chuanseng-ng/claude_verilog_test/pnr/commercial/reports/openroad_summary.md

# OpenROAD / LibreLane arm, Sky130 `rv32i_cpu_top` (step B2)

Run dir (gitignored): `pnr/sky130/cpu/runs/b2_openroad`. Exported artifacts: `pnr/commercial/runs/openroad/`.
Config `pnr/sky130/cpu/config.json` unchanged. CLI overrides only: `-j 4 -c DRT_THREADS=4` (config says 8; thread count only).
Design source: HEAD `1f1e703`, `rv32i_cpu_top_sv2v.v` regenerated by `make -C pnr sky130-cpu-sv2v` (sha256 f99e5317..., byte-identical to the file already on disk).

## Tool versions and patch status
- LibreLane: upstream commit 3562a8d (`2.4.13-2-g3562a8d`) at `~/tools/librelane-3562a8d`, plus `pnr/librelane_patches/librelane_live_state_2026-09-26.diff` (15 files) and the 2 untracked sources (`json_header_patched.py`, `nix/openvaf.nix`). Mounted over the container's librelane by `PYTHONPATH` (container image `ghcr.io/librelane/librelane:2.4.13`).
- Tools in the image: OpenROAD `edf00dff99f6c40d67a30c0e22a8191c5d2ed9d6` (the same build the repo's nix-shell Sky130 flow used; 26Q2 is used only by the ASAP7 shim), Yosys 0.46, Magic 8.3.489, KLayout 0.29.4, Netgen 1.5.278.
- Project plugin `pnr/plugins` (synth undef gate, bead gc0y) loaded via PYTHONPATH: verdict PASS fail=0. No SoC plugin (`cvt_sky130`) is needed for the CPU block.
- PDK: open_pdks 0fe599b2 at `~/pdk`; `sky130_fd_io` had to be added with `ciel enable` (same version hash) because LibreLane 2.4.13 validates the pad LEF paths at start-up.
- Patches that only take effect on OpenROAD 26Q2 (inert here, as in the baseline): drt.tcl `set_routing_layers` branch; sta/corner.tcl `sta::scenes` branch; PSM report parser 26Q2 format; `PL_RESIZER_TIMING_EXTRA_ARGS=-max_iterations` usage. Applied unconditionally and not 26Q2-specific: ioplacer.tcl (drops `-random_seed 42`; pins are then overwritten by `FP_DEF_TEMPLATE`, so no effect), pdn.tcl (no `exit 1` on PDN errors; PDN built normally, no warning), drt.tcl catch-and-continue (bead xy6 hazard; not triggered: no warning in the log and DRT converged to 0 violations at iteration 21).

## Result
LVS 0 errors, routing DRC 0 (iteration 21), KLayout DRC 0, Magic DRC count 27,733,913 (from the Magic log; Magic.DRC step itself was killed afterwards by the 10 GB memory watchdog while LibreLane parsed the report, so `magic__drc_error__count` is absent from metrics.json), antenna 116 nets / 119 pins, setup clean at six tt/ff corners (nom_tt +3.031 ns), ss reg-to-reg setup FAILS (max_ss -3.996 ns, 1149 violators), hold fails only on I/O ports (nom_tt -0.458 ns, 0 reg-to-reg), power 103.4 mW (indicative), stdcell area 707,819 um2, util 41.81 %, 5,299 flops. Flow exit status 2 (deferred nom_tt hold error, as in the baseline). Every number matches the recorded `RUN_2026-10-24_19-19-02` (c54a, same RTL) exactly, so the flow reproduces bit-for-bit.
