chuanseng-ng/claude_verilog_test/pnr/commercial/signoff/drclvs/reports/innovus_b6_summary.txt

== drclvs summary: arm=innovus_b6
-- LVS (Magic DEF+LEF, LibreLane mode)
   NOT RUN / no report
-- LVS (Magic from GDS, cells as LEF abstracts)
   Final result: Top level cell failed pin matching.
   Number of devices: 46175                   |Number of devices: 46175
   Number of nets: 47113                      |Number of nets: 47113
-- KLayout DRC
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
