chuanseng-ng/claude_verilog_test/docs/manual/tm/parts/04-dft-fpga-hls-and-analog.tex

\part{DFT, FPGA, HLS and analog}\label{tm:part:dft-fpga-hls-and-analog}

\chapter{DFT architecture}\label{tm:ch:dft-architecture}

This chapter describes the DFT architecture. It covers scan, JTAG and memory self-test.

\chapter{Tessent flows}\label{tm:ch:tessent-flows}

This chapter describes the Tessent flows for test insertion and pattern generation.

\chapter{FPGA prototyping}\label{tm:ch:fpga-prototyping}

This chapter describes the FPGA prototype. It gives the board choice and the measured results.

\chapter{High-level synthesis}\label{tm:ch:high-level-synthesis}

This chapter describes the high-level synthesis work and its results.

\chapter{Analog PLL}\label{tm:ch:analog-pll}

This chapter describes the analog PLL flow. It covers both process kits.
