chuanseng-ng/claude_verilog_test/docs/manual/common/glossary.tex

% Generated by tools/docs/gen_glossary.py from dictionary.yaml. Do not edit.
\newglossaryentry{always-on-domain}{name={always-on domain},description={A power domain that stays powered while the other domains are off.}}
\newacronym[description={Analog and mixed signal. A design that has analog parts and digital parts.}]{AMS}{AMS}{analog and mixed signal}
\newacronym[description={Advanced Peripheral Bus. A simple bus for control registers.}]{APB}{APB}{Advanced Peripheral Bus}
\newglossaryentry{ASAP7}{name={ASAP7},description={A predictive 7 nm process design kit.}}
\newacronym[description={Automatic test pattern generation. A method that creates the test patterns for manufacturing faults.}]{ATPG}{ATPG}{automatic test pattern generation}
\newacronym[description={Advanced eXtensible Interface. A high-performance bus protocol.}]{AXI}{AXI}{Advanced eXtensible Interface}
\newacronym[description={Clock domain crossing. A signal path between two clock domains.}]{CDC}{CDC}{clock domain crossing}
\newglossaryentry{cocotb}{name={cocotb},description={A Python framework for the verification of RTL.}}
\newacronym[description={Control and status register. A register that controls the CPU or reports its state.}]{CSR}{CSR}{control and status register}
\newacronym[description={Clock tree synthesis. The step that builds the clock distribution network.}]{CTS}{CTS}{clock tree synthesis}
\newacronym[description={Design for test. The design methods that make a chip testable.}]{DFT}{DFT}{design for test}
\newacronym[description={Direct memory access. A transfer of data that does not use the CPU.}]{DMA}{DMA}{direct memory access}
\newacronym[description={Design rule check. A check of the layout against the rules of the process.}]{DRC}{DRC}{design rule check}
\newacronym[description={Engineering change order. A small late change to a design.}]{ECO}{ECO}{engineering change order}
\newacronym[description={Field-programmable gate array. A chip with logic that a user can program.}]{FPGA}{FPGA}{field-programmable gate array}
\newglossaryentry{FreePDK45}{name={FreePDK45},description={A predictive 45 nm process design kit.}}
\newacronym[description={Gate-level simulation. A simulation of the synthesized netlist.}]{GLS}{GLS}{gate-level simulation}
\newglossaryentry{gray-code}{name={gray code},description={A binary code in which the next value differs from the present value in one bit.}}
\newacronym[description={Global routing. The step that plans the route of each net before detailed routing.}]{GRT}{GRT}{global routing}
\newacronym[description={High-level synthesis. A tool flow that turns C or C++ code into RTL.}]{HLS}{HLS}{high-level synthesis}
\newacronym[description={Integrated clock gating. A cell that stops a clock safely.}]{ICG}{ICG}{integrated clock gating}
\newacronym[description={Interrupt request. A signal that asks the CPU to run a handler.}]{IRQ}{IRQ}{interrupt request}
\newacronym[description={Instruction set architecture. The instructions and the registers that software sees.}]{ISA}{ISA}{instruction set architecture}
\newglossaryentry{isolation-clamp}{name={isolation clamp},description={Logic that forces the outputs of a power domain to a fixed value while the domain is off.}}
\newacronym[description={Joint Test Action Group. The group that defined the IEEE 1149.1 test interface.}]{JTAG}{JTAG}{Joint Test Action Group}
\newglossaryentry{KLayout}{name={KLayout},description={An open-source layout viewer and design rule checker.}}
\newacronym[description={Logical equivalence checking. A proof that two designs have the same function.}]{LEC}{LEC}{logical equivalence checking}
\newacronym[description={Library Exchange Format. A file format for the abstract view of a cell or a macro.}]{LEF}{LEF}{Library Exchange Format}
\newglossaryentry{LibreLane}{name={LibreLane},description={A flow driver that runs the open-source steps from RTL to layout.}}
\newacronym[description={Layout versus schematic. A check that the layout matches the netlist.}]{LVS}{LVS}{layout versus schematic}
\newglossaryentry{Magic}{name={Magic},description={An open-source layout editor and design rule checker.}}
\newacronym[description={Memory built-in self-test. Logic on the chip that tests its memories.}]{MBIST}{MBIST}{memory built-in self-test}
\newglossaryentry{metastability}{name={metastability},description={The state of a flop that samples a signal while the signal changes. Its output takes an unknown time to settle.}}
\newacronym[description={Memory-mapped input/output. Access to a device through load and store instructions.}]{MMIO}{MMIO}{memory-mapped input/output}
\newacronym[description={Mean time between failures. For a synchroniser, the mean time between two metastable events that reach the logic after the chain.}]{MTBF}{MTBF}{mean time between failures}
\newglossaryentry{Netgen}{name={Netgen},description={An open-source tool for layout versus schematic checks.}}
\newacronym[description={Neural processing unit. A block that runs neural-network operations.}]{NPU}{NPU}{neural processing unit}
\newglossaryentry{OpenROAD}{name={OpenROAD},description={An open-source tool for place and route.}}
\newglossaryentry{OpenSTA}{name={OpenSTA},description={An open-source static timing analyzer.}}
\newglossaryentry{pandoc}{name={pandoc},description={A tool that converts documents between formats.}}
\newacronym[description={Process design kit. The data that a foundry gives for one process.}]{PDK}{PDK}{process design kit}
\newacronym[description={Power distribution network. The metal grid that carries power to the cells.}]{PDN}{PDN}{power distribution network}
\newacronym[description={Phase-locked loop. A circuit that makes a clock from a reference clock.}]{PLL}{PLL}{phase-locked loop}
\newacronym[description={Power management unit. The block that controls the power sequence of the power domains.}]{PMU}{PMU}{power management unit}
\newglossaryentry{power-domain}{name={power domain},description={A set of instances that share one supply and one power state.}}
\newacronym[description={Power, performance and area. The three main quality figures of a design.}]{PPA}{PPA}{power, performance and area}
\newacronym[description={Power state table. A table of the legal power states of the power domains.}]{PST}{PST}{power state table}
\newglossaryentry{pyslang}{name={pyslang},description={The Python interface of the slang SystemVerilog compiler.}}
\newglossaryentry{pyuvm}{name={pyuvm},description={A Python implementation of the UVM methodology.}}
\newacronym[description={Resistance-capacitance extraction. The step that reads the parasitic values from the layout.}]{RCX}{RCX}{resistance-capacitance extraction}
\newglossaryentry{retention}{name={retention},description={The property of a cell that keeps its value while its supply is off.}}
\newglossaryentry{return-to-zero-handshake}{name={return-to-zero handshake},description={A handshake in which the request level and the acknowledge level both return to zero before the next transfer.}}
\newacronym[description={Real-number modeling. A model that uses real values in place of analog waveforms.}]{RNM}{RNM}{real-number modeling}
\newacronym[description={Register-transfer level. A design description in terms of registers and logic.}]{RTL}{RTL}{register-transfer level}
\newacronym[description={Synopsys Design Constraints. A file format that states the timing constraints of a design.}]{SDC}{SDC}{Synopsys Design Constraints}
\newacronym[description={Single instruction, multiple threads. An execution model where many threads run one instruction.}]{SIMT}{SIMT}{single instruction, multiple threads}
\newglossaryentry{Sky130}{name={Sky130},description={The open 130 nm process design kit from SkyWater.}}
\newacronym[description={System on chip. A chip that holds the processors, the memory and the peripherals.}]{SoC}{SoC}{system on chip}
\newacronym[description={Standard Parasitic Exchange Format. A file format for the parasitic values of a layout.}]{SPEF}{SPEF}{Standard Parasitic Exchange Format}
\newacronym[description={Static random-access memory. A memory that keeps its data while power is on.}]{SRAM}{SRAM}{static random-access memory}
\newacronym[description={Static timing analysis. A check of all timing paths without simulation.}]{STA}{STA}{static timing analysis}
\newglossaryentry{sv2v}{name={sv2v},description={A tool that converts SystemVerilog to Verilog.}}
\newglossaryentry{synchroniser}{name={synchroniser},description={A chain of flops on the receiving clock that gives a metastable first flop time to settle.}}
\newglossaryentry{Synlig}{name={Synlig},description={A Yosys front end for SystemVerilog.}}
\newacronym[description={Test access port. The port and the state machine that control a JTAG interface.}]{TAP}{TAP}{test access port}
\newacronym[description={Total negative slack. The sum of the negative slack of all failing paths.}]{TNS}{TNS}{total negative slack}
\newacronym[description={Unified Power Format. A file format that states the power intent of a design.}]{UPF}{UPF}{Unified Power Format}
\newglossaryentry{Verible}{name={Verible},description={A lint and format tool for SystemVerilog.}}
\newglossaryentry{Verilator}{name={Verilator},description={A simulator that turns SystemVerilog into C++ code.}}
\newacronym[description={Worst negative slack. The most negative slack of all timing paths.}]{WNS}{WNS}{worst negative slack}
\newglossaryentry{Yosys}{name={Yosys},description={An open-source logic synthesis tool.}}
