chuanseng-ng/claude_verilog_test/docs/manual/common/generated/map/memory-map-axilite.tex

% Generated by tools/docs/gen_memory_map.py from rtl/soc/axi_pkg.sv, rtl/soc/soc_addr_map_pkg.sv, rtl/soc/soc_periph_map_pkg.sv and docs/manual/common/facts/memory_map.yaml. Do not edit.
{\small
\begin{longtable}{@{}>{\raggedright\arraybackslash}p{9mm}>{\raggedright\arraybackslash}p{33mm}>{\raggedright\arraybackslash}p{27mm}>{\raggedright\arraybackslash}p{17mm}>{\raggedright\arraybackslash}p{25mm}>{\raggedright\arraybackslash}p{28mm}@{}}
\caption{AXI-Lite interconnect slot windows}\label{tab:ds:mm:address-map:axilite}\\
\toprule
Slot & Constant & Range & Size & Target & Note\\
\midrule
\endfirsthead
\multicolumn{6}{@{}l}{\emph{Table \thetable\ continued}}\\
\toprule
Slot & Constant & Range & Size & Target & Note\\
\midrule
\endhead
\bottomrule
\endlastfoot
0 & \code{AXIL_GPU} & \code{0x2000_1000}\newline\code{0x2000_1FFF} & 4 KB & GPU control port of \code{u_gpu} & Only the address bits \code{[11:0]} reach the slave.\\
1 & \code{AXIL_APB_BRIDGE} & \code{0x2000_2000}\newline\code{0x2001_0FFF} & 60 KB & APB bridge \code{u_axil_apb_bridge} & Window of every APB slot. The APB level below decodes it.\\
2 & \code{AXIL_DMA} & \code{0x2000_5000}\newline\code{0x2000_5FFF} & 4 KB & DMA control port of \code{u_dma} & The page lies inside the APB bridge window. The decode keeps the last match, so this slot wins.\\
\end{longtable}
}
