chuanseng-ng/claude_verilog_test/docs/manual/common/generated/facts/pmu-params.tex

% Generated by tools/docs/gen_fact_tables.py from rtl/soc/pmu.sv and docs/manual/common/facts/power.yaml. Do not edit.
{\small
\begin{longtable}{@{}>{\raggedright\arraybackslash}p{30mm}>{\raggedright\arraybackslash}p{27mm}>{\raggedright\arraybackslash}p{19mm}>{\raggedright\arraybackslash}p{20mm}>{\raggedright\arraybackslash}p{45mm}@{}}
\caption{Parameters of \code{pmu}}\label{tab:tm:mod:pmu:params}\\
\toprule
Parameter & Type & Default & Legal values & Description\\
\midrule
\endfirsthead
\multicolumn{5}{@{}l}{\emph{Table \thetable\ continued}}\\
\toprule
Parameter & Type & Default & Legal values & Description\\
\midrule
\endhead
\bottomrule
\endlastfoot
\code{ADDR_W} & \code{int unsigned} & \code{12} & 4 or more; 12 in the SoC & Byte address width of the APB slot. The slot holds 4 KB at 12.\\
\code{ISO_ACK_TIMEOUT} & \code{int unsigned} & \code{255} & 2 or more & Number of \code{clk_i} cycles that one isolation wait of the CPU domain can last before the sequencer goes on and sets STATUS bit 3. Elaboration stops with an error when the value is below 2.\\
\end{longtable}
}
