chuanseng-ng/claude_verilog_test/docs/manual/common/generated/facts/rv32i-clock-gate-params.tex

% Generated by tools/docs/gen_fact_tables.py from rtl/mem/rv32i_clock_gate.sv and docs/manual/common/facts/power.yaml. Do not edit.
{\small
\begin{longtable}{@{}>{\raggedright\arraybackslash}p{30mm}>{\raggedright\arraybackslash}p{27mm}>{\raggedright\arraybackslash}p{19mm}>{\raggedright\arraybackslash}p{20mm}>{\raggedright\arraybackslash}p{45mm}@{}}
\caption{Parameters of \code{rv32i_clock_gate}}\label{tab:tm:mod:rv32i-clock-gate:params}\\
\toprule
Parameter & Type & Default & Legal values & Description\\
\midrule
\endfirsthead
\multicolumn{5}{@{}l}{\emph{Table \thetable\ continued}}\\
\toprule
Parameter & Type & Default & Legal values & Description\\
\midrule
\endhead
\bottomrule
\endlastfoot
\code{HARD_ROOT} & \code{bit} & \code{1'b0} & 0 or 1 & 1 marks a gate that is a clock root with a clock tree behind it. Only the Sky130 library arm reads it. The default is 0.\\
\end{longtable}
}
