chuanseng-ng/claude_verilog_test/docs/manual/common/generated/facts/apb-cdc-bridge-params.tex

% Generated by tools/docs/gen_fact_tables.py from rtl/soc/apb_cdc_bridge.sv and docs/manual/common/facts/cdc.yaml. Do not edit.
{\small
\begin{longtable}{@{}>{\raggedright\arraybackslash}p{30mm}>{\raggedright\arraybackslash}p{27mm}>{\raggedright\arraybackslash}p{19mm}>{\raggedright\arraybackslash}p{20mm}>{\raggedright\arraybackslash}p{45mm}@{}}
\caption{Parameters of \code{apb_cdc_bridge}}\label{tab:tm:mod:apb-cdc-bridge:params}\\
\toprule
Parameter & Type & Default & Legal values & Description\\
\midrule
\endfirsthead
\multicolumn{5}{@{}l}{\emph{Table \thetable\ continued}}\\
\toprule
Parameter & Type & Default & Legal values & Description\\
\midrule
\endhead
\bottomrule
\endlastfoot
\code{ADDR_W} & \code{int unsigned} & \code{12} & 1 or more & Width of the byte address of both faces.\\
\code{SYNC_STAGES_TO_S} & \code{int unsigned} & \code{2} & 2 or more & Ranks of each synchroniser that ends in the \code{s_clk_i} domain: the acknowledge level, the reset of the source side and the reset status of the destination.\\
\code{SYNC_STAGES_TO_M} & \code{int unsigned} & \code{2} & 2 or more & Ranks of each synchroniser that ends in the \code{m_clk_i} domain: the request level and the reset of the destination side.\\
\end{longtable}
}
