chuanseng-ng/claude_verilog_test/PRE_COMMIT_SETUP_SUMMARY.md

# Pre-commit Hooks Setup - Complete Summary

✅ **Pre-commit hooks have been successfully configured for this repository!**

## What Was Created

### Configuration Files

1. **`.pre-commit-config.yaml`** - Pre-commit hook configuration
   - Basic Git checks (whitespace, YAML, etc.)
   - Ruff linter and formatter (with auto-fix)
   - MyPy type checking
   - Pylint code quality (≥9.5/10)
   - Pytest quick check (on commit)
   - Pytest full suite (on push)

2. **`.pylintrc`** - Pylint configuration
   - Project-specific settings
   - Acceptable disabled checks for instruction execution models
   - Fail threshold: 9.5/10

3. **`requirements.txt`** - Updated with pre-commit dependency

### Documentation

1. **`QUICKSTART_PRECOMMIT.md`** (Root) - Quick start guide
   - Installation steps
   - Usage examples
   - Troubleshooting

2. **`.github/PRE_COMMIT_SETUP.md`** - Complete setup guide
   - Detailed hook descriptions
   - Configuration options
   - Advanced usage

3. **`.github/QA_WORKFLOW_DIAGRAM.md`** - Visual workflow
   - Complete QA flow diagram
   - Three layers of protection
   - Time investment vs. savings

4. **`docs/development/LOCAL_QA_SETUP.md`** - Local QA guide
   - Manual check commands
   - IDE integration
   - Performance tips

## Installation (3 Simple Steps)

```bash
# 1. Install dependencies (includes pre-commit)
pip install -r requirements.txt

# 2. Install git hooks
pre-commit install
pre-commit install --hook-type pre-push

# 3. Done! Hooks run automatically on commit/push
```

## What Happens Now

### On Every Commit

```bash
git commit -m "Add feature"

# ⚡ Automatic checks:
✓ Trim trailing whitespace
✓ Fix end of files
✓ Check YAML syntax
✓ Ruff lint (auto-fix)
✓ Ruff format
✓ MyPy type checking
✓ Pylint (code quality)
✓ Pytest (quick smoke test)

# If all pass → Commit succeeds
# If any fail → Fix and try again
```

### On Every Push

```bash
git push

# ⚡ Full test suite runs:
✓ Pytest (all tests)

# If tests pass → Push succeeds
# If tests fail → Fix and try again
```

## Features

### Auto-fix Capabilities

Many issues are fixed automatically:
- ✅ Code formatting (ruff format)
- ✅ Import sorting (ruff)
- ✅ Trailing whitespace removal
- ✅ End of file fixes

### Quality Checks

All the same checks as CI:
- ✅ Type checking (mypy)
- ✅ Code quality (pylint ≥9.5)
- ✅ Linting (ruff)
- ✅ Tests (pytest)

### Speed

- **First run**: 10-30 seconds (sets up cache)
- **Subsequent runs**: 5-10 seconds (uses cache)
- **Much faster than waiting for CI!**

## Example Workflow

```bash
# Make changes
vim tb/models/new_model.py

# Stage
git add tb/models/new_model.py

# Commit (hooks run automatically)
git commit -m "Add new model"

✓ Trim trailing whitespace........................Passed
✓ Fix end of files..................................Passed
✓ Check YAML........................................Passed
✓ Check for large files.............................Passed
✓ ruff lint (auto-fix)..............................Passed
✓ ruff format.......................................Passed
✓ mypy type checking................................Passed
✓ pylint (code quality).............................Passed
✓ pytest (quick check)..............................Passed

[feature/new-model abc1234] Add new model
 1 file changed, 50 insertions(+)

# Push (full tests run)
git push origin feature/new-model

✓ pytest (all tests)................................Passed

# Create PR (CI runs on GitHub)
gh pr create --base main --title "Add new model"
# CI validates on Python 3.11 and 3.12
```

## When Hooks Fail

### Auto-fix Example

```bash
git commit -m "Add feature"

ruff format.........................................Failed
- files were modified by this hook

# Files were auto-formatted!
# Just stage and commit again:
git add .
git commit -m "Add feature"
✓ All checks pass!
```

### Manual Fix Example

```bash
git commit -m "Add feature"

pylint (code quality)...............................Failed
- hook id: pylint
- exit code: 1

tb/models/my_model.py:42:0: C0116: Missing function docstring

# Fix the issue
vim tb/models/my_model.py  # Add docstring

# Stage and commit
git add tb/models/my_model.py
git commit -m "Add feature"
✓ All checks pass!
```

## Benefits

### Time Savings

- **Before pre-commit**: Make changes → Push → Wait for CI → CI fails → Fix → Push → Wait again
- **With pre-commit**: Make changes → Commit (instant feedback) → Fix → Commit → Push (tests pass) → PR → CI passes ✓

**Estimated time saved**: 5-10 minutes per failed CI run

### Quality Improvements

- ✅ Catch issues immediately (not in 5 minutes when CI runs)
- ✅ Fix issues in context (while code is fresh in mind)
- ✅ No manual formatting needed (auto-formatted)
- ✅ Consistent code quality across all commits
- ✅ Fewer PR review cycles

## Manual Check Commands

You can still run checks manually:

```bash
# Run all pre-commit hooks
pre-commit run --all-files

# Run specific hook
pre-commit run ruff --all-files
pre-commit run mypy --all-files
pre-commit run pytest-check --hook-stage push

# Run QA checks directly
ruff format --check tb/models tb/tests
ruff check tb/models tb/tests
mypy tb/models tb/tests
pylint tb/models tb/tests
pytest tb/tests/ -v
```

## Skipping Hooks (Emergency Only)

```bash
# Skip all hooks
git commit --no-verify -m "Emergency fix"

# Skip specific hook
SKIP=pytest-quick git commit -m "Skip test"

# Skip on push
git push --no-verify
```

⚠️ **Not recommended** - Skipped checks may cause CI to fail!

## Updating Hooks

```bash
# Update to latest versions
pre-commit autoupdate

# This updates .pre-commit-config.yaml
```

## Uninstalling

```bash
# Remove hooks
pre-commit uninstall
pre-commit uninstall --hook-type pre-push
```

## Complete QA Stack

Now you have **3 layers of quality protection**:

1. **Pre-commit hooks** (Local, optional)
   - Instant feedback on every commit
   - Auto-fixes formatting and linting
   - Can skip in emergencies

2. **Pre-push hook** (Local, optional)
   - Full test suite before push
   - Catches test failures early
   - Saves CI time

3. **GitHub Actions CI** (Remote, mandatory)
   - Runs on PR to main
   - Final quality gate
   - Cannot be skipped

## Documentation Reference

- `QUICKSTART_PRECOMMIT.md` - Quick start (you are here... almost)
- `.github/PRE_COMMIT_SETUP.md` - Detailed setup guide
- `.github/QA_WORKFLOW_DIAGRAM.md` - Visual workflow diagram
- `docs/development/LOCAL_QA_SETUP.md` - Local QA commands
- `.github/CI_SETUP.md` - GitHub Actions CI documentation
- `.github/WORKFLOW_TRIGGERS.md` - When CI runs

## Next Steps

1. ✅ Pre-commit hooks are configured
2. ✅ Documentation is complete
3. ⏭️ **Install the hooks** (see Installation section above)
4. ⏭️ Start coding - hooks run automatically!

## Questions?

See the documentation files listed above for:
- Troubleshooting common issues
- Advanced configuration options
- IDE integration guides
- Performance optimization tips

## Summary

**Installation:**
```bash
pip install -r requirements.txt
pre-commit install
pre-commit install --hook-type pre-push
```

**Usage:**
```bash
# Just commit normally - hooks run automatically!
git add .
git commit -m "Your message"
# Hooks run, auto-fix issues, validate code
```

**Benefits:**
- ✅ Catch issues immediately
- ✅ Auto-fix formatting
- ✅ Save time (no CI wait)
- ✅ Better code quality
- ✅ Faster PRs

**Happy coding!** 🚀
