chuanseng-ng/claude_verilog_test/pnr/commercial/impl/icc2/reports/final_timing_setup.txt

Information: Timer using 2 threads
Timing Update Started(Full_timing_update) : updateCount: 1 / Mem-peak : 665 MB / Date: Mon Oct 26 01:51:45 2026

Timing Update Completed: Mem-peak: 665 MB / Date: Mon Oct 26 01:51:45 2026

Information: Corner default: no PVT mismatches. (PVT-032)
Information: The stitching and editing of coupling caps is turned OFF for design 'rv32i.dlib:rv32i_cpu_top/06_finish.design'. (TIM-125)
Information: Design rv32i_cpu_top has 35143 nets, 0 global routed, 35141 detail routed. (NEX-024)
Information: The RC mode used is DR for design 'rv32i_cpu_top'. (NEX-022)
---extraction options---
Corner: default
 late_cap_scale                : 1
 late_res_scale                : 1
 early_cap_scale               : 1
 early_res_scale               : 1
Global options:
 reference_direction       : use_from_tluplus
 real_metalfill_extraction : none
 virtual_shield_extraction : true
---app options---
 host.max_cores                   : 2
 extract.connect_open           : true
 extract.enable_coupling_cap    : false
Extracting design: rv32i_cpu_top 
Information: coupling capacitance is lumped to ground. (NEX-030)
Information: 35141 nets are successfully extracted. (NEX-028)
Warning: Advanced receiver model has not been enabled for detailed routed design. (TIM-204)
Information: Update timing completed net estimation for all the timing graph nets (TIM-111)
Information: Net estimation statistics: timing graph nets = 35141, routed nets = 35141, across physical hierarchy nets = 0, parasitics cached nets = 35141, delay annotated nets = 0, parasitics annotated nets = 0, multi-voltage nets = 0. (TIM-112)
************************************************************
Timer Settings:
Delay Calculation Style:                   auto
Signal Integrity Analysis:                 disabled
Timing Window Analysis:                    disabled
Advanced Waveform Propagation:             disabled
Variation Type:                            fixed_derate
Clock Reconvergence Pessimism Removal:     disabled
Advanced Receiver Model:                   disabled
LLE:                                       disabled
ML Acceleration:                           off
Smart Arc Optimization:                    disabled
************************************************************
****************************************
Report : timing
        -path_type full
        -delay_type max
        -nworst 1
        -max_paths 20
        -report_by design
        -input_pins
        -transition_time
        -capacitance
Design : rv32i_cpu_top
Version: X-2025.06-SP1
Date   : Mon Oct 26 01:51:50 2026
****************************************

  Startpoint: u_core/u_icache_ic_addr_q_reg_7_ (rising edge-triggered flip-flop clocked by clk_i)
  Endpoint: u_core/u_if_pc_q_reg_31_ (rising edge-triggered flip-flop clocked by clk_i)
  Mode: default
  Corner: default
  Scenario: default
  Path Group: PIPELINE
  Path Type: max

  Point                                            Cap      Trans      Incr      Path  
  --------------------------------------------------------------------------------------------
  clock clk_i (rise edge)                                              0.00      0.00
  clock network delay (propagated)                                     2.69      2.69

  u_core/u_icache_ic_addr_q_reg_7_/CLK (sky130_fd_sc_hd__dfxtp_2)
                                                             0.21      0.00      2.69 r
  u_core/u_icache_ic_addr_q_reg_7_/Q (sky130_fd_sc_hd__dfxtp_2)
                                                   0.02      0.13      0.43      3.13 r
  HFSBUF_100_4629/A (sky130_fd_sc_hd__buf_6)                 0.13      0.00      3.13 r
  HFSBUF_100_4629/X (sky130_fd_sc_hd__buf_6)       0.20      0.42      0.35      3.48 r
  copt_gre_mt_inst_14369/A (sky130_fd_sc_hd__buf_6)          0.43      0.07      3.54 r
  copt_gre_mt_inst_14369/X (sky130_fd_sc_hd__buf_6)
                                                   0.17      0.34      0.37      3.91 r
  u_core/U536/A (sky130_fd_sc_hd__or2b_2)                    0.35      0.03      3.94 r
  u_core/U536/X (sky130_fd_sc_hd__or2b_2)          0.02      0.13      0.25      4.19 r
  ctmTdsLR_1_7015/B (sky130_fd_sc_hd__or2_2)                 0.13      0.00      4.19 r
  ctmTdsLR_1_7015/X (sky130_fd_sc_hd__or2_2)       0.01      0.08      0.17      4.36 r
  ctmTdsLR_2_7016/A (sky130_fd_sc_hd__clkinv_4)              0.08      0.00      4.36 r
  ctmTdsLR_2_7016/Y (sky130_fd_sc_hd__clkinv_4)    0.11      0.21      0.19      4.55 f
  u_core/U732/A1 (sky130_fd_sc_hd__a22oi_1)                  0.22      0.01      4.56 f
  u_core/U732/Y (sky130_fd_sc_hd__a22oi_1)         0.02      0.41      0.42      4.98 r
  u_core/U733/D (sky130_fd_sc_hd__nand4_1)                   0.41      0.00      4.98 r
  u_core/U733/Y (sky130_fd_sc_hd__nand4_1)         0.02      0.29      0.31      5.29 f
  u_core/U734/B (sky130_fd_sc_hd__nor2_2)                    0.29      0.00      5.29 f
  u_core/U734/Y (sky130_fd_sc_hd__nor2_2)          0.01      0.13      0.20      5.49 r
  u_core/U757/A1 (sky130_fd_sc_hd__o211ai_1)                 0.13      0.00      5.49 r
  u_core/U757/Y (sky130_fd_sc_hd__o211ai_1)        0.01      0.10      0.13      5.62 f
  u_core/U758/C1 (sky130_fd_sc_hd__a221oi_1)                 0.10      0.00      5.62 f
  u_core/U758/Y (sky130_fd_sc_hd__a221oi_1)        0.01      0.29      0.27      5.88 r
  u_core/U759/B2 (sky130_fd_sc_hd__a32oi_1)                  0.29      0.00      5.88 r
  u_core/U759/Y (sky130_fd_sc_hd__a32oi_1)         0.00      0.13      0.11      5.99 f
  u_core/U760/B (sky130_fd_sc_hd__nand2_1)                   0.13      0.00      5.99 f
  u_core/U760/Y (sky130_fd_sc_hd__nand2_1)         0.01      0.10      0.13      6.12 r
  u_core/U761/B1 (sky130_fd_sc_hd__o21ai_2)                  0.10      0.00      6.12 r
  u_core/U761/Y (sky130_fd_sc_hd__o21ai_2)         0.04      0.18      0.16      6.28 f
  u_core/U766/A (sky130_fd_sc_hd__nand4_1)                   0.18      0.00      6.28 f
  u_core/U766/Y (sky130_fd_sc_hd__nand4_1)         0.00      0.09      0.14      6.42 r
  ctmTdsLR_2_12175/A3 (sky130_fd_sc_hd__o31a_1)              0.09      0.00      6.42 r
  ctmTdsLR_2_12175/X (sky130_fd_sc_hd__o31a_1)     0.01      0.08      0.14      6.55 r
  ctmTdsLR_1_12174/A (sky130_fd_sc_hd__inv_2)                0.08      0.00      6.55 r
  ctmTdsLR_1_12174/Y (sky130_fd_sc_hd__inv_2)      0.05      0.11      0.11      6.67 f
  copt_gre_mt_inst_15304/A (sky130_fd_sc_hd__clkbuf_16)      0.11      0.00      6.67 f
  copt_gre_mt_inst_15304/X (sky130_fd_sc_hd__clkbuf_16)
                                                   0.11      0.07      0.20      6.87 f
  copt_gre_mt_inst_15303/A (sky130_fd_sc_hd__buf_4)          0.89      0.59      7.46 f
  copt_gre_mt_inst_15303/X (sky130_fd_sc_hd__buf_4)
                                                   0.13      0.18      0.55      8.01 f
  ctmTdsLR_1_6577/B (sky130_fd_sc_hd__nand3_2)               0.18      0.01      8.03 f
  ctmTdsLR_1_6577/Y (sky130_fd_sc_hd__nand3_2)     0.00      0.08      0.12      8.15 r
  ctmTdsLR_1_7579/B (sky130_fd_sc_hd__nand3b_1)              0.08      0.00      8.15 r
  ctmTdsLR_1_7579/Y (sky130_fd_sc_hd__nand3b_1)    0.01      0.08      0.10      8.25 f
  u_core/U782/A (sky130_fd_sc_hd__nand3_2)                   0.08      0.00      8.25 f
  u_core/U782/Y (sky130_fd_sc_hd__nand3_2)         0.01      0.13      0.10      8.35 r
  HFSBUF_32_1478/A (sky130_fd_sc_hd__buf_12)                 0.13      0.00      8.35 r
  HFSBUF_32_1478/X (sky130_fd_sc_hd__buf_12)       0.17      0.21      0.24      8.58 r
  ctmTdsLR_1_6620/B (sky130_fd_sc_hd__nor2_4)                0.21      0.02      8.60 r
  ctmTdsLR_1_6620/Y (sky130_fd_sc_hd__nor2_4)      0.07      0.15      0.14      8.74 f
  HFSINV_2387_5590/A (sky130_fd_sc_hd__clkinv_4)             0.15      0.00      8.74 f
  HFSINV_2387_5590/Y (sky130_fd_sc_hd__clkinv_4)   0.18      0.36      0.31      9.04 r
  u_core/U1012/B1 (sky130_fd_sc_hd__o21ai_1)                 0.36      0.00      9.05 r
  u_core/U1012/Y (sky130_fd_sc_hd__o21ai_1)        0.01      0.11      0.14      9.19 f
  ctmTdsLR_3_13692/B (sky130_fd_sc_hd__or2_1)                0.11      0.00      9.19 f
  ctmTdsLR_3_13692/X (sky130_fd_sc_hd__or2_1)      0.01      0.07      0.25      9.44 f
  ctmTdsLR_2_13691/A (sky130_fd_sc_hd__nand2_1)              0.07      0.00      9.44 f
  ctmTdsLR_2_13691/Y (sky130_fd_sc_hd__nand2_1)    0.01      0.07      0.08      9.52 r
  ctmTdsLR_1_13690/A (sky130_fd_sc_hd__nand2_2)              0.07      0.00      9.52 r
  ctmTdsLR_1_13690/Y (sky130_fd_sc_hd__nand2_2)    0.01      0.06      0.07      9.59 f
  u_core/U1025/B1 (sky130_fd_sc_hd__o21ai_2)                 0.06      0.00      9.59 f
  u_core/U1025/Y (sky130_fd_sc_hd__o21ai_2)        0.01      0.12      0.07      9.65 r
  u_core/U1027/A (sky130_fd_sc_hd__nand2_2)                  0.12      0.00      9.65 r
  u_core/U1027/Y (sky130_fd_sc_hd__nand2_2)        0.01      0.06      0.08      9.73 f
  ctmTdsLR_1_13912/B (sky130_fd_sc_hd__maj3_2)               0.06      0.00      9.73 f
  ctmTdsLR_1_13912/X (sky130_fd_sc_hd__maj3_2)     0.01      0.08      0.33     10.06 f
  u_core/U1028/B1 (sky130_fd_sc_hd__o21ai_2)                 0.08      0.00     10.06 f
  u_core/U1028/Y (sky130_fd_sc_hd__o21ai_2)        0.01      0.12      0.07     10.14 r
  u_core/U1030/A (sky130_fd_sc_hd__nand2_2)                  0.12      0.00     10.14 r
  u_core/U1030/Y (sky130_fd_sc_hd__nand2_2)        0.00      0.04      0.06     10.20 f
  u_core/U1237/CI (sky130_fd_sc_hd__fah_1)                   0.04      0.00     10.20 f
  u_core/U1237/COUT (sky130_fd_sc_hd__fah_1)       0.01      0.07      0.25     10.45 f
  u_core/U1230/CI (sky130_fd_sc_hd__fah_1)                   0.07      0.00     10.45 f
  u_core/U1230/COUT (sky130_fd_sc_hd__fah_1)       0.01      0.07      0.27     10.71 f
  u_core/U1223/CI (sky130_fd_sc_hd__fah_1)                   0.07      0.00     10.71 f
  u_core/U1223/COUT (sky130_fd_sc_hd__fah_1)       0.00      0.07      0.26     10.97 f
  u_core/U1216/CI (sky130_fd_sc_hd__fah_1)                   0.07      0.00     10.97 f
  u_core/U1216/COUT (sky130_fd_sc_hd__fah_1)       0.01      0.09      0.29     11.26 f
  ctmTdsLR_4_13804/B (sky130_fd_sc_hd__maj3_2)               0.09      0.00     11.27 f
  ctmTdsLR_4_13804/X (sky130_fd_sc_hd__maj3_2)     0.01      0.07      0.33     11.60 f
  ctmTdsLR_3_13803/A1 (sky130_fd_sc_hd__a22o_1)              0.07      0.00     11.60 f
  ctmTdsLR_3_13803/X (sky130_fd_sc_hd__a22o_1)     0.01      0.08      0.26     11.85 f
  ctmTdsLR_5_13860/A1 (sky130_fd_sc_hd__a21boi_2)            0.08      0.00     11.85 f
  ctmTdsLR_5_13860/Y (sky130_fd_sc_hd__a21boi_2)   0.01      0.17      0.19     12.04 r
  ctmTdsLR_3_13858/B2 (sky130_fd_sc_hd__o2bb2ai_2)           0.17      0.00     12.05 r
  ctmTdsLR_3_13858/Y (sky130_fd_sc_hd__o2bb2ai_2)
                                                   0.00      0.05      0.07     12.12 f
  u_core/U1177/CI (sky130_fd_sc_hd__fah_1)                   0.05      0.00     12.12 f
  u_core/U1177/COUT (sky130_fd_sc_hd__fah_1)       0.01      0.09      0.29     12.41 f
  ctmTdsLR_2_13753/A (sky130_fd_sc_hd__nand2_2)              0.09      0.00     12.41 f
  ctmTdsLR_2_13753/Y (sky130_fd_sc_hd__nand2_2)    0.01      0.05      0.08     12.48 r
  ctmTdsLR_1_13752/A (sky130_fd_sc_hd__nand2_2)              0.05      0.00     12.48 r
  ctmTdsLR_1_13752/Y (sky130_fd_sc_hd__nand2_2)    0.01      0.06      0.06     12.55 f
  ctmTdsLR_5_13455/A1 (sky130_fd_sc_hd__a21boi_2)            0.06      0.00     12.55 f
  ctmTdsLR_5_13455/Y (sky130_fd_sc_hd__a21boi_2)   0.01      0.17      0.18     12.73 r
  ctmTdsLR_3_13453/B2 (sky130_fd_sc_hd__o2bb2ai_2)           0.17      0.00     12.73 r
  ctmTdsLR_3_13453/Y (sky130_fd_sc_hd__o2bb2ai_2)
                                                   0.01      0.07      0.10     12.82 f
  ctmTdsLR_5_13549/A1 (sky130_fd_sc_hd__a21boi_2)            0.07      0.00     12.83 f
  ctmTdsLR_5_13549/Y (sky130_fd_sc_hd__a21boi_2)   0.01      0.18      0.20     13.02 r
  ctmTdsLR_3_13547/A2 (sky130_fd_sc_hd__o21ai_2)             0.18      0.00     13.02 r
  ctmTdsLR_3_13547/Y (sky130_fd_sc_hd__o21ai_2)    0.01      0.07      0.10     13.12 f
  ctmTdsLR_1_6574/A (sky130_fd_sc_hd__nand2_2)               0.07      0.00     13.12 f
  ctmTdsLR_1_6574/Y (sky130_fd_sc_hd__nand2_2)     0.01      0.05      0.07     13.19 r
  ctmTdsLR_3_6576/A (sky130_fd_sc_hd__nand2_2)               0.05      0.00     13.19 r
  ctmTdsLR_3_6576/Y (sky130_fd_sc_hd__nand2_2)     0.00      0.03      0.04     13.23 f
  u_core/U1118/CI (sky130_fd_sc_hd__fah_1)                   0.03      0.00     13.23 f
  u_core/U1118/COUT (sky130_fd_sc_hd__fah_1)       0.01      0.10      0.29     13.52 f
  ctmTdsLR_2_13823/A (sky130_fd_sc_hd__nand2_2)              0.10      0.00     13.53 f
  ctmTdsLR_2_13823/Y (sky130_fd_sc_hd__nand2_2)    0.01      0.05      0.08     13.61 r
  ctmTdsLR_1_13822/A (sky130_fd_sc_hd__nand2_2)              0.05      0.00     13.61 r
  ctmTdsLR_1_13822/Y (sky130_fd_sc_hd__nand2_2)    0.01      0.06      0.06     13.67 f
  ctmTdsLR_2_13747/A (sky130_fd_sc_hd__nand2_2)              0.06      0.00     13.67 f
  ctmTdsLR_2_13747/Y (sky130_fd_sc_hd__nand2_2)    0.01      0.05      0.06     13.73 r
  ctmTdsLR_1_13746/A (sky130_fd_sc_hd__nand2_2)              0.05      0.00     13.73 r
  ctmTdsLR_1_13746/Y (sky130_fd_sc_hd__nand2_2)    0.01      0.06      0.06     13.80 f
  ctmTdsLR_1_6571/A (sky130_fd_sc_hd__nand2_2)               0.06      0.00     13.80 f
  ctmTdsLR_1_6571/Y (sky130_fd_sc_hd__nand2_2)     0.01      0.06      0.07     13.86 r
  ctmTdsLR_3_6573/A (sky130_fd_sc_hd__nand2_2)               0.06      0.00     13.86 r
  ctmTdsLR_3_6573/Y (sky130_fd_sc_hd__nand2_2)     0.01      0.06      0.06     13.93 f
  ctmTdsLR_2_13741/A (sky130_fd_sc_hd__nand2_2)              0.06      0.00     13.93 f
  ctmTdsLR_2_13741/Y (sky130_fd_sc_hd__nand2_2)    0.01      0.06      0.07     13.99 r
  ctmTdsLR_1_13740/A (sky130_fd_sc_hd__nand2_2)              0.06      0.00     13.99 r
  ctmTdsLR_1_13740/Y (sky130_fd_sc_hd__nand2_2)    0.01      0.06      0.07     14.06 f
  ctmTdsLR_2_13735/A (sky130_fd_sc_hd__nand2_2)              0.06      0.00     14.06 f
  ctmTdsLR_2_13735/Y (sky130_fd_sc_hd__nand2_2)    0.01      0.05      0.06     14.12 r
  ctmTdsLR_1_13734/A (sky130_fd_sc_hd__nand2_2)              0.05      0.00     14.12 r
  ctmTdsLR_1_13734/Y (sky130_fd_sc_hd__nand2_2)    0.01      0.05      0.05     14.18 f
  u_core/U1072/CI (sky130_fd_sc_hd__fah_1)                   0.05      0.00     14.18 f
  u_core/U1072/COUT (sky130_fd_sc_hd__fah_1)       0.01      0.10      0.29     14.47 f
  ctmTdsLR_2_13729/A (sky130_fd_sc_hd__nand2_1)              0.10      0.00     14.47 f
  ctmTdsLR_2_13729/Y (sky130_fd_sc_hd__nand2_1)    0.00      0.05      0.08     14.55 r
  ctmTdsLR_1_13728/A (sky130_fd_sc_hd__nand2_1)              0.05      0.00     14.55 r
  ctmTdsLR_1_13728/Y (sky130_fd_sc_hd__nand2_1)    0.00      0.05      0.05     14.60 f
  u_core/U1055/CI (sky130_fd_sc_hd__fah_1)                   0.05      0.00     14.60 f
  u_core/U1055/COUT (sky130_fd_sc_hd__fah_1)       0.00      0.07      0.25     14.85 f
  u_core/U1291/CI (sky130_fd_sc_hd__fah_1)                   0.07      0.00     14.85 f
  u_core/U1291/COUT (sky130_fd_sc_hd__fah_1)       0.01      0.08      0.27     15.12 f
  u_core/U1292/A (sky130_fd_sc_hd__clkinv_1)                 0.08      0.00     15.12 f
  u_core/U1292/Y (sky130_fd_sc_hd__clkinv_1)       0.01      0.04      0.07     15.19 r
  ctmTdsLR_1_13825/B (sky130_fd_sc_hd__xor2_1)               0.04      0.00     15.19 r
  ctmTdsLR_1_13825/X (sky130_fd_sc_hd__xor2_1)     0.00      0.14      0.16     15.35 r
  u_core/U1295/D1 (sky130_fd_sc_hd__o2111ai_1)               0.14      0.00     15.35 r
  u_core/U1295/Y (sky130_fd_sc_hd__o2111ai_1)      0.00      0.14      0.12     15.47 f
  u_core/u_if_pc_q_reg_31_/D (sky130_fd_sc_hd__dfxtp_4)      0.14      0.00     15.47 f
  data arrival time                                                             15.47

  clock clk_i (rise edge)                                             13.33     13.33
  clock network delay (propagated)                                     2.75     16.08
  u_core/u_if_pc_q_reg_31_/CLK (sky130_fd_sc_hd__dfxtp_4)    0.23      0.00     16.08 r
  clock uncertainty                                                   -0.50     15.58
  library setup time                                                  -0.11     15.47
  data required time                                                            15.47
  --------------------------------------------------------------------------------------------
  data required time                                                            15.47
  data arrival time                                                            -15.47
  --------------------------------------------------------------------------------------------
  slack (VIOLATED)                                                              -0.00

  Startpoint: u_core/u_mem_mem_wb_reg_o_reg_mem_rd_ (rising edge-triggered flip-flop clocked by clk_i)
  Endpoint: u_core/ex1a_ex1b_reg_q_reg_alu_result__31_ (rising edge-triggered flip-flop clocked by clk_i)
  Mode: default
  Corner: default
  Scenario: default
  Path Group: PIPELINE
  Path Type: max

  Point                                            Cap      Trans      Incr      Path  
  --------------------------------------------------------------------------------------------
  clock clk_i (rise edge)                                              0.00      0.00
  clock network delay (propagated)                                     2.57      2.57

  u_core/u_mem_mem_wb_reg_o_reg_mem_rd_/CLK (sky130_fd_sc_hd__dfxtp_4)
                                                             0.28      0.00      2.57 r
  u_core/u_mem_mem_wb_reg_o_reg_mem_rd_/Q (sky130_fd_sc_hd__dfxtp_4)
                                                   0.06      0.19      0.53      3.10 r
  HFSBUF_109_5541/A (sky130_fd_sc_hd__buf_2)                 0.19      0.00      3.10 r
  HFSBUF_109_5541/X (sky130_fd_sc_hd__buf_2)       0.06      0.30      0.33      3.43 r
  ctmTdsLR_1_6875/A (sky130_fd_sc_hd__inv_2)                 0.30      0.00      3.44 r
  ctmTdsLR_1_6875/Y (sky130_fd_sc_hd__inv_2)       0.01      0.06      0.06      3.50 f
  ctmTdsLR_2_6876/A (sky130_fd_sc_hd__and2_4)                0.06      0.00      3.50 f
  ctmTdsLR_2_6876/X (sky130_fd_sc_hd__and2_4)      0.07      0.10      0.21      3.71 f
  HFSBUF_54_5020/A (sky130_fd_sc_hd__clkbuf_1)               0.10      0.00      3.71 f
  HFSBUF_54_5020/X (sky130_fd_sc_hd__clkbuf_1)     0.04      0.21      0.25      3.96 f
  u_core/U1771/B1 (sky130_fd_sc_hd__a22oi_1)                 0.21      0.00      3.96 f
  u_core/U1771/Y (sky130_fd_sc_hd__a22oi_1)        0.01      0.20      0.23      4.20 r
  ctmTdsLR_1_13720/B1 (sky130_fd_sc_hd__o21a_1)              0.20      0.00      4.20 r
  ctmTdsLR_1_13720/X (sky130_fd_sc_hd__o21a_1)     0.01      0.07      0.17      4.37 r
  ctmTdsLR_2_13566_roptpi_13964/B (sky130_fd_sc_hd__and2_4)
                                                             0.07      0.00      4.37 r
  ctmTdsLR_2_13566_roptpi_13964/X (sky130_fd_sc_hd__and2_4)
                                                   0.11      0.34      0.35      4.72 r
  u_core/U1777/A_N (sky130_fd_sc_hd__nand2b_1)               0.34      0.01      4.73 r
  u_core/U1777/Y (sky130_fd_sc_hd__nand2b_1)       0.01      0.10      0.18      4.91 r
  ctmTdsLR_3_13833/A (sky130_fd_sc_hd__nand3_2)              0.10      0.00      4.91 r
  ctmTdsLR_3_13833/Y (sky130_fd_sc_hd__nand3_2)    0.00      0.08      0.07      4.97 f
  ctmTdsLR_2_13832_roptpi_13971/A (sky130_fd_sc_hd__or2_4)   0.08      0.00      4.97 f
  ctmTdsLR_2_13832_roptpi_13971/X (sky130_fd_sc_hd__or2_4)
                                                   0.08      0.14      0.37      5.34 f
  ctmTdsLR_1_7045/A1 (sky130_fd_sc_hd__a22o_2)               0.15      0.01      5.35 f
  ctmTdsLR_1_7045/X (sky130_fd_sc_hd__a22o_2)      0.03      0.10      0.34      5.69 f
  HFSBUF_466_4877/A (sky130_fd_sc_hd__buf_2)                 0.10      0.00      5.69 f
  HFSBUF_466_4877/X (sky130_fd_sc_hd__buf_2)       0.07      0.17      0.27      5.95 f
  u_core/U2392/A2 (sky130_fd_sc_hd__o22ai_1)                 0.17      0.00      5.96 f
  u_core/U2392/Y (sky130_fd_sc_hd__o22ai_1)        0.02      0.45      0.42      6.37 r
  u_core/U2395/A (sky130_fd_sc_hd__nor2_1)                   0.45      0.00      6.38 r
  u_core/U2395/Y (sky130_fd_sc_hd__nor2_1)         0.01      0.11      0.14      6.51 f
  ctmTdsLR_2_7539/B1 (sky130_fd_sc_hd__a21o_1)               0.11      0.00      6.51 f
  ctmTdsLR_2_7539/X (sky130_fd_sc_hd__a21o_1)      0.01      0.05      0.19      6.70 f
  ctmTdsLR_4_6615/A (sky130_fd_sc_hd__inv_2)                 0.05      0.00      6.70 f
  ctmTdsLR_4_6615/Y (sky130_fd_sc_hd__inv_2)       0.01      0.05      0.06      6.76 r
  u_core/U2437/B (sky130_fd_sc_hd__nor2_1)                   0.05      0.00      6.76 r
  u_core/U2437/Y (sky130_fd_sc_hd__nor2_1)         0.01      0.10      0.07      6.83 f
  u_core/U2438/A (sky130_fd_sc_hd__nor2_4)                   0.10      0.00      6.83 f
  u_core/U2438/Y (sky130_fd_sc_hd__nor2_4)         0.01      0.11      0.15      6.99 r
  u_core/U2457/B (sky130_fd_sc_hd__nor2_1)                   0.11      0.00      6.99 r
  u_core/U2457/Y (sky130_fd_sc_hd__nor2_1)         0.01      0.09      0.07      7.06 f
  ctmTdsLR_1_13532/A (sky130_fd_sc_hd__nor2_1)               0.09      0.00      7.06 f
  ctmTdsLR_1_13532/Y (sky130_fd_sc_hd__nor2_1)     0.01      0.19      0.19      7.25 r
  ctmTdsLR_1_12035/B (sky130_fd_sc_hd__maj3_1)               0.19      0.00      7.25 r
  ctmTdsLR_1_12035/X (sky130_fd_sc_hd__maj3_1)     0.01      0.12      0.24      7.49 r
  u_core/U3085/A (sky130_fd_sc_hd__nand2_1)                  0.12      0.00      7.49 r
  u_core/U3085/Y (sky130_fd_sc_hd__nand2_1)        0.01      0.08      0.08      7.57 f
  u_core/U3086/A1 (sky130_fd_sc_hd__a21oi_2)                 0.08      0.00      7.57 f
  u_core/U3086/Y (sky130_fd_sc_hd__a21oi_2)        0.02      0.24      0.24      7.81 r
  u_core/U3107/B (sky130_fd_sc_hd__nor2_1)                   0.24      0.00      7.81 r
  u_core/U3107/Y (sky130_fd_sc_hd__nor2_1)         0.01      0.11      0.11      7.92 f
  ctmTdsLR_1_13808/B (sky130_fd_sc_hd__nor2_1)               0.11      0.00      7.92 f
  ctmTdsLR_1_13808/Y (sky130_fd_sc_hd__nor2_1)     0.01      0.20      0.19      8.12 r
  u_core/U3129/A (sky130_fd_sc_hd__nor2_1)                   0.20      0.00      8.12 r
  u_core/U3129/Y (sky130_fd_sc_hd__nor2_1)         0.01      0.09      0.10      8.21 f
  ctmTdsLR_2_6609/A (sky130_fd_sc_hd__nor2_1)                0.09      0.00      8.21 f
  ctmTdsLR_2_6609/Y (sky130_fd_sc_hd__nor2_1)      0.01      0.21      0.21      8.42 r
  u_core/U3147/A (sky130_fd_sc_hd__nand2_1)                  0.21      0.00      8.42 r
  u_core/U3147/Y (sky130_fd_sc_hd__nand2_1)        0.01      0.08      0.10      8.53 f
  u_core/U3149/A1 (sky130_fd_sc_hd__a21oi_2)                 0.08      0.00      8.53 f
  u_core/U3149/Y (sky130_fd_sc_hd__a21oi_2)        0.01      0.15      0.18      8.70 r
  u_core/U3166/A (sky130_fd_sc_hd__nand2_1)                  0.15      0.00      8.71 r
  u_core/U3166/Y (sky130_fd_sc_hd__nand2_1)        0.01      0.08      0.09      8.80 f
  u_core/U3168/A2 (sky130_fd_sc_hd__a21oi_2)                 0.08      0.00      8.80 f
  u_core/U3168/Y (sky130_fd_sc_hd__a21oi_2)        0.01      0.17      0.20      9.00 r
  u_core/U3185/B (sky130_fd_sc_hd__nor2_1)                   0.17      0.00      9.00 r
  u_core/U3185/Y (sky130_fd_sc_hd__nor2_1)         0.01      0.09      0.08      9.08 f
  ctmTdsLR_2_6607/A (sky130_fd_sc_hd__nor2_1)                0.09      0.00      9.08 f
  ctmTdsLR_2_6607/Y (sky130_fd_sc_hd__nor2_1)      0.01      0.20      0.20      9.28 r
  u_core/U3205/A (sky130_fd_sc_hd__nand2_1)                  0.20      0.00      9.28 r
  u_core/U3205/Y (sky130_fd_sc_hd__nand2_1)        0.00      0.07      0.08      9.36 f
  u_core/U3207/A2 (sky130_fd_sc_hd__a21oi_1)                 0.07      0.00      9.36 f
  u_core/U3207/Y (sky130_fd_sc_hd__a21oi_1)        0.01      0.26      0.26      9.62 r
  u_core/U3224/B (sky130_fd_sc_hd__nor2_1)                   0.26      0.00      9.62 r
  u_core/U3224/Y (sky130_fd_sc_hd__nor2_1)         0.01      0.10      0.11      9.73 f
  ctmTdsLR_1_13810/A (sky130_fd_sc_hd__nor2_1)               0.10      0.00      9.73 f
  ctmTdsLR_1_13810/Y (sky130_fd_sc_hd__nor2_1)     0.01      0.25      0.25      9.98 r
  u_core/U3245/B (sky130_fd_sc_hd__nor2_1)                   0.25      0.00      9.98 r
  u_core/U3245/Y (sky130_fd_sc_hd__nor2_1)         0.01      0.09      0.10     10.08 f
  ctmTdsLR_1_13410/B1 (sky130_fd_sc_hd__a21o_1)              0.09      0.00     10.08 f
  ctmTdsLR_1_13410/X (sky130_fd_sc_hd__a21o_1)     0.01      0.05      0.18     10.25 f
  ctmTdsLR_4_6605/A (sky130_fd_sc_hd__inv_2)                 0.05      0.00     10.26 f
  ctmTdsLR_4_6605/Y (sky130_fd_sc_hd__inv_2)       0.04      0.18      0.15     10.41 r
  u_core/U3263/B (sky130_fd_sc_hd__nor2_1)                   0.18      0.00     10.41 r
  u_core/U3263/Y (sky130_fd_sc_hd__nor2_1)         0.01      0.09      0.08     10.50 f
  u_core/U3829/B1 (sky130_fd_sc_hd__a21oi_1)                 0.09      0.00     10.50 f
  u_core/U3829/Y (sky130_fd_sc_hd__a21oi_1)        0.01      0.19      0.19     10.68 r
  u_core/U3283/A (sky130_fd_sc_hd__nand2_1)                  0.19      0.00     10.68 r
  u_core/U3283/Y (sky130_fd_sc_hd__nand2_1)        0.01      0.09      0.12     10.80 f
  u_core/U3285/A2 (sky130_fd_sc_hd__a21oi_2)                 0.09      0.00     10.80 f
  u_core/U3285/Y (sky130_fd_sc_hd__a21oi_2)        0.01      0.20      0.23     11.03 r
  ctmTdsLR_2_7441/B (sky130_fd_sc_hd__maj3_1)                0.20      0.00     11.03 r
  ctmTdsLR_2_7441/X (sky130_fd_sc_hd__maj3_1)      0.02      0.17      0.28     11.31 r
  u_core/U3323/A1 (sky130_fd_sc_hd__a21o_1)                  0.17      0.00     11.31 r
  u_core/U3323/X (sky130_fd_sc_hd__a21o_1)         0.01      0.07      0.16     11.47 r
  u_core/U3324/B1 (sky130_fd_sc_hd__o21ai_2)                 0.07      0.00     11.47 r
  u_core/U3324/Y (sky130_fd_sc_hd__o21ai_2)        0.01      0.09      0.07     11.54 f
  u_core/U3325/A (sky130_fd_sc_hd__nand2_1)                  0.09      0.00     11.54 f
  u_core/U3325/Y (sky130_fd_sc_hd__nand2_1)        0.01      0.08      0.10     11.64 r
  ctmTdsLR_1_13815/B2 (sky130_fd_sc_hd__a2bb2oi_1)           0.08      0.00     11.64 r
  ctmTdsLR_1_13815/Y (sky130_fd_sc_hd__a2bb2oi_1)
                                                   0.01      0.12      0.10     11.74 f
  u_core/U3362/B (sky130_fd_sc_hd__nor2_1)                   0.12      0.00     11.74 f
  u_core/U3362/Y (sky130_fd_sc_hd__nor2_1)         0.01      0.19      0.19     11.93 r
  ctmTdsLR_1_13412/B1 (sky130_fd_sc_hd__a21oi_2)             0.19      0.00     11.93 r
  ctmTdsLR_1_13412/Y (sky130_fd_sc_hd__a21oi_2)    0.01      0.09      0.07     12.00 f
  u_core/U3364/B (sky130_fd_sc_hd__nor2_1)                   0.09      0.00     12.00 f
  u_core/U3364/Y (sky130_fd_sc_hd__nor2_1)         0.01      0.14      0.14     12.15 r
  u_core/U3366/A2 (sky130_fd_sc_hd__o21ai_2)                 0.14      0.00     12.15 r
  u_core/U3366/Y (sky130_fd_sc_hd__o21ai_2)        0.01      0.09      0.09     12.23 f
  u_core/U3367/B (sky130_fd_sc_hd__nor2_1)                   0.09      0.00     12.24 f
  u_core/U3367/Y (sky130_fd_sc_hd__nor2_1)         0.01      0.13      0.13     12.37 r
  u_core/U3369/A2 (sky130_fd_sc_hd__o21ai_2)                 0.13      0.00     12.37 r
  u_core/U3369/Y (sky130_fd_sc_hd__o21ai_2)        0.01      0.07      0.09     12.45 f
  ctmTdsLR_1_6593/A2 (sky130_fd_sc_hd__o21bai_1)             0.07      0.00     12.46 f
  ctmTdsLR_1_6593/Y (sky130_fd_sc_hd__o21bai_1)    0.01      0.16      0.16     12.62 r
  ctmTdsLR_2_6594/A (sky130_fd_sc_hd__nand2_2)               0.16      0.00     12.62 r
  ctmTdsLR_2_6594/Y (sky130_fd_sc_hd__nand2_2)     0.01      0.07      0.08     12.70 f
  u_core/U3373/B (sky130_fd_sc_hd__nor2_1)                   0.07      0.00     12.70 f
  u_core/U3373/Y (sky130_fd_sc_hd__nor2_1)         0.01      0.13      0.12     12.82 r
  u_core/U3375/A2 (sky130_fd_sc_hd__o21ai_2)                 0.13      0.00     12.82 r
  u_core/U3375/Y (sky130_fd_sc_hd__o21ai_2)        0.01      0.09      0.08     12.91 f
  u_core/U3376/B (sky130_fd_sc_hd__nor2_1)                   0.09      0.00     12.91 f
  u_core/U3376/Y (sky130_fd_sc_hd__nor2_1)         0.01      0.13      0.13     13.04 r
  u_core/U3378/A2 (sky130_fd_sc_hd__o21ai_2)                 0.13      0.00     13.04 r
  u_core/U3378/Y (sky130_fd_sc_hd__o21ai_2)        0.01      0.06      0.08     13.12 f
  ctmTdsLR_1_6591/A2 (sky130_fd_sc_hd__o21bai_1)             0.06      0.00     13.12 f
  ctmTdsLR_1_6591/Y (sky130_fd_sc_hd__o21bai_1)    0.00      0.14      0.14     13.26 r
  ctmTdsLR_2_6592/B (sky130_fd_sc_hd__nand2_1)               0.14      0.00     13.26 r
  ctmTdsLR_2_6592/Y (sky130_fd_sc_hd__nand2_1)     0.01      0.08      0.11     13.37 f
  u_core/U3382/B (sky130_fd_sc_hd__nor2_1)                   0.08      0.00     13.37 f
  u_core/U3382/Y (sky130_fd_sc_hd__nor2_1)         0.01      0.14      0.14     13.51 r
  u_core/U3384/A2 (sky130_fd_sc_hd__o21ai_2)                 0.14      0.00     13.51 r
  u_core/U3384/Y (sky130_fd_sc_hd__o21ai_2)        0.01      0.07      0.09     13.60 f
  u_core/U3793/B (sky130_fd_sc_hd__nor2_1)                   0.07      0.00     13.60 f
  u_core/U3793/Y (sky130_fd_sc_hd__nor2_1)         0.01      0.14      0.13     13.74 r
  u_core/U3794/A2 (sky130_fd_sc_hd__o21ai_2)                 0.14      0.00     13.74 r
  u_core/U3794/Y (sky130_fd_sc_hd__o21ai_2)        0.01      0.07      0.09     13.83 f
  ctmTdsLR_1_6589/A2 (sky130_fd_sc_hd__o21bai_1)             0.07      0.00     13.83 f
  ctmTdsLR_1_6589/Y (sky130_fd_sc_hd__o21bai_1)    0.00      0.13      0.14     13.97 r
  ctmTdsLR_2_6590/B (sky130_fd_sc_hd__nand2_1)               0.13      0.00     13.97 r
  ctmTdsLR_2_6590/Y (sky130_fd_sc_hd__nand2_1)     0.02      0.12      0.14     14.11 f
  u_core/U3820/A2 (sky130_fd_sc_hd__o21ai_1)                 0.12      0.00     14.11 f
  u_core/U3820/Y (sky130_fd_sc_hd__o21ai_1)        0.00      0.12      0.15     14.26 r
  u_core/U3821/B (sky130_fd_sc_hd__nand2_1)                  0.12      0.00     14.26 r
  u_core/U3821/Y (sky130_fd_sc_hd__nand2_1)        0.01      0.09      0.11     14.37 f
  u_core/U3822/B (sky130_fd_sc_hd__nor2_1)                   0.09      0.00     14.37 f
  u_core/U3822/Y (sky130_fd_sc_hd__nor2_1)         0.00      0.11      0.12     14.50 r
  ctmTdsLR_1_6867/A2 (sky130_fd_sc_hd__o21a_2)               0.11      0.00     14.50 r
  ctmTdsLR_1_6867/X (sky130_fd_sc_hd__o21a_2)      0.01      0.06      0.14     14.64 r
  u_core/U3825/B (sky130_fd_sc_hd__nor2_1)                   0.06      0.00     14.64 r
  u_core/U3825/Y (sky130_fd_sc_hd__nor2_1)         0.01      0.06      0.05     14.69 f
  u_core/U3827/A_N (sky130_fd_sc_hd__nand2b_2)               0.06      0.00     14.69 f
  u_core/U3827/Y (sky130_fd_sc_hd__nand2b_2)       0.02      0.09      0.22     14.92 f
  u_core/U4205/A2 (sky130_fd_sc_hd__o21ai_1)                 0.09      0.00     14.92 f
  u_core/U4205/Y (sky130_fd_sc_hd__o21ai_1)        0.00      0.11      0.14     15.05 r
  u_core/U4206/B1 (sky130_fd_sc_hd__a21oi_1)                 0.11      0.00     15.05 r
  u_core/U4206/Y (sky130_fd_sc_hd__a21oi_1)        0.00      0.06      0.06     15.11 f
  u_core/U4207/B1 (sky130_fd_sc_hd__a31oi_1)                 0.06      0.00     15.11 f
  u_core/U4207/Y (sky130_fd_sc_hd__a31oi_1)        0.00      0.13      0.14     15.25 r
  u_core/U4221/A (sky130_fd_sc_hd__nand3_1)                  0.13      0.00     15.25 r
  u_core/U4221/Y (sky130_fd_sc_hd__nand3_1)        0.00      0.08      0.10     15.35 f
  u_core/ex1a_ex1b_reg_q_reg_alu_result__31_/D (sky130_fd_sc_hd__dfxtp_4)
                                                             0.08      0.00     15.35 f
  data arrival time                                                             15.35

  clock clk_i (rise edge)                                             13.33     13.33
  clock network delay (propagated)                                     2.58     15.92
  u_core/ex1a_ex1b_reg_q_reg_alu_result__31_/CLK (sky130_fd_sc_hd__dfxtp_4)
                                                             0.39      0.00     15.92 r
  clock uncertainty                                                   -0.50     15.42
  library setup time                                                  -0.05     15.37
  data required time                                                            15.37
  --------------------------------------------------------------------------------------------
  data required time                                                            15.37
  data arrival time                                                            -15.35
  --------------------------------------------------------------------------------------------
  slack (MET)                                                                    0.02

  Startpoint: u_core/u_icache_ic_addr_q_reg_7_ (rising edge-triggered flip-flop clocked by clk_i)
  Endpoint: u_core/u_if_pc_q_reg_30_ (rising edge-triggered flip-flop clocked by clk_i)
  Mode: default
  Corner: default
  Scenario: default
  Path Group: PIPELINE
  Path Type: max

  Point                                            Cap      Trans      Incr      Path  
  --------------------------------------------------------------------------------------------
  clock clk_i (rise edge)                                              0.00      0.00
  clock network delay (propagated)                                     2.69      2.69

  u_core/u_icache_ic_addr_q_reg_7_/CLK (sky130_fd_sc_hd__dfxtp_2)
                                                             0.21      0.00      2.69 r
  u_core/u_icache_ic_addr_q_reg_7_/Q (sky130_fd_sc_hd__dfxtp_2)
                                                   0.02      0.13      0.43      3.13 r
  HFSBUF_100_4629/A (sky130_fd_sc_hd__buf_6)                 0.13      0.00      3.13 r
  HFSBUF_100_4629/X (sky130_fd_sc_hd__buf_6)       0.20      0.42      0.35      3.48 r
  copt_gre_mt_inst_14369/A (sky130_fd_sc_hd__buf_6)          0.43      0.07      3.54 r
  copt_gre_mt_inst_14369/X (sky130_fd_sc_hd__buf_6)
                                                   0.17      0.34      0.37      3.91 r
  u_core/U536/A (sky130_fd_sc_hd__or2b_2)                    0.35      0.03      3.94 r
  u_core/U536/X (sky130_fd_sc_hd__or2b_2)          0.02      0.13      0.25      4.19 r
  ctmTdsLR_1_7015/B (sky130_fd_sc_hd__or2_2)                 0.13      0.00      4.19 r
  ctmTdsLR_1_7015/X (sky130_fd_sc_hd__or2_2)       0.01      0.08      0.17      4.36 r
  ctmTdsLR_2_7016/A (sky130_fd_sc_hd__clkinv_4)              0.08      0.00      4.36 r
  ctmTdsLR_2_7016/Y (sky130_fd_sc_hd__clkinv_4)    0.11      0.21      0.19      4.55 f
  u_core/U732/A1 (sky130_fd_sc_hd__a22oi_1)                  0.22      0.01      4.56 f
  u_core/U732/Y (sky130_fd_sc_hd__a22oi_1)         0.02      0.41      0.42      4.98 r
  u_core/U733/D (sky130_fd_sc_hd__nand4_1)                   0.41      0.00      4.98 r
  u_core/U733/Y (sky130_fd_sc_hd__nand4_1)         0.02      0.29      0.31      5.29 f
  u_core/U734/B (sky130_fd_sc_hd__nor2_2)                    0.29      0.00      5.29 f
  u_core/U734/Y (sky130_fd_sc_hd__nor2_2)          0.01      0.13      0.20      5.49 r
  u_core/U757/A1 (sky130_fd_sc_hd__o211ai_1)                 0.13      0.00      5.49 r
  u_core/U757/Y (sky130_fd_sc_hd__o211ai_1)        0.01      0.10      0.13      5.62 f
  u_core/U758/C1 (sky130_fd_sc_hd__a221oi_1)                 0.10      0.00      5.62 f
  u_core/U758/Y (sky130_fd_sc_hd__a221oi_1)        0.01      0.29      0.27      5.88 r
  u_core/U759/B2 (sky130_fd_sc_hd__a32oi_1)                  0.29      0.00      5.88 r
  u_core/U759/Y (sky130_fd_sc_hd__a32oi_1)         0.00      0.13      0.11      5.99 f
  u_core/U760/B (sky130_fd_sc_hd__nand2_1)                   0.13      0.00      5.99 f
  u_core/U760/Y (sky130_fd_sc_hd__nand2_1)         0.01      0.10      0.13      6.12 r
  u_core/U761/B1 (sky130_fd_sc_hd__o21ai_2)                  0.10      0.00      6.12 r
  u_core/U761/Y (sky130_fd_sc_hd__o21ai_2)         0.04      0.18      0.16      6.28 f
  u_core/U766/A (sky130_fd_sc_hd__nand4_1)                   0.18      0.00      6.28 f
  u_core/U766/Y (sky130_fd_sc_hd__nand4_1)         0.00      0.09      0.14      6.42 r
  ctmTdsLR_2_12175/A3 (sky130_fd_sc_hd__o31a_1)              0.09      0.00      6.42 r
  ctmTdsLR_2_12175/X (sky130_fd_sc_hd__o31a_1)     0.01      0.08      0.14      6.55 r
  ctmTdsLR_1_12174/A (sky130_fd_sc_hd__inv_2)                0.08      0.00      6.55 r
  ctmTdsLR_1_12174/Y (sky130_fd_sc_hd__inv_2)      0.05      0.11      0.11      6.67 f
  copt_gre_mt_inst_15304/A (sky130_fd_sc_hd__clkbuf_16)      0.11      0.00      6.67 f
  copt_gre_mt_inst_15304/X (sky130_fd_sc_hd__clkbuf_16)
                                                   0.11      0.07      0.20      6.87 f
  copt_gre_mt_inst_15303/A (sky130_fd_sc_hd__buf_4)          0.89      0.59      7.46 f
  copt_gre_mt_inst_15303/X (sky130_fd_sc_hd__buf_4)
                                                   0.13      0.18      0.55      8.01 f
  ctmTdsLR_1_6577/B (sky130_fd_sc_hd__nand3_2)               0.18      0.01      8.03 f
  ctmTdsLR_1_6577/Y (sky130_fd_sc_hd__nand3_2)     0.00      0.08      0.12      8.15 r
  ctmTdsLR_1_7579/B (sky130_fd_sc_hd__nand3b_1)              0.08      0.00      8.15 r
  ctmTdsLR_1_7579/Y (sky130_fd_sc_hd__nand3b_1)    0.01      0.08      0.10      8.25 f
  u_core/U782/A (sky130_fd_sc_hd__nand3_2)                   0.08      0.00      8.25 f
  u_core/U782/Y (sky130_fd_sc_hd__nand3_2)         0.01      0.13      0.10      8.35 r
  HFSBUF_32_1478/A (sky130_fd_sc_hd__buf_12)                 0.13      0.00      8.35 r
  HFSBUF_32_1478/X (sky130_fd_sc_hd__buf_12)       0.17      0.21      0.24      8.58 r
  ctmTdsLR_1_6620/B (sky130_fd_sc_hd__nor2_4)                0.21      0.02      8.60 r
  ctmTdsLR_1_6620/Y (sky130_fd_sc_hd__nor2_4)      0.07      0.15      0.14      8.74 f
  HFSINV_2387_5590/A (sky130_fd_sc_hd__clkinv_4)             0.15      0.00      8.74 f
  HFSINV_2387_5590/Y (sky130_fd_sc_hd__clkinv_4)   0.18      0.36      0.31      9.04 r
  u_core/U1012/B1 (sky130_fd_sc_hd__o21ai_1)                 0.36      0.00      9.05 r
  u_core/U1012/Y (sky130_fd_sc_hd__o21ai_1)        0.01      0.11      0.14      9.19 f
  ctmTdsLR_3_13692/B (sky130_fd_sc_hd__or2_1)                0.11      0.00      9.19 f
  ctmTdsLR_3_13692/X (sky130_fd_sc_hd__or2_1)      0.01      0.07      0.25      9.44 f
  ctmTdsLR_2_13691/A (sky130_fd_sc_hd__nand2_1)              0.07      0.00      9.44 f
  ctmTdsLR_2_13691/Y (sky130_fd_sc_hd__nand2_1)    0.01      0.07      0.08      9.52 r
  ctmTdsLR_1_13690/A (sky130_fd_sc_hd__nand2_2)              0.07      0.00      9.52 r
  ctmTdsLR_1_13690/Y (sky130_fd_sc_hd__nand2_2)    0.01      0.06      0.07      9.59 f
  u_core/U1025/B1 (sky130_fd_sc_hd__o21ai_2)                 0.06      0.00      9.59 f
  u_core/U1025/Y (sky130_fd_sc_hd__o21ai_2)        0.01      0.12      0.07      9.65 r
  u_core/U1027/A (sky130_fd_sc_hd__nand2_2)                  0.12      0.00      9.65 r
  u_core/U1027/Y (sky130_fd_sc_hd__nand2_2)        0.01      0.06      0.08      9.73 f
  ctmTdsLR_1_13912/B (sky130_fd_sc_hd__maj3_2)               0.06      0.00      9.73 f
  ctmTdsLR_1_13912/X (sky130_fd_sc_hd__maj3_2)     0.01      0.08      0.33     10.06 f
  u_core/U1028/B1 (sky130_fd_sc_hd__o21ai_2)                 0.08      0.00     10.06 f
  u_core/U1028/Y (sky130_fd_sc_hd__o21ai_2)        0.01      0.12      0.07     10.14 r
  u_core/U1030/A (sky130_fd_sc_hd__nand2_2)                  0.12      0.00     10.14 r
  u_core/U1030/Y (sky130_fd_sc_hd__nand2_2)        0.00      0.04      0.06     10.20 f
  u_core/U1237/CI (sky130_fd_sc_hd__fah_1)                   0.04      0.00     10.20 f
  u_core/U1237/COUT (sky130_fd_sc_hd__fah_1)       0.01      0.07      0.25     10.45 f
  u_core/U1230/CI (sky130_fd_sc_hd__fah_1)                   0.07      0.00     10.45 f
  u_core/U1230/COUT (sky130_fd_sc_hd__fah_1)       0.01      0.07      0.27     10.71 f
  u_core/U1223/CI (sky130_fd_sc_hd__fah_1)                   0.07      0.00     10.71 f
  u_core/U1223/COUT (sky130_fd_sc_hd__fah_1)       0.00      0.07      0.26     10.97 f
  u_core/U1216/CI (sky130_fd_sc_hd__fah_1)                   0.07      0.00     10.97 f
  u_core/U1216/COUT (sky130_fd_sc_hd__fah_1)       0.01      0.09      0.29     11.26 f
  ctmTdsLR_4_13804/B (sky130_fd_sc_hd__maj3_2)               0.09      0.00     11.27 f
  ctmTdsLR_4_13804/X (sky130_fd_sc_hd__maj3_2)     0.01      0.07      0.33     11.60 f
  ctmTdsLR_3_13803/A1 (sky130_fd_sc_hd__a22o_1)              0.07      0.00     11.60 f
  ctmTdsLR_3_13803/X (sky130_fd_sc_hd__a22o_1)     0.01      0.08      0.26     11.85 f
  ctmTdsLR_5_13860/A1 (sky130_fd_sc_hd__a21boi_2)            0.08      0.00     11.85 f
  ctmTdsLR_5_13860/Y (sky130_fd_sc_hd__a21boi_2)   0.01      0.17      0.19     12.04 r
  ctmTdsLR_3_13858/B2 (sky130_fd_sc_hd__o2bb2ai_2)           0.17      0.00     12.05 r
  ctmTdsLR_3_13858/Y (sky130_fd_sc_hd__o2bb2ai_2)
                                                   0.00      0.05      0.07     12.12 f
  u_core/U1177/CI (sky130_fd_sc_hd__fah_1)                   0.05      0.00     12.12 f
  u_core/U1177/COUT (sky130_fd_sc_hd__fah_1)       0.01      0.09      0.29     12.41 f
  ctmTdsLR_2_13753/A (sky130_fd_sc_hd__nand2_2)              0.09      0.00     12.41 f
  ctmTdsLR_2_13753/Y (sky130_fd_sc_hd__nand2_2)    0.01      0.05      0.08     12.48 r
  ctmTdsLR_1_13752/A (sky130_fd_sc_hd__nand2_2)              0.05      0.00     12.48 r
  ctmTdsLR_1_13752/Y (sky130_fd_sc_hd__nand2_2)    0.01      0.06      0.06     12.55 f
  ctmTdsLR_5_13455/A1 (sky130_fd_sc_hd__a21boi_2)            0.06      0.00     12.55 f
  ctmTdsLR_5_13455/Y (sky130_fd_sc_hd__a21boi_2)   0.01      0.17      0.18     12.73 r
  ctmTdsLR_3_13453/B2 (sky130_fd_sc_hd__o2bb2ai_2)           0.17      0.00     12.73 r
  ctmTdsLR_3_13453/Y (sky130_fd_sc_hd__o2bb2ai_2)
                                                   0.01      0.07      0.10     12.82 f
  ctmTdsLR_5_13549/A1 (sky130_fd_sc_hd__a21boi_2)            0.07      0.00     12.83 f
  ctmTdsLR_5_13549/Y (sky130_fd_sc_hd__a21boi_2)   0.01      0.18      0.20     13.02 r
  ctmTdsLR_3_13547/A2 (sky130_fd_sc_hd__o21ai_2)             0.18      0.00     13.02 r
  ctmTdsLR_3_13547/Y (sky130_fd_sc_hd__o21ai_2)    0.01      0.07      0.10     13.12 f
  ctmTdsLR_1_6574/A (sky130_fd_sc_hd__nand2_2)               0.07      0.00     13.12 f
  ctmTdsLR_1_6574/Y (sky130_fd_sc_hd__nand2_2)     0.01      0.05      0.07     13.19 r
  ctmTdsLR_3_6576/A (sky130_fd_sc_hd__nand2_2)               0.05      0.00     13.19 r
  ctmTdsLR_3_6576/Y (sky130_fd_sc_hd__nand2_2)     0.00      0.03      0.04     13.23 f
  u_core/U1118/CI (sky130_fd_sc_hd__fah_1)                   0.03      0.00     13.23 f
  u_core/U1118/COUT (sky130_fd_sc_hd__fah_1)       0.01      0.10      0.29     13.52 f
  ctmTdsLR_2_13823/A (sky130_fd_sc_hd__nand2_2)              0.10      0.00     13.53 f
  ctmTdsLR_2_13823/Y (sky130_fd_sc_hd__nand2_2)    0.01      0.05      0.08     13.61 r
  ctmTdsLR_1_13822/A (sky130_fd_sc_hd__nand2_2)              0.05      0.00     13.61 r
  ctmTdsLR_1_13822/Y (sky130_fd_sc_hd__nand2_2)    0.01      0.06      0.06     13.67 f
  ctmTdsLR_2_13747/A (sky130_fd_sc_hd__nand2_2)              0.06      0.00     13.67 f
  ctmTdsLR_2_13747/Y (sky130_fd_sc_hd__nand2_2)    0.01      0.05      0.06     13.73 r
  ctmTdsLR_1_13746/A (sky130_fd_sc_hd__nand2_2)              0.05      0.00     13.73 r
  ctmTdsLR_1_13746/Y (sky130_fd_sc_hd__nand2_2)    0.01      0.06      0.06     13.80 f
  ctmTdsLR_1_6571/A (sky130_fd_sc_hd__nand2_2)               0.06      0.00     13.80 f
  ctmTdsLR_1_6571/Y (sky130_fd_sc_hd__nand2_2)     0.01      0.06      0.07     13.86 r
  ctmTdsLR_3_6573/A (sky130_fd_sc_hd__nand2_2)               0.06      0.00     13.86 r
  ctmTdsLR_3_6573/Y (sky130_fd_sc_hd__nand2_2)     0.01      0.06      0.06     13.93 f
  ctmTdsLR_2_13741/A (sky130_fd_sc_hd__nand2_2)              0.06      0.00     13.93 f
  ctmTdsLR_2_13741/Y (sky130_fd_sc_hd__nand2_2)    0.01      0.06      0.07     13.99 r
  ctmTdsLR_1_13740/A (sky130_fd_sc_hd__nand2_2)              0.06      0.00     13.99 r
  ctmTdsLR_1_13740/Y (sky130_fd_sc_hd__nand2_2)    0.01      0.06      0.07     14.06 f
  ctmTdsLR_2_13735/A (sky130_fd_sc_hd__nand2_2)              0.06      0.00     14.06 f
  ctmTdsLR_2_13735/Y (sky130_fd_sc_hd__nand2_2)    0.01      0.05      0.06     14.12 r
  ctmTdsLR_1_13734/A (sky130_fd_sc_hd__nand2_2)              0.05      0.00     14.12 r
  ctmTdsLR_1_13734/Y (sky130_fd_sc_hd__nand2_2)    0.01      0.05      0.05     14.18 f
  u_core/U1072/CI (sky130_fd_sc_hd__fah_1)                   0.05      0.00     14.18 f
  u_core/U1072/COUT (sky130_fd_sc_hd__fah_1)       0.01      0.10      0.29     14.47 f
  ctmTdsLR_2_13729/A (sky130_fd_sc_hd__nand2_1)              0.10      0.00     14.47 f
  ctmTdsLR_2_13729/Y (sky130_fd_sc_hd__nand2_1)    0.00      0.05      0.08     14.55 r
  ctmTdsLR_1_13728/A (sky130_fd_sc_hd__nand2_1)              0.05      0.00     14.55 r
  ctmTdsLR_1_13728/Y (sky130_fd_sc_hd__nand2_1)    0.00      0.05      0.05     14.60 f
  u_core/U1055/CI (sky130_fd_sc_hd__fah_1)                   0.05      0.00     14.60 f
  u_core/U1055/COUT (sky130_fd_sc_hd__fah_1)       0.00      0.07      0.25     14.85 f
  u_core/U1291/CI (sky130_fd_sc_hd__fah_1)                   0.07      0.00     14.85 f
  u_core/U1291/SUM (sky130_fd_sc_hd__fah_1)        0.01      0.07      0.27     15.12 f
  u_core/U1041/A (sky130_fd_sc_hd__nand2_1)                  0.07      0.00     15.12 f
  u_core/U1041/Y (sky130_fd_sc_hd__nand2_1)        0.01      0.08      0.09     15.21 r
  u_core/U1046/C1 (sky130_fd_sc_hd__o2111ai_1)               0.08      0.00     15.21 r
  u_core/U1046/Y (sky130_fd_sc_hd__o2111ai_1)      0.00      0.12      0.11     15.33 f
  u_core/u_if_pc_q_reg_30_/D (sky130_fd_sc_hd__dfxtp_4)      0.12      0.00     15.33 f
  data arrival time                                                             15.33

  clock clk_i (rise edge)                                             13.33     13.33
  clock network delay (propagated)                                     2.72     16.05
  u_core/u_if_pc_q_reg_30_/CLK (sky130_fd_sc_hd__dfxtp_4)    0.18      0.00     16.05 r
  clock uncertainty                                                   -0.50     15.55
  library setup time                                                  -0.11     15.44
  data required time                                                            15.44
  --------------------------------------------------------------------------------------------
  data required time                                                            15.44
  data arrival time                                                            -15.33
  --------------------------------------------------------------------------------------------
  slack (MET)                                                                    0.11

  Startpoint: u_core/ex1a_ex1b_reg_q_reg_pc__1_ (rising edge-triggered flip-flop clocked by clk_i)
  Endpoint: u_core/ex1c_ex1b_reg_q_reg_dec_redirect_target__31_ (rising edge-triggered flip-flop clocked by clk_i)
  Mode: default
  Corner: default
  Scenario: default
  Path Group: PIPELINE
  Path Type: max

  Point                                            Cap      Trans      Incr      Path  
  --------------------------------------------------------------------------------------------
  clock clk_i (rise edge)                                              0.00      0.00
  clock network delay (propagated)                                     2.90      2.90

  u_core/ex1a_ex1b_reg_q_reg_pc__1_/CLK (sky130_fd_sc_hd__dfxtp_2)
                                                             0.18      0.00      2.90 r
  u_core/ex1a_ex1b_reg_q_reg_pc__1_/Q (sky130_fd_sc_hd__dfxtp_2)
                                                   0.02      0.06      0.39      3.29 f
  u_core/U1794/A (sky130_fd_sc_hd__clkinv_4)                 0.06      0.00      3.29 f
  u_core/U1794/Y (sky130_fd_sc_hd__clkinv_4)       0.08      0.16      0.14      3.43 r
  ctmTdsLR_2_13475/A (sky130_fd_sc_hd__maj3_1)               0.16      0.01      3.44 r
  ctmTdsLR_2_13475/X (sky130_fd_sc_hd__maj3_1)     0.01      0.13      0.24      3.68 r
  ctmTdsLR_1_13474/B1 (sky130_fd_sc_hd__o2bb2ai_1)           0.13      0.00      3.68 r
  ctmTdsLR_1_13474/Y (sky130_fd_sc_hd__o2bb2ai_1)
                                                   0.01      0.07      0.11      3.79 f
  u_core/U14287/CIN (sky130_fd_sc_hd__fa_1)                  0.07      0.00      3.79 f
  u_core/U14287/COUT (sky130_fd_sc_hd__fa_1)       0.01      0.11      0.42      4.20 f
  ctmTdsLR_4_13673/B (sky130_fd_sc_hd__maj3_1)               0.11      0.00      4.20 f
  ctmTdsLR_4_13673/X (sky130_fd_sc_hd__maj3_1)     0.01      0.10      0.39      4.59 f
  ctmTdsLR_3_13672/A1 (sky130_fd_sc_hd__a22o_1)              0.10      0.00      4.59 f
  ctmTdsLR_3_13672/X (sky130_fd_sc_hd__a22o_1)     0.01      0.07      0.26      4.85 f
  u_core/U14272/CIN (sky130_fd_sc_hd__fa_1)                  0.07      0.00      4.85 f
  u_core/U14272/COUT (sky130_fd_sc_hd__fa_1)       0.01      0.10      0.41      5.26 f
  u_core/U14267/CI (sky130_fd_sc_hd__fah_1)                  0.10      0.00      5.26 f
  u_core/U14267/COUT (sky130_fd_sc_hd__fah_1)      0.01      0.09      0.31      5.56 f
  u_core/U14262/CIN (sky130_fd_sc_hd__fa_1)                  0.09      0.00      5.57 f
  u_core/U14262/COUT (sky130_fd_sc_hd__fa_1)       0.01      0.09      0.40      5.96 f
  u_core/U14256/CIN (sky130_fd_sc_hd__fa_1)                  0.09      0.00      5.96 f
  u_core/U14256/COUT (sky130_fd_sc_hd__fa_1)       0.01      0.09      0.40      6.37 f
  u_core/U14251/CIN (sky130_fd_sc_hd__fa_1)                  0.09      0.00      6.37 f
  u_core/U14251/COUT (sky130_fd_sc_hd__fa_1)       0.01      0.10      0.42      6.79 f
  u_core/U14246/CIN (sky130_fd_sc_hd__fa_1)                  0.10      0.00      6.79 f
  u_core/U14246/COUT (sky130_fd_sc_hd__fa_1)       0.01      0.09      0.40      7.19 f
  u_core/U14241/CIN (sky130_fd_sc_hd__fa_1)                  0.09      0.00      7.19 f
  u_core/U14241/COUT (sky130_fd_sc_hd__fa_1)       0.01      0.09      0.39      7.58 f
  u_core/U14236/CIN (sky130_fd_sc_hd__fa_1)                  0.09      0.00      7.58 f
  u_core/U14236/COUT (sky130_fd_sc_hd__fa_1)       0.01      0.09      0.39      7.97 f
  u_core/U14231/CIN (sky130_fd_sc_hd__fa_1)                  0.09      0.00      7.97 f
  u_core/U14231/COUT (sky130_fd_sc_hd__fa_1)       0.01      0.10      0.41      8.38 f
  u_core/U14226/CIN (sky130_fd_sc_hd__fa_1)                  0.10      0.00      8.38 f
  u_core/U14226/COUT (sky130_fd_sc_hd__fa_1)       0.01      0.10      0.42      8.80 f
  u_core/U14221/CIN (sky130_fd_sc_hd__fa_1)                  0.10      0.00      8.80 f
  u_core/U14221/COUT (sky130_fd_sc_hd__fa_1)       0.01      0.09      0.40      9.20 f
  u_core/U14214/CIN (sky130_fd_sc_hd__fa_1)                  0.09      0.00      9.20 f
  u_core/U14214/COUT (sky130_fd_sc_hd__fa_1)       0.01      0.10      0.41      9.62 f
  u_core/U14209/CIN (sky130_fd_sc_hd__fa_1)                  0.10      0.00      9.62 f
  u_core/U14209/COUT (sky130_fd_sc_hd__fa_1)       0.01      0.10      0.41     10.03 f
  u_core/U14204/CIN (sky130_fd_sc_hd__fa_1)                  0.10      0.00     10.03 f
  u_core/U14204/COUT (sky130_fd_sc_hd__fa_1)       0.01      0.11      0.43     10.45 f
  u_core/U14199/CIN (sky130_fd_sc_hd__fa_1)                  0.11      0.00     10.45 f
  u_core/U14199/COUT (sky130_fd_sc_hd__fa_1)       0.01      0.10      0.41     10.87 f
  u_core/U14194/CIN (sky130_fd_sc_hd__fa_1)                  0.10      0.00     10.87 f
  u_core/U14194/COUT (sky130_fd_sc_hd__fa_1)       0.01      0.10      0.41     11.28 f
  u_core/U14189/CIN (sky130_fd_sc_hd__fa_1)                  0.10      0.00     11.28 f
  u_core/U14189/COUT (sky130_fd_sc_hd__fa_1)       0.01      0.10      0.42     11.70 f
  u_core/U14184/CIN (sky130_fd_sc_hd__fa_1)                  0.10      0.00     11.70 f
  u_core/U14184/COUT (sky130_fd_sc_hd__fa_1)       0.01      0.11      0.42     12.12 f
  u_core/U14179/CIN (sky130_fd_sc_hd__fa_1)                  0.11      0.00     12.12 f
  u_core/U14179/COUT (sky130_fd_sc_hd__fa_1)       0.01      0.10      0.42     12.54 f
  u_core/U14174/CIN (sky130_fd_sc_hd__fa_1)                  0.10      0.00     12.54 f
  u_core/U14174/COUT (sky130_fd_sc_hd__fa_1)       0.01      0.10      0.41     12.95 f
  u_core/U14169/CIN (sky130_fd_sc_hd__fa_1)                  0.10      0.00     12.95 f
  u_core/U14169/COUT (sky130_fd_sc_hd__fa_1)       0.01      0.10      0.41     13.36 f
  u_core/U14163/CIN (sky130_fd_sc_hd__fa_1)                  0.10      0.00     13.36 f
  u_core/U14163/COUT (sky130_fd_sc_hd__fa_1)       0.01      0.10      0.42     13.78 f
  u_core/U14156/CIN (sky130_fd_sc_hd__fa_1)                  0.10      0.00     13.78 f
  u_core/U14156/COUT (sky130_fd_sc_hd__fa_1)       0.01      0.11      0.43     14.21 f
  u_core/U14150/CIN (sky130_fd_sc_hd__fa_1)                  0.11      0.00     14.21 f
  u_core/U14150/COUT (sky130_fd_sc_hd__fa_1)       0.01      0.11      0.44     14.64 f
  u_core/U14145/CIN (sky130_fd_sc_hd__fa_1)                  0.11      0.00     14.64 f
  u_core/U14145/COUT (sky130_fd_sc_hd__fa_1)       0.01      0.09      0.40     15.05 f
  u_core/U14125/B (sky130_fd_sc_hd__xor2_1)                  0.09      0.00     15.05 f
  u_core/U14125/X (sky130_fd_sc_hd__xor2_1)        0.01      0.31      0.28     15.33 r
  u_core/U14131/A2 (sky130_fd_sc_hd__o21ai_1)                0.31      0.00     15.33 r
  u_core/U14131/Y (sky130_fd_sc_hd__o21ai_1)       0.00      0.08      0.10     15.43 f
  u_core/U14132/B1 (sky130_fd_sc_hd__a21oi_1)                0.08      0.00     15.43 f
  u_core/U14132/Y (sky130_fd_sc_hd__a21oi_1)       0.00      0.12      0.13     15.56 r
  u_core/U14133/B1 (sky130_fd_sc_hd__a21oi_1)                0.12      0.00     15.56 r
  u_core/U14133/Y (sky130_fd_sc_hd__a21oi_1)       0.00      0.10      0.06     15.62 f
  u_core/U14142/B1 (sky130_fd_sc_hd__o211ai_1)               0.10      0.00     15.62 f
  u_core/U14142/Y (sky130_fd_sc_hd__o211ai_1)      0.01      0.20      0.13     15.76 r
  u_core/ex1c_ex1b_reg_q_reg_dec_redirect_target__31_/D (sky130_fd_sc_hd__dfxtp_2)
                                                             0.20      0.00     15.76 r
  data arrival time                                                             15.76

  clock clk_i (rise edge)                                             13.33     13.33
  clock network delay (propagated)                                     3.14     16.47
  u_core/ex1c_ex1b_reg_q_reg_dec_redirect_target__31_/CLK (sky130_fd_sc_hd__dfxtp_2)
                                                             0.51      0.00     16.47 r
  clock uncertainty                                                   -0.50     15.97
  library setup time                                                  -0.02     15.95
  data required time                                                            15.95
  --------------------------------------------------------------------------------------------
  data required time                                                            15.95
  data arrival time                                                            -15.76
  --------------------------------------------------------------------------------------------
  slack (MET)                                                                    0.19

  Startpoint: u_core/ex1a_ex1b_reg_q_reg_pc__1_ (rising edge-triggered flip-flop clocked by clk_i)
  Endpoint: u_core/ex1c_ex1b_reg_q_reg_dec_redirect_target__30_ (rising edge-triggered flip-flop clocked by clk_i)
  Mode: default
  Corner: default
  Scenario: default
  Path Group: PIPELINE
  Path Type: max

  Point                                            Cap      Trans      Incr      Path  
  --------------------------------------------------------------------------------------------
  clock clk_i (rise edge)                                              0.00      0.00
  clock network delay (propagated)                                     2.90      2.90

  u_core/ex1a_ex1b_reg_q_reg_pc__1_/CLK (sky130_fd_sc_hd__dfxtp_2)
                                                             0.18      0.00      2.90 r
  u_core/ex1a_ex1b_reg_q_reg_pc__1_/Q (sky130_fd_sc_hd__dfxtp_2)
                                                   0.02      0.06      0.39      3.29 f
  u_core/U1794/A (sky130_fd_sc_hd__clkinv_4)                 0.06      0.00      3.29 f
  u_core/U1794/Y (sky130_fd_sc_hd__clkinv_4)       0.08      0.16      0.14      3.43 r
  ctmTdsLR_2_13475/A (sky130_fd_sc_hd__maj3_1)               0.16      0.01      3.44 r
  ctmTdsLR_2_13475/X (sky130_fd_sc_hd__maj3_1)     0.01      0.13      0.24      3.68 r
  ctmTdsLR_1_13474/B1 (sky130_fd_sc_hd__o2bb2ai_1)           0.13      0.00      3.68 r
  ctmTdsLR_1_13474/Y (sky130_fd_sc_hd__o2bb2ai_1)
                                                   0.01      0.07      0.11      3.79 f
  u_core/U14287/CIN (sky130_fd_sc_hd__fa_1)                  0.07      0.00      3.79 f
  u_core/U14287/COUT (sky130_fd_sc_hd__fa_1)       0.01      0.11      0.42      4.20 f
  ctmTdsLR_4_13673/B (sky130_fd_sc_hd__maj3_1)               0.11      0.00      4.20 f
  ctmTdsLR_4_13673/X (sky130_fd_sc_hd__maj3_1)     0.01      0.10      0.39      4.59 f
  ctmTdsLR_3_13672/A1 (sky130_fd_sc_hd__a22o_1)              0.10      0.00      4.59 f
  ctmTdsLR_3_13672/X (sky130_fd_sc_hd__a22o_1)     0.01      0.07      0.26      4.85 f
  u_core/U14272/CIN (sky130_fd_sc_hd__fa_1)                  0.07      0.00      4.85 f
  u_core/U14272/COUT (sky130_fd_sc_hd__fa_1)       0.01      0.10      0.41      5.26 f
  u_core/U14267/CI (sky130_fd_sc_hd__fah_1)                  0.10      0.00      5.26 f
  u_core/U14267/COUT (sky130_fd_sc_hd__fah_1)      0.01      0.09      0.31      5.56 f
  u_core/U14262/CIN (sky130_fd_sc_hd__fa_1)                  0.09      0.00      5.57 f
  u_core/U14262/COUT (sky130_fd_sc_hd__fa_1)       0.01      0.09      0.40      5.96 f
  u_core/U14256/CIN (sky130_fd_sc_hd__fa_1)                  0.09      0.00      5.96 f
  u_core/U14256/COUT (sky130_fd_sc_hd__fa_1)       0.01      0.09      0.40      6.37 f
  u_core/U14251/CIN (sky130_fd_sc_hd__fa_1)                  0.09      0.00      6.37 f
  u_core/U14251/COUT (sky130_fd_sc_hd__fa_1)       0.01      0.10      0.42      6.79 f
  u_core/U14246/CIN (sky130_fd_sc_hd__fa_1)                  0.10      0.00      6.79 f
  u_core/U14246/COUT (sky130_fd_sc_hd__fa_1)       0.01      0.09      0.40      7.19 f
  u_core/U14241/CIN (sky130_fd_sc_hd__fa_1)                  0.09      0.00      7.19 f
  u_core/U14241/COUT (sky130_fd_sc_hd__fa_1)       0.01      0.09      0.39      7.58 f
  u_core/U14236/CIN (sky130_fd_sc_hd__fa_1)                  0.09      0.00      7.58 f
  u_core/U14236/COUT (sky130_fd_sc_hd__fa_1)       0.01      0.09      0.39      7.97 f
  u_core/U14231/CIN (sky130_fd_sc_hd__fa_1)                  0.09      0.00      7.97 f
  u_core/U14231/COUT (sky130_fd_sc_hd__fa_1)       0.01      0.10      0.41      8.38 f
  u_core/U14226/CIN (sky130_fd_sc_hd__fa_1)                  0.10      0.00      8.38 f
  u_core/U14226/COUT (sky130_fd_sc_hd__fa_1)       0.01      0.10      0.42      8.80 f
  u_core/U14221/CIN (sky130_fd_sc_hd__fa_1)                  0.10      0.00      8.80 f
  u_core/U14221/COUT (sky130_fd_sc_hd__fa_1)       0.01      0.09      0.40      9.20 f
  u_core/U14214/CIN (sky130_fd_sc_hd__fa_1)                  0.09      0.00      9.20 f
  u_core/U14214/COUT (sky130_fd_sc_hd__fa_1)       0.01      0.10      0.41      9.62 f
  u_core/U14209/CIN (sky130_fd_sc_hd__fa_1)                  0.10      0.00      9.62 f
  u_core/U14209/COUT (sky130_fd_sc_hd__fa_1)       0.01      0.10      0.41     10.03 f
  u_core/U14204/CIN (sky130_fd_sc_hd__fa_1)                  0.10      0.00     10.03 f
  u_core/U14204/COUT (sky130_fd_sc_hd__fa_1)       0.01      0.11      0.43     10.45 f
  u_core/U14199/CIN (sky130_fd_sc_hd__fa_1)                  0.11      0.00     10.45 f
  u_core/U14199/COUT (sky130_fd_sc_hd__fa_1)       0.01      0.10      0.41     10.87 f
  u_core/U14194/CIN (sky130_fd_sc_hd__fa_1)                  0.10      0.00     10.87 f
  u_core/U14194/COUT (sky130_fd_sc_hd__fa_1)       0.01      0.10      0.41     11.28 f
  u_core/U14189/CIN (sky130_fd_sc_hd__fa_1)                  0.10      0.00     11.28 f
  u_core/U14189/COUT (sky130_fd_sc_hd__fa_1)       0.01      0.10      0.42     11.70 f
  u_core/U14184/CIN (sky130_fd_sc_hd__fa_1)                  0.10      0.00     11.70 f
  u_core/U14184/COUT (sky130_fd_sc_hd__fa_1)       0.01      0.11      0.42     12.12 f
  u_core/U14179/CIN (sky130_fd_sc_hd__fa_1)                  0.11      0.00     12.12 f
  u_core/U14179/COUT (sky130_fd_sc_hd__fa_1)       0.01      0.10      0.42     12.54 f
  u_core/U14174/CIN (sky130_fd_sc_hd__fa_1)                  0.10      0.00     12.54 f
  u_core/U14174/COUT (sky130_fd_sc_hd__fa_1)       0.01      0.10      0.41     12.95 f
  u_core/U14169/CIN (sky130_fd_sc_hd__fa_1)                  0.10      0.00     12.95 f
  u_core/U14169/COUT (sky130_fd_sc_hd__fa_1)       0.01      0.10      0.41     13.36 f
  u_core/U14163/CIN (sky130_fd_sc_hd__fa_1)                  0.10      0.00     13.36 f
  u_core/U14163/COUT (sky130_fd_sc_hd__fa_1)       0.01      0.10      0.42     13.78 f
  u_core/U14156/CIN (sky130_fd_sc_hd__fa_1)                  0.10      0.00     13.78 f
  u_core/U14156/COUT (sky130_fd_sc_hd__fa_1)       0.01      0.11      0.43     14.21 f
  u_core/U14150/CIN (sky130_fd_sc_hd__fa_1)                  0.11      0.00     14.21 f
  u_core/U14150/COUT (sky130_fd_sc_hd__fa_1)       0.01      0.11      0.44     14.64 f
  u_core/U14145/CIN (sky130_fd_sc_hd__fa_1)                  0.11      0.00     14.64 f
  u_core/U14145/SUM (sky130_fd_sc_hd__fa_1)        0.00      0.09      0.46     15.10 f
  u_core/U14146/B2 (sky130_fd_sc_hd__a22oi_1)                0.09      0.00     15.10 f
  u_core/U14146/Y (sky130_fd_sc_hd__a22oi_1)       0.01      0.20      0.20     15.30 r
  u_core/U14149/B1 (sky130_fd_sc_hd__o211ai_1)               0.20      0.00     15.30 r
  u_core/U14149/Y (sky130_fd_sc_hd__o211ai_1)      0.00      0.11      0.13     15.43 f
  u_core/ex1c_ex1b_reg_q_reg_dec_redirect_target__30_/D (sky130_fd_sc_hd__dfxtp_4)
                                                             0.11      0.00     15.43 f
  data arrival time                                                             15.43

  clock clk_i (rise edge)                                             13.33     13.33
  clock network delay (propagated)                                     2.92     16.25
  u_core/ex1c_ex1b_reg_q_reg_dec_redirect_target__30_/CLK (sky130_fd_sc_hd__dfxtp_4)
                                                             0.22      0.00     16.25 r
  clock uncertainty                                                   -0.50     15.75
  library setup time                                                  -0.10     15.65
  data required time                                                            15.65
  --------------------------------------------------------------------------------------------
  data required time                                                            15.65
  data arrival time                                                            -15.43
  --------------------------------------------------------------------------------------------
  slack (MET)                                                                    0.22

  Startpoint: u_core/u_mem_mem_wb_reg_o_reg_mem_rd_ (rising edge-triggered flip-flop clocked by clk_i)
  Endpoint: u_core/ex1a_ex1b_reg_q_reg_alu_result__30_ (rising edge-triggered flip-flop clocked by clk_i)
  Mode: default
  Corner: default
  Scenario: default
  Path Group: PIPELINE
  Path Type: max

  Point                                            Cap      Trans      Incr      Path  
  --------------------------------------------------------------------------------------------
  clock clk_i (rise edge)                                              0.00      0.00
  clock network delay (propagated)                                     2.57      2.57

  u_core/u_mem_mem_wb_reg_o_reg_mem_rd_/CLK (sky130_fd_sc_hd__dfxtp_4)
                                                             0.28      0.00      2.57 r
  u_core/u_mem_mem_wb_reg_o_reg_mem_rd_/Q (sky130_fd_sc_hd__dfxtp_4)
                                                   0.06      0.19      0.53      3.10 r
  HFSBUF_109_5541/A (sky130_fd_sc_hd__buf_2)                 0.19      0.00      3.10 r
  HFSBUF_109_5541/X (sky130_fd_sc_hd__buf_2)       0.06      0.30      0.33      3.43 r
  ctmTdsLR_1_6875/A (sky130_fd_sc_hd__inv_2)                 0.30      0.00      3.44 r
  ctmTdsLR_1_6875/Y (sky130_fd_sc_hd__inv_2)       0.01      0.06      0.06      3.50 f
  ctmTdsLR_2_6876/A (sky130_fd_sc_hd__and2_4)                0.06      0.00      3.50 f
  ctmTdsLR_2_6876/X (sky130_fd_sc_hd__and2_4)      0.07      0.10      0.21      3.71 f
  HFSBUF_54_5020/A (sky130_fd_sc_hd__clkbuf_1)               0.10      0.00      3.71 f
  HFSBUF_54_5020/X (sky130_fd_sc_hd__clkbuf_1)     0.04      0.21      0.25      3.96 f
  u_core/U1771/B1 (sky130_fd_sc_hd__a22oi_1)                 0.21      0.00      3.96 f
  u_core/U1771/Y (sky130_fd_sc_hd__a22oi_1)        0.01      0.20      0.23      4.20 r
  ctmTdsLR_1_13720/B1 (sky130_fd_sc_hd__o21a_1)              0.20      0.00      4.20 r
  ctmTdsLR_1_13720/X (sky130_fd_sc_hd__o21a_1)     0.01      0.07      0.17      4.37 r
  ctmTdsLR_2_13566_roptpi_13964/B (sky130_fd_sc_hd__and2_4)
                                                             0.07      0.00      4.37 r
  ctmTdsLR_2_13566_roptpi_13964/X (sky130_fd_sc_hd__and2_4)
                                                   0.11      0.34      0.35      4.72 r
  u_core/U1777/A_N (sky130_fd_sc_hd__nand2b_1)               0.34      0.01      4.73 r
  u_core/U1777/Y (sky130_fd_sc_hd__nand2b_1)       0.01      0.10      0.18      4.91 r
  ctmTdsLR_3_13833/A (sky130_fd_sc_hd__nand3_2)              0.10      0.00      4.91 r
  ctmTdsLR_3_13833/Y (sky130_fd_sc_hd__nand3_2)    0.00      0.08      0.07      4.97 f
  ctmTdsLR_2_13832_roptpi_13971/A (sky130_fd_sc_hd__or2_4)   0.08      0.00      4.97 f
  ctmTdsLR_2_13832_roptpi_13971/X (sky130_fd_sc_hd__or2_4)
                                                   0.08      0.14      0.37      5.34 f
  ctmTdsLR_1_7045/A1 (sky130_fd_sc_hd__a22o_2)               0.15      0.01      5.35 f
  ctmTdsLR_1_7045/X (sky130_fd_sc_hd__a22o_2)      0.03      0.10      0.34      5.69 f
  HFSBUF_466_4877/A (sky130_fd_sc_hd__buf_2)                 0.10      0.00      5.69 f
  HFSBUF_466_4877/X (sky130_fd_sc_hd__buf_2)       0.07      0.17      0.27      5.95 f
  u_core/U2392/A2 (sky130_fd_sc_hd__o22ai_1)                 0.17      0.00      5.96 f
  u_core/U2392/Y (sky130_fd_sc_hd__o22ai_1)        0.02      0.45      0.42      6.37 r
  u_core/U2395/A (sky130_fd_sc_hd__nor2_1)                   0.45      0.00      6.38 r
  u_core/U2395/Y (sky130_fd_sc_hd__nor2_1)         0.01      0.11      0.14      6.51 f
  ctmTdsLR_2_7539/B1 (sky130_fd_sc_hd__a21o_1)               0.11      0.00      6.51 f
  ctmTdsLR_2_7539/X (sky130_fd_sc_hd__a21o_1)      0.01      0.05      0.19      6.70 f
  ctmTdsLR_4_6615/A (sky130_fd_sc_hd__inv_2)                 0.05      0.00      6.70 f
  ctmTdsLR_4_6615/Y (sky130_fd_sc_hd__inv_2)       0.01      0.05      0.06      6.76 r
  u_core/U2437/B (sky130_fd_sc_hd__nor2_1)                   0.05      0.00      6.76 r
  u_core/U2437/Y (sky130_fd_sc_hd__nor2_1)         0.01      0.10      0.07      6.83 f
  u_core/U2438/A (sky130_fd_sc_hd__nor2_4)                   0.10      0.00      6.83 f
  u_core/U2438/Y (sky130_fd_sc_hd__nor2_4)         0.01      0.11      0.15      6.99 r
  u_core/U2457/B (sky130_fd_sc_hd__nor2_1)                   0.11      0.00      6.99 r
  u_core/U2457/Y (sky130_fd_sc_hd__nor2_1)         0.01      0.09      0.07      7.06 f
  ctmTdsLR_1_13532/A (sky130_fd_sc_hd__nor2_1)               0.09      0.00      7.06 f
  ctmTdsLR_1_13532/Y (sky130_fd_sc_hd__nor2_1)     0.01      0.19      0.19      7.25 r
  ctmTdsLR_1_12035/B (sky130_fd_sc_hd__maj3_1)               0.19      0.00      7.25 r
  ctmTdsLR_1_12035/X (sky130_fd_sc_hd__maj3_1)     0.01      0.12      0.24      7.49 r
  u_core/U3085/A (sky130_fd_sc_hd__nand2_1)                  0.12      0.00      7.49 r
  u_core/U3085/Y (sky130_fd_sc_hd__nand2_1)        0.01      0.08      0.08      7.57 f
  u_core/U3086/A1 (sky130_fd_sc_hd__a21oi_2)                 0.08      0.00      7.57 f
  u_core/U3086/Y (sky130_fd_sc_hd__a21oi_2)        0.02      0.24      0.24      7.81 r
  u_core/U3107/B (sky130_fd_sc_hd__nor2_1)                   0.24      0.00      7.81 r
  u_core/U3107/Y (sky130_fd_sc_hd__nor2_1)         0.01      0.11      0.11      7.92 f
  ctmTdsLR_1_13808/B (sky130_fd_sc_hd__nor2_1)               0.11      0.00      7.92 f
  ctmTdsLR_1_13808/Y (sky130_fd_sc_hd__nor2_1)     0.01      0.20      0.19      8.12 r
  u_core/U3129/A (sky130_fd_sc_hd__nor2_1)                   0.20      0.00      8.12 r
  u_core/U3129/Y (sky130_fd_sc_hd__nor2_1)         0.01      0.09      0.10      8.21 f
  ctmTdsLR_2_6609/A (sky130_fd_sc_hd__nor2_1)                0.09      0.00      8.21 f
  ctmTdsLR_2_6609/Y (sky130_fd_sc_hd__nor2_1)      0.01      0.21      0.21      8.42 r
  u_core/U3147/A (sky130_fd_sc_hd__nand2_1)                  0.21      0.00      8.42 r
  u_core/U3147/Y (sky130_fd_sc_hd__nand2_1)        0.01      0.08      0.10      8.53 f
  u_core/U3149/A1 (sky130_fd_sc_hd__a21oi_2)                 0.08      0.00      8.53 f
  u_core/U3149/Y (sky130_fd_sc_hd__a21oi_2)        0.01      0.15      0.18      8.70 r
  u_core/U3166/A (sky130_fd_sc_hd__nand2_1)                  0.15      0.00      8.71 r
  u_core/U3166/Y (sky130_fd_sc_hd__nand2_1)        0.01      0.08      0.09      8.80 f
  u_core/U3168/A2 (sky130_fd_sc_hd__a21oi_2)                 0.08      0.00      8.80 f
  u_core/U3168/Y (sky130_fd_sc_hd__a21oi_2)        0.01      0.17      0.20      9.00 r
  u_core/U3185/B (sky130_fd_sc_hd__nor2_1)                   0.17      0.00      9.00 r
  u_core/U3185/Y (sky130_fd_sc_hd__nor2_1)         0.01      0.09      0.08      9.08 f
  ctmTdsLR_2_6607/A (sky130_fd_sc_hd__nor2_1)                0.09      0.00      9.08 f
  ctmTdsLR_2_6607/Y (sky130_fd_sc_hd__nor2_1)      0.01      0.20      0.20      9.28 r
  u_core/U3205/A (sky130_fd_sc_hd__nand2_1)                  0.20      0.00      9.28 r
  u_core/U3205/Y (sky130_fd_sc_hd__nand2_1)        0.00      0.07      0.08      9.36 f
  u_core/U3207/A2 (sky130_fd_sc_hd__a21oi_1)                 0.07      0.00      9.36 f
  u_core/U3207/Y (sky130_fd_sc_hd__a21oi_1)        0.01      0.26      0.26      9.62 r
  u_core/U3224/B (sky130_fd_sc_hd__nor2_1)                   0.26      0.00      9.62 r
  u_core/U3224/Y (sky130_fd_sc_hd__nor2_1)         0.01      0.10      0.11      9.73 f
  ctmTdsLR_1_13810/A (sky130_fd_sc_hd__nor2_1)               0.10      0.00      9.73 f
  ctmTdsLR_1_13810/Y (sky130_fd_sc_hd__nor2_1)     0.01      0.25      0.25      9.98 r
  u_core/U3245/B (sky130_fd_sc_hd__nor2_1)                   0.25      0.00      9.98 r
  u_core/U3245/Y (sky130_fd_sc_hd__nor2_1)         0.01      0.09      0.10     10.08 f
  ctmTdsLR_1_13410/B1 (sky130_fd_sc_hd__a21o_1)              0.09      0.00     10.08 f
  ctmTdsLR_1_13410/X (sky130_fd_sc_hd__a21o_1)     0.01      0.05      0.18     10.25 f
  ctmTdsLR_4_6605/A (sky130_fd_sc_hd__inv_2)                 0.05      0.00     10.26 f
  ctmTdsLR_4_6605/Y (sky130_fd_sc_hd__inv_2)       0.04      0.18      0.15     10.41 r
  u_core/U3263/B (sky130_fd_sc_hd__nor2_1)                   0.18      0.00     10.41 r
  u_core/U3263/Y (sky130_fd_sc_hd__nor2_1)         0.01      0.09      0.08     10.50 f
  u_core/U3829/B1 (sky130_fd_sc_hd__a21oi_1)                 0.09      0.00     10.50 f
  u_core/U3829/Y (sky130_fd_sc_hd__a21oi_1)        0.01      0.19      0.19     10.68 r
  u_core/U3283/A (sky130_fd_sc_hd__nand2_1)                  0.19      0.00     10.68 r
  u_core/U3283/Y (sky130_fd_sc_hd__nand2_1)        0.01      0.09      0.12     10.80 f
  u_core/U3285/A2 (sky130_fd_sc_hd__a21oi_2)                 0.09      0.00     10.80 f
  u_core/U3285/Y (sky130_fd_sc_hd__a21oi_2)        0.01      0.20      0.23     11.03 r
  ctmTdsLR_2_7441/B (sky130_fd_sc_hd__maj3_1)                0.20      0.00     11.03 r
  ctmTdsLR_2_7441/X (sky130_fd_sc_hd__maj3_1)      0.02      0.17      0.28     11.31 r
  u_core/U3323/A1 (sky130_fd_sc_hd__a21o_1)                  0.17      0.00     11.31 r
  u_core/U3323/X (sky130_fd_sc_hd__a21o_1)         0.01      0.07      0.16     11.47 r
  u_core/U3324/B1 (sky130_fd_sc_hd__o21ai_2)                 0.07      0.00     11.47 r
  u_core/U3324/Y (sky130_fd_sc_hd__o21ai_2)        0.01      0.09      0.07     11.54 f
  u_core/U3325/A (sky130_fd_sc_hd__nand2_1)                  0.09      0.00     11.54 f
  u_core/U3325/Y (sky130_fd_sc_hd__nand2_1)        0.01      0.08      0.10     11.64 r
  ctmTdsLR_1_13815/B2 (sky130_fd_sc_hd__a2bb2oi_1)           0.08      0.00     11.64 r
  ctmTdsLR_1_13815/Y (sky130_fd_sc_hd__a2bb2oi_1)
                                                   0.01      0.12      0.10     11.74 f
  u_core/U3362/B (sky130_fd_sc_hd__nor2_1)                   0.12      0.00     11.74 f
  u_core/U3362/Y (sky130_fd_sc_hd__nor2_1)         0.01      0.19      0.19     11.93 r
  ctmTdsLR_1_13412/B1 (sky130_fd_sc_hd__a21oi_2)             0.19      0.00     11.93 r
  ctmTdsLR_1_13412/Y (sky130_fd_sc_hd__a21oi_2)    0.01      0.09      0.07     12.00 f
  u_core/U3364/B (sky130_fd_sc_hd__nor2_1)                   0.09      0.00     12.00 f
  u_core/U3364/Y (sky130_fd_sc_hd__nor2_1)         0.01      0.14      0.14     12.15 r
  u_core/U3366/A2 (sky130_fd_sc_hd__o21ai_2)                 0.14      0.00     12.15 r
  u_core/U3366/Y (sky130_fd_sc_hd__o21ai_2)        0.01      0.09      0.09     12.23 f
  u_core/U3367/B (sky130_fd_sc_hd__nor2_1)                   0.09      0.00     12.24 f
  u_core/U3367/Y (sky130_fd_sc_hd__nor2_1)         0.01      0.13      0.13     12.37 r
  u_core/U3369/A2 (sky130_fd_sc_hd__o21ai_2)                 0.13      0.00     12.37 r
  u_core/U3369/Y (sky130_fd_sc_hd__o21ai_2)        0.01      0.07      0.09     12.45 f
  ctmTdsLR_1_6593/A2 (sky130_fd_sc_hd__o21bai_1)             0.07      0.00     12.46 f
  ctmTdsLR_1_6593/Y (sky130_fd_sc_hd__o21bai_1)    0.01      0.16      0.16     12.62 r
  ctmTdsLR_2_6594/A (sky130_fd_sc_hd__nand2_2)               0.16      0.00     12.62 r
  ctmTdsLR_2_6594/Y (sky130_fd_sc_hd__nand2_2)     0.01      0.07      0.08     12.70 f
  u_core/U3373/B (sky130_fd_sc_hd__nor2_1)                   0.07      0.00     12.70 f
  u_core/U3373/Y (sky130_fd_sc_hd__nor2_1)         0.01      0.13      0.12     12.82 r
  u_core/U3375/A2 (sky130_fd_sc_hd__o21ai_2)                 0.13      0.00     12.82 r
  u_core/U3375/Y (sky130_fd_sc_hd__o21ai_2)        0.01      0.09      0.08     12.91 f
  u_core/U3376/B (sky130_fd_sc_hd__nor2_1)                   0.09      0.00     12.91 f
  u_core/U3376/Y (sky130_fd_sc_hd__nor2_1)         0.01      0.13      0.13     13.04 r
  u_core/U3378/A2 (sky130_fd_sc_hd__o21ai_2)                 0.13      0.00     13.04 r
  u_core/U3378/Y (sky130_fd_sc_hd__o21ai_2)        0.01      0.06      0.08     13.12 f
  ctmTdsLR_1_6591/A2 (sky130_fd_sc_hd__o21bai_1)             0.06      0.00     13.12 f
  ctmTdsLR_1_6591/Y (sky130_fd_sc_hd__o21bai_1)    0.00      0.14      0.14     13.26 r
  ctmTdsLR_2_6592/B (sky130_fd_sc_hd__nand2_1)               0.14      0.00     13.26 r
  ctmTdsLR_2_6592/Y (sky130_fd_sc_hd__nand2_1)     0.01      0.08      0.11     13.37 f
  u_core/U3382/B (sky130_fd_sc_hd__nor2_1)                   0.08      0.00     13.37 f
  u_core/U3382/Y (sky130_fd_sc_hd__nor2_1)         0.01      0.14      0.14     13.51 r
  u_core/U3384/A2 (sky130_fd_sc_hd__o21ai_2)                 0.14      0.00     13.51 r
  u_core/U3384/Y (sky130_fd_sc_hd__o21ai_2)        0.01      0.07      0.09     13.60 f
  u_core/U3793/B (sky130_fd_sc_hd__nor2_1)                   0.07      0.00     13.60 f
  u_core/U3793/Y (sky130_fd_sc_hd__nor2_1)         0.01      0.14      0.13     13.74 r
  u_core/U3794/A2 (sky130_fd_sc_hd__o21ai_2)                 0.14      0.00     13.74 r
  u_core/U3794/Y (sky130_fd_sc_hd__o21ai_2)        0.01      0.07      0.09     13.83 f
  ctmTdsLR_1_6589/A2 (sky130_fd_sc_hd__o21bai_1)             0.07      0.00     13.83 f
  ctmTdsLR_1_6589/Y (sky130_fd_sc_hd__o21bai_1)    0.00      0.13      0.14     13.97 r
  ctmTdsLR_2_6590/B (sky130_fd_sc_hd__nand2_1)               0.13      0.00     13.97 r
  ctmTdsLR_2_6590/Y (sky130_fd_sc_hd__nand2_1)     0.02      0.12      0.14     14.11 f
  u_core/U3820/A2 (sky130_fd_sc_hd__o21ai_1)                 0.12      0.00     14.11 f
  u_core/U3820/Y (sky130_fd_sc_hd__o21ai_1)        0.00      0.12      0.15     14.26 r
  u_core/U3821/B (sky130_fd_sc_hd__nand2_1)                  0.12      0.00     14.26 r
  u_core/U3821/Y (sky130_fd_sc_hd__nand2_1)        0.01      0.09      0.11     14.37 f
  u_core/U3823/A (sky130_fd_sc_hd__nand2_1)                  0.09      0.00     14.37 f
  u_core/U3823/Y (sky130_fd_sc_hd__nand2_1)        0.01      0.09      0.10     14.48 r
  u_core/U4222/B1 (sky130_fd_sc_hd__o21ai_1)                 0.09      0.00     14.48 r
  u_core/U4222/Y (sky130_fd_sc_hd__o21ai_1)        0.01      0.10      0.10     14.58 f
  u_core/U4240/A1 (sky130_fd_sc_hd__a21oi_1)                 0.10      0.00     14.58 f
  u_core/U4240/Y (sky130_fd_sc_hd__a21oi_1)        0.00      0.13      0.15     14.73 r
  u_core/U4241/C2 (sky130_fd_sc_hd__a222oi_1)                0.13      0.00     14.73 r
  u_core/U4241/Y (sky130_fd_sc_hd__a222oi_1)       0.00      0.11      0.09     14.82 f
  u_core/U4242/C1 (sky130_fd_sc_hd__a211o_1)                 0.11      0.00     14.82 f
  u_core/U4242/X (sky130_fd_sc_hd__a211o_1)        0.00      0.05      0.25     15.07 f
  u_core/ex1a_ex1b_reg_q_reg_alu_result__30_/D (sky130_fd_sc_hd__dfxtp_4)
                                                             0.05      0.00     15.07 f
  data arrival time                                                             15.07

  clock clk_i (rise edge)                                             13.33     13.33
  clock network delay (propagated)                                     2.54     15.88
  u_core/ex1a_ex1b_reg_q_reg_alu_result__30_/CLK (sky130_fd_sc_hd__dfxtp_4)
                                                             0.34      0.00     15.88 r
  clock uncertainty                                                   -0.50     15.38
  library setup time                                                  -0.05     15.33
  data required time                                                            15.33
  --------------------------------------------------------------------------------------------
  data required time                                                            15.33
  data arrival time                                                            -15.07
  --------------------------------------------------------------------------------------------
  slack (MET)                                                                    0.26

  Startpoint: u_core/u_icache_ic_addr_q_reg_7_ (rising edge-triggered flip-flop clocked by clk_i)
  Endpoint: u_core/u_if_pc_q_reg_28_ (rising edge-triggered flip-flop clocked by clk_i)
  Mode: default
  Corner: default
  Scenario: default
  Path Group: PIPELINE
  Path Type: max

  Point                                            Cap      Trans      Incr      Path  
  --------------------------------------------------------------------------------------------
  clock clk_i (rise edge)                                              0.00      0.00
  clock network delay (propagated)                                     2.69      2.69

  u_core/u_icache_ic_addr_q_reg_7_/CLK (sky130_fd_sc_hd__dfxtp_2)
                                                             0.21      0.00      2.69 r
  u_core/u_icache_ic_addr_q_reg_7_/Q (sky130_fd_sc_hd__dfxtp_2)
                                                   0.02      0.13      0.43      3.13 r
  HFSBUF_100_4629/A (sky130_fd_sc_hd__buf_6)                 0.13      0.00      3.13 r
  HFSBUF_100_4629/X (sky130_fd_sc_hd__buf_6)       0.20      0.42      0.35      3.48 r
  copt_gre_mt_inst_14369/A (sky130_fd_sc_hd__buf_6)          0.43      0.07      3.54 r
  copt_gre_mt_inst_14369/X (sky130_fd_sc_hd__buf_6)
                                                   0.17      0.34      0.37      3.91 r
  u_core/U536/A (sky130_fd_sc_hd__or2b_2)                    0.35      0.03      3.94 r
  u_core/U536/X (sky130_fd_sc_hd__or2b_2)          0.02      0.13      0.25      4.19 r
  ctmTdsLR_1_7015/B (sky130_fd_sc_hd__or2_2)                 0.13      0.00      4.19 r
  ctmTdsLR_1_7015/X (sky130_fd_sc_hd__or2_2)       0.01      0.08      0.17      4.36 r
  ctmTdsLR_2_7016/A (sky130_fd_sc_hd__clkinv_4)              0.08      0.00      4.36 r
  ctmTdsLR_2_7016/Y (sky130_fd_sc_hd__clkinv_4)    0.11      0.21      0.19      4.55 f
  u_core/U732/A1 (sky130_fd_sc_hd__a22oi_1)                  0.22      0.01      4.56 f
  u_core/U732/Y (sky130_fd_sc_hd__a22oi_1)         0.02      0.41      0.42      4.98 r
  u_core/U733/D (sky130_fd_sc_hd__nand4_1)                   0.41      0.00      4.98 r
  u_core/U733/Y (sky130_fd_sc_hd__nand4_1)         0.02      0.29      0.31      5.29 f
  u_core/U734/B (sky130_fd_sc_hd__nor2_2)                    0.29      0.00      5.29 f
  u_core/U734/Y (sky130_fd_sc_hd__nor2_2)          0.01      0.13      0.20      5.49 r
  u_core/U757/A1 (sky130_fd_sc_hd__o211ai_1)                 0.13      0.00      5.49 r
  u_core/U757/Y (sky130_fd_sc_hd__o211ai_1)        0.01      0.10      0.13      5.62 f
  u_core/U758/C1 (sky130_fd_sc_hd__a221oi_1)                 0.10      0.00      5.62 f
  u_core/U758/Y (sky130_fd_sc_hd__a221oi_1)        0.01      0.29      0.27      5.88 r
  u_core/U759/B2 (sky130_fd_sc_hd__a32oi_1)                  0.29      0.00      5.88 r
  u_core/U759/Y (sky130_fd_sc_hd__a32oi_1)         0.00      0.13      0.11      5.99 f
  u_core/U760/B (sky130_fd_sc_hd__nand2_1)                   0.13      0.00      5.99 f
  u_core/U760/Y (sky130_fd_sc_hd__nand2_1)         0.01      0.10      0.13      6.12 r
  u_core/U761/B1 (sky130_fd_sc_hd__o21ai_2)                  0.10      0.00      6.12 r
  u_core/U761/Y (sky130_fd_sc_hd__o21ai_2)         0.04      0.18      0.16      6.28 f
  u_core/U766/A (sky130_fd_sc_hd__nand4_1)                   0.18      0.00      6.28 f
  u_core/U766/Y (sky130_fd_sc_hd__nand4_1)         0.00      0.09      0.14      6.42 r
  ctmTdsLR_2_12175/A3 (sky130_fd_sc_hd__o31a_1)              0.09      0.00      6.42 r
  ctmTdsLR_2_12175/X (sky130_fd_sc_hd__o31a_1)     0.01      0.08      0.14      6.55 r
  ctmTdsLR_1_12174/A (sky130_fd_sc_hd__inv_2)                0.08      0.00      6.55 r
  ctmTdsLR_1_12174/Y (sky130_fd_sc_hd__inv_2)      0.05      0.11      0.11      6.67 f
  copt_gre_mt_inst_15304/A (sky130_fd_sc_hd__clkbuf_16)      0.11      0.00      6.67 f
  copt_gre_mt_inst_15304/X (sky130_fd_sc_hd__clkbuf_16)
                                                   0.11      0.07      0.20      6.87 f
  copt_gre_mt_inst_15303/A (sky130_fd_sc_hd__buf_4)          0.89      0.59      7.46 f
  copt_gre_mt_inst_15303/X (sky130_fd_sc_hd__buf_4)
                                                   0.13      0.18      0.55      8.01 f
  ctmTdsLR_1_6577/B (sky130_fd_sc_hd__nand3_2)               0.18      0.01      8.03 f
  ctmTdsLR_1_6577/Y (sky130_fd_sc_hd__nand3_2)     0.00      0.08      0.12      8.15 r
  ctmTdsLR_1_7579/B (sky130_fd_sc_hd__nand3b_1)              0.08      0.00      8.15 r
  ctmTdsLR_1_7579/Y (sky130_fd_sc_hd__nand3b_1)    0.01      0.08      0.10      8.25 f
  u_core/U782/A (sky130_fd_sc_hd__nand3_2)                   0.08      0.00      8.25 f
  u_core/U782/Y (sky130_fd_sc_hd__nand3_2)         0.01      0.13      0.10      8.35 r
  HFSBUF_32_1478/A (sky130_fd_sc_hd__buf_12)                 0.13      0.00      8.35 r
  HFSBUF_32_1478/X (sky130_fd_sc_hd__buf_12)       0.17      0.21      0.24      8.58 r
  ctmTdsLR_1_6620/B (sky130_fd_sc_hd__nor2_4)                0.21      0.02      8.60 r
  ctmTdsLR_1_6620/Y (sky130_fd_sc_hd__nor2_4)      0.07      0.15      0.14      8.74 f
  HFSINV_2387_5590/A (sky130_fd_sc_hd__clkinv_4)             0.15      0.00      8.74 f
  HFSINV_2387_5590/Y (sky130_fd_sc_hd__clkinv_4)   0.18      0.36      0.31      9.04 r
  u_core/U1012/B1 (sky130_fd_sc_hd__o21ai_1)                 0.36      0.00      9.05 r
  u_core/U1012/Y (sky130_fd_sc_hd__o21ai_1)        0.01      0.11      0.14      9.19 f
  ctmTdsLR_3_13692/B (sky130_fd_sc_hd__or2_1)                0.11      0.00      9.19 f
  ctmTdsLR_3_13692/X (sky130_fd_sc_hd__or2_1)      0.01      0.07      0.25      9.44 f
  ctmTdsLR_2_13691/A (sky130_fd_sc_hd__nand2_1)              0.07      0.00      9.44 f
  ctmTdsLR_2_13691/Y (sky130_fd_sc_hd__nand2_1)    0.01      0.07      0.08      9.52 r
  ctmTdsLR_1_13690/A (sky130_fd_sc_hd__nand2_2)              0.07      0.00      9.52 r
  ctmTdsLR_1_13690/Y (sky130_fd_sc_hd__nand2_2)    0.01      0.06      0.07      9.59 f
  u_core/U1025/B1 (sky130_fd_sc_hd__o21ai_2)                 0.06      0.00      9.59 f
  u_core/U1025/Y (sky130_fd_sc_hd__o21ai_2)        0.01      0.12      0.07      9.65 r
  u_core/U1027/A (sky130_fd_sc_hd__nand2_2)                  0.12      0.00      9.65 r
  u_core/U1027/Y (sky130_fd_sc_hd__nand2_2)        0.01      0.06      0.08      9.73 f
  ctmTdsLR_1_13912/B (sky130_fd_sc_hd__maj3_2)               0.06      0.00      9.73 f
  ctmTdsLR_1_13912/X (sky130_fd_sc_hd__maj3_2)     0.01      0.08      0.33     10.06 f
  u_core/U1028/B1 (sky130_fd_sc_hd__o21ai_2)                 0.08      0.00     10.06 f
  u_core/U1028/Y (sky130_fd_sc_hd__o21ai_2)        0.01      0.12      0.07     10.14 r
  u_core/U1030/A (sky130_fd_sc_hd__nand2_2)                  0.12      0.00     10.14 r
  u_core/U1030/Y (sky130_fd_sc_hd__nand2_2)        0.00      0.04      0.06     10.20 f
  u_core/U1237/CI (sky130_fd_sc_hd__fah_1)                   0.04      0.00     10.20 f
  u_core/U1237/COUT (sky130_fd_sc_hd__fah_1)       0.01      0.07      0.25     10.45 f
  u_core/U1230/CI (sky130_fd_sc_hd__fah_1)                   0.07      0.00     10.45 f
  u_core/U1230/COUT (sky130_fd_sc_hd__fah_1)       0.01      0.07      0.27     10.71 f
  u_core/U1223/CI (sky130_fd_sc_hd__fah_1)                   0.07      0.00     10.71 f
  u_core/U1223/COUT (sky130_fd_sc_hd__fah_1)       0.00      0.07      0.26     10.97 f
  u_core/U1216/CI (sky130_fd_sc_hd__fah_1)                   0.07      0.00     10.97 f
  u_core/U1216/COUT (sky130_fd_sc_hd__fah_1)       0.01      0.09      0.29     11.26 f
  ctmTdsLR_4_13804/B (sky130_fd_sc_hd__maj3_2)               0.09      0.00     11.27 f
  ctmTdsLR_4_13804/X (sky130_fd_sc_hd__maj3_2)     0.01      0.07      0.33     11.60 f
  ctmTdsLR_3_13803/A1 (sky130_fd_sc_hd__a22o_1)              0.07      0.00     11.60 f
  ctmTdsLR_3_13803/X (sky130_fd_sc_hd__a22o_1)     0.01      0.08      0.26     11.85 f
  ctmTdsLR_5_13860/A1 (sky130_fd_sc_hd__a21boi_2)            0.08      0.00     11.85 f
  ctmTdsLR_5_13860/Y (sky130_fd_sc_hd__a21boi_2)   0.01      0.17      0.19     12.04 r
  ctmTdsLR_3_13858/B2 (sky130_fd_sc_hd__o2bb2ai_2)           0.17      0.00     12.05 r
  ctmTdsLR_3_13858/Y (sky130_fd_sc_hd__o2bb2ai_2)
                                                   0.00      0.05      0.07     12.12 f
  u_core/U1177/CI (sky130_fd_sc_hd__fah_1)                   0.05      0.00     12.12 f
  u_core/U1177/COUT (sky130_fd_sc_hd__fah_1)       0.01      0.09      0.29     12.41 f
  ctmTdsLR_2_13753/A (sky130_fd_sc_hd__nand2_2)              0.09      0.00     12.41 f
  ctmTdsLR_2_13753/Y (sky130_fd_sc_hd__nand2_2)    0.01      0.05      0.08     12.48 r
  ctmTdsLR_1_13752/A (sky130_fd_sc_hd__nand2_2)              0.05      0.00     12.48 r
  ctmTdsLR_1_13752/Y (sky130_fd_sc_hd__nand2_2)    0.01      0.06      0.06     12.55 f
  ctmTdsLR_5_13455/A1 (sky130_fd_sc_hd__a21boi_2)            0.06      0.00     12.55 f
  ctmTdsLR_5_13455/Y (sky130_fd_sc_hd__a21boi_2)   0.01      0.17      0.18     12.73 r
  ctmTdsLR_3_13453/B2 (sky130_fd_sc_hd__o2bb2ai_2)           0.17      0.00     12.73 r
  ctmTdsLR_3_13453/Y (sky130_fd_sc_hd__o2bb2ai_2)
                                                   0.01      0.07      0.10     12.82 f
  ctmTdsLR_5_13549/A1 (sky130_fd_sc_hd__a21boi_2)            0.07      0.00     12.83 f
  ctmTdsLR_5_13549/Y (sky130_fd_sc_hd__a21boi_2)   0.01      0.18      0.20     13.02 r
  ctmTdsLR_3_13547/A2 (sky130_fd_sc_hd__o21ai_2)             0.18      0.00     13.02 r
  ctmTdsLR_3_13547/Y (sky130_fd_sc_hd__o21ai_2)    0.01      0.07      0.10     13.12 f
  ctmTdsLR_1_6574/A (sky130_fd_sc_hd__nand2_2)               0.07      0.00     13.12 f
  ctmTdsLR_1_6574/Y (sky130_fd_sc_hd__nand2_2)     0.01      0.05      0.07     13.19 r
  ctmTdsLR_3_6576/A (sky130_fd_sc_hd__nand2_2)               0.05      0.00     13.19 r
  ctmTdsLR_3_6576/Y (sky130_fd_sc_hd__nand2_2)     0.00      0.03      0.04     13.23 f
  u_core/U1118/CI (sky130_fd_sc_hd__fah_1)                   0.03      0.00     13.23 f
  u_core/U1118/COUT (sky130_fd_sc_hd__fah_1)       0.01      0.10      0.29     13.52 f
  ctmTdsLR_2_13823/A (sky130_fd_sc_hd__nand2_2)              0.10      0.00     13.53 f
  ctmTdsLR_2_13823/Y (sky130_fd_sc_hd__nand2_2)    0.01      0.05      0.08     13.61 r
  ctmTdsLR_1_13822/A (sky130_fd_sc_hd__nand2_2)              0.05      0.00     13.61 r
  ctmTdsLR_1_13822/Y (sky130_fd_sc_hd__nand2_2)    0.01      0.06      0.06     13.67 f
  ctmTdsLR_2_13747/A (sky130_fd_sc_hd__nand2_2)              0.06      0.00     13.67 f
  ctmTdsLR_2_13747/Y (sky130_fd_sc_hd__nand2_2)    0.01      0.05      0.06     13.73 r
  ctmTdsLR_1_13746/A (sky130_fd_sc_hd__nand2_2)              0.05      0.00     13.73 r
  ctmTdsLR_1_13746/Y (sky130_fd_sc_hd__nand2_2)    0.01      0.06      0.06     13.80 f
  ctmTdsLR_1_6571/A (sky130_fd_sc_hd__nand2_2)               0.06      0.00     13.80 f
  ctmTdsLR_1_6571/Y (sky130_fd_sc_hd__nand2_2)     0.01      0.06      0.07     13.86 r
  ctmTdsLR_3_6573/A (sky130_fd_sc_hd__nand2_2)               0.06      0.00     13.86 r
  ctmTdsLR_3_6573/Y (sky130_fd_sc_hd__nand2_2)     0.01      0.06      0.06     13.93 f
  ctmTdsLR_2_13741/A (sky130_fd_sc_hd__nand2_2)              0.06      0.00     13.93 f
  ctmTdsLR_2_13741/Y (sky130_fd_sc_hd__nand2_2)    0.01      0.06      0.07     13.99 r
  ctmTdsLR_1_13740/A (sky130_fd_sc_hd__nand2_2)              0.06      0.00     13.99 r
  ctmTdsLR_1_13740/Y (sky130_fd_sc_hd__nand2_2)    0.01      0.06      0.07     14.06 f
  ctmTdsLR_2_13735/A (sky130_fd_sc_hd__nand2_2)              0.06      0.00     14.06 f
  ctmTdsLR_2_13735/Y (sky130_fd_sc_hd__nand2_2)    0.01      0.05      0.06     14.12 r
  ctmTdsLR_1_13734/A (sky130_fd_sc_hd__nand2_2)              0.05      0.00     14.12 r
  ctmTdsLR_1_13734/Y (sky130_fd_sc_hd__nand2_2)    0.01      0.05      0.05     14.18 f
  u_core/U1072/CI (sky130_fd_sc_hd__fah_1)                   0.05      0.00     14.18 f
  u_core/U1072/COUT (sky130_fd_sc_hd__fah_1)       0.01      0.10      0.29     14.47 f
  ctmTdsLR_5_13732/B (sky130_fd_sc_hd__xnor2_1)              0.10      0.00     14.47 f
  ctmTdsLR_5_13732/Y (sky130_fd_sc_hd__xnor2_1)    0.01      0.19      0.20     14.67 r
  u_core/U1066/A (sky130_fd_sc_hd__nand2_2)                  0.19      0.00     14.67 r
  u_core/U1066/Y (sky130_fd_sc_hd__nand2_2)        0.01      0.08      0.10     14.77 f
  u_core/U1068/C1 (sky130_fd_sc_hd__o2111ai_1)               0.08      0.00     14.77 f
  u_core/U1068/Y (sky130_fd_sc_hd__o2111ai_1)      0.00      0.19      0.11     14.88 r
  u_core/u_if_pc_q_reg_28_/D (sky130_fd_sc_hd__dfxtp_4)      0.19      0.00     14.88 r
  data arrival time                                                             14.88

  clock clk_i (rise edge)                                             13.33     13.33
  clock network delay (propagated)                                     2.45     15.78
  u_core/u_if_pc_q_reg_28_/CLK (sky130_fd_sc_hd__dfxtp_4)    0.28      0.00     15.78 r
  clock uncertainty                                                   -0.50     15.28
  library setup time                                                  -0.06     15.22
  data required time                                                            15.22
  --------------------------------------------------------------------------------------------
  data required time                                                            15.22
  data arrival time                                                            -14.88
  --------------------------------------------------------------------------------------------
  slack (MET)                                                                    0.34

  Startpoint: u_core/u_icache_ic_addr_q_reg_7_ (rising edge-triggered flip-flop clocked by clk_i)
  Endpoint: u_core/u_if_pc_q_reg_29_ (rising edge-triggered flip-flop clocked by clk_i)
  Mode: default
  Corner: default
  Scenario: default
  Path Group: PIPELINE
  Path Type: max

  Point                                            Cap      Trans      Incr      Path  
  --------------------------------------------------------------------------------------------
  clock clk_i (rise edge)                                              0.00      0.00
  clock network delay (propagated)                                     2.69      2.69

  u_core/u_icache_ic_addr_q_reg_7_/CLK (sky130_fd_sc_hd__dfxtp_2)
                                                             0.21      0.00      2.69 r
  u_core/u_icache_ic_addr_q_reg_7_/Q (sky130_fd_sc_hd__dfxtp_2)
                                                   0.02      0.13      0.43      3.13 r
  HFSBUF_100_4629/A (sky130_fd_sc_hd__buf_6)                 0.13      0.00      3.13 r
  HFSBUF_100_4629/X (sky130_fd_sc_hd__buf_6)       0.20      0.42      0.35      3.48 r
  copt_gre_mt_inst_14369/A (sky130_fd_sc_hd__buf_6)          0.43      0.07      3.54 r
  copt_gre_mt_inst_14369/X (sky130_fd_sc_hd__buf_6)
                                                   0.17      0.34      0.37      3.91 r
  u_core/U536/A (sky130_fd_sc_hd__or2b_2)                    0.35      0.03      3.94 r
  u_core/U536/X (sky130_fd_sc_hd__or2b_2)          0.02      0.13      0.25      4.19 r
  ctmTdsLR_1_7015/B (sky130_fd_sc_hd__or2_2)                 0.13      0.00      4.19 r
  ctmTdsLR_1_7015/X (sky130_fd_sc_hd__or2_2)       0.01      0.08      0.17      4.36 r
  ctmTdsLR_2_7016/A (sky130_fd_sc_hd__clkinv_4)              0.08      0.00      4.36 r
  ctmTdsLR_2_7016/Y (sky130_fd_sc_hd__clkinv_4)    0.11      0.21      0.19      4.55 f
  u_core/U732/A1 (sky130_fd_sc_hd__a22oi_1)                  0.22      0.01      4.56 f
  u_core/U732/Y (sky130_fd_sc_hd__a22oi_1)         0.02      0.41      0.42      4.98 r
  u_core/U733/D (sky130_fd_sc_hd__nand4_1)                   0.41      0.00      4.98 r
  u_core/U733/Y (sky130_fd_sc_hd__nand4_1)         0.02      0.29      0.31      5.29 f
  u_core/U734/B (sky130_fd_sc_hd__nor2_2)                    0.29      0.00      5.29 f
  u_core/U734/Y (sky130_fd_sc_hd__nor2_2)          0.01      0.13      0.20      5.49 r
  u_core/U757/A1 (sky130_fd_sc_hd__o211ai_1)                 0.13      0.00      5.49 r
  u_core/U757/Y (sky130_fd_sc_hd__o211ai_1)        0.01      0.10      0.13      5.62 f
  u_core/U758/C1 (sky130_fd_sc_hd__a221oi_1)                 0.10      0.00      5.62 f
  u_core/U758/Y (sky130_fd_sc_hd__a221oi_1)        0.01      0.29      0.27      5.88 r
  u_core/U759/B2 (sky130_fd_sc_hd__a32oi_1)                  0.29      0.00      5.88 r
  u_core/U759/Y (sky130_fd_sc_hd__a32oi_1)         0.00      0.13      0.11      5.99 f
  u_core/U760/B (sky130_fd_sc_hd__nand2_1)                   0.13      0.00      5.99 f
  u_core/U760/Y (sky130_fd_sc_hd__nand2_1)         0.01      0.10      0.13      6.12 r
  u_core/U761/B1 (sky130_fd_sc_hd__o21ai_2)                  0.10      0.00      6.12 r
  u_core/U761/Y (sky130_fd_sc_hd__o21ai_2)         0.04      0.18      0.16      6.28 f
  u_core/U766/A (sky130_fd_sc_hd__nand4_1)                   0.18      0.00      6.28 f
  u_core/U766/Y (sky130_fd_sc_hd__nand4_1)         0.00      0.09      0.14      6.42 r
  ctmTdsLR_2_12175/A3 (sky130_fd_sc_hd__o31a_1)              0.09      0.00      6.42 r
  ctmTdsLR_2_12175/X (sky130_fd_sc_hd__o31a_1)     0.01      0.08      0.14      6.55 r
  ctmTdsLR_1_12174/A (sky130_fd_sc_hd__inv_2)                0.08      0.00      6.55 r
  ctmTdsLR_1_12174/Y (sky130_fd_sc_hd__inv_2)      0.05      0.11      0.11      6.67 f
  copt_gre_mt_inst_15304/A (sky130_fd_sc_hd__clkbuf_16)      0.11      0.00      6.67 f
  copt_gre_mt_inst_15304/X (sky130_fd_sc_hd__clkbuf_16)
                                                   0.11      0.07      0.20      6.87 f
  copt_gre_mt_inst_15303/A (sky130_fd_sc_hd__buf_4)          0.89      0.59      7.46 f
  copt_gre_mt_inst_15303/X (sky130_fd_sc_hd__buf_4)
                                                   0.13      0.18      0.55      8.01 f
  ctmTdsLR_1_6577/B (sky130_fd_sc_hd__nand3_2)               0.18      0.01      8.03 f
  ctmTdsLR_1_6577/Y (sky130_fd_sc_hd__nand3_2)     0.00      0.08      0.12      8.15 r
  ctmTdsLR_1_7579/B (sky130_fd_sc_hd__nand3b_1)              0.08      0.00      8.15 r
  ctmTdsLR_1_7579/Y (sky130_fd_sc_hd__nand3b_1)    0.01      0.08      0.10      8.25 f
  u_core/U782/A (sky130_fd_sc_hd__nand3_2)                   0.08      0.00      8.25 f
  u_core/U782/Y (sky130_fd_sc_hd__nand3_2)         0.01      0.13      0.10      8.35 r
  HFSBUF_32_1478/A (sky130_fd_sc_hd__buf_12)                 0.13      0.00      8.35 r
  HFSBUF_32_1478/X (sky130_fd_sc_hd__buf_12)       0.17      0.21      0.24      8.58 r
  ctmTdsLR_1_6620/B (sky130_fd_sc_hd__nor2_4)                0.21      0.02      8.60 r
  ctmTdsLR_1_6620/Y (sky130_fd_sc_hd__nor2_4)      0.07      0.15      0.14      8.74 f
  HFSINV_2387_5590/A (sky130_fd_sc_hd__clkinv_4)             0.15      0.00      8.74 f
  HFSINV_2387_5590/Y (sky130_fd_sc_hd__clkinv_4)   0.18      0.36      0.31      9.04 r
  u_core/U1012/B1 (sky130_fd_sc_hd__o21ai_1)                 0.36      0.00      9.05 r
  u_core/U1012/Y (sky130_fd_sc_hd__o21ai_1)        0.01      0.11      0.14      9.19 f
  ctmTdsLR_3_13692/B (sky130_fd_sc_hd__or2_1)                0.11      0.00      9.19 f
  ctmTdsLR_3_13692/X (sky130_fd_sc_hd__or2_1)      0.01      0.07      0.25      9.44 f
  ctmTdsLR_2_13691/A (sky130_fd_sc_hd__nand2_1)              0.07      0.00      9.44 f
  ctmTdsLR_2_13691/Y (sky130_fd_sc_hd__nand2_1)    0.01      0.07      0.08      9.52 r
  ctmTdsLR_1_13690/A (sky130_fd_sc_hd__nand2_2)              0.07      0.00      9.52 r
  ctmTdsLR_1_13690/Y (sky130_fd_sc_hd__nand2_2)    0.01      0.06      0.07      9.59 f
  u_core/U1025/B1 (sky130_fd_sc_hd__o21ai_2)                 0.06      0.00      9.59 f
  u_core/U1025/Y (sky130_fd_sc_hd__o21ai_2)        0.01      0.12      0.07      9.65 r
  u_core/U1027/A (sky130_fd_sc_hd__nand2_2)                  0.12      0.00      9.65 r
  u_core/U1027/Y (sky130_fd_sc_hd__nand2_2)        0.01      0.06      0.08      9.73 f
  ctmTdsLR_1_13912/B (sky130_fd_sc_hd__maj3_2)               0.06      0.00      9.73 f
  ctmTdsLR_1_13912/X (sky130_fd_sc_hd__maj3_2)     0.01      0.08      0.33     10.06 f
  u_core/U1028/B1 (sky130_fd_sc_hd__o21ai_2)                 0.08      0.00     10.06 f
  u_core/U1028/Y (sky130_fd_sc_hd__o21ai_2)        0.01      0.12      0.07     10.14 r
  u_core/U1030/A (sky130_fd_sc_hd__nand2_2)                  0.12      0.00     10.14 r
  u_core/U1030/Y (sky130_fd_sc_hd__nand2_2)        0.00      0.04      0.06     10.20 f
  u_core/U1237/CI (sky130_fd_sc_hd__fah_1)                   0.04      0.00     10.20 f
  u_core/U1237/COUT (sky130_fd_sc_hd__fah_1)       0.01      0.07      0.25     10.45 f
  u_core/U1230/CI (sky130_fd_sc_hd__fah_1)                   0.07      0.00     10.45 f
  u_core/U1230/COUT (sky130_fd_sc_hd__fah_1)       0.01      0.07      0.27     10.71 f
  u_core/U1223/CI (sky130_fd_sc_hd__fah_1)                   0.07      0.00     10.71 f
  u_core/U1223/COUT (sky130_fd_sc_hd__fah_1)       0.00      0.07      0.26     10.97 f
  u_core/U1216/CI (sky130_fd_sc_hd__fah_1)                   0.07      0.00     10.97 f
  u_core/U1216/COUT (sky130_fd_sc_hd__fah_1)       0.01      0.09      0.29     11.26 f
  ctmTdsLR_4_13804/B (sky130_fd_sc_hd__maj3_2)               0.09      0.00     11.27 f
  ctmTdsLR_4_13804/X (sky130_fd_sc_hd__maj3_2)     0.01      0.07      0.33     11.60 f
  ctmTdsLR_3_13803/A1 (sky130_fd_sc_hd__a22o_1)              0.07      0.00     11.60 f
  ctmTdsLR_3_13803/X (sky130_fd_sc_hd__a22o_1)     0.01      0.08      0.26     11.85 f
  ctmTdsLR_5_13860/A1 (sky130_fd_sc_hd__a21boi_2)            0.08      0.00     11.85 f
  ctmTdsLR_5_13860/Y (sky130_fd_sc_hd__a21boi_2)   0.01      0.17      0.19     12.04 r
  ctmTdsLR_3_13858/B2 (sky130_fd_sc_hd__o2bb2ai_2)           0.17      0.00     12.05 r
  ctmTdsLR_3_13858/Y (sky130_fd_sc_hd__o2bb2ai_2)
                                                   0.00      0.05      0.07     12.12 f
  u_core/U1177/CI (sky130_fd_sc_hd__fah_1)                   0.05      0.00     12.12 f
  u_core/U1177/COUT (sky130_fd_sc_hd__fah_1)       0.01      0.09      0.29     12.41 f
  ctmTdsLR_2_13753/A (sky130_fd_sc_hd__nand2_2)              0.09      0.00     12.41 f
  ctmTdsLR_2_13753/Y (sky130_fd_sc_hd__nand2_2)    0.01      0.05      0.08     12.48 r
  ctmTdsLR_1_13752/A (sky130_fd_sc_hd__nand2_2)              0.05      0.00     12.48 r
  ctmTdsLR_1_13752/Y (sky130_fd_sc_hd__nand2_2)    0.01      0.06      0.06     12.55 f
  ctmTdsLR_5_13455/A1 (sky130_fd_sc_hd__a21boi_2)            0.06      0.00     12.55 f
  ctmTdsLR_5_13455/Y (sky130_fd_sc_hd__a21boi_2)   0.01      0.17      0.18     12.73 r
  ctmTdsLR_3_13453/B2 (sky130_fd_sc_hd__o2bb2ai_2)           0.17      0.00     12.73 r
  ctmTdsLR_3_13453/Y (sky130_fd_sc_hd__o2bb2ai_2)
                                                   0.01      0.07      0.10     12.82 f
  ctmTdsLR_5_13549/A1 (sky130_fd_sc_hd__a21boi_2)            0.07      0.00     12.83 f
  ctmTdsLR_5_13549/Y (sky130_fd_sc_hd__a21boi_2)   0.01      0.18      0.20     13.02 r
  ctmTdsLR_3_13547/A2 (sky130_fd_sc_hd__o21ai_2)             0.18      0.00     13.02 r
  ctmTdsLR_3_13547/Y (sky130_fd_sc_hd__o21ai_2)    0.01      0.07      0.10     13.12 f
  ctmTdsLR_1_6574/A (sky130_fd_sc_hd__nand2_2)               0.07      0.00     13.12 f
  ctmTdsLR_1_6574/Y (sky130_fd_sc_hd__nand2_2)     0.01      0.05      0.07     13.19 r
  ctmTdsLR_3_6576/A (sky130_fd_sc_hd__nand2_2)               0.05      0.00     13.19 r
  ctmTdsLR_3_6576/Y (sky130_fd_sc_hd__nand2_2)     0.00      0.03      0.04     13.23 f
  u_core/U1118/CI (sky130_fd_sc_hd__fah_1)                   0.03      0.00     13.23 f
  u_core/U1118/COUT (sky130_fd_sc_hd__fah_1)       0.01      0.10      0.29     13.52 f
  ctmTdsLR_2_13823/A (sky130_fd_sc_hd__nand2_2)              0.10      0.00     13.53 f
  ctmTdsLR_2_13823/Y (sky130_fd_sc_hd__nand2_2)    0.01      0.05      0.08     13.61 r
  ctmTdsLR_1_13822/A (sky130_fd_sc_hd__nand2_2)              0.05      0.00     13.61 r
  ctmTdsLR_1_13822/Y (sky130_fd_sc_hd__nand2_2)    0.01      0.06      0.06     13.67 f
  ctmTdsLR_2_13747/A (sky130_fd_sc_hd__nand2_2)              0.06      0.00     13.67 f
  ctmTdsLR_2_13747/Y (sky130_fd_sc_hd__nand2_2)    0.01      0.05      0.06     13.73 r
  ctmTdsLR_1_13746/A (sky130_fd_sc_hd__nand2_2)              0.05      0.00     13.73 r
  ctmTdsLR_1_13746/Y (sky130_fd_sc_hd__nand2_2)    0.01      0.06      0.06     13.80 f
  ctmTdsLR_1_6571/A (sky130_fd_sc_hd__nand2_2)               0.06      0.00     13.80 f
  ctmTdsLR_1_6571/Y (sky130_fd_sc_hd__nand2_2)     0.01      0.06      0.07     13.86 r
  ctmTdsLR_3_6573/A (sky130_fd_sc_hd__nand2_2)               0.06      0.00     13.86 r
  ctmTdsLR_3_6573/Y (sky130_fd_sc_hd__nand2_2)     0.01      0.06      0.06     13.93 f
  ctmTdsLR_2_13741/A (sky130_fd_sc_hd__nand2_2)              0.06      0.00     13.93 f
  ctmTdsLR_2_13741/Y (sky130_fd_sc_hd__nand2_2)    0.01      0.06      0.07     13.99 r
  ctmTdsLR_1_13740/A (sky130_fd_sc_hd__nand2_2)              0.06      0.00     13.99 r
  ctmTdsLR_1_13740/Y (sky130_fd_sc_hd__nand2_2)    0.01      0.06      0.07     14.06 f
  ctmTdsLR_2_13735/A (sky130_fd_sc_hd__nand2_2)              0.06      0.00     14.06 f
  ctmTdsLR_2_13735/Y (sky130_fd_sc_hd__nand2_2)    0.01      0.05      0.06     14.12 r
  ctmTdsLR_1_13734/A (sky130_fd_sc_hd__nand2_2)              0.05      0.00     14.12 r
  ctmTdsLR_1_13734/Y (sky130_fd_sc_hd__nand2_2)    0.01      0.05      0.05     14.18 f
  u_core/U1072/CI (sky130_fd_sc_hd__fah_1)                   0.05      0.00     14.18 f
  u_core/U1072/COUT (sky130_fd_sc_hd__fah_1)       0.01      0.10      0.29     14.47 f
  ctmTdsLR_2_13729/A (sky130_fd_sc_hd__nand2_1)              0.10      0.00     14.47 f
  ctmTdsLR_2_13729/Y (sky130_fd_sc_hd__nand2_1)    0.00      0.05      0.08     14.55 r
  ctmTdsLR_1_13728/A (sky130_fd_sc_hd__nand2_1)              0.05      0.00     14.55 r
  ctmTdsLR_1_13728/Y (sky130_fd_sc_hd__nand2_1)    0.00      0.05      0.05     14.60 f
  u_core/U1055/CI (sky130_fd_sc_hd__fah_1)                   0.05      0.00     14.60 f
  u_core/U1055/SUM (sky130_fd_sc_hd__fah_1)        0.01      0.07      0.26     14.86 f
  u_core/U1057/A (sky130_fd_sc_hd__nand2_1)                  0.07      0.00     14.86 f
  u_core/U1057/Y (sky130_fd_sc_hd__nand2_1)        0.00      0.05      0.07     14.93 r
  u_core/U1059/C1 (sky130_fd_sc_hd__o2111ai_1)               0.05      0.00     14.93 r
  u_core/U1059/Y (sky130_fd_sc_hd__o2111ai_1)      0.01      0.16      0.13     15.06 f
  u_core/u_if_pc_q_reg_29_/D (sky130_fd_sc_hd__dfxtp_4)      0.16      0.00     15.06 f
  data arrival time                                                             15.06

  clock clk_i (rise edge)                                             13.33     13.33
  clock network delay (propagated)                                     2.72     16.05
  u_core/u_if_pc_q_reg_29_/CLK (sky130_fd_sc_hd__dfxtp_4)    0.18      0.00     16.05 r
  clock uncertainty                                                   -0.50     15.55
  library setup time                                                  -0.13     15.42
  data required time                                                            15.42
  --------------------------------------------------------------------------------------------
  data required time                                                            15.42
  data arrival time                                                            -15.06
  --------------------------------------------------------------------------------------------
  slack (MET)                                                                    0.36

  Startpoint: u_core/u_mem_mem_wb_reg_o_reg_mem_rd_ (rising edge-triggered flip-flop clocked by clk_i)
  Endpoint: u_core/ex1a_ex1b_reg_q_reg_alu_result__0_ (rising edge-triggered flip-flop clocked by clk_i)
  Mode: default
  Corner: default
  Scenario: default
  Path Group: PIPELINE
  Path Type: max

  Point                                            Cap      Trans      Incr      Path  
  --------------------------------------------------------------------------------------------
  clock clk_i (rise edge)                                              0.00      0.00
  clock network delay (propagated)                                     2.57      2.57

  u_core/u_mem_mem_wb_reg_o_reg_mem_rd_/CLK (sky130_fd_sc_hd__dfxtp_4)
                                                             0.28      0.00      2.57 r
  u_core/u_mem_mem_wb_reg_o_reg_mem_rd_/Q (sky130_fd_sc_hd__dfxtp_4)
                                                   0.06      0.19      0.53      3.10 r
  HFSBUF_109_5541/A (sky130_fd_sc_hd__buf_2)                 0.19      0.00      3.10 r
  HFSBUF_109_5541/X (sky130_fd_sc_hd__buf_2)       0.06      0.30      0.33      3.43 r
  ctmTdsLR_1_6875/A (sky130_fd_sc_hd__inv_2)                 0.30      0.00      3.44 r
  ctmTdsLR_1_6875/Y (sky130_fd_sc_hd__inv_2)       0.01      0.06      0.06      3.50 f
  ctmTdsLR_2_6876/A (sky130_fd_sc_hd__and2_4)                0.06      0.00      3.50 f
  ctmTdsLR_2_6876/X (sky130_fd_sc_hd__and2_4)      0.07      0.10      0.21      3.71 f
  HFSBUF_54_5020/A (sky130_fd_sc_hd__clkbuf_1)               0.10      0.00      3.71 f
  HFSBUF_54_5020/X (sky130_fd_sc_hd__clkbuf_1)     0.04      0.21      0.25      3.96 f
  u_core/U1771/B1 (sky130_fd_sc_hd__a22oi_1)                 0.21      0.00      3.96 f
  u_core/U1771/Y (sky130_fd_sc_hd__a22oi_1)        0.01      0.20      0.23      4.20 r
  ctmTdsLR_1_13720/B1 (sky130_fd_sc_hd__o21a_1)              0.20      0.00      4.20 r
  ctmTdsLR_1_13720/X (sky130_fd_sc_hd__o21a_1)     0.01      0.07      0.17      4.37 r
  ctmTdsLR_2_13566_roptpi_13964/B (sky130_fd_sc_hd__and2_4)
                                                             0.07      0.00      4.37 r
  ctmTdsLR_2_13566_roptpi_13964/X (sky130_fd_sc_hd__and2_4)
                                                   0.11      0.34      0.35      4.72 r
  u_core/U1777/A_N (sky130_fd_sc_hd__nand2b_1)               0.34      0.01      4.73 r
  u_core/U1777/Y (sky130_fd_sc_hd__nand2b_1)       0.01      0.10      0.18      4.91 r
  ctmTdsLR_3_13833/A (sky130_fd_sc_hd__nand3_2)              0.10      0.00      4.91 r
  ctmTdsLR_3_13833/Y (sky130_fd_sc_hd__nand3_2)    0.00      0.08      0.07      4.97 f
  ctmTdsLR_2_13832_roptpi_13971/A (sky130_fd_sc_hd__or2_4)   0.08      0.00      4.97 f
  ctmTdsLR_2_13832_roptpi_13971/X (sky130_fd_sc_hd__or2_4)
                                                   0.08      0.14      0.37      5.34 f
  ctmTdsLR_1_7045/A1 (sky130_fd_sc_hd__a22o_2)               0.15      0.01      5.35 f
  ctmTdsLR_1_7045/X (sky130_fd_sc_hd__a22o_2)      0.03      0.10      0.34      5.69 f
  HFSBUF_466_4877/A (sky130_fd_sc_hd__buf_2)                 0.10      0.00      5.69 f
  HFSBUF_466_4877/X (sky130_fd_sc_hd__buf_2)       0.07      0.17      0.27      5.95 f
  u_core/U2392/A2 (sky130_fd_sc_hd__o22ai_1)                 0.17      0.00      5.96 f
  u_core/U2392/Y (sky130_fd_sc_hd__o22ai_1)        0.02      0.45      0.42      6.37 r
  u_core/U2395/A (sky130_fd_sc_hd__nor2_1)                   0.45      0.00      6.38 r
  u_core/U2395/Y (sky130_fd_sc_hd__nor2_1)         0.01      0.11      0.14      6.51 f
  ctmTdsLR_2_7539/B1 (sky130_fd_sc_hd__a21o_1)               0.11      0.00      6.51 f
  ctmTdsLR_2_7539/X (sky130_fd_sc_hd__a21o_1)      0.01      0.05      0.19      6.70 f
  ctmTdsLR_4_6615/A (sky130_fd_sc_hd__inv_2)                 0.05      0.00      6.70 f
  ctmTdsLR_4_6615/Y (sky130_fd_sc_hd__inv_2)       0.01      0.05      0.06      6.76 r
  u_core/U2437/B (sky130_fd_sc_hd__nor2_1)                   0.05      0.00      6.76 r
  u_core/U2437/Y (sky130_fd_sc_hd__nor2_1)         0.01      0.10      0.07      6.83 f
  u_core/U2438/A (sky130_fd_sc_hd__nor2_4)                   0.10      0.00      6.83 f
  u_core/U2438/Y (sky130_fd_sc_hd__nor2_4)         0.01      0.11      0.15      6.99 r
  u_core/U2457/B (sky130_fd_sc_hd__nor2_1)                   0.11      0.00      6.99 r
  u_core/U2457/Y (sky130_fd_sc_hd__nor2_1)         0.01      0.09      0.07      7.06 f
  ctmTdsLR_1_13532/A (sky130_fd_sc_hd__nor2_1)               0.09      0.00      7.06 f
  ctmTdsLR_1_13532/Y (sky130_fd_sc_hd__nor2_1)     0.01      0.19      0.19      7.25 r
  ctmTdsLR_1_12035/B (sky130_fd_sc_hd__maj3_1)               0.19      0.00      7.25 r
  ctmTdsLR_1_12035/X (sky130_fd_sc_hd__maj3_1)     0.01      0.12      0.24      7.49 r
  u_core/U3085/A (sky130_fd_sc_hd__nand2_1)                  0.12      0.00      7.49 r
  u_core/U3085/Y (sky130_fd_sc_hd__nand2_1)        0.01      0.08      0.08      7.57 f
  u_core/U3086/A1 (sky130_fd_sc_hd__a21oi_2)                 0.08      0.00      7.57 f
  u_core/U3086/Y (sky130_fd_sc_hd__a21oi_2)        0.02      0.24      0.24      7.81 r
  u_core/U3107/B (sky130_fd_sc_hd__nor2_1)                   0.24      0.00      7.81 r
  u_core/U3107/Y (sky130_fd_sc_hd__nor2_1)         0.01      0.11      0.11      7.92 f
  ctmTdsLR_1_13808/B (sky130_fd_sc_hd__nor2_1)               0.11      0.00      7.92 f
  ctmTdsLR_1_13808/Y (sky130_fd_sc_hd__nor2_1)     0.01      0.20      0.19      8.12 r
  u_core/U3129/A (sky130_fd_sc_hd__nor2_1)                   0.20      0.00      8.12 r
  u_core/U3129/Y (sky130_fd_sc_hd__nor2_1)         0.01      0.09      0.10      8.21 f
  ctmTdsLR_2_6609/A (sky130_fd_sc_hd__nor2_1)                0.09      0.00      8.21 f
  ctmTdsLR_2_6609/Y (sky130_fd_sc_hd__nor2_1)      0.01      0.21      0.21      8.42 r
  u_core/U3147/A (sky130_fd_sc_hd__nand2_1)                  0.21      0.00      8.42 r
  u_core/U3147/Y (sky130_fd_sc_hd__nand2_1)        0.01      0.08      0.10      8.53 f
  u_core/U3149/A1 (sky130_fd_sc_hd__a21oi_2)                 0.08      0.00      8.53 f
  u_core/U3149/Y (sky130_fd_sc_hd__a21oi_2)        0.01      0.15      0.18      8.70 r
  u_core/U3166/A (sky130_fd_sc_hd__nand2_1)                  0.15      0.00      8.71 r
  u_core/U3166/Y (sky130_fd_sc_hd__nand2_1)        0.01      0.08      0.09      8.80 f
  u_core/U3168/A2 (sky130_fd_sc_hd__a21oi_2)                 0.08      0.00      8.80 f
  u_core/U3168/Y (sky130_fd_sc_hd__a21oi_2)        0.01      0.17      0.20      9.00 r
  u_core/U3185/B (sky130_fd_sc_hd__nor2_1)                   0.17      0.00      9.00 r
  u_core/U3185/Y (sky130_fd_sc_hd__nor2_1)         0.01      0.09      0.08      9.08 f
  ctmTdsLR_2_6607/A (sky130_fd_sc_hd__nor2_1)                0.09      0.00      9.08 f
  ctmTdsLR_2_6607/Y (sky130_fd_sc_hd__nor2_1)      0.01      0.20      0.20      9.28 r
  u_core/U3205/A (sky130_fd_sc_hd__nand2_1)                  0.20      0.00      9.28 r
  u_core/U3205/Y (sky130_fd_sc_hd__nand2_1)        0.00      0.07      0.08      9.36 f
  u_core/U3207/A2 (sky130_fd_sc_hd__a21oi_1)                 0.07      0.00      9.36 f
  u_core/U3207/Y (sky130_fd_sc_hd__a21oi_1)        0.01      0.26      0.26      9.62 r
  u_core/U3224/B (sky130_fd_sc_hd__nor2_1)                   0.26      0.00      9.62 r
  u_core/U3224/Y (sky130_fd_sc_hd__nor2_1)         0.01      0.10      0.11      9.73 f
  ctmTdsLR_1_13810/A (sky130_fd_sc_hd__nor2_1)               0.10      0.00      9.73 f
  ctmTdsLR_1_13810/Y (sky130_fd_sc_hd__nor2_1)     0.01      0.25      0.25      9.98 r
  u_core/U3245/B (sky130_fd_sc_hd__nor2_1)                   0.25      0.00      9.98 r
  u_core/U3245/Y (sky130_fd_sc_hd__nor2_1)         0.01      0.09      0.10     10.08 f
  ctmTdsLR_1_13410/B1 (sky130_fd_sc_hd__a21o_1)              0.09      0.00     10.08 f
  ctmTdsLR_1_13410/X (sky130_fd_sc_hd__a21o_1)     0.01      0.05      0.18     10.25 f
  ctmTdsLR_4_6605/A (sky130_fd_sc_hd__inv_2)                 0.05      0.00     10.26 f
  ctmTdsLR_4_6605/Y (sky130_fd_sc_hd__inv_2)       0.04      0.18      0.15     10.41 r
  u_core/U3263/B (sky130_fd_sc_hd__nor2_1)                   0.18      0.00     10.41 r
  u_core/U3263/Y (sky130_fd_sc_hd__nor2_1)         0.01      0.09      0.08     10.50 f
  u_core/U3829/B1 (sky130_fd_sc_hd__a21oi_1)                 0.09      0.00     10.50 f
  u_core/U3829/Y (sky130_fd_sc_hd__a21oi_1)        0.01      0.19      0.19     10.68 r
  u_core/U3283/A (sky130_fd_sc_hd__nand2_1)                  0.19      0.00     10.68 r
  u_core/U3283/Y (sky130_fd_sc_hd__nand2_1)        0.01      0.09      0.12     10.80 f
  u_core/U3285/A2 (sky130_fd_sc_hd__a21oi_2)                 0.09      0.00     10.80 f
  u_core/U3285/Y (sky130_fd_sc_hd__a21oi_2)        0.01      0.20      0.23     11.03 r
  ctmTdsLR_2_7441/B (sky130_fd_sc_hd__maj3_1)                0.20      0.00     11.03 r
  ctmTdsLR_2_7441/X (sky130_fd_sc_hd__maj3_1)      0.02      0.17      0.28     11.31 r
  u_core/U3323/A1 (sky130_fd_sc_hd__a21o_1)                  0.17      0.00     11.31 r
  u_core/U3323/X (sky130_fd_sc_hd__a21o_1)         0.01      0.07      0.16     11.47 r
  u_core/U3324/B1 (sky130_fd_sc_hd__o21ai_2)                 0.07      0.00     11.47 r
  u_core/U3324/Y (sky130_fd_sc_hd__o21ai_2)        0.01      0.09      0.07     11.54 f
  u_core/U3325/A (sky130_fd_sc_hd__nand2_1)                  0.09      0.00     11.54 f
  u_core/U3325/Y (sky130_fd_sc_hd__nand2_1)        0.01      0.08      0.10     11.64 r
  ctmTdsLR_1_13815/B2 (sky130_fd_sc_hd__a2bb2oi_1)           0.08      0.00     11.64 r
  ctmTdsLR_1_13815/Y (sky130_fd_sc_hd__a2bb2oi_1)
                                                   0.01      0.12      0.10     11.74 f
  u_core/U3362/B (sky130_fd_sc_hd__nor2_1)                   0.12      0.00     11.74 f
  u_core/U3362/Y (sky130_fd_sc_hd__nor2_1)         0.01      0.19      0.19     11.93 r
  ctmTdsLR_1_13412/B1 (sky130_fd_sc_hd__a21oi_2)             0.19      0.00     11.93 r
  ctmTdsLR_1_13412/Y (sky130_fd_sc_hd__a21oi_2)    0.01      0.09      0.07     12.00 f
  u_core/U3364/B (sky130_fd_sc_hd__nor2_1)                   0.09      0.00     12.00 f
  u_core/U3364/Y (sky130_fd_sc_hd__nor2_1)         0.01      0.14      0.14     12.15 r
  u_core/U3366/A2 (sky130_fd_sc_hd__o21ai_2)                 0.14      0.00     12.15 r
  u_core/U3366/Y (sky130_fd_sc_hd__o21ai_2)        0.01      0.09      0.09     12.23 f
  u_core/U3367/B (sky130_fd_sc_hd__nor2_1)                   0.09      0.00     12.24 f
  u_core/U3367/Y (sky130_fd_sc_hd__nor2_1)         0.01      0.13      0.13     12.37 r
  u_core/U3369/A2 (sky130_fd_sc_hd__o21ai_2)                 0.13      0.00     12.37 r
  u_core/U3369/Y (sky130_fd_sc_hd__o21ai_2)        0.01      0.07      0.09     12.45 f
  ctmTdsLR_1_6593/A2 (sky130_fd_sc_hd__o21bai_1)             0.07      0.00     12.46 f
  ctmTdsLR_1_6593/Y (sky130_fd_sc_hd__o21bai_1)    0.01      0.16      0.16     12.62 r
  ctmTdsLR_2_6594/A (sky130_fd_sc_hd__nand2_2)               0.16      0.00     12.62 r
  ctmTdsLR_2_6594/Y (sky130_fd_sc_hd__nand2_2)     0.01      0.07      0.08     12.70 f
  u_core/U3373/B (sky130_fd_sc_hd__nor2_1)                   0.07      0.00     12.70 f
  u_core/U3373/Y (sky130_fd_sc_hd__nor2_1)         0.01      0.13      0.12     12.82 r
  u_core/U3375/A2 (sky130_fd_sc_hd__o21ai_2)                 0.13      0.00     12.82 r
  u_core/U3375/Y (sky130_fd_sc_hd__o21ai_2)        0.01      0.09      0.08     12.91 f
  u_core/U3376/B (sky130_fd_sc_hd__nor2_1)                   0.09      0.00     12.91 f
  u_core/U3376/Y (sky130_fd_sc_hd__nor2_1)         0.01      0.13      0.13     13.04 r
  u_core/U3378/A2 (sky130_fd_sc_hd__o21ai_2)                 0.13      0.00     13.04 r
  u_core/U3378/Y (sky130_fd_sc_hd__o21ai_2)        0.01      0.06      0.08     13.12 f
  ctmTdsLR_1_6591/A2 (sky130_fd_sc_hd__o21bai_1)             0.06      0.00     13.12 f
  ctmTdsLR_1_6591/Y (sky130_fd_sc_hd__o21bai_1)    0.00      0.14      0.14     13.26 r
  ctmTdsLR_2_6592/B (sky130_fd_sc_hd__nand2_1)               0.14      0.00     13.26 r
  ctmTdsLR_2_6592/Y (sky130_fd_sc_hd__nand2_1)     0.01      0.08      0.11     13.37 f
  u_core/U3382/B (sky130_fd_sc_hd__nor2_1)                   0.08      0.00     13.37 f
  u_core/U3382/Y (sky130_fd_sc_hd__nor2_1)         0.01      0.14      0.14     13.51 r
  u_core/U3384/A2 (sky130_fd_sc_hd__o21ai_2)                 0.14      0.00     13.51 r
  u_core/U3384/Y (sky130_fd_sc_hd__o21ai_2)        0.01      0.07      0.09     13.60 f
  u_core/U3793/B (sky130_fd_sc_hd__nor2_1)                   0.07      0.00     13.60 f
  u_core/U3793/Y (sky130_fd_sc_hd__nor2_1)         0.01      0.14      0.13     13.74 r
  u_core/U3794/A2 (sky130_fd_sc_hd__o21ai_2)                 0.14      0.00     13.74 r
  u_core/U3794/Y (sky130_fd_sc_hd__o21ai_2)        0.01      0.07      0.09     13.83 f
  ctmTdsLR_1_6589/A2 (sky130_fd_sc_hd__o21bai_1)             0.07      0.00     13.83 f
  ctmTdsLR_1_6589/Y (sky130_fd_sc_hd__o21bai_1)    0.00      0.13      0.14     13.97 r
  ctmTdsLR_2_6590/B (sky130_fd_sc_hd__nand2_1)               0.13      0.00     13.97 r
  ctmTdsLR_2_6590/Y (sky130_fd_sc_hd__nand2_1)     0.02      0.12      0.14     14.11 f
  u_core/U3820/A2 (sky130_fd_sc_hd__o21ai_1)                 0.12      0.00     14.11 f
  u_core/U3820/Y (sky130_fd_sc_hd__o21ai_1)        0.00      0.12      0.15     14.26 r
  u_core/U3821/B (sky130_fd_sc_hd__nand2_1)                  0.12      0.00     14.26 r
  u_core/U3821/Y (sky130_fd_sc_hd__nand2_1)        0.01      0.09      0.11     14.37 f
  u_core/U3822/B (sky130_fd_sc_hd__nor2_1)                   0.09      0.00     14.37 f
  u_core/U3822/Y (sky130_fd_sc_hd__nor2_1)         0.00      0.11      0.12     14.50 r
  ctmTdsLR_1_6867/A2 (sky130_fd_sc_hd__o21a_2)               0.11      0.00     14.50 r
  ctmTdsLR_1_6867/X (sky130_fd_sc_hd__o21a_2)      0.01      0.06      0.14     14.64 r
  u_core/U3825/B (sky130_fd_sc_hd__nor2_1)                   0.06      0.00     14.64 r
  u_core/U3825/Y (sky130_fd_sc_hd__nor2_1)         0.01      0.06      0.05     14.69 f
  u_core/U3827/A_N (sky130_fd_sc_hd__nand2b_2)               0.06      0.00     14.69 f
  u_core/U3827/Y (sky130_fd_sc_hd__nand2b_2)       0.02      0.09      0.22     14.92 f
  u_core/U6400/A (sky130_fd_sc_hd__nand2_1)                  0.09      0.00     14.92 f
  u_core/U6400/Y (sky130_fd_sc_hd__nand2_1)        0.00      0.06      0.08     15.00 r
  ctmTdsLR_2_7128/C1 (sky130_fd_sc_hd__o221ai_1)             0.06      0.00     15.00 r
  ctmTdsLR_2_7128/Y (sky130_fd_sc_hd__o221ai_1)    0.00      0.09      0.10     15.11 f
  u_core/U3837/A1 (sky130_fd_sc_hd__a21oi_1)                 0.09      0.00     15.11 f
  u_core/U3837/Y (sky130_fd_sc_hd__a21oi_1)        0.01      0.16      0.17     15.28 r
  u_core/U3847/A2 (sky130_fd_sc_hd__o21ai_1)                 0.16      0.00     15.28 r
  u_core/U3847/Y (sky130_fd_sc_hd__o21ai_1)        0.00      0.07      0.08     15.35 f
  u_core/ex1a_ex1b_reg_q_reg_alu_result__0_/D (sky130_fd_sc_hd__dfxtp_4)
                                                             0.07      0.00     15.35 f
  data arrival time                                                             15.35

  clock clk_i (rise edge)                                             13.33     13.33
  clock network delay (propagated)                                     2.91     16.25
  u_core/ex1a_ex1b_reg_q_reg_alu_result__0_/CLK (sky130_fd_sc_hd__dfxtp_4)
                                                             0.46      0.00     16.25 r
  clock uncertainty                                                   -0.50     15.75
  library setup time                                                  -0.03     15.72
  data required time                                                            15.72
  --------------------------------------------------------------------------------------------
  data required time                                                            15.72
  data arrival time                                                            -15.35
  --------------------------------------------------------------------------------------------
  slack (MET)                                                                    0.36

  Startpoint: u_core/u_mem_mem_wb_reg_o_reg_mem_rd_ (rising edge-triggered flip-flop clocked by clk_i)
  Endpoint: u_core/ex1a_ex1b_reg_q_reg_alu_result__29_ (rising edge-triggered flip-flop clocked by clk_i)
  Mode: default
  Corner: default
  Scenario: default
  Path Group: PIPELINE
  Path Type: max

  Point                                            Cap      Trans      Incr      Path  
  --------------------------------------------------------------------------------------------
  clock clk_i (rise edge)                                              0.00      0.00
  clock network delay (propagated)                                     2.57      2.57

  u_core/u_mem_mem_wb_reg_o_reg_mem_rd_/CLK (sky130_fd_sc_hd__dfxtp_4)
                                                             0.28      0.00      2.57 r
  u_core/u_mem_mem_wb_reg_o_reg_mem_rd_/Q (sky130_fd_sc_hd__dfxtp_4)
                                                   0.06      0.19      0.53      3.10 r
  HFSBUF_109_5541/A (sky130_fd_sc_hd__buf_2)                 0.19      0.00      3.10 r
  HFSBUF_109_5541/X (sky130_fd_sc_hd__buf_2)       0.06      0.30      0.33      3.43 r
  ctmTdsLR_1_6875/A (sky130_fd_sc_hd__inv_2)                 0.30      0.00      3.44 r
  ctmTdsLR_1_6875/Y (sky130_fd_sc_hd__inv_2)       0.01      0.06      0.06      3.50 f
  ctmTdsLR_2_6876/A (sky130_fd_sc_hd__and2_4)                0.06      0.00      3.50 f
  ctmTdsLR_2_6876/X (sky130_fd_sc_hd__and2_4)      0.07      0.10      0.21      3.71 f
  HFSBUF_54_5020/A (sky130_fd_sc_hd__clkbuf_1)               0.10      0.00      3.71 f
  HFSBUF_54_5020/X (sky130_fd_sc_hd__clkbuf_1)     0.04      0.21      0.25      3.96 f
  u_core/U1771/B1 (sky130_fd_sc_hd__a22oi_1)                 0.21      0.00      3.96 f
  u_core/U1771/Y (sky130_fd_sc_hd__a22oi_1)        0.01      0.20      0.23      4.20 r
  ctmTdsLR_1_13720/B1 (sky130_fd_sc_hd__o21a_1)              0.20      0.00      4.20 r
  ctmTdsLR_1_13720/X (sky130_fd_sc_hd__o21a_1)     0.01      0.07      0.17      4.37 r
  ctmTdsLR_2_13566_roptpi_13964/B (sky130_fd_sc_hd__and2_4)
                                                             0.07      0.00      4.37 r
  ctmTdsLR_2_13566_roptpi_13964/X (sky130_fd_sc_hd__and2_4)
                                                   0.11      0.34      0.35      4.72 r
  u_core/U1777/A_N (sky130_fd_sc_hd__nand2b_1)               0.34      0.01      4.73 r
  u_core/U1777/Y (sky130_fd_sc_hd__nand2b_1)       0.01      0.10      0.18      4.91 r
  ctmTdsLR_3_13833/A (sky130_fd_sc_hd__nand3_2)              0.10      0.00      4.91 r
  ctmTdsLR_3_13833/Y (sky130_fd_sc_hd__nand3_2)    0.00      0.08      0.07      4.97 f
  ctmTdsLR_2_13832_roptpi_13971/A (sky130_fd_sc_hd__or2_4)   0.08      0.00      4.97 f
  ctmTdsLR_2_13832_roptpi_13971/X (sky130_fd_sc_hd__or2_4)
                                                   0.08      0.14      0.37      5.34 f
  ctmTdsLR_1_7045/A1 (sky130_fd_sc_hd__a22o_2)               0.15      0.01      5.35 f
  ctmTdsLR_1_7045/X (sky130_fd_sc_hd__a22o_2)      0.03      0.10      0.34      5.69 f
  HFSBUF_466_4877/A (sky130_fd_sc_hd__buf_2)                 0.10      0.00      5.69 f
  HFSBUF_466_4877/X (sky130_fd_sc_hd__buf_2)       0.07      0.17      0.27      5.95 f
  u_core/U2392/A2 (sky130_fd_sc_hd__o22ai_1)                 0.17      0.00      5.96 f
  u_core/U2392/Y (sky130_fd_sc_hd__o22ai_1)        0.02      0.45      0.42      6.37 r
  u_core/U2395/A (sky130_fd_sc_hd__nor2_1)                   0.45      0.00      6.38 r
  u_core/U2395/Y (sky130_fd_sc_hd__nor2_1)         0.01      0.11      0.14      6.51 f
  ctmTdsLR_2_7539/B1 (sky130_fd_sc_hd__a21o_1)               0.11      0.00      6.51 f
  ctmTdsLR_2_7539/X (sky130_fd_sc_hd__a21o_1)      0.01      0.05      0.19      6.70 f
  ctmTdsLR_4_6615/A (sky130_fd_sc_hd__inv_2)                 0.05      0.00      6.70 f
  ctmTdsLR_4_6615/Y (sky130_fd_sc_hd__inv_2)       0.01      0.05      0.06      6.76 r
  u_core/U2437/B (sky130_fd_sc_hd__nor2_1)                   0.05      0.00      6.76 r
  u_core/U2437/Y (sky130_fd_sc_hd__nor2_1)         0.01      0.10      0.07      6.83 f
  u_core/U2438/A (sky130_fd_sc_hd__nor2_4)                   0.10      0.00      6.83 f
  u_core/U2438/Y (sky130_fd_sc_hd__nor2_4)         0.01      0.11      0.15      6.99 r
  u_core/U2457/B (sky130_fd_sc_hd__nor2_1)                   0.11      0.00      6.99 r
  u_core/U2457/Y (sky130_fd_sc_hd__nor2_1)         0.01      0.09      0.07      7.06 f
  ctmTdsLR_1_13532/A (sky130_fd_sc_hd__nor2_1)               0.09      0.00      7.06 f
  ctmTdsLR_1_13532/Y (sky130_fd_sc_hd__nor2_1)     0.01      0.19      0.19      7.25 r
  ctmTdsLR_1_12035/B (sky130_fd_sc_hd__maj3_1)               0.19      0.00      7.25 r
  ctmTdsLR_1_12035/X (sky130_fd_sc_hd__maj3_1)     0.01      0.12      0.24      7.49 r
  u_core/U3085/A (sky130_fd_sc_hd__nand2_1)                  0.12      0.00      7.49 r
  u_core/U3085/Y (sky130_fd_sc_hd__nand2_1)        0.01      0.08      0.08      7.57 f
  u_core/U3086/A1 (sky130_fd_sc_hd__a21oi_2)                 0.08      0.00      7.57 f
  u_core/U3086/Y (sky130_fd_sc_hd__a21oi_2)        0.02      0.24      0.24      7.81 r
  u_core/U3107/B (sky130_fd_sc_hd__nor2_1)                   0.24      0.00      7.81 r
  u_core/U3107/Y (sky130_fd_sc_hd__nor2_1)         0.01      0.11      0.11      7.92 f
  ctmTdsLR_1_13808/B (sky130_fd_sc_hd__nor2_1)               0.11      0.00      7.92 f
  ctmTdsLR_1_13808/Y (sky130_fd_sc_hd__nor2_1)     0.01      0.20      0.19      8.12 r
  u_core/U3129/A (sky130_fd_sc_hd__nor2_1)                   0.20      0.00      8.12 r
  u_core/U3129/Y (sky130_fd_sc_hd__nor2_1)         0.01      0.09      0.10      8.21 f
  ctmTdsLR_2_6609/A (sky130_fd_sc_hd__nor2_1)                0.09      0.00      8.21 f
  ctmTdsLR_2_6609/Y (sky130_fd_sc_hd__nor2_1)      0.01      0.21      0.21      8.42 r
  u_core/U3147/A (sky130_fd_sc_hd__nand2_1)                  0.21      0.00      8.42 r
  u_core/U3147/Y (sky130_fd_sc_hd__nand2_1)        0.01      0.08      0.10      8.53 f
  u_core/U3149/A1 (sky130_fd_sc_hd__a21oi_2)                 0.08      0.00      8.53 f
  u_core/U3149/Y (sky130_fd_sc_hd__a21oi_2)        0.01      0.15      0.18      8.70 r
  u_core/U3166/A (sky130_fd_sc_hd__nand2_1)                  0.15      0.00      8.71 r
  u_core/U3166/Y (sky130_fd_sc_hd__nand2_1)        0.01      0.08      0.09      8.80 f
  u_core/U3168/A2 (sky130_fd_sc_hd__a21oi_2)                 0.08      0.00      8.80 f
  u_core/U3168/Y (sky130_fd_sc_hd__a21oi_2)        0.01      0.17      0.20      9.00 r
  u_core/U3185/B (sky130_fd_sc_hd__nor2_1)                   0.17      0.00      9.00 r
  u_core/U3185/Y (sky130_fd_sc_hd__nor2_1)         0.01      0.09      0.08      9.08 f
  ctmTdsLR_2_6607/A (sky130_fd_sc_hd__nor2_1)                0.09      0.00      9.08 f
  ctmTdsLR_2_6607/Y (sky130_fd_sc_hd__nor2_1)      0.01      0.20      0.20      9.28 r
  u_core/U3205/A (sky130_fd_sc_hd__nand2_1)                  0.20      0.00      9.28 r
  u_core/U3205/Y (sky130_fd_sc_hd__nand2_1)        0.00      0.07      0.08      9.36 f
  u_core/U3207/A2 (sky130_fd_sc_hd__a21oi_1)                 0.07      0.00      9.36 f
  u_core/U3207/Y (sky130_fd_sc_hd__a21oi_1)        0.01      0.26      0.26      9.62 r
  u_core/U3224/B (sky130_fd_sc_hd__nor2_1)                   0.26      0.00      9.62 r
  u_core/U3224/Y (sky130_fd_sc_hd__nor2_1)         0.01      0.10      0.11      9.73 f
  ctmTdsLR_1_13810/A (sky130_fd_sc_hd__nor2_1)               0.10      0.00      9.73 f
  ctmTdsLR_1_13810/Y (sky130_fd_sc_hd__nor2_1)     0.01      0.25      0.25      9.98 r
  u_core/U3245/B (sky130_fd_sc_hd__nor2_1)                   0.25      0.00      9.98 r
  u_core/U3245/Y (sky130_fd_sc_hd__nor2_1)         0.01      0.09      0.10     10.08 f
  ctmTdsLR_1_13410/B1 (sky130_fd_sc_hd__a21o_1)              0.09      0.00     10.08 f
  ctmTdsLR_1_13410/X (sky130_fd_sc_hd__a21o_1)     0.01      0.05      0.18     10.25 f
  ctmTdsLR_4_6605/A (sky130_fd_sc_hd__inv_2)                 0.05      0.00     10.26 f
  ctmTdsLR_4_6605/Y (sky130_fd_sc_hd__inv_2)       0.04      0.18      0.15     10.41 r
  u_core/U3263/B (sky130_fd_sc_hd__nor2_1)                   0.18      0.00     10.41 r
  u_core/U3263/Y (sky130_fd_sc_hd__nor2_1)         0.01      0.09      0.08     10.50 f
  u_core/U3829/B1 (sky130_fd_sc_hd__a21oi_1)                 0.09      0.00     10.50 f
  u_core/U3829/Y (sky130_fd_sc_hd__a21oi_1)        0.01      0.19      0.19     10.68 r
  u_core/U3283/A (sky130_fd_sc_hd__nand2_1)                  0.19      0.00     10.68 r
  u_core/U3283/Y (sky130_fd_sc_hd__nand2_1)        0.01      0.09      0.12     10.80 f
  u_core/U3285/A2 (sky130_fd_sc_hd__a21oi_2)                 0.09      0.00     10.80 f
  u_core/U3285/Y (sky130_fd_sc_hd__a21oi_2)        0.01      0.20      0.23     11.03 r
  ctmTdsLR_2_7441/B (sky130_fd_sc_hd__maj3_1)                0.20      0.00     11.03 r
  ctmTdsLR_2_7441/X (sky130_fd_sc_hd__maj3_1)      0.02      0.17      0.28     11.31 r
  u_core/U3323/A1 (sky130_fd_sc_hd__a21o_1)                  0.17      0.00     11.31 r
  u_core/U3323/X (sky130_fd_sc_hd__a21o_1)         0.01      0.07      0.16     11.47 r
  u_core/U3324/B1 (sky130_fd_sc_hd__o21ai_2)                 0.07      0.00     11.47 r
  u_core/U3324/Y (sky130_fd_sc_hd__o21ai_2)        0.01      0.09      0.07     11.54 f
  u_core/U3325/A (sky130_fd_sc_hd__nand2_1)                  0.09      0.00     11.54 f
  u_core/U3325/Y (sky130_fd_sc_hd__nand2_1)        0.01      0.08      0.10     11.64 r
  ctmTdsLR_1_13815/B2 (sky130_fd_sc_hd__a2bb2oi_1)           0.08      0.00     11.64 r
  ctmTdsLR_1_13815/Y (sky130_fd_sc_hd__a2bb2oi_1)
                                                   0.01      0.12      0.10     11.74 f
  u_core/U3362/B (sky130_fd_sc_hd__nor2_1)                   0.12      0.00     11.74 f
  u_core/U3362/Y (sky130_fd_sc_hd__nor2_1)         0.01      0.19      0.19     11.93 r
  ctmTdsLR_1_13412/B1 (sky130_fd_sc_hd__a21oi_2)             0.19      0.00     11.93 r
  ctmTdsLR_1_13412/Y (sky130_fd_sc_hd__a21oi_2)    0.01      0.09      0.07     12.00 f
  u_core/U3364/B (sky130_fd_sc_hd__nor2_1)                   0.09      0.00     12.00 f
  u_core/U3364/Y (sky130_fd_sc_hd__nor2_1)         0.01      0.14      0.14     12.15 r
  u_core/U3366/A2 (sky130_fd_sc_hd__o21ai_2)                 0.14      0.00     12.15 r
  u_core/U3366/Y (sky130_fd_sc_hd__o21ai_2)        0.01      0.09      0.09     12.23 f
  u_core/U3367/B (sky130_fd_sc_hd__nor2_1)                   0.09      0.00     12.24 f
  u_core/U3367/Y (sky130_fd_sc_hd__nor2_1)         0.01      0.13      0.13     12.37 r
  u_core/U3369/A2 (sky130_fd_sc_hd__o21ai_2)                 0.13      0.00     12.37 r
  u_core/U3369/Y (sky130_fd_sc_hd__o21ai_2)        0.01      0.07      0.09     12.45 f
  ctmTdsLR_1_6593/A2 (sky130_fd_sc_hd__o21bai_1)             0.07      0.00     12.46 f
  ctmTdsLR_1_6593/Y (sky130_fd_sc_hd__o21bai_1)    0.01      0.16      0.16     12.62 r
  ctmTdsLR_2_6594/A (sky130_fd_sc_hd__nand2_2)               0.16      0.00     12.62 r
  ctmTdsLR_2_6594/Y (sky130_fd_sc_hd__nand2_2)     0.01      0.07      0.08     12.70 f
  u_core/U3373/B (sky130_fd_sc_hd__nor2_1)                   0.07      0.00     12.70 f
  u_core/U3373/Y (sky130_fd_sc_hd__nor2_1)         0.01      0.13      0.12     12.82 r
  u_core/U3375/A2 (sky130_fd_sc_hd__o21ai_2)                 0.13      0.00     12.82 r
  u_core/U3375/Y (sky130_fd_sc_hd__o21ai_2)        0.01      0.09      0.08     12.91 f
  u_core/U3376/B (sky130_fd_sc_hd__nor2_1)                   0.09      0.00     12.91 f
  u_core/U3376/Y (sky130_fd_sc_hd__nor2_1)         0.01      0.13      0.13     13.04 r
  u_core/U3378/A2 (sky130_fd_sc_hd__o21ai_2)                 0.13      0.00     13.04 r
  u_core/U3378/Y (sky130_fd_sc_hd__o21ai_2)        0.01      0.06      0.08     13.12 f
  ctmTdsLR_1_6591/A2 (sky130_fd_sc_hd__o21bai_1)             0.06      0.00     13.12 f
  ctmTdsLR_1_6591/Y (sky130_fd_sc_hd__o21bai_1)    0.00      0.14      0.14     13.26 r
  ctmTdsLR_2_6592/B (sky130_fd_sc_hd__nand2_1)               0.14      0.00     13.26 r
  ctmTdsLR_2_6592/Y (sky130_fd_sc_hd__nand2_1)     0.01      0.08      0.11     13.37 f
  u_core/U3382/B (sky130_fd_sc_hd__nor2_1)                   0.08      0.00     13.37 f
  u_core/U3382/Y (sky130_fd_sc_hd__nor2_1)         0.01      0.14      0.14     13.51 r
  u_core/U3384/A2 (sky130_fd_sc_hd__o21ai_2)                 0.14      0.00     13.51 r
  u_core/U3384/Y (sky130_fd_sc_hd__o21ai_2)        0.01      0.07      0.09     13.60 f
  u_core/U3793/B (sky130_fd_sc_hd__nor2_1)                   0.07      0.00     13.60 f
  u_core/U3793/Y (sky130_fd_sc_hd__nor2_1)         0.01      0.14      0.13     13.74 r
  u_core/U3794/A2 (sky130_fd_sc_hd__o21ai_2)                 0.14      0.00     13.74 r
  u_core/U3794/Y (sky130_fd_sc_hd__o21ai_2)        0.01      0.07      0.09     13.83 f
  ctmTdsLR_1_6589/A2 (sky130_fd_sc_hd__o21bai_1)             0.07      0.00     13.83 f
  ctmTdsLR_1_6589/Y (sky130_fd_sc_hd__o21bai_1)    0.00      0.13      0.14     13.97 r
  ctmTdsLR_2_6590/B (sky130_fd_sc_hd__nand2_1)               0.13      0.00     13.97 r
  ctmTdsLR_2_6590/Y (sky130_fd_sc_hd__nand2_1)     0.02      0.12      0.14     14.11 f
  u_core/U3818/A (sky130_fd_sc_hd__nand2_1)                  0.12      0.00     14.11 f
  u_core/U3818/Y (sky130_fd_sc_hd__nand2_1)        0.01      0.09      0.12     14.22 r
  u_core/U4243/B1 (sky130_fd_sc_hd__o21ai_1)                 0.09      0.00     14.22 r
  u_core/U4243/Y (sky130_fd_sc_hd__o21ai_1)        0.01      0.11      0.11     14.33 f
  u_core/U4261/A1_N (sky130_fd_sc_hd__o2bb2ai_1)             0.11      0.00     14.33 f
  u_core/U4261/Y (sky130_fd_sc_hd__o2bb2ai_1)      0.00      0.08      0.15     14.49 f
  u_core/U4262/C1 (sky130_fd_sc_hd__a221oi_1)                0.08      0.00     14.49 f
  u_core/U4262/Y (sky130_fd_sc_hd__a221oi_1)       0.00      0.26      0.24     14.73 r
  ctmTdsLR_3_6943/A2 (sky130_fd_sc_hd__o21ai_1)              0.26      0.00     14.73 r
  ctmTdsLR_3_6943/Y (sky130_fd_sc_hd__o21ai_1)     0.01      0.08      0.12     14.84 f
  u_core/ex1a_ex1b_reg_q_reg_alu_result__29_/D (sky130_fd_sc_hd__dfxtp_4)
                                                             0.08      0.00     14.84 f
  data arrival time                                                             14.84

  clock clk_i (rise edge)                                             13.33     13.33
  clock network delay (propagated)                                     2.54     15.88
  u_core/ex1a_ex1b_reg_q_reg_alu_result__29_/CLK (sky130_fd_sc_hd__dfxtp_4)
                                                             0.34      0.00     15.88 r
  clock uncertainty                                                   -0.50     15.38
  library setup time                                                  -0.06     15.32
  data required time                                                            15.32
  --------------------------------------------------------------------------------------------
  data required time                                                            15.32
  data arrival time                                                            -14.84
  --------------------------------------------------------------------------------------------
  slack (MET)                                                                    0.47

  Startpoint: u_core/ex1a_ex1b_reg_q_reg_pc__2_ (rising edge-triggered flip-flop clocked by clk_i)
  Endpoint: u_core/u_csr_minstret_q_reg_55_ (rising edge-triggered flip-flop clocked by clk_i)
  Mode: default
  Corner: default
  Scenario: default
  Path Group: PIPELINE
  Path Type: max

  Point                                            Cap      Trans      Incr      Path  
  --------------------------------------------------------------------------------------------
  clock clk_i (rise edge)                                              0.00      0.00
  clock network delay (propagated)                                     2.92      2.92

  u_core/ex1a_ex1b_reg_q_reg_pc__2_/CLK (sky130_fd_sc_hd__dfxtp_4)
                                                             0.22      0.00      2.92 r
  u_core/ex1a_ex1b_reg_q_reg_pc__2_/Q (sky130_fd_sc_hd__dfxtp_4)
                                                   0.07      0.21      0.52      3.43 r
  u_core/U1510/B (sky130_fd_sc_hd__nand3_1)                  0.21      0.00      3.44 r
  u_core/U1510/Y (sky130_fd_sc_hd__nand3_1)        0.02      0.22      0.24      3.68 f
  u_core/U1663/A (sky130_fd_sc_hd__nor2_1)                   0.22      0.00      3.68 f
  u_core/U1663/Y (sky130_fd_sc_hd__nor2_1)         0.02      0.36      0.36      4.04 r
  u_core/U1664/A (sky130_fd_sc_hd__nand2_1)                  0.36      0.00      4.04 r
  u_core/U1664/Y (sky130_fd_sc_hd__nand2_1)        0.01      0.13      0.16      4.20 f
  u_core/U1666/A (sky130_fd_sc_hd__nor2_1)                   0.13      0.00      4.20 f
  u_core/U1666/Y (sky130_fd_sc_hd__nor2_1)         0.02      0.29      0.28      4.48 r
  u_core/U1667/A (sky130_fd_sc_hd__nand2_1)                  0.29      0.00      4.48 r
  u_core/U1667/Y (sky130_fd_sc_hd__nand2_1)        0.01      0.14      0.17      4.65 f
  u_core/U1669/A (sky130_fd_sc_hd__nor2_1)                   0.14      0.00      4.65 f
  u_core/U1669/Y (sky130_fd_sc_hd__nor2_1)         0.02      0.28      0.28      4.93 r
  u_core/U1670/A (sky130_fd_sc_hd__nand2_1)                  0.28      0.00      4.93 r
  u_core/U1670/Y (sky130_fd_sc_hd__nand2_1)        0.01      0.12      0.16      5.09 f
  u_core/U1672/A (sky130_fd_sc_hd__nor2_1)                   0.12      0.00      5.09 f
  u_core/U1672/Y (sky130_fd_sc_hd__nor2_1)         0.01      0.22      0.23      5.32 r
  u_core/U1673/A (sky130_fd_sc_hd__nand2_1)                  0.22      0.00      5.32 r
  u_core/U1673/Y (sky130_fd_sc_hd__nand2_1)        0.01      0.10      0.13      5.45 f
  u_core/U1675/A (sky130_fd_sc_hd__nor2_1)                   0.10      0.00      5.45 f
  u_core/U1675/Y (sky130_fd_sc_hd__nor2_1)         0.01      0.20      0.21      5.66 r
  u_core/U1676/A (sky130_fd_sc_hd__nand2_1)                  0.20      0.00      5.66 r
  u_core/U1676/Y (sky130_fd_sc_hd__nand2_1)        0.01      0.10      0.13      5.79 f
  u_core/U1678/A (sky130_fd_sc_hd__nor2_1)                   0.10      0.00      5.79 f
  u_core/U1678/Y (sky130_fd_sc_hd__nor2_1)         0.01      0.21      0.22      6.01 r
  u_core/U1679/A (sky130_fd_sc_hd__nand2_1)                  0.21      0.00      6.01 r
  u_core/U1679/Y (sky130_fd_sc_hd__nand2_1)        0.01      0.10      0.13      6.13 f
  u_core/U1681/A (sky130_fd_sc_hd__nor2_1)                   0.10      0.00      6.13 f
  u_core/U1681/Y (sky130_fd_sc_hd__nor2_1)         0.01      0.20      0.21      6.34 r
  u_core/U1682/A (sky130_fd_sc_hd__nand2_1)                  0.20      0.00      6.34 r
  u_core/U1682/Y (sky130_fd_sc_hd__nand2_1)        0.01      0.10      0.13      6.47 f
  u_core/U1684/A (sky130_fd_sc_hd__nor2_1)                   0.10      0.00      6.47 f
  u_core/U1684/Y (sky130_fd_sc_hd__nor2_1)         0.01      0.26      0.25      6.72 r
  u_core/U1685/A (sky130_fd_sc_hd__nand2_1)                  0.26      0.00      6.72 r
  u_core/U1685/Y (sky130_fd_sc_hd__nand2_1)        0.01      0.12      0.15      6.87 f
  u_core/U1958/A (sky130_fd_sc_hd__nor2_1)                   0.12      0.00      6.87 f
  u_core/U1958/Y (sky130_fd_sc_hd__nor2_1)         0.01      0.25      0.25      7.12 r
  u_core/U1959/A (sky130_fd_sc_hd__nand2_1)                  0.25      0.00      7.12 r
  u_core/U1959/Y (sky130_fd_sc_hd__nand2_1)        0.01      0.12      0.15      7.26 f
  u_core/U1961/A (sky130_fd_sc_hd__nor2_1)                   0.12      0.00      7.27 f
  u_core/U1961/Y (sky130_fd_sc_hd__nor2_1)         0.01      0.24      0.24      7.51 r
  u_core/U1962/A (sky130_fd_sc_hd__nand2_1)                  0.24      0.00      7.51 r
  u_core/U1962/Y (sky130_fd_sc_hd__nand2_1)        0.01      0.11      0.14      7.65 f
  u_core/U1964/A (sky130_fd_sc_hd__nor2_1)                   0.11      0.00      7.65 f
  u_core/U1964/Y (sky130_fd_sc_hd__nor2_1)         0.01      0.22      0.22      7.87 r
  u_core/U1965/A (sky130_fd_sc_hd__nand2_1)                  0.22      0.00      7.87 r
  u_core/U1965/Y (sky130_fd_sc_hd__nand2_1)        0.01      0.10      0.13      8.00 f
  u_core/U1967/A (sky130_fd_sc_hd__nor2_1)                   0.10      0.00      8.00 f
  u_core/U1967/Y (sky130_fd_sc_hd__nor2_1)         0.02      0.29      0.27      8.27 r
  u_core/U1968/A (sky130_fd_sc_hd__nand2_1)                  0.29      0.00      8.27 r
  u_core/U1968/Y (sky130_fd_sc_hd__nand2_1)        0.01      0.13      0.17      8.44 f
  u_core/U2097/A (sky130_fd_sc_hd__nor2_1)                   0.13      0.00      8.44 f
  u_core/U2097/Y (sky130_fd_sc_hd__nor2_1)         0.01      0.23      0.24      8.68 r
  u_core/U2098/A (sky130_fd_sc_hd__nand2_1)                  0.23      0.00      8.68 r
  u_core/U2098/Y (sky130_fd_sc_hd__nand2_1)        0.01      0.12      0.15      8.83 f
  u_core/U2099/B (sky130_fd_sc_hd__xnor2_1)                  0.12      0.00      8.83 f
  u_core/U2099/Y (sky130_fd_sc_hd__xnor2_1)        0.01      0.28      0.27      9.10 r
  HFSBUF_63_2136/A (sky130_fd_sc_hd__buf_2)                  0.28      0.00      9.11 r
  HFSBUF_63_2136/X (sky130_fd_sc_hd__buf_2)        0.04      0.19      0.28      9.39 r
  u_core/U2114/A2 (sky130_fd_sc_hd__o221ai_1)                0.19      0.00      9.39 r
  u_core/U2114/Y (sky130_fd_sc_hd__o221ai_1)       0.00      0.14      0.15      9.54 f
  u_core/U2115/B (sky130_fd_sc_hd__nor2_1)                   0.14      0.00      9.54 f
  u_core/U2115/Y (sky130_fd_sc_hd__nor2_1)         0.01      0.17      0.19      9.72 r
  u_core/U2116/A (sky130_fd_sc_hd__nand2_2)                  0.17      0.00      9.72 r
  u_core/U2116/Y (sky130_fd_sc_hd__nand2_2)        0.09      0.36      0.33     10.05 f
  HFSINV_504_2762/A (sky130_fd_sc_hd__inv_2)                 0.36      0.01     10.06 f
  HFSINV_504_2762/Y (sky130_fd_sc_hd__inv_2)       0.03      0.17      0.25     10.31 r
  u_core/U4419/A2_N (sky130_fd_sc_hd__a2bb2o_4)              0.17      0.00     10.31 r
  u_core/U4419/X (sky130_fd_sc_hd__a2bb2o_4)       0.09      0.14      0.34     10.65 f
  HFSINV_684_4794/A (sky130_fd_sc_hd__inv_2)                 0.15      0.01     10.65 f
  HFSINV_684_4794/Y (sky130_fd_sc_hd__inv_2)       0.07      0.32      0.29     10.94 r
  u_core/U4381/D (sky130_fd_sc_hd__nand4_1)                  0.32      0.00     10.95 r
  u_core/U4381/Y (sky130_fd_sc_hd__nand4_1)        0.00      0.12      0.15     11.09 f
  u_core/U4426/A (sky130_fd_sc_hd__or4_1)                    0.12      0.00     11.09 f
  u_core/U4426/X (sky130_fd_sc_hd__or4_1)          0.01      0.11      0.57     11.67 f
  ctmTdsLR_1_13657/A2 (sky130_fd_sc_hd__o21ai_1)             0.11      0.00     11.67 f
  ctmTdsLR_1_13657/Y (sky130_fd_sc_hd__o21ai_1)    0.02      0.44      0.39     12.05 r
  u_core/U4428/B1 (sky130_fd_sc_hd__o21ai_1)                 0.44      0.00     12.05 r
  u_core/U4428/Y (sky130_fd_sc_hd__o21ai_1)        0.01      0.15      0.19     12.24 f
  HFSINV_10142_6073/A (sky130_fd_sc_hd__clkinv_2)            0.15      0.00     12.24 f
  HFSINV_10142_6073/Y (sky130_fd_sc_hd__clkinv_2)
                                                   0.11      0.38      0.33     12.57 r
  HFSINV_7488_6071/A (sky130_fd_sc_hd__inv_4)                0.37      0.01     12.58 r
  HFSINV_7488_6071/Y (sky130_fd_sc_hd__inv_4)      0.13      0.20      0.24     12.82 f
  u_core/U4634/B_N (sky130_fd_sc_hd__or2b_2)                 0.21      0.00     12.82 f
  u_core/U4634/X (sky130_fd_sc_hd__or2b_2)         0.06      0.32      0.42     13.25 r
  HFSINV_544_4811/A (sky130_fd_sc_hd__inv_6)                 0.32      0.00     13.25 r
  HFSINV_544_4811/Y (sky130_fd_sc_hd__inv_6)       0.07      0.12      0.13     13.39 f
  u_core/U4635/A_N (sky130_fd_sc_hd__nand2b_1)               0.12      0.00     13.39 f
  u_core/U4635/Y (sky130_fd_sc_hd__nand2b_1)       0.03      0.25      0.33     13.72 f
  HFSINV_1306_4578/A (sky130_fd_sc_hd__clkinv_2)             0.25      0.00     13.72 f
  HFSINV_1306_4578/Y (sky130_fd_sc_hd__clkinv_2)   0.10      0.38      0.36     14.08 r
  u_core/U5013/A2 (sky130_fd_sc_hd__a22oi_1)                 0.38      0.02     14.10 r
  u_core/U5013/Y (sky130_fd_sc_hd__a22oi_1)        0.01      0.12      0.18     14.28 f
  u_core/U5015/A2 (sky130_fd_sc_hd__a32oi_1)                 0.12      0.00     14.28 f
  u_core/U5015/Y (sky130_fd_sc_hd__a32oi_1)        0.00      0.16      0.22     14.50 r
  u_core/U5016/B (sky130_fd_sc_hd__nand2_1)                  0.16      0.00     14.50 r
  u_core/U5016/Y (sky130_fd_sc_hd__nand2_1)        0.00      0.09      0.07     14.57 f
  u_core/U5017/B1 (sky130_fd_sc_hd__o21ai_1)                 0.09      0.00     14.57 f
  u_core/U5017/Y (sky130_fd_sc_hd__o21ai_1)        0.00      0.14      0.10     14.67 r
  u_core/u_csr_minstret_q_reg_55_/D (sky130_fd_sc_hd__dfxtp_4)
                                                             0.14      0.00     14.67 r
  data arrival time                                                             14.67

  clock clk_i (rise edge)                                             13.33     13.33
  clock network delay (propagated)                                     2.43     15.77
  u_core/u_csr_minstret_q_reg_55_/CLK (sky130_fd_sc_hd__dfxtp_4)
                                                             0.21      0.00     15.77 r
  clock uncertainty                                                   -0.50     15.27
  library setup time                                                  -0.06     15.21
  data required time                                                            15.21
  --------------------------------------------------------------------------------------------
  data required time                                                            15.21
  data arrival time                                                            -14.67
  --------------------------------------------------------------------------------------------
  slack (MET)                                                                    0.54

  Startpoint: u_core/ex1a_ex1b_reg_q_reg_pc__1_ (rising edge-triggered flip-flop clocked by clk_i)
  Endpoint: u_core/ex1c_ex1b_reg_q_reg_dec_redirect_target__29_ (rising edge-triggered flip-flop clocked by clk_i)
  Mode: default
  Corner: default
  Scenario: default
  Path Group: PIPELINE
  Path Type: max

  Point                                            Cap      Trans      Incr      Path  
  --------------------------------------------------------------------------------------------
  clock clk_i (rise edge)                                              0.00      0.00
  clock network delay (propagated)                                     2.90      2.90

  u_core/ex1a_ex1b_reg_q_reg_pc__1_/CLK (sky130_fd_sc_hd__dfxtp_2)
                                                             0.18      0.00      2.90 r
  u_core/ex1a_ex1b_reg_q_reg_pc__1_/Q (sky130_fd_sc_hd__dfxtp_2)
                                                   0.02      0.06      0.39      3.29 f
  u_core/U1794/A (sky130_fd_sc_hd__clkinv_4)                 0.06      0.00      3.29 f
  u_core/U1794/Y (sky130_fd_sc_hd__clkinv_4)       0.08      0.16      0.14      3.43 r
  ctmTdsLR_2_13475/A (sky130_fd_sc_hd__maj3_1)               0.16      0.01      3.44 r
  ctmTdsLR_2_13475/X (sky130_fd_sc_hd__maj3_1)     0.01      0.13      0.24      3.68 r
  ctmTdsLR_1_13474/B1 (sky130_fd_sc_hd__o2bb2ai_1)           0.13      0.00      3.68 r
  ctmTdsLR_1_13474/Y (sky130_fd_sc_hd__o2bb2ai_1)
                                                   0.01      0.07      0.11      3.79 f
  u_core/U14287/CIN (sky130_fd_sc_hd__fa_1)                  0.07      0.00      3.79 f
  u_core/U14287/COUT (sky130_fd_sc_hd__fa_1)       0.01      0.11      0.42      4.20 f
  ctmTdsLR_4_13673/B (sky130_fd_sc_hd__maj3_1)               0.11      0.00      4.20 f
  ctmTdsLR_4_13673/X (sky130_fd_sc_hd__maj3_1)     0.01      0.10      0.39      4.59 f
  ctmTdsLR_3_13672/A1 (sky130_fd_sc_hd__a22o_1)              0.10      0.00      4.59 f
  ctmTdsLR_3_13672/X (sky130_fd_sc_hd__a22o_1)     0.01      0.07      0.26      4.85 f
  u_core/U14272/CIN (sky130_fd_sc_hd__fa_1)                  0.07      0.00      4.85 f
  u_core/U14272/COUT (sky130_fd_sc_hd__fa_1)       0.01      0.10      0.41      5.26 f
  u_core/U14267/CI (sky130_fd_sc_hd__fah_1)                  0.10      0.00      5.26 f
  u_core/U14267/COUT (sky130_fd_sc_hd__fah_1)      0.01      0.09      0.31      5.56 f
  u_core/U14262/CIN (sky130_fd_sc_hd__fa_1)                  0.09      0.00      5.57 f
  u_core/U14262/COUT (sky130_fd_sc_hd__fa_1)       0.01      0.09      0.40      5.96 f
  u_core/U14256/CIN (sky130_fd_sc_hd__fa_1)                  0.09      0.00      5.96 f
  u_core/U14256/COUT (sky130_fd_sc_hd__fa_1)       0.01      0.09      0.40      6.37 f
  u_core/U14251/CIN (sky130_fd_sc_hd__fa_1)                  0.09      0.00      6.37 f
  u_core/U14251/COUT (sky130_fd_sc_hd__fa_1)       0.01      0.10      0.42      6.79 f
  u_core/U14246/CIN (sky130_fd_sc_hd__fa_1)                  0.10      0.00      6.79 f
  u_core/U14246/COUT (sky130_fd_sc_hd__fa_1)       0.01      0.09      0.40      7.19 f
  u_core/U14241/CIN (sky130_fd_sc_hd__fa_1)                  0.09      0.00      7.19 f
  u_core/U14241/COUT (sky130_fd_sc_hd__fa_1)       0.01      0.09      0.39      7.58 f
  u_core/U14236/CIN (sky130_fd_sc_hd__fa_1)                  0.09      0.00      7.58 f
  u_core/U14236/COUT (sky130_fd_sc_hd__fa_1)       0.01      0.09      0.39      7.97 f
  u_core/U14231/CIN (sky130_fd_sc_hd__fa_1)                  0.09      0.00      7.97 f
  u_core/U14231/COUT (sky130_fd_sc_hd__fa_1)       0.01      0.10      0.41      8.38 f
  u_core/U14226/CIN (sky130_fd_sc_hd__fa_1)                  0.10      0.00      8.38 f
  u_core/U14226/COUT (sky130_fd_sc_hd__fa_1)       0.01      0.10      0.42      8.80 f
  u_core/U14221/CIN (sky130_fd_sc_hd__fa_1)                  0.10      0.00      8.80 f
  u_core/U14221/COUT (sky130_fd_sc_hd__fa_1)       0.01      0.09      0.40      9.20 f
  u_core/U14214/CIN (sky130_fd_sc_hd__fa_1)                  0.09      0.00      9.20 f
  u_core/U14214/COUT (sky130_fd_sc_hd__fa_1)       0.01      0.10      0.41      9.62 f
  u_core/U14209/CIN (sky130_fd_sc_hd__fa_1)                  0.10      0.00      9.62 f
  u_core/U14209/COUT (sky130_fd_sc_hd__fa_1)       0.01      0.10      0.41     10.03 f
  u_core/U14204/CIN (sky130_fd_sc_hd__fa_1)                  0.10      0.00     10.03 f
  u_core/U14204/COUT (sky130_fd_sc_hd__fa_1)       0.01      0.11      0.43     10.45 f
  u_core/U14199/CIN (sky130_fd_sc_hd__fa_1)                  0.11      0.00     10.45 f
  u_core/U14199/COUT (sky130_fd_sc_hd__fa_1)       0.01      0.10      0.41     10.87 f
  u_core/U14194/CIN (sky130_fd_sc_hd__fa_1)                  0.10      0.00     10.87 f
  u_core/U14194/COUT (sky130_fd_sc_hd__fa_1)       0.01      0.10      0.41     11.28 f
  u_core/U14189/CIN (sky130_fd_sc_hd__fa_1)                  0.10      0.00     11.28 f
  u_core/U14189/COUT (sky130_fd_sc_hd__fa_1)       0.01      0.10      0.42     11.70 f
  u_core/U14184/CIN (sky130_fd_sc_hd__fa_1)                  0.10      0.00     11.70 f
  u_core/U14184/COUT (sky130_fd_sc_hd__fa_1)       0.01      0.11      0.42     12.12 f
  u_core/U14179/CIN (sky130_fd_sc_hd__fa_1)                  0.11      0.00     12.12 f
  u_core/U14179/COUT (sky130_fd_sc_hd__fa_1)       0.01      0.10      0.42     12.54 f
  u_core/U14174/CIN (sky130_fd_sc_hd__fa_1)                  0.10      0.00     12.54 f
  u_core/U14174/COUT (sky130_fd_sc_hd__fa_1)       0.01      0.10      0.41     12.95 f
  u_core/U14169/CIN (sky130_fd_sc_hd__fa_1)                  0.10      0.00     12.95 f
  u_core/U14169/COUT (sky130_fd_sc_hd__fa_1)       0.01      0.10      0.41     13.36 f
  u_core/U14163/CIN (sky130_fd_sc_hd__fa_1)                  0.10      0.00     13.36 f
  u_core/U14163/COUT (sky130_fd_sc_hd__fa_1)       0.01      0.10      0.42     13.78 f
  u_core/U14156/CIN (sky130_fd_sc_hd__fa_1)                  0.10      0.00     13.78 f
  u_core/U14156/COUT (sky130_fd_sc_hd__fa_1)       0.01      0.11      0.43     14.21 f
  u_core/U14150/CIN (sky130_fd_sc_hd__fa_1)                  0.11      0.00     14.21 f
  u_core/U14150/SUM (sky130_fd_sc_hd__fa_1)        0.01      0.10      0.48     14.69 f
  u_core/U14151/B2 (sky130_fd_sc_hd__a22oi_1)                0.10      0.00     14.69 f
  u_core/U14151/Y (sky130_fd_sc_hd__a22oi_1)       0.01      0.21      0.22     14.90 r
  u_core/U14155/A (sky130_fd_sc_hd__nand3_1)                 0.21      0.00     14.90 r
  u_core/U14155/Y (sky130_fd_sc_hd__nand3_1)       0.00      0.11      0.12     15.02 f
  u_core/ex1c_ex1b_reg_q_reg_dec_redirect_target__29_/D (sky130_fd_sc_hd__dfxtp_4)
                                                             0.11      0.00     15.02 f
  data arrival time                                                             15.02

  clock clk_i (rise edge)                                             13.33     13.33
  clock network delay (propagated)                                     2.92     16.25
  u_core/ex1c_ex1b_reg_q_reg_dec_redirect_target__29_/CLK (sky130_fd_sc_hd__dfxtp_4)
                                                             0.22      0.00     16.25 r
  clock uncertainty                                                   -0.50     15.75
  library setup time                                                  -0.10     15.65
  data required time                                                            15.65
  --------------------------------------------------------------------------------------------
  data required time                                                            15.65
  data arrival time                                                            -15.02
  --------------------------------------------------------------------------------------------
  slack (MET)                                                                    0.63

  Startpoint: u_core/u_mem_mem_wb_reg_o_reg_mem_rd_ (rising edge-triggered flip-flop clocked by clk_i)
  Endpoint: u_core/ex1a_ex1b_reg_q_reg_alu_result__28_ (rising edge-triggered flip-flop clocked by clk_i)
  Mode: default
  Corner: default
  Scenario: default
  Path Group: PIPELINE
  Path Type: max

  Point                                            Cap      Trans      Incr      Path  
  --------------------------------------------------------------------------------------------
  clock clk_i (rise edge)                                              0.00      0.00
  clock network delay (propagated)                                     2.57      2.57

  u_core/u_mem_mem_wb_reg_o_reg_mem_rd_/CLK (sky130_fd_sc_hd__dfxtp_4)
                                                             0.28      0.00      2.57 r
  u_core/u_mem_mem_wb_reg_o_reg_mem_rd_/Q (sky130_fd_sc_hd__dfxtp_4)
                                                   0.06      0.19      0.53      3.10 r
  HFSBUF_109_5541/A (sky130_fd_sc_hd__buf_2)                 0.19      0.00      3.10 r
  HFSBUF_109_5541/X (sky130_fd_sc_hd__buf_2)       0.06      0.30      0.33      3.43 r
  ctmTdsLR_1_6875/A (sky130_fd_sc_hd__inv_2)                 0.30      0.00      3.44 r
  ctmTdsLR_1_6875/Y (sky130_fd_sc_hd__inv_2)       0.01      0.06      0.06      3.50 f
  ctmTdsLR_2_6876/A (sky130_fd_sc_hd__and2_4)                0.06      0.00      3.50 f
  ctmTdsLR_2_6876/X (sky130_fd_sc_hd__and2_4)      0.07      0.10      0.21      3.71 f
  HFSBUF_54_5020/A (sky130_fd_sc_hd__clkbuf_1)               0.10      0.00      3.71 f
  HFSBUF_54_5020/X (sky130_fd_sc_hd__clkbuf_1)     0.04      0.21      0.25      3.96 f
  u_core/U1771/B1 (sky130_fd_sc_hd__a22oi_1)                 0.21      0.00      3.96 f
  u_core/U1771/Y (sky130_fd_sc_hd__a22oi_1)        0.01      0.20      0.23      4.20 r
  ctmTdsLR_1_13720/B1 (sky130_fd_sc_hd__o21a_1)              0.20      0.00      4.20 r
  ctmTdsLR_1_13720/X (sky130_fd_sc_hd__o21a_1)     0.01      0.07      0.17      4.37 r
  ctmTdsLR_2_13566_roptpi_13964/B (sky130_fd_sc_hd__and2_4)
                                                             0.07      0.00      4.37 r
  ctmTdsLR_2_13566_roptpi_13964/X (sky130_fd_sc_hd__and2_4)
                                                   0.11      0.34      0.35      4.72 r
  u_core/U1777/A_N (sky130_fd_sc_hd__nand2b_1)               0.34      0.01      4.73 r
  u_core/U1777/Y (sky130_fd_sc_hd__nand2b_1)       0.01      0.10      0.18      4.91 r
  ctmTdsLR_3_13833/A (sky130_fd_sc_hd__nand3_2)              0.10      0.00      4.91 r
  ctmTdsLR_3_13833/Y (sky130_fd_sc_hd__nand3_2)    0.00      0.08      0.07      4.97 f
  ctmTdsLR_2_13832_roptpi_13971/A (sky130_fd_sc_hd__or2_4)   0.08      0.00      4.97 f
  ctmTdsLR_2_13832_roptpi_13971/X (sky130_fd_sc_hd__or2_4)
                                                   0.08      0.14      0.37      5.34 f
  ctmTdsLR_1_7045/A1 (sky130_fd_sc_hd__a22o_2)               0.15      0.01      5.35 f
  ctmTdsLR_1_7045/X (sky130_fd_sc_hd__a22o_2)      0.03      0.10      0.34      5.69 f
  HFSBUF_466_4877/A (sky130_fd_sc_hd__buf_2)                 0.10      0.00      5.69 f
  HFSBUF_466_4877/X (sky130_fd_sc_hd__buf_2)       0.07      0.17      0.27      5.95 f
  u_core/U2392/A2 (sky130_fd_sc_hd__o22ai_1)                 0.17      0.00      5.96 f
  u_core/U2392/Y (sky130_fd_sc_hd__o22ai_1)        0.02      0.45      0.42      6.37 r
  u_core/U2395/A (sky130_fd_sc_hd__nor2_1)                   0.45      0.00      6.38 r
  u_core/U2395/Y (sky130_fd_sc_hd__nor2_1)         0.01      0.11      0.14      6.51 f
  ctmTdsLR_2_7539/B1 (sky130_fd_sc_hd__a21o_1)               0.11      0.00      6.51 f
  ctmTdsLR_2_7539/X (sky130_fd_sc_hd__a21o_1)      0.01      0.05      0.19      6.70 f
  ctmTdsLR_4_6615/A (sky130_fd_sc_hd__inv_2)                 0.05      0.00      6.70 f
  ctmTdsLR_4_6615/Y (sky130_fd_sc_hd__inv_2)       0.01      0.05      0.06      6.76 r
  u_core/U2437/B (sky130_fd_sc_hd__nor2_1)                   0.05      0.00      6.76 r
  u_core/U2437/Y (sky130_fd_sc_hd__nor2_1)         0.01      0.10      0.07      6.83 f
  u_core/U2438/A (sky130_fd_sc_hd__nor2_4)                   0.10      0.00      6.83 f
  u_core/U2438/Y (sky130_fd_sc_hd__nor2_4)         0.01      0.11      0.15      6.99 r
  u_core/U2457/B (sky130_fd_sc_hd__nor2_1)                   0.11      0.00      6.99 r
  u_core/U2457/Y (sky130_fd_sc_hd__nor2_1)         0.01      0.09      0.07      7.06 f
  ctmTdsLR_1_13532/A (sky130_fd_sc_hd__nor2_1)               0.09      0.00      7.06 f
  ctmTdsLR_1_13532/Y (sky130_fd_sc_hd__nor2_1)     0.01      0.19      0.19      7.25 r
  ctmTdsLR_1_12035/B (sky130_fd_sc_hd__maj3_1)               0.19      0.00      7.25 r
  ctmTdsLR_1_12035/X (sky130_fd_sc_hd__maj3_1)     0.01      0.12      0.24      7.49 r
  u_core/U3085/A (sky130_fd_sc_hd__nand2_1)                  0.12      0.00      7.49 r
  u_core/U3085/Y (sky130_fd_sc_hd__nand2_1)        0.01      0.08      0.08      7.57 f
  u_core/U3086/A1 (sky130_fd_sc_hd__a21oi_2)                 0.08      0.00      7.57 f
  u_core/U3086/Y (sky130_fd_sc_hd__a21oi_2)        0.02      0.24      0.24      7.81 r
  u_core/U3107/B (sky130_fd_sc_hd__nor2_1)                   0.24      0.00      7.81 r
  u_core/U3107/Y (sky130_fd_sc_hd__nor2_1)         0.01      0.11      0.11      7.92 f
  ctmTdsLR_1_13808/B (sky130_fd_sc_hd__nor2_1)               0.11      0.00      7.92 f
  ctmTdsLR_1_13808/Y (sky130_fd_sc_hd__nor2_1)     0.01      0.20      0.19      8.12 r
  u_core/U3129/A (sky130_fd_sc_hd__nor2_1)                   0.20      0.00      8.12 r
  u_core/U3129/Y (sky130_fd_sc_hd__nor2_1)         0.01      0.09      0.10      8.21 f
  ctmTdsLR_2_6609/A (sky130_fd_sc_hd__nor2_1)                0.09      0.00      8.21 f
  ctmTdsLR_2_6609/Y (sky130_fd_sc_hd__nor2_1)      0.01      0.21      0.21      8.42 r
  u_core/U3147/A (sky130_fd_sc_hd__nand2_1)                  0.21      0.00      8.42 r
  u_core/U3147/Y (sky130_fd_sc_hd__nand2_1)        0.01      0.08      0.10      8.53 f
  u_core/U3149/A1 (sky130_fd_sc_hd__a21oi_2)                 0.08      0.00      8.53 f
  u_core/U3149/Y (sky130_fd_sc_hd__a21oi_2)        0.01      0.15      0.18      8.70 r
  u_core/U3166/A (sky130_fd_sc_hd__nand2_1)                  0.15      0.00      8.71 r
  u_core/U3166/Y (sky130_fd_sc_hd__nand2_1)        0.01      0.08      0.09      8.80 f
  u_core/U3168/A2 (sky130_fd_sc_hd__a21oi_2)                 0.08      0.00      8.80 f
  u_core/U3168/Y (sky130_fd_sc_hd__a21oi_2)        0.01      0.17      0.20      9.00 r
  u_core/U3185/B (sky130_fd_sc_hd__nor2_1)                   0.17      0.00      9.00 r
  u_core/U3185/Y (sky130_fd_sc_hd__nor2_1)         0.01      0.09      0.08      9.08 f
  ctmTdsLR_2_6607/A (sky130_fd_sc_hd__nor2_1)                0.09      0.00      9.08 f
  ctmTdsLR_2_6607/Y (sky130_fd_sc_hd__nor2_1)      0.01      0.20      0.20      9.28 r
  u_core/U3205/A (sky130_fd_sc_hd__nand2_1)                  0.20      0.00      9.28 r
  u_core/U3205/Y (sky130_fd_sc_hd__nand2_1)        0.00      0.07      0.08      9.36 f
  u_core/U3207/A2 (sky130_fd_sc_hd__a21oi_1)                 0.07      0.00      9.36 f
  u_core/U3207/Y (sky130_fd_sc_hd__a21oi_1)        0.01      0.26      0.26      9.62 r
  u_core/U3224/B (sky130_fd_sc_hd__nor2_1)                   0.26      0.00      9.62 r
  u_core/U3224/Y (sky130_fd_sc_hd__nor2_1)         0.01      0.10      0.11      9.73 f
  ctmTdsLR_1_13810/A (sky130_fd_sc_hd__nor2_1)               0.10      0.00      9.73 f
  ctmTdsLR_1_13810/Y (sky130_fd_sc_hd__nor2_1)     0.01      0.25      0.25      9.98 r
  u_core/U3245/B (sky130_fd_sc_hd__nor2_1)                   0.25      0.00      9.98 r
  u_core/U3245/Y (sky130_fd_sc_hd__nor2_1)         0.01      0.09      0.10     10.08 f
  ctmTdsLR_1_13410/B1 (sky130_fd_sc_hd__a21o_1)              0.09      0.00     10.08 f
  ctmTdsLR_1_13410/X (sky130_fd_sc_hd__a21o_1)     0.01      0.05      0.18     10.25 f
  ctmTdsLR_4_6605/A (sky130_fd_sc_hd__inv_2)                 0.05      0.00     10.26 f
  ctmTdsLR_4_6605/Y (sky130_fd_sc_hd__inv_2)       0.04      0.18      0.15     10.41 r
  u_core/U3263/B (sky130_fd_sc_hd__nor2_1)                   0.18      0.00     10.41 r
  u_core/U3263/Y (sky130_fd_sc_hd__nor2_1)         0.01      0.09      0.08     10.50 f
  u_core/U3829/B1 (sky130_fd_sc_hd__a21oi_1)                 0.09      0.00     10.50 f
  u_core/U3829/Y (sky130_fd_sc_hd__a21oi_1)        0.01      0.19      0.19     10.68 r
  u_core/U3283/A (sky130_fd_sc_hd__nand2_1)                  0.19      0.00     10.68 r
  u_core/U3283/Y (sky130_fd_sc_hd__nand2_1)        0.01      0.09      0.12     10.80 f
  u_core/U3285/A2 (sky130_fd_sc_hd__a21oi_2)                 0.09      0.00     10.80 f
  u_core/U3285/Y (sky130_fd_sc_hd__a21oi_2)        0.01      0.20      0.23     11.03 r
  ctmTdsLR_2_7441/B (sky130_fd_sc_hd__maj3_1)                0.20      0.00     11.03 r
  ctmTdsLR_2_7441/X (sky130_fd_sc_hd__maj3_1)      0.02      0.17      0.28     11.31 r
  u_core/U3323/A1 (sky130_fd_sc_hd__a21o_1)                  0.17      0.00     11.31 r
  u_core/U3323/X (sky130_fd_sc_hd__a21o_1)         0.01      0.07      0.16     11.47 r
  u_core/U3324/B1 (sky130_fd_sc_hd__o21ai_2)                 0.07      0.00     11.47 r
  u_core/U3324/Y (sky130_fd_sc_hd__o21ai_2)        0.01      0.09      0.07     11.54 f
  u_core/U3325/A (sky130_fd_sc_hd__nand2_1)                  0.09      0.00     11.54 f
  u_core/U3325/Y (sky130_fd_sc_hd__nand2_1)        0.01      0.08      0.10     11.64 r
  ctmTdsLR_1_13815/B2 (sky130_fd_sc_hd__a2bb2oi_1)           0.08      0.00     11.64 r
  ctmTdsLR_1_13815/Y (sky130_fd_sc_hd__a2bb2oi_1)
                                                   0.01      0.12      0.10     11.74 f
  u_core/U3362/B (sky130_fd_sc_hd__nor2_1)                   0.12      0.00     11.74 f
  u_core/U3362/Y (sky130_fd_sc_hd__nor2_1)         0.01      0.19      0.19     11.93 r
  ctmTdsLR_1_13412/B1 (sky130_fd_sc_hd__a21oi_2)             0.19      0.00     11.93 r
  ctmTdsLR_1_13412/Y (sky130_fd_sc_hd__a21oi_2)    0.01      0.09      0.07     12.00 f
  u_core/U3364/B (sky130_fd_sc_hd__nor2_1)                   0.09      0.00     12.00 f
  u_core/U3364/Y (sky130_fd_sc_hd__nor2_1)         0.01      0.14      0.14     12.15 r
  u_core/U3366/A2 (sky130_fd_sc_hd__o21ai_2)                 0.14      0.00     12.15 r
  u_core/U3366/Y (sky130_fd_sc_hd__o21ai_2)        0.01      0.09      0.09     12.23 f
  u_core/U3367/B (sky130_fd_sc_hd__nor2_1)                   0.09      0.00     12.24 f
  u_core/U3367/Y (sky130_fd_sc_hd__nor2_1)         0.01      0.13      0.13     12.37 r
  u_core/U3369/A2 (sky130_fd_sc_hd__o21ai_2)                 0.13      0.00     12.37 r
  u_core/U3369/Y (sky130_fd_sc_hd__o21ai_2)        0.01      0.07      0.09     12.45 f
  ctmTdsLR_1_6593/A2 (sky130_fd_sc_hd__o21bai_1)             0.07      0.00     12.46 f
  ctmTdsLR_1_6593/Y (sky130_fd_sc_hd__o21bai_1)    0.01      0.16      0.16     12.62 r
  ctmTdsLR_2_6594/A (sky130_fd_sc_hd__nand2_2)               0.16      0.00     12.62 r
  ctmTdsLR_2_6594/Y (sky130_fd_sc_hd__nand2_2)     0.01      0.07      0.08     12.70 f
  u_core/U3373/B (sky130_fd_sc_hd__nor2_1)                   0.07      0.00     12.70 f
  u_core/U3373/Y (sky130_fd_sc_hd__nor2_1)         0.01      0.13      0.12     12.82 r
  u_core/U3375/A2 (sky130_fd_sc_hd__o21ai_2)                 0.13      0.00     12.82 r
  u_core/U3375/Y (sky130_fd_sc_hd__o21ai_2)        0.01      0.09      0.08     12.91 f
  u_core/U3376/B (sky130_fd_sc_hd__nor2_1)                   0.09      0.00     12.91 f
  u_core/U3376/Y (sky130_fd_sc_hd__nor2_1)         0.01      0.13      0.13     13.04 r
  u_core/U3378/A2 (sky130_fd_sc_hd__o21ai_2)                 0.13      0.00     13.04 r
  u_core/U3378/Y (sky130_fd_sc_hd__o21ai_2)        0.01      0.06      0.08     13.12 f
  ctmTdsLR_1_6591/A2 (sky130_fd_sc_hd__o21bai_1)             0.06      0.00     13.12 f
  ctmTdsLR_1_6591/Y (sky130_fd_sc_hd__o21bai_1)    0.00      0.14      0.14     13.26 r
  ctmTdsLR_2_6592/B (sky130_fd_sc_hd__nand2_1)               0.14      0.00     13.26 r
  ctmTdsLR_2_6592/Y (sky130_fd_sc_hd__nand2_1)     0.01      0.08      0.11     13.37 f
  u_core/U3382/B (sky130_fd_sc_hd__nor2_1)                   0.08      0.00     13.37 f
  u_core/U3382/Y (sky130_fd_sc_hd__nor2_1)         0.01      0.14      0.14     13.51 r
  u_core/U3384/A2 (sky130_fd_sc_hd__o21ai_2)                 0.14      0.00     13.51 r
  u_core/U3384/Y (sky130_fd_sc_hd__o21ai_2)        0.01      0.07      0.09     13.60 f
  u_core/U3793/B (sky130_fd_sc_hd__nor2_1)                   0.07      0.00     13.60 f
  u_core/U3793/Y (sky130_fd_sc_hd__nor2_1)         0.01      0.14      0.13     13.74 r
  u_core/U3794/A2 (sky130_fd_sc_hd__o21ai_2)                 0.14      0.00     13.74 r
  u_core/U3794/Y (sky130_fd_sc_hd__o21ai_2)        0.01      0.07      0.09     13.83 f
  u_core/U3796/A (sky130_fd_sc_hd__nand2_1)                  0.07      0.00     13.83 f
  u_core/U3796/Y (sky130_fd_sc_hd__nand2_1)        0.01      0.09      0.09     13.92 r
  u_core/U4268/B1 (sky130_fd_sc_hd__o21ai_1)                 0.09      0.00     13.92 r
  u_core/U4268/Y (sky130_fd_sc_hd__o21ai_1)        0.01      0.10      0.10     14.03 f
  u_core/U4277/A2 (sky130_fd_sc_hd__a21oi_1)                 0.10      0.00     14.03 f
  u_core/U4277/Y (sky130_fd_sc_hd__a21oi_1)        0.01      0.18      0.21     14.24 r
  u_core/U4280/A2 (sky130_fd_sc_hd__o22ai_1)                 0.18      0.00     14.24 r
  u_core/U4280/Y (sky130_fd_sc_hd__o22ai_1)        0.01      0.11      0.11     14.36 f
  u_core/U4281/D1 (sky130_fd_sc_hd__a2111o_1)                0.11      0.00     14.36 f
  u_core/U4281/X (sky130_fd_sc_hd__a2111o_1)       0.01      0.08      0.33     14.68 f
  u_core/ex1a_ex1b_reg_q_reg_alu_result__28_/D (sky130_fd_sc_hd__dfxtp_4)
                                                             0.08      0.00     14.68 f
  data arrival time                                                             14.68

  clock clk_i (rise edge)                                             13.33     13.33
  clock network delay (propagated)                                     2.54     15.88
  u_core/ex1a_ex1b_reg_q_reg_alu_result__28_/CLK (sky130_fd_sc_hd__dfxtp_4)
                                                             0.34      0.00     15.88 r
  clock uncertainty                                                   -0.50     15.38
  library setup time                                                  -0.06     15.31
  data required time                                                            15.31
  --------------------------------------------------------------------------------------------
  data required time                                                            15.31
  data arrival time                                                            -14.68
  --------------------------------------------------------------------------------------------
  slack (MET)                                                                    0.63

  Startpoint: u_core/ex1a_ex1b_reg_q_reg_pc__1_ (rising edge-triggered flip-flop clocked by clk_i)
  Endpoint: u_core/ex1c_ex1b_reg_q_reg_dec_redirect_target__28_ (rising edge-triggered flip-flop clocked by clk_i)
  Mode: default
  Corner: default
  Scenario: default
  Path Group: PIPELINE
  Path Type: max

  Point                                            Cap      Trans      Incr      Path  
  --------------------------------------------------------------------------------------------
  clock clk_i (rise edge)                                              0.00      0.00
  clock network delay (propagated)                                     2.90      2.90

  u_core/ex1a_ex1b_reg_q_reg_pc__1_/CLK (sky130_fd_sc_hd__dfxtp_2)
                                                             0.18      0.00      2.90 r
  u_core/ex1a_ex1b_reg_q_reg_pc__1_/Q (sky130_fd_sc_hd__dfxtp_2)
                                                   0.02      0.06      0.39      3.29 f
  u_core/U1794/A (sky130_fd_sc_hd__clkinv_4)                 0.06      0.00      3.29 f
  u_core/U1794/Y (sky130_fd_sc_hd__clkinv_4)       0.08      0.16      0.14      3.43 r
  ctmTdsLR_2_13475/A (sky130_fd_sc_hd__maj3_1)               0.16      0.01      3.44 r
  ctmTdsLR_2_13475/X (sky130_fd_sc_hd__maj3_1)     0.01      0.13      0.24      3.68 r
  ctmTdsLR_1_13474/B1 (sky130_fd_sc_hd__o2bb2ai_1)           0.13      0.00      3.68 r
  ctmTdsLR_1_13474/Y (sky130_fd_sc_hd__o2bb2ai_1)
                                                   0.01      0.07      0.11      3.79 f
  u_core/U14287/CIN (sky130_fd_sc_hd__fa_1)                  0.07      0.00      3.79 f
  u_core/U14287/COUT (sky130_fd_sc_hd__fa_1)       0.01      0.11      0.42      4.20 f
  ctmTdsLR_4_13673/B (sky130_fd_sc_hd__maj3_1)               0.11      0.00      4.20 f
  ctmTdsLR_4_13673/X (sky130_fd_sc_hd__maj3_1)     0.01      0.10      0.39      4.59 f
  ctmTdsLR_3_13672/A1 (sky130_fd_sc_hd__a22o_1)              0.10      0.00      4.59 f
  ctmTdsLR_3_13672/X (sky130_fd_sc_hd__a22o_1)     0.01      0.07      0.26      4.85 f
  u_core/U14272/CIN (sky130_fd_sc_hd__fa_1)                  0.07      0.00      4.85 f
  u_core/U14272/COUT (sky130_fd_sc_hd__fa_1)       0.01      0.10      0.41      5.26 f
  u_core/U14267/CI (sky130_fd_sc_hd__fah_1)                  0.10      0.00      5.26 f
  u_core/U14267/COUT (sky130_fd_sc_hd__fah_1)      0.01      0.09      0.31      5.56 f
  u_core/U14262/CIN (sky130_fd_sc_hd__fa_1)                  0.09      0.00      5.57 f
  u_core/U14262/COUT (sky130_fd_sc_hd__fa_1)       0.01      0.09      0.40      5.96 f
  u_core/U14256/CIN (sky130_fd_sc_hd__fa_1)                  0.09      0.00      5.96 f
  u_core/U14256/COUT (sky130_fd_sc_hd__fa_1)       0.01      0.09      0.40      6.37 f
  u_core/U14251/CIN (sky130_fd_sc_hd__fa_1)                  0.09      0.00      6.37 f
  u_core/U14251/COUT (sky130_fd_sc_hd__fa_1)       0.01      0.10      0.42      6.79 f
  u_core/U14246/CIN (sky130_fd_sc_hd__fa_1)                  0.10      0.00      6.79 f
  u_core/U14246/COUT (sky130_fd_sc_hd__fa_1)       0.01      0.09      0.40      7.19 f
  u_core/U14241/CIN (sky130_fd_sc_hd__fa_1)                  0.09      0.00      7.19 f
  u_core/U14241/COUT (sky130_fd_sc_hd__fa_1)       0.01      0.09      0.39      7.58 f
  u_core/U14236/CIN (sky130_fd_sc_hd__fa_1)                  0.09      0.00      7.58 f
  u_core/U14236/COUT (sky130_fd_sc_hd__fa_1)       0.01      0.09      0.39      7.97 f
  u_core/U14231/CIN (sky130_fd_sc_hd__fa_1)                  0.09      0.00      7.97 f
  u_core/U14231/COUT (sky130_fd_sc_hd__fa_1)       0.01      0.10      0.41      8.38 f
  u_core/U14226/CIN (sky130_fd_sc_hd__fa_1)                  0.10      0.00      8.38 f
  u_core/U14226/COUT (sky130_fd_sc_hd__fa_1)       0.01      0.10      0.42      8.80 f
  u_core/U14221/CIN (sky130_fd_sc_hd__fa_1)                  0.10      0.00      8.80 f
  u_core/U14221/COUT (sky130_fd_sc_hd__fa_1)       0.01      0.09      0.40      9.20 f
  u_core/U14214/CIN (sky130_fd_sc_hd__fa_1)                  0.09      0.00      9.20 f
  u_core/U14214/COUT (sky130_fd_sc_hd__fa_1)       0.01      0.10      0.41      9.62 f
  u_core/U14209/CIN (sky130_fd_sc_hd__fa_1)                  0.10      0.00      9.62 f
  u_core/U14209/COUT (sky130_fd_sc_hd__fa_1)       0.01      0.10      0.41     10.03 f
  u_core/U14204/CIN (sky130_fd_sc_hd__fa_1)                  0.10      0.00     10.03 f
  u_core/U14204/COUT (sky130_fd_sc_hd__fa_1)       0.01      0.11      0.43     10.45 f
  u_core/U14199/CIN (sky130_fd_sc_hd__fa_1)                  0.11      0.00     10.45 f
  u_core/U14199/COUT (sky130_fd_sc_hd__fa_1)       0.01      0.10      0.41     10.87 f
  u_core/U14194/CIN (sky130_fd_sc_hd__fa_1)                  0.10      0.00     10.87 f
  u_core/U14194/COUT (sky130_fd_sc_hd__fa_1)       0.01      0.10      0.41     11.28 f
  u_core/U14189/CIN (sky130_fd_sc_hd__fa_1)                  0.10      0.00     11.28 f
  u_core/U14189/COUT (sky130_fd_sc_hd__fa_1)       0.01      0.10      0.42     11.70 f
  u_core/U14184/CIN (sky130_fd_sc_hd__fa_1)                  0.10      0.00     11.70 f
  u_core/U14184/COUT (sky130_fd_sc_hd__fa_1)       0.01      0.11      0.42     12.12 f
  u_core/U14179/CIN (sky130_fd_sc_hd__fa_1)                  0.11      0.00     12.12 f
  u_core/U14179/COUT (sky130_fd_sc_hd__fa_1)       0.01      0.10      0.42     12.54 f
  u_core/U14174/CIN (sky130_fd_sc_hd__fa_1)                  0.10      0.00     12.54 f
  u_core/U14174/COUT (sky130_fd_sc_hd__fa_1)       0.01      0.10      0.41     12.95 f
  u_core/U14169/CIN (sky130_fd_sc_hd__fa_1)                  0.10      0.00     12.95 f
  u_core/U14169/COUT (sky130_fd_sc_hd__fa_1)       0.01      0.10      0.41     13.36 f
  u_core/U14163/CIN (sky130_fd_sc_hd__fa_1)                  0.10      0.00     13.36 f
  u_core/U14163/COUT (sky130_fd_sc_hd__fa_1)       0.01      0.10      0.42     13.78 f
  u_core/U14156/CIN (sky130_fd_sc_hd__fa_1)                  0.10      0.00     13.78 f
  u_core/U14156/SUM (sky130_fd_sc_hd__fa_1)        0.01      0.09      0.47     14.25 f
  u_core/U14157/B2 (sky130_fd_sc_hd__a22oi_1)                0.09      0.00     14.25 f
  u_core/U14157/Y (sky130_fd_sc_hd__a22oi_1)       0.01      0.20      0.20     14.45 r
  u_core/U14162/A (sky130_fd_sc_hd__nand3_1)                 0.20      0.00     14.45 r
  u_core/U14162/Y (sky130_fd_sc_hd__nand3_1)       0.00      0.11      0.11     14.57 f
  u_core/ex1c_ex1b_reg_q_reg_dec_redirect_target__28_/D (sky130_fd_sc_hd__dfxtp_4)
                                                             0.11      0.00     14.57 f
  data arrival time                                                             14.57

  clock clk_i (rise edge)                                             13.33     13.33
  clock network delay (propagated)                                     2.53     15.86
  u_core/ex1c_ex1b_reg_q_reg_dec_redirect_target__28_/CLK (sky130_fd_sc_hd__dfxtp_4)
                                                             0.25      0.00     15.86 r
  clock uncertainty                                                   -0.50     15.36
  library setup time                                                  -0.09     15.27
  data required time                                                            15.27
  --------------------------------------------------------------------------------------------
  data required time                                                            15.27
  data arrival time                                                            -14.57
  --------------------------------------------------------------------------------------------
  slack (MET)                                                                    0.70

  Startpoint: u_core/ex1a_ex1b_reg_q_reg_pc__2_ (rising edge-triggered flip-flop clocked by clk_i)
  Endpoint: u_core/u_csr_mcycle_q_reg_55_ (rising edge-triggered flip-flop clocked by clk_i)
  Mode: default
  Corner: default
  Scenario: default
  Path Group: PIPELINE
  Path Type: max

  Point                                            Cap      Trans      Incr      Path  
  --------------------------------------------------------------------------------------------
  clock clk_i (rise edge)                                              0.00      0.00
  clock network delay (propagated)                                     2.92      2.92

  u_core/ex1a_ex1b_reg_q_reg_pc__2_/CLK (sky130_fd_sc_hd__dfxtp_4)
                                                             0.22      0.00      2.92 r
  u_core/ex1a_ex1b_reg_q_reg_pc__2_/Q (sky130_fd_sc_hd__dfxtp_4)
                                                   0.07      0.21      0.52      3.43 r
  u_core/U1510/B (sky130_fd_sc_hd__nand3_1)                  0.21      0.00      3.44 r
  u_core/U1510/Y (sky130_fd_sc_hd__nand3_1)        0.02      0.22      0.24      3.68 f
  u_core/U1663/A (sky130_fd_sc_hd__nor2_1)                   0.22      0.00      3.68 f
  u_core/U1663/Y (sky130_fd_sc_hd__nor2_1)         0.02      0.36      0.36      4.04 r
  u_core/U1664/A (sky130_fd_sc_hd__nand2_1)                  0.36      0.00      4.04 r
  u_core/U1664/Y (sky130_fd_sc_hd__nand2_1)        0.01      0.13      0.16      4.20 f
  u_core/U1666/A (sky130_fd_sc_hd__nor2_1)                   0.13      0.00      4.20 f
  u_core/U1666/Y (sky130_fd_sc_hd__nor2_1)         0.02      0.29      0.28      4.48 r
  u_core/U1667/A (sky130_fd_sc_hd__nand2_1)                  0.29      0.00      4.48 r
  u_core/U1667/Y (sky130_fd_sc_hd__nand2_1)        0.01      0.14      0.17      4.65 f
  u_core/U1669/A (sky130_fd_sc_hd__nor2_1)                   0.14      0.00      4.65 f
  u_core/U1669/Y (sky130_fd_sc_hd__nor2_1)         0.02      0.28      0.28      4.93 r
  u_core/U1670/A (sky130_fd_sc_hd__nand2_1)                  0.28      0.00      4.93 r
  u_core/U1670/Y (sky130_fd_sc_hd__nand2_1)        0.01      0.12      0.16      5.09 f
  u_core/U1672/A (sky130_fd_sc_hd__nor2_1)                   0.12      0.00      5.09 f
  u_core/U1672/Y (sky130_fd_sc_hd__nor2_1)         0.01      0.22      0.23      5.32 r
  u_core/U1673/A (sky130_fd_sc_hd__nand2_1)                  0.22      0.00      5.32 r
  u_core/U1673/Y (sky130_fd_sc_hd__nand2_1)        0.01      0.10      0.13      5.45 f
  u_core/U1675/A (sky130_fd_sc_hd__nor2_1)                   0.10      0.00      5.45 f
  u_core/U1675/Y (sky130_fd_sc_hd__nor2_1)         0.01      0.20      0.21      5.66 r
  u_core/U1676/A (sky130_fd_sc_hd__nand2_1)                  0.20      0.00      5.66 r
  u_core/U1676/Y (sky130_fd_sc_hd__nand2_1)        0.01      0.10      0.13      5.79 f
  u_core/U1678/A (sky130_fd_sc_hd__nor2_1)                   0.10      0.00      5.79 f
  u_core/U1678/Y (sky130_fd_sc_hd__nor2_1)         0.01      0.21      0.22      6.01 r
  u_core/U1679/A (sky130_fd_sc_hd__nand2_1)                  0.21      0.00      6.01 r
  u_core/U1679/Y (sky130_fd_sc_hd__nand2_1)        0.01      0.10      0.13      6.13 f
  u_core/U1681/A (sky130_fd_sc_hd__nor2_1)                   0.10      0.00      6.13 f
  u_core/U1681/Y (sky130_fd_sc_hd__nor2_1)         0.01      0.20      0.21      6.34 r
  u_core/U1682/A (sky130_fd_sc_hd__nand2_1)                  0.20      0.00      6.34 r
  u_core/U1682/Y (sky130_fd_sc_hd__nand2_1)        0.01      0.10      0.13      6.47 f
  u_core/U1684/A (sky130_fd_sc_hd__nor2_1)                   0.10      0.00      6.47 f
  u_core/U1684/Y (sky130_fd_sc_hd__nor2_1)         0.01      0.26      0.25      6.72 r
  u_core/U1685/A (sky130_fd_sc_hd__nand2_1)                  0.26      0.00      6.72 r
  u_core/U1685/Y (sky130_fd_sc_hd__nand2_1)        0.01      0.12      0.15      6.87 f
  u_core/U1958/A (sky130_fd_sc_hd__nor2_1)                   0.12      0.00      6.87 f
  u_core/U1958/Y (sky130_fd_sc_hd__nor2_1)         0.01      0.25      0.25      7.12 r
  u_core/U1959/A (sky130_fd_sc_hd__nand2_1)                  0.25      0.00      7.12 r
  u_core/U1959/Y (sky130_fd_sc_hd__nand2_1)        0.01      0.12      0.15      7.26 f
  u_core/U1961/A (sky130_fd_sc_hd__nor2_1)                   0.12      0.00      7.27 f
  u_core/U1961/Y (sky130_fd_sc_hd__nor2_1)         0.01      0.24      0.24      7.51 r
  u_core/U1962/A (sky130_fd_sc_hd__nand2_1)                  0.24      0.00      7.51 r
  u_core/U1962/Y (sky130_fd_sc_hd__nand2_1)        0.01      0.11      0.14      7.65 f
  u_core/U1964/A (sky130_fd_sc_hd__nor2_1)                   0.11      0.00      7.65 f
  u_core/U1964/Y (sky130_fd_sc_hd__nor2_1)         0.01      0.22      0.22      7.87 r
  u_core/U1965/A (sky130_fd_sc_hd__nand2_1)                  0.22      0.00      7.87 r
  u_core/U1965/Y (sky130_fd_sc_hd__nand2_1)        0.01      0.10      0.13      8.00 f
  u_core/U1967/A (sky130_fd_sc_hd__nor2_1)                   0.10      0.00      8.00 f
  u_core/U1967/Y (sky130_fd_sc_hd__nor2_1)         0.02      0.29      0.27      8.27 r
  u_core/U1968/A (sky130_fd_sc_hd__nand2_1)                  0.29      0.00      8.27 r
  u_core/U1968/Y (sky130_fd_sc_hd__nand2_1)        0.01      0.13      0.17      8.44 f
  u_core/U2097/A (sky130_fd_sc_hd__nor2_1)                   0.13      0.00      8.44 f
  u_core/U2097/Y (sky130_fd_sc_hd__nor2_1)         0.01      0.23      0.24      8.68 r
  u_core/U2098/A (sky130_fd_sc_hd__nand2_1)                  0.23      0.00      8.68 r
  u_core/U2098/Y (sky130_fd_sc_hd__nand2_1)        0.01      0.12      0.15      8.83 f
  u_core/U2099/B (sky130_fd_sc_hd__xnor2_1)                  0.12      0.00      8.83 f
  u_core/U2099/Y (sky130_fd_sc_hd__xnor2_1)        0.01      0.28      0.27      9.10 r
  HFSBUF_63_2136/A (sky130_fd_sc_hd__buf_2)                  0.28      0.00      9.11 r
  HFSBUF_63_2136/X (sky130_fd_sc_hd__buf_2)        0.04      0.19      0.28      9.39 r
  u_core/U2114/A2 (sky130_fd_sc_hd__o221ai_1)                0.19      0.00      9.39 r
  u_core/U2114/Y (sky130_fd_sc_hd__o221ai_1)       0.00      0.14      0.15      9.54 f
  u_core/U2115/B (sky130_fd_sc_hd__nor2_1)                   0.14      0.00      9.54 f
  u_core/U2115/Y (sky130_fd_sc_hd__nor2_1)         0.01      0.17      0.19      9.72 r
  u_core/U2116/A (sky130_fd_sc_hd__nand2_2)                  0.17      0.00      9.72 r
  u_core/U2116/Y (sky130_fd_sc_hd__nand2_2)        0.09      0.36      0.33     10.05 f
  HFSINV_504_2762/A (sky130_fd_sc_hd__inv_2)                 0.36      0.01     10.06 f
  HFSINV_504_2762/Y (sky130_fd_sc_hd__inv_2)       0.03      0.17      0.25     10.31 r
  u_core/U4419/A2_N (sky130_fd_sc_hd__a2bb2o_4)              0.17      0.00     10.31 r
  u_core/U4419/X (sky130_fd_sc_hd__a2bb2o_4)       0.09      0.14      0.34     10.65 f
  HFSINV_684_4794/A (sky130_fd_sc_hd__inv_2)                 0.15      0.01     10.65 f
  HFSINV_684_4794/Y (sky130_fd_sc_hd__inv_2)       0.07      0.32      0.29     10.94 r
  u_core/U4381/D (sky130_fd_sc_hd__nand4_1)                  0.32      0.00     10.95 r
  u_core/U4381/Y (sky130_fd_sc_hd__nand4_1)        0.00      0.12      0.15     11.09 f
  u_core/U4426/A (sky130_fd_sc_hd__or4_1)                    0.12      0.00     11.09 f
  u_core/U4426/X (sky130_fd_sc_hd__or4_1)          0.01      0.11      0.57     11.67 f
  ctmTdsLR_1_13657/A2 (sky130_fd_sc_hd__o21ai_1)             0.11      0.00     11.67 f
  ctmTdsLR_1_13657/Y (sky130_fd_sc_hd__o21ai_1)    0.02      0.44      0.39     12.05 r
  u_core/U4428/B1 (sky130_fd_sc_hd__o21ai_1)                 0.44      0.00     12.05 r
  u_core/U4428/Y (sky130_fd_sc_hd__o21ai_1)        0.01      0.15      0.19     12.24 f
  HFSINV_10142_6073/A (sky130_fd_sc_hd__clkinv_2)            0.15      0.00     12.24 f
  HFSINV_10142_6073/Y (sky130_fd_sc_hd__clkinv_2)
                                                   0.11      0.38      0.33     12.57 r
  HFSINV_7488_6071/A (sky130_fd_sc_hd__inv_4)                0.37      0.01     12.58 r
  HFSINV_7488_6071/Y (sky130_fd_sc_hd__inv_4)      0.13      0.20      0.24     12.82 f
  u_core/U4634/B_N (sky130_fd_sc_hd__or2b_2)                 0.21      0.00     12.82 f
  u_core/U4634/X (sky130_fd_sc_hd__or2b_2)         0.06      0.32      0.42     13.25 r
  HFSINV_354_4810/A (sky130_fd_sc_hd__inv_2)                 0.32      0.00     13.25 r
  HFSINV_354_4810/Y (sky130_fd_sc_hd__inv_2)       0.04      0.14      0.19     13.44 f
  u_core/U7450/A (sky130_fd_sc_hd__nor3_1)                   0.14      0.00     13.44 f
  u_core/U7450/Y (sky130_fd_sc_hd__nor3_1)         0.01      0.25      0.28     13.72 r
  HFSBUF_967_4301/A (sky130_fd_sc_hd__clkbuf_4)              0.25      0.00     13.72 r
  HFSBUF_967_4301/X (sky130_fd_sc_hd__clkbuf_4)    0.10      0.29      0.37     14.09 r
  u_core/U7520/A2 (sky130_fd_sc_hd__a22oi_1)                 0.29      0.01     14.10 r
  u_core/U7520/Y (sky130_fd_sc_hd__a22oi_1)        0.01      0.12      0.16     14.26 f
  u_core/U7521/A2 (sky130_fd_sc_hd__a32oi_1)                 0.12      0.00     14.26 f
  u_core/U7521/Y (sky130_fd_sc_hd__a32oi_1)        0.01      0.22      0.26     14.52 r
  ctmTdsLR_1_13898/A2_N (sky130_fd_sc_hd__o2bb2ai_1)         0.22      0.00     14.52 r
  ctmTdsLR_1_13898/Y (sky130_fd_sc_hd__o2bb2ai_1)
                                                   0.00      0.17      0.15     14.67 r
  u_core/u_csr_mcycle_q_reg_55_/D (sky130_fd_sc_hd__dfxtp_4)
                                                             0.17      0.00     14.67 r
  data arrival time                                                             14.67

  clock clk_i (rise edge)                                             13.33     13.33
  clock network delay (propagated)                                     2.66     15.99
  u_core/u_csr_mcycle_q_reg_55_/CLK (sky130_fd_sc_hd__dfxtp_4)
                                                             0.15      0.00     15.99 r
  clock uncertainty                                                   -0.50     15.49
  library setup time                                                  -0.08     15.42
  data required time                                                            15.42
  --------------------------------------------------------------------------------------------
  data required time                                                            15.42
  data arrival time                                                            -14.67
  --------------------------------------------------------------------------------------------
  slack (MET)                                                                    0.75

  Startpoint: u_core/u_icache_ic_addr_q_reg_8_ (rising edge-triggered flip-flop clocked by clk_i)
  Endpoint: u_core/u_if_pc_q_reg_27_ (rising edge-triggered flip-flop clocked by clk_i)
  Mode: default
  Corner: default
  Scenario: default
  Path Group: PIPELINE
  Path Type: max

  Point                                            Cap      Trans      Incr      Path  
  --------------------------------------------------------------------------------------------
  clock clk_i (rise edge)                                              0.00      0.00
  clock network delay (propagated)                                     2.68      2.68

  u_core/u_icache_ic_addr_q_reg_8_/CLK (sky130_fd_sc_hd__dfxtp_2)
                                                             0.19      0.00      2.68 r
  u_core/u_icache_ic_addr_q_reg_8_/Q (sky130_fd_sc_hd__dfxtp_2)
                                                   0.01      0.08      0.39      3.07 r
  HFSBUF_151_4631/A (sky130_fd_sc_hd__buf_6)                 0.08      0.00      3.07 r
  HFSBUF_151_4631/X (sky130_fd_sc_hd__buf_6)       0.18      0.38      0.30      3.37 r
  copt_gre_mt_inst_14371/A (sky130_fd_sc_hd__buf_4)          0.39      0.07      3.44 r
  copt_gre_mt_inst_14371/X (sky130_fd_sc_hd__buf_4)
                                                   0.14      0.40      0.43      3.87 r
  u_core/U557/A (sky130_fd_sc_hd__nand2_1)                   0.41      0.04      3.91 r
  u_core/U557/Y (sky130_fd_sc_hd__nand2_1)         0.02      0.20      0.25      4.16 f
  u_core/U562/B (sky130_fd_sc_hd__nor2_1)                    0.20      0.00      4.16 f
  u_core/U562/Y (sky130_fd_sc_hd__nor2_1)          0.02      0.35      0.34      4.50 r
  HFSBUF_837_4296/A (sky130_fd_sc_hd__buf_2)                 0.35      0.00      4.50 r
  HFSBUF_837_4296/X (sky130_fd_sc_hd__buf_2)       0.09      0.45      0.47      4.96 r
  u_core/U679/A1 (sky130_fd_sc_hd__a22oi_1)                  0.45      0.01      4.97 r
  u_core/U679/Y (sky130_fd_sc_hd__a22oi_1)         0.02      0.21      0.28      5.25 f
  u_core/U682/B (sky130_fd_sc_hd__nand4_1)                   0.21      0.00      5.25 f
  u_core/U682/Y (sky130_fd_sc_hd__nand4_1)         0.02      0.29      0.32      5.57 r
  u_core/U688/A (sky130_fd_sc_hd__nor2_1)                    0.29      0.00      5.57 r
  u_core/U688/Y (sky130_fd_sc_hd__nor2_1)          0.00      0.07      0.09      5.66 f
  u_core/U700/A2 (sky130_fd_sc_hd__o21ai_1)                  0.07      0.00      5.66 f
  u_core/U700/Y (sky130_fd_sc_hd__o21ai_1)         0.01      0.18      0.17      5.84 r
  u_core/U701/C1 (sky130_fd_sc_hd__a221oi_2)                 0.18      0.00      5.84 r
  u_core/U701/Y (sky130_fd_sc_hd__a221oi_2)        0.00      0.08      0.05      5.89 f
  u_core/U759/A1 (sky130_fd_sc_hd__a32oi_1)                  0.08      0.00      5.89 f
  u_core/U759/Y (sky130_fd_sc_hd__a32oi_1)         0.00      0.18      0.21      6.09 r
  u_core/U760/B (sky130_fd_sc_hd__nand2_1)                   0.18      0.00      6.09 r
  u_core/U760/Y (sky130_fd_sc_hd__nand2_1)         0.01      0.12      0.11      6.20 f
  u_core/U761/B1 (sky130_fd_sc_hd__o21ai_2)                  0.12      0.00      6.20 f
  u_core/U761/Y (sky130_fd_sc_hd__o21ai_2)         0.04      0.46      0.21      6.42 r
  u_core/U766/A (sky130_fd_sc_hd__nand4_1)                   0.46      0.00      6.42 r
  u_core/U766/Y (sky130_fd_sc_hd__nand4_1)         0.00      0.15      0.16      6.58 f
  ctmTdsLR_2_12175/A3 (sky130_fd_sc_hd__o31a_1)              0.15      0.00      6.58 f
  ctmTdsLR_2_12175/X (sky130_fd_sc_hd__o31a_1)     0.00      0.06      0.28      6.86 f
  ctmTdsLR_1_12174/A (sky130_fd_sc_hd__inv_2)                0.06      0.00      6.86 f
  ctmTdsLR_1_12174/Y (sky130_fd_sc_hd__inv_2)      0.05      0.22      0.19      7.05 r
  copt_gre_mt_inst_15304/A (sky130_fd_sc_hd__clkbuf_16)      0.22      0.00      7.05 r
  copt_gre_mt_inst_15304/X (sky130_fd_sc_hd__clkbuf_16)
                                                   0.11      0.10      0.22      7.28 r
  copt_gre_mt_inst_15303/A (sky130_fd_sc_hd__buf_4)          0.91      0.60      7.88 r
  copt_gre_mt_inst_15303/X (sky130_fd_sc_hd__buf_4)
                                                   0.13      0.36      0.47      8.35 r
  ctmTdsLR_1_6577/B (sky130_fd_sc_hd__nand3_2)               0.36      0.02      8.37 r
  ctmTdsLR_1_6577/Y (sky130_fd_sc_hd__nand3_2)     0.00      0.11      0.12      8.49 f
  ctmTdsLR_1_7579/B (sky130_fd_sc_hd__nand3b_1)              0.11      0.00      8.49 f
  ctmTdsLR_1_7579/Y (sky130_fd_sc_hd__nand3b_1)    0.01      0.09      0.13      8.61 r
  u_core/U782/A (sky130_fd_sc_hd__nand3_2)                   0.09      0.00      8.61 r
  u_core/U782/Y (sky130_fd_sc_hd__nand3_2)         0.01      0.12      0.09      8.71 f
  HFSBUF_32_1478/A (sky130_fd_sc_hd__buf_12)                 0.12      0.00      8.71 f
  HFSBUF_32_1478/X (sky130_fd_sc_hd__buf_12)       0.17      0.10      0.22      8.92 f
  ctmTdsLR_1_6620/B (sky130_fd_sc_hd__nor2_4)                0.10      0.02      8.94 f
  ctmTdsLR_1_6620/Y (sky130_fd_sc_hd__nor2_4)      0.07      0.46      0.38      9.32 r
  HFSBUF_446_5589/A (sky130_fd_sc_hd__buf_2)                 0.46      0.01      9.33 r
  HFSBUF_446_5589/X (sky130_fd_sc_hd__buf_2)       0.06      0.28      0.37      9.70 r
  u_core/U1021/A (sky130_fd_sc_hd__nand2_1)                  0.28      0.00      9.70 r
  u_core/U1021/Y (sky130_fd_sc_hd__nand2_1)        0.01      0.10      0.13      9.83 f
  u_core/U1022/B1 (sky130_fd_sc_hd__o21ai_1)                 0.10      0.00      9.83 f
  u_core/U1022/Y (sky130_fd_sc_hd__o21ai_1)        0.01      0.23      0.16      9.99 r
  u_core/U1023_roptpi_13956/B (sky130_fd_sc_hd__and2_4)      0.23      0.00      9.99 r
  u_core/U1023_roptpi_13956/X (sky130_fd_sc_hd__and2_4)
                                                   0.01      0.06      0.20     10.19 r
  ctmTdsLR_2_13691/B (sky130_fd_sc_hd__nand2_1)              0.06      0.00     10.19 r
  ctmTdsLR_2_13691/Y (sky130_fd_sc_hd__nand2_1)    0.01      0.05      0.06     10.25 f
  ctmTdsLR_1_13690/A (sky130_fd_sc_hd__nand2_2)              0.05      0.00     10.25 f
  ctmTdsLR_1_13690/Y (sky130_fd_sc_hd__nand2_2)    0.01      0.08      0.08     10.33 r
  u_core/U1025/B1 (sky130_fd_sc_hd__o21ai_2)                 0.08      0.00     10.33 r
  u_core/U1025/Y (sky130_fd_sc_hd__o21ai_2)        0.01      0.08      0.06     10.40 f
  u_core/U1027/A (sky130_fd_sc_hd__nand2_2)                  0.08      0.00     10.40 f
  u_core/U1027/Y (sky130_fd_sc_hd__nand2_2)        0.01      0.08      0.09     10.49 r
  ctmTdsLR_1_13912/B (sky130_fd_sc_hd__maj3_2)               0.08      0.00     10.49 r
  ctmTdsLR_1_13912/X (sky130_fd_sc_hd__maj3_2)     0.01      0.08      0.21     10.70 r
  u_core/U1028/B1 (sky130_fd_sc_hd__o21ai_2)                 0.08      0.00     10.70 r
  u_core/U1028/Y (sky130_fd_sc_hd__o21ai_2)        0.01      0.07      0.06     10.76 f
  u_core/U1030/A (sky130_fd_sc_hd__nand2_2)                  0.07      0.00     10.76 f
  u_core/U1030/Y (sky130_fd_sc_hd__nand2_2)        0.00      0.05      0.06     10.82 r
  u_core/U1237/CI (sky130_fd_sc_hd__fah_1)                   0.05      0.00     10.82 r
  u_core/U1237/COUT (sky130_fd_sc_hd__fah_1)       0.01      0.07      0.18     11.00 r
  u_core/U1230/CI (sky130_fd_sc_hd__fah_1)                   0.07      0.00     11.00 r
  u_core/U1230/COUT (sky130_fd_sc_hd__fah_1)       0.01      0.08      0.19     11.19 r
  u_core/U1223/CI (sky130_fd_sc_hd__fah_1)                   0.08      0.00     11.19 r
  u_core/U1223/COUT (sky130_fd_sc_hd__fah_1)       0.00      0.07      0.18     11.38 r
  u_core/U1216/CI (sky130_fd_sc_hd__fah_1)                   0.07      0.00     11.38 r
  u_core/U1216/COUT (sky130_fd_sc_hd__fah_1)       0.01      0.12      0.22     11.60 r
  ctmTdsLR_4_13804/B (sky130_fd_sc_hd__maj3_2)               0.12      0.00     11.60 r
  ctmTdsLR_4_13804/X (sky130_fd_sc_hd__maj3_2)     0.01      0.07      0.22     11.82 r
  ctmTdsLR_3_13803/A1 (sky130_fd_sc_hd__a22o_1)              0.07      0.00     11.82 r
  ctmTdsLR_3_13803/X (sky130_fd_sc_hd__a22o_1)     0.01      0.13      0.19     12.01 r
  ctmTdsLR_5_13860/A1 (sky130_fd_sc_hd__a21boi_2)            0.13      0.00     12.01 r
  ctmTdsLR_5_13860/Y (sky130_fd_sc_hd__a21boi_2)   0.01      0.06      0.09     12.10 f
  ctmTdsLR_3_13858/B2 (sky130_fd_sc_hd__o2bb2ai_2)           0.06      0.00     12.10 f
  ctmTdsLR_3_13858/Y (sky130_fd_sc_hd__o2bb2ai_2)
                                                   0.01      0.11      0.13     12.23 r
  u_core/U1177/CI (sky130_fd_sc_hd__fah_1)                   0.11      0.00     12.23 r
  u_core/U1177/COUT (sky130_fd_sc_hd__fah_1)       0.01      0.13      0.25     12.47 r
  ctmTdsLR_2_13753/A (sky130_fd_sc_hd__nand2_2)              0.13      0.00     12.47 r
  ctmTdsLR_2_13753/Y (sky130_fd_sc_hd__nand2_2)    0.01      0.05      0.06     12.54 f
  ctmTdsLR_1_13752/A (sky130_fd_sc_hd__nand2_2)              0.05      0.00     12.54 f
  ctmTdsLR_1_13752/Y (sky130_fd_sc_hd__nand2_2)    0.01      0.08      0.08     12.62 r
  ctmTdsLR_5_13455/A1 (sky130_fd_sc_hd__a21boi_2)            0.08      0.00     12.62 r
  ctmTdsLR_5_13455/Y (sky130_fd_sc_hd__a21boi_2)   0.01      0.06      0.07     12.69 f
  ctmTdsLR_3_13453/B2 (sky130_fd_sc_hd__o2bb2ai_2)           0.06      0.00     12.69 f
  ctmTdsLR_3_13453/Y (sky130_fd_sc_hd__o2bb2ai_2)
                                                   0.01      0.19      0.18     12.87 r
  ctmTdsLR_5_13549/A1 (sky130_fd_sc_hd__a21boi_2)            0.19      0.00     12.87 r
  ctmTdsLR_5_13549/Y (sky130_fd_sc_hd__a21boi_2)   0.01      0.08      0.10     12.97 f
  ctmTdsLR_3_13547/A2 (sky130_fd_sc_hd__o21ai_2)             0.08      0.00     12.97 f
  ctmTdsLR_3_13547/Y (sky130_fd_sc_hd__o21ai_2)    0.01      0.17      0.18     13.15 r
  ctmTdsLR_1_6574/A (sky130_fd_sc_hd__nand2_2)               0.17      0.00     13.15 r
  ctmTdsLR_1_6574/Y (sky130_fd_sc_hd__nand2_2)     0.01      0.06      0.07     13.22 f
  ctmTdsLR_3_6576/A (sky130_fd_sc_hd__nand2_2)               0.06      0.00     13.22 f
  ctmTdsLR_3_6576/Y (sky130_fd_sc_hd__nand2_2)     0.00      0.05      0.06     13.28 r
  u_core/U1118/CI (sky130_fd_sc_hd__fah_1)                   0.05      0.00     13.28 r
  u_core/U1118/COUT (sky130_fd_sc_hd__fah_1)       0.01      0.15      0.24     13.52 r
  ctmTdsLR_2_13823/A (sky130_fd_sc_hd__nand2_2)              0.15      0.00     13.52 r
  ctmTdsLR_2_13823/Y (sky130_fd_sc_hd__nand2_2)    0.01      0.05      0.07     13.58 f
  ctmTdsLR_1_13822/A (sky130_fd_sc_hd__nand2_2)              0.05      0.00     13.58 f
  ctmTdsLR_1_13822/Y (sky130_fd_sc_hd__nand2_2)    0.01      0.08      0.08     13.66 r
  ctmTdsLR_2_13747/A (sky130_fd_sc_hd__nand2_2)              0.08      0.00     13.67 r
  ctmTdsLR_2_13747/Y (sky130_fd_sc_hd__nand2_2)    0.00      0.04      0.05     13.72 f
  ctmTdsLR_1_13746/A (sky130_fd_sc_hd__nand2_2)              0.04      0.00     13.72 f
  ctmTdsLR_1_13746/Y (sky130_fd_sc_hd__nand2_2)    0.01      0.08      0.08     13.79 r
  ctmTdsLR_1_6571/A (sky130_fd_sc_hd__nand2_2)               0.08      0.00     13.80 r
  ctmTdsLR_1_6571/Y (sky130_fd_sc_hd__nand2_2)     0.01      0.04      0.06     13.85 f
  ctmTdsLR_3_6573/A (sky130_fd_sc_hd__nand2_2)               0.04      0.00     13.85 f
  ctmTdsLR_3_6573/Y (sky130_fd_sc_hd__nand2_2)     0.01      0.08      0.08     13.93 r
  ctmTdsLR_2_13741/A (sky130_fd_sc_hd__nand2_2)              0.08      0.00     13.93 r
  ctmTdsLR_2_13741/Y (sky130_fd_sc_hd__nand2_2)    0.01      0.04      0.06     13.99 f
  ctmTdsLR_1_13740/A (sky130_fd_sc_hd__nand2_2)              0.04      0.00     13.99 f
  ctmTdsLR_1_13740/Y (sky130_fd_sc_hd__nand2_2)    0.01      0.08      0.08     14.06 r
  ctmTdsLR_2_13735/A (sky130_fd_sc_hd__nand2_2)              0.08      0.00     14.07 r
  ctmTdsLR_2_13735/Y (sky130_fd_sc_hd__nand2_2)    0.00      0.04      0.05     14.12 f
  ctmTdsLR_1_13734/A (sky130_fd_sc_hd__nand2_2)              0.04      0.00     14.12 f
  ctmTdsLR_1_13734/Y (sky130_fd_sc_hd__nand2_2)    0.01      0.07      0.06     14.18 r
  u_core/U1072/CI (sky130_fd_sc_hd__fah_1)                   0.07      0.00     14.18 r
  u_core/U1072/SUM (sky130_fd_sc_hd__fah_1)        0.01      0.06      0.28     14.46 f
  u_core/U1074/A (sky130_fd_sc_hd__nand2_1)                  0.06      0.00     14.46 f
  u_core/U1074/Y (sky130_fd_sc_hd__nand2_1)        0.01      0.08      0.09     14.55 r
  u_core/U1076/C1 (sky130_fd_sc_hd__o2111ai_1)               0.08      0.00     14.55 r
  u_core/U1076/Y (sky130_fd_sc_hd__o2111ai_1)      0.00      0.14      0.12     14.68 f
  u_core/u_if_pc_q_reg_27_/D (sky130_fd_sc_hd__dfxtp_4)      0.14      0.00     14.68 f
  data arrival time                                                             14.68

  clock clk_i (rise edge)                                             13.33     13.33
  clock network delay (propagated)                                     2.75     16.08
  u_core/u_if_pc_q_reg_27_/CLK (sky130_fd_sc_hd__dfxtp_4)    0.23      0.00     16.08 r
  clock uncertainty                                                   -0.50     15.58
  library setup time                                                  -0.11     15.47
  data required time                                                            15.47
  --------------------------------------------------------------------------------------------
  data required time                                                            15.47
  data arrival time                                                            -14.68
  --------------------------------------------------------------------------------------------
  slack (MET)                                                                    0.79

  Startpoint: u_core/ex1a_ex1b_reg_q_reg_pc__2_ (rising edge-triggered flip-flop clocked by clk_i)
  Endpoint: u_core/u_csr_mepc_q_reg_15_ (rising edge-triggered flip-flop clocked by clk_i)
  Mode: default
  Corner: default
  Scenario: default
  Path Group: PIPELINE
  Path Type: max

  Point                                            Cap      Trans      Incr      Path  
  --------------------------------------------------------------------------------------------
  clock clk_i (rise edge)                                              0.00      0.00
  clock network delay (propagated)                                     2.92      2.92

  u_core/ex1a_ex1b_reg_q_reg_pc__2_/CLK (sky130_fd_sc_hd__dfxtp_4)
                                                             0.22      0.00      2.92 r
  u_core/ex1a_ex1b_reg_q_reg_pc__2_/Q (sky130_fd_sc_hd__dfxtp_4)
                                                   0.07      0.21      0.52      3.43 r
  u_core/U1510/B (sky130_fd_sc_hd__nand3_1)                  0.21      0.00      3.44 r
  u_core/U1510/Y (sky130_fd_sc_hd__nand3_1)        0.02      0.22      0.24      3.68 f
  u_core/U1663/A (sky130_fd_sc_hd__nor2_1)                   0.22      0.00      3.68 f
  u_core/U1663/Y (sky130_fd_sc_hd__nor2_1)         0.02      0.36      0.36      4.04 r
  u_core/U1664/A (sky130_fd_sc_hd__nand2_1)                  0.36      0.00      4.04 r
  u_core/U1664/Y (sky130_fd_sc_hd__nand2_1)        0.01      0.13      0.16      4.20 f
  u_core/U1666/A (sky130_fd_sc_hd__nor2_1)                   0.13      0.00      4.20 f
  u_core/U1666/Y (sky130_fd_sc_hd__nor2_1)         0.02      0.29      0.28      4.48 r
  u_core/U1667/A (sky130_fd_sc_hd__nand2_1)                  0.29      0.00      4.48 r
  u_core/U1667/Y (sky130_fd_sc_hd__nand2_1)        0.01      0.14      0.17      4.65 f
  u_core/U1669/A (sky130_fd_sc_hd__nor2_1)                   0.14      0.00      4.65 f
  u_core/U1669/Y (sky130_fd_sc_hd__nor2_1)         0.02      0.28      0.28      4.93 r
  u_core/U1670/A (sky130_fd_sc_hd__nand2_1)                  0.28      0.00      4.93 r
  u_core/U1670/Y (sky130_fd_sc_hd__nand2_1)        0.01      0.12      0.16      5.09 f
  u_core/U1672/A (sky130_fd_sc_hd__nor2_1)                   0.12      0.00      5.09 f
  u_core/U1672/Y (sky130_fd_sc_hd__nor2_1)         0.01      0.22      0.23      5.32 r
  u_core/U1673/A (sky130_fd_sc_hd__nand2_1)                  0.22      0.00      5.32 r
  u_core/U1673/Y (sky130_fd_sc_hd__nand2_1)        0.01      0.10      0.13      5.45 f
  u_core/U1675/A (sky130_fd_sc_hd__nor2_1)                   0.10      0.00      5.45 f
  u_core/U1675/Y (sky130_fd_sc_hd__nor2_1)         0.01      0.20      0.21      5.66 r
  u_core/U1676/A (sky130_fd_sc_hd__nand2_1)                  0.20      0.00      5.66 r
  u_core/U1676/Y (sky130_fd_sc_hd__nand2_1)        0.01      0.10      0.13      5.79 f
  u_core/U1678/A (sky130_fd_sc_hd__nor2_1)                   0.10      0.00      5.79 f
  u_core/U1678/Y (sky130_fd_sc_hd__nor2_1)         0.01      0.21      0.22      6.01 r
  u_core/U1679/A (sky130_fd_sc_hd__nand2_1)                  0.21      0.00      6.01 r
  u_core/U1679/Y (sky130_fd_sc_hd__nand2_1)        0.01      0.10      0.13      6.13 f
  u_core/U1681/A (sky130_fd_sc_hd__nor2_1)                   0.10      0.00      6.13 f
  u_core/U1681/Y (sky130_fd_sc_hd__nor2_1)         0.01      0.20      0.21      6.34 r
  u_core/U1682/A (sky130_fd_sc_hd__nand2_1)                  0.20      0.00      6.34 r
  u_core/U1682/Y (sky130_fd_sc_hd__nand2_1)        0.01      0.10      0.13      6.47 f
  u_core/U1684/A (sky130_fd_sc_hd__nor2_1)                   0.10      0.00      6.47 f
  u_core/U1684/Y (sky130_fd_sc_hd__nor2_1)         0.01      0.26      0.25      6.72 r
  u_core/U1685/A (sky130_fd_sc_hd__nand2_1)                  0.26      0.00      6.72 r
  u_core/U1685/Y (sky130_fd_sc_hd__nand2_1)        0.01      0.12      0.15      6.87 f
  u_core/U1958/A (sky130_fd_sc_hd__nor2_1)                   0.12      0.00      6.87 f
  u_core/U1958/Y (sky130_fd_sc_hd__nor2_1)         0.01      0.25      0.25      7.12 r
  u_core/U1959/A (sky130_fd_sc_hd__nand2_1)                  0.25      0.00      7.12 r
  u_core/U1959/Y (sky130_fd_sc_hd__nand2_1)        0.01      0.12      0.15      7.26 f
  u_core/U1961/A (sky130_fd_sc_hd__nor2_1)                   0.12      0.00      7.27 f
  u_core/U1961/Y (sky130_fd_sc_hd__nor2_1)         0.01      0.24      0.24      7.51 r
  u_core/U1962/A (sky130_fd_sc_hd__nand2_1)                  0.24      0.00      7.51 r
  u_core/U1962/Y (sky130_fd_sc_hd__nand2_1)        0.01      0.11      0.14      7.65 f
  u_core/U1964/A (sky130_fd_sc_hd__nor2_1)                   0.11      0.00      7.65 f
  u_core/U1964/Y (sky130_fd_sc_hd__nor2_1)         0.01      0.22      0.22      7.87 r
  u_core/U1965/A (sky130_fd_sc_hd__nand2_1)                  0.22      0.00      7.87 r
  u_core/U1965/Y (sky130_fd_sc_hd__nand2_1)        0.01      0.10      0.13      8.00 f
  u_core/U1967/A (sky130_fd_sc_hd__nor2_1)                   0.10      0.00      8.00 f
  u_core/U1967/Y (sky130_fd_sc_hd__nor2_1)         0.02      0.29      0.27      8.27 r
  u_core/U1968/A (sky130_fd_sc_hd__nand2_1)                  0.29      0.00      8.27 r
  u_core/U1968/Y (sky130_fd_sc_hd__nand2_1)        0.01      0.13      0.17      8.44 f
  u_core/U2097/A (sky130_fd_sc_hd__nor2_1)                   0.13      0.00      8.44 f
  u_core/U2097/Y (sky130_fd_sc_hd__nor2_1)         0.01      0.23      0.24      8.68 r
  u_core/U2098/A (sky130_fd_sc_hd__nand2_1)                  0.23      0.00      8.68 r
  u_core/U2098/Y (sky130_fd_sc_hd__nand2_1)        0.01      0.12      0.15      8.83 f
  u_core/U2099/B (sky130_fd_sc_hd__xnor2_1)                  0.12      0.00      8.83 f
  u_core/U2099/Y (sky130_fd_sc_hd__xnor2_1)        0.01      0.28      0.27      9.10 r
  HFSBUF_63_2136/A (sky130_fd_sc_hd__buf_2)                  0.28      0.00      9.11 r
  HFSBUF_63_2136/X (sky130_fd_sc_hd__buf_2)        0.04      0.19      0.28      9.39 r
  u_core/U2114/A2 (sky130_fd_sc_hd__o221ai_1)                0.19      0.00      9.39 r
  u_core/U2114/Y (sky130_fd_sc_hd__o221ai_1)       0.00      0.14      0.15      9.54 f
  u_core/U2115/B (sky130_fd_sc_hd__nor2_1)                   0.14      0.00      9.54 f
  u_core/U2115/Y (sky130_fd_sc_hd__nor2_1)         0.01      0.17      0.19      9.72 r
  u_core/U2116/A (sky130_fd_sc_hd__nand2_2)                  0.17      0.00      9.72 r
  u_core/U2116/Y (sky130_fd_sc_hd__nand2_2)        0.09      0.36      0.33     10.05 f
  HFSINV_504_2762/A (sky130_fd_sc_hd__inv_2)                 0.36      0.01     10.06 f
  HFSINV_504_2762/Y (sky130_fd_sc_hd__inv_2)       0.03      0.17      0.25     10.31 r
  u_core/U4419/A2_N (sky130_fd_sc_hd__a2bb2o_4)              0.17      0.00     10.31 r
  u_core/U4419/X (sky130_fd_sc_hd__a2bb2o_4)       0.09      0.14      0.34     10.65 f
  HFSINV_684_4794/A (sky130_fd_sc_hd__inv_2)                 0.15      0.01     10.65 f
  HFSINV_684_4794/Y (sky130_fd_sc_hd__inv_2)       0.07      0.32      0.29     10.94 r
  u_core/U4381/D (sky130_fd_sc_hd__nand4_1)                  0.32      0.00     10.95 r
  u_core/U4381/Y (sky130_fd_sc_hd__nand4_1)        0.00      0.12      0.15     11.09 f
  u_core/U4426/A (sky130_fd_sc_hd__or4_1)                    0.12      0.00     11.09 f
  u_core/U4426/X (sky130_fd_sc_hd__or4_1)          0.01      0.11      0.57     11.67 f
  ctmTdsLR_1_13657/A2 (sky130_fd_sc_hd__o21ai_1)             0.11      0.00     11.67 f
  ctmTdsLR_1_13657/Y (sky130_fd_sc_hd__o21ai_1)    0.02      0.44      0.39     12.05 r
  u_core/U4428/B1 (sky130_fd_sc_hd__o21ai_1)                 0.44      0.00     12.05 r
  u_core/U4428/Y (sky130_fd_sc_hd__o21ai_1)        0.01      0.15      0.19     12.24 f
  HFSINV_10142_6073/A (sky130_fd_sc_hd__clkinv_2)            0.15      0.00     12.24 f
  HFSINV_10142_6073/Y (sky130_fd_sc_hd__clkinv_2)
                                                   0.11      0.38      0.33     12.57 r
  HFSINV_7488_6071/A (sky130_fd_sc_hd__inv_4)                0.37      0.01     12.58 r
  HFSINV_7488_6071/Y (sky130_fd_sc_hd__inv_4)      0.13      0.20      0.24     12.82 f
  u_core/U5165/B (sky130_fd_sc_hd__nor2_1)                   0.21      0.00     12.83 f
  u_core/U5165/Y (sky130_fd_sc_hd__nor2_1)         0.01      0.26      0.28     13.10 r
  HFSBUF_318_4687/A (sky130_fd_sc_hd__buf_2)                 0.26      0.00     13.10 r
  HFSBUF_318_4687/X (sky130_fd_sc_hd__buf_2)       0.05      0.25      0.31     13.42 r
  u_core/U12598/B (sky130_fd_sc_hd__and2b_2)                 0.25      0.00     13.42 r
  u_core/U12598/X (sky130_fd_sc_hd__and2b_2)       0.08      0.39      0.44     13.86 r
  u_core/U6897/A2 (sky130_fd_sc_hd__a22oi_2)                 0.39      0.01     13.87 r
  u_core/U6897/Y (sky130_fd_sc_hd__a22oi_2)        0.02      0.18      0.22     14.09 f
  u_core/U6898/A2 (sky130_fd_sc_hd__a32oi_1)                 0.18      0.00     14.09 f
  u_core/U6898/Y (sky130_fd_sc_hd__a32oi_1)        0.00      0.18      0.26     14.35 r
  u_core/U6899/A2_N (sky130_fd_sc_hd__o2bb2ai_1)             0.18      0.00     14.36 r
  u_core/U6899/Y (sky130_fd_sc_hd__o2bb2ai_1)      0.00      0.14      0.14     14.50 r
  u_core/u_csr_mepc_q_reg_15_/D (sky130_fd_sc_hd__dfxtp_4)   0.14      0.00     14.50 r
  data arrival time                                                             14.50

  clock clk_i (rise edge)                                             13.33     13.33
  clock network delay (propagated)                                     2.52     15.86
  u_core/u_csr_mepc_q_reg_15_/CLK (sky130_fd_sc_hd__dfxtp_4)
                                                             0.24      0.00     15.86 r
  clock uncertainty                                                   -0.50     15.36
  library setup time                                                  -0.05     15.30
  data required time                                                            15.30
  --------------------------------------------------------------------------------------------
  data required time                                                            15.30
  data arrival time                                                            -14.50
  --------------------------------------------------------------------------------------------
  slack (MET)                                                                    0.80

  Startpoint: u_core/u_csr_mcycle_q_reg_0_ (rising edge-triggered flip-flop clocked by clk_i)
  Endpoint: u_core/u_csr_mcycle_q_reg_63_ (rising edge-triggered flip-flop clocked by clk_i)
  Mode: default
  Corner: default
  Scenario: default
  Path Group: PIPELINE
  Path Type: max

  Point                                            Cap      Trans      Incr      Path  
  --------------------------------------------------------------------------------------------
  clock clk_i (rise edge)                                              0.00      0.00
  clock network delay (propagated)                                     2.70      2.70

  u_core/u_csr_mcycle_q_reg_0_/CLK (sky130_fd_sc_hd__dfxtp_1)
                                                             0.20      0.00      2.70 r
  u_core/u_csr_mcycle_q_reg_0_/Q (sky130_fd_sc_hd__dfxtp_1)
                                                   0.02      0.19      0.46      3.15 r
  u_core/U7346/C (sky130_fd_sc_hd__nand3_1)                  0.19      0.00      3.16 r
  u_core/U7346/Y (sky130_fd_sc_hd__nand3_1)        0.02      0.21      0.22      3.38 f
  u_core/U7347/B (sky130_fd_sc_hd__nor2_1)                   0.21      0.00      3.38 f
  u_core/U7347/Y (sky130_fd_sc_hd__nor2_1)         0.01      0.21      0.24      3.62 r
  u_core/U7348/A (sky130_fd_sc_hd__nand2_1)                  0.21      0.00      3.62 r
  u_core/U7348/Y (sky130_fd_sc_hd__nand2_1)        0.01      0.10      0.13      3.75 f
  u_core/U7349/B (sky130_fd_sc_hd__nor2_1)                   0.10      0.00      3.75 f
  u_core/U7349/Y (sky130_fd_sc_hd__nor2_1)         0.01      0.24      0.22      3.97 r
  u_core/U7350/B (sky130_fd_sc_hd__nand2_1)                  0.24      0.00      3.97 r
  u_core/U7350/Y (sky130_fd_sc_hd__nand2_1)        0.01      0.12      0.16      4.13 f
  u_core/U7351/B (sky130_fd_sc_hd__nor2_2)                   0.12      0.00      4.13 f
  u_core/U7351/Y (sky130_fd_sc_hd__nor2_2)         0.01      0.17      0.18      4.31 r
  u_core/U7352/A (sky130_fd_sc_hd__nand2_2)                  0.17      0.00      4.31 r
  u_core/U7352/Y (sky130_fd_sc_hd__nand2_2)        0.08      0.31      0.29      4.60 f
  u_core/U7353/B (sky130_fd_sc_hd__nor2_4)                   0.31      0.00      4.60 f
  u_core/U7353/Y (sky130_fd_sc_hd__nor2_4)         0.01      0.14      0.21      4.81 r
  u_core/U7354/B (sky130_fd_sc_hd__nand2_1)                  0.14      0.00      4.81 r
  u_core/U7354/Y (sky130_fd_sc_hd__nand2_1)        0.01      0.10      0.12      4.93 f
  u_core/U7355/B (sky130_fd_sc_hd__nor2_2)                   0.10      0.00      4.93 f
  u_core/U7355/Y (sky130_fd_sc_hd__nor2_2)         0.01      0.14      0.15      5.08 r
  u_core/U7356/B (sky130_fd_sc_hd__nand2_1)                  0.14      0.00      5.08 r
  u_core/U7356/Y (sky130_fd_sc_hd__nand2_1)        0.01      0.09      0.12      5.20 f
  u_core/U7357/B (sky130_fd_sc_hd__nor2_2)                   0.09      0.00      5.20 f
  u_core/U7357/Y (sky130_fd_sc_hd__nor2_2)         0.01      0.17      0.17      5.37 r
  u_core/U7358/B (sky130_fd_sc_hd__nand2_1)                  0.17      0.00      5.37 r
  u_core/U7358/Y (sky130_fd_sc_hd__nand2_1)        0.02      0.13      0.16      5.53 f
  u_core/U7359/B (sky130_fd_sc_hd__nor2_4)                   0.13      0.00      5.53 f
  u_core/U7359/Y (sky130_fd_sc_hd__nor2_4)         0.04      0.25      0.24      5.77 r
  u_core/U7360/B (sky130_fd_sc_hd__nand2_1)                  0.25      0.00      5.77 r
  u_core/U7360/Y (sky130_fd_sc_hd__nand2_1)        0.02      0.17      0.21      5.99 f
  u_core/U7361/B (sky130_fd_sc_hd__nor2_2)                   0.17      0.00      5.99 f
  u_core/U7361/Y (sky130_fd_sc_hd__nor2_2)         0.01      0.15      0.18      6.17 r
  u_core/U7362/B (sky130_fd_sc_hd__nand2_1)                  0.15      0.00      6.17 r
  u_core/U7362/Y (sky130_fd_sc_hd__nand2_1)        0.01      0.12      0.14      6.31 f
  u_core/U7363/B (sky130_fd_sc_hd__nor2_2)                   0.12      0.00      6.31 f
  u_core/U7363/Y (sky130_fd_sc_hd__nor2_2)         0.02      0.23      0.22      6.54 r
  u_core/U7364/B (sky130_fd_sc_hd__nand2_1)                  0.23      0.00      6.54 r
  u_core/U7364/Y (sky130_fd_sc_hd__nand2_1)        0.02      0.15      0.18      6.72 f
  u_core/U7365/B (sky130_fd_sc_hd__nor2_4)                   0.15      0.00      6.72 f
  u_core/U7365/Y (sky130_fd_sc_hd__nor2_4)         0.02      0.14      0.17      6.89 r
  u_core/U7366/A (sky130_fd_sc_hd__nand2_2)                  0.14      0.00      6.89 r
  u_core/U7366/Y (sky130_fd_sc_hd__nand2_2)        0.03      0.14      0.15      7.04 f
  u_core/U7367/B (sky130_fd_sc_hd__nor2_2)                   0.14      0.00      7.04 f
  u_core/U7367/Y (sky130_fd_sc_hd__nor2_2)         0.01      0.14      0.16      7.20 r
  u_core/U7368/B (sky130_fd_sc_hd__nand2_1)                  0.14      0.00      7.20 r
  u_core/U7368/Y (sky130_fd_sc_hd__nand2_1)        0.02      0.12      0.14      7.34 f
  u_core/U7369/B (sky130_fd_sc_hd__nor2_2)                   0.12      0.00      7.34 f
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
  u_core/U7393/Y (sky130_fd_sc_hd__nor2_2)         0.01      0.16      0.17     11.90 r
  u_core/U7394/B (sky130_fd_sc_hd__nand2_1)                  0.16      0.00     11.90 r
  u_core/U7394/Y (sky130_fd_sc_hd__nand2_1)        0.01      0.11      0.13     12.04 f
  u_core/U7395/B (sky130_fd_sc_hd__nor2_2)                   0.11      0.00     12.04 f
  u_core/U7395/Y (sky130_fd_sc_hd__nor2_2)         0.02      0.19      0.19     12.22 r
  u_core/U7396/B (sky130_fd_sc_hd__nand2_1)                  0.19      0.00     12.22 r
  u_core/U7396/Y (sky130_fd_sc_hd__nand2_1)        0.02      0.13      0.16     12.38 f
  u_core/U7397/B (sky130_fd_sc_hd__nor2_4)                   0.13      0.00     12.38 f
  u_core/U7397/Y (sky130_fd_sc_hd__nor2_4)         0.02      0.15      0.17     12.55 r
  u_core/U7398/A (sky130_fd_sc_hd__nand2_2)                  0.15      0.00     12.55 r
  u_core/U7398/Y (sky130_fd_sc_hd__nand2_2)        0.03      0.13      0.14     12.70 f
  u_core/U7399/B (sky130_fd_sc_hd__nor2_2)                   0.13      0.00     12.70 f
  u_core/U7399/Y (sky130_fd_sc_hd__nor2_2)         0.01      0.13      0.15     12.85 r
  u_core/U7400/B (sky130_fd_sc_hd__nand2_1)                  0.13      0.00     12.85 r
  u_core/U7400/Y (sky130_fd_sc_hd__nand2_1)        0.01      0.11      0.13     12.98 f
  u_core/U7401/B (sky130_fd_sc_hd__nor2_1)                   0.11      0.00     12.98 f
  u_core/U7401/Y (sky130_fd_sc_hd__nor2_1)         0.01      0.22      0.21     13.20 r
  u_core/U7402/B (sky130_fd_sc_hd__nand2_1)                  0.22      0.00     13.20 r
  u_core/U7402/Y (sky130_fd_sc_hd__nand2_1)        0.01      0.13      0.16     13.36 f
  u_core/U7403/B (sky130_fd_sc_hd__nor2_2)                   0.13      0.00     13.36 f
  u_core/U7403/Y (sky130_fd_sc_hd__nor2_2)         0.01      0.14      0.16     13.51 r
  u_core/U7404/B (sky130_fd_sc_hd__nand2_1)                  0.14      0.00     13.51 r
  u_core/U7404/Y (sky130_fd_sc_hd__nand2_1)        0.01      0.09      0.12     13.63 f
  u_core/U7405/B (sky130_fd_sc_hd__nor2_2)                   0.09      0.00     13.63 f
  u_core/U7405/Y (sky130_fd_sc_hd__nor2_2)         0.02      0.23      0.21     13.84 r
  u_core/U7427/B (sky130_fd_sc_hd__nand2_1)                  0.23      0.00     13.84 r
  u_core/U7427/Y (sky130_fd_sc_hd__nand2_1)        0.01      0.10      0.14     13.98 f
  u_core/U7440/B (sky130_fd_sc_hd__xnor2_1)                  0.10      0.00     13.98 f
  u_core/U7440/Y (sky130_fd_sc_hd__xnor2_1)        0.00      0.06      0.15     14.13 f
  ctmTdsLR_1_12052/A1 (sky130_fd_sc_hd__a221o_1)             0.06      0.00     14.13 f
  ctmTdsLR_1_12052/X (sky130_fd_sc_hd__a221o_1)    0.00      0.06      0.33     14.46 f
  u_core/U7443/A2_N (sky130_fd_sc_hd__o2bb2ai_1)             0.06      0.00     14.46 f
  u_core/U7443/Y (sky130_fd_sc_hd__o2bb2ai_1)      0.00      0.07      0.12     14.59 f
  u_core/u_csr_mcycle_q_reg_63_/D (sky130_fd_sc_hd__dfxtp_4)
                                                             0.07      0.00     14.59 f
  data arrival time                                                             14.59

  clock clk_i (rise edge)                                             13.33     13.33
  clock network delay (propagated)                                     2.68     16.01
  u_core/u_csr_mcycle_q_reg_63_/CLK (sky130_fd_sc_hd__dfxtp_4)
                                                             0.17      0.00     16.01 r
  clock uncertainty                                                   -0.50     15.51
  library setup time                                                  -0.09     15.42
  data required time                                                            15.42
  --------------------------------------------------------------------------------------------
  data required time                                                            15.42
  data arrival time                                                            -14.59
  --------------------------------------------------------------------------------------------
  slack (MET)                                                                    0.83

  Startpoint: u_core/u_csr_mcycle_q_reg_0_ (rising edge-triggered flip-flop clocked by clk_i)
  Endpoint: u_core/u_csr_mcycle_q_reg_62_ (rising edge-triggered flip-flop clocked by clk_i)
  Mode: default
  Corner: default
  Scenario: default
  Path Group: PIPELINE
  Path Type: max

  Point                                            Cap      Trans      Incr      Path  
  --------------------------------------------------------------------------------------------
  clock clk_i (rise edge)                                              0.00      0.00
  clock network delay (propagated)                                     2.70      2.70

  u_core/u_csr_mcycle_q_reg_0_/CLK (sky130_fd_sc_hd__dfxtp_1)
                                                             0.20      0.00      2.70 r
  u_core/u_csr_mcycle_q_reg_0_/Q (sky130_fd_sc_hd__dfxtp_1)
                                                   0.02      0.19      0.46      3.15 r
  u_core/U7346/C (sky130_fd_sc_hd__nand3_1)                  0.19      0.00      3.16 r
  u_core/U7346/Y (sky130_fd_sc_hd__nand3_1)        0.02      0.21      0.22      3.38 f
  u_core/U7347/B (sky130_fd_sc_hd__nor2_1)                   0.21      0.00      3.38 f
  u_core/U7347/Y (sky130_fd_sc_hd__nor2_1)         0.01      0.21      0.24      3.62 r
  u_core/U7348/A (sky130_fd_sc_hd__nand2_1)                  0.21      0.00      3.62 r
  u_core/U7348/Y (sky130_fd_sc_hd__nand2_1)        0.01      0.10      0.13      3.75 f
  u_core/U7349/B (sky130_fd_sc_hd__nor2_1)                   0.10      0.00      3.75 f
  u_core/U7349/Y (sky130_fd_sc_hd__nor2_1)         0.01      0.24      0.22      3.97 r
  u_core/U7350/B (sky130_fd_sc_hd__nand2_1)                  0.24      0.00      3.97 r
  u_core/U7350/Y (sky130_fd_sc_hd__nand2_1)        0.01      0.12      0.16      4.13 f
  u_core/U7351/B (sky130_fd_sc_hd__nor2_2)                   0.12      0.00      4.13 f
  u_core/U7351/Y (sky130_fd_sc_hd__nor2_2)         0.01      0.17      0.18      4.31 r
  u_core/U7352/A (sky130_fd_sc_hd__nand2_2)                  0.17      0.00      4.31 r
  u_core/U7352/Y (sky130_fd_sc_hd__nand2_2)        0.08      0.31      0.29      4.60 f
  u_core/U7353/B (sky130_fd_sc_hd__nor2_4)                   0.31      0.00      4.60 f
  u_core/U7353/Y (sky130_fd_sc_hd__nor2_4)         0.01      0.14      0.21      4.81 r
  u_core/U7354/B (sky130_fd_sc_hd__nand2_1)                  0.14      0.00      4.81 r
  u_core/U7354/Y (sky130_fd_sc_hd__nand2_1)        0.01      0.10      0.12      4.93 f
  u_core/U7355/B (sky130_fd_sc_hd__nor2_2)                   0.10      0.00      4.93 f
  u_core/U7355/Y (sky130_fd_sc_hd__nor2_2)         0.01      0.14      0.15      5.08 r
  u_core/U7356/B (sky130_fd_sc_hd__nand2_1)                  0.14      0.00      5.08 r
  u_core/U7356/Y (sky130_fd_sc_hd__nand2_1)        0.01      0.09      0.12      5.20 f
  u_core/U7357/B (sky130_fd_sc_hd__nor2_2)                   0.09      0.00      5.20 f
  u_core/U7357/Y (sky130_fd_sc_hd__nor2_2)         0.01      0.17      0.17      5.37 r
  u_core/U7358/B (sky130_fd_sc_hd__nand2_1)                  0.17      0.00      5.37 r
  u_core/U7358/Y (sky130_fd_sc_hd__nand2_1)        0.02      0.13      0.16      5.53 f
  u_core/U7359/B (sky130_fd_sc_hd__nor2_4)                   0.13      0.00      5.53 f
  u_core/U7359/Y (sky130_fd_sc_hd__nor2_4)         0.04      0.25      0.24      5.77 r
  u_core/U7360/B (sky130_fd_sc_hd__nand2_1)                  0.25      0.00      5.77 r
  u_core/U7360/Y (sky130_fd_sc_hd__nand2_1)        0.02      0.17      0.21      5.99 f
  u_core/U7361/B (sky130_fd_sc_hd__nor2_2)                   0.17      0.00      5.99 f
  u_core/U7361/Y (sky130_fd_sc_hd__nor2_2)         0.01      0.15      0.18      6.17 r
  u_core/U7362/B (sky130_fd_sc_hd__nand2_1)                  0.15      0.00      6.17 r
  u_core/U7362/Y (sky130_fd_sc_hd__nand2_1)        0.01      0.12      0.14      6.31 f
  u_core/U7363/B (sky130_fd_sc_hd__nor2_2)                   0.12      0.00      6.31 f
  u_core/U7363/Y (sky130_fd_sc_hd__nor2_2)         0.02      0.23      0.22      6.54 r
  u_core/U7364/B (sky130_fd_sc_hd__nand2_1)                  0.23      0.00      6.54 r
  u_core/U7364/Y (sky130_fd_sc_hd__nand2_1)        0.02      0.15      0.18      6.72 f
  u_core/U7365/B (sky130_fd_sc_hd__nor2_4)                   0.15      0.00      6.72 f
  u_core/U7365/Y (sky130_fd_sc_hd__nor2_4)         0.02      0.14      0.17      6.89 r
  u_core/U7366/A (sky130_fd_sc_hd__nand2_2)                  0.14      0.00      6.89 r
  u_core/U7366/Y (sky130_fd_sc_hd__nand2_2)        0.03      0.14      0.15      7.04 f
  u_core/U7367/B (sky130_fd_sc_hd__nor2_2)                   0.14      0.00      7.04 f
  u_core/U7367/Y (sky130_fd_sc_hd__nor2_2)         0.01      0.14      0.16      7.20 r
  u_core/U7368/B (sky130_fd_sc_hd__nand2_1)                  0.14      0.00      7.20 r
  u_core/U7368/Y (sky130_fd_sc_hd__nand2_1)        0.02      0.12      0.14      7.34 f
  u_core/U7369/B (sky130_fd_sc_hd__nor2_2)                   0.12      0.00      7.34 f
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
  u_core/U7393/Y (sky130_fd_sc_hd__nor2_2)         0.01      0.16      0.17     11.90 r
  u_core/U7394/B (sky130_fd_sc_hd__nand2_1)                  0.16      0.00     11.90 r
  u_core/U7394/Y (sky130_fd_sc_hd__nand2_1)        0.01      0.11      0.13     12.04 f
  u_core/U7395/B (sky130_fd_sc_hd__nor2_2)                   0.11      0.00     12.04 f
  u_core/U7395/Y (sky130_fd_sc_hd__nor2_2)         0.02      0.19      0.19     12.22 r
  u_core/U7396/B (sky130_fd_sc_hd__nand2_1)                  0.19      0.00     12.22 r
  u_core/U7396/Y (sky130_fd_sc_hd__nand2_1)        0.02      0.13      0.16     12.38 f
  u_core/U7397/B (sky130_fd_sc_hd__nor2_4)                   0.13      0.00     12.38 f
  u_core/U7397/Y (sky130_fd_sc_hd__nor2_4)         0.02      0.15      0.17     12.55 r
  u_core/U7398/A (sky130_fd_sc_hd__nand2_2)                  0.15      0.00     12.55 r
  u_core/U7398/Y (sky130_fd_sc_hd__nand2_2)        0.03      0.13      0.14     12.70 f
  u_core/U7399/B (sky130_fd_sc_hd__nor2_2)                   0.13      0.00     12.70 f
  u_core/U7399/Y (sky130_fd_sc_hd__nor2_2)         0.01      0.13      0.15     12.85 r
  u_core/U7400/B (sky130_fd_sc_hd__nand2_1)                  0.13      0.00     12.85 r
  u_core/U7400/Y (sky130_fd_sc_hd__nand2_1)        0.01      0.11      0.13     12.98 f
  u_core/U7401/B (sky130_fd_sc_hd__nor2_1)                   0.11      0.00     12.98 f
  u_core/U7401/Y (sky130_fd_sc_hd__nor2_1)         0.01      0.22      0.21     13.20 r
  u_core/U7402/B (sky130_fd_sc_hd__nand2_1)                  0.22      0.00     13.20 r
  u_core/U7402/Y (sky130_fd_sc_hd__nand2_1)        0.01      0.13      0.16     13.36 f
  u_core/U7403/B (sky130_fd_sc_hd__nor2_2)                   0.13      0.00     13.36 f
  u_core/U7403/Y (sky130_fd_sc_hd__nor2_2)         0.01      0.14      0.16     13.51 r
  u_core/U7404/B (sky130_fd_sc_hd__nand2_1)                  0.14      0.00     13.51 r
  u_core/U7404/Y (sky130_fd_sc_hd__nand2_1)        0.01      0.09      0.12     13.63 f
  u_core/U7405/B (sky130_fd_sc_hd__nor2_2)                   0.09      0.00     13.63 f
  u_core/U7405/Y (sky130_fd_sc_hd__nor2_2)         0.02      0.23      0.21     13.84 r
  u_core/U7427/B (sky130_fd_sc_hd__nand2_1)                  0.23      0.00     13.84 r
  u_core/U7427/Y (sky130_fd_sc_hd__nand2_1)        0.01      0.10      0.14     13.98 f
  u_core/U7428/B1 (sky130_fd_sc_hd__o21a_1)                  0.10      0.00     13.98 f
  u_core/U7428/X (sky130_fd_sc_hd__o21a_1)         0.01      0.05      0.14     14.12 f
  ctmTdsLR_1_12050/A1 (sky130_fd_sc_hd__a221o_1)             0.05      0.00     14.12 f
  ctmTdsLR_1_12050/X (sky130_fd_sc_hd__a221o_1)    0.01      0.07      0.32     14.44 f
  u_core/U7435/A2_N (sky130_fd_sc_hd__o2bb2ai_1)             0.07      0.00     14.44 f
  u_core/U7435/Y (sky130_fd_sc_hd__o2bb2ai_1)      0.00      0.08      0.14     14.58 f
  u_core/u_csr_mcycle_q_reg_62_/D (sky130_fd_sc_hd__dfxtp_4)
                                                             0.08      0.00     14.58 f
  data arrival time                                                             14.58

  clock clk_i (rise edge)                                             13.33     13.33
  clock network delay (propagated)                                     2.68     16.01
  u_core/u_csr_mcycle_q_reg_62_/CLK (sky130_fd_sc_hd__dfxtp_4)
                                                             0.17      0.00     16.01 r
  clock uncertainty                                                   -0.50     15.51
  library setup time                                                  -0.10     15.41
  data required time                                                            15.41
  --------------------------------------------------------------------------------------------
  data required time                                                            15.41
  data arrival time                                                            -14.58
  --------------------------------------------------------------------------------------------
  slack (MET)                                                                    0.83

  Startpoint: u_core/ex1a_ex1b_reg_q_reg_pc__2_ (rising edge-triggered flip-flop clocked by clk_i)
  Endpoint: u_core/u_csr_minstret_q_reg_47_ (rising edge-triggered flip-flop clocked by clk_i)
  Mode: default
  Corner: default
  Scenario: default
  Path Group: PIPELINE
  Path Type: max

  Point                                            Cap      Trans      Incr      Path  
  --------------------------------------------------------------------------------------------
  clock clk_i (rise edge)                                              0.00      0.00
  clock network delay (propagated)                                     2.92      2.92

  u_core/ex1a_ex1b_reg_q_reg_pc__2_/CLK (sky130_fd_sc_hd__dfxtp_4)
                                                             0.22      0.00      2.92 r
  u_core/ex1a_ex1b_reg_q_reg_pc__2_/Q (sky130_fd_sc_hd__dfxtp_4)
                                                   0.07      0.21      0.52      3.43 r
  u_core/U1510/B (sky130_fd_sc_hd__nand3_1)                  0.21      0.00      3.44 r
  u_core/U1510/Y (sky130_fd_sc_hd__nand3_1)        0.02      0.22      0.24      3.68 f
  u_core/U1663/A (sky130_fd_sc_hd__nor2_1)                   0.22      0.00      3.68 f
  u_core/U1663/Y (sky130_fd_sc_hd__nor2_1)         0.02      0.36      0.36      4.04 r
  u_core/U1664/A (sky130_fd_sc_hd__nand2_1)                  0.36      0.00      4.04 r
  u_core/U1664/Y (sky130_fd_sc_hd__nand2_1)        0.01      0.13      0.16      4.20 f
  u_core/U1666/A (sky130_fd_sc_hd__nor2_1)                   0.13      0.00      4.20 f
  u_core/U1666/Y (sky130_fd_sc_hd__nor2_1)         0.02      0.29      0.28      4.48 r
  u_core/U1667/A (sky130_fd_sc_hd__nand2_1)                  0.29      0.00      4.48 r
  u_core/U1667/Y (sky130_fd_sc_hd__nand2_1)        0.01      0.14      0.17      4.65 f
  u_core/U1669/A (sky130_fd_sc_hd__nor2_1)                   0.14      0.00      4.65 f
  u_core/U1669/Y (sky130_fd_sc_hd__nor2_1)         0.02      0.28      0.28      4.93 r
  u_core/U1670/A (sky130_fd_sc_hd__nand2_1)                  0.28      0.00      4.93 r
  u_core/U1670/Y (sky130_fd_sc_hd__nand2_1)        0.01      0.12      0.16      5.09 f
  u_core/U1672/A (sky130_fd_sc_hd__nor2_1)                   0.12      0.00      5.09 f
  u_core/U1672/Y (sky130_fd_sc_hd__nor2_1)         0.01      0.22      0.23      5.32 r
  u_core/U1673/A (sky130_fd_sc_hd__nand2_1)                  0.22      0.00      5.32 r
  u_core/U1673/Y (sky130_fd_sc_hd__nand2_1)        0.01      0.10      0.13      5.45 f
  u_core/U1675/A (sky130_fd_sc_hd__nor2_1)                   0.10      0.00      5.45 f
  u_core/U1675/Y (sky130_fd_sc_hd__nor2_1)         0.01      0.20      0.21      5.66 r
  u_core/U1676/A (sky130_fd_sc_hd__nand2_1)                  0.20      0.00      5.66 r
  u_core/U1676/Y (sky130_fd_sc_hd__nand2_1)        0.01      0.10      0.13      5.79 f
  u_core/U1678/A (sky130_fd_sc_hd__nor2_1)                   0.10      0.00      5.79 f
  u_core/U1678/Y (sky130_fd_sc_hd__nor2_1)         0.01      0.21      0.22      6.01 r
  u_core/U1679/A (sky130_fd_sc_hd__nand2_1)                  0.21      0.00      6.01 r
  u_core/U1679/Y (sky130_fd_sc_hd__nand2_1)        0.01      0.10      0.13      6.13 f
  u_core/U1681/A (sky130_fd_sc_hd__nor2_1)                   0.10      0.00      6.13 f
  u_core/U1681/Y (sky130_fd_sc_hd__nor2_1)         0.01      0.20      0.21      6.34 r
  u_core/U1682/A (sky130_fd_sc_hd__nand2_1)                  0.20      0.00      6.34 r
  u_core/U1682/Y (sky130_fd_sc_hd__nand2_1)        0.01      0.10      0.13      6.47 f
  u_core/U1684/A (sky130_fd_sc_hd__nor2_1)                   0.10      0.00      6.47 f
  u_core/U1684/Y (sky130_fd_sc_hd__nor2_1)         0.01      0.26      0.25      6.72 r
  u_core/U1685/A (sky130_fd_sc_hd__nand2_1)                  0.26      0.00      6.72 r
  u_core/U1685/Y (sky130_fd_sc_hd__nand2_1)        0.01      0.12      0.15      6.87 f
  u_core/U1958/A (sky130_fd_sc_hd__nor2_1)                   0.12      0.00      6.87 f
  u_core/U1958/Y (sky130_fd_sc_hd__nor2_1)         0.01      0.25      0.25      7.12 r
  u_core/U1959/A (sky130_fd_sc_hd__nand2_1)                  0.25      0.00      7.12 r
  u_core/U1959/Y (sky130_fd_sc_hd__nand2_1)        0.01      0.12      0.15      7.26 f
  u_core/U1961/A (sky130_fd_sc_hd__nor2_1)                   0.12      0.00      7.27 f
  u_core/U1961/Y (sky130_fd_sc_hd__nor2_1)         0.01      0.24      0.24      7.51 r
  u_core/U1962/A (sky130_fd_sc_hd__nand2_1)                  0.24      0.00      7.51 r
  u_core/U1962/Y (sky130_fd_sc_hd__nand2_1)        0.01      0.11      0.14      7.65 f
  u_core/U1964/A (sky130_fd_sc_hd__nor2_1)                   0.11      0.00      7.65 f
  u_core/U1964/Y (sky130_fd_sc_hd__nor2_1)         0.01      0.22      0.22      7.87 r
  u_core/U1965/A (sky130_fd_sc_hd__nand2_1)                  0.22      0.00      7.87 r
  u_core/U1965/Y (sky130_fd_sc_hd__nand2_1)        0.01      0.10      0.13      8.00 f
  u_core/U1967/A (sky130_fd_sc_hd__nor2_1)                   0.10      0.00      8.00 f
  u_core/U1967/Y (sky130_fd_sc_hd__nor2_1)         0.02      0.29      0.27      8.27 r
  u_core/U1968/A (sky130_fd_sc_hd__nand2_1)                  0.29      0.00      8.27 r
  u_core/U1968/Y (sky130_fd_sc_hd__nand2_1)        0.01      0.13      0.17      8.44 f
  u_core/U2097/A (sky130_fd_sc_hd__nor2_1)                   0.13      0.00      8.44 f
  u_core/U2097/Y (sky130_fd_sc_hd__nor2_1)         0.01      0.23      0.24      8.68 r
  u_core/U2098/A (sky130_fd_sc_hd__nand2_1)                  0.23      0.00      8.68 r
  u_core/U2098/Y (sky130_fd_sc_hd__nand2_1)        0.01      0.12      0.15      8.83 f
  u_core/U2099/B (sky130_fd_sc_hd__xnor2_1)                  0.12      0.00      8.83 f
  u_core/U2099/Y (sky130_fd_sc_hd__xnor2_1)        0.01      0.28      0.27      9.10 r
  HFSBUF_63_2136/A (sky130_fd_sc_hd__buf_2)                  0.28      0.00      9.11 r
  HFSBUF_63_2136/X (sky130_fd_sc_hd__buf_2)        0.04      0.19      0.28      9.39 r
  u_core/U2114/A2 (sky130_fd_sc_hd__o221ai_1)                0.19      0.00      9.39 r
  u_core/U2114/Y (sky130_fd_sc_hd__o221ai_1)       0.00      0.14      0.15      9.54 f
  u_core/U2115/B (sky130_fd_sc_hd__nor2_1)                   0.14      0.00      9.54 f
  u_core/U2115/Y (sky130_fd_sc_hd__nor2_1)         0.01      0.17      0.19      9.72 r
  u_core/U2116/A (sky130_fd_sc_hd__nand2_2)                  0.17      0.00      9.72 r
  u_core/U2116/Y (sky130_fd_sc_hd__nand2_2)        0.09      0.36      0.33     10.05 f
  HFSINV_504_2762/A (sky130_fd_sc_hd__inv_2)                 0.36      0.01     10.06 f
  HFSINV_504_2762/Y (sky130_fd_sc_hd__inv_2)       0.03      0.17      0.25     10.31 r
  u_core/U4419/A2_N (sky130_fd_sc_hd__a2bb2o_4)              0.17      0.00     10.31 r
  u_core/U4419/X (sky130_fd_sc_hd__a2bb2o_4)       0.09      0.14      0.34     10.65 f
  HFSINV_684_4794/A (sky130_fd_sc_hd__inv_2)                 0.15      0.01     10.65 f
  HFSINV_684_4794/Y (sky130_fd_sc_hd__inv_2)       0.07      0.32      0.29     10.94 r
  u_core/U4381/D (sky130_fd_sc_hd__nand4_1)                  0.32      0.00     10.95 r
  u_core/U4381/Y (sky130_fd_sc_hd__nand4_1)        0.00      0.12      0.15     11.09 f
  u_core/U4426/A (sky130_fd_sc_hd__or4_1)                    0.12      0.00     11.09 f
  u_core/U4426/X (sky130_fd_sc_hd__or4_1)          0.01      0.11      0.57     11.67 f
  ctmTdsLR_1_13657/A2 (sky130_fd_sc_hd__o21ai_1)             0.11      0.00     11.67 f
  ctmTdsLR_1_13657/Y (sky130_fd_sc_hd__o21ai_1)    0.02      0.44      0.39     12.05 r
  u_core/U4428/B1 (sky130_fd_sc_hd__o21ai_1)                 0.44      0.00     12.05 r
  u_core/U4428/Y (sky130_fd_sc_hd__o21ai_1)        0.01      0.15      0.19     12.24 f
  HFSINV_10142_6073/A (sky130_fd_sc_hd__clkinv_2)            0.15      0.00     12.24 f
  HFSINV_10142_6073/Y (sky130_fd_sc_hd__clkinv_2)
                                                   0.11      0.38      0.33     12.57 r
  HFSINV_7488_6071/A (sky130_fd_sc_hd__inv_4)                0.37      0.01     12.58 r
  HFSINV_7488_6071/Y (sky130_fd_sc_hd__inv_4)      0.13      0.20      0.24     12.82 f
  u_core/U4634/B_N (sky130_fd_sc_hd__or2b_2)                 0.21      0.00     12.82 f
  u_core/U4634/X (sky130_fd_sc_hd__or2b_2)         0.06      0.32      0.42     13.25 r
  HFSINV_544_4811/A (sky130_fd_sc_hd__inv_6)                 0.32      0.00     13.25 r
  HFSINV_544_4811/Y (sky130_fd_sc_hd__inv_6)       0.07      0.12      0.13     13.39 f
  u_core/U4635/A_N (sky130_fd_sc_hd__nand2b_1)               0.12      0.00     13.39 f
  u_core/U4635/Y (sky130_fd_sc_hd__nand2b_1)       0.03      0.25      0.33     13.72 f
  HFSINV_1306_4578/A (sky130_fd_sc_hd__clkinv_2)             0.25      0.00     13.72 f
  HFSINV_1306_4578/Y (sky130_fd_sc_hd__clkinv_2)   0.10      0.38      0.36     14.08 r
  u_core/U4894/A2 (sky130_fd_sc_hd__a22oi_1)                 0.38      0.02     14.11 r
  u_core/U4894/Y (sky130_fd_sc_hd__a22oi_1)        0.01      0.11      0.18     14.28 f
  u_core/U4896/A2 (sky130_fd_sc_hd__a32oi_1)                 0.11      0.00     14.28 f
  u_core/U4896/Y (sky130_fd_sc_hd__a32oi_1)        0.00      0.16      0.22     14.50 r
  u_core/U4897/B (sky130_fd_sc_hd__nand2_1)                  0.16      0.00     14.50 r
  u_core/U4897/Y (sky130_fd_sc_hd__nand2_1)        0.00      0.09      0.07     14.57 f
  u_core/U4898/B1 (sky130_fd_sc_hd__o21ai_1)                 0.09      0.00     14.57 f
  u_core/U4898/Y (sky130_fd_sc_hd__o21ai_1)        0.00      0.12      0.09     14.66 r
  u_core/u_csr_minstret_q_reg_47_/D (sky130_fd_sc_hd__dfxtp_4)
                                                             0.12      0.00     14.66 r
  data arrival time                                                             14.66

  clock clk_i (rise edge)                                             13.33     13.33
  clock network delay (propagated)                                     2.75     16.08
  u_core/u_csr_minstret_q_reg_47_/CLK (sky130_fd_sc_hd__dfxtp_4)
                                                             0.13      0.00     16.08 r
  clock uncertainty                                                   -0.50     15.58
  library setup time                                                  -0.06     15.52
  data required time                                                            15.52
  --------------------------------------------------------------------------------------------
  data required time                                                            15.52
  data arrival time                                                            -14.66
  --------------------------------------------------------------------------------------------
  slack (MET)                                                                    0.85

1
