chuanseng-ng/claude_verilog_test/pnr/commercial/impl/innovus/reports/final_timing_setup.txt

###############################################################
#  Generated by:      Cadence Innovus 23.14-s088_1
#  OS:                Linux x86_64(Host ID eda.ic)
#  Generated on:      Mon Oct 26 21:07:02 2026
#  Design:            rv32i_cpu_top
#  Command:           report_timing -max_paths 20 -nworst 1 -path_type full_clock > $R/final_timing_setup.txt 
###############################################################
Path 1: MET Setup Check with Pin u_core/u_dcache_gen_data_sram[3].u_data_sram/
clk0 
Endpoint:   u_core/u_dcache_gen_data_sram[3].u_data_sram/din0[8] (^) checked 
with  leading edge of 'clk_i'
Beginpoint: axi_rdata_i[8]                                       (^) triggered 
by  leading edge of 'clk_i'
Path Groups: {clk_i}
Analysis View: av_tt
Other End Arrival Time          4.131
- Setup                         0.103
+ Phase Shift                  13.333
+ CPPR Adjustment               0.000
- Uncertainty                   0.500
= Required Time                16.861
- Arrival Time                 16.853
= Slack Time                    0.008
     Clock Rise Edge                      0.000
     + Input Delay                        2.000
     + Drive Adjustment                   1.085
     + Source Insertion Delay             1.000
     = Beginpoint Arrival Time            4.085
     Timing Path:
     +----------------------------------------------------------------------------------------------------------------------------------------+ 
     |                      Instance                      |       Arc        |               Cell                | Delay | Arrival | Required | 
     |                                                    |                  |                                   |       |  Time   |   Time   | 
     |----------------------------------------------------+------------------+-----------------------------------+-------+---------+----------| 
     |                                                    | axi_rdata_i[8] ^ |                                   |       |   4.085 |    4.093 | 
     | u_core/FE_OFC783_axi_rdata_i_8                     | A ^ -> X ^       | sky130_fd_sc_hd__buf_8            | 8.809 |  12.894 |   12.902 | 
     | u_core/FE_OFC10115_axi_rdata_i_8                   | A ^ -> Y v       | sky130_fd_sc_hd__inv_12           | 0.156 |  13.049 |   13.057 | 
     | u_core/FE_OFC10116_axi_rdata_i_8                   | A v -> Y ^       | sky130_fd_sc_hd__clkinv_8         | 0.222 |  13.271 |   13.279 | 
     | u_core/FE_PDC9_FE_OFN605_axi_rdata_i_8             | A ^ -> Y v       | sky130_fd_sc_hd__inv_12           | 0.199 |  13.470 |   13.479 | 
     | u_core/FE_PDC8_FE_OFN605_axi_rdata_i_8             | A v -> Y ^       | sky130_fd_sc_hd__clkinv_16        | 0.366 |  13.837 |   13.845 | 
     | u_core/FE_OFC413_axi_rdata_i_8                     | A ^ -> X ^       | sky130_fd_sc_hd__buf_12           | 0.448 |  14.285 |   14.293 | 
     | u_core/g372619                                     | A1 ^ -> X ^      | sky130_fd_sc_hd__mux2_2           | 0.533 |  14.818 |   14.826 | 
     | u_core/FE_OFC8981_u_dcache_refill_buf_q_axi_word_q | A ^ -> X ^       | sky130_fd_sc_hd__buf_8            | 0.317 |  15.135 |   15.143 | 
     | __8                                                |                  |                                   |       |         |          | 
     | u_core/g372217                                     | A1_N ^ -> Y ^    | sky130_fd_sc_hd__o2bb2ai_1        | 0.217 |  15.352 |   15.360 | 
     | u_core/FE_OFC5952_n_13177                          | A ^ -> X ^       | sky130_fd_sc_hd__buf_6            | 0.290 |  15.641 |   15.649 | 
     | u_core/g371788                                     | A1 ^ -> X ^      | sky130_fd_sc_hd__a21o_2           | 0.643 |  16.284 |   16.292 | 
     | u_core/FE_OFC4000_u_dcache_gen_data_sram_3__d_din0 | A ^ -> X ^       | sky130_fd_sc_hd__buf_12           | 0.476 |  16.760 |   16.769 | 
     | _m_8                                               |                  |                                   |       |         |          | 
     | u_core/u_dcache_gen_data_sram[3].u_data_sram       | din0[8] ^        | sky130_sram_1kbyte_1rw1r_32x256_8 | 0.093 |  16.853 |   16.861 | 
     +----------------------------------------------------------------------------------------------------------------------------------------+ 
     Clock Rise Edge                      0.000
     + Drive Adjustment                   0.113
     + Source Insertion Delay             1.000
     = Beginpoint Arrival Time            1.113
     Other End Path:
     +----------------------------------------------------------------------------------------------------------------------------+ 
     |                   Instance                   |    Arc     |               Cell                | Delay | Arrival | Required | 
     |                                              |            |                                   |       |  Time   |   Time   | 
     |----------------------------------------------+------------+-----------------------------------+-------+---------+----------| 
     |                                              | clk_i ^    |                                   |       |   1.113 |    1.105 | 
     | CTS_cpc_drv_buf_00277                        | A ^ -> X ^ | sky130_fd_sc_hd__clkbuf_16        | 0.227 |   1.340 |    1.332 | 
     | CTS_cpc_drv_buf_00271                        | A ^ -> X ^ | sky130_fd_sc_hd__clkbuf_16        | 0.446 |   1.786 |    1.778 | 
     | CTS_cpc_drv_buf_00263                        | A ^ -> X ^ | sky130_fd_sc_hd__clkbuf_16        | 0.427 |   2.213 |    2.205 | 
     | CTS_ccl_buf_00251                            | A ^ -> X ^ | sky130_fd_sc_hd__clkbuf_16        | 0.363 |   2.576 |    2.568 | 
     | CTS_ccl_a_buf_00250                          | A ^ -> X ^ | sky130_fd_sc_hd__clkbuf_16        | 0.329 |   2.905 |    2.897 | 
     | CTS_ccl_buf_00246                            | A ^ -> X ^ | sky130_fd_sc_hd__clkbuf_16        | 0.315 |   3.221 |    3.212 | 
     | CTS_ccl_buf_00244                            | A ^ -> X ^ | sky130_fd_sc_hd__clkbuf_16        | 0.346 |   3.566 |    3.558 | 
     | u_core/CTS_ccl_a_buf_00239                   | A ^ -> X ^ | sky130_fd_sc_hd__clkbuf_16        | 0.290 |   3.857 |    3.848 | 
     | u_core/CTS_ccl_a_buf_00202                   | A ^ -> X ^ | sky130_fd_sc_hd__clkbuf_16        | 0.272 |   4.128 |    4.120 | 
     | u_core/u_dcache_gen_data_sram[3].u_data_sram | clk0 ^     | sky130_sram_1kbyte_1rw1r_32x256_8 | 0.003 |   4.131 |    4.123 | 
     +----------------------------------------------------------------------------------------------------------------------------+ 
Path 2: MET Setup Check with Pin u_core/u_dcache_gen_data_sram[0].u_data_sram/
clk0 
Endpoint:   u_core/u_dcache_gen_data_sram[0].u_data_sram/din0[8] (^) checked 
with  leading edge of 'clk_i'
Beginpoint: axi_rdata_i[8]                                       (^) triggered 
by  leading edge of 'clk_i'
Path Groups: {clk_i}
Analysis View: av_tt
Other End Arrival Time          4.043
- Setup                         0.103
+ Phase Shift                  13.333
+ CPPR Adjustment               0.000
- Uncertainty                   0.500
= Required Time                16.773
- Arrival Time                 16.685
= Slack Time                    0.088
     Clock Rise Edge                      0.000
     + Input Delay                        2.000
     + Drive Adjustment                   1.085
     + Source Insertion Delay             1.000
     = Beginpoint Arrival Time            4.085
     Timing Path:
     +----------------------------------------------------------------------------------------------------------------------------------------+ 
     |                      Instance                      |       Arc        |               Cell                | Delay | Arrival | Required | 
     |                                                    |                  |                                   |       |  Time   |   Time   | 
     |----------------------------------------------------+------------------+-----------------------------------+-------+---------+----------| 
     |                                                    | axi_rdata_i[8] ^ |                                   |       |   4.085 |    4.173 | 
     | u_core/FE_OFC783_axi_rdata_i_8                     | A ^ -> X ^       | sky130_fd_sc_hd__buf_8            | 8.809 |  12.893 |   12.981 | 
     | u_core/FE_OFC10115_axi_rdata_i_8                   | A ^ -> Y v       | sky130_fd_sc_hd__inv_12           | 0.156 |  13.049 |   13.137 | 
     | u_core/FE_OFC10116_axi_rdata_i_8                   | A v -> Y ^       | sky130_fd_sc_hd__clkinv_8         | 0.222 |  13.271 |   13.359 | 
     | u_core/FE_PDC9_FE_OFN605_axi_rdata_i_8             | A ^ -> Y v       | sky130_fd_sc_hd__inv_12           | 0.199 |  13.470 |   13.558 | 
     | u_core/FE_PDC8_FE_OFN605_axi_rdata_i_8             | A v -> Y ^       | sky130_fd_sc_hd__clkinv_16        | 0.366 |  13.837 |   13.924 | 
     | u_core/FE_OFC413_axi_rdata_i_8                     | A ^ -> X ^       | sky130_fd_sc_hd__buf_12           | 0.448 |  14.285 |   14.372 | 
     | u_core/g372619                                     | A1 ^ -> X ^      | sky130_fd_sc_hd__mux2_2           | 0.533 |  14.818 |   14.906 | 
     | u_core/FE_OFC8981_u_dcache_refill_buf_q_axi_word_q | A ^ -> X ^       | sky130_fd_sc_hd__buf_8            | 0.317 |  15.135 |   15.223 | 
     | __8                                                |                  |                                   |       |         |          | 
     | u_core/g372249                                     | A1_N ^ -> Y ^    | sky130_fd_sc_hd__o2bb2ai_1        | 0.317 |  15.452 |   15.539 | 
     | u_core/FE_OFC4155_n_13145                          | A ^ -> X ^       | sky130_fd_sc_hd__buf_12           | 0.411 |  15.863 |   15.951 | 
     | u_core/g371820                                     | A1 ^ -> X ^      | sky130_fd_sc_hd__a21o_1           | 0.380 |  16.244 |   16.331 | 
     | u_core/FE_OFC4338_u_dcache_gen_data_sram_0__d_din0 | A ^ -> X ^       | sky130_fd_sc_hd__buf_12           | 0.394 |  16.638 |   16.725 | 
     | _m_8                                               |                  |                                   |       |         |          | 
     | u_core/u_dcache_gen_data_sram[0].u_data_sram       | din0[8] ^        | sky130_sram_1kbyte_1rw1r_32x256_8 | 0.048 |  16.685 |   16.773 | 
     +----------------------------------------------------------------------------------------------------------------------------------------+ 
     Clock Rise Edge                      0.000
     + Drive Adjustment                   0.113
     + Source Insertion Delay             1.000
     = Beginpoint Arrival Time            1.113
     Other End Path:
     +----------------------------------------------------------------------------------------------------------------------------+ 
     |                   Instance                   |    Arc     |               Cell                | Delay | Arrival | Required | 
     |                                              |            |                                   |       |  Time   |   Time   | 
     |----------------------------------------------+------------+-----------------------------------+-------+---------+----------| 
     |                                              | clk_i ^    |                                   |       |   1.113 |    1.025 | 
     | CTS_cpc_drv_buf_00277                        | A ^ -> X ^ | sky130_fd_sc_hd__clkbuf_16        | 0.227 |   1.340 |    1.252 | 
     | CTS_cpc_drv_buf_00271                        | A ^ -> X ^ | sky130_fd_sc_hd__clkbuf_16        | 0.446 |   1.786 |    1.698 | 
     | CTS_cpc_drv_buf_00263                        | A ^ -> X ^ | sky130_fd_sc_hd__clkbuf_16        | 0.427 |   2.213 |    2.126 | 
     | CTS_ccl_buf_00251                            | A ^ -> X ^ | sky130_fd_sc_hd__clkbuf_16        | 0.363 |   2.576 |    2.488 | 
     | CTS_ccl_a_buf_00250                          | A ^ -> X ^ | sky130_fd_sc_hd__clkbuf_16        | 0.329 |   2.905 |    2.817 | 
     | CTS_ccl_a_buf_00248                          | A ^ -> X ^ | sky130_fd_sc_hd__clkbuf_8         | 0.291 |   3.196 |    3.108 | 
     | CTS_ccl_buf_00245                            | A ^ -> X ^ | sky130_fd_sc_hd__clkbuf_16        | 0.293 |   3.489 |    3.401 | 
     | CTS_ccl_a_buf_00240                          | A ^ -> X ^ | sky130_fd_sc_hd__clkbuf_16        | 0.318 |   3.807 |    3.719 | 
     | CTS_ccl_a_buf_00011                          | A ^ -> X ^ | sky130_fd_sc_hd__clkbuf_16        | 0.233 |   4.039 |    3.951 | 
     | u_core/u_dcache_gen_data_sram[0].u_data_sram | clk0 ^     | sky130_sram_1kbyte_1rw1r_32x256_8 | 0.004 |   4.043 |    3.955 | 
     +----------------------------------------------------------------------------------------------------------------------------+ 
Path 3: MET Setup Check with Pin apb_prdata_o_reg[0]/CLK 
Endpoint:   apb_prdata_o_reg[0]/D (^) checked with  leading edge of 'clk_i'
Beginpoint: apb_paddr_i[7]        (^) triggered by  leading edge of 'clk_i'
Path Groups: {clk_i}
Analysis View: av_tt
Other End Arrival Time          4.030
- Setup                         0.045
+ Phase Shift                  13.333
+ CPPR Adjustment               0.000
- Uncertainty                   0.500
= Required Time                16.819
- Arrival Time                 16.702
= Slack Time                    0.116
     Clock Rise Edge                      0.000
     + Input Delay                        3.500
     + Drive Adjustment                   0.481
     + Source Insertion Delay             1.000
     = Beginpoint Arrival Time            4.981
     Timing Path:
     +------------------------------------------------------------------------------------------------------------------------------+ 
     |                    Instance                     |       Arc        |            Cell            | Delay | Arrival | Required | 
     |                                                 |                  |                            |       |  Time   |   Time   | 
     |-------------------------------------------------+------------------+----------------------------+-------+---------+----------| 
     |                                                 | apb_paddr_i[7] ^ |                            |       |   4.981 |    5.097 | 
     | FE_OFC3009_apb_paddr_i_7                        | A ^ -> X ^       | sky130_fd_sc_hd__buf_2     | 3.734 |   8.715 |    8.831 | 
     | FE_OFC517_apb_paddr_i_7                         | A ^ -> X ^       | sky130_fd_sc_hd__buf_2     | 0.327 |   9.041 |    9.158 | 
     | FE_OFC2436_apb_paddr_i_7                        | A ^ -> Y v       | sky130_fd_sc_hd__clkinv_16 | 0.174 |   9.216 |    9.332 | 
     | FE_OFC2280_apb_paddr_i_7                        | A v -> Y ^       | sky130_fd_sc_hd__clkinv_16 | 0.529 |   9.744 |    9.860 | 
     | g24104                                          | B ^ -> X ^       | sky130_fd_sc_hd__or2_2     | 0.266 |  10.010 |   10.126 | 
     | g24101                                          | A_N ^ -> Y ^     | sky130_fd_sc_hd__nand2b_1  | 0.219 |  10.229 |   10.345 | 
     | g24099                                          | A ^ -> Y v       | sky130_fd_sc_hd__nand3_1   | 0.098 |  10.327 |   10.443 | 
     | g24098                                          | C v -> X v       | sky130_fd_sc_hd__or4b_1    | 0.554 |  10.881 |   10.997 | 
     | g24097                                          | C v -> Y ^       | sky130_fd_sc_hd__nor3_1    | 0.182 |  11.063 |   11.179 | 
     | FE_OFC1394_n_1435                               | A ^ -> X ^       | sky130_fd_sc_hd__buf_4     | 0.398 |  11.461 |   11.577 | 
     | g2                                              | B_N ^ -> Y ^     | sky130_fd_sc_hd__nor2b_1   | 0.433 |  11.894 |   12.010 | 
     | u_core/g522                                     | B_N ^ -> Y ^     | sky130_fd_sc_hd__nor2b_1   | 0.242 |  12.136 |   12.252 | 
     | u_core/g519                                     | B_N ^ -> Y ^     | sky130_fd_sc_hd__nor2b_1   | 0.157 |  12.293 |   12.409 | 
     | u_core/FE_OFC4198_n_15133                       | A ^ -> X ^       | sky130_fd_sc_hd__buf_2     | 0.313 |  12.606 |   12.722 | 
     | u_core/g490                                     | B ^ -> X ^       | sky130_fd_sc_hd__and2b_2   | 0.424 |  13.030 |   13.146 | 
     | u_core/FE_OFC1781_u_regfile_n_5906              | A ^ -> X ^       | sky130_fd_sc_hd__buf_6     | 0.422 |  13.452 |   13.568 | 
     | u_core/FE_OFC1782_u_regfile_n_5906              | A ^ -> X ^       | sky130_fd_sc_hd__buf_6     | 0.476 |  13.928 |   14.044 | 
     | u_core/g3582                                    | B1 ^ -> Y v      | sky130_fd_sc_hd__a221oi_1  | 0.210 |  14.138 |   14.254 | 
     | u_core/FE_OFC4611_n_16191                       | A v -> X v       | sky130_fd_sc_hd__clkbuf_1  | 0.166 |  14.304 |   14.420 | 
     | u_core/g3444                                    | B v -> Y ^       | sky130_fd_sc_hd__nand4_1   | 0.288 |  14.592 |   14.708 | 
     | u_core/g3412                                    | D ^ -> X ^       | sky130_fd_sc_hd__or4_1     | 0.429 |  15.021 |   15.137 | 
     | u_core/FE_OFC4667_u_regfile_regs_dbg_rd_addr__0 | A ^ -> X ^       | sky130_fd_sc_hd__buf_6     | 0.446 |  15.467 |   15.584 | 
     | u_core/g373144                                  | B_N ^ -> Y ^     | sky130_fd_sc_hd__nor2b_1   | 0.332 |  15.799 |   15.915 | 
     | FE_OFC1704_dbg_reg_rd_data_0                    | A ^ -> X ^       | sky130_fd_sc_hd__buf_2     | 0.459 |  16.258 |   16.374 | 
     | g45574                                          | A ^ -> Y v       | sky130_fd_sc_hd__nand2_2   | 0.296 |  16.555 |   16.671 | 
     | g44848                                          | A v -> Y ^       | sky130_fd_sc_hd__nand4_1   | 0.148 |  16.702 |   16.818 | 
     | apb_prdata_o_reg[0]                             | D ^              | sky130_fd_sc_hd__dfxtp_1   | 0.000 |  16.702 |   16.819 | 
     +------------------------------------------------------------------------------------------------------------------------------+ 
     Clock Rise Edge                      0.000
     + Drive Adjustment                   0.113
     + Source Insertion Delay             1.000
     = Beginpoint Arrival Time            1.113
     Other End Path:
     +----------------------------------------------------------------------------------------------+ 
     |       Instance        |    Arc     |            Cell            | Delay | Arrival | Required | 
     |                       |            |                            |       |  Time   |   Time   | 
     |-----------------------+------------+----------------------------+-------+---------+----------| 
     |                       | clk_i ^    |                            |       |   1.113 |    0.997 | 
     | CTS_cpc_drv_buf_00277 | A ^ -> X ^ | sky130_fd_sc_hd__clkbuf_16 | 0.227 |   1.340 |    1.224 | 
     | CTS_cpc_drv_buf_00271 | A ^ -> X ^ | sky130_fd_sc_hd__clkbuf_16 | 0.446 |   1.786 |    1.670 | 
     | CTS_cpc_drv_buf_00263 | A ^ -> X ^ | sky130_fd_sc_hd__clkbuf_16 | 0.427 |   2.213 |    2.097 | 
     | CTS_ccl_buf_00251     | A ^ -> X ^ | sky130_fd_sc_hd__clkbuf_16 | 0.363 |   2.576 |    2.460 | 
     | CTS_ccl_a_buf_00250   | A ^ -> X ^ | sky130_fd_sc_hd__clkbuf_16 | 0.329 |   2.905 |    2.789 | 
     | CTS_ccl_a_buf_00248   | A ^ -> X ^ | sky130_fd_sc_hd__clkbuf_8  | 0.291 |   3.196 |    3.080 | 
     | CTS_ccl_buf_00245     | A ^ -> X ^ | sky130_fd_sc_hd__clkbuf_16 | 0.293 |   3.489 |    3.373 | 
     | CTS_ccl_a_buf_00220   | A ^ -> X ^ | sky130_fd_sc_hd__clkbuf_8  | 0.273 |   3.761 |    3.645 | 
     | CTS_ccl_a_buf_00058   | A ^ -> X ^ | sky130_fd_sc_hd__clkbuf_8  | 0.268 |   4.029 |    3.913 | 
     | apb_prdata_o_reg[0]   | CLK ^      | sky130_fd_sc_hd__dfxtp_1   | 0.002 |   4.030 |    3.914 | 
     +----------------------------------------------------------------------------------------------+ 
Path 4: MET Setup Check with Pin apb_prdata_o_reg[10]/CLK 
Endpoint:   apb_prdata_o_reg[10]/D (v) checked with  leading edge of 'clk_i'
Beginpoint: apb_paddr_i[7]         (^) triggered by  leading edge of 'clk_i'
Path Groups: {clk_i}
Analysis View: av_tt
Other End Arrival Time          4.030
- Setup                         0.119
+ Phase Shift                  13.333
+ CPPR Adjustment               0.000
- Uncertainty                   0.500
= Required Time                16.744
- Arrival Time                 16.438
= Slack Time                    0.306
     Clock Rise Edge                      0.000
     + Input Delay                        3.500
     + Drive Adjustment                   0.481
     + Source Insertion Delay             1.000
     = Beginpoint Arrival Time            4.981
     Timing Path:
     +-------------------------------------------------------------------------------------------------------------------------------+ 
     |                     Instance                     |       Arc        |            Cell            | Delay | Arrival | Required | 
     |                                                  |                  |                            |       |  Time   |   Time   | 
     |--------------------------------------------------+------------------+----------------------------+-------+---------+----------| 
     |                                                  | apb_paddr_i[7] ^ |                            |       |   4.981 |    5.286 | 
     | FE_OFC3009_apb_paddr_i_7                         | A ^ -> X ^       | sky130_fd_sc_hd__buf_2     | 3.734 |   8.715 |    9.020 | 
     | FE_OFC517_apb_paddr_i_7                          | A ^ -> X ^       | sky130_fd_sc_hd__buf_2     | 0.327 |   9.041 |    9.347 | 
     | FE_OFC2436_apb_paddr_i_7                         | A ^ -> Y v       | sky130_fd_sc_hd__clkinv_16 | 0.174 |   9.216 |    9.521 | 
     | FE_OFC2280_apb_paddr_i_7                         | A v -> Y ^       | sky130_fd_sc_hd__clkinv_16 | 0.529 |   9.744 |   10.050 | 
     | g24104                                           | B ^ -> X ^       | sky130_fd_sc_hd__or2_2     | 0.266 |  10.010 |   10.316 | 
     | g24101                                           | A_N ^ -> Y ^     | sky130_fd_sc_hd__nand2b_1  | 0.219 |  10.229 |   10.535 | 
     | g24099                                           | A ^ -> Y v       | sky130_fd_sc_hd__nand3_1   | 0.098 |  10.327 |   10.633 | 
     | g24098                                           | C v -> X v       | sky130_fd_sc_hd__or4b_1    | 0.554 |  10.881 |   11.187 | 
     | g24097                                           | C v -> Y ^       | sky130_fd_sc_hd__nor3_1    | 0.182 |  11.063 |   11.369 | 
     | FE_OFC1394_n_1435                                | A ^ -> X ^       | sky130_fd_sc_hd__buf_4     | 0.398 |  11.461 |   11.767 | 
     | g24095                                           | A ^ -> X ^       | sky130_fd_sc_hd__and2_1    | 0.463 |  11.924 |   12.230 | 
     | u_core/g524                                      | A_N ^ -> X v     | sky130_fd_sc_hd__and2b_2   | 0.412 |  12.336 |   12.642 | 
     | u_core/g510                                      | B v -> X v       | sky130_fd_sc_hd__and2_2    | 0.382 |  12.717 |   13.023 | 
     | u_core/FE_OFC1798_u_regfile_n_5911               | A v -> X v       | sky130_fd_sc_hd__buf_6     | 0.262 |  12.980 |   13.285 | 
     | u_core/FE_OFC1799_u_regfile_n_5911               | A v -> X v       | sky130_fd_sc_hd__buf_4     | 0.295 |  13.275 |   13.581 | 
     | u_core/g3954                                     | A1 v -> X v      | sky130_fd_sc_hd__a22o_1    | 0.252 |  13.528 |   13.833 | 
     | u_core/g3640                                     | C1 v -> Y ^      | sky130_fd_sc_hd__a221oi_1  | 0.411 |  13.938 |   14.244 | 
     | u_core/g3442                                     | A ^ -> Y v       | sky130_fd_sc_hd__nand4_1   | 0.369 |  14.308 |   14.613 | 
     | u_core/g3410                                     | D v -> X v       | sky130_fd_sc_hd__or4_1     | 0.721 |  15.029 |   15.334 | 
     | u_core/FE_OFC1710_u_regfile_regs_dbg_rd_addr__10 | A v -> X v       | sky130_fd_sc_hd__buf_4     | 0.379 |  15.408 |   15.714 | 
     | u_core/g373132                                   | B_N v -> Y v     | sky130_fd_sc_hd__nor2b_2   | 0.270 |  15.678 |   15.984 | 
     | g45582                                           | A v -> Y ^       | sky130_fd_sc_hd__nand2_1   | 0.605 |  16.283 |   16.588 | 
     | g44815                                           | A ^ -> Y v       | sky130_fd_sc_hd__nand4_1   | 0.155 |  16.438 |   16.743 | 
     | apb_prdata_o_reg[10]                             | D v              | sky130_fd_sc_hd__dfxtp_1   | 0.000 |  16.438 |   16.744 | 
     +-------------------------------------------------------------------------------------------------------------------------------+ 
     Clock Rise Edge                      0.000
     + Drive Adjustment                   0.113
     + Source Insertion Delay             1.000
     = Beginpoint Arrival Time            1.113
     Other End Path:
     +----------------------------------------------------------------------------------------------+ 
     |       Instance        |    Arc     |            Cell            | Delay | Arrival | Required | 
     |                       |            |                            |       |  Time   |   Time   | 
     |-----------------------+------------+----------------------------+-------+---------+----------| 
     |                       | clk_i ^    |                            |       |   1.113 |    0.807 | 
     | CTS_cpc_drv_buf_00277 | A ^ -> X ^ | sky130_fd_sc_hd__clkbuf_16 | 0.227 |   1.340 |    1.034 | 
     | CTS_cpc_drv_buf_00271 | A ^ -> X ^ | sky130_fd_sc_hd__clkbuf_16 | 0.446 |   1.786 |    1.480 | 
     | CTS_cpc_drv_buf_00263 | A ^ -> X ^ | sky130_fd_sc_hd__clkbuf_16 | 0.427 |   2.213 |    1.908 | 
     | CTS_ccl_buf_00251     | A ^ -> X ^ | sky130_fd_sc_hd__clkbuf_16 | 0.363 |   2.576 |    2.270 | 
     | CTS_ccl_a_buf_00250   | A ^ -> X ^ | sky130_fd_sc_hd__clkbuf_16 | 0.329 |   2.905 |    2.600 | 
     | CTS_ccl_a_buf_00248   | A ^ -> X ^ | sky130_fd_sc_hd__clkbuf_8  | 0.291 |   3.196 |    2.890 | 
     | CTS_ccl_buf_00245     | A ^ -> X ^ | sky130_fd_sc_hd__clkbuf_16 | 0.293 |   3.489 |    3.183 | 
     | CTS_ccl_a_buf_00220   | A ^ -> X ^ | sky130_fd_sc_hd__clkbuf_8  | 0.273 |   3.761 |    3.456 | 
     | CTS_ccl_a_buf_00057   | A ^ -> X ^ | sky130_fd_sc_hd__clkbuf_8  | 0.263 |   4.024 |    3.719 | 
     | apb_prdata_o_reg[10]  | CLK ^      | sky130_fd_sc_hd__dfxtp_1   | 0.005 |   4.030 |    3.724 | 
     +----------------------------------------------------------------------------------------------+ 
Path 5: MET Late External Delay Assertion 
Endpoint:   axi_wdata_o[6]                      (^) checked with  leading edge 
of 'clk_i'
Beginpoint: u_core/u_dcache_axi_word_q_reg[0]/Q (^) triggered by  leading edge 
of 'clk_i'
Path Groups: {clk_i}
Analysis View: av_tt
Other End Arrival Time          0.000
+ Source Insertion Delay        1.000
- External Delay                2.000
+ Phase Shift                  13.333
+ CPPR Adjustment               0.000
- Uncertainty                   0.500
= Required Time                11.833
- Arrival Time                 11.519
= Slack Time                    0.314
     Clock Rise Edge                      0.000
     + Drive Adjustment                   0.113
     + Source Insertion Delay            -1.882
     = Beginpoint Arrival Time           -1.769
     +------------------------------------------------------------------------------------------------------------------+ 
     |              Instance               |       Arc        |            Cell            | Delay | Arrival | Required | 
     |                                     |                  |                            |       |  Time   |   Time   | 
     |-------------------------------------+------------------+----------------------------+-------+---------+----------| 
     |                                     | clk_i ^          |                            |       |  -1.769 |   -1.456 | 
     | CTS_cpc_drv_buf_00277               | A ^ -> X ^       | sky130_fd_sc_hd__clkbuf_16 | 0.250 |  -1.520 |   -1.206 | 
     | CTS_cpc_drv_buf_00271               | A ^ -> X ^       | sky130_fd_sc_hd__clkbuf_16 | 0.520 |  -0.999 |   -0.686 | 
     | CTS_cpc_drv_buf_00263               | A ^ -> X ^       | sky130_fd_sc_hd__clkbuf_16 | 0.452 |  -0.547 |   -0.234 | 
     | CTS_ccl_buf_00251                   | A ^ -> X ^       | sky130_fd_sc_hd__clkbuf_16 | 0.392 |  -0.155 |    0.158 | 
     | CTS_ccl_a_buf_00250                 | A ^ -> X ^       | sky130_fd_sc_hd__clkbuf_16 | 0.353 |   0.198 |    0.512 | 
     | CTS_ccl_buf_00246                   | A ^ -> X ^       | sky130_fd_sc_hd__clkbuf_16 | 0.317 |   0.515 |    0.829 | 
     | u_core/CTS_ccl_buf_00242            | A ^ -> X ^       | sky130_fd_sc_hd__clkbuf_16 | 0.346 |   0.861 |    1.175 | 
     | u_core/CTS_ccl_a_buf_00231          | A ^ -> X ^       | sky130_fd_sc_hd__clkbuf_8  | 0.322 |   1.184 |    1.497 | 
     | u_core/CTS_ccl_a_buf_00092          | A ^ -> X ^       | sky130_fd_sc_hd__clkbuf_8  | 0.297 |   1.481 |    1.795 | 
     | u_core/u_dcache_axi_word_q_reg[0]   | CLK ^ -> Q ^     | sky130_fd_sc_hd__dfxtp_4   | 0.528 |   2.009 |    2.323 | 
     | u_core/g374679                      | B ^ -> Y v       | sky130_fd_sc_hd__nand2_1   | 0.335 |   2.344 |    2.658 | 
     | u_core/g374000                      | A_N v -> X ^     | sky130_fd_sc_hd__and2b_4   | 0.583 |   2.928 |    3.241 | 
     | u_core/FE_OFC2109_n_11971           | A ^ -> X ^       | sky130_fd_sc_hd__buf_12    | 0.439 |   3.367 |    3.680 | 
     | u_core/g372743                      | C1 ^ -> Y v      | sky130_fd_sc_hd__a222oi_1  | 0.153 |   3.520 |    3.834 | 
     | u_core/FE_OFC349_n_12763            | A v -> X v       | sky130_fd_sc_hd__clkbuf_1  | 0.156 |   3.676 |    3.990 | 
     | u_core/FE_OFC8615_n_12763           | A v -> Y ^       | sky130_fd_sc_hd__inv_2     | 0.284 |   3.960 |    4.274 | 
     | u_core/g372352                      | C1 ^ -> X ^      | sky130_fd_sc_hd__a221o_1   | 0.195 |   4.155 |    4.469 | 
     | FE_OFC1852_axi_wdata_o_6            | A ^ -> X ^       | sky130_fd_sc_hd__clkbuf_16 | 0.445 |   4.601 |    4.914 | 
     | FE_PDC674_FE_OFN19132_axi_wdata_o_6 | A ^ -> X ^       | sky130_fd_sc_hd__buf_6     | 0.654 |   5.255 |    5.568 | 
     | FE_OFC42_axi_wdata_o_6              | A ^ -> Y v       | sky130_fd_sc_hd__inv_12    | 0.275 |   5.530 |    5.844 | 
     | FE_OFC43_axi_wdata_o_6              | A v -> Y ^       | sky130_fd_sc_hd__inv_8     | 0.325 |   5.855 |    6.168 | 
     | FE_OFC1327_axi_wdata_o_6            | A ^ -> X ^       | sky130_fd_sc_hd__buf_4     | 0.246 |   6.101 |    6.415 | 
     | FE_OFC1328_axi_wdata_o_6            | A ^ -> X ^       | sky130_fd_sc_hd__buf_6     | 0.188 |   6.289 |    6.603 | 
     | FE_OFC1197_axi_wdata_o_6            | A ^ -> X ^       | sky130_fd_sc_hd__buf_4     | 0.267 |   6.556 |    6.869 | 
     | FE_OFC1343_axi_wdata_o_6            | A ^ -> X ^       | sky130_fd_sc_hd__clkbuf_16 | 0.464 |   7.020 |    7.333 | 
     | FE_PDC617_FE_OFN19098_n             | A ^ -> X ^       | sky130_fd_sc_hd__buf_12    | 0.735 |   7.754 |    8.068 | 
     | FE_OFC1201_axi_wdata_o_6            | A ^ -> X ^       | sky130_fd_sc_hd__buf_6     | 0.258 |   8.012 |    8.326 | 
     | FE_OFC1202_axi_wdata_o_6            | A ^ -> Y v       | sky130_fd_sc_hd__inv_6     | 0.064 |   8.076 |    8.389 | 
     | FE_OFC1204_axi_wdata_o_6            | A v -> Y ^       | sky130_fd_sc_hd__clkinv_16 | 0.251 |   8.326 |    8.640 | 
     | FE_PDC457_FE_OFN19592_axi_wdata_o_6 | A ^ -> X ^       | sky130_fd_sc_hd__buf_4     | 0.825 |   9.151 |    9.465 | 
     | FE_OFC2923_axi_wdata_o_6            | A ^ -> Y v       | sky130_fd_sc_hd__inv_12    | 0.098 |   9.249 |    9.563 | 
     | FE_OFC2925_axi_wdata_o_6            | A v -> Y ^       | sky130_fd_sc_hd__clkinv_16 | 0.209 |   9.458 |    9.771 | 
     | FE_OFC4815_axi_wdata_o_6            | A ^ -> X ^       | sky130_fd_sc_hd__buf_12    | 0.274 |   9.731 |   10.045 | 
     | FE_OFC4191_axi_wdata_o_6            | A ^ -> X ^       | sky130_fd_sc_hd__buf_12    | 0.136 |   9.867 |   10.180 | 
     | FE_OFC4192_axi_wdata_o_6            | A ^ -> X ^       | sky130_fd_sc_hd__buf_12    | 0.120 |   9.986 |   10.300 | 
     | FE_OFC4193_axi_wdata_o_6            | A ^ -> X ^       | sky130_fd_sc_hd__buf_12    | 0.116 |  10.102 |   10.416 | 
     | FE_OFC4194_axi_wdata_o_6            | A ^ -> X ^       | sky130_fd_sc_hd__buf_12    | 0.120 |  10.223 |   10.536 | 
     | FE_OFC4195_axi_wdata_o_6            | A ^ -> X ^       | sky130_fd_sc_hd__buf_12    | 0.118 |  10.340 |   10.654 | 
     | FE_OFC4196_axi_wdata_o_6            | A ^ -> X ^       | sky130_fd_sc_hd__buf_12    | 0.123 |  10.463 |   10.777 | 
     | FE_OFC4197_axi_wdata_o_6            | A ^ -> X ^       | sky130_fd_sc_hd__buf_12    | 0.139 |  10.603 |   10.916 | 
     | FE_OFC4198_axi_wdata_o_6            | A ^ -> X ^       | sky130_fd_sc_hd__buf_12    | 0.135 |  10.738 |   11.051 | 
     | FE_OFC4199_axi_wdata_o_6            | A ^ -> X ^       | sky130_fd_sc_hd__buf_12    | 0.115 |  10.853 |   11.167 | 
     | FE_OFC4200_axi_wdata_o_6            | A ^ -> X ^       | sky130_fd_sc_hd__buf_12    | 0.108 |  10.961 |   11.275 | 
     | FE_OFC4201_axi_wdata_o_6            | A ^ -> X ^       | sky130_fd_sc_hd__buf_12    | 0.109 |  11.071 |   11.384 | 
     | FE_OFC4202_axi_wdata_o_6            | A ^ -> X ^       | sky130_fd_sc_hd__buf_12    | 0.114 |  11.185 |   11.499 | 
     | FE_OFC4203_axi_wdata_o_6            | A ^ -> X ^       | sky130_fd_sc_hd__buf_12    | 0.108 |  11.293 |   11.607 | 
     | FE_OFC4204_axi_wdata_o_6            | A ^ -> X ^       | sky130_fd_sc_hd__buf_12    | 0.101 |  11.394 |   11.707 | 
     | FE_OFC4205_axi_wdata_o_6            | A ^ -> X ^       | sky130_fd_sc_hd__buf_12    | 0.124 |  11.518 |   11.832 | 
     |                                     | axi_wdata_o[6] ^ |                            | 0.001 |  11.519 |   11.833 | 
     +------------------------------------------------------------------------------------------------------------------+ 
Path 6: MET Setup Check with Pin apb_prdata_o_reg[12]/CLK 
Endpoint:   apb_prdata_o_reg[12]/D (^) checked with  leading edge of 'clk_i'
Beginpoint: apb_paddr_i[7]         (^) triggered by  leading edge of 'clk_i'
Path Groups: {clk_i}
Analysis View: av_tt
Other End Arrival Time          4.043
- Setup                         0.085
+ Phase Shift                  13.333
+ CPPR Adjustment               0.000
- Uncertainty                   0.500
= Required Time                16.791
- Arrival Time                 16.395
= Slack Time                    0.396
     Clock Rise Edge                      0.000
     + Input Delay                        3.500
     + Drive Adjustment                   0.481
     + Source Insertion Delay             1.000
     = Beginpoint Arrival Time            4.981
     Timing Path:
     +-----------------------------------------------------------------------------------------------------------------+ 
     |              Instance              |       Arc        |            Cell            | Delay | Arrival | Required | 
     |                                    |                  |                            |       |  Time   |   Time   | 
     |------------------------------------+------------------+----------------------------+-------+---------+----------| 
     |                                    | apb_paddr_i[7] ^ |                            |       |   4.981 |    5.377 | 
     | FE_OFC3009_apb_paddr_i_7           | A ^ -> X ^       | sky130_fd_sc_hd__buf_2     | 3.734 |   8.714 |    9.111 | 
     | FE_OFC517_apb_paddr_i_7            | A ^ -> X ^       | sky130_fd_sc_hd__buf_2     | 0.327 |   9.041 |    9.438 | 
     | FE_OFC2436_apb_paddr_i_7           | A ^ -> Y v       | sky130_fd_sc_hd__clkinv_16 | 0.174 |   9.216 |    9.612 | 
     | FE_OFC2280_apb_paddr_i_7           | A v -> Y ^       | sky130_fd_sc_hd__clkinv_16 | 0.529 |   9.744 |   10.141 | 
     | g24104                             | B ^ -> X ^       | sky130_fd_sc_hd__or2_2     | 0.266 |  10.010 |   10.407 | 
     | g24101                             | A_N ^ -> Y ^     | sky130_fd_sc_hd__nand2b_1  | 0.219 |  10.229 |   10.626 | 
     | g24099                             | A ^ -> Y v       | sky130_fd_sc_hd__nand3_1   | 0.098 |  10.327 |   10.723 | 
     | g24098                             | C v -> X v       | sky130_fd_sc_hd__or4b_1    | 0.554 |  10.881 |   11.277 | 
     | g24097                             | C v -> Y ^       | sky130_fd_sc_hd__nor3_1    | 0.182 |  11.063 |   11.459 | 
     | FE_OFC1394_n_1435                  | A ^ -> X ^       | sky130_fd_sc_hd__buf_4     | 0.398 |  11.461 |   11.858 | 
     | g2                                 | B_N ^ -> Y ^     | sky130_fd_sc_hd__nor2b_1   | 0.433 |  11.894 |   12.290 | 
     | u_core/g529                        | A ^ -> Y v       | sky130_fd_sc_hd__nand2_1   | 0.238 |  12.131 |   12.528 | 
     | u_core/g518                        | A v -> Y ^       | sky130_fd_sc_hd__nor2b_4   | 0.353 |  12.484 |   12.881 | 
     | u_core/g504                        | A ^ -> X ^       | sky130_fd_sc_hd__and2_1    | 0.363 |  12.847 |   13.243 | 
     | u_core/FE_OFC696_u_regfile_n_5896  | A ^ -> X ^       | sky130_fd_sc_hd__buf_4     | 0.363 |  13.210 |   13.606 | 
     | u_core/FE_OFC4489_u_regfile_n_5896 | A ^ -> X ^       | sky130_fd_sc_hd__clkbuf_4  | 0.584 |  13.793 |   14.190 | 
     | u_core/g3932                       | B1 ^ -> Y v      | sky130_fd_sc_hd__a22oi_1   | 0.178 |  13.972 |   14.368 | 
     | u_core/g3485                       | A v -> Y ^       | sky130_fd_sc_hd__nand4_1   | 0.292 |  14.264 |   14.660 | 
     | u_core/FE_OFC4680_n_16288          | A ^ -> X ^       | sky130_fd_sc_hd__buf_2     | 0.362 |  14.626 |   15.022 | 
     | u_core/g3421                       | C ^ -> X ^       | sky130_fd_sc_hd__or4_1     | 0.383 |  15.008 |   15.405 | 
     | u_core/g373129                     | B_N ^ -> Y ^     | sky130_fd_sc_hd__nor2b_2   | 0.428 |  15.436 |   15.833 | 
     | g45584                             | A ^ -> Y v       | sky130_fd_sc_hd__nand2_1   | 0.434 |  15.870 |   16.266 | 
     | g44794                             | A v -> Y ^       | sky130_fd_sc_hd__nand4_1   | 0.230 |  16.100 |   16.496 | 
     | FE_OFC684_n_1295                   | A ^ -> X ^       | sky130_fd_sc_hd__clkbuf_1  | 0.294 |  16.394 |   16.790 | 
     | apb_prdata_o_reg[12]               | D ^              | sky130_fd_sc_hd__dfxtp_1   | 0.001 |  16.395 |   16.791 | 
     +-----------------------------------------------------------------------------------------------------------------+ 
     Clock Rise Edge                      0.000
     + Drive Adjustment                   0.113
     + Source Insertion Delay             1.000
     = Beginpoint Arrival Time            1.113
     Other End Path:
     +----------------------------------------------------------------------------------------------+ 
     |       Instance        |    Arc     |            Cell            | Delay | Arrival | Required | 
     |                       |            |                            |       |  Time   |   Time   | 
     |-----------------------+------------+----------------------------+-------+---------+----------| 
     |                       | clk_i ^    |                            |       |   1.113 |    0.716 | 
     | CTS_cpc_drv_buf_00277 | A ^ -> X ^ | sky130_fd_sc_hd__clkbuf_16 | 0.227 |   1.340 |    0.944 | 
     | CTS_cpc_drv_buf_00271 | A ^ -> X ^ | sky130_fd_sc_hd__clkbuf_16 | 0.446 |   1.786 |    1.390 | 
     | CTS_cpc_drv_buf_00263 | A ^ -> X ^ | sky130_fd_sc_hd__clkbuf_16 | 0.427 |   2.213 |    1.817 | 
     | CTS_ccl_buf_00251     | A ^ -> X ^ | sky130_fd_sc_hd__clkbuf_16 | 0.363 |   2.576 |    2.180 | 
     | CTS_ccl_a_buf_00250   | A ^ -> X ^ | sky130_fd_sc_hd__clkbuf_16 | 0.329 |   2.905 |    2.509 | 
     | CTS_ccl_a_buf_00248   | A ^ -> X ^ | sky130_fd_sc_hd__clkbuf_8  | 0.291 |   3.196 |    2.799 | 
     | CTS_ccl_buf_00245     | A ^ -> X ^ | sky130_fd_sc_hd__clkbuf_16 | 0.293 |   3.489 |    3.092 | 
     | CTS_ccl_a_buf_00220   | A ^ -> X ^ | sky130_fd_sc_hd__clkbuf_8  | 0.273 |   3.761 |    3.365 | 
     | CTS_ccl_a_buf_00009   | A ^ -> X ^ | sky130_fd_sc_hd__clkbuf_8  | 0.276 |   4.037 |    3.641 | 
     | apb_prdata_o_reg[12]  | CLK ^      | sky130_fd_sc_hd__dfxtp_1   | 0.006 |   4.043 |    3.647 | 
     +----------------------------------------------------------------------------------------------+ 
Path 7: MET Setup Check with Pin apb_prdata_o_reg[4]/CLK 
Endpoint:   apb_prdata_o_reg[4]/D (^) checked with  leading edge of 'clk_i'
Beginpoint: apb_paddr_i[7]        (^) triggered by  leading edge of 'clk_i'
Path Groups: {clk_i}
Analysis View: av_tt
Other End Arrival Time          4.036
- Setup                         0.034
+ Phase Shift                  13.333
+ CPPR Adjustment               0.000
- Uncertainty                   0.500
= Required Time                16.835
- Arrival Time                 16.378
= Slack Time                    0.457
     Clock Rise Edge                      0.000
     + Input Delay                        3.500
     + Drive Adjustment                   0.481
     + Source Insertion Delay             1.000
     = Beginpoint Arrival Time            4.981
     Timing Path:
     +------------------------------------------------------------------------------------------------------------------------------+ 
     |                    Instance                     |       Arc        |            Cell            | Delay | Arrival | Required | 
     |                                                 |                  |                            |       |  Time   |   Time   | 
     |-------------------------------------------------+------------------+----------------------------+-------+---------+----------| 
     |                                                 | apb_paddr_i[7] ^ |                            |       |   4.981 |    5.438 | 
     | FE_OFC3009_apb_paddr_i_7                        | A ^ -> X ^       | sky130_fd_sc_hd__buf_2     | 3.734 |   8.715 |    9.172 | 
     | FE_OFC517_apb_paddr_i_7                         | A ^ -> X ^       | sky130_fd_sc_hd__buf_2     | 0.327 |   9.041 |    9.499 | 
     | FE_OFC2436_apb_paddr_i_7                        | A ^ -> Y v       | sky130_fd_sc_hd__clkinv_16 | 0.174 |   9.216 |    9.673 | 
     | FE_OFC2280_apb_paddr_i_7                        | A v -> Y ^       | sky130_fd_sc_hd__clkinv_16 | 0.529 |   9.744 |   10.202 | 
     | g24104                                          | B ^ -> X ^       | sky130_fd_sc_hd__or2_2     | 0.266 |  10.010 |   10.468 | 
     | g24101                                          | A_N ^ -> Y ^     | sky130_fd_sc_hd__nand2b_1  | 0.219 |  10.229 |   10.687 | 
     | g24099                                          | A ^ -> Y v       | sky130_fd_sc_hd__nand3_1   | 0.098 |  10.327 |   10.784 | 
     | g24098                                          | C v -> X v       | sky130_fd_sc_hd__or4b_1    | 0.554 |  10.881 |   11.338 | 
     | g24097                                          | C v -> Y ^       | sky130_fd_sc_hd__nor3_1    | 0.182 |  11.063 |   11.520 | 
     | FE_OFC1394_n_1435                               | A ^ -> X ^       | sky130_fd_sc_hd__buf_4     | 0.398 |  11.461 |   11.918 | 
     | g2                                              | B_N ^ -> Y ^     | sky130_fd_sc_hd__nor2b_1   | 0.433 |  11.894 |   12.351 | 
     | u_core/g522                                     | B_N ^ -> Y ^     | sky130_fd_sc_hd__nor2b_1   | 0.242 |  12.136 |   12.593 | 
     | u_core/g519                                     | B_N ^ -> Y ^     | sky130_fd_sc_hd__nor2b_1   | 0.157 |  12.293 |   12.750 | 
     | u_core/FE_OFC4198_n_15133                       | A ^ -> X ^       | sky130_fd_sc_hd__buf_2     | 0.313 |  12.606 |   13.063 | 
     | u_core/g490                                     | B ^ -> X ^       | sky130_fd_sc_hd__and2b_2   | 0.424 |  13.030 |   13.487 | 
     | u_core/FE_OFC1781_u_regfile_n_5906              | A ^ -> X ^       | sky130_fd_sc_hd__buf_6     | 0.422 |  13.452 |   13.909 | 
     | u_core/FE_OFC1782_u_regfile_n_5906              | A ^ -> X ^       | sky130_fd_sc_hd__buf_6     | 0.476 |  13.928 |   14.385 | 
     | u_core/g3544                                    | B1 ^ -> Y v      | sky130_fd_sc_hd__a221oi_1  | 0.199 |  14.126 |   14.584 | 
     | u_core/FE_OFC4614_n_16229                       | A v -> X v       | sky130_fd_sc_hd__clkbuf_1  | 0.204 |  14.330 |   14.788 | 
     | u_core/g3435                                    | B v -> Y ^       | sky130_fd_sc_hd__nand4_1   | 0.273 |  14.603 |   15.061 | 
     | u_core/g3405                                    | D ^ -> X ^       | sky130_fd_sc_hd__or4_4     | 0.384 |  14.987 |   15.445 | 
     | u_core/FE_OFC1717_u_regfile_regs_dbg_rd_addr__4 | A ^ -> X ^       | sky130_fd_sc_hd__buf_4     | 0.495 |  15.482 |   15.940 | 
     | u_core/g373140                                  | B_N ^ -> Y ^     | sky130_fd_sc_hd__nor2b_1   | 0.347 |  15.830 |   16.287 | 
     | FE_OFC4702_dbg_reg_rd_data_4                    | A ^ -> X ^       | sky130_fd_sc_hd__buf_2     | 0.380 |  16.210 |   16.667 | 
     | g44809                                          | A1 ^ -> X ^      | sky130_fd_sc_hd__a21o_1    | 0.168 |  16.378 |   16.835 | 
     | apb_prdata_o_reg[4]                             | D ^              | sky130_fd_sc_hd__dfxtp_1   | 0.000 |  16.378 |   16.835 | 
     +------------------------------------------------------------------------------------------------------------------------------+ 
     Clock Rise Edge                      0.000
     + Drive Adjustment                   0.113
     + Source Insertion Delay             1.000
     = Beginpoint Arrival Time            1.113
     Other End Path:
     +----------------------------------------------------------------------------------------------+ 
     |       Instance        |    Arc     |            Cell            | Delay | Arrival | Required | 
     |                       |            |                            |       |  Time   |   Time   | 
     |-----------------------+------------+----------------------------+-------+---------+----------| 
     |                       | clk_i ^    |                            |       |   1.113 |    0.655 | 
     | CTS_cpc_drv_buf_00277 | A ^ -> X ^ | sky130_fd_sc_hd__clkbuf_16 | 0.227 |   1.340 |    0.883 | 
     | CTS_cpc_drv_buf_00271 | A ^ -> X ^ | sky130_fd_sc_hd__clkbuf_16 | 0.446 |   1.786 |    1.329 | 
     | CTS_cpc_drv_buf_00263 | A ^ -> X ^ | sky130_fd_sc_hd__clkbuf_16 | 0.427 |   2.213 |    1.756 | 
     | CTS_ccl_buf_00251     | A ^ -> X ^ | sky130_fd_sc_hd__clkbuf_16 | 0.363 |   2.576 |    2.119 | 
     | CTS_ccl_a_buf_00250   | A ^ -> X ^ | sky130_fd_sc_hd__clkbuf_16 | 0.329 |   2.905 |    2.448 | 
     | CTS_ccl_a_buf_00248   | A ^ -> X ^ | sky130_fd_sc_hd__clkbuf_8  | 0.291 |   3.196 |    2.739 | 
     | CTS_ccl_buf_00243     | A ^ -> X ^ | sky130_fd_sc_hd__clkbuf_16 | 0.278 |   3.474 |    3.017 | 
     | CTS_ccl_a_buf_00237   | A ^ -> X ^ | sky130_fd_sc_hd__clkbuf_16 | 0.281 |   3.755 |    3.298 | 
     | CTS_ccl_a_buf_00060   | A ^ -> X ^ | sky130_fd_sc_hd__clkbuf_8  | 0.274 |   4.029 |    3.572 | 
     | apb_prdata_o_reg[4]   | CLK ^      | sky130_fd_sc_hd__dfxtp_1   | 0.007 |   4.036 |    3.579 | 
     +----------------------------------------------------------------------------------------------+ 
Path 8: MET Setup Check with Pin apb_prdata_o_reg[11]/CLK 
Endpoint:   apb_prdata_o_reg[11]/D (^) checked with  leading edge of 'clk_i'
Beginpoint: apb_paddr_i[7]         (^) triggered by  leading edge of 'clk_i'
Path Groups: {clk_i}
Analysis View: av_tt
Other End Arrival Time          4.044
- Setup                         0.054
+ Phase Shift                  13.333
+ CPPR Adjustment               0.000
- Uncertainty                   0.500
= Required Time                16.823
- Arrival Time                 16.348
= Slack Time                    0.475
     Clock Rise Edge                      0.000
     + Input Delay                        3.500
     + Drive Adjustment                   0.481
     + Source Insertion Delay             1.000
     = Beginpoint Arrival Time            4.981
     Timing Path:
     +-------------------------------------------------------------------------------------------------------------------------------+ 
     |                     Instance                     |       Arc        |            Cell            | Delay | Arrival | Required | 
     |                                                  |                  |                            |       |  Time   |   Time   | 
     |--------------------------------------------------+------------------+----------------------------+-------+---------+----------| 
     |                                                  | apb_paddr_i[7] ^ |                            |       |   4.981 |    5.456 | 
     | FE_OFC3009_apb_paddr_i_7                         | A ^ -> X ^       | sky130_fd_sc_hd__buf_2     | 3.734 |   8.715 |    9.190 | 
     | FE_OFC517_apb_paddr_i_7                          | A ^ -> X ^       | sky130_fd_sc_hd__buf_2     | 0.327 |   9.041 |    9.516 | 
     | FE_OFC2436_apb_paddr_i_7                         | A ^ -> Y v       | sky130_fd_sc_hd__clkinv_16 | 0.174 |   9.216 |    9.691 | 
     | FE_OFC2280_apb_paddr_i_7                         | A v -> Y ^       | sky130_fd_sc_hd__clkinv_16 | 0.529 |   9.744 |   10.219 | 
     | g24104                                           | B ^ -> X ^       | sky130_fd_sc_hd__or2_2     | 0.266 |  10.010 |   10.485 | 
     | g24101                                           | A_N ^ -> Y ^     | sky130_fd_sc_hd__nand2b_1  | 0.219 |  10.229 |   10.704 | 
     | g24099                                           | A ^ -> Y v       | sky130_fd_sc_hd__nand3_1   | 0.098 |  10.327 |   10.802 | 
     | g24098                                           | C v -> X v       | sky130_fd_sc_hd__or4b_1    | 0.554 |  10.881 |   11.356 | 
     | g24097                                           | C v -> Y ^       | sky130_fd_sc_hd__nor3_1    | 0.182 |  11.063 |   11.538 | 
     | FE_OFC1394_n_1435                                | A ^ -> X ^       | sky130_fd_sc_hd__buf_4     | 0.398 |  11.461 |   11.936 | 
     | g2                                               | B_N ^ -> Y ^     | sky130_fd_sc_hd__nor2b_1   | 0.433 |  11.894 |   12.369 | 
     | u_core/g522                                      | B_N ^ -> Y ^     | sky130_fd_sc_hd__nor2b_1   | 0.242 |  12.136 |   12.611 | 
     | u_core/g519                                      | B_N ^ -> Y ^     | sky130_fd_sc_hd__nor2b_1   | 0.157 |  12.293 |   12.768 | 
     | u_core/FE_OFC4198_n_15133                        | A ^ -> X ^       | sky130_fd_sc_hd__buf_2     | 0.313 |  12.606 |   13.081 | 
     | u_core/g490                                      | B ^ -> X ^       | sky130_fd_sc_hd__and2b_2   | 0.424 |  13.030 |   13.505 | 
     | u_core/FE_OFC1781_u_regfile_n_5906               | A ^ -> X ^       | sky130_fd_sc_hd__buf_6     | 0.422 |  13.452 |   13.927 | 
     | u_core/FE_OFC1782_u_regfile_n_5906               | A ^ -> X ^       | sky130_fd_sc_hd__buf_6     | 0.476 |  13.928 |   14.403 | 
     | u_core/g3632                                     | B1 ^ -> Y v      | sky130_fd_sc_hd__a221oi_2  | 0.155 |  14.083 |   14.558 | 
     | u_core/g3453                                     | B v -> Y ^       | sky130_fd_sc_hd__nand4_1   | 0.297 |  14.380 |   14.855 | 
     | u_core/g3424                                     | D ^ -> X ^       | sky130_fd_sc_hd__or4_2     | 0.558 |  14.937 |   15.412 | 
     | u_core/FE_OFC1715_u_regfile_regs_dbg_rd_addr__11 | A ^ -> X ^       | sky130_fd_sc_hd__buf_4     | 0.387 |  15.325 |   15.800 | 
     | u_core/g373131                                   | B_N ^ -> Y ^     | sky130_fd_sc_hd__nor2b_1   | 0.292 |  15.617 |   16.092 | 
     | FE_OFC4765_dbg_reg_rd_data_11                    | A ^ -> X ^       | sky130_fd_sc_hd__buf_2     | 0.418 |  16.035 |   16.510 | 
     | g44790                                           | A1 ^ -> X ^      | sky130_fd_sc_hd__a211o_1   | 0.313 |  16.348 |   16.823 | 
     | apb_prdata_o_reg[11]                             | D ^              | sky130_fd_sc_hd__dfxtp_1   | 0.000 |  16.348 |   16.823 | 
     +-------------------------------------------------------------------------------------------------------------------------------+ 
     Clock Rise Edge                      0.000
     + Drive Adjustment                   0.113
     + Source Insertion Delay             1.000
     = Beginpoint Arrival Time            1.113
     Other End Path:
     +----------------------------------------------------------------------------------------------+ 
     |       Instance        |    Arc     |            Cell            | Delay | Arrival | Required | 
     |                       |            |                            |       |  Time   |   Time   | 
     |-----------------------+------------+----------------------------+-------+---------+----------| 
     |                       | clk_i ^    |                            |       |   1.113 |    0.638 | 
     | CTS_cpc_drv_buf_00277 | A ^ -> X ^ | sky130_fd_sc_hd__clkbuf_16 | 0.227 |   1.340 |    0.865 | 
     | CTS_cpc_drv_buf_00271 | A ^ -> X ^ | sky130_fd_sc_hd__clkbuf_16 | 0.446 |   1.786 |    1.311 | 
     | CTS_cpc_drv_buf_00263 | A ^ -> X ^ | sky130_fd_sc_hd__clkbuf_16 | 0.427 |   2.213 |    1.738 | 
     | CTS_ccl_buf_00251     | A ^ -> X ^ | sky130_fd_sc_hd__clkbuf_16 | 0.363 |   2.576 |    2.101 | 
     | CTS_ccl_a_buf_00250   | A ^ -> X ^ | sky130_fd_sc_hd__clkbuf_16 | 0.329 |   2.905 |    2.430 | 
     | CTS_ccl_a_buf_00248   | A ^ -> X ^ | sky130_fd_sc_hd__clkbuf_8  | 0.291 |   3.196 |    2.721 | 
     | CTS_ccl_buf_00245     | A ^ -> X ^ | sky130_fd_sc_hd__clkbuf_16 | 0.293 |   3.489 |    3.014 | 
     | CTS_ccl_a_buf_00220   | A ^ -> X ^ | sky130_fd_sc_hd__clkbuf_8  | 0.273 |   3.761 |    3.286 | 
     | CTS_ccl_a_buf_00009   | A ^ -> X ^ | sky130_fd_sc_hd__clkbuf_8  | 0.276 |   4.037 |    3.562 | 
     | apb_prdata_o_reg[11]  | CLK ^      | sky130_fd_sc_hd__dfxtp_1   | 0.007 |   4.044 |    3.569 | 
     +----------------------------------------------------------------------------------------------+ 
Path 9: MET Setup Check with Pin apb_prdata_o_reg[8]/CLK 
Endpoint:   apb_prdata_o_reg[8]/D (^) checked with  leading edge of 'clk_i'
Beginpoint: apb_paddr_i[7]        (^) triggered by  leading edge of 'clk_i'
Path Groups: {clk_i}
Analysis View: av_tt
Other End Arrival Time          4.036
- Setup                         0.046
+ Phase Shift                  13.333
+ CPPR Adjustment               0.000
- Uncertainty                   0.500
= Required Time                16.822
- Arrival Time                 16.331
= Slack Time                    0.491
     Clock Rise Edge                      0.000
     + Input Delay                        3.500
     + Drive Adjustment                   0.481
     + Source Insertion Delay             1.000
     = Beginpoint Arrival Time            4.981
     Timing Path:
     +------------------------------------------------------------------------------------------------------------------------------+ 
     |                    Instance                     |       Arc        |            Cell            | Delay | Arrival | Required | 
     |                                                 |                  |                            |       |  Time   |   Time   | 
     |-------------------------------------------------+------------------+----------------------------+-------+---------+----------| 
     |                                                 | apb_paddr_i[7] ^ |                            |       |   4.981 |    5.472 | 
     | FE_OFC3009_apb_paddr_i_7                        | A ^ -> X ^       | sky130_fd_sc_hd__buf_2     | 3.734 |   8.715 |    9.206 | 
     | FE_OFC517_apb_paddr_i_7                         | A ^ -> X ^       | sky130_fd_sc_hd__buf_2     | 0.327 |   9.041 |    9.532 | 
     | FE_OFC2436_apb_paddr_i_7                        | A ^ -> Y v       | sky130_fd_sc_hd__clkinv_16 | 0.174 |   9.216 |    9.707 | 
     | FE_OFC2280_apb_paddr_i_7                        | A v -> Y ^       | sky130_fd_sc_hd__clkinv_16 | 0.529 |   9.744 |   10.235 | 
     | g24104                                          | B ^ -> X ^       | sky130_fd_sc_hd__or2_2     | 0.266 |  10.010 |   10.501 | 
     | g24101                                          | A_N ^ -> Y ^     | sky130_fd_sc_hd__nand2b_1  | 0.219 |  10.229 |   10.720 | 
     | g24099                                          | A ^ -> Y v       | sky130_fd_sc_hd__nand3_1   | 0.098 |  10.327 |   10.818 | 
     | g24098                                          | C v -> X v       | sky130_fd_sc_hd__or4b_1    | 0.554 |  10.881 |   11.372 | 
     | g24097                                          | C v -> Y ^       | sky130_fd_sc_hd__nor3_1    | 0.182 |  11.063 |   11.554 | 
     | FE_OFC1394_n_1435                               | A ^ -> X ^       | sky130_fd_sc_hd__buf_4     | 0.398 |  11.461 |   11.952 | 
     | g2                                              | B_N ^ -> Y ^     | sky130_fd_sc_hd__nor2b_1   | 0.433 |  11.894 |   12.385 | 
     | u_core/g522                                     | B_N ^ -> Y ^     | sky130_fd_sc_hd__nor2b_1   | 0.242 |  12.136 |   12.627 | 
     | u_core/g519                                     | B_N ^ -> Y ^     | sky130_fd_sc_hd__nor2b_1   | 0.157 |  12.293 |   12.784 | 
     | u_core/FE_OFC4198_n_15133                       | A ^ -> X ^       | sky130_fd_sc_hd__buf_2     | 0.313 |  12.606 |   13.097 | 
     | u_core/g498                                     | A ^ -> X ^       | sky130_fd_sc_hd__and2_2    | 0.380 |  12.986 |   13.477 | 
     | u_core/FE_OFC1770_u_regfile_n_5914              | A ^ -> X ^       | sky130_fd_sc_hd__buf_6     | 0.373 |  13.359 |   13.850 | 
     | u_core/FE_OFC4506_u_regfile_n_5914              | A ^ -> X ^       | sky130_fd_sc_hd__buf_4     | 0.556 |  13.915 |   14.406 | 
     | u_core/g3502                                    | B1 ^ -> Y v      | sky130_fd_sc_hd__a221oi_1  | 0.193 |  14.108 |   14.599 | 
     | u_core/g3428                                    | A v -> Y ^       | sky130_fd_sc_hd__nand4_1   | 0.191 |  14.299 |   14.790 | 
     | u_core/FE_OFC4690_n_16345                       | A ^ -> X ^       | sky130_fd_sc_hd__clkbuf_1  | 0.270 |  14.569 |   15.060 | 
     | u_core/g3399                                    | D ^ -> X ^       | sky130_fd_sc_hd__or4_2     | 0.641 |  15.210 |   15.701 | 
     | u_core/FE_OFC1705_u_regfile_regs_dbg_rd_addr__8 | A ^ -> X ^       | sky130_fd_sc_hd__buf_4     | 0.399 |  15.608 |   16.099 | 
     | u_core/g373135                                  | B_N ^ -> Y ^     | sky130_fd_sc_hd__nor2b_1   | 0.169 |  15.777 |   16.268 | 
     | FE_OFC1414_dbg_reg_rd_data_8                    | A ^ -> X ^       | sky130_fd_sc_hd__buf_2     | 0.276 |  16.053 |   16.544 | 
     | g45580                                          | A ^ -> Y v       | sky130_fd_sc_hd__nand2_1   | 0.163 |  16.215 |   16.706 | 
     | g44820                                          | A v -> Y ^       | sky130_fd_sc_hd__nand4_1   | 0.116 |  16.331 |   16.822 | 
     | apb_prdata_o_reg[8]                             | D ^              | sky130_fd_sc_hd__dfxtp_1   | 0.000 |  16.331 |   16.822 | 
     +------------------------------------------------------------------------------------------------------------------------------+ 
     Clock Rise Edge                      0.000
     + Drive Adjustment                   0.113
     + Source Insertion Delay             1.000
     = Beginpoint Arrival Time            1.113
     Other End Path:
     +----------------------------------------------------------------------------------------------+ 
     |       Instance        |    Arc     |            Cell            | Delay | Arrival | Required | 
     |                       |            |                            |       |  Time   |   Time   | 
     |-----------------------+------------+----------------------------+-------+---------+----------| 
     |                       | clk_i ^    |                            |       |   1.113 |    0.622 | 
     | CTS_cpc_drv_buf_00277 | A ^ -> X ^ | sky130_fd_sc_hd__clkbuf_16 | 0.227 |   1.340 |    0.849 | 
     | CTS_cpc_drv_buf_00271 | A ^ -> X ^ | sky130_fd_sc_hd__clkbuf_16 | 0.446 |   1.786 |    1.295 | 
     | CTS_cpc_drv_buf_00263 | A ^ -> X ^ | sky130_fd_sc_hd__clkbuf_16 | 0.427 |   2.213 |    1.722 | 
     | CTS_ccl_buf_00251     | A ^ -> X ^ | sky130_fd_sc_hd__clkbuf_16 | 0.363 |   2.576 |    2.085 | 
     | CTS_ccl_a_buf_00250   | A ^ -> X ^ | sky130_fd_sc_hd__clkbuf_16 | 0.329 |   2.905 |    2.414 | 
     | CTS_ccl_a_buf_00248   | A ^ -> X ^ | sky130_fd_sc_hd__clkbuf_8  | 0.291 |   3.196 |    2.705 | 
     | CTS_ccl_buf_00243     | A ^ -> X ^ | sky130_fd_sc_hd__clkbuf_16 | 0.278 |   3.474 |    2.983 | 
     | CTS_ccl_a_buf_00237   | A ^ -> X ^ | sky130_fd_sc_hd__clkbuf_16 | 0.281 |   3.755 |    3.264 | 
     | CTS_ccl_a_buf_00060   | A ^ -> X ^ | sky130_fd_sc_hd__clkbuf_8  | 0.274 |   4.029 |    3.538 | 
     | apb_prdata_o_reg[8]   | CLK ^      | sky130_fd_sc_hd__dfxtp_1   | 0.007 |   4.036 |    3.544 | 
     +----------------------------------------------------------------------------------------------+ 
Path 10: MET Setup Check with Pin apb_prdata_o_reg[2]/CLK 
Endpoint:   apb_prdata_o_reg[2]/D (^) checked with  leading edge of 'clk_i'
Beginpoint: apb_paddr_i[7]        (^) triggered by  leading edge of 'clk_i'
Path Groups: {clk_i}
Analysis View: av_tt
Other End Arrival Time          4.036
- Setup                         0.045
+ Phase Shift                  13.333
+ CPPR Adjustment               0.000
- Uncertainty                   0.500
= Required Time                16.823
- Arrival Time                 16.327
= Slack Time                    0.496
     Clock Rise Edge                      0.000
     + Input Delay                        3.500
     + Drive Adjustment                   0.481
     + Source Insertion Delay             1.000
     = Beginpoint Arrival Time            4.981
     Timing Path:
     +------------------------------------------------------------------------------------------------------------------------------+ 
     |                    Instance                     |       Arc        |            Cell            | Delay | Arrival | Required | 
     |                                                 |                  |                            |       |  Time   |   Time   | 
     |-------------------------------------------------+------------------+----------------------------+-------+---------+----------| 
     |                                                 | apb_paddr_i[7] ^ |                            |       |   4.981 |    5.477 | 
     | FE_OFC3009_apb_paddr_i_7                        | A ^ -> X ^       | sky130_fd_sc_hd__buf_2     | 3.734 |   8.715 |    9.211 | 
     | FE_OFC517_apb_paddr_i_7                         | A ^ -> X ^       | sky130_fd_sc_hd__buf_2     | 0.327 |   9.041 |    9.537 | 
     | FE_OFC2436_apb_paddr_i_7                        | A ^ -> Y v       | sky130_fd_sc_hd__clkinv_16 | 0.174 |   9.216 |    9.712 | 
     | FE_OFC2280_apb_paddr_i_7                        | A v -> Y ^       | sky130_fd_sc_hd__clkinv_16 | 0.529 |   9.744 |   10.240 | 
     | g24104                                          | B ^ -> X ^       | sky130_fd_sc_hd__or2_2     | 0.266 |  10.010 |   10.506 | 
     | g24101                                          | A_N ^ -> Y ^     | sky130_fd_sc_hd__nand2b_1  | 0.219 |  10.229 |   10.725 | 
     | g24099                                          | A ^ -> Y v       | sky130_fd_sc_hd__nand3_1   | 0.098 |  10.327 |   10.823 | 
     | g24098                                          | C v -> X v       | sky130_fd_sc_hd__or4b_1    | 0.554 |  10.881 |   11.377 | 
     | g24097                                          | C v -> Y ^       | sky130_fd_sc_hd__nor3_1    | 0.182 |  11.063 |   11.559 | 
     | FE_OFC1394_n_1435                               | A ^ -> X ^       | sky130_fd_sc_hd__buf_4     | 0.398 |  11.461 |   11.957 | 
     | g2                                              | B_N ^ -> Y ^     | sky130_fd_sc_hd__nor2b_1   | 0.433 |  11.894 |   12.390 | 
     | u_core/g522                                     | B_N ^ -> Y ^     | sky130_fd_sc_hd__nor2b_1   | 0.242 |  12.136 |   12.632 | 
     | u_core/g519                                     | B_N ^ -> Y ^     | sky130_fd_sc_hd__nor2b_1   | 0.157 |  12.293 |   12.789 | 
     | u_core/FE_OFC4198_n_15133                       | A ^ -> X ^       | sky130_fd_sc_hd__buf_2     | 0.313 |  12.606 |   13.102 | 
     | u_core/g490                                     | B ^ -> X ^       | sky130_fd_sc_hd__and2b_2   | 0.424 |  13.030 |   13.526 | 
     | u_core/FE_OFC1781_u_regfile_n_5906              | A ^ -> X ^       | sky130_fd_sc_hd__buf_6     | 0.422 |  13.452 |   13.948 | 
     | u_core/FE_OFC1782_u_regfile_n_5906              | A ^ -> X ^       | sky130_fd_sc_hd__buf_6     | 0.476 |  13.928 |   14.424 | 
     | u_core/g3563                                    | B1 ^ -> Y v      | sky130_fd_sc_hd__a221oi_1  | 0.247 |  14.175 |   14.671 | 
     | u_core/FE_OFC4613_n_16210                       | A v -> X v       | sky130_fd_sc_hd__clkbuf_1  | 0.163 |  14.337 |   14.833 | 
     | u_core/g3440                                    | B v -> Y ^       | sky130_fd_sc_hd__nand4_1   | 0.092 |  14.429 |   14.925 | 
     | u_core/FE_OFC1412_n_16333                       | A ^ -> X ^       | sky130_fd_sc_hd__buf_2     | 0.229 |  14.658 |   15.154 | 
     | u_core/g3394                                    | D ^ -> X ^       | sky130_fd_sc_hd__or4_1     | 0.164 |  14.822 |   15.318 | 
     | u_core/FE_OFC1415_u_regfile_regs_dbg_rd_addr__2 | A ^ -> X ^       | sky130_fd_sc_hd__buf_6     | 0.351 |  15.173 |   15.669 | 
     | u_core/g373143                                  | B_N ^ -> Y ^     | sky130_fd_sc_hd__nor2b_1   | 0.272 |  15.445 |   15.941 | 
     | FE_OFC7626_dbg_reg_rd_data_2                    | A ^ -> X ^       | sky130_fd_sc_hd__buf_2     | 0.377 |  15.822 |   16.318 | 
     | g45570                                          | A ^ -> Y v       | sky130_fd_sc_hd__nand2_1   | 0.360 |  16.182 |   16.678 | 
     | g44847                                          | A v -> Y ^       | sky130_fd_sc_hd__nand4_1   | 0.145 |  16.327 |   16.823 | 
     | apb_prdata_o_reg[2]                             | D ^              | sky130_fd_sc_hd__dfxtp_1   | 0.000 |  16.327 |   16.823 | 
     +------------------------------------------------------------------------------------------------------------------------------+ 
     Clock Rise Edge                      0.000
     + Drive Adjustment                   0.113
     + Source Insertion Delay             1.000
     = Beginpoint Arrival Time            1.113
     Other End Path:
     +----------------------------------------------------------------------------------------------+ 
     |       Instance        |    Arc     |            Cell            | Delay | Arrival | Required | 
     |                       |            |                            |       |  Time   |   Time   | 
     |-----------------------+------------+----------------------------+-------+---------+----------| 
     |                       | clk_i ^    |                            |       |   1.113 |    0.617 | 
     | CTS_cpc_drv_buf_00277 | A ^ -> X ^ | sky130_fd_sc_hd__clkbuf_16 | 0.227 |   1.340 |    0.844 | 
     | CTS_cpc_drv_buf_00271 | A ^ -> X ^ | sky130_fd_sc_hd__clkbuf_16 | 0.446 |   1.786 |    1.290 | 
     | CTS_cpc_drv_buf_00263 | A ^ -> X ^ | sky130_fd_sc_hd__clkbuf_16 | 0.427 |   2.213 |    1.717 | 
     | CTS_ccl_buf_00251     | A ^ -> X ^ | sky130_fd_sc_hd__clkbuf_16 | 0.363 |   2.576 |    2.080 | 
     | CTS_ccl_a_buf_00250   | A ^ -> X ^ | sky130_fd_sc_hd__clkbuf_16 | 0.329 |   2.905 |    2.409 | 
     | CTS_ccl_a_buf_00248   | A ^ -> X ^ | sky130_fd_sc_hd__clkbuf_8  | 0.291 |   3.196 |    2.700 | 
     | CTS_ccl_buf_00243     | A ^ -> X ^ | sky130_fd_sc_hd__clkbuf_16 | 0.278 |   3.474 |    2.978 | 
     | CTS_ccl_a_buf_00237   | A ^ -> X ^ | sky130_fd_sc_hd__clkbuf_16 | 0.281 |   3.755 |    3.259 | 
     | CTS_ccl_a_buf_00060   | A ^ -> X ^ | sky130_fd_sc_hd__clkbuf_8  | 0.274 |   4.029 |    3.533 | 
     | apb_prdata_o_reg[2]   | CLK ^      | sky130_fd_sc_hd__dfxtp_1   | 0.007 |   4.036 |    3.540 | 
     +----------------------------------------------------------------------------------------------+ 
Path 11: MET Setup Check with Pin u_core/u_dcache_gen_data_sram[2].u_data_sram/
clk0 
Endpoint:   u_core/u_dcache_gen_data_sram[2].u_data_sram/din0[8] (^) checked 
with  leading edge of 'clk_i'
Beginpoint: axi_rdata_i[8]                                       (^) triggered 
by  leading edge of 'clk_i'
Path Groups: {clk_i}
Analysis View: av_tt
Other End Arrival Time          4.134
- Setup                         0.103
+ Phase Shift                  13.333
+ CPPR Adjustment               0.000
- Uncertainty                   0.500
= Required Time                16.864
- Arrival Time                 16.365
= Slack Time                    0.499
     Clock Rise Edge                      0.000
     + Input Delay                        2.000
     + Drive Adjustment                   1.085
     + Source Insertion Delay             1.000
     = Beginpoint Arrival Time            4.085
     Timing Path:
     +----------------------------------------------------------------------------------------------------------------------------------------+ 
     |                      Instance                      |       Arc        |               Cell                | Delay | Arrival | Required | 
     |                                                    |                  |                                   |       |  Time   |   Time   | 
     |----------------------------------------------------+------------------+-----------------------------------+-------+---------+----------| 
     |                                                    | axi_rdata_i[8] ^ |                                   |       |   4.085 |    4.584 | 
     | u_core/FE_OFC783_axi_rdata_i_8                     | A ^ -> X ^       | sky130_fd_sc_hd__buf_8            | 8.809 |  12.894 |   13.393 | 
     | u_core/FE_OFC10115_axi_rdata_i_8                   | A ^ -> Y v       | sky130_fd_sc_hd__inv_12           | 0.156 |  13.049 |   13.549 | 
     | u_core/FE_OFC10116_axi_rdata_i_8                   | A v -> Y ^       | sky130_fd_sc_hd__clkinv_8         | 0.222 |  13.271 |   13.770 | 
     | u_core/FE_PDC9_FE_OFN605_axi_rdata_i_8             | A ^ -> Y v       | sky130_fd_sc_hd__inv_12           | 0.199 |  13.470 |   13.970 | 
     | u_core/FE_PDC8_FE_OFN605_axi_rdata_i_8             | A v -> Y ^       | sky130_fd_sc_hd__clkinv_16        | 0.366 |  13.837 |   14.336 | 
     | u_core/FE_OFC413_axi_rdata_i_8                     | A ^ -> X ^       | sky130_fd_sc_hd__buf_12           | 0.448 |  14.285 |   14.784 | 
     | u_core/g372619                                     | A1 ^ -> X ^      | sky130_fd_sc_hd__mux2_2           | 0.533 |  14.818 |   15.317 | 
     | u_core/FE_OFC8981_u_dcache_refill_buf_q_axi_word_q | A ^ -> X ^       | sky130_fd_sc_hd__buf_8            | 0.317 |  15.135 |   15.634 | 
     | __8                                                |                  |                                   |       |         |          | 
     | u_core/g372185                                     | A1_N ^ -> Y ^    | sky130_fd_sc_hd__o2bb2ai_1        | 0.197 |  15.332 |   15.831 | 
     | u_core/FE_OFC8254_n_13209                          | A ^ -> X ^       | sky130_fd_sc_hd__buf_2            | 0.658 |  15.990 |   16.490 | 
     | u_core/g371688                                     | A1 ^ -> X ^      | sky130_fd_sc_hd__a21o_4           | 0.372 |  16.362 |   16.861 | 
     | u_core/u_dcache_gen_data_sram[2].u_data_sram       | din0[8] ^        | sky130_sram_1kbyte_1rw1r_32x256_8 | 0.003 |  16.365 |   16.864 | 
     +----------------------------------------------------------------------------------------------------------------------------------------+ 
     Clock Rise Edge                      0.000
     + Drive Adjustment                   0.113
     + Source Insertion Delay             1.000
     = Beginpoint Arrival Time            1.113
     Other End Path:
     +----------------------------------------------------------------------------------------------------------------------------+ 
     |                   Instance                   |    Arc     |               Cell                | Delay | Arrival | Required | 
     |                                              |            |                                   |       |  Time   |   Time   | 
     |----------------------------------------------+------------+-----------------------------------+-------+---------+----------| 
     |                                              | clk_i ^    |                                   |       |   1.113 |    0.613 | 
     | CTS_cpc_drv_buf_00277                        | A ^ -> X ^ | sky130_fd_sc_hd__clkbuf_16        | 0.227 |   1.340 |    0.841 | 
     | CTS_cpc_drv_buf_00271                        | A ^ -> X ^ | sky130_fd_sc_hd__clkbuf_16        | 0.446 |   1.786 |    1.287 | 
     | CTS_cpc_drv_buf_00263                        | A ^ -> X ^ | sky130_fd_sc_hd__clkbuf_16        | 0.427 |   2.213 |    1.714 | 
     | CTS_ccl_buf_00251                            | A ^ -> X ^ | sky130_fd_sc_hd__clkbuf_16        | 0.363 |   2.576 |    2.077 | 
     | CTS_ccl_a_buf_00250                          | A ^ -> X ^ | sky130_fd_sc_hd__clkbuf_16        | 0.329 |   2.905 |    2.406 | 
     | CTS_ccl_buf_00246                            | A ^ -> X ^ | sky130_fd_sc_hd__clkbuf_16        | 0.315 |   3.221 |    2.721 | 
     | CTS_ccl_buf_00244                            | A ^ -> X ^ | sky130_fd_sc_hd__clkbuf_16        | 0.346 |   3.566 |    3.067 | 
     | u_core/CTS_ccl_a_buf_00230                   | A ^ -> X ^ | sky130_fd_sc_hd__clkbuf_8         | 0.299 |   3.866 |    3.366 | 
     | u_core/CTS_ccl_a_buf_00172                   | A ^ -> X ^ | sky130_fd_sc_hd__clkbuf_16        | 0.256 |   4.122 |    3.622 | 
     | u_core/u_dcache_gen_data_sram[2].u_data_sram | clk0 ^     | sky130_sram_1kbyte_1rw1r_32x256_8 | 0.013 |   4.134 |    3.635 | 
     +----------------------------------------------------------------------------------------------------------------------------+ 
Path 12: MET Setup Check with Pin apb_prdata_o_reg[6]/CLK 
Endpoint:   apb_prdata_o_reg[6]/D (^) checked with  leading edge of 'clk_i'
Beginpoint: apb_paddr_i[7]        (^) triggered by  leading edge of 'clk_i'
Path Groups: {clk_i}
Analysis View: av_tt
Other End Arrival Time          4.035
- Setup                         0.037
+ Phase Shift                  13.333
+ CPPR Adjustment               0.000
- Uncertainty                   0.500
= Required Time                16.830
- Arrival Time                 16.300
= Slack Time                    0.531
     Clock Rise Edge                      0.000
     + Input Delay                        3.500
     + Drive Adjustment                   0.481
     + Source Insertion Delay             1.000
     = Beginpoint Arrival Time            4.981
     Timing Path:
     +------------------------------------------------------------------------------------------------------------------------------+ 
     |                    Instance                     |       Arc        |            Cell            | Delay | Arrival | Required | 
     |                                                 |                  |                            |       |  Time   |   Time   | 
     |-------------------------------------------------+------------------+----------------------------+-------+---------+----------| 
     |                                                 | apb_paddr_i[7] ^ |                            |       |   4.981 |    5.512 | 
     | FE_OFC3009_apb_paddr_i_7                        | A ^ -> X ^       | sky130_fd_sc_hd__buf_2     | 3.734 |   8.714 |    9.245 | 
     | FE_OFC517_apb_paddr_i_7                         | A ^ -> X ^       | sky130_fd_sc_hd__buf_2     | 0.327 |   9.041 |    9.572 | 
     | FE_OFC2436_apb_paddr_i_7                        | A ^ -> Y v       | sky130_fd_sc_hd__clkinv_16 | 0.174 |   9.216 |    9.747 | 
     | FE_OFC2280_apb_paddr_i_7                        | A v -> Y ^       | sky130_fd_sc_hd__clkinv_16 | 0.529 |   9.744 |   10.275 | 
     | g24104                                          | B ^ -> X ^       | sky130_fd_sc_hd__or2_2     | 0.266 |  10.010 |   10.541 | 
     | g24101                                          | A_N ^ -> Y ^     | sky130_fd_sc_hd__nand2b_1  | 0.219 |  10.229 |   10.760 | 
     | g24099                                          | A ^ -> Y v       | sky130_fd_sc_hd__nand3_1   | 0.098 |  10.327 |   10.858 | 
     | g24098                                          | C v -> X v       | sky130_fd_sc_hd__or4b_1    | 0.554 |  10.881 |   11.412 | 
     | g24097                                          | C v -> Y ^       | sky130_fd_sc_hd__nor3_1    | 0.182 |  11.063 |   11.594 | 
     | FE_OFC1394_n_1435                               | A ^ -> X ^       | sky130_fd_sc_hd__buf_4     | 0.398 |  11.461 |   11.992 | 
     | g2                                              | B_N ^ -> Y ^     | sky130_fd_sc_hd__nor2b_1   | 0.433 |  11.894 |   12.425 | 
     | u_core/g522                                     | B_N ^ -> Y ^     | sky130_fd_sc_hd__nor2b_1   | 0.242 |  12.136 |   12.667 | 
     | u_core/g519                                     | B_N ^ -> Y ^     | sky130_fd_sc_hd__nor2b_1   | 0.157 |  12.293 |   12.824 | 
     | u_core/FE_OFC4198_n_15133                       | A ^ -> X ^       | sky130_fd_sc_hd__buf_2     | 0.313 |  12.606 |   13.137 | 
     | u_core/g490                                     | B ^ -> X ^       | sky130_fd_sc_hd__and2b_2   | 0.424 |  13.030 |   13.561 | 
     | u_core/FE_OFC1781_u_regfile_n_5906              | A ^ -> X ^       | sky130_fd_sc_hd__buf_6     | 0.422 |  13.452 |   13.983 | 
     | u_core/FE_OFC1782_u_regfile_n_5906              | A ^ -> X ^       | sky130_fd_sc_hd__buf_6     | 0.476 |  13.928 |   14.459 | 
     | u_core/g3523                                    | B1 ^ -> Y v      | sky130_fd_sc_hd__a221oi_1  | 0.185 |  14.113 |   14.644 | 
     | u_core/FE_OFC4619_n_16250                       | A v -> X v       | sky130_fd_sc_hd__clkbuf_1  | 0.160 |  14.273 |   14.804 | 
     | u_core/g3431                                    | B v -> Y ^       | sky130_fd_sc_hd__nand4_1   | 0.198 |  14.471 |   15.002 | 
     | u_core/FE_OFC7227_n_16342                       | A ^ -> X ^       | sky130_fd_sc_hd__buf_2     | 0.227 |  14.698 |   15.228 | 
     | u_core/g3403                                    | D ^ -> X ^       | sky130_fd_sc_hd__or4_1     | 0.431 |  15.129 |   15.660 | 
     | u_core/FE_OFC4705_u_regfile_regs_dbg_rd_addr__6 | A ^ -> X ^       | sky130_fd_sc_hd__buf_6     | 0.399 |  15.528 |   16.059 | 
     | u_core/g373137                                  | B_N ^ -> Y ^     | sky130_fd_sc_hd__nor2b_1   | 0.220 |  15.748 |   16.279 | 
     | FE_OFC1699_dbg_reg_rd_data_6                    | A ^ -> X ^       | sky130_fd_sc_hd__buf_2     | 0.363 |  16.112 |   16.643 | 
     | g44818                                          | A1 ^ -> X ^      | sky130_fd_sc_hd__a21o_1    | 0.188 |  16.300 |   16.830 | 
     | apb_prdata_o_reg[6]                             | D ^              | sky130_fd_sc_hd__dfxtp_1   | 0.000 |  16.300 |   16.830 | 
     +------------------------------------------------------------------------------------------------------------------------------+ 
     Clock Rise Edge                      0.000
     + Drive Adjustment                   0.113
     + Source Insertion Delay             1.000
     = Beginpoint Arrival Time            1.113
     Other End Path:
     +----------------------------------------------------------------------------------------------+ 
     |       Instance        |    Arc     |            Cell            | Delay | Arrival | Required | 
     |                       |            |                            |       |  Time   |   Time   | 
     |-----------------------+------------+----------------------------+-------+---------+----------| 
     |                       | clk_i ^    |                            |       |   1.113 |    0.582 | 
     | CTS_cpc_drv_buf_00277 | A ^ -> X ^ | sky130_fd_sc_hd__clkbuf_16 | 0.227 |   1.340 |    0.809 | 
     | CTS_cpc_drv_buf_00271 | A ^ -> X ^ | sky130_fd_sc_hd__clkbuf_16 | 0.446 |   1.786 |    1.255 | 
     | CTS_cpc_drv_buf_00263 | A ^ -> X ^ | sky130_fd_sc_hd__clkbuf_16 | 0.427 |   2.213 |    1.682 | 
     | CTS_ccl_buf_00251     | A ^ -> X ^ | sky130_fd_sc_hd__clkbuf_16 | 0.363 |   2.576 |    2.045 | 
     | CTS_ccl_a_buf_00250   | A ^ -> X ^ | sky130_fd_sc_hd__clkbuf_16 | 0.329 |   2.905 |    2.374 | 
     | CTS_ccl_a_buf_00248   | A ^ -> X ^ | sky130_fd_sc_hd__clkbuf_8  | 0.291 |   3.196 |    2.665 | 
     | CTS_ccl_buf_00245     | A ^ -> X ^ | sky130_fd_sc_hd__clkbuf_16 | 0.293 |   3.489 |    2.958 | 
     | CTS_ccl_a_buf_00220   | A ^ -> X ^ | sky130_fd_sc_hd__clkbuf_8  | 0.273 |   3.761 |    3.230 | 
     | CTS_ccl_a_buf_00058   | A ^ -> X ^ | sky130_fd_sc_hd__clkbuf_8  | 0.268 |   4.029 |    3.498 | 
     | apb_prdata_o_reg[6]   | CLK ^      | sky130_fd_sc_hd__dfxtp_1   | 0.006 |   4.035 |    3.504 | 
     +----------------------------------------------------------------------------------------------+ 
Path 13: MET Late External Delay Assertion 
Endpoint:   apb_prdata_o[2]       (v) checked with  leading edge of 'clk_i'
Beginpoint: apb_prdata_o_reg[2]/Q (v) triggered by  leading edge of 'clk_i'
Path Groups: {clk_i}
Analysis View: av_tt
Other End Arrival Time          0.000
+ Source Insertion Delay        1.000
- External Delay                3.500
+ Phase Shift                  13.333
+ CPPR Adjustment               0.000
- Uncertainty                   0.500
= Required Time                10.333
- Arrival Time                  9.761
= Slack Time                    0.572
     Clock Rise Edge                      0.000
     + Drive Adjustment                   0.113
     + Source Insertion Delay            -1.882
     = Beginpoint Arrival Time           -1.769
     +--------------------------------------------------------------------------------------------------------------------+ 
     |               Instance               |        Arc        |            Cell            | Delay | Arrival | Required | 
     |                                      |                   |                            |       |  Time   |   Time   | 
     |--------------------------------------+-------------------+----------------------------+-------+---------+----------| 
     |                                      | clk_i ^           |                            |       |  -1.769 |   -1.198 | 
     | CTS_cpc_drv_buf_00277                | A ^ -> X ^        | sky130_fd_sc_hd__clkbuf_16 | 0.250 |  -1.520 |   -0.948 | 
     | CTS_cpc_drv_buf_00271                | A ^ -> X ^        | sky130_fd_sc_hd__clkbuf_16 | 0.520 |  -0.999 |   -0.428 | 
     | CTS_cpc_drv_buf_00263                | A ^ -> X ^        | sky130_fd_sc_hd__clkbuf_16 | 0.452 |  -0.547 |    0.024 | 
     | CTS_ccl_buf_00251                    | A ^ -> X ^        | sky130_fd_sc_hd__clkbuf_16 | 0.392 |  -0.155 |    0.416 | 
     | CTS_ccl_a_buf_00250                  | A ^ -> X ^        | sky130_fd_sc_hd__clkbuf_16 | 0.353 |   0.198 |    0.770 | 
     | CTS_ccl_a_buf_00248                  | A ^ -> X ^        | sky130_fd_sc_hd__clkbuf_8  | 0.349 |   0.547 |    1.118 | 
     | CTS_ccl_buf_00243                    | A ^ -> X ^        | sky130_fd_sc_hd__clkbuf_16 | 0.281 |   0.828 |    1.399 | 
     | CTS_ccl_a_buf_00237                  | A ^ -> X ^        | sky130_fd_sc_hd__clkbuf_16 | 0.281 |   1.109 |    1.681 | 
     | CTS_ccl_a_buf_00060                  | A ^ -> X ^        | sky130_fd_sc_hd__clkbuf_8  | 0.274 |   1.383 |    1.954 | 
     | apb_prdata_o_reg[2]                  | CLK ^ -> Q v      | sky130_fd_sc_hd__dfxtp_1   | 0.407 |   1.789 |    2.361 | 
     | FE_OFC2688_apb_prdata_o_2            | A v -> Y ^        | sky130_fd_sc_hd__inv_2     | 0.306 |   2.095 |    2.667 | 
     | FE_OFC2689_apb_prdata_o_2            | A ^ -> Y v        | sky130_fd_sc_hd__clkinv_8  | 0.282 |   2.378 |    2.950 | 
     | FE_OFC7439_apb_prdata_o_2            | A v -> Y ^        | sky130_fd_sc_hd__inv_6     | 0.500 |   2.878 |    3.449 | 
     | FE_OFC7440_apb_prdata_o_2            | A ^ -> Y v        | sky130_fd_sc_hd__inv_4     | 0.295 |   3.172 |    3.744 | 
     | FE_OFC60_apb_prdata_o_2              | A v -> X v        | sky130_fd_sc_hd__buf_6     | 0.314 |   3.486 |    4.058 | 
     | FE_OFC2138_apb_prdata_o_2            | A v -> Y ^        | sky130_fd_sc_hd__inv_12    | 0.446 |   3.932 |    4.504 | 
     | FE_PDC732_FE_OFN62_apb_prdata_o_2    | A ^ -> X ^        | sky130_fd_sc_hd__buf_12    | 0.518 |   4.450 |    5.021 | 
     | FE_OFC1443_apb_prdata_o_2            | A ^ -> Y v        | sky130_fd_sc_hd__inv_6     | 0.253 |   4.703 |    5.275 | 
     | FE_OFC1444_apb_prdata_o_2            | A v -> X v        | sky130_fd_sc_hd__bufbuf_8  | 0.456 |   5.159 |    5.730 | 
     | FE_OFC2833_apb_prdata_o_2            | A v -> Y ^        | sky130_fd_sc_hd__clkinv_16 | 0.215 |   5.374 |    5.945 | 
     | FE_PDC693_FE_OFN19503_apb_prdata_o_2 | A ^ -> X ^        | sky130_fd_sc_hd__buf_4     | 0.775 |   6.148 |    6.720 | 
     | FE_OFC2834_apb_prdata_o_2            | A ^ -> Y v        | sky130_fd_sc_hd__clkinv_16 | 0.346 |   6.494 |    7.066 | 
     | FE_OFC2835_apb_prdata_o_2            | A v -> Y ^        | sky130_fd_sc_hd__clkinv_16 | 0.609 |   7.103 |    7.675 | 
     | FE_PDC756_FE_OFN19505_apb_prdata_o_2 | A ^ -> X ^        | sky130_fd_sc_hd__buf_12    | 0.459 |   7.563 |    8.134 | 
     | FE_OFC2836_apb_prdata_o_2            | A ^ -> Y v        | sky130_fd_sc_hd__clkinv_4  | 0.513 |   8.076 |    8.647 | 
     | FE_PDC759_apb_prdata_o_2             | A v -> X v        | sky130_fd_sc_hd__buf_4     | 0.465 |   8.540 |    9.112 | 
     | FE_PDC563_apb_prdata_o_2             | A v -> X v        | sky130_fd_sc_hd__clkbuf_16 | 0.266 |   8.807 |    9.378 | 
     | FE_PDC760_apb_prdata_o_2             | A v -> X v        | sky130_fd_sc_hd__clkbuf_16 | 0.531 |   9.338 |    9.909 | 
     | FE_PDC803_apb_prdata_o_2             | A v -> X v        | sky130_fd_sc_hd__buf_4     | 0.338 |   9.675 |   10.247 | 
     |                                      | apb_prdata_o[2] v |                            | 0.086 |   9.761 |   10.333 | 
     +--------------------------------------------------------------------------------------------------------------------+ 
Path 14: MET Setup Check with Pin u_core/u_dcache_gen_data_sram[1].u_data_sram/
clk0 
Endpoint:   u_core/u_dcache_gen_data_sram[1].u_data_sram/din0[8] (^) checked 
with  leading edge of 'clk_i'
Beginpoint: axi_rdata_i[8]                                       (^) triggered 
by  leading edge of 'clk_i'
Path Groups: {clk_i}
Analysis View: av_tt
Other End Arrival Time          4.068
- Setup                         0.103
+ Phase Shift                  13.333
+ CPPR Adjustment               0.000
- Uncertainty                   0.500
= Required Time                16.798
- Arrival Time                 16.225
= Slack Time                    0.572
     Clock Rise Edge                      0.000
     + Input Delay                        2.000
     + Drive Adjustment                   1.085
     + Source Insertion Delay             1.000
     = Beginpoint Arrival Time            4.085
     Timing Path:
     +----------------------------------------------------------------------------------------------------------------------------------------+ 
     |                      Instance                      |       Arc        |               Cell                | Delay | Arrival | Required | 
     |                                                    |                  |                                   |       |  Time   |   Time   | 
     |----------------------------------------------------+------------------+-----------------------------------+-------+---------+----------| 
     |                                                    | axi_rdata_i[8] ^ |                                   |       |   4.085 |    4.657 | 
     | u_core/FE_OFC783_axi_rdata_i_8                     | A ^ -> X ^       | sky130_fd_sc_hd__buf_8            | 8.809 |  12.893 |   13.466 | 
     | u_core/FE_OFC10115_axi_rdata_i_8                   | A ^ -> Y v       | sky130_fd_sc_hd__inv_12           | 0.156 |  13.049 |   13.622 | 
     | u_core/FE_OFC10116_axi_rdata_i_8                   | A v -> Y ^       | sky130_fd_sc_hd__clkinv_8         | 0.222 |  13.271 |   13.843 | 
     | u_core/FE_PDC9_FE_OFN605_axi_rdata_i_8             | A ^ -> Y v       | sky130_fd_sc_hd__inv_12           | 0.199 |  13.470 |   14.043 | 
     | u_core/FE_PDC8_FE_OFN605_axi_rdata_i_8             | A v -> Y ^       | sky130_fd_sc_hd__clkinv_16        | 0.366 |  13.836 |   14.409 | 
     | u_core/FE_OFC413_axi_rdata_i_8                     | A ^ -> X ^       | sky130_fd_sc_hd__buf_12           | 0.448 |  14.285 |   14.857 | 
     | u_core/g372619                                     | A1 ^ -> X ^      | sky130_fd_sc_hd__mux2_2           | 0.533 |  14.818 |   15.390 | 
     | u_core/FE_OFC8981_u_dcache_refill_buf_q_axi_word_q | A ^ -> X ^       | sky130_fd_sc_hd__buf_8            | 0.317 |  15.135 |   15.707 | 
     | __8                                                |                  |                                   |       |         |          | 
     | u_core/g372153                                     | A1_N ^ -> Y ^    | sky130_fd_sc_hd__o2bb2ai_1        | 0.203 |  15.338 |   15.910 | 
     | u_core/FE_OFC8251_n_13241                          | A ^ -> X ^       | sky130_fd_sc_hd__buf_4            | 0.264 |  15.602 |   16.174 | 
     | u_core/g371724                                     | A1 ^ -> X ^      | sky130_fd_sc_hd__a21o_1           | 0.153 |  15.755 |   16.327 | 
     | u_core/FE_OFC3980_u_dcache_gen_data_sram_1__d_din0 | A ^ -> X ^       | sky130_fd_sc_hd__buf_6            | 0.460 |  16.215 |   16.788 | 
     | _m_8                                               |                  |                                   |       |         |          | 
     | u_core/u_dcache_gen_data_sram[1].u_data_sram       | din0[8] ^        | sky130_sram_1kbyte_1rw1r_32x256_8 | 0.010 |  16.225 |   16.798 | 
     +----------------------------------------------------------------------------------------------------------------------------------------+ 
     Clock Rise Edge                      0.000
     + Drive Adjustment                   0.113
     + Source Insertion Delay             1.000
     = Beginpoint Arrival Time            1.113
     Other End Path:
     +----------------------------------------------------------------------------------------------------------------------------+ 
     |                   Instance                   |    Arc     |               Cell                | Delay | Arrival | Required | 
     |                                              |            |                                   |       |  Time   |   Time   | 
     |----------------------------------------------+------------+-----------------------------------+-------+---------+----------| 
     |                                              | clk_i ^    |                                   |       |   1.113 |    0.540 | 
     | CTS_cpc_drv_buf_00277                        | A ^ -> X ^ | sky130_fd_sc_hd__clkbuf_16        | 0.227 |   1.340 |    0.768 | 
     | CTS_cpc_drv_buf_00271                        | A ^ -> X ^ | sky130_fd_sc_hd__clkbuf_16        | 0.446 |   1.786 |    1.214 | 
     | CTS_cpc_drv_buf_00263                        | A ^ -> X ^ | sky130_fd_sc_hd__clkbuf_16        | 0.427 |   2.213 |    1.641 | 
     | CTS_ccl_buf_00251                            | A ^ -> X ^ | sky130_fd_sc_hd__clkbuf_16        | 0.363 |   2.576 |    2.004 | 
     | CTS_ccl_a_buf_00250                          | A ^ -> X ^ | sky130_fd_sc_hd__clkbuf_16        | 0.329 |   2.905 |    2.333 | 
     | CTS_ccl_buf_00246                            | A ^ -> X ^ | sky130_fd_sc_hd__clkbuf_16        | 0.315 |   3.221 |    2.648 | 
     | CTS_ccl_buf_00244                            | A ^ -> X ^ | sky130_fd_sc_hd__clkbuf_16        | 0.346 |   3.566 |    2.994 | 
     | CTS_ccl_a_buf_00238                          | A ^ -> X ^ | sky130_fd_sc_hd__clkbuf_16        | 0.260 |   3.826 |    3.254 | 
     | u_core/CTS_ccl_a_buf_00142                   | A ^ -> X ^ | sky130_fd_sc_hd__clkbuf_16        | 0.236 |   4.062 |    3.490 | 
     | u_core/u_dcache_gen_data_sram[1].u_data_sram | clk0 ^     | sky130_sram_1kbyte_1rw1r_32x256_8 | 0.006 |   4.068 |    3.495 | 
     +----------------------------------------------------------------------------------------------------------------------------+ 
Path 15: MET Setup Check with Pin apb_prdata_o_reg[13]/CLK 
Endpoint:   apb_prdata_o_reg[13]/D (v) checked with  leading edge of 'clk_i'
Beginpoint: apb_paddr_i[7]         (^) triggered by  leading edge of 'clk_i'
Path Groups: {clk_i}
Analysis View: av_tt
Other End Arrival Time          4.014
- Setup                         0.128
+ Phase Shift                  13.333
+ CPPR Adjustment               0.000
- Uncertainty                   0.500
= Required Time                16.719
- Arrival Time                 16.090
= Slack Time                    0.628
     Clock Rise Edge                      0.000
     + Input Delay                        3.500
     + Drive Adjustment                   0.481
     + Source Insertion Delay             1.000
     = Beginpoint Arrival Time            4.981
     Timing Path:
     +-------------------------------------------------------------------------------------------------------------------------------+ 
     |                     Instance                     |       Arc        |            Cell            | Delay | Arrival | Required | 
     |                                                  |                  |                            |       |  Time   |   Time   | 
     |--------------------------------------------------+------------------+----------------------------+-------+---------+----------| 
     |                                                  | apb_paddr_i[7] ^ |                            |       |   4.981 |    5.609 | 
     | FE_OFC3009_apb_paddr_i_7                         | A ^ -> X ^       | sky130_fd_sc_hd__buf_2     | 3.734 |   8.715 |    9.343 | 
     | FE_OFC517_apb_paddr_i_7                          | A ^ -> X ^       | sky130_fd_sc_hd__buf_2     | 0.327 |   9.041 |    9.670 | 
     | FE_OFC2436_apb_paddr_i_7                         | A ^ -> Y v       | sky130_fd_sc_hd__clkinv_16 | 0.174 |   9.216 |    9.844 | 
     | FE_OFC2280_apb_paddr_i_7                         | A v -> Y ^       | sky130_fd_sc_hd__clkinv_16 | 0.529 |   9.744 |   10.373 | 
     | g24104                                           | B ^ -> X ^       | sky130_fd_sc_hd__or2_2     | 0.266 |  10.010 |   10.639 | 
     | g24101                                           | A_N ^ -> Y ^     | sky130_fd_sc_hd__nand2b_1  | 0.219 |  10.229 |   10.858 | 
     | g24099                                           | A ^ -> Y v       | sky130_fd_sc_hd__nand3_1   | 0.098 |  10.327 |   10.955 | 
     | g24098                                           | C v -> X v       | sky130_fd_sc_hd__or4b_1    | 0.554 |  10.881 |   11.509 | 
     | g24097                                           | C v -> Y ^       | sky130_fd_sc_hd__nor3_1    | 0.182 |  11.063 |   11.691 | 
     | FE_OFC1394_n_1435                                | A ^ -> X ^       | sky130_fd_sc_hd__buf_4     | 0.398 |  11.461 |   12.089 | 
     | g24095                                           | A ^ -> X ^       | sky130_fd_sc_hd__and2_1    | 0.463 |  11.924 |   12.552 | 
     | u_core/g524                                      | A_N ^ -> X v     | sky130_fd_sc_hd__and2b_2   | 0.412 |  12.336 |   12.964 | 
     | u_core/g510                                      | B v -> X v       | sky130_fd_sc_hd__and2_2    | 0.382 |  12.717 |   13.346 | 
     | u_core/FE_OFC1798_u_regfile_n_5911               | A v -> X v       | sky130_fd_sc_hd__buf_6     | 0.262 |  12.980 |   13.608 | 
     | u_core/FE_OFC1799_u_regfile_n_5911               | A v -> X v       | sky130_fd_sc_hd__buf_4     | 0.295 |  13.275 |   13.904 | 
     | u_core/g3904                                     | A1 v -> X v      | sky130_fd_sc_hd__a22o_1    | 0.242 |  13.518 |   14.146 | 
     | u_core/g3611                                     | C1 v -> Y ^      | sky130_fd_sc_hd__a221oi_1  | 0.309 |  13.826 |   14.455 | 
     | u_core/g3449                                     | A ^ -> Y v       | sky130_fd_sc_hd__nand4_1   | 0.315 |  14.141 |   14.770 | 
     | u_core/g3420                                     | D v -> X v       | sky130_fd_sc_hd__or4_2     | 0.906 |  15.047 |   15.676 | 
     | u_core/FE_OFC1714_u_regfile_regs_dbg_rd_addr__13 | A v -> X v       | sky130_fd_sc_hd__buf_4     | 0.335 |  15.383 |   16.011 | 
     | u_core/g373128                                   | B_N v -> Y v     | sky130_fd_sc_hd__nor2b_2   | 0.222 |  15.605 |   16.234 | 
     | g45585                                           | A v -> Y ^       | sky130_fd_sc_hd__nand2_1   | 0.321 |  15.926 |   16.554 | 
     | g44813                                           | A ^ -> Y v       | sky130_fd_sc_hd__nand4_1   | 0.164 |  16.090 |   16.718 | 
     | apb_prdata_o_reg[13]                             | D v              | sky130_fd_sc_hd__dfxtp_4   | 0.000 |  16.090 |   16.719 | 
     +-------------------------------------------------------------------------------------------------------------------------------+ 
     Clock Rise Edge                      0.000
     + Drive Adjustment                   0.113
     + Source Insertion Delay             1.000
     = Beginpoint Arrival Time            1.113
     Other End Path:
     +----------------------------------------------------------------------------------------------+ 
     |       Instance        |    Arc     |            Cell            | Delay | Arrival | Required | 
     |                       |            |                            |       |  Time   |   Time   | 
     |-----------------------+------------+----------------------------+-------+---------+----------| 
     |                       | clk_i ^    |                            |       |   1.113 |    0.484 | 
     | CTS_cpc_drv_buf_00277 | A ^ -> X ^ | sky130_fd_sc_hd__clkbuf_16 | 0.227 |   1.340 |    0.712 | 
     | CTS_cpc_drv_buf_00271 | A ^ -> X ^ | sky130_fd_sc_hd__clkbuf_16 | 0.446 |   1.786 |    1.158 | 
     | CTS_cpc_drv_buf_00263 | A ^ -> X ^ | sky130_fd_sc_hd__clkbuf_16 | 0.427 |   2.213 |    1.585 | 
     | CTS_ccl_buf_00251     | A ^ -> X ^ | sky130_fd_sc_hd__clkbuf_16 | 0.363 |   2.576 |    1.948 | 
     | CTS_ccl_a_buf_00250   | A ^ -> X ^ | sky130_fd_sc_hd__clkbuf_16 | 0.329 |   2.905 |    2.277 | 
     | CTS_ccl_a_buf_00248   | A ^ -> X ^ | sky130_fd_sc_hd__clkbuf_8  | 0.291 |   3.196 |    2.568 | 
     | CTS_ccl_buf_00243     | A ^ -> X ^ | sky130_fd_sc_hd__clkbuf_16 | 0.278 |   3.474 |    2.846 | 
     | CTS_ccl_a_buf_00236   | A ^ -> X ^ | sky130_fd_sc_hd__clkbuf_16 | 0.272 |   3.746 |    3.118 | 
     | CTS_ccl_a_buf_00056   | A ^ -> X ^ | sky130_fd_sc_hd__clkbuf_8  | 0.263 |   4.009 |    3.381 | 
     | apb_prdata_o_reg[13]  | CLK ^      | sky130_fd_sc_hd__dfxtp_4   | 0.004 |   4.014 |    3.385 | 
     +----------------------------------------------------------------------------------------------+ 
Path 16: MET Setup Check with Pin apb_prdata_o_reg[5]/CLK 
Endpoint:   apb_prdata_o_reg[5]/D (^) checked with  leading edge of 'clk_i'
Beginpoint: apb_paddr_i[7]        (^) triggered by  leading edge of 'clk_i'
Path Groups: {clk_i}
Analysis View: av_tt
Other End Arrival Time          4.035
- Setup                         0.036
+ Phase Shift                  13.333
+ CPPR Adjustment               0.000
- Uncertainty                   0.500
= Required Time                16.832
- Arrival Time                 16.193
= Slack Time                    0.639
     Clock Rise Edge                      0.000
     + Input Delay                        3.500
     + Drive Adjustment                   0.481
     + Source Insertion Delay             1.000
     = Beginpoint Arrival Time            4.981
     Timing Path:
     +------------------------------------------------------------------------------------------------------------------------------+ 
     |                    Instance                     |       Arc        |            Cell            | Delay | Arrival | Required | 
     |                                                 |                  |                            |       |  Time   |   Time   | 
     |-------------------------------------------------+------------------+----------------------------+-------+---------+----------| 
     |                                                 | apb_paddr_i[7] ^ |                            |       |   4.981 |    5.620 | 
     | FE_OFC3009_apb_paddr_i_7                        | A ^ -> X ^       | sky130_fd_sc_hd__buf_2     | 3.734 |   8.715 |    9.353 | 
     | FE_OFC517_apb_paddr_i_7                         | A ^ -> X ^       | sky130_fd_sc_hd__buf_2     | 0.327 |   9.041 |    9.680 | 
     | FE_OFC2436_apb_paddr_i_7                        | A ^ -> Y v       | sky130_fd_sc_hd__clkinv_16 | 0.174 |   9.216 |    9.855 | 
     | FE_OFC2280_apb_paddr_i_7                        | A v -> Y ^       | sky130_fd_sc_hd__clkinv_16 | 0.529 |   9.744 |   10.383 | 
     | g24104                                          | B ^ -> X ^       | sky130_fd_sc_hd__or2_2     | 0.266 |  10.010 |   10.649 | 
     | g24101                                          | A_N ^ -> Y ^     | sky130_fd_sc_hd__nand2b_1  | 0.219 |  10.229 |   10.868 | 
     | g24099                                          | A ^ -> Y v       | sky130_fd_sc_hd__nand3_1   | 0.098 |  10.327 |   10.966 | 
     | g24098                                          | C v -> X v       | sky130_fd_sc_hd__or4b_1    | 0.554 |  10.881 |   11.520 | 
     | g24097                                          | C v -> Y ^       | sky130_fd_sc_hd__nor3_1    | 0.182 |  11.063 |   11.702 | 
     | FE_OFC1394_n_1435                               | A ^ -> X ^       | sky130_fd_sc_hd__buf_4     | 0.398 |  11.461 |   12.100 | 
     | g2                                              | B_N ^ -> Y ^     | sky130_fd_sc_hd__nor2b_1   | 0.433 |  11.894 |   12.533 | 
     | u_core/g522                                     | B_N ^ -> Y ^     | sky130_fd_sc_hd__nor2b_1   | 0.242 |  12.136 |   12.775 | 
     | u_core/g519                                     | B_N ^ -> Y ^     | sky130_fd_sc_hd__nor2b_1   | 0.157 |  12.293 |   12.932 | 
     | u_core/FE_OFC4198_n_15133                       | A ^ -> X ^       | sky130_fd_sc_hd__buf_2     | 0.313 |  12.606 |   13.245 | 
     | u_core/g490                                     | B ^ -> X ^       | sky130_fd_sc_hd__and2b_2   | 0.424 |  13.030 |   13.669 | 
     | u_core/FE_OFC1781_u_regfile_n_5906              | A ^ -> X ^       | sky130_fd_sc_hd__buf_6     | 0.422 |  13.452 |   14.091 | 
     | u_core/FE_OFC1782_u_regfile_n_5906              | A ^ -> X ^       | sky130_fd_sc_hd__buf_6     | 0.476 |  13.928 |   14.567 | 
     | u_core/g3532                                    | B1 ^ -> Y v      | sky130_fd_sc_hd__a221oi_1  | 0.211 |  14.139 |   14.777 | 
     | u_core/FE_OFC4618_n_16241                       | A v -> X v       | sky130_fd_sc_hd__clkbuf_1  | 0.196 |  14.334 |   14.973 | 
     | u_core/g3433                                    | B v -> Y ^       | sky130_fd_sc_hd__nand4_1   | 0.257 |  14.591 |   15.230 | 
     | u_core/g3404                                    | D ^ -> X ^       | sky130_fd_sc_hd__or4_4     | 0.311 |  14.902 |   15.541 | 
     | u_core/FE_OFC7672_u_regfile_regs_dbg_rd_addr__5 | A ^ -> X ^       | sky130_fd_sc_hd__buf_4     | 0.434 |  15.335 |   15.974 | 
     | u_core/g373138                                  | B_N ^ -> Y ^     | sky130_fd_sc_hd__nor2b_1   | 0.330 |  15.665 |   16.304 | 
     | FE_OFC4701_dbg_reg_rd_data_5                    | A ^ -> X ^       | sky130_fd_sc_hd__buf_2     | 0.359 |  16.024 |   16.663 | 
     | g44819                                          | A1 ^ -> X ^      | sky130_fd_sc_hd__a21o_1    | 0.169 |  16.193 |   16.832 | 
     | apb_prdata_o_reg[5]                             | D ^              | sky130_fd_sc_hd__dfxtp_1   | 0.000 |  16.193 |   16.832 | 
     +------------------------------------------------------------------------------------------------------------------------------+ 
     Clock Rise Edge                      0.000
     + Drive Adjustment                   0.113
     + Source Insertion Delay             1.000
     = Beginpoint Arrival Time            1.113
     Other End Path:
     +----------------------------------------------------------------------------------------------+ 
     |       Instance        |    Arc     |            Cell            | Delay | Arrival | Required | 
     |                       |            |                            |       |  Time   |   Time   | 
     |-----------------------+------------+----------------------------+-------+---------+----------| 
     |                       | clk_i ^    |                            |       |   1.113 |    0.474 | 
     | CTS_cpc_drv_buf_00277 | A ^ -> X ^ | sky130_fd_sc_hd__clkbuf_16 | 0.227 |   1.340 |    0.701 | 
     | CTS_cpc_drv_buf_00271 | A ^ -> X ^ | sky130_fd_sc_hd__clkbuf_16 | 0.446 |   1.786 |    1.147 | 
     | CTS_cpc_drv_buf_00263 | A ^ -> X ^ | sky130_fd_sc_hd__clkbuf_16 | 0.427 |   2.213 |    1.575 | 
     | CTS_ccl_buf_00251     | A ^ -> X ^ | sky130_fd_sc_hd__clkbuf_16 | 0.363 |   2.576 |    1.937 | 
     | CTS_ccl_a_buf_00250   | A ^ -> X ^ | sky130_fd_sc_hd__clkbuf_16 | 0.329 |   2.905 |    2.266 | 
     | CTS_ccl_a_buf_00248   | A ^ -> X ^ | sky130_fd_sc_hd__clkbuf_8  | 0.291 |   3.196 |    2.557 | 
     | CTS_ccl_buf_00245     | A ^ -> X ^ | sky130_fd_sc_hd__clkbuf_16 | 0.293 |   3.489 |    2.850 | 
     | CTS_ccl_a_buf_00220   | A ^ -> X ^ | sky130_fd_sc_hd__clkbuf_8  | 0.273 |   3.761 |    3.123 | 
     | CTS_ccl_a_buf_00058   | A ^ -> X ^ | sky130_fd_sc_hd__clkbuf_8  | 0.268 |   4.029 |    3.390 | 
     | apb_prdata_o_reg[5]   | CLK ^      | sky130_fd_sc_hd__dfxtp_1   | 0.006 |   4.035 |    3.396 | 
     +----------------------------------------------------------------------------------------------+ 
Path 17: MET Setup Check with Pin apb_prdata_o_reg[9]/CLK 
Endpoint:   apb_prdata_o_reg[9]/D (v) checked with  leading edge of 'clk_i'
Beginpoint: apb_paddr_i[7]        (^) triggered by  leading edge of 'clk_i'
Path Groups: {clk_i}
Analysis View: av_tt
Other End Arrival Time          4.013
- Setup                         0.118
+ Phase Shift                  13.333
+ CPPR Adjustment               0.000
- Uncertainty                   0.500
= Required Time                16.728
- Arrival Time                 16.061
= Slack Time                    0.668
     Clock Rise Edge                      0.000
     + Input Delay                        3.500
     + Drive Adjustment                   0.481
     + Source Insertion Delay             1.000
     = Beginpoint Arrival Time            4.981
     Timing Path:
     +-----------------------------------------------------------------------------------------------------------------------------+ 
     |                    Instance                    |       Arc        |            Cell            | Delay | Arrival | Required | 
     |                                                |                  |                            |       |  Time   |   Time   | 
     |------------------------------------------------+------------------+----------------------------+-------+---------+----------| 
     |                                                | apb_paddr_i[7] ^ |                            |       |   4.981 |    5.648 | 
     | FE_OFC3009_apb_paddr_i_7                       | A ^ -> X ^       | sky130_fd_sc_hd__buf_2     | 3.734 |   8.715 |    9.382 | 
     | FE_OFC517_apb_paddr_i_7                        | A ^ -> X ^       | sky130_fd_sc_hd__buf_2     | 0.327 |   9.041 |    9.709 | 
     | FE_OFC2436_apb_paddr_i_7                       | A ^ -> Y v       | sky130_fd_sc_hd__clkinv_16 | 0.174 |   9.216 |    9.883 | 
     | FE_OFC2280_apb_paddr_i_7                       | A v -> Y ^       | sky130_fd_sc_hd__clkinv_16 | 0.529 |   9.744 |   10.412 | 
     | g24104                                         | B ^ -> X ^       | sky130_fd_sc_hd__or2_2     | 0.266 |  10.010 |   10.678 | 
     | g24101                                         | A_N ^ -> Y ^     | sky130_fd_sc_hd__nand2b_1  | 0.219 |  10.229 |   10.897 | 
     | g24099                                         | A ^ -> Y v       | sky130_fd_sc_hd__nand3_1   | 0.098 |  10.327 |   10.994 | 
     | g24098                                         | C v -> X v       | sky130_fd_sc_hd__or4b_1    | 0.554 |  10.881 |   11.548 | 
     | g24097                                         | C v -> Y ^       | sky130_fd_sc_hd__nor3_1    | 0.182 |  11.063 |   11.731 | 
     | FE_OFC1394_n_1435                              | A ^ -> X ^       | sky130_fd_sc_hd__buf_4     | 0.398 |  11.461 |   12.129 | 
     | g24095                                         | A ^ -> X ^       | sky130_fd_sc_hd__and2_1    | 0.463 |  11.924 |   12.592 | 
     | u_core/g524                                    | A_N ^ -> X v     | sky130_fd_sc_hd__and2b_2   | 0.412 |  12.336 |   13.003 | 
     | u_core/g497                                    | B v -> X v       | sky130_fd_sc_hd__and2_4    | 0.313 |  12.649 |   13.317 | 
     | u_core/FE_OFC4503_u_regfile_n_5913             | A v -> X v       | sky130_fd_sc_hd__buf_4     | 0.286 |  12.935 |   13.602 | 
     | u_core/FE_OFC4504_u_regfile_n_5913             | A v -> X v       | sky130_fd_sc_hd__buf_4     | 0.320 |  13.254 |   13.922 | 
     | u_core/g3492                                   | A1 v -> Y ^      | sky130_fd_sc_hd__a221oi_1  | 0.549 |  13.803 |   14.471 | 
     | u_core/g3427                                   | A ^ -> Y v       | sky130_fd_sc_hd__nand4_1   | 0.345 |  14.148 |   14.815 | 
     | u_core/g3398                                   | D v -> X v       | sky130_fd_sc_hd__or4_2     | 0.899 |  15.047 |   15.714 | 
     | u_core/FE_OFC787_u_regfile_regs_dbg_rd_addr__9 | A v -> X v       | sky130_fd_sc_hd__buf_2     | 0.349 |  15.395 |   16.063 | 
     | u_core/g373133                                 | B_N v -> Y v     | sky130_fd_sc_hd__nor2b_2   | 0.239 |  15.634 |   16.302 | 
     | FE_OFC3403_dbg_reg_rd_data_9                   | A v -> X v       | sky130_fd_sc_hd__buf_2     | 0.186 |  15.820 |   16.488 | 
     | g45581                                         | A v -> Y ^       | sky130_fd_sc_hd__nand2_1   | 0.122 |  15.942 |   16.610 | 
     | g44817                                         | A ^ -> Y v       | sky130_fd_sc_hd__nand4_1   | 0.118 |  16.061 |   16.728 | 
     | apb_prdata_o_reg[9]                            | D v              | sky130_fd_sc_hd__dfxtp_1   | 0.000 |  16.061 |   16.728 | 
     +-----------------------------------------------------------------------------------------------------------------------------+ 
     Clock Rise Edge                      0.000
     + Drive Adjustment                   0.113
     + Source Insertion Delay             1.000
     = Beginpoint Arrival Time            1.113
     Other End Path:
     +----------------------------------------------------------------------------------------------+ 
     |       Instance        |    Arc     |            Cell            | Delay | Arrival | Required | 
     |                       |            |                            |       |  Time   |   Time   | 
     |-----------------------+------------+----------------------------+-------+---------+----------| 
     |                       | clk_i ^    |                            |       |   1.113 |    0.445 | 
     | CTS_cpc_drv_buf_00277 | A ^ -> X ^ | sky130_fd_sc_hd__clkbuf_16 | 0.227 |   1.340 |    0.673 | 
     | CTS_cpc_drv_buf_00271 | A ^ -> X ^ | sky130_fd_sc_hd__clkbuf_16 | 0.446 |   1.786 |    1.119 | 
     | CTS_cpc_drv_buf_00263 | A ^ -> X ^ | sky130_fd_sc_hd__clkbuf_16 | 0.427 |   2.213 |    1.546 | 
     | CTS_ccl_buf_00251     | A ^ -> X ^ | sky130_fd_sc_hd__clkbuf_16 | 0.363 |   2.576 |    1.908 | 
     | CTS_ccl_a_buf_00250   | A ^ -> X ^ | sky130_fd_sc_hd__clkbuf_16 | 0.329 |   2.905 |    2.238 | 
     | CTS_ccl_a_buf_00248   | A ^ -> X ^ | sky130_fd_sc_hd__clkbuf_8  | 0.291 |   3.196 |    2.528 | 
     | CTS_ccl_buf_00243     | A ^ -> X ^ | sky130_fd_sc_hd__clkbuf_16 | 0.278 |   3.474 |    2.806 | 
     | CTS_ccl_a_buf_00236   | A ^ -> X ^ | sky130_fd_sc_hd__clkbuf_16 | 0.272 |   3.746 |    3.079 | 
     | CTS_ccl_a_buf_00056   | A ^ -> X ^ | sky130_fd_sc_hd__clkbuf_8  | 0.263 |   4.009 |    3.342 | 
     | apb_prdata_o_reg[9]   | CLK ^      | sky130_fd_sc_hd__dfxtp_1   | 0.004 |   4.013 |    3.346 | 
     +----------------------------------------------------------------------------------------------+ 
Path 18: MET Setup Check with Pin apb_prdata_o_reg[7]/CLK 
Endpoint:   apb_prdata_o_reg[7]/D (^) checked with  leading edge of 'clk_i'
Beginpoint: apb_paddr_i[7]        (^) triggered by  leading edge of 'clk_i'
Path Groups: {clk_i}
Analysis View: av_tt
Other End Arrival Time          4.033
- Setup                         0.045
+ Phase Shift                  13.333
+ CPPR Adjustment               0.000
- Uncertainty                   0.500
= Required Time                16.821
- Arrival Time                 16.151
= Slack Time                    0.670
     Clock Rise Edge                      0.000
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
