chuanseng-ng/claude_verilog_test/docs/CPP_TO_RTL_HLS_EVALUATION.md

# C++ → SystemVerilog (HLS) Flow Evaluation & RTL-Generation Approach Decision

**Date:** 2026-07-14
**Status:** Decision recorded · **pilot RUN and COMPLETE — Stage 1 + Stage 2, 2026-09-07** (see "Stage 1 results" and "Stage 2 results — the PPA table" at the end)
**Scope:** Should RTL be generated via `NL → C++ (AI) → RTL (HLS tool)` instead of the
current `NL → SystemVerilog (RTL-orchestrator agents)` flow?

---

## Recommended Approach (decision)

> **Use `NL → SystemVerilog` (RTL-orchestrator agents, current flow) for the
> CPU, caches, AXI interconnect, and GPU control logic.**
>
> **Use `NL → C++ → HLS → SystemVerilog` only for *future, datapath-dominant*
> accelerators** (e.g. the Phase 6 INT8 NPU, DSP/FFT, or crypto cores) where there
> is no tuned hand-RTL to beat and dataflow HLS is strongest.

Rationale summary (see Part 2 for the per-axis discussion and per-claim citations):
control-heavy, timing-critical, cycle-accurate microarchitecture (hazard/forward unit,
cache refill FSMs, crossbar arbitration/handshake, SIMT divergence stack, warp scheduler)
is the regime where the surveyed literature and this project's own sign-off experience
indicate hand-RTL beats HLS on quality, PPA, and timing — treat this as a well-supported
working hypothesis, not a measured result for *this* RTL (that is what the pilot below
would settle). The two-stage flow also stacks two error sources (LLM spec-drift in NL→C++
*plus* HLS QoR/subset limits) and forfeits the cycle/timing control this project relied on
for sign-off (EX-stage retiming, forwarding-mux placement, per-path SDC false/multicycle
exemptions). Our current NL→SV path is strictly shorter and keeps full control. HLS's
documented wins are datapath results — e.g. a memcached dataflow pipeline reported ~70%
register reduction at comparable performance ([arXiv:1408.5387], Xilinx Vivado HLS, FPGA
target) — which is why HLS is reserved here for datapath accelerators.

---

## Part 1 — Available open-source C++/HLS → (System)Verilog tools

Survey as of **2026-07**; releases are **not pinned** below (the pilot in the backlog
section must pin exact commits/tags before any measurement). "Front-end coverage" = which
input language/subset the tool accepts; "output target" = HDL(s) it emits. Qualitative
notes ("active", "broadest front-end") are relative editorial judgments from the linked
project pages, not benchmarked scores — verify against each project at pilot time.

| Tool | Front-end | Output target | License / activity (as of 2026-07) | Notes |
|---|---|---|---|---|
| **Bambu (PandA)** | C / C++ (GCC-based subset) | Verilog | GPL; repo actively maintained | General C/C++ HLS with the widest C/C++ input coverage of this set; PPA competitive *within the HLS class* per its own literature. |
| **Google XLS** | DSLX (Rust-like); C++ via `xlscc` subset | **Verilog + SystemVerilog** | Apache-2; actively developed | "Mid-level" synthesis; explicit pipeline-stage / throughput control; one source → SW model + RTL. Strongest for fixed-latency dataflow. |
| **SCCL** | SystemC (C++11 subset) | **SystemVerilog** / VHDL / FIRRTL | Open source | Clang front-end; SystemC synthesis subset; emits SystemVerilog directly. |
| **CIRCT + ScaleHLS / Calyx** | C/C++ → MLIR | **SystemVerilog** (via ExportVerilog) | Apache-2; actively developed | Infrastructure/frameworks, not a turnkey C++→RTL button; strong future direction. |
| **LegUp** | C | Verilog | Open version dated; maintained path proprietary (Microchip SmartHLS) | Historically better fuzz-reliability than early Bambu (per the reliability study cited below). |

**Takeaway:** viable open-source C++→RTL tools exist. **Multiple** emit SystemVerilog —
**SCCL** (from SystemC), **XLS** (from DSLX / `xlscc`), and **CIRCT** (via ExportVerilog);
**Bambu** and **LegUp** emit Verilog. So SystemVerilog output is *not* a differentiator; the
real axes are front-end (which C/C++ subset) and QoR. **Bambu** accepts the widest plain
C/C++ input; every tool imposes a *synthesizable subset* — none ingests arbitrary modern C++.

## Part 2 — Why not for this project's core (quality / PPA / timing)

The claims below are drawn from the cited literature and this project's own sign-off data.
Where a statement is a general finding from the literature rather than a measurement of
*this* RTL, it is framed as such — the backlog pilot is what would convert these from
supported expectations into project-specific numbers.

- **Quality:** The surveyed literature reports HLS excels at dataflow/statically-scheduled
  algorithms and is weaker than hand-RTL on control-intensive logic — the regime that
  dominates this SoC (semiengineering.com "HLS for RISC-V"; BittWare RTL-vs-HLS study).
  Independent of QoR, the two-stage flow compounds LLM spec-drift with HLS subset/QoR
  limits, and the LLM must target each tool's narrow subset (a less-trained target than
  "write SystemVerilog"). *Hypothesis for this RTL, pending the pilot.*
- **PPA:** Reliability/QoR studies place open HLS ~on par with commercial HLS on datapath
  but behind hand-RTL for control blocks (johnwickerson fuzzing-HLS study; BittWare). Our
  *measured* sign-off numbers (CPU 1418 MHz / 27.27 mW ASAP7; SoC 571 MHz / 62.9 mW) come
  from hand micro-architecture and are the concrete anchor; the expectation that HLS
  control FSMs add registers/area and miss these fmax targets is a literature-based
  hypothesis the pilot would test.
- **Timing:** HLS gives limited timing controllability (pragmas/target-period, not
  hand-placed critical paths). Full HLS RISC-V cores exist and work (HL5, arXiv/CICC'20)
  but are reported below tuned hand-RTL fmax. A regression on the paths that gate this
  design is expected but unproven for this RTL — again, the pilot's purpose.
- **Process cost:** New toolchain + subset + pragma tuning + mandatory C↔RTL equivalence
  checking (HLS tools have documented reliability bugs — johnwickerson study) — a large new
  verification surface on top of the existing cocotb/pyuvm flow.

### References
- PandA-Bambu — https://github.com/ferrandi/PandA-bambu
- Google XLS — https://github.com/google/xls
- SCCL: An open-source SystemC to RTL translator (IEEE) — https://ieeexplore.ieee.org/document/10171476/
- An Empirical Study of the Reliability of HLS Tools — https://johnwickerson.github.io/papers/fuzzingHLS.pdf
- High-Level Synthesis for RISC-V (Semiconductor Engineering) — https://semiengineering.com/high-level-synthesis-for-risc-v/
- HL5: A 32-bit RISC-V Processor Designed with HLS — https://sld.cs.columbia.edu/pubs/mantovani_cicc20.pdf
- Comparing FPGA RTL to HLS C/C++ (BittWare) — https://www.bittware.com/resources/comparing-rtl-to-hls/
- HLS Case Study: Memcached Server (~70% register reduction claim) — https://arxiv.org/abs/1408.5387
- CIRCT Verilog/SystemVerilog generation (ExportVerilog) — https://circt.llvm.org/docs/VerilogGeneration/

---

## Backlog item — Empirical confirmation pilot

> **Tracked as GitHub issue [#119](https://github.com/chuanseng-ng/claude_verilog_test/issues/119).**
> Filed on GitHub rather than beads (`bd`) because the remote beads DB is at schema v32 while
> the available `bd` is v53; writing a native `bd` issue would require migrating the shared
> schema (forces every clone to re-bootstrap), a team-wide coordination decision left to the
> maintainer. Convert to a `bd` issue later if desired.

**Title:** Empirically confirm HLS-vs-hand-RTL PPA gap on one datapath + one control block
**Type:** task · **Priority:** low (validation, not blocking) · **Phase:** 6+ exploration

**Goal:** Quantify (not just argue) the QoR gap between the two flows on an
already-signed-off block, to confirm the recommendation above.

**Method (apples-to-apples on ASAP7):**
1. Pick two poles from existing signed-off RTL:
   - **Memory coalescer** (`rtl/gpu/`, datapath-ish → HLS-favorable).
   - A **cache refill FSM** (`rtl/mem/`, control-heavy → HLS-unfavorable).
2. **Flow A (baseline):** existing hand-RTL through the current ASAP7 sign-off.
3. **Flow B:** `NL → C++ (LLM) → Bambu` (widest C/C++ FE) and/or **XLS** (SV output) →
   same `make librelane-asap7` sign-off.
4. **Verification — two independent checks, both required:**
   - **Source→RTL equivalence:** C++ ↔ generated-RTL equivalence via the HLS tool's own
     C/RTL co-simulation *or* formal equivalence (e.g. the tool's cosim harness). This is
     the check that actually validates the HLS step, and is the known gap flagged in the
     project's existing source-to-RTL-equivalence backlog item.
   - **Reference agreement:** generated RTL vs the Python reference model (`tb/models/`) as
     an independent oracle. Neither check substitutes for the other.
5. Then compare **fmax / area / power / DRC** against Flow A.

**Reproducibility — pin before measuring (else the comparison isn't apples-to-apples):**
Bambu/XLS release commit or tag; LibreLane + ASAP7 PDK revision; the exact SDC constraints
(clock period, IO delays, false/multicycle paths) used for *both* flows; PVT/process corner
(match the current ASAP7 sign-off corner); clock/reset/IO wrapper the generated block is
placed in; power-activity assumptions (VCD-driven vs default switching); and
latency/throughput normalization (HLS may pick a different cycle count — normalize on
throughput at matched fmax, and report the II/latency of each version).

**Acceptance thresholds (measurable; tune before the run if desired):**
- "Regresses noticeably" = Flow B is worse than Flow A by **>10 % fmax** *or* **>20 % area**
  *or* **>20 % power** at matched function. ~~*or* introduces any DRC/antenna violation Flow A
  did not have.~~ — **DRC clause struck, see below.**
- "Competitive" = Flow B within **±5 % fmax** and **±10 % area/power** of Flow A. ~~with 0 DRC.~~
- Any result between these bands is "inconclusive → widen the block set or re-tune pragmas."

> **⚠ The DRC/antenna axis is withdrawn for ASAP7 — struck 2026-09-07 (Stage 1, bead `cge`).**
> Bead `xy6` (closed, root-caused) established that **no ASAP7 run in this project's history has
> ever completed detailed routing**: `pnr/scripts/openroad/drt.tcl` wraps the whole
> `detailed_route` call in a bare `catch{}`, so DRT-0073/0074 pin-access failures abort routing
> and `write_views` commits the pre-route placed netlist. 100 % of recoverable runs show zero
> ROUTED nets. Bead `ocm` (open) owns the unsolved pin-access cause.
> Both arms of this pilot would hit the identical wall, so a DRC column yields **no
> discriminating signal** — it would compare two vacuous zeros. Timing/power/area survive as
> GRT-estimate-based figures that are self-consistent between arms.
> **Stage 2 must not promise a DRC column.** Revisit only if `ocm` is solved.

**Expected result (hypothesis):** HLS regresses per the thresholds above on the FSM, is
competitive on the coalescer — which would confirm "keep hand-RTL for the control core,
reserve HLS for datapath accelerators." A surprising result (HLS competitive on the FSM)
would itself be a useful signal to revisit the recommendation.

**Deliverable:** a short PPA comparison table appended to this doc.

**Note:** this pilot was optional. **It was run anyway — Stage 1 completed 2026-09-07;
see "Stage 1 results" at the end of this document.** Two of the three blocks returned
categorical results rather than PPA numbers, and one correction landed on this section's own
framing (the "datapath-ish" pole is not a datapath block). Stage 2 (P&R + the PPA table) has
not been run.

---

# Stage 1 results — the pilot was run (2026-09-07)

**Status:** Stage 1 complete. **No PPA table yet** — that is Stage 2, which measures. Stage 1
installed the tool, authored the C, generated the RTL, and proved functional equivalence.

The pilot was expected to return a PPA delta. It returned something more decisive: on the three
blocks attempted, **two of the three results are categorical rather than numeric.** Details in
`hls/*/NOTES.md`; the reproducibility pin is `hls/PROVENANCE.json`.

## What was pinned

Bambu (PandA) **2024.10**, revision `c2ba6936ca2ed63137095fea0b630a1c66e20e63-main`. Upstream ships
only a prebuilt AppImage, so it is packaged as a nix devshell (`flake.nix`, `devShells.hls`) via
`appimageTools.wrapType2` + `fetchurl` with the AppImage sha256 enforced by nix. **The flake is the
pin** — no per-machine install step, and nix refuses to build if the upstream artefact ever changes.

Target `--device-name=asap7-TC`, `--clock-period=0.705` ns (matching
`pnr/asap7/template/config.json`). Bambu bundles `asap7sc7p5t_SIMPLE_RVT_TT_nldm_201020.lib` — the
same cell library and TT corner `pnr/asap7/cpu/config.json` already uses, so Stage 2 can match the
corner exactly. Co-simulation against the flake's Verilator 5.048.

Generated Verilog is **not committed**. Bambu stamps a timestamp into a header comment of every
`.v`, so the raw digest changes every run (verified: three back-to-back runs of identical input gave
three digests, byte-identical except the `- Date …` line). `tools/eda/wrap-bambu.sh` therefore emits
a **normalized** digest, which is stable and is what `PROVENANCE.json` pins.

## Method: the reference RTL body was withheld

Each C source was authored by a fresh agent given **only** the block's natural-language spec (the
reference `.sv` header comment) and its port list, explicitly barred from reading anything under
`rtl/`. Transliterating the SystemVerilog would have measured transliteration and answered nothing.
Each block's `ASSUMPTIONS.md` records every point where the spec was silent and what was chosen —
those files are a measured output of the experiment, not paperwork.

## Results

| Block | Pole | Outcome |
|---|---|---|
| `memory_coalescer` | AXI / serialiser | Equivalent on both legs. One measured latency penalty. |
| `rv32i_hazard_unit` | control | **Form inexpressible** (combinational → 6-9 cycle FSM) **and** functional divergence, 254/2000 vectors |
| `rv32i_cache_arbiter` | control / bus arbitration | **Inexpressible — no C authored** |

Every block was checked on **two independent legs**: Bambu's own C/RTL co-simulation (which
validates the C→RTL step), and the *same, unmodified* cocotb suite run against both the hand-RTL and
the HLS arm behind a wire-only shim (which validates the C against the spec). Neither leg
substitutes for the other.

### 1. `memory_coalescer` — equivalent, with a 6× control-path latency penalty

Both legs green: cosim 5/5 vectors; the existing 5-test cocotb suite passes on both arms.

One test initially failed. Measured cause: on an empty lane mask the hand-RTL asserts `done_o` after
**1** rising edge (`IDLE → DONE` directly), the HLS version after **6** — Bambu walks all eight lane
predicates sequentially even when none fire. The test's 5-cycle bound was a testbench assumption
calibrated against the reference, not a specified requirement (the spec sets no cycle budget), so it
was rebased for **both** arms with the AXI-silence assertions untouched.

**Correction to this document's own framing:** `memory_coalescer` was named here as the
"datapath-ish → HLS-favorable" pole. It is not a datapath block. It is 214 lines of lane-walking FSM
plus AXI handshakes with zero arithmetic, and `GPU_ENABLE_COALESCE = 1'b0` means nothing is actually
coalesced — it serialises one single-beat transaction per active lane. It was kept because it is the
block that exercises Bambu's `m_axi` path and carries the real interface risk, but it never tested
the datapath hypothesis.

### 2. `rv32i_hazard_unit` — the control pole, substituted and doubly negative

Substituted for "a cache refill FSM", which turned out not to exist as a standalone module — the
refill logic is smeared across `rv32i_icache.sv` (619 lines, 5 SRAM macros) and `rv32i_dcache.sv`
(990 lines). Carving it out would have created a *new* baseline that was never signed off. The
hazard unit is 427 lines, purely combinational, and is named in this document's own control-heavy
list, so it tests the same hypothesis against real signed-off RTL.

**Result 2a — HLS cannot express the block's form.** The reference has no clock, no reset and
**zero flip-flops**. Bambu wraps every design in a start/done handshake: **9 FSM states, 50
flip-flops, 6-9 cycles per evaluation, data-dependent latency.** For a block whose job is resolving
hazards within one cycle, that is not a drop-in replacement at any clock period. This is not an
authoring artefact — rebuilding the stall/flush logic branch-free, with no priority chain at all,
produced an *identical* schedule (area within 0.3 %).

**Result 2b — spec drift, precisely localised.** Hand-RTL 28/28 spec-derived directed tests;
HLS 26/28; the 2000-vector cross-arm differential reports **254 mismatches (12.7 %)**. Root cause:
the failing vectors make the EX1b/EX1c producers *loads*, whose data is not ready, so those
forwarding tiers must be excluded; the HLS version gates only the EX2 tier on `mem_rd`.

The sharp part: **all 254 mismatches land on forwarding outputs. Not one stall, flush or load-use
output ever mismatched.** The 9-item priority ladder — which this document's source spec states
explicitly and completely — transferred perfectly. The drift is confined entirely to what the spec
left to inference. **Spec-stated behaviour transferred; spec-implied behaviour did not.**

The divergence was deliberately not fixed. It is the measurement. It was also *predicted in advance*
by the C author in `ASSUMPTIONS.md`, including the observation that it would "only ever fail under
random-vector equivalence, never under a trace" — which is exactly what happened.

### 3. `rv32i_cache_arbiter` — outside the expressible domain

No C was authored, and none should be. Bambu emits AXI **masters** only, and only as a side-effect
of pointer dereference; asking for a slave is rejected (`error: Invalid HLS interface mode` for
`mode = s_axilite`), the shipped clang plugin contains no AXI-slave mode string at all, and
`--generate-interface` accepts only `MINIMAL` / `INFER` / `WB4`. Under the first two every top
module carries `start_port`/`done_port` — the C execution model made structural. The arbiter is
permanently reactive, with three incoming AXI channel sets and grant-hold-until-`RLAST`; there is no
invocation to map onto. Full evidence, including a probe of the one slave-shaped option (`WB4`, a
memory-mapped *control* interface in Wishbone), is in
`hls/mem/rv32i_cache_arbiter/INEXPRESSIBLE.md`.

Forcing it would have required a hand-written shim containing the grant register, priority encoder,
burst-hold logic and response routing — the entire design — around an HLS core contributing nothing.
That comparison would be hand-RTL versus hand-RTL, reported as hand-RTL versus HLS.

## What this does to the recommendation

The recommendation at the top of this document **stands, and is strengthened on its control-logic
half.** For that half the claim can now be stated more strongly than the literature supported:

> Not "HLS produces worse control logic" but, for the two control blocks attempted, **"HLS cannot
> express these blocks at all"** — one because a combinational block becomes a multi-cycle FSM, the
> other because the interface has no representation. Neither is a scheduling or pragma-tuning
> problem; both follow from the C execution model, so neither is fixed by re-tuning.

**The datapath half of the recommendation remains untested.** Neither measured block is a datapath
block, and the one named as such is not. Nothing here supports or undermines reserving HLS for
datapath accelerators — that hypothesis is exactly as evidenced as it was before this pilot ran.
If it matters, a genuine datapath pole (`rtl/gpu/vector_alu.sv`, 8 × 32-bit multiply plus
shift/logic) would test it.

Two secondary findings worth carrying into any future HLS work:
- **Ordinary C factoring is not available.** Bambu refuses to inline `static` helpers — it made a
  shared helper a 1-resource submodule with internal DISTRAM and *failed the build*
  (`clock constraint too tight: BRAMs for this device cannot run so fast`).
  `__attribute__((always_inline))` did not change the decision; only preprocessor macros worked.
- **The output is structurally explosive.** Bambu instantiates ~550 modules for one small block.
  Verilator then emits a 1.2 MB symbol-table constructor on which g++ spun at 99.9 % CPU for
  32 minutes at `-O0`. `sim/Makefile` carries `--output-split 500` and `NO_TRACE=1` on the HLS arms
  for this reason.

## Stage 2 — what it may and may not claim

- **No DRC column.** See the struck threshold above (beads `xy6` / `ocm`).
- Bambu's own estimates (coalescer 820 FF / area 352 744; hazard unit 50 FF / area 1 791 535) are
  **not comparable to hand-RTL** — they cover the whole generated hierarchy including Bambu's AXI
  master adapter, which the hand-RTL has no equivalent of. Stage 2 must synthesise both arms for
  real and state the counting boundary before quoting anything.
- Both shims are wire-only (zero registers), so Flow B's area needs no separate shim line.
- Normalize on throughput per the pinning list above: the hand-RTL cycle counts are 1 (coalescer,
  empty mask) and **0** (hazard unit, combinational) against 6 and 6-9 respectively.

---

# Stage 2 results — the PPA table (2026-09-07)

**Status:** Stage 2 complete (bead `r8r`). This is the comparison table this document names as the
pilot's deliverable. Reproducibility pin: `hls/PROVENANCE.json`; configs under
`pnr/asap7/{coalescer,hazard}_{rtl,hls}/`; collector `tools/verif/collect_r8r_ppa.py`.

## Method

Four ASAP7 runs — two hand-RTL, two Bambu-HLS — **to `OpenROAD.STAPrePNR` only**. That step is
where area, timing *and* power all first appear, so placement, CTS and routing are needed for none
of them. All four use the same clock period (705 ps), the same corner (`nom_tt_025C_0p7V`), the same
synthesis strategy and the same skip list; a diff of the four `config.json` differs **only** in
`DESIGN_NAME`, `VERILOG_FILES` and the clock port. Both HLS arms are synthesised *with* their
wire-only shim, so all four have identical port lists.

## The table

| Block | Flow | Area µm² | Cells | Critical path ps | fmax MHz | Power mW | Undriven wires |
|---|---|---|---|---|---|---|---|
| `memory_coalescer` | hand-RTL | 569.74 | 4219 | 1620.15 | 617.2 | 4.469 | **0** |
| `memory_coalescer` | **HLS** | 605.22 | 4814 | **1059.09** | **944.2** | 4.845 | **9** |
| `rv32i_hazard_unit` | hand-RTL | 23.17 | 233 | **149.3** (combinational) | n/a | **0.018** | **0** |
| `rv32i_hazard_unit` | **HLS** | 26.55 | 233 | 302.53 (per cycle) | 3305.5 | **0.182** | **28** |

`rv32i_hazard_unit`'s hand-RTL arm is purely combinational — no clock, no registers, zero
register-to-register paths — so "fmax" is undefined for it. It is timed against a **virtual clock**
with a zero I/O budget, and its number is the input-to-output path delay (705 − 555.7 slack).

## Result 1 — the coalescer: HLS *won* on speed, and that was not the hypothesis

Against this document's own thresholds (>10 % fmax or >20 % area/power = "regresses"; ±5 % fmax and
±10 % area/power = "competitive"):

- **Critical path −34.6 %** (1620 → 1059 ps), i.e. **fmax +53 %**, in the HLS arm's favour.
- **Area +6.2 %**, **power +8.4 %** — both inside the ±10 % "competitive" band.

So on raw PPA the HLS coalescer is **better than competitive**. The reason is visible in the
structure: Bambu split the lane walk across more, shorter cycles, while the hand-RTL keeps a longer
combinational path through the 8-lane mux and its AXI FSM.

**This does not overturn the recommendation, and the reason is throughput.** A shorter clock period
bought with more cycles per transaction is only a win if the cycle count holds, and it does not:
on the empty-mask case the hand-RTL completes in **1** rising edge and the HLS arm in **6**.
Per-transaction latency, not fmax, is what this block's consumer sees.

*Honest gap:* a full 8-lane-transaction cycle count for the hand-RTL arm was **not measured**, so
the throughput comparison is anchored only on the empty-mask case plus Bambu's own cosim average of
23 cycles/vector. A rigorous throughput ratio needs that measurement; it is not claimed here.

## Result 2 — the hazard unit: regression on every axis that matters

- **Power ×10.1** (0.018 → 0.182 mW, +911 %) — far outside the >20 % "regresses" threshold, and the
  single starkest number in this pilot.
- **Area +14.6 %** — past the ±10 % competitive band.
- **Latency ×12.2 – ×18.2**: 149.3 ps of combinational delay versus 302.53 ps × 6–9 cycles =
  1815–2723 ps for the same evaluation.

**Verdict: regresses**, decisively. This is the block Stage 1 already showed to be *inexpressible in
form* — a zero-flip-flop combinational cloud becoming a 9-state, 33-flop FSM — and the PPA numbers
now put a cost on that: an order of magnitude more power and over an order of magnitude more
latency, for logic the pipeline needs resolved within a single cycle.

## Result 3 — netlist quality: undriven wires, only in the HLS arms

Yosys' own `CHECK` pass reports wires that are used but never driven:

| | hand-RTL | HLS |
|---|---|---|
| `memory_coalescer` | 0 | **9** |
| `rv32i_hazard_unit` | 0 | **28** |

They are `OUT_UNBOUNDED_*` functional-unit outputs plus an undriven `s_start_port0`. Both hand-RTL
arms are clean. The flow's `Checker.YosysSynthChecks` had to be skipped **on all four** (to keep the
flow identical) for the HLS arms to synthesise at all; the skip is documented in `pnr/Makefile` and
this asymmetry is reported rather than hidden by it.

## What must not be read into this table

- **No DRC column, by construction.** Struck in Stage 1 (beads `xy6`/`ocm`): no ASAP7 run in this
  project has ever completed detailed routing, so both arms would compare two vacuous zeros. These
  are partial runs and never route.
- **Pre-placement, zero-parasitic STA.** Absolute fmax is optimistic for all four. The *comparison*
  holds because every arm is treated identically, but these are not sign-off numbers.
- The 233-cell count matching across the two hazard arms is a coincidence, not an error — the areas
  and flop counts differ (the HLS arm has 33 flip-flops; the hand-RTL arm has none).

## Effect on the recommendation

The recommendation at the top of this document **stands**, now with numbers behind its control-logic
half rather than only literature: on the control block, HLS costs **10× the power and 12–18× the
latency**, on top of Stage 1's finding that it cannot reproduce the block's combinational form at
all.

The coalescer result is the honest complication, and it is worth stating plainly: **on an
AXI-serialiser workload, HLS produced a shorter critical path at ~6 % area cost.** That is a point
in HLS's favour on a block that is *not* control-dominated in the hazard-unit sense, and it is
consistent with reserving HLS for throughput-oriented dataflow rather than for cycle-critical
control.

~~**The datapath half of the recommendation remains untested** — neither measured block is a datapath
block (see the Stage 1 correction above). Bead `gg8` tracks `rtl/gpu/vector_alu.sv` as the block
that would actually test it.~~

> **Superseded by Stage 3 (bead `gg8`, below).** It was tested. It does not hold.

---

# Stage 3 results — the datapath pole (2026-09-07, bead `gg8`)

Stage 2 closed by admitting that the pilot's *datapath* half rested on nothing: `memory_coalescer`,
the block chosen as the "datapath-ish → HLS-favorable" pole, is an AXI transaction FSM. Stage 3
measures the real thing — `rtl/gpu/vector_alu.sv`, 8 lanes × 32 bits of pure combinational
arithmetic with **zero registers**.

Same protocol throughout: the C was authored from the natural-language spec with the hand-RTL
withheld (`hls/gpu/vector_alu/ASSUMPTIONS.md`), then both arms taken through identical ASAP7 runs to
`OpenROAD.STAPrePNR` — same 705 ps clock, same `nom_tt_025C_0p7V` corner, same skip list. The HLS
arm is synthesised with its wire-only shim.

## The table

| Metric | hand-RTL `vector_alu` | HLS `vector_alu_hls` | Δ | Band |
| :-- | --: | --: | :-- | :-- |
| Area (µm²) | 4 655.15 | 7 234.00 | **+55.4 %** | regresses |
| Cells | 54 634 | 70 895 | +29.8 % | — |
| Sequential cells | **0** | 9 412 | — | — |
| Power (mW) | 14.147 | 37.281 | **+163.5 %** | regresses |
| Critical path | 759.29 ps (comb, in→out) | 4 142.52 ps (FF→FF) | **×5.5** | regresses |
| Cycles / operation | 1 (combinational) | mean 14.35, range 8–38 | ×14–38 | regresses |
| Undriven wires | **0** | 16 | — | — |

Every axis regresses, by margins several times this document's own thresholds (>10 % fmax or >20 %
area/power). Throughput — the number that actually matters for a datapath — is 759.29 ps for one
operation against 4 142.52 ps × 14.35 = **59.4 ns** mean, 157.4 ns worst: **≈78× mean, ≈207× worst**.

## Two caveats, both cutting in the HLS arm's favour

**1. The 4 142.52 ps is partly a flow artifact.** 2 550.65 ps of it — **62.3 %** — is a *single* arc:
a minimum-drive `DFFASRHQNx1` driving **fanout 1188 / 630.7 fF**, unbuffered because `--to
OpenROAD.STAPrePNR` stops before the resizer. The other 12 arcs total 1 546.4 ps. Buffered, the path
would plausibly land near 1.7–1.8 ns. The hand-RTL arm has no comparable net — its worst arc is
60.6 ps, 8.0 % of its path, spread over 24 well-balanced arcs — so skipping the resizer penalises the
HLS arm **asymmetrically**, even though both ran the identical flow. Read the timing ratio as
**×2.2–5.5**, not ×5.5 flat. Area and power are resizer-independent and regress on their own, so the
verdict is unaffected.

This also refines Stage 2's caveat that "comparison valid because treatment is identical" — true
procedurally, but the *effect* is not symmetric. Measured share of critical path in one unbuffered
high-fanout arc, all six arms:

| Arm | share | worst-arc fanout |
| :-- | --: | --: |
| `coalescer_rtl` | 71.5 % | 532 |
| `coalescer_hls` | 50.6 % | 267 |
| `hazard_rtl` | 34.2 % | 2 |
| `hazard_hls` | 31.6 % | 15 |
| `valu_rtl` | 8.0 % | 6 |
| `valu_hls` | **62.3 %** | **1188** |

No Stage 2 verdict changes direction: the coalescer's *hand-RTL* arm suffered more than its HLS arm,
so that HLS win is if anything understated, and both hazard arms are artifact-free. But absolute
timing ratios across this pilot are bounds, not exact figures.

**2. Bambu's own `CYCLES value="7"` is not the latency.** Parsed per-vector from `results.txt`, the
real distribution is 8 cycles ×22, 22 ×9, 38 ×3 — mean **14.35** over 488 cycles / 34 vectors. The
`7` is roughly half the true mean; it must not be quoted.

## The FSM is structural, not an authoring or clock artifact

Two ablations, neither requested, both run because "the C was written badly" and "the clock was too
tight" are the first two objections to a result like this:

- **Relaxed clock (1.75 ns instead of 0.705 ns):** 62 control steps, 6 012 FF, **identical area**. A
  slower target does not buy a flatter datapath.
- **"HLS-friendly" rewrite** — the lane loop restructured into a ternary-select chain, the shape
  usually recommended to coax parallel hardware out of HLS: **3.3× area**, still sequential.

Bambu schedules a loop over lanes into a multi-cycle FSM over a shared functional unit. It has no
mode that emits 8 parallel combinational slices. Whether it can be made to emit a single-control-step
datapath *at all* is a genuinely open question, left as a follow-up.

## Effect on the recommendation

The recommendation's control-logic half **stands** and is now supported by two independent blocks.

Its datapath half **does not**. It was never evidence-backed — Stage 1 and Stage 2 both said so — and
now that it has been measured on a genuine datapath block, it is contradicted: HLS is **not**
favourable here, it is decisively worse on area, power, latency and throughput simultaneously. The
useful reformulation is narrower than "reserve HLS for datapath accelerators":

> On this toolchain, HLS is worth considering for **throughput-oriented transaction/dataflow logic**
> (the coalescer result), and not for **combinational arithmetic datapaths** (this result) or for
> **cycle-critical control** (the hazard unit). The distinction that predicted the outcome was not
> datapath-vs-control; it was whether the block's natural form is already a cycle-by-cycle state
> machine — HLS reproduces those, and rebuilds everything else as one.

## Verification

Both arms pass `tb/cocotb/gpu/test_vector_alu.py` **14/14**. The suite had no handshake handling at
all, so the HLS arm scored 1/14 until a runtime protocol branch (the `test_hazard_unit.py` pattern)
was added; expected values and assertions are unchanged, only the sampling point moved into
`ReadOnly()`. This directed suite does **not** exercise `ASSUMPTIONS.md` items 8 (`result_o` for
branch opcodes) or 10 (`VMOV_*`), so those two spec-drift candidates remain **unprobed, not cleared**.

---

# GH #119 `egt` follow-up — the combinational-candidate PPA attempt is INVALID (2026-09-15)

**Question asked:** bead `egt` established Bambu 2024.10 *can* emit a functionally-correct,
zero-register, zero-latency `vector_alu` (`--speculative-sdc-scheduling --clock-period=100`,
cosim + `test_vector_alu.py` both 14/14 against the pre-synthesis `.v`). The remaining step was to
re-measure the Stage-2/3 PPA verdict against this "comb" candidate. **Conclusion: do not quote comb
PPA numbers.** A real synthesis bug was found and fixed; a second, deeper synthesis-correctness bug
was found and is **not** fixed. `rtl` and `hls` reproduce the Stage 2 (`r8r`) baseline cleanly and
remain trustworthy.

## Setup

Three ASAP7 `OpenROAD.STAPrePNR`-only runs (`pnr/asap7/valu_{rtl,hls,hls_comb}/`, same 705 ps SDC,
same corner, driven by `/nobackup/egt_ppa/run_all.sh` under memory-capped `systemd --user` scopes):
`rtl` = hand-RTL, `hls` = default-flags Bambu baseline (registered, FSM), `hls_comb` = the
`sdc_longclk` candidate re-synthesised at leaf-block level.

## Bug 1 (found and fixed): `SYNTH_SHARE_RESOURCES` left enabled

`pnr/asap7/valu_hls_comb/config.json` (like `valu_rtl/` and `valu_hls/`) never set
`SYNTH_SHARE_RESOURCES`, so yosys's SAT-based `share` resource-sharing pass ran unchecked. Its log
(`05-yosys-synthesis/yosys-synthesis.log`, run `RUN_2026-09-15_14-10-19`) shows it declaring six
per-lane `$shl` cells **"never active. Sharing is pointless, we simply remove it"** — wrong for a
fully-parallel, zero-register 8-lane datapath, where `active_mask_i` is a runtime input, not a
constant, so no lane's shifter is ever provably dead. This is the *exact* failure class already
documented and fixed in `pnr/asap7/gpu/config.json` (`SYNTH_SHARE_RESOURCES: false`, for the same
"8-lane vector_alu" shape — see the `project_yosys_share_pass_hang` memory note) but never propagated
to the leaf-block configs. **Fix applied:** added `"SYNTH_SHARE_RESOURCES": false` to
`valu_hls_comb/config.json` only (`valu_rtl`/`valu_hls` left untouched — their numbers already match
the `r8r` baseline, so `share` is not corrupting them). Re-running confirmed the `SHARE pass
(SAT-based resource sharing)` step no longer appears in the log at all.

## Bug 2 (found, NOT fixed): the post-fix netlist still discards most of `rs2_i`

Re-running after the Bug 1 fix (`RUN_2026-09-15_14-25-30`) produced **byte-for-byte identical**
metrics to the broken run (1587 instances / 138.7 µm² / 0.085 mW / WS +449 ps / TNS 0) — proving
`share` was never the dominant cause. Direct inspection of the final gate netlist
(`05-yosys-synthesis/vector_alu_hls.nl.v`) shows:

- **`rs2_i` collapses to exactly 8 live bits total** (bit 0 of every 32-bit lane: bits
  `0,32,64,96,128,160,192,224`) out of the 256-bit port — bits `[31:1]` of every lane's second ALU
  operand are read by **nothing**. `rs1_i` by contrast uses all 256 bits correctly.
- **Only 22 XOR/XNOR-family cells exist in the whole 1587-cell netlist.** Binary addition
  structurally requires one XOR per bit for the sum term (a full/half adder cannot be built from
  AOI-only logic); 22 XOR-family gates cannot implement even one correct 32-bit adder, let alone
  eight adders, eight subtractors and eight 32×32 multipliers.
- **`ALUMACC` (`yosys-synthesis.log` step 67) converts only 1 of the 8 `$mul` cells** present
  earlier in the flow (confirmed independently: a standalone `yosys -sv ... opt -full` pass on the
  bare candidate module reproduces **8** genuine 32×32 `$mul` cells, all fed directly from
  `rs1_N`/`rs2_N`, at the RTLIL level) — the other 7 were already eliminated before reaching
  `ALUMACC`, and even the 1 survivor is gone by the final `techmap` (no `$mul`/`$macc`/`$alu`
  mapping template is invoked for a multiply anywhere in the log).
- Bambu's own **pre-synthesis area estimate for this candidate is 11 067 363 units** — 8.5× the
  registered baseline's own estimate (1 298 853, from `ASSUMPTIONS.md`'s "Measured QoR" section) —
  i.e. Bambu itself expects the fully-unrolled combinational form to be *larger*, not 30–50×
  smaller than either baseline arm's final mapped netlist.

Working hypothesis (not verified to completion): three `read_verilog` frontend warnings in the
candidate's generic Bambu shifter/comparator FU templates (`Range [0:-1] select out of bounds on
signal 'in2': Setting 1 LSB bits to undef`, at the *unparameterized* module body's default
`BITSIZE_in2`/computed-bitsize mismatch) inject spurious X-constants that a register-free,
fully-combinational netlist lets cascade through the whole design during `opt`/`OPT_MUXTREE`
(no clock-edge boundary contains the damage the way it does in the `rtl`/`hls` arms) — but this was
not confirmed by formal equivalence or gate-level simulation, and no further fix was attempted this
session (deep surgery on a 900 KB machine-generated netlist without full re-verification was judged
higher-risk than reporting the gap). **Tracked next step: bead `claude_verilog_test-gcd`
(`discovered-from: egt`).**

**Do not quote `hls_comb`/`comb` area, power, WS, TNS, or any derived fmax as if it were the true
implementation cost of a combinational `vector_alu` — the netlist those numbers were measured on
does not correctly implement the second ALU operand for most opcodes.**

## Comparison table (`rtl` and `hls` only — `comb` excluded per above)

All four figures reproduced from fresh ASAP7 `OpenROAD.STAPrePNR` runs, 2026-09-15, same SDC/corner
as the original `r8r` Stage 2 runs; `r8r`'s recorded numbers (`docs/CPP_TO_RTL_HLS_EVALUATION.md`,
"Stage 2 results" above) are reproduced alongside for drift-checking.

| Metric | `rtl` (this run) | `rtl` (`r8r`, 2026-09-07) | `hls` (this run)[^hls-corrupt] | `hls` (`r8r`, 2026-09-07)[^hls-corrupt] |
| :--- | ---: | ---: | ---: | ---: |
| Instances | 54 634 | 54 634 | 71 480 | 70 895 |
| Area (µm²) | 4655.15 | 4655.15 | 7254.37 | 7234.0 |
| Power (mW) | 14.147 | 14.147 | 37.667 | 37.281 |
| Setup WS (ps) | −54.29 | (n/a — see below) | −996.18 | (n/a) |
| Setup TNS (ps) | −2465.20 | — | −3 779 683.10 | — |
| Hold WS (ps) | +8.77 | — | −13.01 | — |

`rtl` reproduces exactly (0.00% drift on all three shared metrics — same `705 ps` combinational
critical path, `759.29 ps` data arrival, matching to 2 decimal places). `hls` drifts **≤1.1%**
(instances +0.83%, area +0.28%, power +1.04%) — attributable to environment/tool-version movement
since the 2026-09-07 `r8r` run, not a structural change; both are within normal run-to-run noise for
this flow. ⚠️ Both `hls` columns were later proven to be measurements of a **corrupt** netlist
(bead `b0t`, see footnote); the fixed, GLS-verified figure is the "REMEDY APPLIED" block under
"Baseline FSM arm" further down.

### Worst-arc decomposition (mandatory before quoting any fmax ratio, per the
`asap7-to-openroad-staprepnr-comparisons-stopping-before-the` memory note — `--to
OpenROAD.STAPrePNR` never runs the resizer, so a single unbuffered high-fanout net can dominate a
path and the effect is asymmetric between designs)

| Arm | Critical path total | Single worst arc | Arc share | Arc fanout |
| :--- | ---: | ---: | ---: | ---: |
| `rtl` | 759.29 ps (combinational, virtual clock) | 60.57 ps (`OAI211`, stage 12/23) | **8.0%** | 6 |
| `hls` | 1667.84 ps (register-to-register) | 981.02 ps (DFF `QN` → `NOR3`) | **58.8%** | 469 |

`rtl`'s critical path is not dominated by any single unbuffered net — its area/power numbers *and*
its WS are reasonably representative of the design as-is. `hls`'s critical path is **dominated** by
one register's 469-fanout, unbuffered fan-out net (58.8% of the total path) — its WS/TNS/derived
fmax are a lower bound inflated by the absence of a resizer pass, not a clean measurement of the
FSM's intrinsic speed; only its area and power (resizer-independent) should be quoted with
confidence. Do not compute an `rtl`-vs-`hls` fmax ratio from these WS figures without carrying this
caveat.

## Verdict

- **Area/power, `rtl` vs `hls`:** confirms the original Stage 2 (`r8r`) result — HLS's registered,
  multi-cycle-FSM arm costs **+55.8% area** and **+166.3% power** versus hand-RTL, consistent with
  (slightly worse than, within noise of) the `r8r`-recorded +55.4%/+163.5%.
- **The combinational candidate remains unmeasured.** Bead `egt` answered "can Bambu emit a
  zero-register datapath" with **yes** (functionally, pre-synthesis); this follow-up shows that
  answer does not yet extend through physical-design synthesis — the ASAP7 flow's default
  optimization settings do not reliably preserve that datapath's function for this design shape.
  The datapath half of the pilot's original recommendation is therefore still untested at the PPA
  level, exactly as Stage 1/2 left it.

---

# GH #119 `gcd` follow-up — comb candidate root-caused (Synlig) and fixed (2026-09-15)

**Root cause: the Synlig/UHDM SystemVerilog frontend (`USE_SYNLIG:true`, LibreLane's default),
not LibreLane's opt passes.** Two other hypotheses were tested and empirically DISPROVED first:

1. `opt_expr -undriven` (gated by `SYNTH_TIE_UNDEFINED`, default `"low"`): setting it `null`
   reproduced the byte-identical broken 1587-instance netlist. Re-reading `librelane_synth()`
   (`librelane/scripts/pyosys/synthesize.py`) shows the offending `OPT_MUXTREE` call is inside the
   *very first* `librelane_opt(d, nodffe=True, nosdff=True)` call, which never receives
   `undriven=` at all — `SYNTH_TIE_UNDEFINED` cannot affect it regardless of config.
2. `SYNTH_SHARE_RESOURCES` (already documented as a real, separate hazard for this design shape —
   see the note in `pnr/asap7/valu_hls_comb/config.json`): real, but re-running with only that fix
   applied reproduced byte-identical broken metrics, proving it was not the dominant cause.

**Proof of divergence.** A SAT-based miter (yosys 0.46 — the exact binary LibreLane's flow uses —
with real ASAP7 functional cell models parsed directly from the same liberty files LibreLane
loads, via `read_liberty -ignore_miss_func`) between the pristine candidate and the broken netlist
was unconstrained-SAT (a mismatch exists, but includes don't-care states under reset/idle).
**Constrained to the valid handshake window** (`rst_n=1`, `start_i=1` fixed) it is **still SAT**:

> Counterexample: `opcode_i=VMUL(3)`, `active_mask_i=8'b00000001` (lane 0 only active),
> `rs1_i`/`rs2_i` nonzero only in **inactive** lanes 2 and 7. The pristine RTL gives
> `result_o=0` (matches the already-passing `test_partial_mask` spec: "inactive lanes produce
> 0"); the broken netlist gives `result_o[lane2] = rs1_i[lane2]` (`0x40000000`) leaked straight
> through, unmasked. `done_o`/`branch_taken_o` match on both sides.

**Localisation.** The corrupted construct is `ui_cond_expr_FU` (a Bambu/PANDA generic IP-library
module, `assign out1 = in1 != 0 ? in2 : in3;`, `vector_alu_synth.v:330-347`), instantiated
per-call-site with its own parameterization to implement "output 0 when `active_mask_i[lane]=0`".
`05-yosys-synthesis.log`'s `OPT_MUXTREE` step deletes 271 of its `$ternary$` cells' mux ports in
the broken run (only 10, legitimately dead, once fixed) — this is exactly where the masking
branch gets pruned. Full writeup, the exposure audit of the baseline FSM arm, and the CPU/GPU
hand-RTL exposure verdict are on bead `claude_verilog_test-b0t` (opened for the general
`USE_SYNLIG:true` audit) and bead `claude_verilog_test-gcd`.

**Fix.** Bypass Synlig for this leaf: pre-process `gpu_pkg.sv` + the shim through `sv2v` (the
project's existing Synlig fallback, already used for the SoC ASAP7 flow — see `sky130-soc-sv2v`
in `pnr/Makefile`) into plain Verilog-2005, point `VERILOG_FILES` at the sv2v output instead of
the raw `.sv` + `gpu_pkg.sv`, and set `USE_SYNLIG:false`. Made reproducible via
`make -C pnr egt-valu-hls-comb-sv2v` (auto-run by `librelane-asap7-valu-hls-comb`) — see
`pnr/asap7/valu_hls_comb/config.json`'s `USE_SYNLIG_NOTE`.

**Fix verification.** A full-width SAT re-proof (fixed netlist vs. RTL candidate) did not converge
within the 3G/~10min budget — 32×32 multiplier equivalence at full width is classically SAT-hard
(238K cells / 1.1M variables after `flatten`). A full 14-vector Verilator/cocotb regression against
the fixed netlist's functional-liberty-modeled Verilog also could not be completed: `flatten`
exploded the 47,791-cell netlist to ~238K primitive gates before `write_verilog`, and the resulting
Verilator build did not finish in over 50 minutes wall-clock. The fix was first verified (same
session) by direct `eval` (yosys, real ASAP7 functional cell models, no SAT) on **5 discriminating
vectors**: the original counterexample plus VADD/VSLL/VAND with garbage data in inactive lanes and
VMUL with all 8 lanes active and distinct per-lane operands — all 5 matched the RTL candidate
exactly, byte-for-byte, on `done_o`/`result_o`/`branch_taken_o`.

**2026-09-15, follow-up (bead `egt`, coordinator-directed): verification widened to 252 vectors.**
The 5-vector check above is superseded, not retracted, by a much larger independent cross-check
against the *golden model*, not the RTL candidate: `tools/verif/gls/gen_vector_alu_vectors.py`
generates 252 vectors (random + corners) computed from the Python expected-value formulas embedded
directly in `tb/cocotb/gpu/test_vector_alu.py` — every non-branch opcode the suite exercises
(VADD/VSUB/VMUL/VAND/VOR/VXOR/VSLL/VSRL/VSRA), VADDI/VANDI immediate sweeps, VBEQ/VBLT branch
corners+random, and a dedicated 12-mask-pattern × 8-op partial-active-mask sweep with garbage
forced into every inactive lane — the exact corruption class the original SAT-miter counterexample
exposed. `tools/verif/gls/make_eval_ys.py` batches one yosys `eval` call per vector
(`read_liberty -ignore_miss_func` over the 5 ASAP7 `asap7sc7p5t_SIMPLE` libs, `read_verilog`,
`hierarchy`, `proc`, `flatten`, `opt -full`, then 252× `eval -set ... -show done_o -show result_o
-show branch_taken_o`) against the netlist actually referenced by the **tracked**
`pnr/asap7/valu_hls_comb/config.json` — run `RUN_2026-09-15_15-06-29`
(`05-yosys-synthesis/vector_alu_hls.nl.v`, `USE_SYNLIG:false` + sv2v, 47 791 instances; *not* the
later `RUN_2026-09-15_16-29-18`, a leftover `USE_SYNLIG:true` diagnostic re-run of the
already-known-broken 1587-instance netlist). All 252 evals completed in one batched yosys
invocation (~6 minutes wall clock, ~1 GB peak, no SAT, no flatten-to-primitives explosion since only
`opt -full` runs once and is amortized across all 252 evals). `tools/verif/gls/parse_eval_log.py`
compared every vector: **252/252 PASS — 0 mismatches, 0 `X` in any output**, on both `done_o` and
the full `result_o`/`branch_taken_o` vectors, including every garbage-in-inactive-lane partial-mask
case. Combined with the original SAT-miter proof (which showed *what* the pre-fix netlist got
wrong) and the 5-vector direct match to the RTL candidate, this closes the fix-verification gap the
original 5-vector check left open. **The `comb` (fixed) row of the comparison table below is now
quotable without the earlier caveat** — see the next section. The RTL-candidate side of this
specific 252-vector run could not be repeated (yosys's own, non-Synlig Verilog frontend does not
accept the port-adapting shim's `module vector_alu_hls import gpu_pkg::*; (...)` import-in-header
SystemVerilog syntax); that side still rests on the original 5-vector + 14-vector Verilator/cocotb
evidence above, which is unaffected.

## Corrected comb metrics (`RUN_2026-09-15_15-06-29`, `USE_SYNLIG:false` + sv2v)

**These numbers are now quotable without caveat** (2026-09-15 update, bead `egt`): the 252-vector
yosys-`eval` cross-check above confirms this exact run's netlist is functionally correct, so
`comb` (fixed) = **47 791 instances / 4139.77 µm² / 14.060 mW**, vs. hand-RTL `rtl` = **54 634 /
4655.15 / 14.147**, is a valid area/power comparison — `comb` is smaller and lower-power than
hand-RTL. The timing figures (Setup/Hold WS, TNS, and any derived fmax) still carry the worst-arc
and no-resizer caveats below; only area and power are resizer-independent and safe to quote
unconditionally.
> ⚠️ **Update 2026-09-19 (bead `b0t`):** the "`hls` remains functionally unresolved" sentence
> below is superseded — the baseline FSM arm was proven **corrupt** by gate-level simulation
> (bead `b0t` part B) and the tracked config has since been fixed (`USE_SYNLIG:false` + sv2v). The
> `hls` column in the table immediately below is the **pre-fix, corrupt-netlist** measurement; see
> the footnote on that column and the "Baseline FSM arm" §"REMEDY APPLIED" block further down for
> the corrected, functionally-verified figures.
The baseline FSM arm (`hls`, `USE_SYNLIG:true`) remains functionally unresolved —
see "Baseline FSM arm ... — verdict: INCONCLUSIVE" further down and bead `claude_verilog_test-b0t`
— so do not compare `comb` against `hls` as if `hls`'s own netlist correctness were settled; the
`hls` row below is included for reference only, carried over unchanged from the Stage-2 baseline.

| Metric | `comb` (fixed) | `rtl` | `hls`[^hls-corrupt] |
| :--- | ---: | ---: | ---: |
| Instances | 47 791 | 54 634 | 71 480 |
| Area (µm²) | 4139.77 | 4655.15 | 7254.37 |
| Power (mW) | 14.060 | 14.147 | 37.667 |
| Setup WS (ps) | −190.50 | −54.29 | −996.18 |
| Setup TNS (ps) | −14 657.70 | −2465.20 | −3 779 683.10 |
| Hold WS (ps) | −1.01 | +8.77 | −13.01 |

[^hls-corrupt]: This `hls` column was measured on the netlist later proven **corrupt** by
    gate-level simulation (bead `b0t` part B, 2026-09-18) and superseded 2026-09-19 when the
    remedy (`USE_SYNLIG:false` + sv2v) was applied to `pnr/asap7/valu_hls/config.json`. The
    corrected, GLS-verified figures are **89 224 instances / 9188.40 µm² / 52.7 mW / Setup WNS
    −1507.04 ps / Setup TNS −7 942 937.40 ps / Hold WNS −11.95 ps** — see the "REMEDY APPLIED"
    block under "Baseline FSM arm" below. This column is left unaltered for provenance; treat it
    as a measurement of a broken netlist, not a valid `hls`-arm PPA point.

`comb` is the **smallest and lowest-power** of the three arms (−11.1% area, −0.6% power vs. `rtl`;
−42.9% area, −62.7% power vs. `hls`) — consistent with a zero-register, zero-clock-tree
combinational datapath. Its setup WS is worse than `rtl`'s (both are pure combinational virtual-clock
paths, so directly comparable): `comb`'s critical path is a naive one-shot Bambu-generated 8-lane
datapath with no hand RTL retiming/balancing, `rtl`'s is hand-optimized.

### Worst-arc decomposition (`comb`, mandatory per the
`asap7-to-openroad-staprepnr-comparisons-stopping-before-the` memory note)

| Arm | Critical path total | Single worst arc | Arc share | Arc fanout |
| :--- | ---: | ---: | ---: | ---: |
| `comb` (fixed) | 885.50 ps (combinational, virtual clock, `rs2_i[226]`→`result_o[251]`) | 60.68 ps (`AOI32xp33`) | **6.9%** | 4 |

Unlike `hls`'s FSM arm (58.8% of its critical path on one 469-fanout net — see above), `comb`'s
worst single arc is a modest 6.9% share at fanout 4: no single unbuffered net dominates, so its
WNS/TNS are a reasonably representative (if unoptimized) measurement, not a resizer-absence
artifact. Do not compute a `comb`-vs-`rtl`/`hls` fmax ratio without carrying the "no resizer at
`--to OpenROAD.STAPrePNR`" caveat regardless.

## Baseline FSM arm (`valu_hls`, `USE_SYNLIG:true`) — ⚠️ RESOLVED 2026-09-18: **CONFIRMED CORRUPT**

> ⚠️ **The "INCONCLUSIVE" verdict below is SUPERSEDED (bead `b0t`, 2026-09-18).** A gate-level
> simulation of both netlists settled it: the tracked **`USE_SYNLIG:true` netlist is CORRUPT** and
> the `USE_SYNLIG:false` + sv2v candidate is **CLEAN**. Three independent golden vectors (VMUL
> partial-mask, VADD full-mask, VAND alternating-mask) were driven through both 43-cycle
> simulations: HLS-SYNLIG produced garbage on **all three** (no match in either lane order),
> HLS-SV2V matched the golden model **bit-exact on all three, all 8 lanes**. Same Synlig/UHDM
> defect class already root-caused for the `comb` arm — it corrupts the FSM/registered arm too.
>
> **What broke the three prior sessions' tooling wall:** `flatten` *before* yosys `sim -r` (not
> `opt -full`), using the committed hand SEQ-cell models `tools/verif/gls/asap7_seq_cell_models.v`.
> Both full 43-cycle simulations then complete in **under 2 minutes each at ~1 GB peak**, inside a
> 4 GB cap — versus the earlier `sat -seq` 3 GB OOM on a single unrolled timestep and the
> 560 s+ wire-matching timeout on the unflattened netlist. Driver:
> `tools/verif/gls/run_hls_seq_check.py`.
>
> **Consequence for the numbers in this document:** every `valu_hls` PPA figure quoted here
> (**71 480 instances / 7254.37 µm² / 37.667 mW**) was measured on the **corrupt** netlist and is
> therefore not a valid PPA point for a working design. The honest figure for a functionally
> correct `valu_hls` is the sv2v candidate's **89 224 instances / 9188.40 µm² / 52.7 mW**. Any
> `rtl`-vs-`hls` comparison in this document that uses the 7254 µm² / 37.667 mW column
> **understates HLS area and power by ~25–40 %**. The historical numbers are left unaltered above
> for provenance; treat them as measurements of a broken netlist.
>
> **Remedy NOT applied, pending approval:** switching `pnr/asap7/valu_hls/config.json` to
> `USE_SYNLIG:false` + the sv2v shim (the same fix already applied to `valu_hls_comb`) would make
> the block correct at the cost of materially worse headline PPA, because the current sign-off
> numbers reflect the smaller, broken netlist. `valu_hls` is an isolated HLS experiment block and
> is **not** part of the signed-off SoC.
>
> Evidence: netlists `/nobackup/asap7_valu_hls_runs/RUN_2026-09-15_14-05-40/final/nl/vector_alu_hls.nl.v`
> (corrupt) and `/nobackup/pnr_ab_valu_hls/runs/RUN_2026-09-15_16-34-19/final/nl/vector_alu_hls.nl.v`
> (clean); logs/VCDs under `/nobackup/b0t_partB/`. Full detail on bead `claude_verilog_test-b0t`.

> ✅ **REMEDY APPLIED 2026-09-19 (user-approved, bead `b0t`).** `pnr/asap7/valu_hls/config.json` is
> now `USE_SYNLIG:false` + the sv2v-preprocessed shim (mirroring `valu_hls_comb/config.json`'s
> `USE_SYNLIG_NOTE`/fix exactly), reproducible via the new `make -C pnr r8r-valu-hls-sv2v` target
> (auto-run by `librelane-asap7-valu-hls`). The sv2v output was regenerated and confirmed
> byte-for-byte identical (`sha256sum`, not a filtered `diff` — see the RTK `diff`-exit-code caveat
> elsewhere in this repo) to the file already used by the 2026-09-15 A/B run.
>
> **Reused, not re-run:** the tracked config now differs from the A/B candidate run
> (`RUN_2026-09-15_16-34-19`) in **zero** functional keys — a programmatic key-by-key diff of both
> `config.json`s (ignoring `//`-comment keys) found only the two intentional changes
> (`VERILOG_FILES`, `USE_SYNLIG`) and no others (same SDC, same `CLOCK_PERIOD`, same
> `FP_CORE_UTIL`/density, same everything else). Per the coordinator's explicit reuse condition,
> that run's numbers are adopted directly rather than re-running LibreLane:
>
> | Metric | Corrupt (tracked pre-fix) | **Fixed (now tracked)** |
> | :--- | ---: | ---: |
> | Instances | 71 480 | **89 224** |
> | Area (µm²) | 7254.37 | **9188.40** |
> | Power (mW) | 37.667 | **52.7** |
> | Setup WNS (ps) | −996.18 | **−1507.04** |
> | Setup TNS (ps) | −3 779 683.10 | **−7 942 937.40** |
> | Hold WNS (ps) | −13.01 | **−11.95** |
>
> **Functional verification of the certified netlist:** `tools/verif/gls/run_hls_seq_check.py` was
> re-run (fresh, this session, not reusing the earlier session's ad-hoc logs) against
> `RUN_2026-09-15_16-34-19/final/nl/vector_alu_hls.nl.v` — the exact netlist whose PPA is now
> adopted above — for all 3 golden vectors used to originally confirm corruption:
>
> | Vector | Tag | Result |
> | :--- | :--- | :--- |
> | 109 | `VADD_mask01_0xff` (full mask) | **PASS**, bit-exact, forward lane order |
> | 134 | `VMUL_mask02_0x01` (partial mask) | **PASS**, bit-exact, forward lane order |
> | 148 | `VAND_mask04_0x55` (alternating mask) | **PASS**, bit-exact, forward lane order |
>
> 3/3 PASS. Commit applying this remedy: `f2445ad` ("[PD] b0t: apply approved Synlig fix to
> valu_hls baseline FSM arm" — `pnr/Makefile` + `pnr/asap7/valu_hls/config.json`). The historical
> "corrupt" figures above are left unaltered for provenance.

### Original (superseded) verdict: INCONCLUSIVE, not re-fixed

An A/B synthesis (temp config under `/nobackup/pnr_ab_valu_hls/`, tracked
`pnr/asap7/valu_hls/config.json` left unmodified) reran the SAME baseline candidate through
`USE_SYNLIG:false` + an sv2v-preprocessed shim: **89 224 instances / 9188.40 µm² / 52.7 mW**, vs.
the tracked Synlig run's **71 480 / 7254.37 µm² / 37.667 mW** — a **~25–40% gap**, present
proportionally from the very first synthesis-log cell-count checkpoint onward (43 659 vs. 55 084),
not the ~1–2% that would indicate no corruption. **This does not by itself prove which side (if
either) is correct.** A clocked functional cross-check of the baseline (needed because it is a
registered, multi-cycle FSM, unlike the zero-register `comb` candidate) was attempted and blocked
by two independent tool/resource walls: yosys 0.46's `sim -set` throws a syntax error despite
being documented in `help sim` (order-independent, reproduced minimally); a full Verilator/cocotb
cosim of either baseline gate netlist OOMs at the mandated 3G cap even without `flatten`
(Verilator's own front-end, not the compile step, on a ~71–89K-cell liberty-functional-model
netlist). **Do not apply the `comb` arm's fix to the tracked `valu_hls` config** without a
functional proof of which size is correct — blind reuse could make it worse, not better. Tracked
on bead `claude_verilog_test-b0t` for follow-up (candidates: get `sim -set` working, possibly via
the yosys 0.62 build already on this host, or budget a >3G Verilator cosim).

## CPU/GPU hand-RTL exposure verdict: NOT exposed to this specific construct

> 🔴 **UPDATE 2026-09-19 (bead `u99` → `ma7`): the "NOT exposed" verdict below is WRONG for the CPU
> macro.** A differential — the *same* testbench, ROM and cycle sequencing run against the Synlig
> gate netlist (`pnr/asap7/soc/macro/rv32i_cpu_top.nl.v.gz`, sha256-verified) and against RTL
> simulation — showed the gate netlist returns **0x30** for an APB debug read of `DBG_GPR[4]` where
> RTL returns the correct **0x0c**. Since only the Synlig-built netlist diverges, harness error,
> timing races and debug-register-semantics explanations are all excluded. Mechanism is the same
> class as `gcd`/`b0t` part B: `OPT_MUXTREE` mis-elaborating a **runtime-indexed mux**.
>
> The code-shape argument failed because it searched for Bambu's *specific* `ui_cond_expr_FU`
> template. The actual trigger is more general — a plain runtime-indexed read. `rtl/cpu/core/rv32i_regfile.sv`
> uses that idiom on **all three** read ports: `rd_data1 = regs[rd_addr1]` and
> `rd_data2 = regs[rd_addr2]` (both feed ID/execute) and `dbg_rd_data = regs[dbg_rd_addr]`
> (proven corrupt). `rtl/gpu/warp_scheduler.sv:152` (`div_depth[exec_warp_id_i]`) is the same
> class, untested.
>
> ⚠️ **Do not read this as "only the debug path is affected."** The `u99` run verified instruction
> words and PC retire *order* over a 6-instruction straight-line program — it did **not** verify
> architectural register *values*, and corrupted main read ports would not necessarily perturb PC
> order on straight-line code. The execute read ports are **UNVERIFIED, not proven clean**.
> Bounding that exposure, and the remedy (switch the CPU/GPU configs to `USE_SYNLIG:false` + sv2v,
> which forces a re-harden of both macros and a SoC re-run, and will likely worsen PPA the way
> `valu_hls` did) are tracked on bead **`ma7`** (P1). Until then, every ASAP7 CPU/GPU macro PPA
> figure rests on a netlist from a frontend with a **proven** miscompile in this repo.
>
> 🔴 **UPDATE 2026-09-19 (bead `ma7` step 1): CONFIRMED — the corruption reaches the execute
> datapath, not just the debug port.** Method: extended the same `tools/verif/gls/tb_cpu_macro_check.v`
> two-arm harness (arm 1 = Synlig gate netlist, arm 3 = RTL/Verilator, same testbench file, same
> netlist — decompressed sha256 `a416d23f0380...`, exact match to `u99`'s originally-verified copy)
> with a new BRANCH-DEPENDENT program (`tools/verif/gls/gen_cpu_check_rom_branch.py`, verified
> bit-exact against `tb/models/rv32i_model.py` first): `x1=5; x2=9; x3=9; x4=x1+x2; BEQ x2,x3 -> PASS
> if taken (x2==x3, must be TAKEN) else WRONG marker; ...`. This makes an ID-stage regfile read
> corruption (`rd_data1`/`rd_data2`, which feed EX — **not** the known-bad debug port) observable
> through `commit_pc_o`/`commit_insn_o`, the channel `u99` already showed is reliable.
>
> Result: **both arms retire an identical trace through the BEQ instruction's own fetch**
> (`0x00,0x04,0x08,0x0c,0x10`, same insn words) and **diverge exactly at that instruction's
> commit**. Arm 3 (RTL) continues `0x10,0x20,0x24,0x28` and parks at PASS — BEQ correctly TAKEN,
> matching the Python reference model bit-exact. Arm 1 (the same Synlig netlist `u99` used)
> continues `0x10,0x14,0x18` and parks at the dead WRONG marker — BEQ **incorrectly evaluated
> NOT-TAKEN**. 0 yosys ERRORs in the run. Since fetch/decode are proven identical up to and
> including the branch instruction itself, the divergence is isolated to the branch comparator's
> consumption of the ID-stage read-port values for x2/x3 — a genuinely different signal than
> `u99`'s `dbg_rd_data`.
>
> **Exact coverage claim (not a general proof):** proven corrupt for register indices x2 (value 9)
> and/or x3 (value 9) as read by the branch comparator's rs1/rs2 ports in this specific access
> pattern; cannot distinguish which port (or both) is wrong. The preceding `ADD x4,x1,x2` fetched
> identically in both arms but x4 is a dead value in this program (never read back), so that
> instruction's own operand-read correctness is **unproven** by this experiment. Not proven: other
> register indices, other instruction types (loads/stores/JALR), or repeated/back-to-back-branch
> access patterns.
>
> **Read-port cone-sharing (RTL source, not confirmed in netlist):** `rv32i_regfile.sv` has three
> independent `always_comb` blocks (`rd_data1`, `rd_data2`, `dbg_rd_data`), each its own
> runtime-indexed mux keyed by an independent address signal (ID-stage rs1/rs2 vs. APB-derived
> `dbg_rd_addr`) — no shared select logic at RTL, only the underlying storage flops are shared.
> The post-synthesis netlist is fully flattened with anonymous net names (grep for
> `rd_data1`/`rd_data2`/`dbg_rd_addr`/`regfile` returns zero hits), so cone-sharing could not be
> confirmed by netlist inspection without a hierarchy-preserving resynthesis (not attempted here).
> This is consistent with independent per-port instances of the same `OPT_MUXTREE` defect class,
> not one bug already fully characterized by `u99`. `ma7` stays OPEN — GPU untested, remedy not
> applied, both still need a human decision. Full write-up: bead `ma7` notes.

> 🔴 **UPDATE 2026-09-19 (bead `ma7` remedy, PARTIALLY APPLIED — CPU re-harden BLOCKED).** The
> `USE_SYNLIG:false` + sv2v remedy (same fix already applied to `valu_hls`) was applied to
> `pnr/asap7/cpu/config.json`/`config_3014.json`, but the CPU macro's own re-harden PD run has
> **not completed cleanly**: it reaches `OpenROAD.DetailedRouting` (synth/floorplan/CTS/GRT/
> resizer all pass) and then hits a new, unresolved routing-congestion regression — 108716 DRC
> violations vs. this block's own best-ever prior routed baseline of 2045, `DRT-0255` failures on
> SRAM macro pins, zero parasitics extracted, `STAPostPNR` failure. `pnr/asap7/soc/macro/
> rv32i_cpu_top.*` therefore remain the OLD, Synlig-built, proven-corrupt views — nothing was
> regenerated. GPU config was switched (`USE_SYNLIG:false`) for consistency only; the GPU
> re-harden itself remains fully deferred (host-gated). Full attempt history, ruled-out causes,
> and the open decision point: bead `ma7` notes, bead `claude_verilog_test-lxv`,
> `docs/ASAP7_RUN_HISTORY.md`'s 2026-09-19 addendum.

> ✅ **UPDATE 2026-09-18 (bead `b0t` part A)**: the code-shape argument below has since been backed
> by a real frontend **differential** — replaying LibreLane's exact `librelane_opt(nodffe=True,
> nosdff=True)` sequence through two independent frontends on the same RTL and comparing
> mux-port removal. **CPU macro (`rv32i_cpu_top`): clean** — the real Synlig run removes *fewer*
> mux ports than an independent slang differential (800 vs 1358), matching 1:1 by register name on
> sampled branches: the opposite signature from the corruption proven above. **GPU macro
> (`gpu_top`): clean on every point investigated** — `vector_alu` matches exactly (16/16) across
> frontends, and `shared_memory`'s large raw divergence (1001 vs 1) resolved to **0 disproven
> points** under a direct EQY, with all 256 unproven points being SRAM-blackbox read-data bits.
> Still unproven: no full gate-level check of either complete macro, and three smaller GPU
> divergences (`gpu_compute_unit`, `memory_coalescer`, `gpu_top` glue) are differential-only.
> Scripts: `tools/verif/synlig_audit/`.

`grep -rl "ui_cond_expr_FU|_bambu_artificial_|BAMBU/PANDA" rtl/` returns **zero matches** anywhere
in `rtl/`. The hand-written RTL (`rtl/gpu/vector_alu.sv`, `rtl/cpu/*`) implements the identical
"inactive lane → 0" masking semantics via a plain `if (active_mask_i[lane])` inside a
generate/for-loop — a completely different code shape from Bambu's massively
per-instance-parameterized generic FU template instantiation pattern that Synlig mis-elaborates
here. The *specific* failure mode proven in this section does not structurally apply to the
CPU/GPU macros. This is a structural/code-shape argument, not a functional re-verification of the
CPU/GPU macros — per explicit instruction this session did not re-run those flows, so their
`USE_SYNLIG:true` configs remain functionally unaudited (tracked on bead `claude_verilog_test-b0t`).
