chuanseng-ng/claude_verilog_test/tb/cocotb/soc/coremark_results.md

# CoreMark-Representative Benchmark Results (M10c-3)

Generated by `test_l2_bench.py` / `test_coremark_bench`.
DUT: `tb_soc_top` with `SRAM_MEM_WORDS=65536`, `DCACHE_WAYS=1` (direct-mapped, shipping default).
Firmware: `sw/bench/coremark` — 3-kernel port (list sort + 2×2 matmul + CRC-16), ITERATIONS=1.
Sim stopped at cycle 34258.

## Raw Counters

| metric | value |
| --- | ----: |
| Δcycles | 7750 |
| Δinstret | 1463 |
| ΔI\$-miss  | 45 |
| ΔD\$-miss  | 14 |

## Miss Rates

| metric | value |
| --- | ----: |
| I\$-miss / 1k-instr | 30.76 |
| D\$-miss / 1k-instr | 9.57 |
| D\$-miss / 1k-cycle | 1.81 |

## Key Finding

Working-set analysis: list (80 B) + matmul (24 B) + CRC buf (16 B) + overhead (~112 B) ≈ 232 B.
The entire CoreMark data working set is **< 6% of the 4 KB L1 D-cache**.

D\$-miss/kI = 9.57: representative embedded firmware fits the direct-mapped L1 with negligible capacity or conflict pressure.
Cold-fill misses account for any non-zero D\$-miss count at this working-set size.

> **Conclusion (M10c-3):** CoreMark-representative firmware shows no L1 D\$
> capacity or conflict pressure with the shipping direct-mapped 4 KB cache.
> The L2 go/no-go decision must be driven by application-specific working sets
> (e.g. the 8+ KB threshold revealed by the sweep benchmark), not by CoreMark.
