chuanseng-ng/claude_verilog_test/docs/verification/VERIFICATION_PLAN.md

# Verification Plan

Phase-Aligned Verification Strategy with AI/Human Responsibilities

Document status: Frozen
Last updated: 2026-01-17

## Overview

This document defines the verification strategy for all project phases, detailing what to verify,
how to verify it, and clear AI vs Human responsibilities for verification tasks.

### Core Principles

1. **Python is the golden reference**: Reference models define correctness
2. **Scoreboards decide truth**: RTL behavior compared against reference models
3. **Randomized stress > Directed tests**: After smoke tests pass, emphasize random testing
4. **Verification precedes optimization**: Never optimize unverified RTL
5. **Specification-driven**: All verification derives from architectural specs

### Verification Stack

**Tools**:

- **cocotb**: Signal-level drivers, monitors, clocking, resets
- **pyuvm**: Structure, sequences, agents, scoreboards
- **Python reference models**: Golden behavioral models (see REFERENCE_MODEL_SPEC.md)
- **pytest**: Unit testing for reference models and testbench components

**Simulation**:

- **Verilator**: Fast, free, linting
- **Questa/Xcelium**: Full-featured (if available)

## Phase 0 Verification

**Status**: Specification and model development (no RTL)

### Objectives

1. Validate that specifications are complete and unambiguous
2. Implement Python reference models
3. Develop testbench infrastructure
4. Create initial test sequences

### Deliverables

| Deliverable | Description | AI/Human Responsibility |
| :---: | :---: | :---: |
| CPU reference model | RV32IModel class implementing all 37 instructions | **Human writes**, AI assists with boilerplate |
| GPU reference model | GPUKernelModel class (skeleton only) | **Human designs**, AI assists |
| Memory model | MemoryModel class for sparse memory | AI may generate, **Human reviews** |
| cocotb infrastructure | Clock, reset, basic drivers | AI may generate, **Human reviews** |
| Model unit tests | pytest tests for reference models | **Human writes critical tests**, AI assists |

### AI Responsibilities (Phase 0)

AI MAY assist with:

- Generating Python class boilerplate
- Simple instruction implementations (ADD, SUB, AND, OR, etc.)
- Memory model read/write functions
- cocotb clock and reset utilities
- Test case scaffolding

AI MUST NOT:

- Decide instruction semantics (must follow spec exactly)
- Design verification architecture
- Define what "correct" means

### Human Responsibilities (Phase 0)

Human MUST:

- Write and verify all branch instruction implementations
- Write and verify all load/store instructions
- Implement sign extension correctly
- Design scoreboard comparison strategy
- Cross-verify reference model against RISC-V ISA simulator (spike/QEMU)
- Review all AI-generated code

### Exit Criteria (Phase 0)

- ✅ CPU reference model implements all 37 RV32I instructions
- ✅ Reference model passes 100+ unit tests
- ✅ Reference model cross-validated against spike (10k+ instructions)
- ✅ cocotb infrastructure can drive reset and clock
- ✅ Memory model tested with various access patterns
- ✅ All team members agree specifications are complete

### Test Metrics (Phase 0)

| Metric | Target |
| :----: | :----: |
| Reference model instruction coverage | 37/37 (100%) |
| Reference model unit test pass rate | 100% |
| Cross-validation vs spike agreement | 100% |

---

## Phase 1 Verification

**Status**: Single-cycle CPU with interfaces

### Objectives

1. Verify RV32I instruction correctness
2. Verify AXI4-Lite protocol compliance
3. Verify APB3 debug interface
4. Verify commit interface correctness
5. Prove RTL matches reference model

### Test Architecture

```text
pyuvm Test
    └── pyuvm Environment
        ├── AXI4-Lite Agent (memory)
        │   ├── Driver (memory slave model)
        │   ├── Monitor (transaction logging)
        │   └── Sequencer (back-pressure randomization)
        ├── APB3 Agent (debug master)
        │   ├── Driver (debug commands)
        │   ├── Monitor (response checking)
        │   └── Sequencer (halt/resume/step sequences)
        ├── Commit Monitor
        │   └── Captures commit_valid, commit_pc, commit_insn
        └── Scoreboard
            ├── RV32IModel instance
            ├── Compare commits against model
            └── Flag mismatches
```

### Test Categories

#### 1. Smoke Tests (Directed)

**Purpose**: Verify basic functionality before random testing

| Test Name | Description | AI/Human |
| :---: | :---: | :---: |
| `test_reset` | Verify PC = 0x0000_0000, all regs = 0 | AI may write, **Human reviews** |
| `test_simple_add` | Execute ADD, verify result | AI may write, **Human reviews** |
| `test_branch_taken` | Execute BEQ with true condition | **Human writes** |
| `test_load_store` | LW then SW to same address | **Human writes** |
| `test_halt_resume` | Debug halt and resume sequence | **Human writes** |

**AI assistance**: AI may generate test structure, human must verify logic.

**Human responsibility**: Review and approve all smoke tests.

**Exit criteria**: All smoke tests pass.

#### 2. ISA Compliance Tests (Directed)

**Purpose**: Test every instruction in isolation

**Test generation**:

```python
# Example: Test all arithmetic instructions
@cocotb.test()
async def test_isa_arithmetic(dut):
    instructions = [
        ("ADD",  0x002081b3, x1=10, x2=20, expect_x3=30),
        ("SUB",  0x402081b3, x1=30, x2=10, expect_x3=20),
        # ... all 37 instructions
    ]
```

**AI may assist**: Generating instruction encodings and test loops

**Human must**: Verify expected values, edge cases (overflow, signed, etc.)

**Coverage target**: 37/37 instructions executed at least once

#### 3. Random Instruction Tests (Constrained Random)

**Purpose**: Stress test with random legal instruction sequences

**Strategy**:

```python
class RandomInstructionSequence(uvm_sequence):
    def body(self):
        for _ in range(10000):
            insn = self.generate_random_instruction()
            self.start_item(insn)
```

**Constraints**:

- Only generate legal RV32I instructions
- Ensure memory addresses are in valid range
- Avoid infinite loops (use instruction count limit)

**AI may**: Generate random instruction generator framework

**Human must**: Define constraints, verify randomization quality

**Coverage target**: 10,000+ random instructions, zero failures

#### 4. AXI4-Lite Protocol Tests

**Purpose**: Verify AXI4-Lite master compliance

| Test Name | Description | AI/Human |
| :---: | :---: | :---: |
| `test_axi_read_basic` | Simple read transaction | AI may write |
| `test_axi_write_basic` | Simple write transaction | AI may write |
| `test_axi_backpressure` | Randomize READY signals | **Human writes** |
| `test_axi_error_response` | SLVERR/DECERR handling | **Human writes** |

**Protocol checker**: Use cocotb AXI monitor to check protocol violations

**AI may**: Generate basic transaction tests

**Human must**: Test error cases, back-pressure, edge conditions

#### 5. Debug Interface Tests

**Purpose**: Verify APB3 debug functionality

| Test Name | Description | AI/Human |
| :---: | :---: | :---: |
| `test_debug_halt` | Halt CPU via DBG_CTRL | **Human writes** |
| `test_debug_resume` | Resume execution | **Human writes** |
| `test_debug_single_step` | Execute one instruction | **Human writes** |
| `test_debug_breakpoint` | Breakpoint triggers halt | **Human writes** |
| `test_debug_reg_read` | Read GPRs when halted | AI may write, **Human reviews** |
| `test_debug_reg_write` | Write GPRs when halted | **Human writes** |

**Human responsibility**: All debug tests due to complexity

### Scoreboard Implementation

```python
class CPUScoreboard(uvm_component):
    def __init__(self, name, parent):
        super().__init__(name, parent)
        self.model = RV32IModel()  # Reference model
        self.mismatches = 0

    def write_commit(self, txn):
        """Called when RTL commits an instruction"""
        # Step reference model with same instruction
        ref_result = self.model.step(txn.insn)

        # Compare PC
        if txn.pc != ref_result['pc']:
            self.log.error(f"PC mismatch: RTL={txn.pc:08x}, Model={ref_result['pc']:08x}")
            self.mismatches += 1

        # Compare register writes
        if ref_result['rd'] is not None:
            rtl_rd_val = self.get_rtl_register(ref_result['rd'])
            if rtl_rd_val != ref_result['rd_value']:
                self.log.error(f"Register x{ref_result['rd']} mismatch")
                self.mismatches += 1

        # Compare memory writes
        if ref_result['mem_write']:
            # Check memory write matches
            pass  # Implementation details

    def report_phase(self):
        if self.mismatches == 0:
            self.log.info("PASS: No mismatches detected")
        else:
            self.log.error(f"FAIL: {self.mismatches} mismatches")
```

**Human responsibility**: Design and implement scoreboard logic

**AI may assist**: Boilerplate pyuvm structure

### AI/Human Responsibilities (Phase 1)

#### AI MAY assist with

- cocotb drivers for AXI4-Lite and APB3
- Simple directed test generation
- Random instruction generator framework
- pyuvm agent boilerplate
- Monitor transaction capture
- Coverage collection setup

#### Human MUST

- Design scoreboard comparison algorithm
- Implement complex test scenarios (debug, errors, back-pressure)
- Verify all test results
- Analyze failures and waveforms
- Decide when verification is "complete"
- Write assertions for critical properties

### Assertions (SystemVerilog)

**Note**: SVA assertions in separate files, not in RTL

**Critical assertions**:

```systemverilog
// No double write-back in same cycle
assert property (@(posedge clk) disable iff (!rst_n)
    commit_valid |-> ##1 !commit_valid || (commit_pc != $past(commit_pc))
);

// x0 always zero
assert property (@(posedge clk) disable iff (!rst_n)
    regfile.regs[0] == 0
);

// AXI4-Lite protocol: valid must not deassert after assert until ready
assert property (@(posedge clk) disable iff (!rst_n)
    $rose(axi_arvalid) |-> axi_arvalid throughout axi_arready[->1]
);
```

**AI may**: Generate assertion templates

**Human must**: Define critical properties to assert

### Coverage

**Instruction coverage**:

- Track which instructions executed
- Target: 100% of 37 RV32I instructions

**State coverage**:

- CPU states visited (FETCH, DECODE, EXECUTE, etc.)
- Debug states (HALTED, RUNNING)

**Edge coverage**:

- Transitions between states
- Halt while in different CPU states

**Cross coverage**:

- Instruction × CPU state
- Memory access × alignment

**AI may**: Generate coverage bins

**Human must**: Define coverage goals and analyze coverage gaps

### Exit Criteria (Phase 1)

| Criterion | Target |
| :---: | :----: |
| Instruction coverage | 37/37 (100%) |
| Smoke tests | 100% pass |
| Random instruction tests | 10,000+ instructions, 0 failures |
| AXI4-Lite protocol tests | 100% pass |
| Debug interface tests | 100% pass |
| Scoreboard mismatches | 0 |
| Known failing seeds | 0 |
| Code coverage | >95% (RTL lines) |
| State coverage | 100% (all states visited) |

> SoC / peripheral / NPU line + toggle coverage (GH #216): measured, triaged and enforced as a nightly gate (95 % per-module line floor + control-signal toggle floor, triaged trees only; bead `s1cg`) in [`SOC_COVERAGE_REPORT.md`](SOC_COVERAGE_REPORT.md); reproduce with `make -C tb/cocotb/soc soc_coverage` (nightly CI: `.github/workflows/soc_coverage.yml`).
>
> CPU / cache / GPU (`rtl/cpu|mem|gpu`) line coverage is part of the same nightly gate since bead `a5ze` (slice 2): every module of those three trees must reach the 95 % line floor on the combined SoC + CPU/cache/GPU data (category-b waivers for unreachable points). The 100 % control-toggle gate is deliberately NOT applied to them. See [`SOC_COVERAGE_REPORT.md`](SOC_COVERAGE_REPORT.md), sections "Gate decision" and "line triage, slice 2".

### Debugging Strategy

When failures occur:

1. **Check scoreboard logs**: Identify first mismatch
2. **Dump waveforms**: Examine cycle-by-cycle behavior
3. **Compare with reference model**: Step through both RTL and model
4. **Simplify test case**: Minimize failing sequence
5. **Add targeted assertions**: Catch bug earlier

**AI may**: Help analyze logs, suggest debugging approaches

**Human must**: Root-cause failures, fix RTL or model

### Physical Design Verification (NEW in Phase 1)

**Status**: Integrated with RTL verification flow

**Purpose**: Verify that the design is physically implementable and meets timing, power, and area targets.

#### 6. Synthesis and Place & Route Verification

**Flow Integration**:

The OpenROAD back-end flow runs after RTL verification passes:

```text
RTL Verification (cocotb + pyuvm)
    └── Pass smoke tests + ISA tests
        └── Synthesis (Yosys)
            └── Place & Route (OpenROAD)
                └── Static Timing Analysis (OpenSTA)
                    └── Power Analysis (OpenROAD)
                        └── Gate-Level Simulation (Verilator + SDF)
```

**Test Categories**:

| Test Category | Description | Tool | AI/Human |
| :---: | :---: | :--: | :---: |
| Synthesis lint | Check for synthesis warnings | Yosys | AI may run, **Human reviews** |
| CDC check | Clock-domain-crossing anti-patterns (`make cdc`) | Bedrock cdc_snitch (sv2v→yosys) | AI may run, **Human reviews** |
| Timing analysis | Check setup/hold violations | OpenSTA | **Human analyzes** |
| Power analysis | Validate power budget | OpenROAD | **Human analyzes** |
| DRC/LVS | Physical verification | KLayout | **Human reviews** |
| Gate-level sim | Functional + timing verification | Verilator | **Human validates** |

> **CDC check note:** `make -C sim cdc` runs Bedrock's `cdc_snitch` (sv2v → yosys → analysis).
> It is **informational / parked** — on the current single-clock SoC its `BAD` count is
> dominated by false positives (the async reset and synchronous APB/SPI ports are each
> modeled as a separate clock domain). It becomes a real `BAD=0` gate at Phase 6+ once
> actual clock domains exist. Full writeup: [`CDC_SNITCH_POC.md`](CDC_SNITCH_POC.md).

**AI may assist with**:

- Running synthesis and P&R scripts automatically
- Parsing timing/power/area reports
- Generating gate-level simulation testbenches
- Collecting metrics (WNS, TNS, power, area)

**Human must**:

- Analyze timing violations and determine root cause
- Decide on timing constraint adjustments
- Validate power analysis results
- Debug gate-level simulation mismatches
- Approve physical design sign-off

#### 7. Gate-Level Simulation

**Purpose**: Verify that the gate-level netlist matches RTL functionality and meets timing with back-annotated delays.

**Setup**:

```python
# cocotb gate-level simulation
import cocotb
from cocotb_test.simulator import run

def test_gate_level():
    run(
        verilog_sources=["pnr/results/rv32i_cpu_top.v"],  # Gate-level netlist
        toplevel="rv32i_cpu_top",
        module="tb_rv32i_cpu_top",
        simulator="verilator",
        compile_args=["--timing"],  # Enable timing checks
        extra_env={
            "SDF_FILE": "pnr/results/rv32i_cpu_top.sdf"  # Back-annotated delays
        }
    )
```

**Tests to Run**:

- All Phase 1 smoke tests (from RTL verification)
- Subset of random instruction tests (1,000+)
- Timing-sensitive scenarios (back-to-back instructions, memory access)

**Comparison**:

- Gate-level commits must match RTL commits
- Timing violations (setup/hold) = 0

**AI may**: Run gate-level tests automatically

**Human must**: Investigate any mismatches between RTL and gate-level

#### 8. Power-Aware Simulation (UPF)

**Purpose**: Verify power intent and isolation/retention strategies (Phase 2+ only, infrastructure in Phase 1).

**Phase 1 Scope**:

- Single power domain (no power gating)
- UPF infrastructure setup
- Supply net connectivity verification

**Phase 2+ Scope**:

- Multi-domain power gating
- Isolation cell functionality
- Retention cell functionality
- Power state transitions

**Test Approach (Phase 2+)**:

```python
@cocotb.test()
async def test_power_down_core(dut):
    """Test core power-down and isolation"""

    # Run some instructions
    await run_instructions(dut, count=100)

    # Save state
    pc_before = dut.i_rv32i_core.pc_reg.value

    # Power down core domain
    await power_ctrl.power_down_domain("PD_CORE")
    await Timer(100, units='us')

    # Check isolation (no X propagation)
    assert dut.commit_valid.value != 'x', "Isolation failed!"

    # Power up core domain
    await power_ctrl.power_up_domain("PD_CORE")

    # Check retention (state preserved)
    pc_after = dut.i_rv32i_core.pc_reg.value
    assert pc_before == pc_after, "Retention failed!"

    # Resume execution
    await run_instructions(dut, count=100)
```

**AI may**:

- Generate UPF test sequences
- Check for X propagation in waveforms
- Compare state before/after power cycling

**Human must**:

- Design power state transition sequences
- Validate isolation clamp values
- Verify retention register behavior
- Approve power-aware verification results

### Physical Design Exit Criteria (Phase 1)

| Criterion | Target | Tool |
| :---: | :----: | :--: |
| Synthesis warnings (critical) | 0 | Yosys |
| WNS (worst negative slack) | > 0 ns | OpenSTA |
| TNS (total negative slack) | 0 ns | OpenSTA |
| Setup violations (all corners) | 0 | OpenSTA |
| Hold violations (all corners) | 0 | OpenSTA |
| Clock skew | < 100 ps | OpenSTA |
| Total power @ 100 MHz | < 10 mW | OpenROAD |
| IR drop on power grid | < 5% | OpenROAD |
| DRC violations | 0 | KLayout |
| LVS errors | 0 | KLayout |
| Gate-level sim vs RTL match | 100% | Verilator |
| Gate-level timing violations | 0 | Verilator + SDF |

**Documentation**:

- Timing report summary (setup, hold, clock)
- Power report summary (total, per-module, clock tree)
- Area report summary (cell count, total area)
- Physical design lessons learned

**Sign-off**:

Human must review all reports and approve physical design before declaring Phase 1 complete.

---

## Phase 2 Verification

**Status**: Pipelined CPU (5-stage)

### New Verification Challenges

- Hazard detection and forwarding
- Pipeline stalls and flushes
- Speculative execution (if added)
- Branch misprediction recovery

### Test Additions

| Test Category | Description | AI/Human |
| :---: | :---: | :---: |
| Hazard tests | RAW, WAR, WAW dependencies | **Human designs**, AI generates variants |
| Pipeline stress | Back-to-back dependent instructions | AI may generate, **Human reviews** |
| Flush tests | Branch taken/not-taken sequences | **Human writes** |
| Forwarding tests | Data forwarding paths | **Human writes** |

### Assertions (Phase 2)

```systemverilog
// No architectural state change on flush
assert property (@(posedge clk) disable iff (!rst_n)
    flush |-> (regfile_state == $past(regfile_state))
);

// Forwarding correctness
assert property (@(posedge clk) disable iff (!rst_n)
    (ex_rs1 == mem_rd) && mem_reg_write |-> (ex_rs1_value == mem_alu_result)
);
```

**Human must**: Define all pipeline invariants

### Exit Criteria (Phase 2)

- All Phase 1 criteria still met
- Zero false commits (wrong register writes)
- Zero pipeline deadlocks
- Hazard scenarios: 1000+ tests, 0 failures

---

## Phase 3 Verification

**Status**: ✅ COMPLETE (2026-05-21) — I-cache 7/7, D-cache 8/8, integration 5/5, full regression 139/139; ASAP7 PPA sign-off at 1418 MHz / 27.27 mW / 3,844 µm² (Run 43, 2026-05-20)

### New Verification Challenges

- Cache hit/miss behavior
- Cache refill logic
- Write-back correctness
- Memory ordering preservation

### Reference Model Enhancement

**Cache model**:

```python
class CacheModel:
    def read(self, addr):
        if addr in self.cache:
            return self.cache[addr]  # Hit
        else:
            data = self.memory.read(addr)
            self.cache[addr] = data  # Refill
            return data
```

**Human must**: Implement cache model matching RTL behavior

### Test Additions

| Test Category | Description | AI/Human |
| :---: | :---: | :---: |
| Cache hit tests | Repeated access to same address | AI may generate |
| Cache miss tests | Access to uncached addresses | AI may generate |
| Thrashing tests | Access pattern causing evictions | **Human designs** |
| Write-back tests | Verify dirty line write-back | **Human writes** |

### Exit Criteria (Phase 3)

- ✅ All Phase 2 criteria still met (139/139 regression)
- ✅ No cache coherence violations (scoreboard verified)
- ✅ No lost writes (write-back verified; D-cache 8/8)
- ✅ Cache stress cycles with 0 failures (integration 5/5, 139 total tests)

---

## Phase 4 Verification

**Status**: GPU added

### GPU-Specific Verification

**Reference model**: `GPUKernelModel` (see REFERENCE_MODEL_SPEC.md)

### Test Categories

| Test Category | Description | AI/Human |
| :---: | :---: | :---: |
| Vector kernels | Simple SIMT kernels (vec add, scalar mul) | AI may write, **Human reviews** |
| Divergence tests | if/else with different paths | **Human writes** |
| Memory coalescing | Verify coalesced vs serialized access | **Human writes** |
| Grid/block sweep | Various grid/block dimensions | AI may generate, **Human reviews** |

### Scoreboard

```python
class GPUScoreboard(uvm_component):
    def __init__(self, name, parent):
        super().__init__(name, parent)
        self.model = GPUKernelModel(warp_size=8)

    def write_kernel_done(self, txn):
        # Compare RTL memory output with model
        model_result = self.model.execute_kernel()

        for addr in model_result['memory']:
            rtl_val = self.read_rtl_memory(addr)
            model_val = model_result['memory'][addr]
            if rtl_val != model_val:
                self.log.error(f"Memory mismatch at 0x{addr:08x}")
```

**Human must**: Implement GPU scoreboard and divergence verification

### Exit Criteria (Phase 4)

- All directed GPU kernels pass
- Divergence tests pass (mask correctness verified)
- No GPU deadlocks in 100k+ cycle runs
- CPU-GPU integration tests pass

---

## Phase 5 Verification

**Status**: ✅ COMPLETE (2026-06-24, M1–M12); live status in `Doc: cr:status:phase-status`

### System-Level Verification

- Boot sequence
- Peripheral access (UART, SPI, Timer)
- Interrupt handling (requires Phase 2+ CPU with interrupts)
- DMA transfers

### Test Additions

| Test Category | Description | AI/Human |
| :---: | :---: | :---: |
| Boot tests | Verify boot from ROM | **Human writes** |
| Firmware tests | Run simple firmware | **Human provides firmware** |
| Peripheral tests | UART TX/RX, SPI transfer | AI may write, **Human reviews** |
| Stress tests | Long random regressions | AI may generate, **Human reviews** |

### Exit Criteria (Phase 5)

- Boots firmware reliably from ROM loaded with C code (100/100 attempts)
- Sustains 1M+ cycle random tests, 0 failures
- All peripherals functional
- System-level assertions pass

### CDC Verification (GH epic #90, 2-domain multi-clock SoC)

The SoC is single-clock through Phase 5, so it has **no genuine internal CDC**. Epic #90 introduces
exactly one crossing (CPU ↔ crossbar M0) and with it the project's first CDC verification.

**`test_async_axi_fifo` (GH #91, 22/22)** — unit suite for `rtl/soc/async_axi_fifo.sv` and the
`rtl/soc/cdc/` primitives. First testbench in the repo to drive **two independent `Clock()`
coroutines**. Clock-ratio matrix (ns): 4/9 (the real ~2.25 CPU:fabric ratio), 9/4, 4/20, 20/4,
10/10 (the `PLL_IMPL="STUB"` equal-clock case), 10/11 (coprime — edges slide continuously through
each other, the closest simulatable proxy for a violation window).

Load-bearing cases, none of which may be dropped:

| Test | What it catches |
| :--- | :--- |
| exact-depth-full | ±1 error in the gray full-comparison (accepted count must equal `*_depth_o` exactly) |
| pointer wrap + near-empty ping-pong | wrap bug at the pointer MSB; every pointer value visited at depth 0/1 |
| cross-flush (assert ONE reset only) | one-sided reset injecting fabricated AXI beats — the failure the cross-coupled reset exists to prevent |
| no-combinational-crossing (freeze `s_clk`) | any combinational path across the domain boundary |
| white-box gray pointer | multi-bit gray transitions (`popcount(prev^curr) <= 1`) |

**Not simulatable — do not mistake a green run for silicon confidence.** Verilator is 2-state and
zero-delay, so metastability, a missing synchronizer stage, or a raw binary pointer crossing would
all pass. The real mitigations are structural: `(* magic_cdc *)` on the primitives feeding GH #95's
`cdc_snitch` BAD=0 gate, and — since bead claude_verilog_test-k07 (2026-08-02) —
`pnr/constraints/phase5_soc_multiclock.sdc`'s `set_clock_groups -asynchronous` (for real
synthesis/P&R) PLUS a separate `pnr/constraints/phase5_soc_multiclock_check.sdc` carrying
`set_max_delay` (no `-datapath_only` — OpenSTA does not implement that flag; tool-verified, see
that file's header) on the `mem_q` read and the two pointer crossings, read post-route for targeted
CDC budget verification only. The original single-file design (one SDC with both
`set_clock_groups -asynchronous` and `set_max_delay -datapath_only`) was tool-verified to never
apply those budgets at all — OpenSTA aborts `read_sdc` on the unrecognised `-datapath_only` flag,
and even with that flag removed, `set_clock_groups -asynchronous` (or an equivalent
`set_false_path` between the two clocks) suppresses the `set_max_delay` exception outright,
regardless of its `-through` specificity — hence the OpenTitan-precedent split. The PR review
checklist in the module headers is unaffected by this correction.

**Coverage gap to close in #92:** with `PLL_IMPL="STUB"`, `core_clk == clk_i`, so after #93 the
`soc_all` integration suites exercise the bridge at ratio 1:1 and contribute **zero** CDC coverage.
Until the two stub PLLs get different ratios, `test_async_axi_fifo` is the only CDC coverage there is.

---

## Regression Testing

### Continuous Integration

**On every commit**:

- Run smoke tests (< 1 minute)
- Run ISA tests (< 5 minutes)
- Check for new lint warnings

**Nightly**:

- Run full random regression (10k+ instructions)
- Run cache stress tests
- Generate coverage reports

**Weekly**:

- Run extended random tests (100k+ instructions)
- Cross-validate reference model vs spike

### Seed Management

- Log random seeds for reproducibility
- Archive failing seeds
- Regression suite includes all previously failing seeds

---

## Tools and Infrastructure

### cocotb Setup

```bash
# Install cocotb
pip install cocotb cocotb-bus pytest

# Run simulation
make -C sim sim
make -C sim test TEST=test_simple_add
```

### Waveform Viewing

```bash
# Generate waveforms
make -C sim waves

# View with GTKWave
gtkwave sim/dump.vcd
```

### Coverage Collection

```bash
# Run with coverage
make -C sim coverage

# View coverage report
firefox sim/coverage/index.html
```

---

## Summary: AI vs Human Responsibilities

### AI Responsibilities (Across All Phases)

AI MAY assist with:

- ✅ cocotb driver boilerplate
- ✅ Simple directed test generation
- ✅ Random instruction generator frameworks
- ✅ pyuvm agent/monitor scaffolding
- ✅ Coverage bin generation
- ✅ Waveform analysis suggestions
- ✅ Log parsing and pattern detection

### Human Responsibilities (Across All Phases)

Human MUST:

- ❗ Design verification architecture
- ❗ Implement reference models
- ❗ Define "correctness" (scoreboard logic)
- ❗ Write complex tests (debug, hazards, divergence, caches)
- ❗ Analyze failures and debug
- ❗ Define coverage goals
- ❗ Decide when verification is complete
- ❗ Review all AI-generated code
- ❗ Define critical assertions
- ❗ Cross-validate reference models

---

## pyuvm Migration Status

**Status**: ✅ COMPLETE (Phase G - 2026-01-31)

### Migration Summary

The RV32I CPU verification infrastructure has been successfully migrated from raw cocotb to pyuvm (Python UVM) following a systematic 7-phase approach (Phases A through G).

**Completion Date**: 2026-01-31
**Duration**: 2 days (2026-01-30 to 2026-01-31)
**Total Code**: ~1,800 lines of pyuvm infrastructure + 18 component files

### What Was Migrated

| Component | Status | Location |
|---|---|---|
| **AXI Memory Driver** | ✅ Complete | `tb/cpu_uvm/agents/axi_agent/axi_driver.py` |
| **APB Debug Driver** | ✅ Complete | `tb/cpu_uvm/agents/apb_agent/apb_driver.py` |
| **Commit Monitor** | ✅ Complete | `tb/cpu_uvm/monitors/commit_monitor.py` |
| **CPU Scoreboard** | ✅ Complete | `tb/cpu_uvm/scoreboards/cpu_scoreboard.py` |
| **AXI Agent** | ✅ Complete | `tb/cpu_uvm/agents/axi_agent/axi_agent.py` |
| **APB Agent** | ✅ Complete | `tb/cpu_uvm/agents/apb_agent/apb_agent.py` |
| **CPU Environment** | ✅ Complete | `tb/cpu_uvm/env/cpu_env.py` |
| **Base Sequence** | ✅ Complete | `tb/cpu_uvm/sequences/base_sequence.py` |
| **Directed Sequences** | ✅ Complete | `tb/cpu_uvm/sequences/directed_sequences.py` |
| **Random Sequence** | ✅ Complete | `tb/cpu_uvm/sequences/random_instr_sequence.py` |
| **Base Test** | ✅ Complete | `tb/cpu_uvm/tests/base_test.py` |
| **Smoke Tests** | ✅ Complete | `tb/cpu_uvm/tests/test_smoke_uvm.py` (4/4 PASSING) |
| **Random Tests** | ✅ Complete | `tb/cpu_uvm/tests/test_random_uvm.py` (2/2 PASSING) |

### Test Results

**Smoke Tests** (4 tests):
```
make smoke_uvm
** TESTS=4 PASS=4 FAIL=0 SKIP=0 **
  - test_addi_uvm: PASS
  - test_branch_taken_uvm: PASS
  - test_branch_not_taken_uvm: PASS
  - test_jal_uvm: PASS
```

**Random Tests** (2 tests):
```
make random_uvm
** TESTS=2 PASS=2 FAIL=0 SKIP=0 **
  - test_random_single_uvm: PASS (100 instructions, seed=42)
  - test_random_multi_seed_uvm: PASS (10 seeds × 100 instructions)
```

### Legacy Tests Archived

Original cocotb tests (2,749 lines) have been archived to `tb/cocotb/cpu/legacy/`:
- `test_smoke.py` → Replaced by `test_smoke_uvm.py`
- `test_random_instructions.py` → Replaced by `test_random_uvm.py`
- `test_isa_compliance.py` → Migration planned for future phase

All duplicate helper classes (`APBDebugInterface`, `SimpleAXIMemory`) have been removed from active tests.

### Key Improvements

1. **No Duplication**: Single APBDebugDriver replaces 3+ duplicated implementations
2. **UVM Structure**: Proper test → environment → agent → driver hierarchy
3. **Reusable Components**: All agents/drivers shared across tests
4. **Reference Model Integration**: Automatic validation via CPUScoreboard
5. **Maintainability**: Clean separation of concerns, no raw signal manipulation

### Documentation

Complete migration documentation available at:
- **Migration Plan**: `docs/pyuvm_migration/MIGRATION_PLAN.md`
- **Migration Status**: `Doc: cr:status:pyuvm-migration`
- **Lessons Learned**: `docs/pyuvm_migration/LESSONS_LEARNED.md`
- **pyuvm Infrastructure Guide**: `tb/cpu_uvm/README.md`
- **Test Guide**: `tb/cocotb/cpu/README.md`

### Next Steps

1. Migrate ISA compliance tests (37 RV32I instructions) - Planned
2. Add coverage collection - Planned
3. Expand random test seed count (10 → 100) - Optional

---

## References

- PHASE0_ARCHITECTURE_SPEC.md: CPU architectural requirements
- PHASE1_ARCHITECTURE_SPEC.md: CPU implementation details
- PHASE4_GPU_ARCHITECTURE_SPEC.md: GPU architecture
- REFERENCE_MODEL_SPEC.md: Python reference model API
- MEMORY_MAP.md: Address space and register definitions
- Doc: cr:status:roadmap: Project phase plan
