chuanseng-ng/claude_verilog_test/pnr/commercial/impl/icc2/reports/repair_lvs_1.txt

Information: Using 2 threads for LVS
[Check Short] Stage 1	[Check Net] Init	Elapsed =    0:00:00, CPU =    0:00:00
Elapsed =    0:00:00, CPU =    0:00:00
[Check Short] Stage 1-2	Elapsed =    0:00:00, CPU =    0:00:01
Warning: Port VPWR have no valid pin shapes. Skip this port. (RT-203)
[Check Short] Stage 2	Elapsed =    0:00:00, CPU =    0:00:01
[Check Short] Stage 2-2	Elapsed =    0:00:05, CPU =    0:00:10
[Check Short] Stage 3	Elapsed =    0:00:05, CPU =    0:00:10
[Check Short] End	Elapsed =    0:00:05, CPU =    0:00:10
Warning: Port VGND have no valid pin shapes. Skip this port. (RT-203)
[Check Net] 10% 	Elapsed =    0:00:06, CPU =    0:00:12
[Check Net] 20% 	Elapsed =    0:00:06, CPU =    0:00:12
[Check Net] 30% 	Elapsed =    0:00:06, CPU =    0:00:12
[Check Net] 40% 	Elapsed =    0:00:06, CPU =    0:00:12
[Check Net] 50% 	Elapsed =    0:00:07, CPU =    0:00:13
[Check Net] 60% 	Elapsed =    0:00:07, CPU =    0:00:13
[Check Net] 70% 	Elapsed =    0:00:07, CPU =    0:00:13
[Check Net] 80% 	Elapsed =    0:00:07, CPU =    0:00:13
[Check Net] 90% 	Elapsed =    0:00:07, CPU =    0:00:13
[Check Net] All nets are submitted.
[Check Net] 100%	Elapsed =    0:00:07, CPU =    0:00:13
Information: Detected short violation. Net1: u_core/u_dcache/n1529. Net2: u_core/u_dcache/n1536. BBox: (2038.475 504.150)(2038.615 504.290). Layer: met1. (RT-586)
Information: Detected short violation. Net1: HFSNET_1082. Net2: u_core/u_dcache/n1533. BBox: (2038.650 500.070)(2038.790 500.210). Layer: met2. (RT-586)

===============================================================
    Maximum number of violations is set to 100000
    Abort checking when more than 100000 violations are found
    All violations might not be found.
===============================================================
Total number of input nets is 35143.
Total number of short violations is 2.
Total number of open nets is 0.
Total number of floating route violations is 0.

Elapsed =    0:00:08, CPU =    0:00:14
1
