chuanseng-ng/claude_verilog_test/docs/manual/cr/parts/05-source-file-history.tex

\part{Source-file history}\label{cr:part:source-file-history}

\chapter{RTL}\label{cr:ch:rtl}

This chapter holds the history text of the RTL files.

% --- generated by PR7a: begin
\section{\texttt{soc/apb4\_register\_bank.sv}}\label{cr:mod:apb4-register-bank}

This section holds history text that was in a comment of the source file. The text is unchanged. Each line has no leading comment marker and no indentation.

\begin{record}

\subsection*{Before: if (access \&\& pwrite) begin}

\begin{textblock}
   GH #87: zero-extend addr_word to 32 b before comparing with N_REGS
   so that N_REGS == 2**WORDW does not wrap to 0 (truncating cast bug).
\end{textblock}

\subsection*{Before: automatic logic [31:0]     base =}

\begin{textblock}
SW owns the WMASK bits; HW owns the rest.  Folding this
cycle's HW write into the base keeps a same-edge HW update
from being clobbered with stale data (bead 6o8w).
\end{textblock}

\end{record}

\section{\texttt{soc/apb\_cdc\_bridge.sv}}\label{cr:mod:apb-cdc-bridge}

This section holds history text that was in a comment of the source file. The text is unchanged. Each line has no leading comment marker and no indentation.

\begin{record}

\subsection*{Header}

\begin{textblock}
Converted from a 2-phase (NRZ) toggle handshake to 4-phase (RZ,
return-to-zero) by bead claude_verilog_test-rfz (2026-08-12) — see
"Why 4-phase, not a documented contract" below before "simplifying" this
back to a toggle scheme. All other design decisions in this file (the
asymmetric reset strategy, the m_rst_n_s availability exception, the
bounded S_WAIT/S_REQ escape paths) predate the encoding change and are
UNCHANGED by it except where the prose below explicitly says so.
\end{textblock}

\subsection*{Header}

\begin{textblock}
── Reset strategy (post-#93 availability fix, see PR #132 review) ─────────
The ORIGINAL strategy here was a straight copy of async_axi_fifo.sv's
hard-flush, common-root argument: rst_both_n = s_rst_n_i & m_rst_n_i fed
BOTH cdc_reset_sync instances, so a reset on either side cleared both
toggle/state machines together. That argument is FALSE for this module's
source-domain FSM and was the root cause of a confirmed availability bug:
while m_rst_n_i alone is asserted (the CPU-domain PLL2 reference resets
independently of the fabric, exactly the scenario #92/#93 exist to
support), rst_both_n held s_rst_sync_n low too, which held s_state_q in
S_IDLE — s_pready_o could never assert, EVER, for as long as m_rst_n_i
stayed low, wedging the upstream axil_to_apb master (and therefore the
entire fabric APB tree: UART/SPI/timer/IRQ/PMU/both PLL blocks) until a
full SoC reset. Because the source FSM was itself held in reset, it could
not even emit an error response — a new state transition alone cannot fix
this; the reset structure itself has to change.
\end{textblock}

\end{record}

\section{\texttt{soc/axi\_lite\_interconnect.sv}}\label{cr:mod:axi-lite-interconnect}

This section holds history text that was in a comment of the source file. The text is unchanged. Each line has no leading comment marker and no indentation.

\begin{record}

\subsection*{Before: r\_dvalid\_d = !r\_dvalid\_q;}

\begin{textblock}
bead 3xtv: the DECERR response is one-shot.  rstate only
leaves R_DATA on r_hs, one cycle AFTER r_dvalid_q captured
the beat, so an unconditional 1 here reloaded r_dvalid_q in
the handshake cycle (r_dreg_ready=1) and emitted a phantom
second DECERR beat.  Offer the beat only while the output
register is empty; depends on the registered r_dvalid_q
only (no READY->VALID loop, no mapped-slave path change).
\end{textblock}

\end{record}

\section{\texttt{soc/axi\_lite\_register\_bank.sv}}\label{cr:mod:axi-lite-register-bank}

This section holds history text that was in a comment of the source file. The text is unchanged. Each line has no leading comment marker and no indentation.

\begin{record}

\subsection*{Before: if (\{\{(32-WORDW)\{1'b0\}\}, commit\_word\} < N\_REGS) begin}

\begin{textblock}
GH #87 / bead r5hu: zero-extend commit_word to 32 b before
comparing with N_REGS so N_REGS == 2**WORDW cannot wrap to 0
(the old truncating WORDW'(N_REGS) cast made the bank inert).
\end{textblock}

\subsection*{Before: automatic logic [31:0]     base =}

\begin{textblock}
SW owns the WMASK bits; HW owns the rest.  Folding this
cycle's HW write into the base keeps a same-edge HW update
from being clobbered with stale data (bead 6o8w).
\end{textblock}

\subsection*{Before: rdata\_q  <= (\{\{(32-WORDW)\{1'b0\}\}, araddr\_word\} < N\_REGS)}

\begin{textblock}
GH #87 / bead r5hu: zero-extend araddr_word to 32 b before
comparing with N_REGS so N_REGS == 2**WORDW cannot wrap to 0.
\end{textblock}

\end{record}

\section{\texttt{soc/axil\_to\_apb.sv}}\label{cr:mod:axil-to-apb}

This section holds history text that was in a comment of the source file. The text is unchanged. Each line has no leading comment marker and no indentation.

\begin{record}

\subsection*{Before: assign s\_axil\_arready = (state\_q == S\_IDLE) \&\& !aw\_cap\_q...}

\begin{textblock}
Accept AR only in IDLE and only when no write is being assembled.
GH #85: also gate on !s_axil_awvalid && !s_axil_wvalid so that a
concurrent AR + AW + W presented in S_IDLE cannot handshake AR in the same
always_ff evaluation as the AW+W capture, which would overwrite addr_q with
the read address and clear is_write_q=0 before the write APB transfer starts.
\end{textblock}

\end{record}

\section{\texttt{soc/boot\_rom.sv}}\label{cr:mod:boot-rom}

This section holds history text that was in a comment of the source file. The text is unchanged. Each line has no leading comment marker and no indentation.

\begin{record}

\subsection*{Before: `ifndef \_\_pnr\_\_}

\begin{textblock}
Optional hex image.  Empty string → ROM contains 0 after reset.
Both branches are parameter string (soc_top always drives a parameter
string down regardless of __pnr__; an int unsigned type on the PnR
side was an implicit string->int conversion under strict SV
elaboration, bead q7n). The __pnr__ branch stays split from the sim
branch because PnR never reads MEM_INIT_FILE (see the initial block
below) — ROM is always zero-init in synthesis, no file load in
silicon anyway.
\end{textblock}

\end{record}

\section{\texttt{soc/cdc/cdc\_reset\_sync.sv}}\label{cr:mod:cdc-reset-sync}

This section holds history text that was in a comment of the source file. The text is unchanged. Each line has no leading comment marker and no indentation.

\begin{record}

\subsection*{Header}

\begin{textblock}
Used 2x by the GH #91 async_axi_fifo (one per clock domain, driven from a
shared `s_rst_n_i & m_rst_n_i` root — see async_axi_fifo.sv header for the
rationale) and reusable by any future multi-clock-domain reset tree (#93
reuses this for per-domain PMU resets).
\end{textblock}

\end{record}

\section{\texttt{soc/cdc/cdc\_sync.sv}}\label{cr:mod:cdc-sync}

This section holds history text that was in a comment of the source file. The text is unchanged. Each line has no leading comment marker and no indentation.

\begin{record}

\subsection*{Header}

\begin{textblock}
── On simulating CDC delay (bead claude_verilog_test-rvs) ────────────────
This module now carries an optional simulation-time randomised settling-
delay injector on stage 0 of the flop array (RAND_CDC_DELAY_EN, default
OFF at every instantiation site). This is the SECOND attempt: the first
(commit 4197139) landed as disabled scaffolding and was reverted (commit
be485fd) because its model was wrong — it could latch a hold permanently
and stick the synchroniser instead of delaying it by a cycle. See "Why
this converges" below for the precise difference.

The finding that motivated this stands regardless of either attempt's
fate, and is worth recording here because this repo has repeatedly
written the opposite: the claim that "metastability injection is not
modelable in Verilator/cocotb" (design_state.json, CLAUDE.md, several test
docstrings) is imprecise. What IS modelable, and what OpenTitan actually
does, is a randomised EXTRA-CYCLE-OF-SETTLING-DELAY on a synchroniser's
first stage — plain RTL, no timing control, so it works in a 2-state
cycle-based simulator. That is precisely the fault model that reproduces a
same-edge-assumption bug, which is the class this repo hit twice in GH #93
(fr_57f49b7f9b29 and fr_280f3ac18c66) and which every 1:1-ratio,
lockstep-reset unit test was structurally blind to.

What remains genuinely NOT modelable here is analog metastability itself —
an intermediate, non-0/1, potentially oscillating voltage on Q. 4-state X
injection at the setup/hold boundary is a different and heavier technique
this module does not attempt.
\end{textblock}

\end{record}

\section{\texttt{soc/dft/dft\_clk\_mux.sv}}\label{cr:mod:dft-clk-mux}

This section holds history text that was in a comment of the source file. The text is unchanged. Each line has no leading comment marker and no indentation.

\begin{record}

\subsection*{Header}

\begin{textblock}
Synthesis had mapped the mux to an a21bo_2 (0.18 pF at ss) that then carried ~0.30 pF of root wire and failed
CVT.MaxCapViolations on core_clk at 4 tt/ss corners; repair_design skips clock nets, so the driver must be
strong from synthesis on (buf_16: 5.0 pF Liberty limit at ss; clkbuf_16 was 1.017 pF).
\end{textblock}

\end{record}

\section{\texttt{soc/pll/pll\_apb\_regs.sv}}\label{cr:mod:pll-apb-regs}

This section holds history text that was in a comment of the source file. The text is unchanged. Each line has no leading comment marker and no indentation.

\begin{record}

\subsection*{Before: localparam logic [31:0] WMASK[N\_REGS] = '\{}

\begin{textblock}
Per-register SW-writable bit masks
CONTROL: bits [9:8] post_div_sel, [7:4] div_n writable.
bit[0] pll_enable is NOT in WMASK — non-clearable by design (GH #89 anti-brick):
apb4_register_bank leaves bit[0] at its reset value (1) on every write, so
firmware can never hold the PLL in reset and deadlock the SoC.
\end{textblock}

\subsection*{Before: 32'h0000\_0000,  // STATUS:  cleared}

\begin{textblock}
  bit[0] excluded from WMASK (GH #89): firmware
  cannot clear pll_enable — self-brick path unreachable.
\end{textblock}

\end{record}

\section{\texttt{soc/pll/pll\_rnm.sv}}\label{cr:mod:pll-rnm}

This section holds history text that was in a comment of the source file. The text is unchanged. Each line has no leading comment marker and no indentation.

\begin{record}

\subsection*{Before: always\_ff @(posedge ref\_clk\_i or negedge rst\_n\_i) begin}

\begin{textblock}
alpha=0.5 → locks in ~10 ref cycles (~100 ns), far within 20 µs spec
\end{textblock}

\end{record}

\section{\texttt{soc/pll/pll\_subsystem.sv}}\label{cr:mod:pll-subsystem}

This section holds history text that was in a comment of the source file. The text is unchanged. Each line has no leading comment marker and no indentation.

\begin{record}

\subsection*{Before: input  logic              psel,}

\begin{textblock}
u_apb_pll2_cdc for u_cpu_pll_sub) and drives this port from its m_*
face — GH #86. No longer deferred; see the file header.
\end{textblock}

\end{record}

\section{\texttt{soc/soc\_addr\_map\_pkg.sv}}\label{cr:mod:soc-addr-map-pkg}

This section holds history text that was in a comment of the source file. The text is unchanged. Each line has no leading comment marker and no indentation.

\begin{record}

\subsection*{Before: verilator lint\_on  UNUSEDPARAM */}

\begin{textblock}
Pre-Phase-6 #5 / GH #100: extended again to cover PMU slot (0x2000_8000-8FFF);
GH #92: extended again to cover PLL2 slot (0x2000_9000-9FFF)
Phase 6a / bead claude_verilog_test-ckc: extended again to cover GPIO slot (0x2000_A000-AFFF)
Phase 6 / bead claude_verilog_test-f7vs.2: extended to the final value, pre-allocating
the reserved-but-unbuilt PWM/WDT/TRNG/I2C/CRYPTO/NPU slots (0x2000_B000-0x2001_0FFF)
\end{textblock}

\end{record}

\section{\texttt{soc/soc\_periph\_map\_pkg.sv}}\label{cr:mod:soc-periph-map-pkg}

This section holds history text that was in a comment of the source file. The text is unchanged. Each line has no leading comment marker and no indentation.

\begin{record}

\subsection*{Header}

\begin{textblock}
Phase 6 (bead claude_verilog_test-f7vs.2): the full 14-slave APB sub-tree is
pre-allocated in this one commit, per Doc: ds:ch:phase6-ip-expansion-plan:4-address-map-pre-allocated-in-full.
Slot 13 (NPU) is a BASE/LIMIT constant only —
reserved-but-unbuilt, not yet in APB_N_SLAVES or the APB_SLV_BASE/LIMIT
arrays. Slots 8-12 (PWM, WDT, TRNG, I2C, CRYPTO) are live. Each reserved slot is promoted to a
real slave (index constant + array entry + module instance) one at a time as
its peripheral lands (6a-4 .. 6c).
\end{textblock}

\subsection*{Before: localparam logic [31:0] AXIL\_APB\_BASE    = 32'h2000\_2000...}

\begin{textblock}
Pre-Phase-6 #5 / GH #100: extended 0x2000_7FFF -> 0x2000_8FFF for PMU.
GH #92: extended 0x2000_8FFF -> 0x2000_9FFF for the second (CPU-domain) PLL.
Phase 6a / bead claude_verilog_test-ckc: extended 0x2000_9FFF -> 0x2000_AFFF for GPIO.
Phase 6 / bead claude_verilog_test-f7vs.2: extended 0x2000_AFFF -> 0x2001_0FFF, the
final value — pre-allocates the full 14-slot APB window (PWM/WDT/TRNG/I2C/CRYPTO/NPU)
in one commit per Doc: ds:ch:phase6-ip-expansion-plan:4-address-map-pre-allocated-in-full.
\end{textblock}

\subsection*{Before: localparam logic [31:0] APB\_PMU\_BASE    = 32'h2000\_8000;}

\begin{textblock}
PMU — Pre-Phase-6 #5 / GH #100 (behavioral power-mode sequencer, GH #99).
\end{textblock}

\subsection*{Before: localparam logic [31:0] APB\_PLL2\_BASE   = 32'h2000\_9000;}

\begin{textblock}
PLL2 — GH #92 (second pll_subsystem instance, CPU-domain reference clock).
\end{textblock}

\subsection*{Before: localparam logic [31:0] APB\_GPIO\_BASE   = 32'h2000\_A000;}

\begin{textblock}
GPIO — Phase 6a (bead claude_verilog_test-ckc).
\end{textblock}

\subsection*{Before: localparam logic [31:0] APB\_PWM\_BASE    = 32'h2000\_B000;}

\begin{textblock}
PWM — Phase 6a-2 (bead claude_verilog_test-f7vs.6).
\end{textblock}

\subsection*{Before: localparam logic [31:0] APB\_WDT\_BASE    = 32'h2000\_C000;}

\begin{textblock}
WDT — Phase 6a-3 (bead claude_verilog_test-f7vs.7).
\end{textblock}

\subsection*{Before: localparam logic [31:0] APB\_TRNG\_BASE   = 32'h2000\_D000;}

\begin{textblock}
TRNG — Phase 6a-4 (bead claude_verilog_test-f7vs.8).
\end{textblock}

\subsection*{Before: localparam logic [31:0] APB\_I2C\_BASE    = 32'h2000\_E000;}

\begin{textblock}
I2C — Phase 6a-5 (bead claude_verilog_test-f7vs.9).
\end{textblock}

\subsection*{Before: localparam logic [31:0] APB\_CRYPTO\_BASE = 32'h2000\_F000;}

\begin{textblock}
CRYPTO — Phase 6b (bead claude_verilog_test-f7vs.10).
\end{textblock}

\subsection*{Before: localparam logic [31:0] APB\_NPU\_BASE    = 32'h2001\_0000;}

\begin{textblock}
NPU — Phase 6c (bead claude_verilog_test-f7vs.11).
\end{textblock}

\end{record}

\section{\texttt{soc/soc\_top.sv}}\label{cr:mod:soc-top}

This section holds history text that was in a comment of the source file. The text is unchanged. Each line has no leading comment marker and no indentation.

\begin{record}

\subsection*{Header}

\begin{textblock}
    bit 6 (PWM) is now live (Phase 6a-2, bead claude_verilog_test-f7vs.6).
    bit 7 (WDT) is now live (Phase 6a-3, bead claude_verilog_test-f7vs.7).
    bit 8 (TRNG) is now live (Phase 6a-4, bead claude_verilog_test-f7vs.8).
    bit 9 (I2C) is now live (Phase 6a-5, bead claude_verilog_test-f7vs.9).
    bit 10 (CRYPTO) is now live (Phase 6b, bead claude_verilog_test-f7vs.10).
    bit 11 (NPU) is now live (Phase 6c, bead claude_verilog_test-f7vs.11).
\end{textblock}

\subsection*{Before: output logic [3:0]  pwm\_o,}

\begin{textblock}
── PWM (Phase 6a-2, bead f7vs.6 — tied off until the peripheral lands) ──
\end{textblock}

\subsection*{Before: output logic        wdt\_rst\_req\_o,}

\begin{textblock}
── Watchdog (Phase 6a-3, bead f7vs.7) — level-held bite request ──
\end{textblock}

\subsection*{Before: Open-drain triplet, same convention as GPIO: there is no...}

\begin{textblock}
── I2C (Phase 6a-5, bead f7vs.9 — driven by u_i2c) ──
\end{textblock}

\subsection*{Before: output logic        pll\_locked\_o,       // 1 when system...}

\begin{textblock}
── PLL status (Phase 7 M-c; GH #92 adds the CPU-domain PLL) ──────────────
\end{textblock}

\subsection*{Before: Direct (parallel) scan access; the JTAG TAP of Stage 1b ...}

\begin{textblock}
── DFT test access (bead claude_verilog_test-j41m.2, GH #244) ───────────
\end{textblock}

\subsection*{Before: Raw pins, no pad ring; TDO is never tri-stated here (no ...}

\begin{textblock}
── JTAG TAP (bead claude_verilog_test-j41m.3, DFT Stage 1b) ─────────────
\end{textblock}

\subsection*{Before: localparam int unsigned SYNC\_STAGES\_FROM\_CPU = 2;}

\begin{textblock}
Depth of the one cpu_core_clk -> core_clk crossing (u_cpu_iso_ack_sync, bead 3ogd).
\end{textblock}

\subsection*{Before: CPU/GPU domain sequencing outputs from pmu (core\_clk dom...}

\begin{textblock}
Pre-Phase-6 #5 (GH #98/#99/#100) — PMU sequencing nets
\end{textblock}

\subsection*{Before: logic pmu\_cpu\_clk\_dis\_sync;}

\begin{textblock}
---- BUG (fixed here) + reset-release ordering, with cycle counts -----
The original (non-inverted) u_cpu_clk_en_sync synchronised pmu_cpu_clk_en
directly and was reset by cpu_core_rst_n. cdc_sync resets its flop
chain to 0 (see cdc_sync.sv), so that synchroniser's output was 0
(clock DISABLED) for the entire time cpu_core_rst_n was low, and for
STAGES=2 more cpu_core_clk edges after cpu_core_rst_n released (pipeline
fill latency) before it could reach 1. Meanwhile pmu_cpu_rst_n defaults
to 1 at the PMU's own reset (DOM_ON, see pmu.sv reset-defaults comment),
so u_cpu_pmu_rst_sync's chain filled to 1 within STAGES=2 cpu_core_clk
edges of cpu_core_clk simply toggling — independent of, and much faster
than, cpu_core_rst_n's release. Net effect: cpu_domain_rst_n
(= cpu_core_rst_n & pmu_cpu_rst_n_cpu_sync) tracked cpu_core_rst_n almost
exactly, releasing on the SAME edge cpu_core_rst_n released — the exact
edge at which cpu_gated_clk was still 2 cycles away from resuming. Zero
cpu_gated_clk edges ever occurred while cpu_domain_rst_n was low, so
u_cpu's `if (!rst_n_i) ... else ...` synchronous reset never executed
its reset branch.
\end{textblock}

\subsection*{Before: logic pmu\_cpu\_clk\_dis\_sync;}

\begin{textblock}
Cold-boot regression check (GH #93's own fix, re-verified here): during
cpu_core_rst_n=0 (PLL not locked), the PMU's own dom_state_q is held at
its synchronous reset default DOM_ON (pmu.sv's rst_n_i is core_rst_n),
so pmu_cpu_rst_n=1 constant throughout — pmu_cpu_rst_n_cpu_sync tracks
to 1 well within cold boot's multi-cycle PLL-lock window and stays
there. cpu_gated_clk_en is therefore unaffected by this fix during cold
boot (gated only by ~pmu_cpu_clk_dis_sync, exactly as GH #93 left it) —
this fix only changes behavior once the PMU's OWN FSM genuinely drives
pmu_cpu_rst_n low, which happens only on a live, firmware-initiated
power-cycle.

Test-suite note: test_pmu.py's DUT (tb_pmu.sv) instantiates pmu.sv
standalone with no CDC and no soc_top glue, so its per-cycle ordering
assertions exercise pmu.sv's own (unchanged) FSM outputs only and are
unaffected by this fix. soc_multiclock / soc_pll_multiclock exercise
soc_top's synchronisers at a divergent clock ratio but do not drive a
live PMU power-cycle, so they do not currently cover this path either
(see "Residual risk" callout in CLAUDE.md's GH #90 status entry).
\end{textblock}

\subsection*{Before: logic pmu\_cpu\_iso\_ack;}

\begin{textblock}
---- Isolation-ack handshake (bead 3ogd) -----------------------------------------------
PROBLEM. pmu_cpu_iso_en reaches the clamp above through a 2-flop cdc_sync clocked by
cpu_core_clk, but pmu_cpu_rst_n reaches u_cpu_pmu_rst_sync's ASYNCHRONOUS clear directly
(async assert), so the reset takes effect on the very core_clk edge the PMU drops it. The
PMU spaced the two by 2 core_clk cycles; "isolate first" therefore held only while
2 x cpu_core_clk period < 2 x core_clk period, and failed for a CPU clock slower than the
fabric clock (the clamp became active 6 core cycles after a reset that asserted at 2, at 3x).
\end{textblock}

\subsection*{Before: logic wdt\_rst\_en\_w;      // driven by u\_wdt.rst\_en\_o (re...}

\begin{textblock}
Phase 6a-3 (bead claude_verilog_test-f7vs.7): WDT bite -> CPU-domain reset.
\end{textblock}

\subsection*{Before: logic wdt\_rst\_en\_w;      // driven by u\_wdt.rst\_en\_o (re...}

\begin{textblock}
---- RST_EN comes from a real port ---------------------------------------
watchdog_timer exports WDT_CTRL[1] as rst_en_o, and this block consumes
that port directly. An earlier revision reconstructed the bit here by
snooping the WDT's own APB face, which was correct but was duplicated
state with no structural link to the register it mirrored: the two could
only stay in step for as long as someone kept the snoop aligned with
apb4_register_bank's write rule by hand, nothing tested the equivalence,
and a silent divergence would mis-arm a CPU-domain reset. Bead 6o8w's
proposed change to that shared write rule would have altered it for all
ten APB peripherals at once. Replaced with the port (bead f7vs.14).
\end{textblock}

\subsection*{Before: logic pwm\_irq;}

\begin{textblock}
Phase 6 (bead claude_verilog_test-f7vs.2): interrupt-source pre-allocation for
bits 6-11 (PWM/WDT/TRNG/I2C/CRYPTO/NPU). Each was tied 1'b0 here until its
peripheral instance existed, and the tie is replaced with the real IRQ output
when that peripheral lands, matching the existing TIMER-tied-0 idiom below.
pwm_irq (bit 6) landed in Phase 6a-2 (bead claude_verilog_test-f7vs.6) — it is
now driven by u_pwm below, not tied here.
\end{textblock}

\subsection*{Before: logic ext\_irq;    // interrupt\_controller output → CPU e...}

\begin{textblock}
wdt_irq (bit 7) landed in Phase 6a-3 (bead claude_verilog_test-f7vs.7) — it is
now driven by u_wdt below, not tied here.
trng_irq (bit 8) landed in Phase 6a-4 (bead claude_verilog_test-f7vs.8) — it is
now driven by u_trng below, not tied here.
i2c_irq (bit 9) landed in Phase 6a-5 (bead claude_verilog_test-f7vs.9) — it is
now driven by u_i2c below, not tied here.
crypto_irq (bit 10) landed in Phase 6b (bead claude_verilog_test-f7vs.10) — it is
now driven by u_crypto below, not tied here.
npu_irq (bit 11) landed in Phase 6c (bead claude_verilog_test-f7vs.11) — it is
now driven by u_npu below, not tied here.
\end{textblock}

\subsection*{Before: logic ext\_irq;    // interrupt\_controller output → CPU e...}

\begin{textblock}
Phase 6 (bead claude_verilog_test-f7vs.3): top-level port pre-allocation for
PWM/WDT/I2C (the three Phase 6 items that add pins at all — TRNG's entropy
source is an `ifdef`-swapped sub-module, CRYPTO/NPU are register-only). Each
output was tied to its inert value here; the tie is replaced with the real
peripheral connection when that peripheral lands, matching the IRQ-tie idiom
above.
pwm_o landed in Phase 6a-2 (bead claude_verilog_test-f7vs.6) — it is now
driven by u_pwm below, not tied here.
wdt_rst_req_o landed in Phase 6a-3 (bead claude_verilog_test-f7vs.7) — it is
now driven by u_wdt below, not tied here.
i2c_* pins landed in Phase 6a-5 (bead claude_verilog_test-f7vs.9) — they are now
driven by / feed u_i2c below, not tied here.
\end{textblock}

\subsection*{Before: logic cpu\_domain\_rst\_n, gpu\_domain\_rst\_n;}

\begin{textblock}
GH #93-fix note: cpu_domain_rst_n release timing (cold boot) and the
requirement that u_cpu see clock edges throughout its assertion are
analysed in full above u_cpu_clk_dis_sync — that is where the reset-
release ordering and cycle counts for this signal are documented, not
here, to keep the analysis next to the fix it justifies.
\end{textblock}

\subsection*{Before: logic        dbg\_bridge\_m\_psel, dbg\_bridge\_m\_penable, db...}

\begin{textblock}
GH #95 fix (bead claude_verilog_test-eg2): APB3 debug-port CDC bridge.

The top-level apb_* debug ports fed u_cpu DIRECTLY until this fix. GH
#93 moved u_cpu onto cpu_gated_clk, so this chip-boundary bus silently
migrated from the fabric (core_clk) domain into the CPU domain with no
synchroniser — a cdc_snitch BAD=233 finding (all one root cause:
apb_paddr_i/apb_pwdata_i/psel/penable/pwrite captured unsynchronised by
u_cpu.dbg_pc_wr_data/dbg_ctrl_reg/dbg_reg_wr_en/halt_latch_q).
\end{textblock}

\subsection*{Before: u\_cpu's AXI4 master now terminates here (not at xbar\_m\_*...}

\begin{textblock}
GH #93: CPU-domain face of the CPU<->crossbar-M0 AXI4 CDC bridge.
\end{textblock}

\subsection*{Before: (see u\_apb\_dbg\_cdc above). Not isolation-clamped — stall...}

\begin{textblock}
APB3 debug slave — GH #95 fix: now fed from u_apb_dbg_cdc's m_*
(CPU-domain) face instead of the top-level apb_* ports directly
\end{textblock}

\subsection*{Before: .ext\_irq\_i                  (ext\_irq\_cpu\_sync),}

\begin{textblock}
Interrupt inputs — GH #93: synchronised into the CPU domain (see
PMU sequencing nets above; both sources are level-held, not pulses)
\end{textblock}

\subsection*{Before: assign cpu\_bridge\_s\_awvalid = pmu\_cpu\_iso\_en\_sync ? 1'b0...}

\begin{textblock}
GH #93: now applied at u_cpu_axi_cdc's s_* (CPU-domain) inputs instead
of xbar_m_*[0] directly.
\end{textblock}

\subsection*{Before: async\_axi\_fifo u\_cpu\_axi\_cdc (}

\begin{textblock}
Safety re-verified (bead 2k8 task; do not re-derive, but do re-check
if this bridge's parameters or the arbiter's grant policy ever change):
  1. R-FIFO depth sufficiency: rv32i_cache_arbiter.sv's grant_q FSM
     (GRANT_NONE/GRANT_IC_RD/GRANT_DC_RD/GRANT_DC_WR) holds a single
     grant until RLAST (read) or BVALID+BREADY (write) before it can
     grant again, so at most ONE outstanding read burst exists at a
     time = 4 beats for a 16 B cache line. async_axi_fifo's R_DEPTH
     defaults to 8 and this instantiation below does not override any
     *_DEPTH parameter — 2x margin, confirmed.
  2. Cross-coupled reset root stays legitimate: rst_both_n =
     s_rst_n_i & m_rst_n_i becomes cpu_core_rst_n & core_rst_n — both
     still POR/PLL-lock-derived (see their respective declaration
     comments above), still a common root, satisfying the same
     contract OpenTitan's prim_sync_reqack and AMD PG059 require.
  3. No retention mode is lost: PMU power-down never reset u_cpu even
     before this fix (gated clock + synchronous reset already made it
     retention-by-construction on the CPU side), so nothing depended
     on the bridge flushing during a power-cycle.
  Also re-verified: async_axi_fifo.sv's ">= SYNC_STAGES+1 periods of
  the OTHER clock" reset contract still holds for s_rst_n_i under the
  new wiring — cpu_core_rst_n's low window is a SUBSET of
  cpu_domain_rst_n's old low window (cpu_domain_rst_n additionally
  drops for PMU-only events cpu_core_rst_n does not), and s_clk_i
  (cpu_gated_clk) is proven (see u_cpu_clk_dis_sync's ordering note
  above) to tick throughout cpu_core_rst_n's own low window — the same
  property the pre-fix analysis below this note used to rely on.
\end{textblock}

\subsection*{Before: async\_axi\_fifo u\_cpu\_axi\_cdc (}

\begin{textblock}
async_axi_fifo.sv's contract requires each of s_rst_n_i/m_rst_n_i to be
held low for >= SYNC_STAGES+1 periods of the OTHER face's clock (see
async_axi_fifo.sv header). Before the GH #93-fix above, this was
VIOLATED for s_rst_n_i (= cpu_domain_rst_n as it was wired THEN): s_clk_i
is cpu_gated_clk, which the pre-fix clk_en sync stopped completely for
the entire time cpu_domain_rst_n was low — i.e. s_clk_i saw ZERO
periods (not SYNC_STAGES+1) during s_rst_n_i's assertion. With the
GH #93 u_cpu_clk_dis_sync fix, cpu_gated_clk = cpu_core_clk runs
unconditionally throughout the entire cpu_core_rst_n-low window (see
the ordering note above u_cpu_clk_dis_sync), so s_clk_i ticks
throughout s_rst_n_i's assertion under the CURRENT (cpu_core_rst_n)
wiring too — the contract is met for the cold-boot/PLL-relock case.
\end{textblock}

\subsection*{Before: assign gif\_axil\_rready    = pmu\_gpu\_iso\_en ? 1'b0 : gpu\_...}

\begin{textblock}
bead h3lm: m_axil_if_rready is the ifetch R-channel accept - the one GPU->fabric
handshake output the original ISO_GPU clamp set missed (found by the UPF audit,
tools/verif/check_upf.py). Clamped like the other four ready/valid outputs.
\end{textblock}

\subsection*{Before: pwm\_controller \#(}

\begin{textblock}
PWM — APB slave (apb_psel[APB_PWM]), Phase 6a-2 (bead claude_verilog_test-f7vs.6)
\end{textblock}

\subsection*{Before: core\_clk domain. irq\_o -> interrupt\_controller bit 7; wd...}

\begin{textblock}
WDT — APB slave (apb_psel[APB_WDT]), Phase 6a-3 (bead claude_verilog_test-f7vs.7)
\end{textblock}

\subsection*{Before: core\_clk domain, no top-level pins: the entropy source i...}

\begin{textblock}
TRNG — APB slave (apb_psel[APB_TRNG]), Phase 6a-4 (bead claude_verilog_test-f7vs.8)
\end{textblock}

\subsection*{Before: core\_clk domain. Open-drain triplets, NO tristate (same ...}

\begin{textblock}
I2C — APB slave (apb_psel[APB_I2C]), Phase 6a-5 (bead claude_verilog_test-f7vs.9)
\end{textblock}

\subsection*{Before: inputs and NO top-level pins (register-only), so no cdc\_...}

\begin{textblock}
NPU — INT8 4x4 weight-stationary MAC array, APB slave (apb_psel[APB_NPU]),
Phase 6c (bead claude_verilog_test-f7vs.11). core_clk domain, single clock, NO asynchronous
\end{textblock}

\subsection*{Before: interrupt\_controller \#(}

\begin{textblock}
Phase 6 (bead claude_verilog_test-f7vs.2): N_SOURCES pre-allocated 6 -> 12;
bit 6 (PWM) is now driven by u_pwm above (Phase 6a-2, bead
claude_verilog_test-f7vs.6); bit 7 (WDT) by u_wdt above (Phase 6a-3, bead
claude_verilog_test-f7vs.7); bit 8 (TRNG) by u_trng above (Phase 6a-4, bead
claude_verilog_test-f7vs.8); bit 9 (I2C) by u_i2c above (Phase 6a-5, bead
claude_verilog_test-f7vs.9); bit 10 (CRYPTO) by u_crypto above (Phase 6b, bead
claude_verilog_test-f7vs.10); bit 11 (NPU) by u_npu above (Phase 6c, bead
claude_verilog_test-f7vs.11).
\end{textblock}

\subsection*{Before: logic        pll\_m\_psel, pll\_m\_penable, pll\_m\_pwrite;}

\begin{textblock}
GH #86: APB4 CDC bridge for the APB_PLL slot.

apb_interconnect is purely combinational (no clock port, see
soc_bus.sv "5. APB interconnect"); the APB transaction is driven by
axil_to_apb in the core_clk domain, while u_pll_sub samples
psel/penable and returns pready/prdata on clk_i / rst_n_i — the raw
reference clock, per pll_subsystem.sv's bootstrap rule (u_pll_sub is
the SOURCE of core_clk/pll_locked, so it cannot itself run on core_clk
without a deadlock — see pll_subsystem.sv header). With PLL_IMPL=
"RNM", core_clk != clk_i, so psel/penable/pready/prdata on this slot
crossed a clock boundary with no synchroniser. GH #93 fixed the
identical mechanism for the SECOND PLL (APB_PLL2, see u_apb_pll2_cdc
below) and explicitly named this slot (GH #86) as the same bug left
unfixed; this bridge closes it, modelled line-for-line on
u_apb_pll2_cdc.
\end{textblock}

\subsection*{Before: .psel        (pll\_m\_psel),}

\begin{textblock}
APB4 slave ← u_apb_pll_cdc m_* face (clk_i domain — GH #86 fix,
see CDC bridge note above)
\end{textblock}

\subsection*{Before: logic        pll2\_m\_psel, pll2\_m\_penable, pll2\_m\_pwrite;}

\begin{textblock}
GH #93: APB4 CDC bridge for the APB_PLL2 slot.

apb_interconnect is purely combinational (no clock port, see
soc_bus.sv "5. APB interconnect"); the APB transaction is driven by
axil_to_apb in the core_clk domain, while u_cpu_pll_sub samples
psel/penable and returns pready/prdata in the cpu_clk_i domain. Once
GH #93 makes cpu_clk_i a genuinely independent reference (no longer
required to equal clk_i for correctness elsewhere), that handshake
would cross a clock boundary with no synchroniser — the same
mechanism GH #86 fixed for the APB_PLL slot (see u_apb_pll_cdc above),
but live in the DEFAULT STUB build as soon as the two reference
clocks differ.
\end{textblock}

\subsection*{Before: .core\_clk    (cpu\_core\_clk),}

\begin{textblock}
PLL outputs — feed u_cpu_cg and the CPU-domain reset tree (GH #93)
\end{textblock}

\subsection*{Before: logic cpu\_mbist\_busy;}

\begin{textblock}
The force is HELD by the macro controller itself (cpu_mbist_busy = status done | busy, which is st_q != IDLE):
the TAP drops mbist_force at the Update-DR of the run = 0 word, a few cpu_core_clk edges BEFORE that word has
crossed into the macro, and with the PMU gate closed the controller would never see it and would be left
with bist_en = 1 (collars on the BIST bus) behind a stopped clock. With the self-hold the gate stays open
until the controller has cleared (done / busy fall one gated edge after run = 0 arrives), then closes.
Found by test_mbist_cpu_macro.py::test_mbist_force_opens_the_closed_clock_gate (c54a).
\end{textblock}

\end{record}

\section{\texttt{soc/sram\_controller.sv}}\label{cr:mod:sram-controller}

This section holds history text that was in a comment of the source file. The text is unchanged. Each line has no leading comment marker and no indentation.

\begin{record}

\subsection*{Before: typedef enum logic [1:0] \{W\_IDLE, W\_DATA, W\_DRAIN, W\_RES...}

\begin{textblock}
bead rvb Path A residual fix (2026-09-17): W_DRAIN is a new state used
only by the flat-array (`ifndef SRAM_SKY130`) branch below, to hold off
BVALID until the write pipeline (see the stage 1/2/3 block after the
channel assigns) has actually landed the burst's last beat in mem[].
The SRAM_SKY130 branch never transitions into W_DRAIN — its W_DATA
case arm still goes straight to W_RESP, unchanged. Adding this state
shifts W_RESP's synthesized encoding but not its behavior; wstate_e
stays a 2-bit type (4 states now instead of 3), identical simulated/
synthesized functional behavior for the SRAM_SKY130 branch either way.
\end{textblock}

\subsection*{Before: logic [IDX\_W-1:0] w\_idx;}

\begin{textblock}
bead rvb: binary word index (unlike the ifdef branch above, this is a
separate declaration so the SRAM_SKY130 branch's own w_idx text is
untouched). The MEM_WORDS-wide one-hot `word_sel_q` register from the
first rvb iteration (2026-09-16) is removed here — it was still a
same-cycle function of s_wvalid gating a MEM_WORDS-wide AND array
directly off the address-phase decode, and post-route measurement
(RUN_2026-09-17_09-01-42) showed the fan-out cone through mem[] was
still the #1 setup-violator class (16,400 violators, worst -1050 ps).
See the stage 1/2/3 write pipeline below for the actual fix.
\end{textblock}

\subsection*{Before: The pipeline takes 2 clock edges past this}

\begin{textblock}
bead rvb: BVALID must not assert until this
beat (the burst's last) has landed in mem[] —
see the write-pipeline latency note below.
\end{textblock}

\subsection*{Before: localparam int unsigned GROUP\_WORDS = 32;}

\begin{textblock}
bead rvb Path A residual fix (2026-09-17): 2-stage registered,
group-distributed write pipeline. Replaces the first rvb iteration's
word_sel_q-gated per-word always_ff (2026-09-16), which still made
every mem[] write-enable a same-cycle combinational function of
s_wvalid (via w_commit, gating a MEM_WORDS-wide AND array directly
off the address-phase one-hot decode) — confirmed still the #1
post-route setup-violator class on 26Q2 RUN_2026-09-17_09-01-42
(16,400 violators, worst -1050.16 ps). See
Doc: tm:pd:rvb-fanout-fix for the original root-cause
analysis this second iteration builds on.
\end{textblock}

\subsection*{Before: typedef enum logic [0:0] \{R\_IDLE, R\_BUSY\} rstate\_e;}

\begin{textblock}
---- Default: flat behavioral array, REGISTERED read (bead ydw). ----

claude_verilog_test-ydw: the previous `assign s_rdata = mem[r_idx]`
was a *live combinational* 1024:1 read mux — MEM_WORDS storage-flop
outputs into a DW-wide mux, straight out to s_rdata and on into
u_bus.u_xbar / the consuming master. On the ASAP7 SoC post-GRT STA
this was the dominant worst-path class: u_sram's mem[] storage flop
-> ~1050 ps of buffer/wire spread -> ~900 ps of mux -> s_rdata ->
crossbar -> u_dma.D, worst slack -1144.52 ps, 23% of all setup
violators. Fix: register the mux's output directly, one cycle after
the address is issued, so nothing downstream of s_rdata ever sees the
mux — only a flip-flop.

Select-path note: `r_idx` (the mux select) is a plain register, set
once on AR-accept and incremented in place by the sequential block
below. The select is never a live `rready ? r_idx+1 : r_idx`
combinational expression in front of the 1024:1 mux — r_idx already
*is* next-address-or-current, decided a cycle earlier, so the mux's
only fan-in beyond mem[] is that one register.
\end{textblock}

\subsection*{Before: typedef enum logic [0:0] \{R\_IDLE, R\_BUSY\} rstate\_e;}

\begin{textblock}
Masters checked this session for a same-address read issued WITHOUT
waiting for the preceding write's B (i.e. actually exposed to the
in-flight window above), all found SAFE-by-construction:
  - CPU D-cache (rtl/mem/rv32i_dcache.sv): CS_WRITEBACK only
    transitions to CS_REFILL on axi_bvalid_i && bresp==OKAY
    (rv32i_dcache.sv:749-751), and axi_arvalid_o is only driven from
    CS_REFILL (rv32i_dcache.sv:390) — no refill AR before the
    writeback's B is observed.
  - GPU memory_coalescer.sv: a single unified FSM handles one
    transaction (read XOR write) at a time; S_B only advances to
    S_DONE on m_bvalid_i (memory_coalescer.sv:192-198), and a new
    start_i (hence a new S_AR, memory_coalescer.sv:128) can only be
    issued after done_o, itself gated on S_DONE. NOT re-verified this
    session: whether gpu_top.sv/gpu_memory_unit.sv ever run multiple
    coalescer instances that could race an independent read engine
    against a different instance's in-flight write to the same SRAM
    word — only single-coalescer internal sequencing was checked.
  - DMA engine (rtl/periph/dma_engine.sv): single sequential FSM;
    S_B only advances to S_CALC/S_DESC_DONE on m_bvalid
    (dma_engine.sv:508-524), and S_CALC unconditionally moves to S_AR
    (dma_engine.sv:478-482) — no read state is reachable except
    through this B-gated path, including for an overlapping-address
    src/dst descriptor.
\end{textblock}

\subsection*{Before: typedef enum logic [0:0] \{R\_IDLE, R\_BUSY\} rstate\_e;}

\begin{textblock}
GH #104 fix (fr_null_20260724_051800_00): the macro's dout1 is
NEGEDGE-launched (see sim/sky130_sram_4kbyte_1rw1r_32x1024_8.sv):
addr1/csb1 presented during cycle N are captured by the macro's own
input register at the posedge ENDING cycle N, and the read is
performed at the NEGEDGE mid-cycle N+1 -- so dout1 only becomes
stable/sampleable from a posedge-sampling consumer's point of view
starting cycle N+2, i.e. TWO clock edges after the address is
presented, not one. The previous version of this FSM exposed
s_rvalid/s_rdata one cycle too early (cycle N+1), reading dout1
before its negedge write for that address had even happened --
reading stale data and silently dropping the true final beat.
\end{textblock}

\end{record}
% --- generated by PR7a: end

% --- generated by PR7c: begin
\section{\texttt{cpu/core/pipeline/rv32i\_pipeline\_ex.sv}}\label{cr:mod:rv32i-pipeline-ex}

This section holds history text that was in a comment of the source file. The text is unchanged. Each line has no leading comment marker and no indentation.

\begin{record}

\subsection*{Before: logic [2:0]  csr\_op\_w;}

\begin{textblock}
directly on a struct member (Synlig mis-elaborates that; bead ainf).
\end{textblock}

\end{record}

\section{\texttt{cpu/core/pipeline/rv32i\_pipeline\_ex1c.sv}}\label{cr:mod:rv32i-pipeline-ex1c}

This section holds history text that was in a comment of the source file. The text is unchanged. Each line has no leading comment marker and no indentation.

\begin{record}

\subsection*{Before: logic [31:0] ex1a\_alu\_result\_w;}

\begin{textblock}
(Synlig mis-elaborates that idiom; bead ainf).
\end{textblock}

\end{record}

\section{\texttt{cpu/core/pipeline/rv32i\_pipeline\_mem.sv}}\label{cr:mod:rv32i-pipeline-mem}

This section holds history text that was in a comment of the source file. The text is unchanged. Each line has no leading comment marker and no indentation.

\begin{record}

\subsection*{Before: logic [31:0] ex\_mem\_alu\_result\_w;}

\begin{textblock}
on ex_mem_reg_i.alu_result (Synlig mis-elaborates that; bead ainf).
\end{textblock}

\end{record}

\section{\texttt{cpu/core/pipeline/rv32i\_pipeline\_wb.sv}}\label{cr:mod:rv32i-pipeline-wb}

This section holds history text that was in a comment of the source file. The text is unchanged. Each line has no leading comment marker and no indentation.

\begin{record}

\subsection*{Before: logic [31:0] mem\_wb\_trap\_cause\_w;}

\begin{textblock}
directly on mem_wb_reg_i.trap_cause (Synlig mis-elaborates that; bead ainf).
\end{textblock}

\end{record}

\section{\texttt{cpu/core/rv32i\_control.sv}}\label{cr:mod:rv32i-control}

This section holds history text that was in a comment of the source file. The text is unchanged. Each line has no leading comment marker and no indentation.

\begin{record}

\subsection*{Before: if (axi\_rvalid \&\& ar\_issued) begin}

\begin{textblock}
Bug fix (stale AXI response after halt/resume):
ar_issued is cleared while in HALTED (the else branch of the
ar_issued block runs when current_state != FETCH/MEM_WAIT).
On HALTED→FETCH the CPU immediately issues a new AR (ar_issued=0,
arvalid=1).  If a stale rvalid is still pending from an in-flight AR
that was interrupted by the halt, the AXI slave holds rvalid=1.
This rvalid arrives while ar_issued=0 (before the new AR handshake
completes).  Detecting rvalid while ar_issued=0 identifies it as
stale: accept the handshake (rready=1) to unblock the slave but do
NOT transition to DECODE.  After the stale rvalid is drained,
ar_issued becomes 1 (new AR handshake completes) and the subsequent
fresh rvalid is accepted normally.

Normal case (no stale): rvalid always arrives AFTER ar_issued=1
(the AR handshake happens first).  So the gate ar_issued never
spuriously blocks normal rvalid acceptance.
\end{textblock}

\subsection*{End of file}

\begin{textblock}
============================================================================
HUMAN REVIEW CHECKLIST
============================================================================

Please verify the following before approving this control FSM:

✓ State transitions are correct and complete
  - RESET → FETCH
  - FETCH → DECODE (or TRAP on AXI error)
  - DECODE → EXECUTE (or TRAP on illegal instruction)
  - EXECUTE → MEM_WAIT (if memory op) or WRITEBACK
  - MEM_WAIT → WRITEBACK (or TRAP on AXI error)
  - WRITEBACK → FETCH
  - TRAP → FETCH
  - HALTED → FETCH (on resume/step)

✓ AXI handshake logic is correct
  - arvalid/arready for read address
  - rvalid/rready for read data
  - awvalid/awready for write address
  - wvalid/wready for write data
  - bvalid/bready for write response

✓ Commit signal timing is correct
  - commit_valid asserts for 1 cycle in WRITEBACK state
  - Includes PC, instruction, and result

✓ Trap handling is correct
  - Illegal instructions trigger TRAP state
  - AXI errors trigger TRAP state
  - Trap updates PC to trap vector

✓ Debug logic is correct
  - Halt request transitions to HALTED
  - Resume request transitions to FETCH
  - Single-step executes one instruction then returns to HALTED

✓ PC update logic is correct
  - PC+4 for normal instructions
  - Branch target for taken branches
  - Jump target for JAL/JALR
  - Trap vector for traps

============================================================================
\end{textblock}

\end{record}

\section{\texttt{cpu/core/rv32i\_decode.sv}}\label{cr:mod:rv32i-decode}

This section holds history text that was in a comment of the source file. The text is unchanged. Each line has no leading comment marker and no indentation.

\begin{record}

\subsection*{End of file}

\begin{textblock}
============================================================================
HUMAN REVIEW CHECKLIST
============================================================================

Please verify the following before approving this decoder:

✓ All 37 RV32I instructions are covered:
  - Arithmetic: ADD, SUB, ADDI (3)
  - Logical: AND, OR, XOR, ANDI, ORI, XORI (6)
  - Shifts: SLL, SRL, SRA, SLLI, SRLI, SRAI (6)
  - Compare: SLT, SLTU, SLTI, SLTIU (4)
  - Branches: BEQ, BNE, BLT, BGE, BLTU, BGEU (6)
  - Jumps: JAL, JALR (2)
  - Loads: LB, LH, LW, LBU, LHU (5)
  - Stores: SB, SH, SW (3)
  - Upper: LUI, AUIPC (2)
  TOTAL: 37 instructions

✓ Similar instructions properly distinguished:
  - ADD vs SUB (funct7[5])
  - SRL vs SRA (funct7[5])
  - SRLI vs SRAI (funct7[5])
  - LB vs LBU (funct3)
  - LH vs LHU (funct3)

✓ Control signal encoding is correct and complete

✓ Illegal instruction detection covers:
  - Invalid opcodes
  - Invalid funct3/funct7 combinations
  - Reserved encodings

✓ ALU operation encodings match approved scheme

✓ Immediate formats match RV32I specification

============================================================================
\end{textblock}

\end{record}

\section{\texttt{cpu/rv32i\_cpu\_top.sv}}\label{cr:mod:rv32i-cpu-top}

This section holds history text that was in a comment of the source file. The text is unchanged. Each line has no leading comment marker and no indentation.

\begin{record}

\subsection*{Before: Inactive values (functional mode, bit-identical to the p...}

\begin{textblock}
DFT test boundary (bead claude_verilog_test-j41m.4, Doc: tm:ch:dft-architecture 14.10)
\end{textblock}

\subsection*{Before: 96 quasi-static pins, no timing path other than the ordi...}

\begin{textblock}
MBIST boundary (bead claude_verilog_test-c54a, Doc: tm:ch:dft-architecture 16.7)
\end{textblock}

\subsection*{Before: returns one registered mismatch strobe, so the controlle...}

\begin{textblock}
Collar-local compare (bead c54a): in the Sky130 arm each mem_collar compares its own macro's read data and
\end{textblock}

\subsection*{Before: Encoding matches Doc: ds:mm:memory-map / DBG\_STATUS bits...}

\begin{textblock}
Latched halt cause register (Bug fix: breakpoint halt_cause reads as 0)
bp0_hit and bp1_hit are combinational signals that pulse for only the
single WRITEBACK cycle in which commit_valid is asserted.  By the time
the CPU transitions to HALTED and the test reads DBG_STATUS, those
signals are 0, so halt_cause reads 0.
Fix: capture the cause in a register when the event fires, and hold it
until the CPU resumes (exits HALTED).
\end{textblock}

\subsection*{Before: always\_ff @(posedge clk\_i) begin}

\begin{textblock}
SETUP-PHASE DECODE (GH #96 run-21 follow-up). The address-range compare
used to sit combinationally between the APB input pins and apb_pslverr_o.
At SoC level that exported a 620.67 ps macro in->out arc which, after the
apb_prdata_o register landed, became the LAST remaining cpu_clk violator
(-60.66 ps, 1 endpoint, run 21 / RUN_2026-08-08_04-24-08).
\end{textblock}

\subsection*{Before: always\_ff @(posedge clk\_i) begin}

\begin{textblock}
MEASURED, not assumed: an intermediate version of this fix registered the
decode in SETUP but still qualified the output with
(apb_pslverr_q && apb_psel_i && apb_penable_i). That did NOT help — the
regenerated Liberty still reported a 617.9 ps combinational arc, now from
apb_psel_i instead of apb_paddr_i (vs 620.67 ps before). The cost was
never the address decode: apb_psel_i drives a large internal fanout and
its buffered distribution across the block is what spends the ~600 ps
before reaching any output gate. So ANY combinational term on this output,
however shallow it looks in RTL, re-exports the same arc.
\end{textblock}

\subsection*{Before: logic [31:0] apb\_prdata\_comb;}

\begin{textblock}
rather than driving the port directly (see GH #96 bead cyb header note).
\end{textblock}

\subsection*{End of file}

\begin{textblock}
============================================================================
HUMAN REVIEW CHECKLIST
============================================================================

Please verify the following before approving this top-level integration:

✓ Core instantiation is correct:
  - All AXI4-Lite signals connected
  - Debug signals connected
  - Commit signals connected

✓ APB3 debug interface is correct:
  - Read/write access to control registers
  - Status register reflects CPU state
  - PC and instruction registers observable
  - PC writable when halted (implemented)
  - GPR[0:31] readable via APB (0x010-0x08C) (implemented)
  - GPR[0:31] writable when halted (implemented)

✓ Debug control logic is correct:
  - Halt request triggers CPU halt
  - Resume request resumes execution
  - Single-step executes one instruction

✓ Breakpoint logic is correct:
  - Breakpoint address comparison
  - Breakpoint enable control
  - Breakpoint hit detection
  - Breakpoint hits trigger CPU halt (integrated)

✓ All Phase 1 debug features implemented:
  - GPR read/write access via APB3 (implemented)
  - PC write access when halted (implemented)
  - All debug TODOs complete

✓ Protocol compliance:
  - AXI4-Lite master protocol (handled by core)
  - APB3 slave protocol (single-cycle, always ready)

============================================================================
\end{textblock}

\end{record}

\section{\texttt{fpga/fpga\_sdp\_ram\_be.sv}}\label{cr:mod:fpga-sdp-ram-be}

This section holds history text that was in a comment of the source file. The text is unchanged. Each line has no leading comment marker and no indentation.

\begin{record}

\subsection*{Header}

\begin{textblock}
fpga_sdp_ram_be.sv
FPGA Stage 0 (bead hlrm, GH #245) -- simple-dual-port, byte-enabled, block-RAM-inferable memory for
\end{textblock}

\end{record}

\section{\texttt{fpga/fpga\_sram\_1rw.sv}}\label{cr:mod:fpga-sram-1rw}

This section holds history text that was in a comment of the source file. The text is unchanged. Each line has no leading comment marker and no indentation.

\begin{record}

\subsection*{Header}

\begin{textblock}
fpga_sram_1rw.sv
FPGA Stage 0 (bead hlrm, GH #245) -- block-RAM-inferable stand-in for every 32-bit-wide 1RW SRAM hard macro
\end{textblock}

\end{record}

\section{\texttt{gpu/gpu\_compute\_unit.sv}}\label{cr:mod:gpu-compute-unit}

This section holds history text that was in a comment of the source file. The text is unchanged. Each line has no leading comment marker and no indentation.

\begin{record}

\subsection*{Before: Synchronous, one cycle, issued by gpu\_top once the AXI m...}

\begin{textblock}
GPU_CTRL.reset (bead q6w0): flush the pipeline and clear the sticky error.
\end{textblock}

\subsection*{Before: logic [N\_LANES-1:0][31:0] id\_ex\_rs1\_data\_w, id\_ex\_rs2\_da...}

\begin{textblock}
(defect D3, bead ainf).  The copies keep the same lane-index select.
\end{textblock}

\end{record}

\section{\texttt{gpu/gpu\_pkg.sv}}\label{cr:mod:gpu-pkg}

This section holds history text that was in a comment of the source file. The text is unchanged. Each line has no leading comment marker and no indentation.

\begin{record}

\subsection*{Before: localparam int WARP\_CNT\_W = \$clog2(N\_WARPS + 1); // 4}

\begin{textblock}
8 does not fit in 3 bits (bead 47lf / GH #254).
\end{textblock}

\end{record}

\section{\texttt{gpu/gpu\_top.sv}}\label{cr:mod:gpu-top}

This section holds history text that was in a comment of the source file. The text is unchanged. Each line has no leading comment marker and no indentation.

\begin{record}

\subsection*{Before: when !blk\_illegal: for an illegal BLOCK\_X the scheduler ...}

\begin{textblock}
is WARP_CNT_W bits wide, one more than a warp ID (WARP_W) (bead 47lf).  Only meaningful
\end{textblock}

\end{record}

\section{\texttt{gpu/warp\_scheduler.sv}}\label{cr:mod:warp-scheduler}

This section holds history text that was in a comment of the source file. The text is unchanged. Each line has no leading comment marker and no indentation.

\begin{record}

\subsection*{Before: input  logic [WARP\_CNT\_W-1:0]   n\_warps\_active\_i, // num...}

\begin{textblock}
(partial block, bead 6hy6)
\end{textblock}

\subsection*{Before: by gpu\_top once the AXI masters are quiet.  Wins over ev...}

\begin{textblock}
GPU_CTRL.reset (bead q6w0): abort the kernel.  Synchronous, one cycle, issued
\end{textblock}

\end{record}

\section{\texttt{mem/rv32i\_clock\_gate.sv}}\label{cr:mod:rv32i-clock-gate}

This section holds history text that was in a comment of the source file. The text is unchanged. Each line has no leading comment marker and no indentation.

\begin{record}

\subsection*{Before: input clock is low (same glitch-free contract as the ICG...}

\begin{textblock}
FPGA prototype (bead hlrm.2): Xilinx 7-series global clock buffer with clock enable. CE is latched while the
\end{textblock}

\end{record}

\section{\texttt{mem/rv32i\_dcache.sv}}\label{cr:mod:rv32i-dcache}

This section holds history text that was in a comment of the source file. The text is unchanged. Each line has no leading comment marker and no indentation.

\begin{record}

\subsection*{Before: `SRAM\_ASAP7 arm only (the other arms instantiate no cloc...}

\begin{textblock}
DFT (bead j41m.4): forces the SRAM clock gates open in test mode. Used by the
\end{textblock}

\subsection*{Before: bus and expected-data tag in, one registered mismatch st...}

\begin{textblock}
MBIST (bead claude_verilog_test-c54a, Doc: tm:ch:dft-architecture 16.7): the CPU-macro controller's broadcast
\end{textblock}

\subsection*{Before: LATCH, HIT\_PENDING, REFILL, WRITEBACK, UNCACHED\_RD/WR, F...}

\begin{textblock}
state_q[3] = every state that stalls unconditionally (see rv32i_cache_pkg.sv, bead r51p):
\end{textblock}

\subsection*{Before: CS\_REFILL — AXI4 burst refill:}

\begin{textblock}
Cancel-race audit (2026-05-21): the stale-R-beat race that was
fixed in rv32i_icache.sv does NOT apply here.  The D-cache has
no cancel-on-!dc_valid_i branch in CS_REFILL, so ar_pending_q
is never cleared while an R beat is still in flight.  The two
state_q <= CS_IDLE exit paths (rresp-error below and bresp-error
in CS_WRITEBACK) only fire when the respective handshake
completes that same cycle, so no orphan beat is left in flight.
CS_FLUSH_SCAN does not issue AR transactions so the cancel-race
does not apply there either.
\end{textblock}

\end{record}

\section{\texttt{mem/rv32i\_icache.sv}}\label{cr:mod:rv32i-icache}

This section holds history text that was in a comment of the source file. The text is unchanged. Each line has no leading comment marker and no indentation.

\begin{record}

\subsection*{Before: `SRAM\_ASAP7 arm only (the other arms instantiate no cloc...}

\begin{textblock}
DFT (bead j41m.4): forces the SRAM clock gates open in test mode. Used by the
\end{textblock}

\subsection*{Before: bus and expected-data tag in, one registered mismatch st...}

\begin{textblock}
MBIST (bead claude_verilog_test-c54a, Doc: tm:ch:dft-architecture 16.7): the CPU-macro controller's broadcast
\end{textblock}

\subsection*{Before: assign ic\_stall\_o =}

\begin{textblock}
HIT_PENDING / WRITEBACK / UNCACHED_* / *_SCAN are D$-only). See rv32i_cache_pkg.sv, bead r51p.
\end{textblock}

\end{record}
% --- generated by PR7c: end

% --- generated by PR7b: begin
\section{\texttt{periph/i2c\_bit\_engine.sv}}\label{cr:mod:i2c-bit-engine}

This section holds history text that was in a comment of the source file. The text is unchanged. Each line has no leading comment marker and no indentation.

\begin{record}

\subsection*{Header}

\begin{textblock}
  * Only the BIT clock and the START/STOP condition times above are spec-checked quantities (bit
    clock: test_i2c_clkdiv_100k_400k; conditions and tBUF:
    test_i2c_start_stop_condition_times_meet_spec / test_i2c_stop_to_start_bus_free_time_meets_spec).
\end{textblock}

\end{record}

\section{\texttt{periph/interrupt\_controller.sv}}\label{cr:mod:interrupt-controller}

This section holds history text that was in a comment of the source file. The text is unchanged. Each line has no leading comment marker and no indentation.

\begin{record}

\subsection*{Header}

\begin{textblock}
APB migration PR-5: converted from AXI4-Lite slave to APB4 slave.
\end{textblock}

\end{record}

\section{\texttt{periph/spi\_controller.sv}}\label{cr:mod:spi-controller}

This section holds history text that was in a comment of the source file. The text is unchanged. Each line has no leading comment marker and no indentation.

\begin{record}

\subsection*{Header}

\begin{textblock}
APB migration PR-3: converted from AXI4-Lite slave to APB4 slave.
\end{textblock}

\end{record}

\section{\texttt{periph/trng.sv}}\label{cr:mod:trng}

This section holds history text that was in a comment of the source file. The text is unchanged. Each line has no leading comment marker and no indentation.

\begin{record}

\subsection*{Header}

\begin{textblock}
RO-register hazard (historical, bead 6o8w): apb4_register_bank used to let a SW write win over a
same-cycle HW write even when WMASK == 0 (it wrote the old value back), so a stray APB store to
STATUS or DATA could swallow a FIFO update or a health set. The bank is now race-free (SW wins
inside WMASK, HW wins outside it). Stores to those two words are still presented to the bank as
reads (bank_pwrite_w), retained as belt-and-braces with the same observable behaviour, as in
watchdog_timer.sv. New peripherals do not need this pattern.
\end{textblock}

\subsection*{Before: logic bank\_pwrite\_w;}

\begin{textblock}
Stores to the two HW-owned words are shown to the bank as reads (bead 6o8w, see header).
\end{textblock}

\end{record}

\section{\texttt{periph/uart\_controller.sv}}\label{cr:mod:uart-controller}

This section holds history text that was in a comment of the source file. The text is unchanged. Each line has no leading comment marker and no indentation.

\begin{record}

\subsection*{Header}

\begin{textblock}
APB migration PR-2: converted from AXI4-Lite slave to APB4 slave.
\end{textblock}

\end{record}

\section{\texttt{periph/watchdog\_timer.sv}}\label{cr:mod:watchdog-timer}

This section holds history text that was in a comment of the source file. The text is unchanged. Each line has no leading comment marker and no indentation.

\begin{record}

\subsection*{Header}

\begin{textblock}
RO-register hazard (historical, bead 6o8w): apb4_register_bank used to let a SW write win over a
same-cycle HW write even when WMASK was 0 (it wrote the old value back), so a stray APB store to
COUNT or STATUS could stall the counter or swallow a bark/bite set. The bank is now race-free
(SW wins inside WMASK, HW wins outside it). Stores to those two words are still presented to the
bank as reads (bank_pwrite_w), retained as belt-and-braces; it gives the same observable
behaviour. New peripherals do not need this pattern.
\end{textblock}

\subsection*{Before: logic bank\_pwrite\_w;}

\begin{textblock}
Stores to the two HW-owned words are shown to the bank as reads (see header).
\end{textblock}

\end{record}
% --- generated by PR7b: end

\chapter{Physical design files}\label{cr:ch:physical-design-files}

This chapter holds the history text of the physical design files.

% --- generated by PR6: begin
\section{\texttt{Makefile}}\label{cr:pd:makefile}

This section holds dated history that was in a comment of the source file. The text is unchanged. Each line has no leading comment marker and no indentation.

\begin{record}

\subsection*{Before: SKY130\_CPU\_SV\_FILES := \textbackslash{}}

\begin{textblock}
Sky130 Stage 1: CPU standalone with REAL Magic DRC + Netgen LVS (GH #103)
Builds native sky130_rv32i_cpu_top.{lef,lib,nl.v} macro views.
Uses volare PDK auto-detection (same as librelane-sky130).
##############################################################################
sv2v CPU macro pre-processing step (bead claude_verilog_test-dud4, 2026-10-11)

Bead dud4 proved the Synlig/UHDM frontend (USE_SYNLIG:true) elaborated two port
connections of rv32i_core's u_hazard instance as 5'x
(`.if_id_rs1_addr(if_id_reg.instruction[19:15])` / rs2 `[24:20]`: "Range select
[639:608] out of bounds on signal if_id_reg: Setting all 32 result bits to undef"), so
the committed Sky130 CPU macro (RUN_2026-07-27_05-52-19) mis-forwards. User-approved
remedy (2026-10-10): sv2v switch for this macro AND the RTL part-select rewrite
(PR #259). This target mirrors asap7-cpu-sv2v: it converts the CPU cone to one
Verilog-2005 file so Yosys read_verilog handles it without Synlig. The SRAM stub
(sky130_sram_1kbyte_1rw1r_32x256_8_stub.v) is already plain Verilog and stays OUT of
this list; it is the only module left undefined (hard macro).

Defines: sv2v resolves `ifdef ITSELF, so SRAM_SKY130 (selects the OpenRAM macro
instantiation in rv32i_icache/dcache) MUST be passed here. The PDK_/SCL_/__ defines
are the ones LibreLane hands the Synlig frontend; no CPU-cone file branches on them,
they are passed so the recipe equals the synthesis-only "arm V" of the dud4 experiment
(/nobackup/claude_sim_build/dud4/synth/NOTES.md) bit for bit. No rv32i_clock_gate.sv
here (unlike ASAP7): the Sky130 CPU has no ICG.

Output: pnr/sky130/cpu/rv32i_cpu_top_sv2v.v (generated, gitignored). Do not hand-edit.
##############################################################################
\end{textblock}

\subsection*{Before: SKY130\_SOC\_SV\_FILES := \textbackslash{}}

\begin{textblock}
NOTE: the former `librelane-sky130-sram` target (standalone hardening of
rtl/soc/sram_controller.sv as a composite macro) was REMOVED. That approach
was abandoned: its hardened macro could never be PDN-stitched at SoC level
(unresolvable PSM-0069, ~1001 unconnected nodes). It was replaced by a real
OpenRAM-compiled macro (sky130_sram_4kbyte_1rw1r_32x1024_8) — see the Stage 2
SoC section below. Config/artifacts archived to
/nobackup/abandoned_sram_composite/.

##############################################################################
Sky130 Stage 2: SoC (CPU hard macro + flat peripherals)  GH #104

sv2v converts all SV files to Verilog-2005 so Yosys read_verilog handles
packages, structs, and generate blocks without Synlig UHDM.
GPU is a synthesisable tie-off stub (gpu_top_tieoff.sv); CPU is blackboxed
(rv32i_cpu_top_stub.sv); SRAM is now ALSO a blackboxed OpenRAM hard macro
(sky130_sram_4kbyte_1rw1r_32x1024_8_stub.sv, via +define+SRAM_SKY130 --
see below); boot_rom remains behavioural (ROM-only, no DFFs).

GH #104 SCOPE DECISION (2026-07-23, REVERSES Option C): sram_controller's
backing store is a real sky130_sram_4kbyte_1rw1r_32x1024_8 OpenRAM hard
macro again (1024 x 32b, 4 KB), compiled fresh via OpenRAM (see
memory/pd/run_state.md, openram_sram4k_subtask). This is NOT the old
custom-hardened composite sram_controller macro (whole AXI4 wrapper +
behavioral array hardened as one block) that hit the unresolved
PSM-0069 PDN wall -- that approach is abandoned. Instead, only the raw
OpenRAM SRAM primitive is blackboxed (u_sram_macro, instantiated inside
the still-synthesisable rtl/soc/sram_controller.sv control-logic RTL
under `ifdef SRAM_SKY130`); its LEF is a standard OpenRAM PG abstract
(vccd1/vssd1 on met3+met4), already proven connectable via
rv32i_cpu_top's own 10 internal OpenRAM SRAMs (PSM-0040 clean). This
macro is also ~14x smaller in area (701.64 x 673.335 um) than the
failed composite block (2585 x 2595 um).
##############################################################################
\end{textblock}

\subsection*{Before: SKY130\_SOC\_SV2V\_DEFINES := --define=\_\_pnr\_\_ --define=SRA...}

\begin{textblock}

USE_SKY130_CLKCELLS (bead claude_verilog_test-j41m.4): hand-instantiate sky130_fd_sc_hd__sdlclkp_4 + buf_16
(rv32i_clock_gate, HARD_ROOT instances) and mux2_4 + buf_16 (dft_clk_mux; buf_16, not clkbuf_16, to avoid CTS-0105) on the two clock roots whose
behavioural form synthesis mapped to and2_2 / a21bo_2, failing CVT.MaxCapViolations on the CTS-owned nets
cpu_gated_clk and core_clk (RUN_2026-10-16_04-53-49). sv2v resolves the `ifdef itself, so it must be passed here;
config.json's VERILOG_DEFINES comes too late. NOT in SKY130_CPU_SV2V_DEFINES: the CPU hard macro is unchanged.
The three cells' black-box stubs are sky130_clkcells_stub.v in SKY130_SOC_SV_FILES.
\end{textblock}

\subsection*{Before: SKY130\_SOC\_CONFIG ?= config\_rccal.json}

\begin{textblock}
── RC-calibrated pre-route repair variant (bead claude_verilog_test-e45j) ────
Same flow, but the four pre-route repair/resizer steps are replaced by the CVT.* steps of the
project-local plugin pnr/sky130/soc/plugin/librelane_plugin_cvt_sky130 (picked up because
LibreLane imports every librelane_plugin_* on PYTHONPATH), which scale the GRT/placement wire-RC
estimate to what OpenRCX later extracts. The shared LibreLane install is NOT modified.

ADOPTED AS THE DEFAULT 2026-10-09 (user decision, bead e45j): `make librelane-sky130-soc[-noklayout]` now runs
config_rccal.json. config.json is the pre-adoption (non-RC-calibrated) flow, kept for A/B comparison and
reached through the -norccal targets below. Override either way with SKY130_SOC_CONFIG=<file>; the override
is honoured by every target (the old -rccal-noklayout recipe that ignored it is now just an alias).

config_rccal.json also substitutes Checker.MaxCapViolations with the plugin's CVT.MaxCapViolations, which
gates max-cap at ALL corners and waives only the named entries of constraints/max_cap_waivers.json (macro
load pin, ceiling, justification). The stock checker is skipped only for configs that lack that substitution
(config.json): un-skipped alone it is a no-op, because checker.py's corner_override=[""] makes it match no
corner, so it only logs a WARNING (measured, Doc: cr:defect:sky130-slew-cap-e45j section 7).
\end{textblock}

\subsection*{Before: librelane-sky130-soc-noklayout:}

\begin{textblock}
── KLayout-DRC-free variant (bead claude_verilog_test-00ef) ──────────────────
RUN_2026-09-20_19-46-05 was killed by the host's memory reaper inside
56-klayout-drc, which was holding 8.5 GB on a 15 GB machine. Steps 1-55 had
completed, but KLayout.DRC sits BEFORE Netgen.LVS in librelane's Classic flow
(librelane/flows/classic.py:106 KLayout.DRC -> :108 Checker.KLayoutDRC ->
:111 Netgen.LVS -> :112 Checker.LVS), so the kill cost us LVS -- the single
most important physical gate this node has -- for a check that is not on the
critical path to it.

This target skips both KLayout steps so the flow reaches LVS on this host.
It does NOT touch pnr/sky130/soc/config.json: RUN_KLAYOUT_DRC stays true there
and the sign-off config remains byte-identical, so the skip is visible in the
command line rather than hidden in config state. KLayout DRC is then a
separate pass, not a silently dropped gate -- re-run plain
`librelane-sky130-soc` on a larger host to get it.
\end{textblock}

\subsection*{Before: librelane-sky130-soc-rccal-noklayout:}

\begin{textblock}
Unlike the pre-adoption recipe it honours SKY130_SOC_CONFIG, e.g. for an A/B arm:
  make librelane-sky130-soc-noklayout SKY130_SOC_CONFIG=<arm>.json
and confirm the key in <run>/resolved.json. (The wire-length arm config_rccal_wl1500.json was removed
2026-10-28: GRT_DESIGN_REPAIR_MAX_WIRE_LENGTH=1500 is now in config_rccal.json, Doc: cr:defect:sky130-slew-cap-e45j section 9.)
\end{textblock}

\subsection*{Before: CPU\_SV\_FILES := \textbackslash{}}

\begin{textblock}
##############################################################################
sv2v CPU macro pre-processing step (bead claude_verilog_test-ma7, 2026-09-19)

Beads u99+ma7 PROVED USE_SYNLIG:true (Synlig/UHDM) mis-elaborates
rv32i_cpu_top's runtime-indexed regfile read mux (OPT_MUXTREE, same class as
beads gcd/b0t) -- corruption reaches the APB debug-read port (u99) AND the
ID-stage rs1/rs2 reads that feed EX (ma7's branch-dependent-program GLS
proof). User-approved remedy: bypass Synlig for this macro too, mirroring
valu_hls (commit f2445ad) and the SoC's own asap7-soc-sv2v target. Converts
every SV file in rv32i_cpu_top's cone (packages, pipeline stages, caches,
core, top) to plain Verilog-2005 in one pass so Yosys read_verilog handles
it without Synlig. The two blackbox stub .v files (SRAM, ICG) are already
plain Verilog and stay OUT of this list, same split as the SoC target keeps
for its own macro stubs.

Defines mirror config.json's VERILOG_DEFINES, but sv2v resolves `ifdef
ITSELF before Yosys ever runs (see asap7-soc-sv2v's SOC_SV2V_DEFINES note
above) -- so they MUST be passed here, not just left in config.json's
VERILOG_DEFINES, or sv2v bakes in the wrong branch:
  SRAM_ASAP7   -- selects the ASAP7 SRAM macro instantiation (rv32i_icache.sv
                  / rv32i_dcache.sv `elsif SRAM_ASAP7) over the sky130/
                  freepdk45 behavioural alternatives.
  USE_ICG_CELL -- selects the real ICGx1_ASAP7_75t_R clock-gate cell
                  (rv32i_clock_gate.sv `ifdef USE_ICG_CELL) over the
                  behavioural always_latch model, which Yosys cannot map to
                  any ASAP7 standard cell.
__pnr__ is NOT needed here (unlike the SoC target): grep confirms no file in
CPU_SV_FILES branches on it -- that macro only affects rtl/soc/* files
(boot_rom.sv etc.) which are not part of this macro's cone.

Output: pnr/asap7/cpu/rv32i_cpu_top_sv2v.v (generated, gitignored). Do not
hand-edit -- regenerate via this target.
##############################################################################
\end{textblock}

\subsection*{Before: GPU\_SV\_FILES := \textbackslash{}}

\begin{textblock}
##############################################################################
sv2v GPU macro pre-processing step (bead claude_verilog_test-ma7, 2026-09-19)

Config-switch companion to asap7-cpu-sv2v above -- see that target's header
comment for the full u99/ma7 rationale. warp_scheduler.sv:152
(`div_depth[exec_warp_id_i]`) uses the SAME runtime-indexed-mux idiom already
PROVEN corrupt under USE_SYNLIG:true for the CPU macro, untested for GPU but
same risk class, so the GPU config is switched for consistency. Unlike the
CPU, THE GPU RE-HARDEN ITSELF IS DEFERRED (host-gated: ~13.5h+ GRT, 14+ GiB
peak RSS, this host is 15.9 GB with no swap) -- this target exists so
`librelane-asap7-gpu` is ready to run correctly whenever someone has the
host budget, not because a GPU re-harden has happened.

No `ifdef in any GPU RTL file (verified 2026-09-19: grep for ifdef/ifndef/
__pnr__/SRAM_ASAP7/USE_ICG_CELL across the whole gpu_pkg.sv..gpu_top.sv cone
returns zero hits), so no --define flags are needed, unlike the CPU/SoC
targets. gpu_pkg.sv is included so sv2v resolves the package import itself.
The SRAM blackbox stub (sram_1rw_128x32_asap7_stub.v) is already plain
Verilog and stays OUT of this list, same split as asap7-cpu-sv2v.

Output: pnr/asap7/gpu/gpu_top_sv2v.v (generated, gitignored). Do not
hand-edit -- regenerate via this target.
##############################################################################
\end{textblock}

\subsection*{Before: SOC\_SV2V\_DEFINES := --define=USE\_ICG\_CELL --define=\_\_pnr...}

\begin{textblock}

sv2v resolves `ifdef ITSELF, before Yosys ever runs. config.json's
VERILOG_DEFINES is therefore TOO LATE for anything sv2v already decided:
whichever branch sv2v takes is baked into soc_top_sv2v.v as plain Verilog.

USE_ICG_CELL: without it, rv32i_clock_gate.sv falls to its behavioural
`always_latch` model, which Yosys infers as $_DLATCH_N_ and cannot map to
any ASAP7 standard cell -- Checker.YosysUnmappedCells then aborts the flow
with "2 Unmapped Yosys instances found" (observed 2026-08-05,
RUN_2026-08-05_21-20-25). With it, the module instantiates the real
ICGx1_ASAP7_75t_R, which exists in both asap7sc7p5t_SEQ_RVT_TT liberty and
asap7sc7p5t_SIMPLE_RVT_1x.lef. This did not bite before 2026-08 because the
SoC had no clock gates until the PMU epic (GH #98) and GH #93 added them.

__pnr__ (added 2026-08-15, bead claude_verilog_test-61v): boot_rom.sv keys
its ROM-preload branch off `ifndef __pnr__ -- without it, this target and
the sky130 SoC target (pnr/Makefile:693, which has always passed __pnr__)
elaborated DIFFERENT boot ROM RTL from the same source tree. Originally
withheld here because run 14 (RUN_2026-06-23_18-05-38, the single-clock M11 ASAP7
SoC signoff) was built WITHOUT it, and adding it mid-campaign would have
changed boot ROM contents relative to that PPA baseline. That reason has
now expired: GH #96 run 23 (RUN_2026-08-09_14-36-16) is the accepted
multi-clock ASAP7 SoC baseline, and it is driven by the separate
pnr/asap7/soc/config_multiclock.json, so run 14 / config.json stay
byte-reproducible regardless of this change. Adding __pnr__ makes this
target consistent with sky130 and removes the behavioural $readmemh /
MEM_INIT_FILE-as-string path from the synthesised ASAP7 netlist (the
`else` arm supplies the same zero-filled ROM synthesis always produced
anyway -- see rtl/soc/boot_rom.sv:33-41,102-111). Any future ASAP7 SoC
re-signoff run picks this up; there is no run built on config.json between
2026-08-15 and the next full P&R that this could silently perturb.

NOTE for whoever next diffs this netlist: boot_rom.sv is NOT the only file
affected. PR #152 (GH #116 item C) wired the same __pnr__ macro into the
non-synthesizable param-check initial/$fatal blocks in
axi_lite_register_bank.sv, apb4_register_bank.sv and axil_to_apb.sv, so
enabling it here drops those too. Measured delta on the 2026-08-15
regeneration: 43 lines. Do not attribute the whole change to the boot ROM.

SRAM_ASAP7 IS passed here, as of Phase 6c (bead claude_verilog_test-f7vs.11).
It used to be deliberately omitted on the grounds that no file in
SOC_SV_FILES branched on it, so it mattered only to Yosys, which gets it
from config.json's VERILOG_DEFINES. rtl/npu/npu_weight_mem.sv is the first
file in this list that DOES branch on it: its 3-way `ifdef SRAM_SKY130 /
`elsif SRAM_ASAP7 / `else chain selects 1x sky130_sram_4kbyte_1rw1r_32x1024_8,
4x sram_1rw_256x32_asap7, or 4x sram_1rw_256x32_freepdk45 respectively.
Because sv2v resolves `ifdef ITSELF, before Yosys ever runs, leaving this
define off would make the ASAP7 SoC netlist instantiate the FreePDK45
module -- which has no ASAP7 LEF, so sv2v+Yosys would SILENTLY BLACKBOX it:
unplaced, unconstrained, and undetectable by any cocotb suite. The ASAP7
stub/LEF/LIB were already registered in every ASAP7 SoC config
(VERILOG_FILES + EXTRA_LEFS + EXTRA_LIBS) and merely unused until now.

The sky130 SoC target deliberately does NOT get USE_ICG_CELL: ICGx1 is an
ASAP7 cell, and sky130 has real latch cells for the behavioural model to
map onto.
----------------------------------------------------------------
\end{textblock}

\subsection*{Before: librelane-asap7-soc-multiclock: SOC\_CONFIG = config\_mult...}

\begin{textblock}
----------------------------------------------------------------
librelane-asap7-soc-multiclock: GH #96 PD re-closure (bead 8nz).

Same flow as librelane-asap7-soc, but driven by config_multiclock.json,
which points PNR/SIGNOFF/FALLBACK_SDC_FILE at
constraints/phase5_soc_multiclock.sdc (GH #94): two create_clock statements
-- sys_clk 1750 ps on port clk_i, cpu_clk 780 ps on port cpu_clk_i -- plus
set_clock_groups -asynchronous between them.

The two CTS trees come from those two create_clock statements, NOT from
CLOCK_PORT/CLOCK_NET: librelane's CTS step only derives CLOCK_NET from
CLOCK_PORT when CLOCK_NET is unset, and cts.tcl's own use of $::env(CLOCK_NET)
is an informational `puts`, not a clock_tree_synthesis argument. OpenROAD
builds one tree per clock defined in the SDC.

NO prune step here, unlike librelane-asap7-soc: /nobackup/asap7_soc_runs
holds exactly ASAP7_MAX_RUNS (10) runs today, so pruning would start aging
out runs the moment a #96 run lands. The run-14 sign-off baseline
(RUN_2026-06-23_18-05-38) must not be at the mercy of an `ls -td | tail`
heuristic across the iteration budget. /nobackup has ~570 GB free; prune
manually if that ever changes, and never delete RUN_2026-06-23_18-05-38.

Usage:
  make librelane-asap7-soc-multiclock                       # full P&R, ~5 h
  make librelane-asap7-soc-multiclock LIBRELANE_EXTRA_ARGS='--to OpenROAD.STAPrePNR'
                                                            # preflight gate, ~75 min
----------------------------------------------------------------
\end{textblock}

\subsection*{Before: check-cdc-timing-asap7-soc:}

\begin{textblock}
bead claude_verilog_test-k07 / GH #96. Runs pnr/scripts/check_cdc_timing.tcl
(standalone OpenSTA) with pnr/constraints/phase5_soc_multiclock_check.sdc
against a routed ASAP7 SoC netlist that actually contains the CDC modules
(async_axi_fifo / apb_cdc_bridge / second PLL) -- i.e. a run of
pnr/asap7/soc/config.json with PNR_SDC_FILE pointed at
phase5_soc_multiclock.sdc. That re-closure run is GH #96 scope; as of
2026-08-02 it has not happened yet, so this target will correctly report
"Netlist not found" until it does. Deliberately separate from
`make sta` / 07_sta.tcl: this is CDC-boundary-only verification, not a
full-chip signoff sweep (see check_cdc_timing.tcl's header for why the
two cannot be combined in one SDC read).

Usage: make check-cdc-timing-asap7-soc RUN_DIR=/nobackup/asap7_soc_runs/RUN_...
       (defaults to the latest run under /nobackup/asap7_soc_runs if unset)

EXIT CODE (bead claude_verilog_test-dwp, 2026-08-03): check_cdc_timing.tcl
now exits 0/1/2 explicitly on its own (see that file's header) -- OpenSTA
batch mode does not propagate a Tcl `error` into the process exit code,
so the script never relies on that. This recipe ALSO greps the captured
log for the CDC-EXCEPTION-MISS / budget-VIOLATED / CDC-CHECK-RESULT: FAIL
markers the script emits and fails the make target on any hit,
independent of $?  from `sta` itself -- belt-and-braces in case a future
OpenSTA version's exit-code behaviour regresses again (bead dwp
rationale). NOTE: this recipe deliberately does NOT pipe `sta`'s output
through `tee` to get "live" console output -- this Makefile has no
SHELL override (default POSIX /bin/sh, e.g. dash), which has no
PIPESTATUS, so `$?` after a `cmd | tee log` pipeline would capture
tee's exit status (always 0) instead of sta's. Output is redirected
straight to a log file, `$?` is captured from that direct invocation,
and the full log is `cat`'d to the console afterwards -- readable, just
not streamed live.
----------------------------------------------------------------
\end{textblock}

\subsection*{Before: CDC\_CORNER ?=}

\begin{textblock}
----------------------------------------------------------------
check-cdc-timing-sky130-soc: post-route CDC budget verification, Sky130 SoC (bead j41m.5).
Sky130 sibling of check-cdc-timing-asap7-soc: pnr/scripts/check_cdc_timing_sky130.tcl with
pnr/sky130/soc/constraints/sky130_soc_cdc_check.sdc against a finished Sky130 SoC run (netlist
+ OpenRCX SPEF of the chosen corner). The budgets cannot live in sky130_soc.sdc (it declares
core_clk/cpu_clk asynchronous, and OpenSTA drops a set_max_delay across such a pair) -- see the
header of the check SDC.

Usage: make check-cdc-timing-sky130-soc [RUN_DIR=/nobackup/sky130_soc_runs/RUN_...]
                                        [CDC_CORNERS="nom_tt_025C_1v80 max_ss_100C_1v60"] [CDC_CORNER=<one>]
       (RUN_DIR defaults to the newest run under /nobackup/sky130_soc_runs)
Corners (bead j41m.5, decision C): the DEFAULT is nom_tt AND max_ss, sequentially, one sta process at
a time, FAIL if ANY corner fails. A nom_tt-only default hid a 0.95 ns margin on RUN_2026-10-16_04-53-49
that became -0.715 ns at max_ss on the next run. CDC_CORNERS=all runs all nine; CDC_CORNER=<one> (the
old single-corner knob) still works and wins over CDC_CORNERS. Each corner also reports the per-pointer
gray-code bit skew (CDC_CHECK_SKEW_FRAC / CDC_CHECK_SKEW_LIMIT, see check_cdc_timing_sky130.tcl).
Exit: 0 only if every corner passes; 1 on any CDC-EXCEPTION-MISS / VIOLATED / FAIL / SETUP-ERROR marker in
a corner's log (grepped independent of sta's own exit code, as in the ASAP7 target); sta's exit otherwise.
Memory: ~3-5 GB per corner with SPEF on this SoC, corners run one after another; do not run next to a
LibreLane flow on a 15 GB host.
----------------------------------------------------------------
\end{textblock}

\subsection*{Before: RUN\_DIR ?=}

\begin{textblock}
Usage: make flop-count RUN_DIR=asap7/gpu/runs/RUN_2026-05-24_09-12-00
       make flop-count RUN_DIR=asap7/runs/RUN_2026-05-20_06-27-10
\end{textblock}

\subsection*{Before: define prune\_runs}

\begin{textblock}

TWO PROTECTIONS, both added after this macro silently destroyed the ASAP7 CPU
sign-off runs (2026-09-09): a 10-run bring-up campaign in one night evicted
every pre-September run, including the one CLAUDE.md and
Doc: cr:run:phase5 cite. The macro-view archiving under
pnr/asap7/*/macro/ is what saved the netlists and abstracts; the run
directories -- step logs, per-step metrics, intermediate ODBs, the STA reports
behind the quoted numbers -- were lost and are not reproducible (different
LibreLane, different OpenROAD now).

 1. A run directory containing a `.signoff` file is NEVER deleted, regardless
    of age or run count. Mark a run the moment its numbers are quoted anywhere:
        touch pnr/asap7/cpu/runs/RUN_<stamp>/.signoff
 2. Every deletion is PRINTED before it happens. The old macro reported only a
    count, so an eviction of something irreplaceable looked identical to
    cleaning up scratch runs.
\end{textblock}

\subsection*{Before: R8R\_VALU\_HLS\_SHIM\_SV := \textbackslash{}}

\begin{textblock}
GH #119 r8r bead b0t remedy (2026-09-19, user-approved): the baseline FSM-arm
shim (hls/gpu/vector_alu/shim/vector_alu_hls.sv) uses the same ANSI-header
package-import module form that Synlig/UHDM (USE_SYNLIG) mis-elaborates for
the sdc_longclk combinational candidate (bead gcd). A gate-level simulation
(tools/verif/gls/run_hls_seq_check.py, bead b0t part B) proved the tracked
USE_SYNLIG:true netlist for THIS arm is also corrupt: it fails all 3 golden
vectors (VMUL partial-mask, VADD full-mask, VAND alternating-mask), while a
USE_SYNLIG:false + sv2v-preprocessed netlist of the identical RTL passes all
3 bit-exact. Fix: bypass Synlig here too -- pre-process gpu_pkg.sv + the
shim through sv2v into plain Verilog-2005, then set USE_SYNLIG:false and
point valu_hls/config.json's VERILOG_FILES at the sv2v output instead of the
raw .sv + gpu_pkg.sv. Deterministic/reproducible via this target -- do not
hand-edit the generated .v. Mirrors egt-valu-hls-comb-sv2v above.
\end{textblock}

\end{record}

\section{\texttt{asap7/cpu/macro\_placement\_3014.cfg}}\label{cr:pd:asap7-cpu-macro-placement-3014-cfg}

This section holds dated history that was in a comment of the source file. The text is unchanged. Each line has no leading comment marker and no indentation.

\begin{record}

\subsection*{Header comment}

\begin{textblock}
2026-09-09 attempt 8: all x shifted +1.365 um (half a DRT worker) off the
original 3014 positions. Evidence: every DRT-0255 failure in attempt 7 was in
ONE worker routeBox column, and the reported source access points sat exactly on
that worker's right edge -- e.g. pin gen_data_sram[3]/dout0[4] ap at x=62790 DBU
with routeBox (60060 5460)(62790 8190). The DRT worker grid is 2730 DBU (2.73 um);
that macro's left edge (62440) sat only 350 DBU from the boundary. Shifting by half
a worker moves every pin column to mid-worker.
\end{textblock}

\subsection*{Header comment}

\begin{textblock}

Why: sram_1rw_256x32_asap7 declares all 77 signal pins on M4 along its LEFT
edge, and obstructs M1-M4 across its whole footprint -- so only M5-M7 may
cross a macro, and every one of those 77 connections has to funnel through the
gap beside it. The original stride was 10.36 um = 8.36 um macro + a 2.00 um
channel. The first ASAP7 run ever to reach detailed routing failed with 16
[ERROR DRT-0255] maze-route errors on exactly those SRAM bus pins
(data_din0/data_dout0/data_gclk).

Stride here is 14.36 um = 8.36 um macro + a 6.00 um channel (3x wider).
Max extent x = 62.44 + 8.36 = 70.80 um, still far inside the 125 um core, so
this costs no die area -- the macros simply spread into space that was already
empty.

NOT the cause, checked first and recorded so they are not re-tried:
  * 24 nm M4 pin width is LEGAL -- ASAP7 M4 LEF58_WIDTHTABLE lists 0.024.
  * Removing the M4 OBS made it WORSE (16 -> 79 DRT-0255): pin access already
    succeeded with the OBS in place (0 DRT-0073/0074), and dropping it just let
    over-macro M4 routing add congestion.
  * GRT_ALLOW_CONGESTION=false changed nothing (identical 16 failures).

2026-09-09 session 2 (bead ocm) -- gen_data_sram[1] X POINT-FIX (35.09 -> 35.10).

Real routing tracks (NOT the tech-LEF PITCH/OFFSET -- LibreLane overrides those via
libs.tech/openlane/asap7sc7p5t_SIMPLE/tracks.info): M5 (vertical, the layer that
vias up from the M4 pins) has X tracks at x = 18 + n*27 DBU. gen_data_sram[1]'s pin
column sat at x=35090, only 1 DBU short of the nearest legal M5 track (35091) --
signed offset -1. Every other data macro in this row (x=20720/49450/63800) sits
5-8 DBU off that same grid and routes cleanly.

THIS WAS TESTED AS A DIRECT CAUSAL EXPERIMENT, not just correlation: using a
standalone OpenROAD session loading the post-GRT checkpoint ODB, gen_data_sram[1]
(both u_icache and u_dcache instances) was moved by dx=-1,+5,+10,+24 DBU with
nothing else in the design touched, and detailed_route rerun on each:
  dx=-1  (x=35089, signed offset -2) -> FAILS.  Identical 16 DRT-0255, same nets,
                                         same routeBoxes as dx=0 (the unmodified
                                         baseline).
  dx=+5  (x=35095, signed offset +4) -> CLEAN. 0 DRT-0255 through 60% completion.
  dx=+10 (x=35100, signed offset +9, ALSO exactly site-grid-aligned: 35100 mod 54
          = 0) -> CLEAN. 0 DRT-0255, 0 general violations through 20% completion
          (the cleanest of the three).
  dx=+24 (x=35114, signed offset -4) -> CLEAN. 0 DRT-0255 through 20% completion --
          narrows the failing window to within +/-2 DBU of the M5 track, not +/-4.
+10 was selected: largest safety margin of the clean points tested, and it lands
exactly on the M4 X cross-grid (site width 0.054 um = 54 DBU) as a side effect.

THIS IS A POINT-FIX, NOT A VALIDATED GENERAL RULE. A positive-control experiment
was run to test whether "small M5-grid offset" is a general, portable predictor:
gen_data_sram[0] (originally x=20720, signed offset -7, always routes cleanly) was
shifted by dx=+6 to x=20726 -- signed offset -1, the exact residue class (mod 27
AND mod 54) that failed at gen_data_sram[1]. It did NOT fail: 0 new DRT-0255 near
its shifted location; the only 16 failures in that run were gen_data_sram[1]'s own,
unchanged, because gen_data_sram[1] was not touched in that experiment. So a small
M5-grid offset is necessary-looking (every failing column across 3 independent
floorplan sweeps had the smallest offset in its row) but NOT sufficient on its own
(an off-grid-matched macro elsewhere does not automatically fail) -- some other,
still-unidentified factor specific to gen_data_sram[1]'s context also has to be
present. Do not generalize this into "keep every macro N DBU off the M4/M5 grid"
without re-deriving and re-testing per instance; only the four X values changed
below are empirically verified, by direct causal test, to be safe for THIS macro
at THIS position in THIS floorplan.

Full record, including the failed positive control: memory/pd/knowledge.md
(UPDATE 2026-09-09 session 2, second entry) and bead ocm.

I-cache
\end{textblock}

\end{record}

\section{\texttt{asap7/gpu/constraints/asap7\_gpu.sdc}}\label{cr:pd:asap7-gpu-sdc}

This section holds dated history that was in a comment of the source file. The text is unchanged. Each line has no leading comment marker and no indentation.

\begin{record}

\subsection*{Header comment}

\begin{textblock}
Target: 500 MHz (2000 ps period). Real post-CTS fmax measured at ~364 MHz
(report_clock_min_period 2744.75 ps, RUN_2026-05-24). 2000 ps gives ~8%
headroom above the post-RTL-fix expected fmax.
\end{textblock}

\end{record}

\section{\texttt{asap7/gpu/macro\_placement\_3014.cfg}}\label{cr:pd:asap7-gpu-macro-placement-3014-cfg}

This section holds dated history that was in a comment of the source file. The text is unchanged. Each line has no leading comment marker and no indentation.

\begin{record}

\subsection*{Header comment}

\begin{textblock}
taken directly from RUN_2026-09-10_09-35-58/05-yosys-synthesis/gpu_top.nl.v.
\end{textblock}

\subsection*{Header comment}

\begin{textblock}
That is what happened on RUN_2026-09-10_09-35-58.
\end{textblock}

\end{record}

\section{\texttt{asap7/pdn\_asap7\_orfs.tcl}}\label{cr:pd:asap7-pdn-orfs-tcl}

This section holds dated history that was in a comment of the source file. The text is unchanged. Each line has no leading comment marker and no indentation.

\begin{record}

\subsection*{Header comment}

\begin{textblock}
WHY THIS FILE EXISTS
--------------------
Every ASAP7 run in this repo up to 2026-09-12 committed ZERO power-grid
shapes.  `pdngen` is `check_setup; build_grids; write_to_db; reset_shapes`,
and the previous topology made `build_grids` abort with
  [ERROR PDN-0179] Unable to repair all channels
*before* `write_to_db` ever ran.  The local warn-and-continue patch in
librelane's `pdn.tcl` swallowed that error, so the flow proceeded with no PDN
and reported it as a "benign tap-cell artifact".  See
`Doc: cr:run:phase5` §"PDN caveat" and `memory/pd/knowledge.md`.

ROOT CAUSE OF PDN-0179
----------------------
The old topology connected the M1 followpin rails DIRECTLY to the M5 straps
(a four-layer stack) and used M2 only as a sparse 4.5 µm-pitch strap running
PARALLEL to those rails.  ASAP7 std-cell rails sit on M1 running horizontally
(M1's non-preferred direction), so most rails had nothing reachable to
connect to, and channel repair could not fix them: 27 unrepairable channels,
all on M1, in the macro-free regions x 82.19–124.96 µm and y 104.19–123.42 µm.

\end{textblock}

\subsection*{Header comment}

\begin{textblock}

MEASURED on the CPU block (`RUN_2026-09-10_05-13-18` step-18 ODB):
  old topology : 0 channels repaired, 0 shapes committed, PSM-0069 on both nets
  this file    : 0 remaining channels, 27 999 VDD / 27 213 VSS shapes,
                 `check_power_grid` PASS on both nets, and
                 [INFO PSM-0040] All shapes on net VDD/VSS are connected.
  IR drop then runs: worst 1.28 mV VDD (0.18 %) / 1.31 mV VSS (0.19 %).

\end{textblock}

\end{record}

\section{\texttt{asap7/soc/constraints/phase5\_soc.sdc}}\label{cr:pd:asap7-soc-phase5-sdc}

This section holds dated history that was in a comment of the source file. The text is unchanged. Each line has no leading comment marker and no indentation.

\begin{record}

\subsection*{Header comment}

\begin{textblock}
Run-13 lesson (2026-06-23):
  The create_generated_clock on the PLL buf Y pin caused CTS to build TWO
  independent clock trees — one for the 3 macro-clk sinks (clk_i tree) and
  one for the 43762 std-cell FF sinks (clk_i_regs H-tree).  The two trees
  are not balanced against each other, producing 214 ps setup skew (and
  -209 ps hold skew).  The create_generated_clock is removed for run 14.
  CLOCK_NET is already "clk_i" which lets CTS see through the PLL buffer
  to the core_clk fanout.  CTS-0011 then builds one tree for all 43762
  sinks under clk_i.  Macro clk pins are balanced along the same tree.

\end{textblock}

\subsection*{Before: if \{[llength \$\_cpu\_in] > 0\} \{}

\begin{textblock}
GH #94 dead-code note: this file previously also declared
  set _cpu_out [get_ports -quiet -filter "name =~ *u_cpu*"]
  set _gpu_out [get_ports -quiet -filter "name =~ *u_gpu*"]
get_ports only ever matches TOP-LEVEL port names, never instance/hierarchy
paths — soc_top has no top-level port containing "u_cpu"/"u_gpu" (those
are instance name prefixes, found via get_pins -hierarchical above, not
get_ports), so both collections were always empty and neither variable was
ever read again below. Confirmed unused (repo-wide grep, 2026-08-02) and
removed: this is a pure dead local-variable assignment with no downstream
reference, so deleting it cannot change any constraint STA applies —
run-14's signed-off timing behaviour is unaffected. (Same bug class as the
CDC-exception silent-miss hardening added to
pnr/constraints/phase5_soc_multiclock.sdc for GH #94 — an empty-collection
query that nothing ever consumed, so it never had a chance to bite here.)
\end{textblock}

\end{record}

\section{\texttt{asap7/soc/constraints/phase5\_soc\_multiclock.sdc}}\label{cr:pd:asap7-soc-phase5-multiclock-sdc}

This section holds dated history that was in a comment of the source file. The text is unchanged. Each line has no leading comment marker and no indentation.

\begin{record}

\subsection*{Header comment}

\begin{textblock}
##############################################################################
STAGED COPY — GH #96 preflight (2026-08-05).
\end{textblock}

\subsection*{Header comment}

\begin{textblock}

GH #94 / bead claude_verilog_test-oa7 (epic #90 -> #91..#96).
GH #96 / bead claude_verilog_test-k07 (2026-08-02): split this file per
OpenTitan precedent after tool-verified evidence that set_max_delay
exceptions on CDC paths are NOT honoured once those paths sit between two
set_clock_groups -asynchronous groups. See section 11-13 header below.

STATUS: authored constraint-only deliverable. NOT yet wired into any
config.json PNR_SDC_FILE/SIGNOFF_SDC_FILE/FALLBACK_SDC_FILE pointer — GH #96
owns the actual re-closure P&R run that will consume this file (or a
reconciled copy of it) as pnr/asap7/soc/constraints/*.sdc's replacement.
Everything below is derived from static RTL/SDC/doc inspection; nothing
here has been exercised by OpenSTA/OpenROAD. See the accompanying report
for the full "what remains unvalidated" list.

\end{textblock}

\subsection*{Before: set\_clock\_groups -name cdc\_boundary -asynchronous \textbackslash{}}

\begin{textblock}
##############################################################################
3. Clock-group relationship — sys_clk and cpu_clk are genuinely asynchronous
   (two independent top-level reference ports, GH #92 — deliberately NOT a
   divided/generated pair; pll_clkgen_stub is a pure passthrough, so two
   PLLs off one reference would be bit-identical, hence a second PORT).
   -asynchronous tells STA there is no fixed phase relationship: ordinary
   setup/hold analysis between the two domains is skipped (would otherwise
   report fabricated violations on every unrelated pair of FFs that happen
   to sit in different domains). This IS needed for real synthesis/P&R —
   do not remove it from this (implementation) file.

   bead claude_verilog_test-k07 (2026-08-02) — TOOL-VERIFIED CORRECTION:
   a prior version of this comment claimed set_max_delay -datapath_only
   overrides in sections 11-13 "OpenSTA honours even though the clock
   groups are otherwise asynchronous." That claim was UNVERIFIED and is
   WRONG on both counts, confirmed with OpenSTA 2.6.0 (both the standalone
   `sta` binary and OpenROAD's embedded STA engine, same STA-0563 error
   code) against a synthetic sky130hd netlist reproducing this exact
   two-clock / set_clock_groups -asynchronous / set_max_delay -through
   topology:
     (a) `-datapath_only` is not an implemented flag of OpenSTA's
         set_max_delay/set_min_delay (see sdc/Sdc.tcl: only -rise -fall
         -ignore_clock_latency -reset_path -comment are recognised).
         read_sdc aborts immediately with "set_max_delay -datapath_only
         is not a known keyword or flag" (STA-0563) the instant it hits
         the first occurrence — every set_max_delay line at and after
         that point (all of sections 11-13, and the section 15 coverage
         gate) NEVER EXECUTES. This is not "masked"; it is a hard parse
         failure that would have aborted read_sdc for this entire file.
     (b) even after removing the illegal flag so the SDC parses, a
         side-by-side comparison (identical set_max_delay -through
         exception, with vs without set_clock_groups -asynchronous
         between the two clocks) shows the exception is NOT applied when
         -asynchronous is present: report_checks -to <the excepted pin>
         returns "No paths found" under normal path_delay queries, and
         only appears under -unconstrained, reported as
         "Path Group: unconstrained" / "(Path is unconstrained)" — i.e.
         OpenSTA drops the max_delay check entirely rather than applying
         it. A further control (set_false_path -from/-to clocks, instead
         of set_clock_groups) reproduces the same result even though the
         set_max_delay exception is -through-qualified and therefore
         "more specific" — confirming the textbook precedence rule
         set_false_path > set_max_delay applies REGARDLESS of exception
         specificity in this tool, not just when tied (matching this
         bead's original hypothesis and the OpenTitan precedent cited
         below).
   CONSEQUENCE: sections 11-13's CDC budgets cannot live in the same file
   as this set_clock_groups -asynchronous declaration and be honoured by
   OpenSTA. Per OpenTitan precedent (hw/top_earlgrey/syn/
   chip_earlgrey_asic_check_only.sdc), those budgets have been MOVED to
   phase5_soc_multiclock_check.sdc, a separate post-route CDC-verification
   SDC that intentionally does NOT declare sys_clk/cpu_clk asynchronous
   (or false-path them) so the set_max_delay budgets are genuinely timed.
   That file is not a substitute for this one at synthesis/P&R time.
##############################################################################
\end{textblock}

\subsection*{Before: set \_cpu\_apb\_in [get\_pins -quiet \{u\_cpu/apb\_paddr\_i[*] u...}

\begin{textblock}
##############################################################################
10a. CPU APB debug read data — false path, matching the CPU macro's OWN
     sign-off contract. Added for GH #96 run 17 after run 16 measured it.

     Section 10 above says: "If a future run finds real single-cycle
     violations on this interface, that is real information the multicycle
     used to hide — do not silently reintroduce the relaxation without
     checking Liberty-vs-Liberty margin at 780 ps first." Run 16
     (RUN_2026-08-06_00-10-40) found exactly such violations, and that
     check was then done. Findings:

     * cpu_clk WNS = -205.34 ps, TNS = -7261.72 ps over 194 violating
       endpoints. 33 of those traverse the CPU macro; the other 161 do not
       and are only at -44.93 ps (those are a genuine synthesis-target
       problem, addressed separately by CLOCK_PERIOD 0.78, NOT here).
     * Every one of the 33 is the same shape: fabric FF -> u_cpu APB
       address input -> a single 800.71 ps combinational arc inside the
       macro -> u_cpu/apb_prdata_o[*] -> fabric FF. One macro-internal arc
       of 800.71 ps cannot fit a 780 ps period; no placement, sizing or
       synthesis knob can change it, because it is fixed in the macro's
       Liberty.
     * Liberty-vs-Liberty check, which is the decisive evidence: the CPU's
       own standalone ASAP7 sign-off at this very period does
           set_false_path -to [get_ports apb_prdata_o[*]]
       (pnr/asap7/cpu/constraints/asap7.sdc:121). The macro was therefore
       NEVER characterized to meet 780 ps on this path. Timing it here
       holds the macro to a constraint its own sign-off explicitly excluded
       — the violation is an artifact of the SoC constraining it more
       tightly than the block, not a real design failure.

     So this is not the old cross-domain de-rating being smuggled back in.
     It is the block-level contract being honoured at the top level, and it
     is deliberately NARROWER than run 14's blanket
     `set_multicycle_path -setup 2 -to *u_cpu/*`: only the APB debug READ
     data path is excepted. Everything else on the u_cpu interface — the
     whole AXI4 master through u_cpu_axi_cdc, the PMU/IRQ synchronised
     signals — stays a normal single-cycle cpu_clk check, so a real
     datapath violation there is still reported.

     Scope note: the APB address/control INPUTS are deliberately NOT
     excepted. The standalone SDC times them (set_input_delay -max 120,
     asap7.sdc:99-112), so they carry a real single-cycle requirement and
     must keep being checked here.

     Safety: APB debug is an infrequent, non-performance config interface
     (same rationale as the top-level apb_* port false paths in section 6),
     and u_apb_dbg_cdc drives it from a REGISTERED, captured address
     (m_paddr_o = cmd_paddr_cap_q, apb_cdc_bridge.sv:648 -- line number as
     of bead claude_verilog_test-rfz's NRZ->RZ conversion) held stable
     across D_SETUP -> D_ACCESS until m_pready_i, i.e. >= 2 cpu_clk cycles.
     The read data is likewise captured only on m_pready_i.
##############################################################################
     -through, NOT -from/-to. At block level apb_prdata_o is a PORT and
     therefore a path ENDPOINT, so the standalone SDC writes
     `set_false_path -to`. At SoC level the same physical path does not end
     there: it starts at a fabric flop, enters the macro at an APB address
     input, crosses the 800.71 ps combinational in->out arc, exits at
     apb_prdata_o and continues to a fabric flop. The macro pin is a
     THROUGH point. Measured on run 16's routed netlist, re-timed with its
     own final/sdc so the constraint is the only variable:
         -from  : cpu_clk WNS -205.34 ps, 194 violators  (NO EFFECT — the
                  pin is not a startpoint, so nothing matched)
         -through: cpu_clk WNS  -44.93 ps, 162 violators, TNS -7261.72 ->
                  -1756.83, achieved 1014.88 -> 1212.23 MHz
     sys_clk was byte-identical (+106.217033 ps, 0 violators) in both,
     confirming the exception is confined to the CPU domain.
##############################################################################
RETIRED 2026-08-07 (bead cyb fixed at the source). apb_prdata_o is now a
REGISTERED output of the CPU macro: the regenerated Liberty
(pnr/asap7/cpu/macro/rv32i_cpu_top__nom_tt_025C_0p7V.lib) reports
apb_prdata_o[*] as related_pin clk_i with timing_type rising_edge, where it
previously carried a combinational arc from apb_paddr_i[9..11]/apb_psel_i/
apb_pwrite_i. The 800.71 ps arc this exception existed to excuse no longer
exists, so the exception is removed rather than left to hide a future
regression. If cpu_clk setup regresses on the macro APB pins, do NOT simply
restore this -- re-check the Liberty first, because a reappearing
combinational arc would mean the macro abstract went stale again.

set_false_path -through [get_pins u_cpu/apb_prdata_o[*]]   <-- retired

##############################################################################
10b. CPU macro APB INPUT multicycle — mirrors the CPU block's OWN sign-off
     constraint. Added 2026-08-07 after run 20 measured the consequence of
     omitting it.

     WHAT MOVED. Registering apb_prdata_o (bead cyb) did NOT delete the APB
     read mux; it RELOCATED where STA charges it. Before, the mux appeared in
     the macro abstract as an ~800 ps COMBINATIONAL in->out arc, excused by
     section 10a (now retired). After, the same logic appears as an INPUT
     SETUP REQUIREMENT: the regenerated Liberty reports 876.85 ps of library
     setup on u_cpu/apb_psel_i. Run 20 (no exception) therefore measured
     cpu_clk WNS -350.05 ps over 15 violating endpoints, and every one of
     those 15 ends at a macro APB input pin (apb_psel_i, apb_paddr_i[*],
     apb_pwrite_i) — not one is a datapath failure.

     WHY THIS IS CONTRACT-MIRRORING, NOT VIOLATION-HIDING. The CPU block has
     always signed off this interface with exactly this relaxation:
         pnr/asap7/cpu/constraints/asap7.sdc:183-184
         set_multicycle_path -setup 3 -from [get_ports {apb_paddr_i[*] ...}]
         set_multicycle_path -hold  2 -from [get_ports {apb_paddr_i[*] ...}]
     under the header "APB multicycle — PREADY stretches for 2-cycle APB
     handshake". Block-level STA confirms it: the worst apb_psel_i path has a
     data-required time of 2480 ps (~3x780), and closes with +1328 ps. The
     SoC was simply never mirroring that contract on the input side, because
     until now the same logic reached it in output-arc form instead.

     WHY IT IS SOUNDER NOW THAN IT WAS BEFORE. The protocol genuinely takes
     more than one cycle: rv32i_cpu_top now inserts an APB3 wait state on
     reads (apb_pready_o = apb_pwrite_i ? 1'b1 : apb_read_wait_q), and the
     driving master holds the command stable for the whole transfer —
     u_apb_dbg_cdc drives m_paddr_o from the REGISTERED cmd_paddr_cap_q
     (apb_cdc_bridge.sv:648) and stays in D_ACCESS until m_pready_i. So the
     3-cycle setup / 2-cycle hold window is one the hardware actually
     provides, rather than an assertion about an infrequent path.

     Measured effect on run 20's routed netlist, constraint as the only
     variable: cpu_clk WNS -350.05 -> -60.66 ps, TNS -2406.71 -> -60.66,
     violating endpoints 15 -> 1, achieved 884.92 -> 1189.54 MHz. sys_clk
     byte-identical at +83.789642 ps, confirming CPU-domain-only scope.
##############################################################################
     TCL GOTCHA (cost one wasted 5 h run, 2026-08-08): the pattern list below
     MUST stay on a single line. A "\" line-continuation inside {braces} is
     NOT a continuation — Tcl takes the backslash and newline literally, the
     pattern matches nothing, and a `if {[llength ...] > 0}` guard then skips
     the constraint in SILENCE. Run 21 was byte-identical to run 20 because of
     exactly that. Hence the hard error below rather than a soft guard: an
     exception that cannot bind must stop the flow, not quietly vanish.
\end{textblock}

\subsection*{Before: set\_false\_path -hold -from [all\_inputs]}

\begin{textblock}
##############################################################################
Sections 11-13 (async_axi_fifo gray-pointer/mem_q crossings, apb_cdc_bridge
CDC (u_apb_pll2_cdc + u_apb_dbg_cdc), PMU/IRQ single-bit crossings into
cpu_core_clk) MOVED to phase5_soc_multiclock_check.sdc.

bead claude_verilog_test-k07 (2026-08-02): those set_max_delay exceptions
cannot be honoured by OpenSTA in the same file as section 3's
set_clock_groups -asynchronous (see section 3's header note above for the
tool-verified evidence — a literal OpenSTA/OpenROAD read_sdc parse abort
from the unsupported -datapath_only flag, and a proven "set_false_path
beats set_max_delay regardless of -through specificity" precedence result
even after that flag is removed). This file keeps set_clock_groups
-asynchronous because it is still correct and necessary for real
synthesis/P&R (suppresses fabricated setup/hold checks between the two
genuinely-unrelated clock domains) — it simply can no longer also carry
the CDC budget exceptions. phase5_soc_multiclock_check.sdc carries them,
deliberately WITHOUT any clock-group/false-path declaration between
sys_clk and cpu_clk, so the set_max_delay budgets are genuinely timed by
OpenSTA when read against a post-route netlist for targeted
report_checks -to/-through CDC-path queries (OpenTitan precedent:
hw/top_earlgrey/syn/chip_earlgrey_asic_check_only.sdc). GH #96 owns
wiring both files into the actual re-closure P&R + post-route check run;
pnr/scripts/check_cdc_timing.tcl + `make check-cdc-timing-asap7-soc`
(pnr/Makefile) is the invocation point once a routed netlist with the
CDC modules exists.
##############################################################################
\end{textblock}

\end{record}

\section{\texttt{asap7/soc/pdn\_orfs.tcl}}\label{cr:pd:asap7-soc-pdn-orfs-tcl}

This section holds dated history that was in a comment of the source file. The text is unchanged. Each line has no leading comment marker and no indentation.

\begin{record}

\subsection*{Header comment}

\begin{textblock}
Verified 2026-09-12 on run 23's step-15 ODB with the standalone harness:
  0 remaining channels, 372 594 VDD / 373 316 VSS shapes,
  check_power_grid PASS on both nets, 0 unconnected shapes and instances.

\end{textblock}

\end{record}

\section{\texttt{constraints/phase1\_cpu\_enhanced.sdc}}\label{cr:pd:phase1-cpu-enhanced-sdc}

This section holds dated history that was in a comment of the source file. The text is unchanged. Each line has no leading comment marker and no indentation.

\begin{record}

\subsection*{End of file}

\begin{textblock}
---------------------------------------------
End of SDC
---------------------------------------------
Generated for Phase 1 RV32I CPU
Last updated: 2026-01-22
\end{textblock}

\end{record}

\section{\texttt{constraints/phase1\_cpu\_post\_cts.sdc}}\label{cr:pd:phase1-cpu-post-cts-sdc}

This section holds dated history that was in a comment of the source file. The text is unchanged. Each line has no leading comment marker and no indentation.

\begin{record}

\subsection*{End of file}

\begin{textblock}
---------------------------------------------
End of Post-CTS SDC
---------------------------------------------
Generated for Phase 1 RV32I CPU
Use this file after clock tree synthesis
Last updated: 2026-01-22
\end{textblock}

\end{record}

\section{\texttt{constraints/phase5\_soc.upf}}\label{cr:pd:phase5-soc-upf}

This section holds dated history that was in a comment of the source file. The text is unchanged. Each line has no leading comment marker and no indentation.

\begin{record}

\subsection*{Header comment}

\begin{textblock}
Rewritten 2026-10-17 (bead h3lm).  The previous revision named isolation
nets (cpu_iso_en, gpu_iso_en) and switch control ports (cpu_pg_ctrl,
gpu_pg_ctrl) that do not exist in soc_top, isolated every output where the
RTL clamps a handful of handshakes, used create_power_switch options no UPF
parser accepts, and passed a domain name where a supply set is required.

\end{textblock}

\end{record}

\section{\texttt{constraints/phase5\_soc\_multiclock.sdc}}\label{cr:pd:phase5-soc-multiclock-sdc}

This section holds dated history that was in a comment of the source file. The text is unchanged. Each line has no leading comment marker and no indentation.

\begin{record}

\subsection*{Header comment}

\begin{textblock}

GH #94 / bead claude_verilog_test-oa7 (epic #90 -> #91..#96).
GH #96 / bead claude_verilog_test-k07 (2026-08-02): split this file per
OpenTitan precedent after tool-verified evidence that set_max_delay
exceptions on CDC paths are NOT honoured once those paths sit between two
set_clock_groups -asynchronous groups. See section 11-13 header below.

STATUS: authored constraint-only deliverable. NOT yet wired into any
config.json PNR_SDC_FILE/SIGNOFF_SDC_FILE/FALLBACK_SDC_FILE pointer — GH #96
owns the actual re-closure P&R run that will consume this file (or a
reconciled copy of it) as pnr/asap7/soc/constraints/*.sdc's replacement.
Everything below is derived from static RTL/SDC/doc inspection; nothing
here has been exercised by OpenSTA/OpenROAD. See the accompanying report
for the full "what remains unvalidated" list.

\end{textblock}

\subsection*{Before: set\_clock\_groups -name cdc\_boundary -asynchronous \textbackslash{}}

\begin{textblock}
##############################################################################
3. Clock-group relationship — sys_clk and cpu_clk are genuinely asynchronous
   (two independent top-level reference ports, GH #92 — deliberately NOT a
   divided/generated pair; pll_clkgen_stub is a pure passthrough, so two
   PLLs off one reference would be bit-identical, hence a second PORT).
   -asynchronous tells STA there is no fixed phase relationship: ordinary
   setup/hold analysis between the two domains is skipped (would otherwise
   report fabricated violations on every unrelated pair of FFs that happen
   to sit in different domains). This IS needed for real synthesis/P&R —
   do not remove it from this (implementation) file.

   bead claude_verilog_test-k07 (2026-08-02) — TOOL-VERIFIED CORRECTION:
   a prior version of this comment claimed set_max_delay -datapath_only
   overrides in sections 11-13 "OpenSTA honours even though the clock
   groups are otherwise asynchronous." That claim was UNVERIFIED and is
   WRONG on both counts, confirmed with OpenSTA 2.6.0 (both the standalone
   `sta` binary and OpenROAD's embedded STA engine, same STA-0563 error
   code) against a synthetic sky130hd netlist reproducing this exact
   two-clock / set_clock_groups -asynchronous / set_max_delay -through
   topology:
     (a) `-datapath_only` is not an implemented flag of OpenSTA's
         set_max_delay/set_min_delay (see sdc/Sdc.tcl: only -rise -fall
         -ignore_clock_latency -reset_path -comment are recognised).
         read_sdc aborts immediately with "set_max_delay -datapath_only
         is not a known keyword or flag" (STA-0563) the instant it hits
         the first occurrence — every set_max_delay line at and after
         that point (all of sections 11-13, and the section 15 coverage
         gate) NEVER EXECUTES. This is not "masked"; it is a hard parse
         failure that would have aborted read_sdc for this entire file.
     (b) even after removing the illegal flag so the SDC parses, a
         side-by-side comparison (identical set_max_delay -through
         exception, with vs without set_clock_groups -asynchronous
         between the two clocks) shows the exception is NOT applied when
         -asynchronous is present: report_checks -to <the excepted pin>
         returns "No paths found" under normal path_delay queries, and
         only appears under -unconstrained, reported as
         "Path Group: unconstrained" / "(Path is unconstrained)" — i.e.
         OpenSTA drops the max_delay check entirely rather than applying
         it. A further control (set_false_path -from/-to clocks, instead
         of set_clock_groups) reproduces the same result even though the
         set_max_delay exception is -through-qualified and therefore
         "more specific" — confirming the textbook precedence rule
         set_false_path > set_max_delay applies REGARDLESS of exception
         specificity in this tool, not just when tied (matching this
         bead's original hypothesis and the OpenTitan precedent cited
         below).
   CONSEQUENCE: sections 11-13's CDC budgets cannot live in the same file
   as this set_clock_groups -asynchronous declaration and be honoured by
   OpenSTA. Per OpenTitan precedent (hw/top_earlgrey/syn/
   chip_earlgrey_asic_check_only.sdc), those budgets have been MOVED to
   phase5_soc_multiclock_check.sdc, a separate post-route CDC-verification
   SDC that intentionally does NOT declare sys_clk/cpu_clk asynchronous
   (or false-path them) so the set_max_delay budgets are genuinely timed.
   That file is not a substitute for this one at synthesis/P&R time.
##############################################################################
\end{textblock}

\subsection*{Before: set \_cpu\_apb\_in [get\_pins -quiet \{u\_cpu/apb\_paddr\_i[*] u...}

\begin{textblock}
##############################################################################
10a. CPU APB debug read data — false path, matching the CPU macro's OWN
     sign-off contract. Added for GH #96 run 17 after run 16 measured it.

     Section 10 above says: "If a future run finds real single-cycle
     violations on this interface, that is real information the multicycle
     used to hide — do not silently reintroduce the relaxation without
     checking Liberty-vs-Liberty margin at 780 ps first." Run 16
     (RUN_2026-08-06_00-10-40) found exactly such violations, and that
     check was then done. Findings:

     * cpu_clk WNS = -205.34 ps, TNS = -7261.72 ps over 194 violating
       endpoints. 33 of those traverse the CPU macro; the other 161 do not
       and are only at -44.93 ps (those are a genuine synthesis-target
       problem, addressed separately by CLOCK_PERIOD 0.78, NOT here).
     * Every one of the 33 is the same shape: fabric FF -> u_cpu APB
       address input -> a single 800.71 ps combinational arc inside the
       macro -> u_cpu/apb_prdata_o[*] -> fabric FF. One macro-internal arc
       of 800.71 ps cannot fit a 780 ps period; no placement, sizing or
       synthesis knob can change it, because it is fixed in the macro's
       Liberty.
     * Liberty-vs-Liberty check, which is the decisive evidence: the CPU's
       own standalone ASAP7 sign-off at this very period does
           set_false_path -to [get_ports apb_prdata_o[*]]
       (pnr/asap7/cpu/constraints/asap7.sdc:121). The macro was therefore
       NEVER characterized to meet 780 ps on this path. Timing it here
       holds the macro to a constraint its own sign-off explicitly excluded
       — the violation is an artifact of the SoC constraining it more
       tightly than the block, not a real design failure.

     So this is not the old cross-domain de-rating being smuggled back in.
     It is the block-level contract being honoured at the top level, and it
     is deliberately NARROWER than run 14's blanket
     `set_multicycle_path -setup 2 -to *u_cpu/*`: only the APB debug READ
     data path is excepted. Everything else on the u_cpu interface — the
     whole AXI4 master through u_cpu_axi_cdc, the PMU/IRQ synchronised
     signals — stays a normal single-cycle cpu_clk check, so a real
     datapath violation there is still reported.

     Scope note: the APB address/control INPUTS are deliberately NOT
     excepted. The standalone SDC times them (set_input_delay -max 120,
     asap7.sdc:99-112), so they carry a real single-cycle requirement and
     must keep being checked here.

     Safety: APB debug is an infrequent, non-performance config interface
     (same rationale as the top-level apb_* port false paths in section 6),
     and u_apb_dbg_cdc drives it from a REGISTERED, captured address
     (m_paddr_o = cmd_paddr_cap_q, apb_cdc_bridge.sv:648 -- line number as
     of bead claude_verilog_test-rfz's NRZ->RZ conversion) held stable
     across D_SETUP -> D_ACCESS until m_pready_i, i.e. >= 2 cpu_clk cycles.
     The read data is likewise captured only on m_pready_i.
##############################################################################
     -through, NOT -from/-to. At block level apb_prdata_o is a PORT and
     therefore a path ENDPOINT, so the standalone SDC writes
     `set_false_path -to`. At SoC level the same physical path does not end
     there: it starts at a fabric flop, enters the macro at an APB address
     input, crosses the 800.71 ps combinational in->out arc, exits at
     apb_prdata_o and continues to a fabric flop. The macro pin is a
     THROUGH point. Measured on run 16's routed netlist, re-timed with its
     own final/sdc so the constraint is the only variable:
         -from  : cpu_clk WNS -205.34 ps, 194 violators  (NO EFFECT — the
                  pin is not a startpoint, so nothing matched)
         -through: cpu_clk WNS  -44.93 ps, 162 violators, TNS -7261.72 ->
                  -1756.83, achieved 1014.88 -> 1212.23 MHz
     sys_clk was byte-identical (+106.217033 ps, 0 violators) in both,
     confirming the exception is confined to the CPU domain.
##############################################################################
RETIRED 2026-08-07 (bead cyb fixed at the source). apb_prdata_o is now a
REGISTERED output of the CPU macro: the regenerated Liberty
(pnr/asap7/cpu/macro/rv32i_cpu_top__nom_tt_025C_0p7V.lib) reports
apb_prdata_o[*] as related_pin clk_i with timing_type rising_edge, where it
previously carried a combinational arc from apb_paddr_i[9..11]/apb_psel_i/
apb_pwrite_i. The 800.71 ps arc this exception existed to excuse no longer
exists, so the exception is removed rather than left to hide a future
regression. If cpu_clk setup regresses on the macro APB pins, do NOT simply
restore this -- re-check the Liberty first, because a reappearing
combinational arc would mean the macro abstract went stale again.

set_false_path -through [get_pins u_cpu/apb_prdata_o[*]]   <-- retired

##############################################################################
10b. CPU macro APB INPUT multicycle — mirrors the CPU block's OWN sign-off
     constraint. Added 2026-08-07 after run 20 measured the consequence of
     omitting it.

     WHAT MOVED. Registering apb_prdata_o (bead cyb) did NOT delete the APB
     read mux; it RELOCATED where STA charges it. Before, the mux appeared in
     the macro abstract as an ~800 ps COMBINATIONAL in->out arc, excused by
     section 10a (now retired). After, the same logic appears as an INPUT
     SETUP REQUIREMENT: the regenerated Liberty reports 876.85 ps of library
     setup on u_cpu/apb_psel_i. Run 20 (no exception) therefore measured
     cpu_clk WNS -350.05 ps over 15 violating endpoints, and every one of
     those 15 ends at a macro APB input pin (apb_psel_i, apb_paddr_i[*],
     apb_pwrite_i) — not one is a datapath failure.

     WHY THIS IS CONTRACT-MIRRORING, NOT VIOLATION-HIDING. The CPU block has
     always signed off this interface with exactly this relaxation:
         pnr/asap7/cpu/constraints/asap7.sdc:183-184
         set_multicycle_path -setup 3 -from [get_ports {apb_paddr_i[*] ...}]
         set_multicycle_path -hold  2 -from [get_ports {apb_paddr_i[*] ...}]
     under the header "APB multicycle — PREADY stretches for 2-cycle APB
     handshake". Block-level STA confirms it: the worst apb_psel_i path has a
     data-required time of 2480 ps (~3x780), and closes with +1328 ps. The
     SoC was simply never mirroring that contract on the input side, because
     until now the same logic reached it in output-arc form instead.

     WHY IT IS SOUNDER NOW THAN IT WAS BEFORE. The protocol genuinely takes
     more than one cycle: rv32i_cpu_top now inserts an APB3 wait state on
     reads (apb_pready_o = apb_pwrite_i ? 1'b1 : apb_read_wait_q), and the
     driving master holds the command stable for the whole transfer —
     u_apb_dbg_cdc drives m_paddr_o from the REGISTERED cmd_paddr_cap_q
     (apb_cdc_bridge.sv:648) and stays in D_ACCESS until m_pready_i. So the
     3-cycle setup / 2-cycle hold window is one the hardware actually
     provides, rather than an assertion about an infrequent path.

     Measured effect on run 20's routed netlist, constraint as the only
     variable: cpu_clk WNS -350.05 -> -60.66 ps, TNS -2406.71 -> -60.66,
     violating endpoints 15 -> 1, achieved 884.92 -> 1189.54 MHz. sys_clk
     byte-identical at +83.789642 ps, confirming CPU-domain-only scope.
##############################################################################
     TCL GOTCHA (cost one wasted 5 h run, 2026-08-08): the pattern list below
     MUST stay on a single line. A "\" line-continuation inside {braces} is
     NOT a continuation — Tcl takes the backslash and newline literally, the
     pattern matches nothing, and a `if {[llength ...] > 0}` guard then skips
     the constraint in SILENCE. Run 21 was byte-identical to run 20 because of
     exactly that. Hence the hard error below rather than a soft guard: an
     exception that cannot bind must stop the flow, not quietly vanish.
\end{textblock}

\subsection*{Before: set\_false\_path -hold -from [all\_inputs]}

\begin{textblock}
##############################################################################
Sections 11-13 (async_axi_fifo gray-pointer/mem_q crossings, apb_cdc_bridge
CDC (u_apb_pll2_cdc + u_apb_dbg_cdc), PMU/IRQ single-bit crossings into
cpu_core_clk) MOVED to phase5_soc_multiclock_check.sdc.

bead claude_verilog_test-k07 (2026-08-02): those set_max_delay exceptions
cannot be honoured by OpenSTA in the same file as section 3's
set_clock_groups -asynchronous (see section 3's header note above for the
tool-verified evidence — a literal OpenSTA/OpenROAD read_sdc parse abort
from the unsupported -datapath_only flag, and a proven "set_false_path
beats set_max_delay regardless of -through specificity" precedence result
even after that flag is removed). This file keeps set_clock_groups
-asynchronous because it is still correct and necessary for real
synthesis/P&R (suppresses fabricated setup/hold checks between the two
genuinely-unrelated clock domains) — it simply can no longer also carry
the CDC budget exceptions. phase5_soc_multiclock_check.sdc carries them,
deliberately WITHOUT any clock-group/false-path declaration between
sys_clk and cpu_clk, so the set_max_delay budgets are genuinely timed by
OpenSTA when read against a post-route netlist for targeted
report_checks -to/-through CDC-path queries (OpenTitan precedent:
hw/top_earlgrey/syn/chip_earlgrey_asic_check_only.sdc). GH #96 owns
wiring both files into the actual re-closure P&R + post-route check run;
pnr/scripts/check_cdc_timing.tcl + `make check-cdc-timing-asap7-soc`
(pnr/Makefile) is the invocation point once a routed netlist with the
CDC modules exists.
##############################################################################
\end{textblock}

\end{record}

\section{\texttt{constraints/phase5\_soc\_multiclock\_check.sdc}}\label{cr:pd:phase5-soc-multiclock-check-sdc}

This section holds dated history that was in a comment of the source file. The text is unchanged. Each line has no leading comment marker and no indentation.

\begin{record}

\subsection*{Header comment}

\begin{textblock}

bead claude_verilog_test-k07 (2026-08-02), GH #96 (epic #90 -> #91..#96).
Re-bound to the flattened netlist under bead claude_verilog_test-7l5
(2026-08-06, GH #96 / bead claude_verilog_test-8nz) — see section "OBJECT
RESOLUTION" below for the full, tool-verified writeup of why every
exception in this file had to change shape, not just separator.

Sections 12/12a updated under bead claude_verilog_test-rfz (2026-08-12):
apb_cdc_bridge.sv converted from a 2-phase NRZ toggle handshake to a
4-phase RZ handshake; req_toggle_q/ack_toggle_q renamed to req_q/ack_q.
Only the `-filter {name =~ ...}` patterns and description strings changed
(same electrical role, same object-mapping methodology) — this is
precisely the "stale name pattern silently matches zero objects" hazard
bead 7l5 warns about in OBJECT RESOLUTION item 3, so it is called out here
too, not just at the two touched sections.

\end{textblock}

\subsection*{Header comment}

\begin{textblock}

=============================================================================
OBJECT RESOLUTION ON A FLATTENED NETLIST (bead 7l5, 2026-08-06)
=============================================================================
pnr/asap7/soc/config_multiclock.json sets SYNTH_HIERARCHY_MODE=flatten.
This has two consequences that made every exception below match an EMPTY
collection until this rewrite (tool-verified against
final/nl/soc_top.nl.v, RUN_2026-08-06_09-44-51):

  (1) SEPARATOR: hierarchy is preserved only as literal '.' characters
      baked into escaped Verilog identifiers (e.g.
      `\u_cpu_axi_cdc.u_aw_fifo.u_wr_ptr_to_rd.d_i[0] `), not as real
      instance nesting. The OLD file used '/' — 0 matches, always.

  (2) CELLS ARE ANONYMOUS: technology mapping renames every cell to a
      number (`_419265_`); RTL instance/port names (u_wr_ptr_to_rd, q_o,
      rst_n_i, ...) do not survive on cells or pins AT ALL. get_cells and
      get_pins hierarchical name patterns therefore always return empty on
      this netlist, regardless of separator. Only get_nets can match, and
      only nets that kept a clean RTL-derived name.

  (3) A THIRD, UNDOCUMENTED FAILURE MODE, discovered by this rewrite:
      OpenSTA's `get_nets -hierarchical -filter "name =~ <pattern>"` does
      NOT treat a literal '.' inside <pattern> as an ordinary glob
      character once wildcards surround it. Tool-verified: with
      liberty+netlist loaded from this run,
        `-filter {name =~ *u_aw_fifo*}`                 -> 22 nets (works)
        `-filter {name =~ *u_aw_fifo.u_wr_ptr_to_rd*}`   -> 0 nets (breaks)
        `-filter {name =~ *.d_i*}`                       -> 231528 nets
                                                             (matches
                                                             almost the
                                                             whole design)
      i.e. a literal '.' inside the pattern is NOT a safe glob character
      here — neither escaping it (`\.`), bracket-escaping it (`[.]`), nor
      matching it with `?` recovers a correct match; the filter engine
      silently mis-parses the expression instead of erroring. THE FIX:
      every filter pattern in this file uses ONLY '*'-joined, dot-free
      tokens (e.g. `*u_cpu_axi_cdc*u_aw_fifo*u_wr_ptr_to_rd*d_i*`) — pure
      substring-presence matching, verified to return exactly the
      expected object set for every pattern below (see bead 7l5 session
      notes for the full battery of `sta` probes this was derived from).
      DO NOT put a literal '.' back into any `-filter "name =~ ..."`
      pattern in this file without re-verifying it against a real routed
      netlist first.

  (4) SEMANTICS: the pre-existing exceptions ALSO targeted the wrong
      point even where they did resolve. `u_wr_ptr_to_rd/q_o` /
      `u_ack_sync/q_o` / etc. are the OUTPUT of the synchroniser's LAST
      flop — a path lying entirely inside the DESTINATION domain (see
      rtl/soc/cdc/cdc_sync.sv: `assign q_o = sync_q[STAGES-1];`).
      The real clock-domain crossing is the SOURCE register -> the
      synchroniser's FIRST flop D input (`sync_q[0] <= d_i;`). Every
      exception below has been re-pointed at that launch->first-capture
      segment: `d_i` where it survives as its own net (some d_i ports
      collapse into their driving net's name during optimisation instead
      — verified case by case below), or the source register net
      directly (`rd_gray_q`, `req_q`, `ext_irq`, ...) where it
      does not.

  (5) mem_q AND the apb_cdc_bridge cmd_*/resp_* payload capture registers
      are UNMATCHABLE BY NAME on this netlist — 0 occurrences anywhere in
      final/nl/soc_top.nl.v, confirmed by grep as well as by OpenSTA. This
      is not a pattern bug: `assign rd_data_o = mem_q[rd_bin_q[...]];`-
      style muxed array reads and the FSM-gated `cmd_paddr_cap_q <=
      cmd_paddr_q;` capture do not survive optimisation as identifiable
      nets the way a straight passthrough (`req_q`, `ext_irq`, ...)
      does. Section 10 below (declared BEFORE sections 11-13 -- see its
      PRECEDENCE note for why) replaces all of these with a domain-wide
      max_delay fallback instead of a per-signal exception.

  (6) PRECEDENCE (measured, not assumed, two rounds): with both a narrow
      `set_max_delay <n> -through <net>` AND a broad
      `set_max_delay <m> -from [all_registers -clock A] -to
      [all_registers -clock B]` applicable to the SAME path, OpenSTA
      ALWAYS applies the -from/-to exception's value, REGARDLESS of
      declaration order (tested both orders) and regardless of how much
      narrower the -through net list is. A -through exception is
      silently dominated by any -from/-to exception that also reaches the
      same path -- this is why every per-crossing exception below is
      expressed as `-from <cell(s)> -to <cell(s)>` rather than `-through
      <net>`.
      Between TWO overlapping -from/-to exceptions, precedence was
      measured to be DECLARATION ORDER, not specificity: whichever is
      declared LAST wins, even when it is the broad `all_registers`-based
      one. This is why section 10 (the domain-wide fallback) is declared
      BEFORE sections 11-13 in this file, not after — see section 10's
      own header for the full write-up of this (two-round) measurement.

  (7) -from/-to CELL DERIVATION MUST TRACE THROUGH LOGIC, NOT JUST THE
      MATCHED NET'S IMMEDIATE PINS (bead 7l5, second pass): the naive
      `get_cells -of_objects [get_pins -of_objects $net -filter
      {direction == output}]` looked correct (non-empty, cdc_require_match
      passed) but was WRONG for req_q (named req_toggle_q before bead
      claude_verilog_test-rfz's NRZ->RZ rename): the matched net's immediate
      driver was an INVxp67 polarity inverter, not the real source
      register (the ASAP7 flop cells used here only expose an inverted Q
      (QN); synthesis inserts an inverter even for a "direct RTL
      passthrough" signal). A combinational cell is not a valid -from
      startpoint, so that exception silently never applied -- every
      crossing's REPORTED max_delay was still the section-10 fallback,
      even though cdc_require_match reported success. Caught only by
      reviewing the .rpt files' actual applied max_delay value against
      the value each section intended (Definition of Done item 3), not by
      the empty-collection guard. Fixed with `get_fanin`/`get_fanout`
      (`-startpoints_only`/`-endpoints_only -flat -only_cells`), which
      trace THROUGH intervening combinational logic to the real register
      cells — see cdc_net_from_to below. Lesson: a non-empty
      cdc_require_match result proves the NAME pattern matched something;
      it does not prove the resulting -from/-to exception is electrically
      correct or was actually applied. Always cross-check the .rpt files'
      max_delay column against the intended per-section value after
      touching this file.
##############################################################################

##############################################################################
1. Primary clocks (verbatim copy of phase5_soc_multiclock.sdc section 1)
##############################################################################
\end{textblock}

\subsection*{Before: set ::cdc\_regs\_by\_clock [dict create]}

\begin{textblock}

NOT simply the matched net's immediate driver/load cell (bead 7l5,
second-pass fix, 2026-08-06): a first attempt used
`get_cells -of_objects [get_pins -of_objects $netc -filter {direction ==
output}]` for -from directly. That is WRONG whenever technology mapping
inserted a buffer/inverter between the true source register and the
matched net -- tool-verified this happens even for a "direct RTL
passthrough" signal (e.g. req_q's matched net is actually driven
by an INVxp67 polarity inverter, itself fed by the real source flop's QN
output; the ASAP7 flop cells used here (DFFASRHQNx1) only expose an
inverted Q). Using the inverter cell as `-from` produced a -from/-to
exception that OpenSTA silently never applies (the inverter is not a
valid path startpoint), so the exception appeared to succeed
(cdc_require_match saw a non-empty collection) but had NO EFFECT --
every crossing's reported max_delay silently fell back to section 10's
domain-wide budget instead. Caught by budget-verdict review (Definition
of Done item 3: verdicts must be reported and checked, not just "did the
exception match"), not by cdc_require_match, which is why this comment
is here: cdc_require_match/cdc_apply_max_delay's emptiness guard cannot
by itself prove an exception PRODUCED the intended constraint. Fixed
using get_fanin/get_fanout (-flat -only_cells, tracing THROUGH any
intervening combinational logic to the real register), not
-of_objects (one hop only):
cdc_regs_on_clock / cdc_filter_by_clock: THIRD-PASS fix (bead 7l5,
2026-08-06). get_fanin/get_fanout (above) fixed the "wrong immediate pin"
bug but exposed a further one: -flat fanin/fanout tracing can walk INTO a
buffer/gate that is SHARED between the intended crossing and a completely
unrelated net (confirmed case: u_cpu_axi_cdc.u_r_fifo's wr_gray_q[3]
driver pin fans out to its real cpu_clk-domain sync destination AND to
two more cells still sitting in the SOURCE (sys_clk) domain -- almost
certainly synthesis-level buffer/logic sharing, not anything meaningful
in the RTL, since cdc_gray_fifo.sv gives wr_gray_q exactly one consumer).
Passing a -to collection that mixes the correct cpu_clk endpoint with
spurious sys_clk-domain cells made OpenSTA silently refuse the WHOLE
`-from/-to` exception (it fell back to the section-10 domain-wide
fallback for that bit, or -- for later runs -- to no exception at all,
i.e. the raw beat-period alignment check the file header warns is
fabricated noise). Fix: filter the fanin/fanout result down to cells that
are ACTUALLY clocked by the direction's own expected launch/capture
clock, using `all_registers -clock <name>` (name-set membership, cached
per clock so repeated calls don't re-walk the whole register list).
\end{textblock}

\subsection*{Before: proc cdc\_net\_from\_to \{onenet from\_clk to\_clk\} \{}

\begin{textblock}
cdc_net_from_to: given ONE net that sits somewhere on a synchroniser's
launch->first-capture path, plus the launch/capture clock names the
design intends for that crossing, return {startpoint_cells
endpoint_cells} suitable for `set_max_delay -from -to`. Called per-bit
(never on a whole multi-bit collection at once -- see cdc_apply_max_delay)
so a bus never mixes one bit's cells into another's exception.

NOT simply the matched net's immediate driver/load cell (bead 7l5,
second-pass fix, 2026-08-06): a first attempt used
`get_cells -of_objects [get_pins -of_objects $netc -filter {direction ==
output}]` for -from directly. That is WRONG whenever technology mapping
inserted a buffer/inverter between the true source register and the
matched net -- tool-verified this happens even for a "direct RTL
passthrough" signal (e.g. req_q's matched net is actually driven
by an INVxp67 polarity inverter, itself fed by the real source flop's QN
output; the ASAP7 flop cells used here (DFFASRHQNx1) only expose an
inverted Q). Using the inverter cell as `-from` produced a -from/-to
exception that OpenSTA silently never applies (the inverter is not a
valid path startpoint), so the exception appeared to succeed
(cdc_require_match saw a non-empty collection) but had NO EFFECT --
every crossing's reported max_delay silently fell back to section 10's
domain-wide budget instead. Fixed using get_fanin/get_fanout (-flat
-only_cells, tracing THROUGH intervening combinational logic to the real
register) instead of a one-hop -of_objects lookup. That fix in turn
exposed the buffer-SHARING issue cdc_regs_on_clock/cdc_filter_by_clock
above fix (third pass). Lesson standing after both passes: a non-empty
cdc_require_match result proves the NAME pattern matched something; it
does not prove the resulting -from/-to exception is electrically correct
or was actually applied -- always cross-check the .rpt files' max_delay
column against the intended per-section value after touching this file.
\end{textblock}

\subsection*{Before: proc cdc\_capture\_flop\_d\_pins \{substr\_list from\_clk to\_cl...}

\begin{textblock}
##############################################################################
CAPTURE-FLOP D-PIN FALLBACK (bead je8, 2026-09-15)

Sections 11/13 below match a synchroniser's `d_i` PORT net by name
(`*<instance>*d_i*`). Under SYNTH_HIERARCHY_MODE=flatten (run 23 and
every prior CDC-closure netlist), that net keeps a clean RTL-derived
name. Under SYNTH_HIERARCHY_MODE=deferred_flatten (bead je8/2kn,
config_multiclock_hier.json) the SAME crossing can synthesize with the
submodule input-port net MERGED into its driver's net instead (here:
u_cpu_clk_dis_sync's `.d_i(~pmu_cpu_clk_en)` collapses so no
`*u_cpu_clk_dis_sync*d_i*` net exists at all post-CTS -- confirmed
2026-09-15 against run 8 step 31's soc_top.nl.v: only
`u_cpu_clk_dis_sync.sync_q[0]`, `pmu_cpu_clk_dis_sync` and anonymous
`._0_`.._7_` nets survive). The d_i NAME is gone, but the destination
flop CELL always still exists and is always findable without relying on
any name at all: it is the unique to_clk-domain register whose D-pin
fan-in reaches into from_clk.

cdc_capture_flop_d_pins: scope to cells whose full (dot-joined) name
contains EVERY substring in $substr_list (Tcl string match, not
OpenSTA's own glob -- sidesteps the bracket/dot escaping pitfalls
documented throughout this file), restricted to to_clk-domain registers
(cdc_filter_by_clock reuse), then keep only those whose D pin's fan-in
(get_fanin, -flat, so it walks through any intervening inverter/buffer --
same idiom cdc_net_from_to already relies on, since ASAP7 seq cells only
expose an inverted Q/QN and almost never drive a clean net directly)
actually reaches a from_clk-domain register. That fan-in-crosses-the-
boundary test is what picks out the TRUE first-capture flop and
excludes a synchroniser's later stages (their D pin only fans in from
the same to_clk domain, no boundary crossing) without needing to parse
any stage/bit index out of a name.
\end{textblock}

\subsection*{Before: set\_max\_delay [expr \{1750 * 0.9\}] \textbackslash{}}

\begin{textblock}
##############################################################################
10. Domain-wide fallback budget for name-unmatchable payload crossings
    (bead 7l5, 2026-08-06)

DECLARED BEFORE sections 11-13 ON PURPOSE — see PRECEDENCE note below.

Covers the crossings sections 11/12/12a cannot re-express by name
post-flatten: the 5x mem_q combinational reads (async_axi_fifo) and the
cmd_*/resp_* FSM-gated payload captures (both apb_cdc_bridge instances).
None of these survive as an identifiable net -- 0 occurrences of mem_q,
cmd_pwrite_q, cmd_paddr_q, cmd_pwdata_q, cmd_pstrb_q, resp_prdata_dq,
resp_pslverr_dq anywhere in final/nl/soc_top.nl.v (confirmed by both grep
and OpenSTA get_nets).

Budget: 0.9x destination-domain period, matching OpenTitan
check_only.sdc's blanket 0.9x-destination-period budget for CDC data-path
crossings (same convention section 11's mem_q used pre-flatten). This is
TIGHTER than the cmd_*/resp_* class's original bespoke budget (1.0x
destination period, see the section 12/12a payload notes below) -- a
deliberate, documented tightening, not a silent regression: there is no
way to re-express those two classes with different budgets when neither
can be distinguished by name post-flatten (both fall into the same
`-from [all_registers ...] -to [all_registers ...]` point-to-point
match). A VIOLATED finding here on a former-1.0x-budget crossing is
expected to be MORE likely than before, not evidence of a broken check.

PRECEDENCE (measured, bead 7l5, real routed netlist, distinctive sentinel
values, req_q crossing used as the probe):
  - a `-through <net>` exception is ALWAYS dominated by ANY applicable
    `-from/-to` exception on the same path, REGARDLESS of declaration
    order or how much narrower the -through net list is. This is why
    every per-crossing exception in sections 11-13 below is expressed as
    `-from <cell(s)> -to <cell(s)>` (cdc_apply_max_delay / cdc_net_from_to,
    derived from the matched net via get_fanin/get_fanout tracing -- see
    OBJECT RESOLUTION item 7) rather than `-through <net>`.
  - between TWO overlapping `-from/-to` exceptions (this section's broad
    `all_registers`-based one, and a later specific single-cell-pair
    one), OpenSTA applies whichever was declared LAST, NOT the more
    specific one -- tested both orders on the identical path/values; it
    is pure declaration order, not specificity. (An earlier draft of this
    file assumed "most specific -from/-to wins" from a single-order test;
    re-testing with the order reversed disproved that and is why this
    section physically sits BEFORE sections 11-13 in the file, not after
    them as its section number might suggest.)
CONSEQUENCE: this section MUST stay textually before sections 11-13 for
their tighter budgets to remain authoritative. If a future edit moves
this block after them, every named crossing's budget silently reverts to
this 0.9x fallback -- re-verify with the check target's .rpt files
(max_delay value shown for each crossing) after ANY reordering.
##############################################################################
\end{textblock}

\subsection*{Before: proc cdc\_reset\_sync\_async\_pins \{\} \{}

\begin{textblock}
##############################################################################
10a. Exclude cdc_reset_sync's async set/reset pins from the section-10
     domain-wide fallback (bead je8, 2026-09-15)

WHY: with real GRT parasitics (run 9 step 02, CDC_CHECK_FORCE_GRT=1),
section 10's blanket -from/-to swept in a wide-fanout RESET distribution
path -- u_pll_sub's pll-lock-derived core_rst_n (rtl/soc/soc_top.sv:260,
252: "core_rst_n = pll_subsystem.core_rst_n (rst_n_i & pll_locked)")
ANDed into rst_both_n (rtl/soc/apb_cdc_bridge.sv:343:
"assign rst_both_n = s_rst_n_i & m_rst_n_i") and fed to
u_apb_dbg_cdc.u_m_rst_sync's async-clear input
(rtl/soc/apb_cdc_bridge.sv:358-365: cdc_reset_sync instance u_m_rst_sync,
.rst_n_i(rst_both_n)) -- and reported it VIOLATED (-765 ps) as a
recovery-time check at the synthesized SETN pin. RTL classification
(bead je8, all three confirmed true):
  (a) the pin reached IS the flop chain's async assert input: every
      always_ff in rtl/soc/cdc/cdc_reset_sync.sv:109,117
      ("always_ff @(posedge clk_i or negedge rst_n_async)") uses
      rst_n_async as its ASYNCHRONOUS clear, mapped by synthesis to the
      cell's RESETN/SETN liberty pin (confirmed empirically: ASAP7
      DFFASRHQNx1 exposes CLK/D/RESETN/SETN/QN, no other async control
      pin exists).
  (b) de-assertion is synchronous: cdc_reset_sync.sv:107-126 shifts a
      constant 1 into sync_q through STAGES flops on posedge clk_i once
      out of reset ("sync_q[0] <= 1'b1" / "sync_q[g] <= sync_q[g-1]"),
      i.e. classic async-assert/sync-deassert -- release of rst_n_o is
      re-timed onto the CAPTURE domain's own clock, exactly the pattern
      cdc_reset_sync.sv's own header (lines 2-9) documents.
  (c) the launching net is reset-class, not data: rst_both_n (source of
      u_m_rst_sync's async clear) is the AND of two reset signals
      (apb_cdc_bridge.sv:343), and core_rst_n itself is
      "rst_n_i & pll_locked" from the u_pll_sub pll_subsystem instance
      (soc_top.sv:252,260) -- the ~11-buffer chain observed in the
      violating path IS that reset's fanout/distribution buffering
      (core_rst_n resets essentially every register in the sys_clk
      domain, so it fans out like a small tree, structurally similar to
      a clock tree -- not a data path).
All three hold, so this is the SAME class as the existing
u_cpu_pmu_rst_sync exclusion a few sections below (pmu_cpu_rst_n
async-clear reset sync, false_path'd there by net name) -- bead k07
precedent. Recovery/removal timing on de-assertion is NOT waived here
(it stays the tool's normal, un-excepted check via the synchronous
same-domain flop-to-flop paths cdc_reset_sync's chain forms -- this
exclusion only removes the SPURIOUS cross-domain recovery check
set_max_delay -to [all_registers ...] fabricates against an async
CONTROL pin that was never meant to be timed as a data endpoint).

STRUCTURAL matching (preferred over a name-derived net, which is
exactly the class of thing deferred_flatten/flatten can rename or
merge away -- bead je8/c88013d lesson): scope to registers whose
instance path contains "rst_sync" (covers every cdc_reset_sync
instantiation in this design -- u_s_rst_sync/u_m_rst_sync inside each
of the 5 async_axi_fifo instances and both apb_cdc_bridge instances,
plus the top-level u_cpu_pmu_rst_sync), then take each such register's
RESETN/SETN pins BY LIBERTY PIN NAME (not by tracing any RTL net name
at all -- these are the ASAP7 SEQ library's async-control pin names on
every flop variant in this design, confirmed against the same liberty
used throughout this file). No capture-flop-D-pin fallback is needed
here (unlike sections 11/13's d_i fallback): the object being excluded
IS the register cell itself, found via all_registers + instance-name
match, with no submodule port net in the path at all -- there is
nothing for deferred_flatten to rename away.
\end{textblock}

\subsection*{Before: set \_req\_sync [get\_nets -hierarchical -filter \{name =\~{} *...}

\begin{textblock}

GH #94 / bead oa7 item 2. Budgets left at 1.0x destination period —
bead k07 item 1 only asked for retightening on the gray-pointer FIFOs
(section 11) and mem_q; these single-bit req/ack level-handshake
crossings are lower-rate control paths, not the gray-pointer datapath
OpenTitan singles out for the tighter 0.5x GRAY_MAX_DELAY budget.

RENAMED (bead claude_verilog_test-rfz, 2026-08-12): apb_cdc_bridge.sv
converted from a 2-phase NRZ toggle handshake to a 4-phase RZ handshake.
req_toggle_q/ack_toggle_q became req_q/ack_q -- same electrical role (each
is still the one register whose value crosses via cdc_sync), so the
object-mapping methodology below (bead 7l5) is unaffected; only the name
patterns changed. This is exactly the class of stale-pattern-matches-zero
hazard bead 7l5 itself warns about (see OBJECT RESOLUTION item 3) -- do
not let a future RTL rename slip past this file again without updating
these `-filter {name =~ ...}` strings in the same commit.

Object mapping (bead 7l5): req_q / ack_q are each a direct RTL passthrough
into their cdc_sync's d_i (`.d_i(req_q)` / `.d_i(ack_q)`, see
rtl/soc/apb_cdc_bridge.sv), and in THIS module both source registers keep
their own clean net names post-optimisation (unlike section 11's
asymmetric case) -- matched directly, no d_i net needed. The cmd_*/resp_*
payload capture registers are unmatchable by name (0 occurrences anywhere
in the routed netlist, same class as mem_q) -- moved to section 10.
##############################################################################
\end{textblock}

\subsection*{Before: cdc\_apply\_max\_delay\_capture\_fallback \{u\_cpu\_clk\_dis\_sync...}

\begin{textblock}
deferred_flatten fallback (bead je8, 2026-09-15) -- see CAPTURE-FLOP
D-PIN FALLBACK block above. u_cpu_clk_dis_sync's .d_i(~pmu_cpu_clk_en)
net (real logic -- an inverter -- between source and synchroniser)
does not survive under SYNTH_HIERARCHY_MODE=deferred_flatten; the
capture flop cell always does. Not exercised on flat/run-23-style
netlists (this branch is only reached when the d_i-name match above
is already empty).
\end{textblock}

\end{record}

\section{\texttt{scripts/check\_cdc\_timing.tcl}}\label{cr:pd:scripts-check-cdc-timing-tcl}

This section holds dated history that was in a comment of the source file. The text is unchanged. Each line has no leading comment marker and no indentation.

\begin{record}

\subsection*{Header comment}

\begin{textblock}
That re-closure run is GH #96's scope, not this bead's — as of
2026-08-02 no such run exists yet (the signed-off run 14 predates GH
#91-95's CDC RTL entirely). Until then this script will correctly report
"Netlist not found" rather than silently doing nothing.

\end{textblock}

\subsection*{Before: set CDC\_CHECK\_ODB [expr \{[info exists ::env(CDC\_CHECK\_OD...}

\begin{textblock}
CDC_CHECK_ODB (bead je8, 2026-09-15): opt-in ODB-based loading path for
checkpoints that only have GRT (or later) parasitics, e.g. a run
stopped/seeded mid-flow before a `final/nl/*.nl.v` signoff netlist
exists. Requires OpenROAD (read_db/global_route/estimate_parasitics are
OpenROAD-only commands -- this script's default path below works under
plain standalone `sta` precisely because it avoids all of them). Run
this script with `openroad` instead of `sta` when CDC_CHECK_ODB is set;
it is silently ignored -- and the netlist/link_design path below runs
unchanged -- otherwise, so every existing `sta
pnr/scripts/check_cdc_timing.tcl` invocation (including the tracked
check-cdc-timing-asap7-soc Makefile target) is byte-identical to
before.
\end{textblock}

\subsection*{Before: set CDC\_CHECK\_FORCE\_GRT [expr \{[info exists ::env(CDC\_CH...}

\begin{textblock}
CDC_CHECK_FORCE_GRT (bead je8, 2026-09-15): ODB-mode only, opt-in.

CORRECTED 2026-09-15 (same day, later session) -- the claim this
comment originally made ("estimate_parasitics -global_routing off the
ODB's own persisted guides, tool-verified to work with no warning") was
WRONG. "No warning" was mistaken for "succeeded". Rigorous check:
`report_parasitic_annotation` after `read_db` + `estimate_parasitics
-global_routing`, with NO global_route/read_guides call at all,
reports "Found 204195 unannotated drivers" out of ~204196 total on
this SoC's step-02 odb -- i.e. essentially the ENTIRE design, including
the specific CDC data nets this check targets (verified by name:
u_cpu_axi_cdc.u_r_fifo._1424_/Y, u_cpu_axi_cdc.u_ar_fifo._1509_/Y,
u_pll_sub._1_/Y all appear in the unannotated list). This reproduces
IDENTICALLY whether read_sdc/clock-mode changes happen before or after
estimate_parasitics, and whether CDC_CHECK_PROPAGATED_CLOCK is 0 or 1
-- it is not an ordering bug, and neither clock mode's results from
2026-09-15 (the original propagated-clock FAIL, or the later ideal-
clock PASS) reflect real post-GRT wire delay. Both were computed on
essentially unannotated (effectively zero-wire, same order as the
plain-netlist STA-only path's default) parasitics.
`read_guides <file>` was tried first as a memory-cheap alternative and
is ALSO confirmed not usable: OpenROAD prints "[WARNING GRT-0008] The
read_guides command does not allow parasitics estimation from the
guides file" -- it loads guide geometry for display/DRT purposes only.
The only thing that DOES populate annotatable parasitics is a
genuinely fresh, in-session `global_route` (CDC_CHECK_FORCE_GRT=1
below) -- but that is memory-heavy regardless of layer range: it
OOM'd a 3.5G-capped scope on this SoC (520x520um, 138k+ blockages) at
the SAME point (right after GRT's per-layer "Routing resources
analysis" table, before any congestion iteration) whether run at the
full M2-M9 range, 50 congestion iterations, OR restricted to M2-M5
with just 1 iteration -- meaning the dominant memory cost is net-
topology/Steiner-tree construction across the whole design, not
per-layer grid size, and is NOT reducible via these flags.
RESOLVED (bead je8, same day, later session still): at a 9.5G cap
(scope je8-cdc-grt2) the full M2-M9/50-iteration global_route
completed cleanly -- 0 overflow on every layer, 204,072 routed nets,
peak ~5.4 GB, ~24 min wall time -- and the subsequent
report_parasitic_annotation dropped from 204,195/204,196 (~100%)
unannotated to 123/204,196 (0.06%) unannotated: real annotation,
confirmed both by that coverage number and by materially different,
structurally distinct per-path delay results vs. the unannotated
baseline (not just a clock-latency shift, since clocks were ideal in
both). So 3.5G is provably insufficient and ~5.4G peak / 9.5G cap is
provably sufficient on this SoC; the true minimum lies somewhere
between (not bisected). Every ODB-mode run (regardless of
CDC_CHECK_FORCE_GRT/CDC_CHECK_PROPAGATED_CLOCK) still prints an
explicit annotation-coverage warning (see below, search
ANNOTATION-CHECK) rather than silently proceeding -- treat any
CDC-CHECK-RESULT alongside a HIGH unannotated count as datapath-
shape-only (real cell delay, real logic depth, real fanout, but
wireload-model or zero wire RC), not a genuine post-GRT/post-route
timing verdict; a near-zero count (as achieved here) means it IS a
genuine one. Set CDC_CHECK_FORCE_GRT=1 with at least ~6G of memory
headroom for this SoC's fresh global_route to have a realistic chance
of completing (5.4G peak observed once; leave margin).
\end{textblock}

\subsection*{Before: set CDC\_CHECK\_PROPAGATED\_CLOCK [expr \{[info exists ::env...}

\begin{textblock}
CDC_CHECK_PROPAGATED_CLOCK (bead je8, 2026-09-15): ODB-mode only,
opt-in, OFF by default. The budgets in phase5_soc_multiclock_check.sdc
are intended as datapath-only bounds (GH #94 intent,
phase5_soc_multiclock.sdc header: launch-flop CK->Q plus data wires/
logic to the capture D pin, excluding clock-network latency) --
`-datapath_only` is the SDC keyword that would normally express that,
but this file's own header (see above, "WHY THIS FILE EXISTS" item 1)
already tool-verified OpenSTA 2.6.0 / OpenROAD edf00dff do not
implement -datapath_only at all (STA-0563 on read_sdc), so it is never
passed by cdc_apply_max_delay / cdc_apply_max_delay_capture_fallback --
confirmed again by inspection here, both only ever call plain
`set_max_delay $val -from ... -to ...`. Given that, the only way this
tool can approximate "datapath-only" is by keeping clocks IDEAL (each
clock's SDC-declared `set_clock_latency -source 50` instead of a real,
walked clock-tree insertion delay) while STILL using GRT-estimated wire
parasitics on the DATA path -- clock propagation mode and parasitics
annotation are independent in this tool, so this isolates data-path
delay without the ~600-900 ps of real sys_clk clock-tree insertion
delay a fully propagated launch clock would fold into the same
max_delay budget (bead je8, 2026-09-15: exactly what turned 3 real-
parasitics groups VIOLATED on run 9 step 02 under
CDC_CHECK_PROPAGATED_CLOCK=1). This default matches how every prior
ACCEPTED CDC check in this project's history was run (run 23's
original post-route check and this bead's own post-CTS early check
both used ideal/unpropagated clocks, via the plain-netlist STA-only
path that has no clock-tree structure to propagate at all). Set
CDC_CHECK_PROPAGATED_CLOCK=1 to get the fdf166b behaviour back (real
propagated clock latency folded into the same budget -- useful for
separately characterizing how much of a path's margin is clock-latency
vs. datapath, as this bead's own notes do).
\end{textblock}

\subsection*{Before: if \{\$CDC\_CHECK\_ODB ne ""\} \{}

\begin{textblock}
----------------------------------------------------------------
GRT-parasitics mode (bead je8, 2026-09-15): once the design+SDC are
loaded from the ODB, get the SAME parasitic basis the real flow's
rsz_timing_postgrt.tcl uses -- set_propagated_clock (real CTS-built
clock-tree insertion delay from the loaded odb, not the check SDC's
ideal `set_clock_latency -source 50` fallback), the ASAP7-calibrated
per-layer RC values and routing-layer range
(librelane/scripts/openroad/common/set_rc.tcl /
set_routing_layers.tcl), the same GRT layer adjustments
(common/set_layer_adjustments.tcl), then estimate_parasitics
-global_routing -- by default off the ODB's own persisted routing
guides (memory-cheap, tool-verified 2026-09-15 to need no fresh route),
or a genuinely fresh global_route if CDC_CHECK_FORCE_GRT=1 (see that
variable's header comment above for why re-routing is the heavier,
opt-in path; rsz_timing_postgrt.tcl always takes it, citing
https://github.com/The-OpenROAD-Project/OpenROAD/issues/5590, but this
script defaults to the cheaper odb-persisted path since it was
confirmed to work without that warning). No repair_timing call -- this
is a read-only timing snapshot of the checkpoint as routed, never
modifies the design.
----------------------------------------------------------------
\end{textblock}

\subsection*{Before: puts "==================================================...}

\begin{textblock}
ANNOTATION-CHECK (bead je8, 2026-09-15): print real annotation
coverage instead of silently trusting "estimate_parasitics printed
no warning" -- that was mistaken for success once already (see the
CDC_CHECK_FORCE_GRT header comment above for the full writeup: a
`read_db`-only load, with no live global_route in this session,
left ~204195/204196 drivers -- effectively the whole design --
unannotated, reproduced identically regardless of SDC/clock-mode
ordering or CDC_CHECK_PROPAGATED_CLOCK). Always print the summary;
never gate on it silently, since a partially-annotated design (some
real runs may legitimately differ from this one) is still useful
to see stated plainly rather than inferred.
\end{textblock}

\subsection*{Before: set \_fifo\_wr2rd\_obj [get\_nets -hierarchical -filter \{nam...}

\begin{textblock}
Object mapping re-derived under bead claude_verilog_test-7l5 (2026-08-06)
against the FLATTENED netlist (SYNTH_HIERARCHY_MODE=flatten) -- see
phase5_soc_multiclock_check.sdc's "OBJECT RESOLUTION" header block for the
full tool-verified writeup. Three independent things changed vs. the
pre-7l5 version of this script, all confirmed empirically against
final/nl/soc_top.nl.v, not assumed:
  (1) separator: hierarchy survives only as literal '.' in escaped
      identifiers, not '/'.
  (2) object class: cells are anonymous post-flatten (get_cells/get_pins
      hierarchical name patterns always return empty) -- get_nets is the
      only name-matchable class, and even then only for nets that kept a
      clean RTL-derived name.
  (3) filter syntax: a literal '.' inside a `-filter "name =~ <pattern>"`
      pattern is NOT a safe glob character on this tool once wildcards
      surround it (tool-verified: it either returns 0 or, for a bare
      leading `*.`, silently matches almost the entire netlist). Every
      pattern below is therefore a '*'-joined chain of dot-free
      substrings only.
  (4) semantics: q_o (the synchroniser's LAST-stage output) is a
      destination-domain-only net, not the crossing itself -- see
      cdc_sync.sv. These reports now target the launch->first-capture
      segment instead: d_i where it survives as its own net
      (u_wr_ptr_to_rd.d_i does), or the source register net directly
      where d_i does not survive (u_rd_ptr_to_wr.d_i collapses into
      rd_gray_q's net during optimisation -- rd_gray_q is used instead,
      same electrical node).
mem_q itself (the FIFO storage array's combinational read) has ZERO
occurrences anywhere in the routed netlist under any object class or
separator -- it cannot be re-expressed by name post-flatten. It is no
longer reported here; it is one of the crossings covered by the
domain-wide fallback report below (mirrors
phase5_soc_multiclock_check.sdc section 14).
\end{textblock}

\subsection*{Before: set \_fifo\_wr2rd\_obj [concat \textbackslash{}}

\begin{textblock}
deferred_flatten fallback (bead je8, 2026-09-15) -- same
cdc_capture_flop_d_pins proc phase5_soc_multiclock_check.sdc's
section 11 uses, available here because read_sdc evaluated that
file's procs in this same interpreter above. Per-instance/per-
direction because this one report spans all 5 fifos but AW/W/AR
(cpu_clk->sys_clk) and B/R (sys_clk->cpu_clk) launch/capture in
opposite directions.
\end{textblock}

\subsection*{Before: set \_clk\_dis\_report\_obj [get\_nets -hierarchical -filter ...}

\begin{textblock}
u_cpu_clk_dis_sync is fed `.d_i(~pmu_cpu_clk_en)` (an inverter output --
real logic between source and synchroniser), so its d_i net survives
under its own scoped name. u_cpu_iso_en_sync / u_ext_irq_sync /
u_timer_irq_sync are each a direct passthrough whose d_i net does NOT
survive; the source signal itself does, as a PLAIN top-level net
(pmu_cpu_iso_en / ext_irq / timer_irq). NOTE: OpenSTA's -filter grammar
was tool-verified to only evaluate the first two clauses of a 3+-way
"||" chain (a latent bug in this script's pre-7l5 4-way OR here, silently
dropping u_ext_irq_sync and u_timer_irq_sync from the old report even
before the separator/object-class issues) -- this is why the query below
is split into two 2-way-OR get_nets calls and concatenated, rather than
one 4-way chain.
u_cpu_clk_dis_sync's d_i-name sub-match, split out on its own so a
deferred_flatten netlist where that name vanishes (bead je8, 2026-09-15)
doesn't silently ride the OR with pmu_cpu_iso_en -- an OR'd collection
only needs ONE side non-empty to look "matched" via cdc_report_through's
llength check, so a vacuous d_i sub-clause was invisible in this report
every time pmu_cpu_iso_en's plain net matched, i.e. always. That masked
the exact CDC-EXCEPTION-MISS bead je8's early check on run 8 surfaced.
\end{textblock}

\end{record}

\section{\texttt{scripts/check\_cdc\_timing\_sky130.tcl}}\label{cr:pd:scripts-check-cdc-timing-sky130-tcl}

This section holds dated history that was in a comment of the source file. The text is unchanged. Each line has no leading comment marker and no indentation.

\begin{record}

\subsection*{Header comment}

\begin{textblock}
bead claude_verilog_test-j41m.5 (2026-10-16). Sky130 sibling of check_cdc_timing.tcl
(ASAP7); that script is left untouched.

\end{textblock}

\end{record}

\section{\texttt{scripts/check\_multiclock\_sdc.tcl}}\label{cr:pd:scripts-check-multiclock-sdc-tcl}

This section holds dated history that was in a comment of the source file. The text is unchanged. Each line has no leading comment marker and no indentation.

\begin{record}

\subsection*{Header comment}

\begin{textblock}

GH #96 / bead claude_verilog_test-8nz.

WHY THIS EXISTS
---------------
OpenSTA does NOT error when a create_clock's object list resolves to
nothing. `create_clock -name cpu_clk -period 780 [get_ports cpu_clk_i]`
against a netlist with no cpu_clk_i port silently produces a VIRTUAL
cpu_clk: the clock object exists, reports its period, and shows up as a
second "Clock:" block in OpenROAD's clock.rpt — but it has no source pin
and no registers, so CTS builds no tree for it and every cpu-domain path
goes untimed.

Verified on 2026-08-05 against the run-14 netlist (which predates GH #93
and has no cpu_clk_i port):
    PORT-CHECK cpu_clk_i exists: 0
    CLOCK cpu_clk is_virtual=1 nsources=0 registers=0
    CLOCK sys_clk is_virtual=0 nsources=1 registers=43764

So "clock.rpt contains two Clock: blocks" is NOT sufficient evidence of a
real two-domain run. The binding checks below are. Run this against the
synthesis netlist BEFORE committing to a multi-hour P&R.

\end{textblock}

\end{record}

\section{\texttt{sky130/soc/constraints/sky130\_soc.sdc}}\label{cr:pd:sky130-soc-sdc}

This section holds dated history that was in a comment of the source file. The text is unchanged. Each line has no leading comment marker and no indentation.

\begin{record}

\subsection*{Header comment}

\begin{textblock}
############################################################################
CURRENT CONTRACT (2026-07-31, adopted run RUN_2026-07-30_06-42-17):
  clock_period          = 25.0 ns (40 MHz)   <- set below, line ~205
  TIMING_VIOLATION_CORNERS = ["*"]           <- all 9 corners gated
  Result: hold clean at all 9 corners; setup clean at tt/ff; setup STILL
  FAILS at ss (max_ss -4.643 ns) -- tracked as bead ujv, DEFERRED
  host-blocked 2026-07-31 (honest ss closure needs per-corner SRAM
  characterization; bead o1i measured that as infeasible on this host).
  Stage 2 closed on that basis as a typical-corner (nom_tt) sign-off.
Everything below this block describing 75 MHz / 65 MHz / nom_tt-only
gating is HISTORICAL CONTEXT ONLY. Do not read it as the current target.
############################################################################

--- HISTORICAL (2026-07-24, superseded) ---
GH #104 (2026-07-24): clock target relaxed from 75 MHz (13.333 ns) to
65 MHz (15.385 ns) per user decision, after the sign-off run
(RUN_2026-07-24_09-58-19) showed nom_tt setup WNS -1.069 ns at 75 MHz
(single CPU-macro-internal-boundary violator). The added +2.051 ns of
slack is expected to close nom_tt/max_tt setup but NOT the slow
(ss) corners -- see memory/pd/run_state.md for the full analysis.
That 65 MHz value was itself superseded on 2026-07-31: it did NOT close
ss (WNS -8.902 ns), and relaxing to 25.0 ns only improved ss to
-4.643 ns because path delay scales with period at ~0.52 ns/ns.
Extrapolated closure is ~29 MHz -- a two-point lower bound, not a
validated target. See bead ujv.

*** KNOWN LIMITATION (GH #104): THE SRAM MACRO IS STILL NOT
CHARACTERIZED PER-CORNER. The CPU macro NOW IS (fixed 2026-07-25). ***

STATUS AS OF 2026-07-25 (RUN_2026-07-25_13-29-40):
  - rv32i_cpu_top: FIXED. config.json now maps 9 EXACT corner keys to 9
    genuinely distinct per-corner Liberty views in pnr/sky130/cpu/macro/.
    Those views already existed -- the Stage-1 run's OpenROAD.STAPostPNR
    step wrote all nine; only nom_tt had ever been staged, and the config
    wildcarded it to every corner. VERIFIED from each corner's own
    sta.log: nom_ss_100C_1v60 now reads rv32i_cpu_top__nom_ss_100C_1v60.lib,
    and all 9 corners load their own matching file.
  - sky130_sram_4kbyte_1rw1r_32x1024_8: STILL nom_tt-only. Its lib entry
    is deliberately still {"*": [<the one TT_1p8V_25C file>]}, so its
    internal timing arcs remain corner-invariant for every reported
    corner. This macro is now the SOLE source of this limitation.
    Tracked as GH #120 / bead claude_verilog_test-o1i (P3).

WHAT THE FIX ACTUALLY REVEALED -- the prior speculation was WRONG on
the hold direction, and this matters:
  The earlier version of this header reasoned that ss SETUP was
  optimistic (correct) but ss HOLD was PESSIMISTIC, i.e. that the
  max_ss -0.0708 ns residual on u_cpu/axi_bready_o was "plausibly
  better in real silicon". With genuine per-corner CPU libs, hold got
  WORSE, not better:
      max_ss  hold WS: -0.0708 ns -> -0.3997 ns (2 paths -> 3)
      nom_tt  hold WS: +0.1807 ns MET -> -0.0923 ns VIOLATING
      max_ss setup WS: -5.3197 ns -> -10.4730 ns (TNS -98.5 -> -252.6)
  So the wildcard was optimistic in BOTH directions, not offsetting.
  nom_tt SETUP still passes (+0.2413 ns), but nom_tt HOLD no longer does.

  ATTRIBUTION CAVEAT: that comparison run changed TWO things at once --
  per-corner CPU libs AND the newly-enabled antenna repair, which
  inserted 2018 diodes and thereby perturbed routing and timing. The
  deltas above CANNOT be cleanly attributed to the corner libs alone.
  Isolating them would need a third run with libs-only.

  Paths entirely within flat standard-cell logic ARE corner-accurate,
  since sky130_fd_sc_hd genuinely varies per corner.

SCOPE OF THIS SIGN-OFF: still a TYPICAL-CORNER (nom_tt) TIMING SIGN-OFF,
because one macro remains single-corner. It is NOT a validated
multi-corner timing sign-off and MUST NOT be recorded as one anywhere
downstream.
  UPDATE 2026-07-31 (adopted run RUN_2026-07-30_06-42-17): the "even
  nom_tt now carries a hold violation" clause that used to appear here
  is SUPERSEDED. That violation was root-caused to the clk_i
  set_driving_cell issue (bead y7v, see FIX 2026-07-26 below) and the
  adopted run reports hold clean at all 9 corners. The scope statement
  itself still stands: "hold clean at all 9 corners" is a statement
  about 9 corner LABELS, not 9 independently characterized macro
  models. The SRAM macro's timing arcs are identical in all nine.

REMAINING REAL FIX: SPICE-characterize the SRAM macro per corner
(analytical_delay=False, nominal_corner_only=False). This would also fix
the macro's internal_power tables, which OpenRAM's analytical model
emitted as ~1.99e11 and which are currently ZEROED in the staged .lib --
see that file's header. GH #120 / bead claude_verilog_test-o1i.

FIX 2026-07-26 (bead claude_verilog_test-y7v): the nom_tt hold violation
reported just above (-0.0923 ns, apb_paddr_i[4] -> u_cpu) was root-caused
to set_driving_cell [all_inputs] also covering clk_i with the same weak
buf_4 used for data inputs -- min.rpt showed this cost the clock port
886 ps of delay / 1.218 ns slew before CTS's clkbuf_16 root buffer even
entered the picture, inflating capture-clock latency and, 1:1, every
downstream hold requirement. clk_i is now excluded from the buf_4
set_driving_cell line and given its own -lib_cell clkbuf_16 (matches
CTS_ROOT_BUFFER in config.json) so the clock source model is neither an
ideal zero-slew source (optimistic) nor buf_4 (spuriously weak for a
clock pin). See RUN_2026-07-25_13-29-40 min.rpt for the violator detail.

VERIFIED (RUN_2026-07-26_09-36-48): the clk_i change alone is worth
+0.362 ns of hold slack at the worst endpoint, measured at post-CTS STA
(step 32) before any hold repair runs: -1.3339 -> -0.9723 ns WS,
TNS -51.02 -> -34.38. Final nom_tt hold closed at +0.1354 ns (was
-0.0923). It is SETUP-NEUTRAL: steps 32 and 34 setup WS match the
baseline to 6 decimal places (4.190165/4.190166, 4.933771/4.933770),
as expected -- common clock latency cancels on reg-to-reg paths, so
reducing it moves hold only.

RESOLVED 2026-07-26 by RUN_2026-07-26_16-05-43. nom_tt_025C_1v80 now closes
BOTH: setup +1.38729 ns (TNS 0.0), hold +0.14439 ns, violator list EMPTY.
LVS "Circuits match uniquely". Full series:
    RUN_2026-07-25_13-29-40 baseline:             hold -0.0923 FAIL | setup +0.2413 MET
    RUN_2026-07-26_09-36-48 clk fix, margin 0.15: hold +0.1354 MET  | setup -1.6877 FAIL
    RUN_2026-07-26_12-43-06 clk fix, margin 0.05: hold +0.1453 MET  | setup -1.4304 FAIL
    RUN_2026-07-26_15-38-37 + postGRT repair:     DIED step 37, RSZ-0090
    RUN_2026-07-26_16-05-43 + SRAM max_trans fix: hold +0.1444 MET  | setup +1.3873 MET

TWO fixes were needed, not one:
  (1) the clk_i driving-cell change described below -- closes hold;
  (2) RUN_POST_GRT_DESIGN_REPAIR true in config.json, which required
      raising the SRAM macro .lib max_transition 0.04 -> 0.5 because 40 ps
      is unachievable in sky130_fd_sc_hd and OpenROAD hard-aborts with
      RSZ-0090 -- closes setup. See that .lib's header for the tradeoff.

PROOF the setup fix hit the real defect rather than a lucky placement
reshuffle: the offending net returned to baseline values.
    u_cpu/axi_araddr_o[18]  broken:   fanout 2, cap 0.625885, clk->Q 5.572786
                            fixed:    fanout 1, cap 0.019504, clk->Q 4.544736
                            baseline: fanout 1, cap 0.019349, clk->Q 4.544564
Setup also finished +1.15 ns BETTER than baseline, because post-GRT design
repair fixed other over-cap/over-slew nets that had gone unrepaired for the
whole Stage-2 history while that step was disabled.

COST: antenna regressed. Pin violations across the series ran
154 -> 152 -> 144 -> 164; the repair buffers added ~20 over the best run and
10 over baseline. Antenna was already FAILED in every run; tracked on bead
claude_verilog_test-58q. DRC unchanged: KLayout 4 (known macro-internal),
Magic 9081 (known artifact class).

The historical analysis below is retained because it documents two wrong
diagnoses that cost runs -- do not repeat them.

The setup violator throughout was u_cpu/axi_araddr_o[18] -> u_cpu/axi_arready_i.

GRT_RESIZER_HOLD_SLACK_MARGIN WAS NOT THE CAUSE. An earlier revision of
this header blamed the 0.05 -> 0.15 margin raise; RUN_2026-07-26_12-43-06
put it back to 0.05 and DISPROVED that:
    step-40 setup: 4.0600 baseline | 3.2044 at margin 0.15 | 3.0776 at 0.05
    step-40 hold : 0.2620799207389556 at BOTH 0.15 and 0.05 -- bit-identical
The knob moved neither hold nor setup in the direction claimed; setup at
step 40 is if anything worse at 0.05. Margin is left at 0.05 (the default)
because nothing justifies deviating, NOT because it fixes anything.

ACTUAL MECHANISM (RUN_2026-07-26_12-43-06 max.rpt, same path both runs):
the clock half behaves correctly -- launch and capture clock both drop
0.588 ns and cancel exactly, as reg-to-reg through one macro clock pin
must. The loss is 1.672 ns of DATA path, and 1.028 ns of that is the CPU
macro's own clk->Q arc inflating because its output net exploded:
    u_cpu/axi_araddr_o[18]  fanout 1 -> 2, cap 0.019349 -> 0.625885 pF
                            slew 0.0425 -> 1.6868 ns
                            clk->Q 4.5446 -> 5.5728 ns
The CPU is a hard macro with fixed output drive, so that load lands
directly on its delay arc with no resizing possible.

WHY THE NET CHANGED: cascade, not a direct effect of the clock model.
Better hold slack -> post-CTS hold repair inserts different buffers ->
different placement -> different GRT -> antenna violations 556 -> 558 and
diodes 2018 -> 2039 -> this net picked up a second, distant sink and a
long route. A diode's own load is ~0.005 pF and cannot explain 0.36 pF;
the wire length does.

CONTEXT: this is the SAME path that forced 75 -> 65 MHz (GH #104) and that
GH #123 measured at 8.83 ns of crossbar fabric across 20 driver stages.
Baseline's +0.2413 ns is 1.6% of the 15.385 ns period -- the path has
always been critically marginal and routing-sensitive, so a placement
reshuffle flips it. RUN_POST_GRT_DESIGN_REPAIR was false and
Checker.MaxSlewViolations / MaxCapViolations are skipped, so nothing in the
flow was repairing that 1.687 ns slew / 0.626 pF cap. Enabling that step is
what fixed it -- see the RESOLVED block at the top of this section.

DO NOT record either configuration as a sign-off: one fails hold, the
other fails setup, both at nom_tt. Tracked on bead claude_verilog_test-y7v.

##############################################################################
2026-07-29 (bead claude_verilog_test-58q, coordinator-directed scope change):
CLOCK RELAXED 65 MHz (15.385 ns) -> 40 MHz (25.0 ns), AND
TIMING_VIOLATION_CORNERS WIDENED FROM ['*tt*'] TO ['*] (all 9 corners
gated: nom/min/max x tt/ss/ff).

Manufacturability.rpt for RUN_2026-07-27_17-15-57 (65 MHz, tt-only gate)
showed the ss corner genuinely fails setup by WNS -8.902 ns -- the *tt*-only
gate in prior runs hid this from the Checker.SetupViolations/HoldViolations
gates, reporting only a tt-clean, non-multi-corner sign-off. Root cause is
NOT this SDC or the SoC fabric: it is the CPU macro's own clk->Q arc, which
per bead 1ls / GH #123 is 8.16 ns at ss vs 4.55 ns at tt (9-corner CPU libs,
commit 86e89c1) -- a macro-internal characteristic, out of scope for an SoC
ECO to fix (no RTL, no macro re-timing here).

PERIOD CHOICE: arithmetic minimum to close ss with the OLD 15.385 ns
critical-path delay would be 15.385 + 8.902 = 24.287 ns (41.17 MHz). That
assumes the ss critical-path delay is invariant under period relaxation,
which it is not -- loosening the period lets the resizer legally downsize
drive strength on non-critical cells it previously had to oversize, and
delays on marginal paths typically grow back somewhat when that happens
(observed directly in this project's own history: the 65->75 MHz tightening
in bead 1ls moved delays on the SAME araddr[18]/awlen critical path by
hundreds of ps purely from resizer/placement response to the new budget).
25.0 ns (40 MHz) was chosen to give ~0.7 ns of headroom over the naive
arithmetic minimum for that effect, without over-relaxing and losing
frequency for no reason.

CAVEAT ON SS-CORNER CONFIDENCE: the CPU macro now has real 9-corner
characterisation (commit 86e89c1), but the SRAM macro
(sky130_sram_4kbyte_1rw1r_32x1024_8) remains single-corner analytical
(TT_1p8V_25C only, wildcarded to all 9 corner keys -- GH #120 / bead
claude_verilog_test-o1i, SPICE per-corner characterisation measured NOT
feasible on this host, ~80-95 h for 3 corners). Every ss/ff number that
touches SRAM read/write timing through this run therefore carries
unquantified model error in the SRAM's contribution specifically; only the
CPU macro and the flat sky130_fd_sc_hd fabric are corner-accurate. This
sign-off is "all 9 corners gated" but NOT "all 9 corners independently
verified at the macro level" -- report both facts, do not conflate them.
##############################################################################

Two clock domains since bead j41m.5 (2026-10-16): core_clk (clk_i) and cpu_clk (cpu_clk_i),
both 25.0 ns (40 MHz), declared asynchronous (see "Second clock root" and "Clock groups"
below). Before that change this was a single-clock file and the whole CPU domain was
unclocked, so every sign-off number recorded before RUN_2026-10-16 EXCLUDES the CPU-domain
fabric flops and the CPU-macro boundary arcs.
CPU is a hard macro with its own characterised timing arcs in the .lib;
path analysis through the CPU macro boundary uses those timing arcs.

set_driving_cell matches Stage-1 CPU SDC (buf_4) for all DATA inputs so
that input-slew assumptions are consistent with the CPU macro timing
model. clk_i is excluded and driven by clkbuf_16 instead (see FIX above).
\end{textblock}

\subsection*{Before: set \_in\_timed \{\}}

\begin{textblock}
##############################################################################
Load and drive modelling

Bead claude_verilog_test-y7v (2026-07-26): clk_i was previously swept into
set_driving_cell [all_inputs] along with buf_4, the same weak driver used
for real data inputs. min.rpt (RUN_2026-07-25_13-29-40) showed this cost
the clock port 886 ps of delay with a 1.218 ns slew (fanout 5, cap 0.4516
pF) before CTS's own clkbuf_16 root buffer ever got involved — a pure
weak-driver modelling artifact that inflates capture-clock latency and,
1:1, the hold requirement at every downstream endpoint. Excluded clk_i
here using the same "_in_timed = all_inputs minus clk_i" idiom already
used below for set_input_delay (STA-0441), computed once and reused by
both. clk_i now gets its own driving cell: sky130_fd_sc_hd__clkbuf_16,
matching CTS_ROOT_BUFFER in config.json — modelling the clock source as
"driven by the same strength buffer CTS will use as its root", not a
zero-slew ideal source (optimistic) and not buf_4 (spuriously weak for a
clock pin). Data inputs keep buf_4 — Stage-1 CPU SDC uses buf_4 and this
file matches it deliberately (see header).
##############################################################################
\end{textblock}

\subsection*{Before: set ::cvt\_cdc\_hold\_exempt\_pins \{\}}

\begin{textblock}
##############################################################################
CDC gray-pointer capture pins: NO HOLD CHECK in the functional implementation
(bead claude_verilog_test-j41m.5 / j41m.4; Doc: tm:pd:sky130-cdc-maxss, decision B).

WHY. The DFT test clock enters BOTH domain roots (dft_clk_mux A1 -> core tree and cpu tree),
and the group above only separates tck from core_clk/cpu_clk, not tck from itself. So the
flow STA times every flop pair that straddles the two trees as tck -> tck, a SAME-clock hold
race with the full inter-tree skew (2.45 ns measured at nom_tt on RUN_2026-10-17_14-07-01:
the capture flop sits behind u_cpu_cg and its clock arrives 2.45 ns after the launch flop's;
hold slack -2.16 ns). The resizer paid for that fictitious race with 10 dlygate4sd3_1 cells
(11.8 ns at ss) in front of each async_axi_fifo gray-pointer synchroniser, which broke the
0.5x destination-period CDC budget at all three ss corners (fifo_rd2wr -0.715 ns, fifo_wr2rd
-0.516 ns at max_ss). In FUNCTIONAL mode the two domains are asynchronous and the
synchroniser's stage-0 flop is allowed to sample the old or the new gray value, so there is
no hold requirement to pad for.

WHAT. set_false_path -hold -from <opposite-domain launch flops> -to <stage-0 D pins>, for the
gray-pointer synchronisers of the five async_axi_fifo FIFOs of u_cpu_axi_cdc ONLY. Setup is
untouched. The other CDC groups (apb_cdc_bridge req/ack, the PMU/IRQ cdc_sync cells) have
>= 12 ns of budget slack at every corner and are deliberately NOT exempted here; adding one
is one more row in the table below.

HOW IT BINDS (structural, robust to the flattened netlist; same resolver as the check SDC,
pnr/sky130/soc/constraints/sky130_soc_cdc_check.sdc): hierarchy survives only as dot-joined
escaped NET names and cells are anonymous, so the stage-0 Q net `<inst>.sync_q[0]...` is
found by name token, its driver is the capture flop, and the launch flops are the
from-domain startpoints in the fan-in of that flop's D pin. A miss is a hard error, not a
silent skip: an exception that matched nothing would put the 11.8 ns of padding back.

SCAN MODE (the reason this is not free). In scan capture the same test clock reaches both
trees, so this IS a real same-clock path and the exemption means the flow no longer repairs
its hold. What keeps that safe, and what is still UNVERIFIED, is recorded in
Doc: tm:pd:sky130-cdc-maxss:6-scan-mode-hold-the-approach-chosen-and-what-is-not-verified. Short form: a hold failure here can only corrupt
the captured value of the stage-0 flops (a test-response mismatch, never a functional
failure), those flops must be masked in the capture response, and the real scan-mode hold
slack is measured by re-sourcing this file with CVT_SDC_SCAN_VIEW=1 (below) after Stage 2
(bead j41m.8) has inserted chains. Until then it is NOT verified.

CVT_SDC_SCAN_VIEW=1 in the environment skips the exemption, i.e. gives the scan-mode timing
view of the same crossings (hold kept on tck -> tck). The flow never sets it; it exists so a
standalone STA of a finished run can measure the scan-mode exposure from this one file.
##############################################################################
\end{textblock}

\subsection*{Before: set\_false\_path -from [get\_ports cpu\_rst\_n\_i]}

\begin{textblock}
Second-domain reference reset (GH #92/#93). Same class as rst_n_i above: an
asynchronous reset feeding a cdc_reset_sync, so timing it against core_clk is
meaningless. This line was MISSING from 2026-08-02 (when cpu_rst_n_i became a
real top-level port) until 2026-09-26, and the gap was visible: two
cpu_rst_n_i recovery/removal hold violations appeared at the ss corners in
RUN_2026-09-20_19-46-05. They no longer appear once the resizer hold margins
were raised, but the constraint gap was real and is closed here so it cannot
resurface.
\end{textblock}

\subsection*{Before: set\_false\_path -from [get\_ports gpio\_in\_i]}

\begin{textblock}
GPIO inputs (Phase 6a, bead claude_verilog_test-ckc) — asynchronous external
pins. Same class as uart_rx_i / spi_miso_i below: gpio_controller.sv
synchronises EVERY pin through its own per-pin cdc_sync before anything
in core_clk uses it, so a setup/hold check from the pad against core_clk has
no physical meaning.

Measured, not assumed: this was the LAST remaining hold violation in the
design. RUN_2026-09-25_22-02-12 closed 68 of 71 hold violations via the
resizer hold-margin raise, and the 3 survivors were all the same path --
gpio_in_i[31] -> _60250_ (a cdc_sync stage-1 flop) at max_ss/nom_ss/
min_ss, worst -0.2456 ns. Every tt and ff corner was already clean.
\end{textblock}

\end{record}

\section{\texttt{sky130/soc/constraints/sky130\_soc\_cdc\_check.sdc}}\label{cr:pd:sky130-soc-cdc-check-sdc}

This section holds dated history that was in a comment of the source file. The text is unchanged. Each line has no leading comment marker and no indentation.

\begin{record}

\subsection*{Header comment}

\begin{textblock}

bead claude_verilog_test-j41m.5 (2026-10-16). Sky130 port of
\end{textblock}

\subsection*{Before: proc cdc\_net\_driver\_pins \{full\} \{}

\begin{textblock}

This check bounds FUNCTIONAL-mode clock-domain crossings. The scan enable tree (`dft_scan_en` -> the SE pin of
every scan flop) is not one: in functional mode it is constant 0, and in scan mode both domains run on the one
test clock. But the crypto wipe-done gate (PR #332) makes `dft_scan_en` = (TAP/pin request) & crypto_wipe_done,
a core_clk-launched path that reaches the 981 SE pins of the cpu_core_clk scan chain through a 28-buffer tree,
which an unconstrained check reads as a core_clk -> cpu_clk crossing (measured -1.581 ns at max_ss against the
0.9 x 25 ns domain-wide fallback, RUN_2026-10-27_05-40-27).

The functional view pins the three controls that make the request 0:
  scan_mode_i = 0 and scan_en_i = 0 (the pin leg, as sky130_soc.sdc does), and the TAP serial-select flop
  `u_dft_ctrl.tap_serial` = 0 (TAP not in serial scan; it selects tap_scan_en over the pin leg).
scan_mode_i alone does NOT make dft_scan_en constant (scan_en_o is not gated by scan_mode, and the TAP can raise
scan_mode itself), measured: with only scan_mode_i = 0 the crossing still fails. With the three, the request is a
constant 0, so the AND (and its resizer clone) is constant and the SE tree drops out. Every other group is
unchanged (22 groups, same worst slacks): see Doc: tm:ch:dft-architecture 14.14.1.

The SCAN VIEW is not affected: CVT_SDC_SCAN_VIEW=1 in the environment skips this section (same switch as
sky130_soc.sdc), and sky130_soc.sdc itself is not touched by this section.
##############################################################################
\end{textblock}

\end{record}

\section{\texttt{sky130/soc/macro\_placement.cfg}}\label{cr:pd:sky130-soc-macro-placement-cfg}

This section holds dated history that was in a comment of the source file. The text is unchanged. Each line has no leading comment marker and no indentation.

\begin{record}

\subsection*{Header comment}

\begin{textblock}
THREE hard macros since Phase 6 Gate B (bead f7vs.15, 2026-10-04): CPU
(rv32i_cpu_top) + SRAM (sky130_sram_4kbyte_1rw1r_32x1024_8, a freshly-
compiled OpenRAM macro) + a SECOND instance of that same SRAM cell for the
INT8 NPU's weight memory (see the "NPU weight SRAM" block below).
(The history in this paragraph describes the two-macro Stage-2 design.) GH #104 UPDATE (2026-07-23/24): this
REVERSES the earlier Option C behavioral-SRAM revert. The prior custom-
hardened composite sram_controller macro (whole AXI4 wrapper + memory
array hardened as one ~2585x2595um block) is ABANDONED -- it hit an
unresolved ~7,400-node PSM-0069 VPWR/VGND connectivity gap that survived
ring removal, instance-specific grids, and precisely-anchored straps
(see memory/pd/run_state.md for the full multi-round diagnostic trail).
Instead, only the raw OpenRAM SRAM primitive is now a hard macro: a
fresh sky130_sram_4kbyte_1rw1r_32x1024_8 compile (1024 x 32b, 4 KB,
1RW+1R), instantiated as u_sram_macro inside the still-synthesisable
rtl/soc/sram_controller.sv control-logic RTL. Flattened into the
top-level netlist it becomes instance path `u_sram.u_sram_macro`
(CONFIRMED via a Yosys.Synthesis-only probe run, tag
SRAM_MACRO_SYNTH_PROBE, before writing this file -- do not guess this
name, dot-separator is Yosys's default `flatten` naming and differs
from the slash convention used under SYNTH_HIERARCHY_MODE=keep).
This macro has a standard OpenRAM PG abstract (vccd1/vssd1 on
met3+met4) already proven connectable -- rv32i_cpu_top's own 10
internal OpenRAM SRAMs (from its Stage-1 P&R) are PSM-0040 clean with
an identical pin style. It is also ~14x smaller in area (701.64 x
673.335 um, confirmed from the generated LEF) than the failed
composite block, giving far more floorplan headroom than before.

\end{textblock}

\subsection*{Header comment}

\begin{textblock}

CPU macro: rv32i_cpu_top (regenerated balanced-pin GDS, RUN_2026-07-21_18-02-11)
  - Footprint: 3600 x 1800 um
  - x_origin = 150 (unchanged, no observed X-direction violations)
  - y_origin = 207.0 (= 6.9 x 30, exact GRT GCell-grid multiple -- see
    GH #104 GRT-0118 root-cause writeup, still valid and unaffected by
    the SRAM-macro re-addition)
  - Occupies: (150, 207.0) to (3750, 2007.0)

SRAM macro: sky130_sram_4kbyte_1rw1r_32x1024_8 (OpenRAM compile,
  views_run.log, 2026-07-23/24, check_lvsdrc=False views-first pass)
  - Footprint: 701.64 x 673.335 um (confirmed from the generated LEF)
  - x_origin = 4209.0 (= 6.9 x 610, exact GRT GCell-grid multiple, same
    alignment discipline that fixed CPU's GRT-0118 congestion)
  - y_origin = 207.0 (= 6.9 x 30, same GCell row as CPU's south edge --
    places the two macros side by side on a shared alignment line)
  - Occupies: (4209.0, 207.0) to (4910.64, 880.335)
  - Clearance from CPU's right edge (x=3750): 459 um gap -- the failed
    composite SRAM macro only ever had a fraction of this slack at this
    die size; this macro's much smaller footprint gives far more
    escape-routing room on every side.
  - Clearance to core right edge (x=6680): 1769.36 um.

NPU weight SRAM (Phase 6c, bead f7vs.11; placed by Gate B, bead f7vs.15):
  a SECOND instance of the same sky130_sram_4kbyte_1rw1r_32x1024_8 cell, so
  the footprint, LEF, PG abstract and orientation are identical to the SoC
  SRAM above. Instance path READ from a Yosys.Synthesis-only probe of the
  Gate-B netlist (run tag GATEB_NPU_SRAM_PROBE; sv2v with
  --define=SRAM_SKY130), NOT guessed:
      \u_npu.g_on.u_wmem.u_sram_macro        (netlist: escaped identifier)
  i.e. u_npu -> generate block g_on -> u_wmem (npu_weight_mem) ->
  u_sram_macro. Note the two intermediate segments: the obvious guess
  "u_npu.u_sram_macro" would have been wrong. The same probe shows exactly 2
  instances of the 4 KB cell and the existing u_sram.u_sram_macro path
  unchanged. `\` is the Verilog escape and is not part of the name.
  - Footprint: 701.64 x 673.335 um (same LEF)
  - x_origin = 5078.4 (= 6.9 x 736, exact GRT GCell-grid multiple).
    NB 5078.1 is NOT a multiple (5078.1 / 6.9 = 735.96); 6.9 x 736 = 5078.4.
    Checked with exact decimal arithmetic, together with 4209.0 (6.9 x 610)
    and 207.0 (6.9 x 30), which are unchanged.
  - y_origin = 207.0 (= 6.9 x 30, same GCell row and same south alignment
    line as the CPU and the SoC SRAM -- all three macros share one baseline)
  - Occupies: (5078.4, 207.0) to (5780.04, 880.335)
  - Clearance from the SoC SRAM's right edge (x=4910.64): 167.76 um. The PDN
    macro grid uses -halo "10 10" (pdn.tcl), so each macro reserves 10 um
    per side and the two halos (20 um total) leave ~148 um of free channel
    between them for escape routing. That is narrower than the CPU<->SRAM
    gap (459 um); the gap is a judgement call, not a measured requirement --
    the Gate-B run's GRT/DRT congestion result is the test of it.
  - Clearance to core right edge (x=6680): 899.96 um.
  - Clearance below the south edge (core bottom y=20): 187 um, the same
    space the existing SRAM already routes its south-edge pins through (the
    LEF's signal pins are predominantly on the south/north edges).
  Why right of the SoC SRAM and not stacked above it: the strip
  x in [4910.64, 6680] x y in [20, 3080] is macro-free core, so the
  same-baseline row reuses the proven south alignment line and the same
  macro-grid (met4/met5) stitching as the existing SRAM, and leaves the band
  above both SRAMs free for standard cells. Stacking above (earliest GCell-
  aligned y is 6.9 x 128 = 883.2, before any halo/escape clearance) was the
  alternative; it would put the NPU weight memory directly between the SoC
  SRAM and the standard-cell logic above it. Not measured either way.
  Power: matched by config.json's PDN_MACRO_CONNECTIONS regex
  ".*u_sram_macro.*  VPWR VGND vccd1 vssd1" (substring match on the leaf
  name, no config edit). That this actually binds is VERIFIED from the run's
  own PDN/PSM output, not assumed -- see the Gate-B record in the bead.

\end{textblock}

\end{record}

\section{\texttt{sky130/soc/pdn.tcl}}\label{cr:pd:sky130-soc-pdn-tcl}

This section holds dated history that was in a comment of the source file. The text is unchanged. Each line has no leading comment marker and no indentation.

\begin{record}

\subsection*{Header comment}

\begin{textblock}
Die: 6700 x 3100 um (GH #104 clearance fix, 2026-07-22).  Single power
  domain (VPWR/VGND at 1.8 V).

*** KNOWN LIMITATION, SEE constraints/sky130_soc.sdc HEADER FOR FULL
DETAIL. UPDATED 2026-07-25: rv32i_cpu_top is NOW characterized
per-corner (9 exact corner keys -> 9 distinct Liberty views, verified
from each corner's own sta.log). Only sky130_sram_4kbyte_1rw1r_32x1024_8
remains nom_tt-only, wildcarded to every PVT corner, and it is now the
SOLE source of this limitation (GH #120 / bead o1i).

The fix showed the earlier "ss hold is pessimistic" reasoning was WRONG:
with real per-corner CPU libs, hold got WORSE (max_ss -0.0708 ->
-0.3997 ns; nom_tt +0.1807 MET -> -0.0923 VIOLATING), and max_ss setup
went -5.3197 -> -10.4730 ns. The wildcard was optimistic in BOTH
directions. CAVEAT: that run also enabled antenna repair (+2018 diodes,
perturbing routing), so the deltas are not cleanly attributable to the
libs alone. Still a TYPICAL-CORNER (nom_tt) sign-off -- and even nom_tt
now carries a hold violation. Do not let a summary imply otherwise. ***

KNOWN LIMITATION (GH #104, 2026-07-24): sky130_sram_4kbyte_1rw1r_32x1024_8
is NOT KLayout-DRC-clean. Full-deck KLayout DRC (sky130A_mr.drc, the
authoritative signoff deck) on the Stage-2 sign-off GDS
(RUN_2026-07-24_09-58-19) found exactly 4 real violations, ALL inside
this macro's own OpenRAM-generated internal cells (confirmed via a
standalone full-deck KLayout run on the macro's raw GDS alone, with NO
SoC context: identical violations, identical coordinates -- proving
they are inherent to the macro compile, not introduced or fixable by
any SoC-level PDN/floorplan/routing change):
  m2.2   (met2 spacing <0.14um) x1 -- cell ..._wmask_dff,
          measured 0.055um -- ~60% SHORT of spec (the most significant
          of the four; NOT rounded away).
  via2.2 (via2 spacing <0.2um)  x2 -- cell sky130_sram_4kbyte_1rw1r_32x1024_8
          (macro top) and cell ..._bank, both measured 0.125um -- ~37.5%
          short of spec.
  m3.2   (met3 spacing <0.3um)  x1 -- cell ..._bank, measured 0.29um --
          ~3% short (~1nm); plausibly a grid-rounding/floating-point
          boundary artifact in OpenRAM's geometry engine, but still
          technically non-conformant -- not waved off as pure noise.
ROOT CAUSE: this macro was compiled views-first with check_lvsdrc=False
(a deliberate choice made after the check_lvsdrc=True extraction pass
died to a host reboot at the ~7h mark -- see memory/pd/run_state.md).
OpenRAM's own DRC therefore never ran on this macro at all. Enabling
check_lvsdrc=True would have REPORTED these same 4 violations but not
fixed them: OpenRAM's layout generation is deterministic from its
module code and config (compiler/modules/bank.py, and the generic
dff_array factory type instantiated as wmask_dff) -- the checker only
observes geometry the generator already committed to, it does not
iterate or auto-remediate.
SCOPE: confirmed via compiler/modules/bank.py (OpenRAM's own top-level
bank-assembly Python class) and by searching the installed
sky130_fd_bd_sram foundry-primitive library (zero matches for
"wmask_dff"/"bank") that these violations sit in OpenRAM's GENERATED
ASSEMBLY layer, not in a foundry-drawn hand-crafted primitive cell.
They are NOT caused by, and NOT fixable via, this project's SoC
integration work (PDN grid, floorplan, macro placement, or routing).
USER DECISION (2026-07-24): accept + document, do not patch the GDS,
do not retry the OpenRAM config, do not attempt a DRC-clean regenerate
at this time. Rationale: upstream OpenRAM-generator issues, provably
unfixable at the SoC level (proven by the standalone-macro isolation
test above); a GDS-level hand-patch would break reproducibility from
the OpenRAM config and is not a sustainable fix. The Stage-2 milestone
value -- proving the SoC integrates and clears PSM-0040/GRT/DRT/LVS
end-to-end on a real, fabricatable PDK with a genuine OpenRAM hard
macro -- holds regardless of this open item.
SIGN-OFF RECORD PHRASING: this is NOT "KLayout DRC clean". State it as
"KLayout DRC: 4 violations, all macro-internal, upstream OpenRAM
generator, accepted+documented". Do not let a summary imply a clean
full-chip DRC signoff.
FOLLOW-UP: CLOSED WON'T-FIX 2026-07-25 (GH #121, bead
claude_verilog_test-0jp). Evidence for the acceptance: efabless's own
prebuilt sky130_sram_2kbyte_1rw1r_32x512_8 -- the macro used in real
MPW silicon -- ships 32 magic DRC errors in its OWN committed OpenRAM
build log, and is likewise "Analytical model enabled" / "Only
generating nominal corner timing" with a single _TT_1p8V_25C.lib. The
repo has no 4 KB 32x1024_8 variant to swap to. These 4 violations are
OpenRAM generator norm, not a consequence of our check_lvsdrc=False
shortcut (OpenRAM geometry is deterministic; the checker only reports).
Re-open trigger: a genuine tape-out-readiness review.

RE-CONFIRMED 2026-07-25 at RUN_2026-07-25_13-29-40: still EXACTLY 4,
same rules and same cells (m2.2 in ..._wmask_dff; via2.2 x2 in macro-top
and ..._bank; m3.2 in ..._bank). Notably this run inserted 2018 antenna
diodes and re-routed, and introduced ZERO new KLayout violations --
so the antenna flow is DRC-safe. Magic DRC also unchanged at 9081
(nwell.4 = 9049 + met4.4a = 32, the known artifact class).

KNOWN LIMITATION (GH #104, 2026-07-24): IR-drop analysis
(OpenROAD.IRDropReport) is NOT meaningful for this flow -- VSRC_LOC_FILES
is unset (in this config AND in pnr/sky130/cpu/config.json; a
pre-existing, project-wide gap, not introduced here). Without a real
power-source location, analyze_power_grid has nothing to source current
from, producing physically nonsensical IR numbers (observed: "Worstcase
IR drop: 6.48e+06 V" on a 1.8 V supply). This is documented, expected
LibreLane behavior absent VSRC_LOC_FILES, not a bug. Setting
VSRC_LOC_FILES requires real bond-pad/bump (x,y) locations from a
padframe or package map -- this design has NO padframe defined at this
project phase (direct I/O ports, no pad ring), so any such file written
now would be an invented, unfounded coordinate set. Deliberately NOT
fabricated. Revisit once a package/bump plan exists in a future phase.
PSM-0040 connectivity ("all shapes connected") IS meaningful and clean
regardless -- it is the real signal from this PDN flow, not IR drop.

GH #104 UPDATE (2026-07-23/24, REVERSES Option C): the sram_controller
module's backing store is a hard macro again -- but NOT the old
custom-hardened composite block (whole AXI4 wrapper + array hardened as
one unit) that hit the persistent ~7,400-node PSM-0069 VPWR/VGND gap
documented in memory/pd/run_state.md (ring removal, instance-specific
grids, precisely-anchored straps -- never fully closed). That approach
is abandoned. Instead, only the raw sky130_sram_4kbyte_1rw1r_32x1024_8
OpenRAM primitive is now a hard macro (instance path
u_sram.u_sram_macro post-flatten), with a STANDARD OpenRAM PG abstract
(vccd1/vssd1 on met3+met4) -- the same style as rv32i_cpu_top's own 10
internal OpenRAM SRAMs, which are PSM-0040 clean. TWO hard macros now:
rv32i_cpu_top (VPWR/VGND, met4) + sky130_sram_4kbyte_1rw1r_32x1024_8
(vccd1/vssd1, met3+met4).

CPU macro (rv32i_cpu_top, regenerated balanced-pin GDS RUN_2026-07-21_18-02-11)
  occupies (150,207.0)-(3750,2007.0), 3600 x 1800 um. y_origin=207.0
  (Run 12 GCell-grid-alignment fix, 2026-07-22 -- see macro_placement.cfg
  for the full GRT-0118 root-cause writeup: GRT's GCell tile pitch is a
  fixed 6.9um technology constant; 207.0 = 6.9*30 lands the macro's south
  edge exactly on a tile boundary instead of straddling one).
  VPWR/VGND on met4 (V-stripes from Stage-1 P&R).
  PDN status: CONFIRMED CLEAN (PSM-0040, "all shapes connected") after
  removing the add_pdn_ring call below (Test Fix 2, GH #104) -- verified
  via a genuinely fresh -T OpenROAD.GeneratePDN run
  (RUN_2026-07-22_18-16-30): 0 violations attributable to u_cpu anywhere
  in the design.

PDN topology:
  met1  — followpins (horizontal standard-cell rails)
  met4  — vertical stripes (pitch=200 um, width=3.1 um)
  met5  — horizontal stripes (pitch=100 um, width=3.1 um)

Run 8 GRT-0118 diagnosis (RUN_2026-07-19_11-13-47): congestion was NOT a
global-capacity or macro-channel-gap issue (global GRT usage only 11%).
It was 100% localized to the CPU macro's own footprint/top-edge
pin-access region -- CPU's 565 pin RECTs were heavily concentrated on
its TOP edge (256 of 565) in the pre-regen macro. Root cause: CPU macro
pin skew, fixed by regenerating with a balanced pin_order.cfg
(N=95/S=97/E=113/W=96). See memory/pd/run_state.md for the full
GRT-0118 -> grid-alignment -> GRT_MACRO_EXTENSION resolution chain
(Runs 8-13) -- GRT is now confirmed fully clean (0/0/0 overflow) and
detailed routing confirmed 0 DRT violations on the real flow.

GRT_MACRO_EXTENSION is set to 0 in config.json (was 2) -- confirmed via
controlled A/B test on the post-grid-alignment-fix floorplan that this
clears the last few GCell-row overflow units near the CPU's escape
routes; a genuine routing-margin parameter, not a congestion mask.
##############################################################################
\end{textblock}

\subsection*{Before: define\_pdn\_grid \textbackslash{}}

\begin{textblock}
##############################################################################
Hard-macro PDN grid — CPU + SRAM, shared stock default-macro grid

u_cpu uses standard VPWR/VGND power pins on met4.
u_sram.u_sram_macro (sky130_sram_4kbyte_1rw1r_32x1024_8) uses OpenRAM's
standard vccd1/vssd1 pins, present as PORT rects on BOTH met3 (top/
bottom ring segments) and met4 (left/right ring segments) -- confirmed
from the generated LEF.

GH #104 Test Fix 2 (2026-07-22): REMOVED add_pdn_ring around macros.
Root-cause comparison against the STOCK LibreLane pdn_cfg.tcl (which
keeps CPU-alone's own PDN -- including its OWN internal SRAM hard
macros from Stage-1 P&R -- fully clean, PSM-0040) shows the stock
script's default macro grid does ONLY `define_pdn_grid -macro -default`
+ `add_pdn_connect -grid macro -layers "$V $H"` -- it never calls
add_pdn_ring around macros at all. Matching that exactly here fixed
u_cpu's connectivity completely (confirmed clean, 0 violations).

GH #104 (2026-07-23/24): kept this SAME stock, ring-less, single shared
"-macro -default" grid for the newly re-added SRAM macro rather than
writing an instance-specific grid -- per the lesson from the failed
composite macro, the stock path (proven on CPU + its internal OpenRAM
SRAMs) has a real chance where hand-rolled instance-specific
rings/straps did not.

GH #104 FIX -- CONFIRMED (2026-07-24): the "met3 met4" connect
(originally added alongside "met4 met5" so the SRAM's met3-layer PG pin
rects would also be via-stitched, since the LEF exposes vccd1/vssd1 on
BOTH met3 and met4) was REMOVED after Magic.DRC on the canary run
(RUN_2026-07-24_05-27-21) found 32 met4.4a (Metal4 minimum area
<0.24um^2) violations, ALL confined to the SRAM macro's footprint, ALL
sitting exactly on its bottom-edge LEF-boundary row (y=0-0.38um
macro-local), each a uniform 0.38x0.38um (0.1444 um^2) square -- classic
via-landing-pad geometry generated by the met3->met4 via stitching
itself, not scattered/random defects.

CONFIRMED via a controlled experiment (run tag
SRAM_MET3_REMOVED_EXPERIMENT, -T Magic.DRC, this exact connect line
removed, everything else identical): PSM-0040 stays fully clean on
BOTH VPWR and VGND with ZERO unconnected shapes -- the macro's met4 PG
pin rects (left/right ring segments) alone are sufficient for the
"met4 met5" connect to fully stitch it to the grid; the met3 path was
never load-bearing for connectivity. Removing it is a strict
improvement: eliminates 32 real undersized-metal geometry defects with
zero connectivity cost. See memory/pd/run_state.md for the full
experiment record and the sign-off run's Magic.DRC confirmation that
met4.4a drops to 0.
##############################################################################
\end{textblock}

\end{record}

\section{\texttt{sky130/soc/plugin/librelane\_plugin\_cvt\_sky130/tcl/rc\_calibration.tcl}}\label{cr:pd:sky130-soc-plugin-librelane-cvt-tcl-rc-calibration}

This section holds dated history that was in a comment of the source file. The text is unchanged. Each line has no leading comment marker and no indentation.

\begin{record}

\subsection*{Header comment}

\begin{textblock}
Project-local wire-RC calibration for the pre-route estimate (bead claude_verilog_test-e45j).

WHY: `estimate_parasitics -global_routing` on sky130 uses ground-only per-layer C from the tech
LEF (met1 0.085 fF/um ... met5 0.088 fF/um) -- no coupling or fringe. Measured on
RUN_2026-10-05_06-50-11 (estimate dumped with `-spef_file` vs OpenRCX SPEF of the SAME nets,
17 525 nets with C > 5 fF), total-cap and total-resistance ratio RCX / estimate:

    RC corner   sum C      sum R
    min         1.69       0.62
    nom         1.88       1.02
    max         2.04       1.91

Every repair step (28/37/40) therefore sized buffers against about half the real wire C, and the
first look at real RC is STAPostPNR (step 51): max_ss slew 7622 vs 307 at the GRT estimate
(scripts/cvt_diag, bead e45j notes). This proc scales the per-layer RC used by the estimator
per STA corner so the resizer sees what OpenRCX will later extract.

\end{textblock}

\end{record}

\chapter{Test benches}\label{cr:ch:test-benches}

This chapter holds the history text of the test benches.

\chapter{Build files}\label{cr:ch:build-files}

This chapter holds the history text of the build files.
