chuanseng-ng/claude_verilog_test/fixes/README.md

# RTL Fixes Documentation

This directory contains comprehensive documentation of all RTL bugs discovered and fixed during Phase 1 development (2026-01-19 to 2026-01-29).

## Quick Start

**👉 Start here**: [FIXES_INDEX.md](FIXES_INDEX.md)

The FIXES_INDEX provides:
- Summary table of all fixes
- Quick reference by severity and date
- Direct links to detailed fix documents
- Impact analysis
- Test results

## Directory Structure

```
fixes/
├── README.md                    # This file
├── FIXES_INDEX.md              # ⭐ Central reference - START HERE
├── CRITICAL_FIXES.md           # Critical AXI protocol fixes (2026-01-19)
├── RTL_BUG_FIXES.md            # Branch/jump/memory fixes (2026-01-24)
├── RTL_DEBUG_REPORT.md         # Debug analysis report (2026-01-24)
├── TIMING_ANALYSIS.md          # Test timing fixes (2026-01-25)
├── RTL_ISA_TEST_FIX.md         # ISA test fixes (2026-01-25)
├── TEST_FIX_SUMMARY.md         # Test infrastructure improvements (2026-01-25)
├── EBREAK_BUG_FIX.md           # EBREAK halt detection (2026-01-28)
└── PC_MISMATCH_FIX.md          # PC logging cleanup (2026-01-28)
```

## Fix Categories

### Critical Fixes (CPU Non-Functional Without)
1. **CRITICAL_FIXES.md** - AXI protocol compliance
   - Incorrect read/write timing in FETCH and MEM_WAIT states
   - Missing AXI address mux
   - Impact: CPU completely non-functional

### High Priority Fixes (Instructions Failed)
2. **RTL_BUG_FIXES.md** - Core instruction execution
   - Branch/jump timing (registered decision flag)
   - Load data latching
   - Register file combinational reads
   - Impact: 16 instructions failed → All 37 passing

### Medium Priority Fixes (Test/Debug Issues)
3. **TIMING_ANALYSIS.md** - Test timing robustness
4. **RTL_ISA_TEST_FIX.md** - Test infrastructure
5. **EBREAK_BUG_FIX.md** - Debug interface

### Low Priority Fixes (Cosmetic/Documentation)
6. **TEST_FIX_SUMMARY.md** - Test improvements
7. **PC_MISMATCH_FIX.md** - Logging cleanup
8. **RTL_DEBUG_REPORT.md** - Analysis record

## How to Use This Documentation

### For Understanding a Specific Bug
1. Check **FIXES_INDEX.md** table for the fix you're interested in
2. Click the link to the detailed fix document
3. Read the problem, impact, and solution sections

### For Understanding the Overall Fix History
1. Read **FIXES_INDEX.md** "Fix Timeline" and "Impact Summary" sections
2. See how bugs were discovered and resolved chronologically
3. Understand cumulative impact on test coverage

### For Implementing Similar Fixes
1. Read the relevant fix document (e.g., CRITICAL_FIXES.md for AXI issues)
2. Study the "Before/After" code examples
3. Check validation sections for test approaches
4. Apply similar patterns to new bugs

### For Code Review
1. Use FIXES_INDEX.md to understand what files were modified
2. Check severity ratings to prioritize review
3. Verify fixes are validated through tests

## Fix Validation Status

All fixes in this directory are:
- ✅ **Applied to RTL** - Code changes committed
- ✅ **Validated** - Tests pass demonstrating fix works
- ✅ **Documented** - Complete before/after analysis

Current test status:
- ISA compliance: 37/37 tests passing (100%)
- Random tests: 10,000 instructions, 0 failures
- Phase 1 exit criteria: 5/9 met (56%)

## Related Documentation

### Main Project Docs
- `../CLAUDE.md` - Project overview and workflow
- `../TODO_PHASE1_VERIFICATION.md` - Verification progress tracking
- `../README.md` - Repository overview

### Design Specs
- `../docs/design/PHASE1_ARCHITECTURE_SPEC.md` - CPU architecture
- `../docs/design/RTL_DEFINITION.md` - Signal definitions
- `../docs/verification/VERIFICATION_PLAN.md` - Test strategy

### Test Documentation
- `../docs/RANDOM_TESTS_STATUS.md` - Random test results

## Maintenance

### When to Add New Fix Documents
Create a new fix document when:
1. An RTL bug is discovered and requires code changes
2. The fix is non-trivial (affects behavior or multiple files)
3. The issue could recur or help others understand the design

### Document Naming Convention
- `<CATEGORY>_<DESCRIPTOR>_FIX.md` for bug fixes
- `<CATEGORY>_<DESCRIPTOR>_REPORT.md` for analysis
- Use CRITICAL/RTL/TEST prefix for category

### Update FIXES_INDEX.md
When adding a new fix document:
1. Add entry to the "Quick Reference" table
2. Add date to "Fix Timeline"
3. Create new section with summary
4. Update "Impact Summary" statistics
5. Update "Verification Status"

## Questions?

For questions about:
- **Specific fixes**: Read the individual fix document
- **Overall fix history**: See FIXES_INDEX.md
- **Current project status**: See ../TODO_PHASE1_VERIFICATION.md
- **How to work on the project**: See ../CLAUDE.md

---

**Last Updated**: 2026-01-29
**Total Fixes Documented**: 8
**Lines of RTL Fixed**: ~200
**Test Coverage**: 100% ISA compliance, 10,000 random instructions
