chuanseng-ng/claude_verilog_test/fixes/TEST_FIX_SUMMARY.md

# ISA Compliance Test Fix Summary

## Status: 33/37 Tests PASSING ✅

## Root Cause Identified and Fixed

### Problem

The ISA compliance tests were failing because of a **reset timing issue**:

1. Original sequence: Reset → Wait 2 cycles → Halt CPU
2. During those 2 cycles, CPU executed 1-2 instructions with registers still at 0
3. Debug register writes happened AFTER instructions already executed

### Solution

Created two reset functions:

- `reset_dut()` - Normal reset, CPU starts running (for tests using ADDI to set registers)
- `reset_dut_halted()` - Reset with halt asserted, CPU starts in HALTED state (for tests using debug writes)

### Implementation

Modified `reset_dut_halted()` to assert halt via APB BEFORE releasing reset, ensuring CPU starts in HALTED state.

## Test Results

### PASSING (33/37) ✅

- **All ALU operations** (15): ADD, SUB, AND, OR, XOR, SLL, SRL, SRA, SLT, SLTU
- **All immediate operations** (8): ADDI, ANDI, ORI, XORI, SLLI, SRLI, SRAI, SLTI, SLTIU
- **Upper immediate** (2): LUI, AUIPC
- **All branch instructions** (6): BEQ, BNE, BLT, BGE, BLTU, BGEU ✅ **FIXED!**
- **Jump register** (1): JALR ✅ **FIXED!**
- **All load instructions** (5): LW, LH, LHU, LB, LBU ✅ **FIXED!**

### FAILING (4/37) ❌

- **JAL** - Second subtest (backward jump) fails
- **SW, SH, SB** - All store instructions fail

## Remaining Issues

### 1. JAL Backward Jump Test

**Symptom**: x2 = 0 (expected 0x104)

**Test Structure**:

```python
# First test uses run_single_instruction_test (PASSES)

# Second test:
mem.write_word(0x00000100, 0xFF9FF0EF)  # JAL x2, -8
await dbg.halt_cpu()  # CPU already halted from first test
await dbg.write_gpr(2, 0)
await dbg.apb_write(dbg.DBG_PC, 0x00000100)  # Set PC to 0x100
await dbg.resume_cpu()
# x2 should be 0x104 but is 0
```

**Possible Causes**:

- PC write might not work between subtests
- Memory at 0x100 might not be properly initialized
- CPU state from first test interfering

**Next Steps**:

- Add signal monitoring to see actual PC during execution
- Verify memory at 0x100 contains correct instruction
- Consider adding explicit reset between subtests

### 2. Store Instructions (SW, SH, SB)

**Symptom**: Memory written as 0x00000000 instead of register value

**Test Structure**:

```python
mem.write_word(0x00000000, 0x00212023)  # sw x2, 0(x1)
await reset_dut_halted(dut)  # CPU starts HALTED
await dbg.halt_cpu()  # Already halted, should be no-op
await dbg.write_gpr(1, 0x2000)
await dbg.write_gpr(2, 0xCAFEBABE)
await dbg.resume_cpu()
# Memory at 0x2000 should be 0xCAFEBABE but is 0x00000000
```

**Possible Causes**:

- Register write x2=0xCAFEBABE not persisting
- SW instruction reading x2=0 during execution
- Different from load/branch tests which work correctly

**Next Steps**:

- Create minimal SW test with signal monitoring
- Check if x2 actually contains 0xCAFEBABE during EXECUTE state
- Compare with working LW test to see difference

## Investigation Done

### Debug PC Write

✅ **VERIFIED WORKING** - Created test showing PC writes work correctly when CPU is halted

### Debug Register Write Persistence

✅ **VERIFIED WORKING** - Created test showing register writes persist and branches work correctly

### Reset Timing

✅ **FIXED** - Implemented `reset_dut_halted()` to ensure CPU starts in correct state

## Files Modified

1. `tb/cocotb/cpu/test_isa_compliance.py`
   - Added `reset_dut_halted()` function
   - Updated 16 test functions to use `reset_dut_halted()`
   - Branch, jump (JALR), load, and store tests

2. `rtl/cpu/core/rv32i_core.sv`
   - Removed redundant `dbg_halted` check in PC write (reverted - not the issue)

## Debug Tests Created

1. `tb/cocotb/cpu/test_pc_write_debug.py` - Verifies PC writes work ✅
2. `tb/cocotb/cpu/test_reg_write_debug.py` - Verifies register writes persist ✅
3. `tb/cocotb/cpu/test_bne_minimal.py` - Minimal BNE reproduction test ✅

## Next Actions

1. Debug JAL second subtest failure
2. Debug store instruction failures (SW, SH, SB)
3. Run full test suite to confirm 37/37 passing

## Key Learnings

- Test structure matters: memory must be loaded BEFORE reset
- Debug interface timing: CPU must be HALTED before writing registers
- Reset sequence: must prevent CPU from executing before register setup
- Signal monitoring essential for debugging RTL/test interactions
