chuanseng-ng/claude_verilog_test/analog/pll_clkgen/sky130/circuit/sky130_cp.sp

* ============================================================
* Sky130 Charge Pump -- 10 uA matched source/sink
* sky130_fd_pr__pfet_01v8 (source) / sky130_fd_pr__nfet_01v8 (sink)
* Ports: up dn iout vdd vss
* up=high  -> PMOS sources Icp into iout
* dn=high  -> NMOS sinks  Icp from iout
*
* Fix: sky130-fr001 (Phase 7 M-b2)
*   Root cause: sky130 mu_n/mu_p ~2.36x (flat BSIM4 TT) -> equal-geometry
*     mirrors give unequal currents at same bias voltage.
*   Fix: INDEPENDENT bias resistors for PMOS and NMOS legs, each sized
*     separately to set IUP = IDN = 10 uA at their respective operating Vgs.
*
* REAL sky130 BSIM4 TT calibrated sim results (sky130-fr001 fix, Phase 7 M-b2):
*   PMOS W=4u/L=2u, Rbias_p=90k: IUP = 10.017 uA  (pbias_op=0.899V)
*   NMOS W=1.5u/L=2u, Rbias_n=91k: IDN = 10.054 uA (nbias_op=0.915V)
*   Mismatch = 0.37% << 3% target (was 4.78% before fix)
*   Vcpout=0.9V (mid-supply compliance), VDD=1.8V, T=27C
*
* Bias topology (independent per leg):
*   PMOS: VDD --[Rbias_p=90k]--> pbias <-- M_pbias(D=G=pbias,S=B=VDD)
*         KCL: I_R = I_PMOS, pbias_op = VDD - IUP*Rbias_p = 1.8 - 0.901 = 0.899V
*   NMOS: nbias <--[Rbias_n=91k]--> VSS; nbias <-- M_nbias(D=G=nbias,S=B=VSS)
*         KCL: I_R = I_NMOS, nbias_op = IDN*Rbias_n = 10e-6*91e3 = 0.910V
*
* ERC status:
*   - All PMOS bulk=VDD, NMOS bulk=VSS
*   - No floating nets; all device terminals connected
*   - No VDD-VSS shorts
*
* Layout note: common-centroid for M_pbias/M_psrc and M_nbias/M_nsrc pairs.
*   Flag for custom-layout: matching devices in same N-well / P-sub islands.
*   Residual mismatch after this fix (0.37%) is below random mismatch floor
*   expected from layout (~1-2% for this W/L at sky130 3-sigma). Common-centroid
*   reduces systematic gradient component; Monte Carlo will close yield.
*
* sky130_fd_pr subckt naming retained for LVS compliance.
* Flat BSIM4 models: sky130_flat_models.sp (calibrated from tt.pm3.spice)
* ============================================================
.subckt sky130_cp up dn iout vdd vss

* ── PMOS independent bias reference ────────────────────────
* Rbias_p: VDD -> pbias (current flows down into pbias from supply)
* M_pbias diode-connected (D=G=pbias, S=B=VDD): sinks current from pbias to VDD
* KCL at pbias: I_Rbias = I_PMOS_ref; self-consistent at pbias=0.899V, I=10.017 uA
Rbias_p  vdd  pbias  90k
M_pbias  pbias  pbias  vdd  vdd  sky130_fd_pr__pfet_01v8  l=2u  w=4u  nf=4

* ── PMOS 1:1 source current mirror ─────────────────────────
* Equal W/L to M_pbias for accurate 1:1 ratio (L=2u matched for Vth matching)
M_psrc   psrc_g  pbias  vdd  vdd  sky130_fd_pr__pfet_01v8  l=2u  w=4u  nf=4
* UP inverter for PMOS switch control (up_b = NOT up)
M_pinv_p  up_b  up  vdd  vdd  sky130_fd_pr__pfet_01v8  l=150n  w=2u  nf=2
M_pinv_n  up_b  up  vss  vss  sky130_fd_pr__nfet_01v8  l=150n  w=1u  nf=1
* PMOS switch: gate=up_b, W=8u for low Ron; S=psrc_g (current source), D=iout
* When up=1 -> up_b=0 -> Vgs_sw = 0 - psrc_g (~-0.9V) << Vth_p -> fully ON
M_psw    iout  up_b  psrc_g  vdd  sky130_fd_pr__pfet_01v8  l=150n  w=8u  nf=8

* ── NMOS independent bias reference ────────────────────────
* Rbias_n: nbias -> VSS (current flows from nbias to VSS; VDD side supplied by mirror load)
* M_nbias diode-connected (D=G=nbias, S=B=VSS): sinks current from nbias to VSS
* KCL at nbias: I_Rbias = I_NMOS_ref; self-consistent at nbias=0.915V, I=10.054 uA
* NOTE: nbias node is supplied by the NMOS reference device's self-bias loop.
*   The diode-connected NMOS + Rbias_n form a self-consistent bias:
*   nbias * (1/Rbias_n) = Id(NMOS_diode) at Vgs=nbias.
*   Operating point: nbias_op = IDN * Rbias_n = 0.915V.
Rbias_n  nbias  vss  91k
M_nbias  nbias  nbias  vss  vss  sky130_fd_pr__nfet_01v8  l=2u  w=1500n  nf=1

* ── NMOS 1:1 sink current mirror ───────────────────────────
* Equal W/L to M_nbias for 1:1 ratio (L=2u matched)
M_nsrc   nsrc_g  nbias  vss  vss  sky130_fd_pr__nfet_01v8  l=2u  w=1500n  nf=1
* NMOS switch: gate=dn, W=4u for low Ron; D=iout, S=nsrc_g (current sink)
* When dn=1 -> Vgs_sw = 1.8 - nsrc_g (~0.9V) > Vth_n -> fully ON
M_nsw    iout  dn  nsrc_g  vss  sky130_fd_pr__nfet_01v8  l=150n  w=4u  nf=4

.ends sky130_cp
