chuanseng-ng/claude_verilog_test/rtl/cpu/rv32i_cpu_top.sv

// rv32i_cpu_top.sv
// RV32I CPU Top-Level Integration
// Integrates CPU core with AXI4 burst memory interface and APB3 debug interface

import axi_pkg::*;

module rv32i_cpu_top #(
    parameter logic [31:0] RESET_PC = 32'h0000_0000
) (
  // Clock and reset
  input  logic        clk_i,
  input  logic        rst_n_i,

  // ================================================================
  // AXI4 Master Interface (unified instruction/data, burst-capable Phase 5 M2)
  // ================================================================

  // Write address channel
  output logic [31:0] axi_awaddr_o,
  output logic [axi_pkg::AXI_LEN_WIDTH-1:0]  axi_awlen_o,
  output logic [axi_pkg::AXI_SIZE_WIDTH-1:0] axi_awsize_o,
  output logic [1:0]  axi_awburst_o,
  output logic        axi_awvalid_o,
  input  logic        axi_awready_i,

  // Write data channel
  output logic [31:0] axi_wdata_o,
  output logic [3:0]  axi_wstrb_o,
  output logic        axi_wlast_o,
  output logic        axi_wvalid_o,
  input  logic        axi_wready_i,

  // Write response channel
  input  logic [1:0]  axi_bresp_i,
  input  logic        axi_bvalid_i,
  output logic        axi_bready_o,

  // Read address channel
  output logic [31:0] axi_araddr_o,
  output logic [axi_pkg::AXI_LEN_WIDTH-1:0]  axi_arlen_o,
  output logic [axi_pkg::AXI_SIZE_WIDTH-1:0] axi_arsize_o,
  output logic [1:0]  axi_arburst_o,
  output logic        axi_arvalid_o,
  input  logic        axi_arready_i,

  // Read data channel
  input  logic [31:0] axi_rdata_i,
  input  logic [1:0]  axi_rresp_i,
  input  logic        axi_rvalid_i,
  input  logic        axi_rlast_i,
  output logic        axi_rready_o,

  // ================================================================
  // APB3 Slave Interface (debug/control)
  // ================================================================

  input  logic [11:0] apb_paddr_i,
  input  logic        apb_psel_i,
  input  logic        apb_penable_i,
  input  logic        apb_pwrite_i,
  input  logic [31:0] apb_pwdata_i,
  output logic [31:0] apb_prdata_o,
  output logic        apb_pready_o,
  output logic        apb_pslverr_o,  // Asserted on writes to read-only CSR debug registers

  // ================================================================
  // Commit Interface (verification observability)
  // ================================================================

  output logic        commit_valid_o,
  output logic [31:0] commit_pc_o,
  output logic [31:0] commit_insn_o,
  output logic        trap_taken_o,
  output logic [3:0]  trap_cause_o,

  // Debug outputs for troubleshooting (added for phase 1 verification)
  output logic [31:0] debug_rs1_data_o,
  output logic [31:0] debug_rs2_data_o,
  output logic        debug_branch_taken_o,
  output logic        debug_take_branch_jump_o,
  output logic        debug_pc_src_o,
  output logic [3:0]  debug_state_o,
  output logic        debug_ebreak_o,

  // ================================================================
  // Interrupt Inputs (Phase 2)
  // ================================================================
  input  logic        ext_irq_i,       // External interrupt (M-mode MEIP)
  input  logic        timer_irq_i,     // Timer interrupt (M-mode MTIP)

  // ================================================================
  // DFT test boundary (Doc: tm:ch:dft-architecture 14.10)
  // ================================================================
  // Inactive values (functional mode, bit-identical to the pre-DFT macro):
  // scan_mode_i = 0, scan_en_i = 0, scan_in_i = 0.
  //
  // No scan_clk and no scan_rst_ni port. clk_i is the test clock in scan mode. rst_n_i is the only reset and is synchronous.
  input  logic        scan_mode_i,     // 1 = test mode (quasi-static)
  input  logic        scan_en_i,       // 1 = shift, 0 = capture (consumer arrives with Stage 2 insertion)
  input  logic [1:0]  scan_in_i,       // chain inputs  (placeholder until Stage 2 insertion)
  output logic [1:0]  scan_out_o,      // chain outputs (tied 0 until Stage 2 insertion)

  // ================================================================
  // MBIST boundary (Doc: tm:ch:dft-architecture 16.7)
  // ================================================================
  // 96 quasi-static pins, no timing path other than the ordinary sync-to-clk_i. Inactive values
  // (functional mode, bit-identical to the pre-MBIST macro): mbist_run_i = 0, mbist_cfg_i = 0.
  // mbist_run_i / mbist_cfg_i come from the CPU-domain holding register of soc_top's soc_mbist
  // (mbist_xing, ungated cpu_core_clk; the same frequency/source as clk_i = cpu_gated_clk). The status
  // block returns through mbist_status_sync into the TCK domain. Layout: section 16.5 (one 69-bit block).
  input  logic        mbist_run_i,     // level: 1 starts the selected algorithm, 0 aborts and clears
  input  logic [25:0] mbist_cfg_i,     // alg, bg_sweep, bg_sel, pause_mant/exp, mask_sel, rd_sel
  output logic [68:0] mbist_status_o   // done busy cfg_err fail_any fail[9:0] record mask
);

  // ================================================================
  // DFT seam
  // ================================================================
  // test_en forces the cache SRAM clock gates open (ASAP7 arm). It is scan_mode_i | mb_en_w, and mb_en_w is bist_en_o of this macro's MBIST controller.
  // In the Sky130 arm the macro has no clock gate. u_cpu_cg in soc_top must be forced open for an MBIST run; it carries the TAP-launched mbist_force.
  logic test_en_w;
  logic mb_en_w;
  assign test_en_w = scan_mode_i | mb_en_w;

  // scan_en_i and scan_in_i have no RTL consumer and scan_out_o is driven 0 UNTIL Stage 2
  // scan insertion (a netlist step in this macro's flow) stitches the two chains: it
  // removes this tie, connects chain k's last flop to scan_out_o[k] and scan_in_i[k] to
  // its first, and every scan flop's SCE to scan_en_i. One assign on one vector so that
  // step has a single thing to replace (same contract as soc_top, section 14.4).
  /* verilator lint_off UNUSEDSIGNAL */
  logic [1:0] dft_scan_in_unused;
  logic       dft_scan_en_unused;
  assign dft_scan_in_unused = scan_in_i;
  assign dft_scan_en_unused = scan_en_i;
  /* verilator lint_on  UNUSEDSIGNAL */
  assign scan_out_o = '0;  // DFT_PLACEHOLDER: replaced by Stage 2 insertion

  // ================================================================
  // MBIST controller for the ten cache macros (section 16.7)
  // ================================================================
  // One controller INSIDE the macro (the macros' ports are not otherwise reachable), memories in lock-step:
  //   index 0 = I$ tag, 1..4 = I$ data[0..3], 5 = D$ tag, 6..9 = D$ data[0..3]; 256 x 32 each, port 1 unused.
  // ASYNC_RST = 0: the controller has no reset pin. The reset is folded into run (run & rst_n_i). A functional reset aborts a running MBIST and cannot start one.
  // The instance exists in every SRAM arm. Where the Sky130 macros are absent, the caches drive 0 as read data. An MBIST run there reports FAIL, not a vacuous pass.
  // ASYNC_RST must stay 0: tools/dft/check_scan_clk_rst.py forbids an async pin in this macro.
  logic         mb_ce_w;
  logic         mb_we_w;
  logic [3:0]   mb_wmask_w;
  logic [7:0]   mb_addr_w;
  logic [31:0]  mb_din_w;
  logic [4:0]   mb_ic_fail_w;
  logic [4:0]   mb_dc_fail_w;
  logic         mb_x_rd_w;
  logic [3:0]   mb_x_xm_w;
  logic [2:0]   mb_x_bg_w;
  logic         mb_run_w;

  assign mb_run_w = mbist_run_i & rst_n_i;

  // Collar-local compare: in the Sky130 arm each mem_collar compares its own macro's read data and
  // returns one registered mismatch strobe, so the controller sees 10 strobes instead of 320 read-data wires and
  // broadcasts an 8-net expected-data tag (x_*) beside the 47-net op bus. The arms without the macros have no
  // collars and read constant 0: the controller then compares that 0 itself (LOCAL_CMP = 0, as before the change),
  // so an MBIST run there still FAILS rather than passing vacuously.
`ifdef SRAM_SKY130
  localparam bit MB_LOCAL_CMP = 1'b1;
`else
  localparam bit MB_LOCAL_CMP = 1'b0;
`endif

  mbist_ctrl #(
    .N_MEM     (10),
    .AW        (8),
    .RD_LAT    (2),
    .P1_MASK   ('0),
    .ASYNC_RST (1'b0),
    .LOCAL_CMP (MB_LOCAL_CMP)
  ) u_mbist_ctrl (
    .clk_i     (clk_i),
    .rst_n_i   (1'b1),
    .run_i     (mb_run_w),
    .cfg_i     (mbist_cfg_i),
    .bist_en_o (mb_en_w),
    .b_ce_o    (mb_ce_w),
    .b_we_o    (mb_we_w),
    .b_wmask_o (mb_wmask_w),
    .b_addr_o  (mb_addr_w),
    .b_din_o   (mb_din_w),
    .dout0_i   (320'd0),     // read data is compared in the collars (Sky130 arm) or is constant 0 (other arms)
    .dout1_i   (320'd0),
    .x_rd_o    (mb_x_rd_w),
    .x_xm_o    (mb_x_xm_w),
    .x_bg_o    (mb_x_bg_w),
    .cmp_fail0_i ({mb_dc_fail_w, mb_ic_fail_w}),
    .cmp_fail1_i (10'd0),
    .status_o  (mbist_status_o)
  );

  // ================================================================
  // Internal Signals
  // ================================================================

  // Debug interface signals
  logic        dbg_halt_req;
  logic        dbg_resume_req;
  logic        dbg_step_req;
  logic        dbg_halted;
  logic [31:0] pc_if_from_core;  // IF-stage PC (frozen during halt)

  // Debug PC write
  logic        dbg_pc_wr_en;
  logic [31:0] dbg_pc_wr_data;

  // Debug register file access
  logic        dbg_reg_wr_en;
  logic [4:0]  dbg_reg_wr_addr;
  logic [31:0] dbg_reg_wr_data;
  logic [4:0]  dbg_reg_rd_addr;
  logic [31:0] dbg_reg_rd_data;

  // Debug register map (see Doc: ds:mm:memory-map)
  logic [31:0] dbg_ctrl_reg;      // 0x000: Control register
  logic [31:0] dbg_status_reg;    // 0x004: Status register

  // Breakpoint registers
  logic [31:0] dbg_bp0_addr;      // 0x100: Breakpoint 0 address
  logic [31:0] dbg_bp0_ctrl;      // 0x104: Breakpoint 0 control
  logic [31:0] dbg_bp1_addr;      // 0x108: Breakpoint 1 address
  logic [31:0] dbg_bp1_ctrl;      // 0x10C: Breakpoint 1 control

  logic        bp0_hit, bp1_hit;
  logic        ebreak_halt;  // Combinational: EBREAK retiring at WB this cycle

  // CSR debug values exposed by the core (readable at APB 0x200-0x214)
  logic [31:0] dbg_csr_mstatus;
  logic [31:0] dbg_csr_mie;
  logic [31:0] dbg_csr_mtvec;
  logic [31:0] dbg_csr_mepc;
  logic [31:0] dbg_csr_mcause;
  logic [31:0] dbg_csr_mip;

  // Persistent halt latch — keeps halt_req asserted after a one-cycle event
  // (EBREAK in EX, breakpoint commit, or single-step completion) until the
  // CPU is explicitly resumed by the test writing DBG_CTRL[1] or DBG_CTRL[2].
  logic halt_latch_q;

  // Single-step sequencer: armed when the CPU exits HALTED with step bit set;
  // cleared (and halt re-asserted) when the first instruction commits.
  logic step_pending_q;

  // Latched halt cause register: holds the cause until the CPU resumes (exits HALTED).
  // Encoding matches Doc: ds:mm:memory-map / DBG_STATUS bits [7:4]:
  //   0x1 = debug halt request
  //   0x2 = BP0 hit
  //   0x3 = BP1 hit
  //   0x4 = single-step complete
  //   0x8 = EBREAK
  logic [3:0]  halt_cause_lat;

  // ================================================================
  // CPU Core Instance
  // ================================================================

  rv32i_core #(
    .RESET_PC       (RESET_PC)
  ) u_core (
    .clk            (clk_i),
    .rst_n          (rst_n_i),
    .test_en_i      (test_en_w),

    // MBIST broadcast bus and macro read data (section 16.7)
    .mbist_en_i      (mb_en_w),
    .mbist_ce_i      (mb_ce_w),
    .mbist_we_i      (mb_we_w),
    .mbist_wmask_i   (mb_wmask_w),
    .mbist_addr_i    (mb_addr_w),
    .mbist_din_i     (mb_din_w),
    .mbist_x_rd_i    (mb_x_rd_w),
    .mbist_x_xm_i    (mb_x_xm_w),
    .mbist_x_bg_i    (mb_x_bg_w),
    .mbist_ic_fail_o (mb_ic_fail_w),
    .mbist_dc_fail_o (mb_dc_fail_w),

    // AXI4 burst memory interface
    .axi_araddr     (axi_araddr_o),
    .axi_arlen      (axi_arlen_o),
    .axi_arsize     (axi_arsize_o),
    .axi_arburst    (axi_arburst_o),
    .axi_arvalid    (axi_arvalid_o),
    .axi_arready    (axi_arready_i),
    .axi_rdata      (axi_rdata_i),
    .axi_rresp      (axi_rresp_i),
    .axi_rvalid     (axi_rvalid_i),
    .axi_rlast      (axi_rlast_i),
    .axi_rready     (axi_rready_o),
    .axi_awaddr     (axi_awaddr_o),
    .axi_awlen      (axi_awlen_o),
    .axi_awsize     (axi_awsize_o),
    .axi_awburst    (axi_awburst_o),
    .axi_awvalid    (axi_awvalid_o),
    .axi_awready    (axi_awready_i),
    .axi_wdata      (axi_wdata_o),
    .axi_wstrb      (axi_wstrb_o),
    .axi_wlast      (axi_wlast_o),
    .axi_wvalid     (axi_wvalid_o),
    .axi_wready     (axi_wready_i),
    .axi_bresp      (axi_bresp_i),
    .axi_bvalid     (axi_bvalid_i),
    .axi_bready     (axi_bready_o),

    // Debug interface
    .dbg_halt_req   (dbg_halt_req),
    .dbg_resume_req (dbg_resume_req),
    .dbg_step_req   (dbg_step_req),
    .dbg_halted     (dbg_halted),

    // Debug PC write
    .dbg_pc_wr_en   (dbg_pc_wr_en),
    .dbg_pc_wr_data (dbg_pc_wr_data),

    // Debug register file access
    .dbg_reg_wr_en    (dbg_reg_wr_en),
    .dbg_reg_wr_addr  (dbg_reg_wr_addr),
    .dbg_reg_wr_data  (dbg_reg_wr_data),
    .dbg_reg_rd_addr  (dbg_reg_rd_addr),
    .dbg_reg_rd_data  (dbg_reg_rd_data),

    // Commit interface
    .commit_valid   (commit_valid_o),
    .commit_pc      (commit_pc_o),
    .commit_insn    (commit_insn_o),
    .trap_taken     (trap_taken_o),
    .trap_cause     (trap_cause_o),

    // Debug outputs
    .debug_rs1_data          (debug_rs1_data_o),
    .debug_rs2_data          (debug_rs2_data_o),
    .debug_branch_taken      (debug_branch_taken_o),
    .debug_take_branch_jump  (debug_take_branch_jump_o),
    .debug_pc_src            (debug_pc_src_o),
    .debug_state             (debug_state_o),
    .debug_ebreak            (debug_ebreak_o),

    // Interrupt inputs (Phase 2)
    .ext_irq_i      (ext_irq_i),
    .timer_irq_i    (timer_irq_i),

    // CSR debug outputs (Phase 2)
    .dbg_csr_mstatus_o (dbg_csr_mstatus),
    .dbg_csr_mie_o     (dbg_csr_mie),
    .dbg_csr_mtvec_o   (dbg_csr_mtvec),
    .dbg_csr_mepc_o    (dbg_csr_mepc),
    .dbg_csr_mcause_o  (dbg_csr_mcause),
    .dbg_csr_mip_o     (dbg_csr_mip),
    .pc_if_o           (pc_if_from_core)
  );

  // ================================================================
  // APB3 Debug Interface
  // ================================================================

  // APB timing: apb_prdata_o and apb_pready_o are pure registered outputs. See ds:mod:rv32i-cpu-top and tm:mod:rv32i-cpu-top. Do not add a combinational term to apb_pready_o.
  // Writes complete in one ACCESS cycle with pready = 1. Reads take exactly one wait state.
  // Write-commit conditions stay (psel && penable && pwrite), true for one cycle, so pulse outputs such as dbg_pc_wr_en fire once.
  always_ff @(posedge clk_i) begin
    if (!rst_n_i) begin
      apb_pready_o <= 1'b0;
    end else begin
      apb_pready_o <= (apb_psel_i && !apb_penable_i &&  apb_pwrite_i) ||
                      (apb_psel_i &&  apb_penable_i && !apb_pwrite_i && !apb_pready_o);
    end
  end
  // CSR debug registers (0x200-0x214) are read-only — writes return PSLVERR.
  // The PSLVERR decode runs in the SETUP phase (psel = 1, penable = 0) and is registered.
  // apb_pslverr_o is a pure registered output. It must have no combinational term, not even a psel/penable AND. Any such term re-exports an input-to-output arc from apb_psel_i.
  // Do not give PSLVERR a read-style wait state like apb_prdata_o. Writes commit on (psel && penable && pwrite), so a two-cycle ACCESS fires pulse outputs such as dbg_pc_wr_en twice.
  // The flop is correct in ACCESS because SETUP is the cycle just before ACCESS (axil_to_apb, apb_cdc_bridge).
  always_ff @(posedge clk_i) begin
    if (!rst_n_i) begin
      apb_pslverr_o <= 1'b0;
    end else begin
      apb_pslverr_o <= apb_psel_i && !apb_penable_i && apb_pwrite_i &&
                       (apb_paddr_i >= 12'h200) && (apb_paddr_i <= 12'h214) &&
                       (apb_paddr_i[1:0] == 2'b00);
    end
  end

  // DBG_INSTR latch: holds the last retired instruction (commit or trap) so
  // the register reads non-zero when the CPU is halted and the pipeline is empty.
  // Declared ahead of the APB read mux that reads it (declare-before-use).
  logic [31:0] last_commit_insn_q;

  // Combinational read-mux decode. Feeds the apb_prdata_o register below
  // rather than driving the port directly (see ds:mod:rv32i-cpu-top).
  logic [31:0] apb_prdata_comb;

  // APB read logic
  always_comb begin
    apb_prdata_comb = 32'h0;
    dbg_reg_rd_addr = 5'h0;  // Default register address

    if (apb_psel_i && !apb_pwrite_i) begin
      case (apb_paddr_i)
        // Control register (0x000)
        12'h000: apb_prdata_comb = dbg_ctrl_reg;

        // Status register (0x004)
        12'h004: apb_prdata_comb = dbg_status_reg;

        // PC register (0x008) — IF-stage PC (correct when halted; frozen by pipeline_if)
        12'h008: apb_prdata_comb = pc_if_from_core;

        // Current instruction (0x00C) — last retired instruction (latched)
        12'h00C: apb_prdata_comb = last_commit_insn_q;

        // CSR debug registers (read-only, Phase 2)
        12'h200: apb_prdata_comb = dbg_csr_mstatus;   // DBG_MSTATUS
        12'h204: apb_prdata_comb = dbg_csr_mie;       // DBG_MIE
        12'h208: apb_prdata_comb = dbg_csr_mtvec;     // DBG_MTVEC
        12'h20C: apb_prdata_comb = dbg_csr_mepc;      // DBG_MEPC
        12'h210: apb_prdata_comb = dbg_csr_mcause;    // DBG_MCAUSE
        12'h214: apb_prdata_comb = dbg_csr_mip;       // DBG_MIP

        // GPR[0:31] (0x010-0x08C)
        // Address format: 0x010 + (reg_num * 4)
        // Valid range: 0x010 (x0) to 0x08C (x31)
        default: begin
          if (apb_paddr_i >= 12'h010 && apb_paddr_i <= 12'h08C && apb_paddr_i[1:0] == 2'b00) begin
            // Calculate register number from address
            // 0x010 -> x0, 0x014 -> x1, etc.
            // Formula: (addr - 0x010) / 4 = (addr[6:2] - 4)
            dbg_reg_rd_addr = apb_paddr_i[6:2] - 5'd4;
            apb_prdata_comb = dbg_reg_rd_data;
          end
          // Breakpoint 0 address (0x100)
          else if (apb_paddr_i == 12'h100) begin
            apb_prdata_comb = dbg_bp0_addr;
          end
          // Breakpoint 0 control (0x104)
          else if (apb_paddr_i == 12'h104) begin
            apb_prdata_comb = dbg_bp0_ctrl;
          end
          // Breakpoint 1 address (0x108)
          else if (apb_paddr_i == 12'h108) begin
            apb_prdata_comb = dbg_bp1_addr;
          end
          // Breakpoint 1 control (0x10C)
          else if (apb_paddr_i == 12'h10C) begin
            apb_prdata_comb = dbg_bp1_ctrl;
          end
          /* verilator coverage_off */
          else begin
            apb_prdata_comb = 32'h0;  // Read to unknown APB address → return 0
          end
          /* verilator coverage_on */
        end
      endcase
    end
  end

  // Register the read-mux output. The master holds paddr/psel/pwrite stable
  // across the SETUP phase and both ACCESS cycles of a read transfer (APB3
  // protocol), so capturing apb_prdata_comb on every selected cycle
  // guarantees apb_prdata_o already holds the correct value by the cycle
  // apb_pready_o (now a pure registered output, above) asserts.
  always_ff @(posedge clk_i) begin
    if (!rst_n_i) begin
      apb_prdata_o <= 32'h0;
    end else if (apb_psel_i) begin
      apb_prdata_o <= apb_prdata_comb;
    end
  end

  // Edge detection for dbg_halted (to auto-clear command bits)
  logic dbg_halted_prev;

  always_ff @(posedge clk_i) begin
    if (!rst_n_i)
      last_commit_insn_q <= 32'h0;
    else if (commit_valid_o || trap_taken_o)
      last_commit_insn_q <= commit_insn_o;
  end
  always_ff @(posedge clk_i) begin
    if (!rst_n_i) begin
      dbg_halted_prev <= 1'b0;
    end else begin
      dbg_halted_prev <= dbg_halted;
    end
  end

  // ================================================================
  // Halt latch and single-step sequencer
  // ================================================================
  always_ff @(posedge clk_i) begin
    if (!rst_n_i) begin
      halt_latch_q  <= 1'b0;
      step_pending_q <= 1'b0;
    end else begin
      // --- halt_latch_q ---
      // Clear when the CPU exits HALTED (resume or beginning of a step).
      if (!dbg_halted && dbg_halted_prev) begin
        halt_latch_q <= 1'b0;
      end
      // Set on EBREAK reaching EX or breakpoint commit — these are one-cycle
      // pulses; the latch ensures halt_req stays asserted while the pipeline drains.
      if (debug_ebreak_o || bp0_hit || bp1_hit) begin
        halt_latch_q <= 1'b1;
      end
      // Re-assert halt when the single-step instruction commits.
      if (step_pending_q && commit_valid_o) begin
        halt_latch_q <= 1'b1;
      end

      // Explicit APB clear: when the test writes resume (bit 1) or step (bit 2)
      // to DBG_CTRL, clear halt_latch_q immediately so the CPU can exit HALTED.
      // Without this, halt_latch_q=1 keeps dbg_halt_req=1, preventing the CPU
      // from exiting HALTED even after bit 0 is cleared.  This fires LAST so
      // it overrides any set above in the same always_ff block.
      if (apb_psel_i && apb_penable_i && apb_pwrite_i && (apb_paddr_i == 12'h000)) begin
        if (apb_pwdata_i[1] || apb_pwdata_i[2]) begin
          halt_latch_q <= 1'b0;
        end
      end

      // --- step_pending_q ---
      // Arm when the CPU exits HALTED with the step bit set.
      // Note: dbg_ctrl_reg[2] is read at its pre-edge value so the check
      // correctly sees the step bit written by step_cpu() before auto-clear.
      if (!dbg_halted && dbg_halted_prev && dbg_ctrl_reg[2]) begin
        step_pending_q <= 1'b1;
      end
      // Disarm when the instruction commits (step complete).
      if (step_pending_q && commit_valid_o) begin
        step_pending_q <= 1'b0;
      end
    end
  end

  // APB write logic
  always_ff @(posedge clk_i) begin
    if (!rst_n_i) begin
      dbg_ctrl_reg    <= 32'h0;
      dbg_bp0_addr    <= 32'h0;
      dbg_bp0_ctrl    <= 32'h0;
      dbg_bp1_addr    <= 32'h0;
      dbg_bp1_ctrl    <= 32'h0;
      dbg_pc_wr_en    <= 1'b0;
      dbg_pc_wr_data  <= 32'h0;
      dbg_reg_wr_en   <= 1'b0;
      dbg_reg_wr_addr <= 5'h0;
      dbg_reg_wr_data <= 32'h0;
    end else begin
      // Default: clear one-cycle write enables
      dbg_pc_wr_en  <= 1'b0;
      dbg_reg_wr_en <= 1'b0;

      // Auto-clear command bits based on CPU state transitions:
      // - Keep halt bit (bit 0) asserted while halted so the CPU stays frozen
      //   until explicitly resumed.  (Clearing it prematurely would cause
      //   dbg_halted to fall before the next APB read can observe it.)
      // - Clear all control bits when CPU exits HALTED state (dbg_halted 1->0),
      //   which happens when the test writes DBG_CTRL[1]=1 (resume) or
      //   DBG_CTRL[2]=1 (step), both of which write bit 0 = 0.
      if (!dbg_halted && dbg_halted_prev) begin
        // CPU just exited HALTED state - clear halt, resume and step bits
        dbg_ctrl_reg[2:0] <= 3'b000;
      end

      if (apb_psel_i && apb_penable_i && apb_pwrite_i) begin
        case (apb_paddr_i)
          // Control register (0x000) - EXCEPTION: Always writable even when not halted
          // Rationale: Must allow halt/resume/step commands to be issued at any time
          // Command bits [2:0] use write-1-to-trigger (self-clearing) semantics
          12'h000: begin
            dbg_ctrl_reg <= apb_pwdata_i;
          end

          // PC register (0x008) - writable only when halted
          12'h008: begin
            if (dbg_halted) begin
              dbg_pc_wr_en   <= 1'b1;
              dbg_pc_wr_data <= apb_pwdata_i;
            end
          end

          // Breakpoint 0 address (0x100) - writable only when halted
          12'h100: begin
            if (dbg_halted) begin
              dbg_bp0_addr <= apb_pwdata_i;
            end
          end

          // Breakpoint 0 control (0x104) - writable only when halted
          12'h104: begin
            if (dbg_halted) begin
              dbg_bp0_ctrl <= apb_pwdata_i;
            end
          end

          // Breakpoint 1 address (0x108)
          12'h108: begin
            if (dbg_halted) begin
              dbg_bp1_addr <= apb_pwdata_i;
            end
          end

          // Breakpoint 1 control (0x10C)
          12'h10C: begin
            if (dbg_halted) begin
              dbg_bp1_ctrl <= apb_pwdata_i;
            end
          end

          // GPR[0:31] write access (0x010-0x08C) - writable when halted
          default: begin
            if (apb_paddr_i >= 12'h010 && apb_paddr_i <= 12'h08C && apb_paddr_i[1:0] == 2'b00 && dbg_halted) begin
              dbg_reg_wr_en   <= 1'b1;
              dbg_reg_wr_addr <= apb_paddr_i[6:2] - 5'd4;
              dbg_reg_wr_data <= apb_pwdata_i;
            end
          end
        endcase
      end
    end
  end

  // ================================================================
  // Debug Control Logic
  // ================================================================

  // Extract debug control signals from control register
  // Also trigger halt on breakpoint hits
  // dbg_halt_req: asserted by APB halt bit, breakpoint hit (immediate pulse),
  // or halt_latch_q (which holds the request stable until explicit resume).
  assign dbg_halt_req   = dbg_ctrl_reg[0] || bp0_hit || bp1_hit || halt_latch_q;
  assign dbg_resume_req = dbg_ctrl_reg[1];
  // dbg_step_req carries step_pending_q (not the raw ctrl bit) so the IF stage
  // can limit fetches to exactly one when a single-step is in progress.
  assign dbg_step_req   = step_pending_q;

  // Halt Cause Latch: holds the halt cause for DBG_STATUS. bp0_hit and bp1_hit last only the commit cycle, so the cause must be latched.
  // Encoding (Doc: ds:mm:memory-map DBG_STATUS bits [7:4]):
  //   0x1 = debug halt request (plain halt, no other cause)
  //   0x2 = BP0 hit
  //   0x3 = BP1 hit
  //   0x4 = single-step complete
  //   0x8 = EBREAK instruction

  always_ff @(posedge clk_i) begin
    if (!rst_n_i) begin
      halt_cause_lat <= 4'h0;
    end else begin
      // Priority (highest to lowest):
      // 1. EBREAK retires at WB (trap_taken_o && trap_cause_o==3)
      //    — fires 1 cycle BEFORE dbg_halted goes high; latch cause now
      // 2. BP hit during commit (commit_valid_o pulse)
      // 3. CPU just exited HALTED → clear or set step cause
      // 4. CPU just entered HALTED → fallback plain halt cause
      // ==================================================================

      if (ebreak_halt && (halt_cause_lat != 4'h2) && (halt_cause_lat != 4'h3)) begin
        // EBREAK retiring at WB — pipeline still has it valid this cycle,
        // dbg_halted will go high next cycle.  Latch now so the cause is
        // stable when DBG_STATUS is read.
        // Guard: do not override a BP cause (0x2/0x3) that was latched in the
        // same halt window.  With I-cache hits, the instruction immediately
        // after the BP target (often EBREAK) can reach WB one cycle after the
        // BP fires, which would spuriously overwrite the BP cause with 0x8.
        halt_cause_lat <= 4'h8;

      end else if (commit_valid_o) begin
        // Normal retirement pulse: sample breakpoint hits
        if (bp0_hit) begin
          halt_cause_lat <= 4'h2;
        end else if (bp1_hit) begin
          halt_cause_lat <= 4'h3;
        end

      end else if (!dbg_halted && dbg_halted_prev) begin
        // CPU just exited HALTED (resume or step)
        if (dbg_ctrl_reg[2]) begin
          // Step: pre-load cause so it is ready when CPU returns to HALTED
          halt_cause_lat <= 4'h4;
        end else begin
          halt_cause_lat <= 4'h0;
        end

      end else if (dbg_halted && !dbg_halted_prev) begin
        // CPU just entered HALTED
        if (halt_cause_lat == 4'h0) begin
          // No earlier-latched cause (e.g. plain debug halt request)
          halt_cause_lat <= 4'h1;
        end
        // else: BP or EBREAK cause already latched — keep it
      end
      // else: hold current value
    end
  end

  // Status register - use halt_cause_lat for stable halt cause readback
  always_comb begin
    dbg_status_reg = 32'h0;
    dbg_status_reg[0] = dbg_halted;      // Halted status
    dbg_status_reg[1] = !dbg_halted;     // Running status

    // Halt cause (bits [7:4]) - sourced from registered latch so it is
    // stable when the test reads DBG_STATUS after the CPU enters HALTED.
    dbg_status_reg[7:4] = halt_cause_lat;
  end

  // ================================================================
  // Breakpoint Logic
  // ================================================================

  // Breakpoint 0 detection
  assign bp0_hit = dbg_bp0_ctrl[0] && (commit_pc_o == dbg_bp0_addr) && commit_valid_o;

  // Breakpoint 1 detection
  assign bp1_hit = dbg_bp1_ctrl[0] && (commit_pc_o == dbg_bp1_addr) && commit_valid_o;

  // EBREAK halt detection (Phase 2)
  // In the pipeline, EBREAK flows to WB and retires as a trap (trap_cause=3).
  // trap_taken_o fires one cycle before dbg_halted goes high (WB drains that cycle).
  assign ebreak_halt = trap_taken_o && (trap_cause_o == 4'h3);

  // Breakpoint halt logic integrated above (dbg_halt_req triggers on bp0_hit || bp1_hit)

endmodule
