chuanseng-ng/claude_verilog_test/pnr/commercial/signoff/lec/conformal/reports/b4e_mutant_fwdb_inv.diff.txt

67238a67239,67240
>    wire mut_n ;
>    sky130_fd_sc_hd__inv_1 mut_inv ( .A(\u_core/n_13109 ), .Y(mut_n) );
67241c67243
< 	.D(\u_core/n_13109 ),
---
> 	.D(mut_n),
