chuanseng-ng/claude_verilog_test/pnr/commercial/signoff/lec/conformal/reports/b4l_mutant_fwdb_inv.diff.txt

69580a69581,69582
>    wire mut_n ;
>    sky130_fd_sc_hd__inv_1 mut_inv ( .A(\u_core/n_13109 ), .Y(mut_n) );
69583c69585
< 	.D(\u_core/n_13109 ),
---
> 	.D(mut_n),
