chuanseng-ng/claude_verilog_test/tb/cocotb/soc/tb_soc_top.sv

// tb_soc_top.sv
// Phase 5 (M9) — cocotb test wrapper for soc_top.
//
// soc_top has no unpacked-array ports at its boundary (those are internal),
// so no fan-in/fan-out logic is needed — this file is a thin pass-through
// that adds:
//   1. MEM_INIT_FILE parameter forwarded to the boot_rom inside soc_top
//      (boot_rom.MEM_INIT_FILE is re-exposed as a top-level parameter so
//       each cocotb test can supply its own hex image at elaboration time).
//   2. Flat scalar ports with the signal names that the cocotb BFMs expect
//      (clk_i, rst_n_i, apb_*, uart_*, spi_*, gpio_*, commit_*, gpu_irq_o).
//
// All signals are direct renames of soc_top ports — zero logic, exactly
// the pattern of tb_axi4_crossbar.sv.
//
// cpu_clk_i/cpu_rst_n_i are true top-level ports of the real CPU-domain clock (previously tied
// internally to clk_i/rst_n_i). Every existing cocotb suite (test_boot / test_periph_loopback /
// test_soc_coherency / test_cpu_gpu_irq / test_soc_stress / test_l2_bench)
// drives both clock/reset pairs via tb/cocotb/soc/soc_clocks.py at a 1:1
// ratio and identical phase, which is behaviourally unchanged from the old
// internal tie. Only the new multiclock suite (test_soc_multiclock.py)
// drives a genuinely independent, non-1:1 cpu_clk_i.
// cpu_pll_locked_o is left unconnected here (soc_boot / soc_periph /
// soc_coherency / soc_cpu_gpu / soc_multiclock do not observe it); see
// tb_soc_pll.sv for the wrapper that exposes both lock signals.
//
// Lint target: verilator -Wall 0 errors 0 warnings.

`default_nettype none

module tb_soc_top #(
    // Forwarded to boot_rom.MEM_INIT_FILE inside soc_top.
    // Pass "" (empty string) to leave ROM all-zeros; pass a path to a
    // $readmemh-compatible hex file to pre-load firmware.
    parameter string       MEM_INIT_FILE  = "",

    // Forwarded to sram_controller.MEM_WORDS inside soc_top.
    // Default 1024 (4 KB) preserves all existing test behaviour.
    // M10 cache benchmarks set this to 65536 (256 KB).
    parameter int unsigned SRAM_MEM_WORDS = 1024
) (
    // ── Clock / reset ─────────────────────────────────────────────────────────
    input  logic        clk_i,
    input  logic        rst_n_i,

    // ── CPU-domain reference clock / reset (genuinely independent) ──
    input  logic        cpu_clk_i,
    input  logic        cpu_rst_n_i,

    // ── APB3 debug slave (CPU debug port) ────────────────────────────────────
    input  logic [11:0] apb_paddr_i,
    input  logic        apb_psel_i,
    input  logic        apb_penable_i,
    input  logic        apb_pwrite_i,
    input  logic [31:0] apb_pwdata_i,
    output logic [31:0] apb_prdata_o,
    output logic        apb_pready_o,
    output logic        apb_pslverr_o,

    // ── UART ─────────────────────────────────────────────────────────────────
    output logic        uart_tx_o,
    input  logic        uart_rx_i,

    // ── SPI ──────────────────────────────────────────────────────────────────
    output logic        spi_sclk_o,
    output logic        spi_mosi_o,
    input  logic        spi_miso_i,
    output logic        spi_cs_n_o,

    // ── GPIO (Phase 6a) ────────────────────────
    output logic [31:0] gpio_out_o,
    output logic [31:0] gpio_oe_o,
    input  logic [31:0] gpio_in_i,

    // ── PWM (Phase 6a-2, tied off until the peripheral lands) ──
    output logic [3:0]  pwm_o,

    // ── Watchdog (Phase 6a-3, tied off until the peripheral lands) ──
    output logic        wdt_rst_req_o,

    // ── I2C (Phase 6a-5, tied off until the peripheral lands) ──
    output logic        i2c_scl_o,
    output logic        i2c_scl_oe_o,
    input  logic        i2c_scl_i,
    output logic        i2c_sda_o,
    output logic        i2c_sda_oe_o,
    input  logic        i2c_sda_i,

    // ── Observability bus ─────────────────────────────────────────────────────
    output logic        commit_valid_o,
    output logic [31:0] commit_pc_o,
    output logic [31:0] commit_insn_o,
    output logic        gpu_irq_o,

    // ── PLL status (Phase 7 M-c) ─────────────────────────────────────────────
    // Exposed so soc_boot_lint passes cleanly; soc_boot / soc_periph /
    // soc_coherency / soc_cpu_gpu tests do not observe this signal directly —
    // they use commit_pc_o as the boot readiness indicator.
    output logic        pll_locked_o,
    // ── DFT test access (j41m.2). Inactive values: scan_mode_i=0, scan_en_i=0,
    //    scan_rst_ni=1, scan_clk_i=0, scan_in_i=0; soc_clocks.start_soc_clocks()
    //    drives them for every suite. ─────────────────────────────────────
    input  logic        scan_mode_i,
    input  logic        scan_en_i,
    input  logic        scan_rst_ni,
    input  logic        scan_clk_i,
    input  logic [7:0]  scan_in_i,
    output logic [7:0]  scan_out_o,
    // ── JTAG TAP (j41m.3). Idle: tck_i=0, tms_i=1, tdi_i=0, trst_ni=0 (TAP held in
    //    reset); soc_clocks.start_soc_clocks() drives them.
    input  logic        tck_i,
    input  logic        tms_i,
    input  logic        tdi_i,
    input  logic        trst_ni,
    output logic        tdo_o,
    output logic        tdo_oe_o
);

    // This single-clock wrapper does not expose cpu_pll_locked_o to
    // cocotb (soc_boot/soc_periph/soc_coherency/soc_cpu_gpu do not observe
    // it — see tb_soc_pll.sv for the wrapper that does). Sink it to a local
    // net rather than an empty port connection.
    logic cpu_pll_locked_unused;

    soc_top #(
        .MEM_INIT_FILE  (MEM_INIT_FILE),
        .SRAM_MEM_WORDS (SRAM_MEM_WORDS)
    ) u_soc (
        .clk_i          (clk_i),
        .rst_n_i        (rst_n_i),
        // Genuinely independent CPU-domain reference — see header.
        .cpu_clk_i      (cpu_clk_i),
        .cpu_rst_n_i    (cpu_rst_n_i),

        .apb_paddr_i    (apb_paddr_i),
        .apb_psel_i     (apb_psel_i),
        .apb_penable_i  (apb_penable_i),
        .apb_pwrite_i   (apb_pwrite_i),
        .apb_pwdata_i   (apb_pwdata_i),
        .apb_prdata_o   (apb_prdata_o),
        .apb_pready_o   (apb_pready_o),
        .apb_pslverr_o  (apb_pslverr_o),

        .uart_tx_o      (uart_tx_o),
        .uart_rx_i      (uart_rx_i),

        .spi_sclk_o     (spi_sclk_o),
        .spi_mosi_o     (spi_mosi_o),
        .spi_miso_i     (spi_miso_i),
        .spi_cs_n_o     (spi_cs_n_o),

        .gpio_out_o     (gpio_out_o),
        .gpio_oe_o      (gpio_oe_o),
        .gpio_in_i      (gpio_in_i),

        .pwm_o          (pwm_o),

        .wdt_rst_req_o  (wdt_rst_req_o),

        .i2c_scl_o      (i2c_scl_o),
        .i2c_scl_oe_o   (i2c_scl_oe_o),
        .i2c_scl_i      (i2c_scl_i),
        .i2c_sda_o      (i2c_sda_o),
        .i2c_sda_oe_o   (i2c_sda_oe_o),
        .i2c_sda_i      (i2c_sda_i),

        .commit_valid_o (commit_valid_o),
        .commit_pc_o    (commit_pc_o),
        .commit_insn_o  (commit_insn_o),
        .gpu_irq_o      (gpu_irq_o),


        .scan_mode_i    (scan_mode_i),
        .scan_en_i      (scan_en_i),
        .scan_rst_ni    (scan_rst_ni),
        .scan_clk_i     (scan_clk_i),
        .scan_in_i      (scan_in_i),
        .scan_out_o     (scan_out_o),
        .tck_i          (tck_i),
        .tms_i          (tms_i),
        .tdi_i          (tdi_i),
        .trst_ni        (trst_ni),
        .tdo_o          (tdo_o),
        .tdo_oe_o       (tdo_oe_o),
        .pll_locked_o   (pll_locked_o),
        // CPU-domain PLL lock, not observed by this single-clock
        // wrapper's tests (soc_boot/soc_periph/soc_coherency/soc_cpu_gpu).
        .cpu_pll_locked_o (cpu_pll_locked_unused)
    );

endmodule : tb_soc_top
