chuanseng-ng/claude_verilog_test/tb/cocotb/soc/jtag_driver.py

"""
jtag_driver.py -- JTAG TAP driver, reference model and edge logger (bead j41m.3, DFT Stage 1b).

Shared by test_jtag_tap.py (module jtag_tap alone), test_dft_ctrl.py (dft_ctrl) and
test_soc_jtag.py (soc_top via tb_soc_pll).  Everything here is written from
docs/design/DFT_ARCHITECTURE.md section 15 (TAP rules 15.2, instruction map 15.3), NOT from the RTL,
so the reference model is an independent second implementation of the spec.

Pieces
  NEXT / ENC / OP_*      the IEEE 1149.1 state graph, the standard 4-bit state encodings, the
                         private opcode map of section 15.3
  TapRef                 cycle-accurate reference model: rise(tms, tdi) = TCK rising edge,
                         fall() = TCK falling edge, async_reset()/release() = TRST_N.  State and
                         shift registers move on the rising edge; the update registers, TDO and
                         every SoC-facing output move on the FALLING edge (section 15.2).
  JtagDriver             drives tck/tms/tdi/trst_n, runs TapRef in lock step, and after EVERY tick
                         compares whatever the bench's probe() returns (any subset of the TapRef
                         output names plus 'state') against the model at three instants:
                           pre_rise   half a period after the falling edge, with TMS/TDI already
                                      changed  -> catches any output that depends combinationally
                                      on TMS/TDI, or that drifts between edges
                           post_rise  1 ps after the rising edge -> the falling-edge outputs must
                                      NOT have moved; state/shift_clk_en must have
                           post_fall  1 ps after the falling edge -> everything has its new value
  EdgeLog                records every value change of a set of signals with its simulation time and
                         the times of every TCK rising/falling edge and TRST_N assertion, so a test
                         can prove "this output only ever changes at a TCK falling edge".

Timeline of one tick (period T, half H, all in ps):
  F   TCK falls (TMS/TDI of the next cycle are driven at F+1 ps, after the post_fall check)
  F+H TDO is sampled (this is the bit the tester would capture at this rising edge), TCK rises
  F+T TCK falls again
Resolution is 1 ps; Verilator under cocotb runs at 1 ps precision.
"""

import bisect
from collections import deque

import cocotb
from cocotb.triggers import Edge, Timer
from cocotb.utils import get_sim_time

# ---------------------------------------------------------------------------
# IEEE 1149.1 state graph (independent of the RTL)
# ---------------------------------------------------------------------------
# name: (next state if TMS=0, next state if TMS=1)
NEXT = {
    "TLR": ("RTI", "TLR"),
    "RTI": ("RTI", "SELDR"),
    "SELDR": ("CAPDR", "SELIR"),
    "CAPDR": ("SHDR", "EX1DR"),
    "SHDR": ("SHDR", "EX1DR"),
    "EX1DR": ("PAUDR", "UPDR"),
    "PAUDR": ("PAUDR", "EX2DR"),
    "EX2DR": ("SHDR", "UPDR"),
    "UPDR": ("RTI", "SELDR"),
    "SELIR": ("CAPIR", "TLR"),
    "CAPIR": ("SHIR", "EX1IR"),
    "SHIR": ("SHIR", "EX1IR"),
    "EX1IR": ("PAUIR", "UPIR"),
    "PAUIR": ("PAUIR", "EX2IR"),
    "EX2IR": ("SHIR", "UPIR"),
    "UPIR": ("RTI", "SELDR"),
}
ENC = {
    "TLR": 0xF,
    "RTI": 0xC,
    "SELDR": 0x7,
    "CAPDR": 0x6,
    "SHDR": 0x2,
    "EX1DR": 0x1,
    "PAUDR": 0x3,
    "EX2DR": 0x0,
    "UPDR": 0x5,
    "SELIR": 0x4,
    "CAPIR": 0xE,
    "SHIR": 0xA,
    "EX1IR": 0x9,
    "PAUIR": 0xB,
    "EX2IR": 0x8,
    "UPIR": 0xD,
}
DEC = {v: k for k, v in ENC.items()}
STATES = list(NEXT)  # 16 names

# Private opcode map, section 15.3
OP_EXTEST = 0x0
OP_IDCODE = 0x1
OP_SAMPLE = 0x2
OP_SCAN_SEL = 0x3
OP_SCAN = 0x4
OP_SCAN_RST = 0x5
OP_MBIST_CTRL = 0x6
OP_MBIST_STATUS = 0x7
OP_BYPASS = 0xF
IDCODE_VAL = 0x15C0_1001
IR_CAPTURE = 0b0001

# Output names of TapRef.out that change on the falling edge only (section 15.2)
FALLING_OUTS = (
    "tdo",
    "tdo_oe",
    "scan_mode",
    "serial",
    "parallel",
    "rst_assert",
    "scan_en",
    "chain_grp",
    "mbist_wr",
    "mbist_force",
)
MB_CTL_LEN = 29
MB_ST_LEN = 140
SHIFT_STATES = ("SHIR", "SHDR")


def path_to(src: str, dst: str):
    """Shortest TMS sequence from state `src` to state `dst` (BFS; [] if already there)."""
    if src == dst:
        return []
    seen = {src}
    q = deque([(src, [])])
    while q:
        s, p = q.popleft()
        for tms in (0, 1):
            n = NEXT[s][tms]
            if n in seen:
                continue
            if n == dst:
                return p + [tms]
            seen.add(n)
            q.append((n, p + [tms]))
    raise AssertionError(f"no path {src} -> {dst}")


def bits_of(value: int, n: int):
    """LSB-first list of n bits."""
    return [(value >> i) & 1 for i in range(n)]


def int_of(bits) -> int:
    """Inverse of bits_of (bits[0] is the LSB)."""
    return sum((b & 1) << i for i, b in enumerate(bits))


# ---------------------------------------------------------------------------
# Reference model
# ---------------------------------------------------------------------------
class TapRef:
    """Cycle-accurate model of the section-15 TAP. `out` holds the falling-edge outputs."""

    def __init__(self):
        self.held = True
        # Test-controlled inputs of the MBIST TDRs: the 139-bit status word presented to Capture-DR of
        # MBIST_STATUS and whether the control-word FIFO can accept a write.
        self.mb_status = 0
        self.mb_ready = True
        self.async_reset()

    def async_reset(self):
        """TRST_N asserted: every flop in its reset state, immediately."""
        self.held = True
        self.state = "TLR"
        self.ir_shift = IR_CAPTURE
        self.ir = OP_IDCODE
        self.dr = 0
        self.sel = 0  # SCAN_SEL update register
        self.rst = 0  # SCAN_RST update register
        self.rst_edges_left = 2
        self.mb_ctl = 0  # MBIST_CTRL update register
        self.mb_ovf = 0  # sticky control-word overflow
        self.tlr_prev = 0
        self.out = {k: 0 for k in FALLING_OUTS}

    def release(self):
        """TRST_N released: the release goes through a 2-stage TCK synchroniser, so the first two
        TCK rising edges after release still see the TAP in reset (section 15.2)."""
        self.held = False
        self.rst_edges_left = 2

    # -- DR geometry -------------------------------------------------------
    def dr_len(self, ir=None) -> int:
        ir = self.ir if ir is None else ir
        return {OP_IDCODE: 32, OP_SCAN_SEL: 3, OP_MBIST_CTRL: MB_CTL_LEN, OP_MBIST_STATUS: MB_ST_LEN}.get(ir, 1)

    def dr_capture(self) -> int:
        if self.ir == OP_IDCODE:
            return IDCODE_VAL
        if self.ir == OP_SCAN_SEL:
            return self.sel
        if self.ir == OP_SCAN_RST:
            return self.rst
        if self.ir == OP_MBIST_CTRL:
            return self.mb_ctl
        if self.ir == OP_MBIST_STATUS:
            return (self.mb_status << 1) | self.mb_ovf
        return 0  # BYPASS, SCAN stub, and every unimplemented/unknown opcode

    # -- TCK edges ----------------------------------------------------------
    def rise(self, tms: int, tdi: int):
        if self.held:
            return
        if self.rst_edges_left > 0:
            self.rst_edges_left -= 1
            return
        s = self.state
        if s == "CAPIR":
            self.ir_shift = IR_CAPTURE
        elif s == "SHIR":
            self.ir_shift = (self.ir_shift >> 1) | (tdi << 3)
        if s == "CAPDR":
            self.dr = self.dr_capture()
        elif s == "SHDR":
            n = self.dr_len()
            self.dr = (self.dr >> 1) | (tdi << (n - 1))
        # sticky overflow flag, sampled at the rising edge that the FIFO would write on
        if self.out["mbist_wr"]:
            if not self.mb_ready:
                self.mb_ovf = 1
            elif not (self.mb_ctl & 1):
                self.mb_ovf = 0
        self.state = NEXT[s][tms]

    def fall(self):
        if self.held:
            return
        s = self.state
        if s == "TLR":
            ir_d, sel_d, rst_d, mb_d = OP_IDCODE, 0, 0, 0
        else:
            ir_d = self.ir_shift if s == "UPIR" else self.ir
            sel_d = self.dr if (s == "UPDR" and self.ir == OP_SCAN_SEL) else self.sel
            rst_d = self.dr if (s == "UPDR" and self.ir == OP_SCAN_RST) else self.rst
            mb_d = self.dr if (s == "UPDR" and self.ir == OP_MBIST_CTRL) else self.mb_ctl
        tdo = 0
        if s == "SHIR":
            tdo = self.ir_shift & 1
        elif s == "SHDR":
            tdo = self.dr & 1
        scan = ir_d == OP_SCAN
        sel0 = sel_d & 1
        serial = int(scan and not sel0)
        self.out = {
            "tdo": tdo,
            "tdo_oe": int(s in SHIFT_STATES),
            "scan_mode": int(scan),
            "serial": serial,
            "parallel": int(scan and bool(sel0)),
            "rst_assert": int(scan and bool(rst_d & 1)),
            "scan_en": int(s == "SHDR" and bool(serial)),
            "chain_grp": ((sel_d >> 1) & 3) if scan else 0,
            "mbist_wr": int(
                self.rst_edges_left == 0
                and ((s == "UPDR" and self.ir == OP_MBIST_CTRL) or (s == "TLR" and not self.tlr_prev))
            ),
            "mbist_force": int((mb_d & 1) and bool((mb_d >> 28) & 1)),
        }
        if self.rst_edges_left == 0:  # the falling-edge flops are still in reset during the release window
            self.tlr_prev = int(s == "TLR")
        self.ir, self.sel, self.rst, self.mb_ctl = ir_d, sel_d, rst_d, mb_d

    # -- derived (combinational in the RTL) --------------------------------------
    @property
    def shift_clk_en(self) -> int:
        return int(bool(self.out["serial"]) and self.state in ("CAPDR", "SHDR"))

    def expected(self) -> dict:
        d = dict(self.out)
        d["state"] = ENC[self.state]
        d["shift_clk_en"] = self.shift_clk_en
        d["ir_q"] = self.ir  # update registers (falling edge of Update-IR / Update-DR / TLR)
        d["scan_sel_q"] = self.sel
        d["scan_rst_q"] = self.rst
        d["mb_ctl_q"] = self.mb_ctl
        d["mbist_ovf"] = self.mb_ovf
        return d
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
