chuanseng-ng/claude_verilog_test/tb/cocotb/soc/soc_reg_fw.py

"""
soc_reg_fw.py -- CPU firmware for the SoC-level register walk (bead claude_verilog_test-7ovx).

The unit-level walks (reg_walk.py) drive each peripheral's APB face directly.  This module builds
the same walk as RV32I firmware so every access travels the real path

  CPU -> axi4_crossbar -> axi4_to_axilite -> axi_lite_interconnect -> axil_to_apb
      -> apb_interconnect (-> apb_cdc_bridge for the PLLs) -> peripheral

and the fabric data and address buses (soc_bus, axil, apb) see the walking-ones / alternating
patterns and every peripheral window address, which no existing SoC test does (they write small
values to a few offsets).

The firmware is GENERATED at test time from the SAME `reg_maps` tables the unit walks use and
loaded into the boot ROM through the testbench backdoor, exactly like the hex images of the other
SoC suites; there is no committed binary, so nothing can go stale against the register map.

Per table entry [addr, drive, wmask, check] (4 words), for each pattern p:
    w = p & drive;  *addr = w;  rb = *addr;
    model = ((model & ~wmask) | (w & wmask)) & check;   fail if (rb ^ model) & check
model is seeded from the first read of the register (the unit suites already proved the reset
values; here the question is whether the value survives the fabric).  Entries flagged "lanes" are
also walked with SB stores, so the AXI4/AXI-Lite wstrb and APB pstrb lanes toggle.  Every register
is restored to the value first read.

Result protocol (self-checking, same as the other SoC firmware): x31 = 1 at PASS_PC, -1 at FAIL_PC
(both EBREAK, which halts the CPU so the testbench can read the registers over the debug APB):
    x30 = number of failing checks
    x26..x29 = first failure: address, value written, value read, value expected
"""

from __future__ import annotations

import os
import sys

_PROJ_ROOT = os.path.abspath(os.path.join(os.path.dirname(__file__), "..", "..", ".."))
if _PROJ_ROOT not in sys.path:
    sys.path.insert(0, _PROJ_ROOT)

from sim.riscv_encoder import (  # noqa: E402
    ADDI, AND, BEQ, BNE, EBREAK, JAL, JALR, LUI, LW, OR, SB, SW, XOR, XORI,
)
from tb.cocotb.soc.gpio_fw.gen_gpio_hex import Assembler, lui_addi  # noqa: E402

import reg_maps  # noqa: E402
from reg_walk import M32, SHORT_PATTERNS, WALKING_ONES, CONST_PATTERNS  # noqa: E402

ROM_BASE = 0x0000_1000
ROM_WORDS = 1024
UNMAPPED_OFFSETS = (0x100, 0x400, 0x800, 0xFFC)
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
